aqroot8/aqroot/Assets/first-design-concept.png

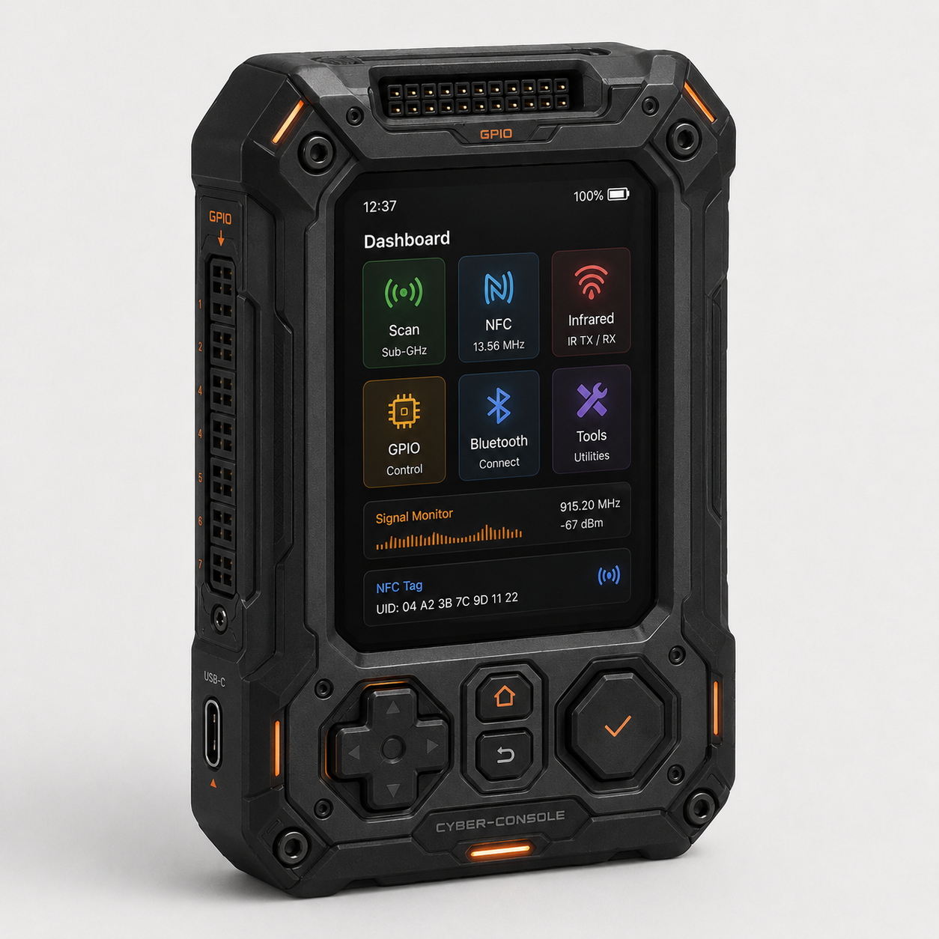
Assets/first-design-concept.png
