aqroot8/aqroot/docs/full-beta-v2/README.md

# AQROOT Full Beta v2 Engineering Record

**Purpose:** this directory is the authoritative engineering record for AQROOT
Full Beta v2. It exists so that the reasoning behind the design — not only its
output files — is preserved in the repository, in Git history, and on GitHub.

Everything here is text. Nothing here is a design file. Nothing here is
generated by a tool. If a fact matters and is not recorded in this directory or
in the KiCad sources, it is not part of the engineering record.

---

## What each baseline is

| baseline | location | role |
|---|---|---|
| **Beta-DM** | `hardware/beta-dm/` | The **validated implementation / manufacturing baseline.** Design-side complete, DRC 0 errors, fabrication package generated. Full Beta v2 inherits its implementation knowledge, its resolved MPNs and its proven blocks. |
| **Frozen Full Beta** | `hardware/beta/`, tag `beta-full-reference-v1` | The **feature / reference architecture baseline.** It records what the full feature set looks like. It is **not** fabrication-ready and was never fully validated (281 unconnected items and 58 ERC violations at freeze). |
| **Full Beta v2** | not yet created | The **active feature-complete showcase design.** Derived from Beta-DM, reintroducing the missing Full-Beta features in a controlled, gated way. |

### Preservation rules

- `hardware/beta-dm/` **must remain preserved** unless a CTO gate explicitly
  authorizes a change to it. It is the fallback that lets the programme
  fabricate something real if Full Beta v2 stalls.
- `hardware/beta/` and the tag `beta-full-reference-v1` are **historical
  references** and are read-only. Every Full Beta v2 commit must be able to
  prove `git diff beta-full-reference-v1 -- hardware/beta/` is empty.
- Design files may only be changed **after the relevant CTO gate authorizes
  them.** The gate list lives in [PROGRESS.md](PROGRESS.md).

---

## How to read this record

- **`transcripts/` is append-only.** A transcript is a historical record of what
  was asked and what was answered at a point in time. Transcripts are never
  edited, corrected or deleted. A transcript can become *outdated*; it can never
  become *wrong*, because it is a record of what was said, not of what is true
  now.
- **`CTO_DECISIONS.md` is the current source of truth.** When an older
  transcript or audit conflicts with a later CTO ruling, **the CTO decision
  wins.** Do not re-derive current direction by reading old transcripts.
- **`audits/` are dated snapshots.** An audit is true as of its stated
  repository HEAD. It is superseded by later audits, never rewritten.
- **`CHANGELOG.md` records what changed and why**, in chronological order.
- **`PROGRESS.md` records where we are** — gate status, percentages, blockers.

Order of precedence when two documents disagree:

```
CTO_DECISIONS.md  >  latest audit  >  ARCHITECTURE.md  >  older audits  >  transcripts
```

---

## Index

| document | what it holds |
|---|---|
| [CTO_DECISIONS.md](CTO_DECISIONS.md) | Living source of truth. Locked decisions and pending decisions. |
| [PROGRESS.md](PROGRESS.md) | Living status dashboard: gates, percentages, blockers. |
| [CHANGELOG.md](CHANGELOG.md) | Chronological engineering changes and why they happened. |
| [architecture/ARCHITECTURE.md](architecture/ARCHITECTURE.md) | High-level architecture snapshot and known architecture defects. |
| [architecture/POWER_FAULT_STATE_TABLE.md](architecture/POWER_FAULT_STATE_TABLE.md) | **Mandatory before schematic work.** Thirteen fault cases across USB, battery, power-switch and accessory states. |
| [mechanical/MECHANICAL_INTERFACE_SPEC.md](mechanical/MECHANICAL_INTERFACE_SPEC.md) | **Authoritative pre-CAD dimension source.** Cavity, PCB envelope, battery, NFC zone, acoustics, IR/antenna, mounting. |
| [pcb/FBV2_P1_FLOORPLAN.md](pcb/FBV2_P1_FLOORPLAN.md) | **FBV2-P1 floorplan.** Datum, outline, board-side convention, placement by face, and the measured gate metrics. **FBV2-P1 = PASS.** |
| [pcb/FBV2_P1_KEEPOUTS.md](pcb/FBV2_P1_KEEPOUTS.md) | All 13 mechanical regions and 4 copper rule areas, with layers and enforced height limits. **Re-based to the 72 mm outline at FBV2-EXP-002.** |
| [pcb/FBV2_P1_COORDINATES.csv](pcb/FBV2_P1_COORDINATES.csv) | Every reference: side, X, Y, rotation, footprint, value, sheet, courtyard box. |
| [pcb/FBV2_P2_ROUTING_PLAN.md](pcb/FBV2_P2_ROUTING_PLAN.md) | **NORMATIVE for FBV2-P2.** Layer usage, ground strategy, per-class routing rules, converter/USB/NFC/bus/escape plans, via and thermal policy, routing order, first-route checklist. |
| [pcb/FBV2_P2_NETCLASS_LEDGER.csv](pcb/FBV2_P2_NETCLASS_LEDGER.csv) | 19 routing classes: nets, design current, IPC-2221B minimum, target/min width, clearance, layers, via policy, return-path requirement, priority and basis. |
| [pcb/FBV2_P2_POWER_ROUTING.md](pcb/FBV2_P2_POWER_ROUTING.md) | **FBV2-P2 power routing.** The In1 GND plane, the placement corrections the routing exposed, the B-34 recomputation, and an honest account of why the first routing attempt was reverted. |
| [audits/2026-08-24-p2-battery-protection-routing.md](audits/2026-08-24-p2-battery-protection-routing.md) | **FBV2-P2-002A.** The obstacle-aware routing method, the D-245 width ruling, the routing journal, and the three named router defects that remain. |
| [architecture/EXPANSION_ECOSYSTEM_PROPOSAL.md](architecture/EXPANSION_ECOSYSTEM_PROPOSAL.md) | **PROPOSAL, PENDING CTO / OWNER RULING.** Standard 2.54 mm 1 x 24 side header + Qwiic/STEMMA QT: connector MPNs, 24-pin ordering, mating safety, power-control verification, and the two owner rulings it depends on. |
| [mechanical/P1_FLOORPLAN_INPUTS.md](mechanical/P1_FLOORPLAN_INPUTS.md) | **FBV2-P1 handoff.** 120 current physical constraints only, each marked LOCKED / TARGET / CAD-TO-VERIFY, plus the six items that need a CTO ruling before floorplanning. No coordinates. |
| [audits/](audits/) | Dated engineering audits, each pinned to a repository HEAD. |
| [reviews/](reviews/) | Independent second opinions. **Advisory — not automatically authoritative.** |
| [transcripts/](transcripts/) | Append-only verbatim CTO prompts and Claude Code responses. |

### Current contents

| file | date |
|---|---|
| [audits/2026-08-22-pre-design-engineering-audit.md](audits/2026-08-22-pre-design-engineering-audit.md) | 2026-08-22 |
| [audits/2026-08-22-architecture-verification.md](audits/2026-08-22-architecture-verification.md) | 2026-08-22 |
| [audits/2026-08-22-architecture-reconciliation.md](audits/2026-08-22-architecture-reconciliation.md) | 2026-08-22 |
| [audits/2026-08-22-battery-protection-closeout.md](audits/2026-08-22-battery-protection-closeout.md) | 2026-08-22 |
| [audits/2026-08-22-dead-cell-and-single-fault-closeout.md](audits/2026-08-22-dead-cell-and-single-fault-closeout.md) | 2026-08-22 |
| [audits/2026-08-22-mechanical-interface-freeze.md](audits/2026-08-22-mechanical-interface-freeze.md) | 2026-08-22 |
| [audits/2026-08-22-display-interface-closeout.md](audits/2026-08-22-display-interface-closeout.md) | 2026-08-22 |
| [audits/2026-08-23-display-procurement-lock.md](audits/2026-08-23-display-procurement-lock.md) | 2026-08-23 |
| [audits/2026-08-23-community-expansion-closeout.md](audits/2026-08-23-community-expansion-closeout.md) | 2026-08-23 |
| [audits/2026-08-23-community-connector-correction.md](audits/2026-08-23-community-connector-correction.md) | 2026-08-23 |
| **[mechanical/MECHANICAL_INTERFACE_SPEC.md](mechanical/MECHANICAL_INTERFACE_SPEC.md)** | 2026-08-23 (FBV2-MECH-002) |
| **[mechanical/P1_FLOORPLAN_INPUTS.md](mechanical/P1_FLOORPLAN_INPUTS.md)** | 2026-08-23 (FBV2-MECH-002) |
| [architecture/POWER_FAULT_STATE_TABLE.md](architecture/POWER_FAULT_STATE_TABLE.md) | 2026-08-22 |
| [reviews/2026-08-22-independent-cto-power-nfc-review.md](reviews/2026-08-22-independent-cto-power-nfc-review.md) | 2026-08-22 |
| [transcripts/2026-08-22-session-01.md](transcripts/2026-08-22-session-01.md) | 2026-08-22 |

### Standing policy

**[FIRST FIVE FULL BETA PCBAs — NO-RESPIN RECOVERY POLICY](CTO_DECISIONS.md)**
(D-049) applies to every design decision until explicitly revoked. Read it before
proposing any architecture choice.

---

## Conventions

- **Dates are absolute.** Never "last week", never "recently".
- **Every claim is sourced.** Measured from the board, quoted from a document,
  or explicitly marked as requiring verification. "Measured" and "assumed" are
  never blurred.
- **Task IDs** use the form `FBV2-<AREA>-<NNN>` (for example `FBV2-DOC-001`).
- **Gate IDs** use the form `FBV2-<PHASE><N>` (for example `FBV2-A2`).
- A verbatim record that cannot be recovered is marked
  `> [VERBATIM SOURCE UNAVAILABLE — DO NOT RECONSTRUCT FROM MEMORY]`
  and is never reconstructed from memory.
