aqroot8/aqroot/hardware/demo/kicad/aqroot-demo/README.md

# AQROOT Full Beta v2 KiCad Project

This directory contains the KiCad 10 project for the **AQROOT Full Beta v2** main board.
It was forked from `hardware/beta-dm/` at FBV2-S1 and is the active design. Beta-DM
remains the preserved fallback and manufacturing baseline (D-005) and is **read-only**.

> **Provenance is measured, not asserted.** `checks/fork_equivalence.py` re-derives which
> forked files are still bit-identical to Beta-DM, which are identical after normalising the
> embedded project name, and which FBV2-S1 deliberately changed. The pinned result is
> `reports/FBV2-S1-fork-equivalence.md`.

## Current design state (2026-08-23, after FBV2-S1-007)

* Digital pin architecture: LOCKED to Beta Pin Map v0.2.4
* Schematic capture: **`01_POWER_TREE`, `02_MCU_CORE`, `03_SPI_A_DISPLAY_SD`,
  `04_SPI_B_RADIOS_NFC`, `05_I2C_DEVICES`, `06_AUDIO` and `07_IR` carry the Full Beta v2
  architecture. Sheets 08-09 are inherited from Beta-DM, unmodified, and still carry the
  Beta-DM architecture**
* ERC: **RUN.** **2 errors and 43 warnings, 45 messages total**
  (`reports/FBV2-S1-007-erc.rpt`) against a Beta-DM baseline of 5 errors / 53 warnings.
  **Zero introduced by any migration task.** The remaining warnings are mostly root-sheet
  `isolated_pin_label` entries on cross-sheet signals whose far end is an unmigrated sheet.
  This is not "ERC clean" — see FBV2-S2.
  **Read the counts with the right flags:** every figure in this programme is
  `kicad-cli sch erc --severity-error --severity-warning`, matching the reports' own
  *"Report includes: Errors, Warnings"* header. Adding `--severity-all` also counts
  **Exclusions** and reports **104** on the same unmodified design. **The "66 warnings" and
  "ERC 68" figures quoted here and in FBV2-S1-004 / 004B / 004C were transcription errors,
  corrected in FBV2-S1-005; the stored reports say 46 messages / 2 errors / 44 warnings.
  The reported deltas were always right**
* PCB placement and routing: **NOT STARTED. DO NOT START.** `aqroot-Beta-v2.kicad_pcb` is
  still a bit-identical copy of the Beta-DM board and does not match this schematic
* Schematic freeze: BLOCKED pending the remaining sheet migrations, ERC closeout, the
  footprint audit, RF review, DFM review, and unresolved part selections

> **This document is a Beta-DM-era file that FBV2-S1 has corrected only where it made a
> false statement about Full Beta v2.** Sections below that describe Beta-DM blocks and are
> still accurate have been left alone. Where a section is superseded it says so in place.

### Status vocabulary — read this before quoting any status in this file

| Term | Meaning |
|---|---|
| **SPECIFIED** | The design is written out in Markdown (this README / the Decisions Log). **Nothing has been drawn.** |
| **CAPTURED** | The block actually exists in the `.kicad_sch` file: real symbols, real wires, real nets. |

**These two are never interchangeable.** A block can be fully SPECIFIED — every part, value,
net name and layout note settled — and still be a completely empty sheet in KiCad. Do not
report a SPECIFIED block as captured, drawn, complete, or done.

### Capture status by sheet (2026-08-23, measured from the `.kicad_sch` files)

| Sheet | Status | Notes |
|---|---|---|
| `01_POWER_TREE` | **CAPTURED — FBV2-S1 POWER-TREE IMPLEMENTATION** | 136 parts, all with footprints. Reverse protection (P2) + LTC4368-1, autonomous dead-cell recovery, ACC_3V3 / ACC_5V accessory power, NFC 3V3-FIT / 5V-DNP select, VBUS_PRESENT and fault telemetry, 19 test points. `R95` = 560 R and the OV divider = 3.65 M / 442 k (4.63 V) per D-104 / D-105 |
| `02_MCU_CORE` | **CAPTURED — FBV2-S1 MCU-CORE MIGRATION** | 14 parts. `GPIO38 = NATIVE_A`, `GPIO47 = NATIVE_B`, `GPIO46 = DISP_BL_CTL` with a 10 k strap pull-down + 0 R isolation link + strap pad, `GPIO43` withdrawn from the community port (UART0 TXD + `TP35`), `GPIO3` strap pull-down (**B-09 closed**), `GPIO45` pull-down placed **DNP**. See [`GPIO_LEDGER.md`](../../../../docs/full-beta-v2/architecture/GPIO_LEDGER.md) |
| `03_SPI_A_DISPLAY_SD` | **CAPTURED — FBV2-S1 DISPLAY / TOUCH / microSD MIGRATION** | 21 parts. New `ER-TFT035IPS-6_50P` symbol with the vendor pin table verbatim — **the inherited 2.8-inch table had the backlight anode/cathode reversed and SCL / D-CX swapped**. `LED_A1..A4` collapse to one `LED_A`; backlight `R69` **1.87 R**, `R70`-`R73` **4 x 33 R** (109 mA typ, 117.6 mA worst case vs a 120 mA panel max); `TOUCH_INT_N` added (panel pin 46); `R112` 0 R **DNP** isolates the display SDO from the shared SPI-A, with `TP36`; `SD_CARD_DETECT_TBD` becomes **`SD_CARD_DETECT_N`** with `R113` 100 k. `J1` stays on the **FH69-dedicated** land pattern (**B-47**) |
| `04_SPI_B_RADIOS_NFC` | **CAPTURED — FBV2-S1 RADIOS / NFC MIGRATION** | 40 parts, A2 sheet. RF architecture locked: 433 MHz internal Taoglas `FXP450.07.0100C` on the `U7` IPEX, 915 MHz external to a top-panel SMA bulkhead, **no board RF trace in either band**; both module stamp-hole pins explicit NC. NFC: **`VDD`/`VDD_TX` moved to `NFC_SUPPLY` (B-41 closed)**, `Y1` 27.12 MHz crystal, full differential matching + RX divider with every value `TUNE`, `TP37`/`TP38` on the antenna terminals, `AAT`/`CSI`/`CSO`/`EXT_LM`/`MCU_CLK` explicit NC. `SX1262_DIO1` published for sheet `08`. **Zero `*_TBD` nets remain.** NFC IC and antenna **LOCKED**: `ST25R3916-AQET` non-B; Taoglas **`FXC.46.52.0075X.B.dg`** (reverse ferrite, adhesive to the inner rear shell) off-board on `J7` JST `BM02B-ACHSS-GAN-ETF` — replaceable without soldering. **First-build matching set calculated** (FBV2-S1-004C): target ≈ 36 Ω differential, `Q` ≈ 25, EMC cut-off 20.1 MHz, RFI divider fixed from 4.4 V pk-pk to 1.03 V pk-pk. Every value is a CALCULATED FIRST-BUILD VALUE, not a final tuned value |
| `05_I2C_DEVICES` | **CAPTURED — FBV2-S1 I²C / IMU MIGRATION** | 11 parts. `U4` BMI270 re-derived line by line against `BST-BMI270-DS000-08` Rev 1.6 — **every inherited strap proved correct** (D-136). Address strap made reworkable: **`R118` 0 Ω FIT to GND = 0x68, `R119` 0 Ω DNP to `+3V3` = 0x69, fit one only** (D-140). Internal I²C pull-ups `R19`/`R20` **4.7 kΩ → 2.2 kΩ** — 4.7 kΩ gave `t_r` 338 ns against the 300 ns fast-mode limit at the measured ≈ 85 pF (D-139). `INT1` stays on native GPIO3 with a **proven** boot-safe window and a mandatory push-pull / active-high firmware contract (D-137); `INT2` stays DNC (D-138). IMU permanently powered, no load switch (D-141). **B-44 CLOSED**; land pattern verified against §8.3 (D-143). Address map: `docs/full-beta-v2/architecture/I2C_ADDRESS_REGISTRY.md` |
| `06_AUDIO` | **CAPTURED — FBV2-S1 AUDIO MIGRATION** | A3 sheet. **`U5` and `J6` arrived DNP — the speaker output path had never been built — and are now FITTED** (D-144). **`MK1` = PUI `DMM-4026-B-I2S-R`, replacing the obsolete ICS-43434: SEVEN pads, not six, so a new symbol and footprint were built from the manufacturer drawing** (D-145); `CONFIG`→GND mandatory; **no 1.8 V rail needed**; **`R120` 100 kΩ on `I2S_MIC_DIN` is a data-sheet requirement**. **Bus rate is set by the microphone: 48 kHz × 64 = 3.072 MHz, decimate to 16 kHz in firmware** — 16 kHz on the wire is out of spec (D-146). `U5` = **`MAX98357AETE+T`**, `GAIN_SLOT` → VDD = **6 dB** because 12 dB clipped the top 6.8 dB of digital range against the 3.3 V rail (D-147). `LS1` = **PUI `AS02008MR-LW152-R`**, Ø20 × 3 mm, 8 Ω, 500–4000 Hz, AWG #32 leads crimping straight into `J6` (D-148). EMI recovery `R121`/`R122` 0 Ω FITTED + `C81`/`C82` 1 nF DNP (D-150). `LS1` remains the one part with no footprint, by design (off-board speaker) |
| `07_IR` | **CAPTURED — FBV2-S1 INFRARED MIGRATION** | A3 sheet. **Eight parts arrived DNP — the whole subsystem — and are now FITTED** (D-153), the fourth consecutive sheet with a load-bearing inherited DNP. `D1` = **Vishay `TSAL6100`** (940 nm, `Ie` 170 mW/sr, ±10°); **TSAL6200 is a proven drop-in fallback — identical package, `VF` and `IFM`, so `R24` is unchanged** (D-154). **Peak 150 mA = 75 % of the `IFM` 200 mA REPETITIVE rating**; `IFSM` 1.5 A is a single-pulse ≤ 5 µs surge and is not a carrier rating; 300 mA rejected as out of spec (D-155). **Supply `+3V3`, not `SYS`** — 118–170 mA regulated against 64–166 mA on `SYS` (D-156). `R24` 18 Ω → **12 Ω** plus `R123` DNP parallel trim, **never below 10 Ω** (D-157). `C12` 4.7 µF → **22 µF 1210** — 4.7 µF gave 218 mV of carrier ripple (D-158). **`Q1` AO3400A pinout CONFIRMED 1 = G / 2 = S / 3 = D; the "needs the official AOS land pattern" blocker is CLOSED because AOS publishes none** (D-159). `U6` = **`TSOP38438`**, a pure MPN change, and the inherited `R21`/`C11` filter is **quantified at 41 dB at 38 kHz — ~90× margin against the Fig. 7 knee, and it is what makes sharing `+3V3` safe** (D-160). `TP39`/`TP40` added. **O-5 open: Vishay marks AGC4 "No" for Sony code** — receive-only, and the `TSOP38238` symbol is retained so reverting is a `lib_id` change | TSOP38238 RX + TSAL6200 low-side NMOS TX |
| `08_BUTTONS_EXPANDERS` | **CAPTURED — INHERITED, BETA-DM ARCHITECTURE** | U60/U61 TCA9535PWR, 7 buttons, safe-state pulls |
| `09_COMMUNITY_HEADER` | **CAPTURED — INHERITED, BETA-DM ARCHITECTURE** | the 20-pin Beta-DM port. **Superseded by the 2x12 Samtec `BCS-112-S-D-HE` port (D-093); not yet migrated** |

**CAPTURED here means the symbols, wires and nets exist in the file.** It does not mean the
sheet carries the Full Beta v2 architecture. Only `01_POWER_TREE`, `02_MCU_CORE`,
`03_SPI_A_DISPLAY_SD` and `04_SPI_B_RADIOS_NFC` do.

Board-level status:

| Item | Status |
|---|---|
| PCB (`aqroot-Beta-v2.kicad_pcb`) | **INHERITED, BIT-IDENTICAL TO BETA-DM** — it is the Beta-DM board and **does not match this schematic**. No v2 placement or routing has been performed |
| ERC | **RUN 2026-08-23** — `reports/FBV2-S1-005-erc.rpt`, **2 errors / 43 warnings (45 messages)**; **zero introduced** by any migration task, and FBV2-S1-004 removed two inherited errors. Counts are `--severity-error --severity-warning`; `--severity-all` also counts Exclusions and reports 104 |
| Footprints assigned | **300 of 301 components** (`LS1`, the off-board speaker, is the exception). Assigned is not verified — the per-footprint pad-overlap audit against vendor drawings is **FBV2-S2** and has not run |

> The old claim that this project was an empty PCB with seven footprints and a never-run ERC
> described the Beta project at 2026-07-31. It is retained nowhere: it was false for Beta-DM
> from the moment that board was routed, and it is false for Full Beta v2.

## Locked GPIO expanders (v0.2.4, 2026-07-27)

Both I2C GPIO expanders are Texas Instruments TCA9535PWR, replacing the MCP23017.

* U60 = TCA9535PWR, I2C 0x20 (internal: buttons + control), straps A2=GND A1=GND A0=GND
* U61 = TCA9535PWR, I2C 0x21 (community header), straps A2=GND A1=GND A0=+3V3
* Package = PW, TSSOP-24, 0.65 mm pitch
* Symbol = `Interface_Expansion:TCA9535PWR`
* Footprint = `Package_SO:TSSOP-24_4.4x7.8mm_P0.65mm` (NOT yet audited — see rules)
* One open-drain active-low `/INT` per device, both wired-OR onto `WAKE_INT_N` -> ESP32 GPIO21

TCA9535PWR is datasheet-trusted and receives its first hardware validation on Beta. The Alpha
bench test that passed was an MCP23017, a different part.

## Explicit unresolved parts

* ~~External community-header I2C isolator or bus switch — **UNSELECTED.**~~ **LOCKED
  2026-08-07: TI `TCA9517ADGKR`, DGK / VSSOP-8** (U16). PCA9515A is not selected.
* ~~ACC_PWR_EN accessory load switch — **UNSELECTED.**~~ **LOCKED 2026-08-07: TI
  `TPS22918DBVR`, DBV / SOT-23-6** (U15).
* **Battery reverse-polarity protection — topology PARKED, see below**

> Both former candidates are now firm part locks. Their **footprints remain UNVERIFIED** —
> locking the part is a separate gate from comparing KiCad copper against the manufacturer
> land pattern. See *Nontrivial footprint verification policy* in [[05 - Design Decisions Log]].

## 01_POWER_TREE — CAPTURED (FBV2-S1, 2026-08-23)

**Sheet status: CAPTURED AND ERC-CHECKED. NOT FABRICATION READY.** The section that used to
stand here said the sheet was "SPECIFIED, NOT DRAWN" and that its `.kicad_sch` was an empty
stub. That was true on 2026-07-31 and is false now.

What exists in the file:

* USB-C 5 V sink / USB 2.0 front end, BQ25185 charger and power path, TPS63020 main `+3V3`
  buck-boost, TPS61023 NFC 5 V PA boost, MAX17048 fuel gauge, physical TPS63020 EN hard-off
* **Battery reverse protection, P2** — `J4` -> `F1` 5 A -> `BAT_RAW` -> `Q2` (stage 1) ->
  `BAT_MID` -> `Q3` (stage 2) -> `BAT_SENSE` -> `R75` 15 mR -> `BAT_PROTECTED_P` -> `U11` BAT,
  controlled by `U18` LTC4368-1. `RETRY` grounded (latch-off); `UV` unused, 510 k to VIN per
  the datasheet; `OV` divider `R77`/`R78`
* **Autonomous dead-cell recovery** — `U19` TLV7032, ratiometric polarity bridge, handoff
  comparator, `Q6`/`Q7`/`Q8` series 3-input AND, `Q9` FAULT inverter, `Q5` recovery P-FET,
  `R95` limit, `D12` unidirectional. USB-powered and firmware-independent
* **Accessory power** — `+3V3` -> `U20` TPS22950C -> `ACC_3V3_SW`; `BQ25185_SYS` -> `U21`
  TPS61023 -> `U22` TPS22950C -> `ACC_5V_SW`; both `FLT` pins wire-ORed to `ACC_POWER_FAULT_N`
* **NFC no-respin source select** — `R106` 0R **FIT** from `+3V3`, `R107` 0R **DNP** from the
  boost, mutually exclusive by fit state
* **Telemetry** — `VBUS_PRESENT` divided to 2.97 V at VBUS 5.0 V, `LTC4368_FAULT_N`,
  `ACC_POWER_FAULT_N`, `BQ25185_STAT1/2`

What is **not** true of it:

* it is **not fabrication ready**;
* **no footprint on this sheet has been verified** against a vendor drawing (FBV2-S2);
* **no PCB placement or routing has been performed**, and the inherited `.kicad_pcb` does not
  contain any of this;
* several component values are marked *value-to-verify* in the FBV2-S1 audit;
* `NFC_SUPPLY` has **no consumer yet** — `U9` VDD/VDD_TX are still on `NFC_5V_PA_PENDING` on
  sheet `04`, which FBV2-S1-001 was not authorised to modify.

### Reverse-polarity placeholder — RETIRED

**Superseded.** This section required the battery-input protection block to remain a labelled
placeholder that must never be instantiated. **FBV2-S1 instantiated it**, under D-050 / D-052 /
D-064 / D-068, after the topology was locked by FBV2-PWR-001 and FBV2-PWR-002.

`BAT_CONNECTOR_P` and `BAT_PROTECTED_P` **remain distinct nets** — that part of the old rule
still holds, and is now enforced by real components between them rather than by a text box.

The parallel link across the FETs remains **forbidden**. The in-series removable link in
`BAT_PROTECTED_P` remains permitted.

## TPS61023 NFC 5V PA boost — BETA LOCKED, CAPTURE APPROVED (2026-07-31)

| | |
|---|---|
| Part | **TI TPS61023DRLR**, adjustable synchronous boost |
| Package | **DRL, 6-pin SOT563 / SOT-5X3, 1.2 × 1.6 mm** — **do NOT substitute a generic SOT-23 footprint** |
| Symbol / footprint | **Not selected** — verify exact symbol pinout, exact TI DRL footprint, pin-1 orientation, exposed-pad status, manufacturer land pattern |
| In / Out | `BQ25185_SYS` → `NFC_5V_PA_PENDING` |
| Enable | `NFC_5V_EN` from TCA9535 **U60 P02** (100k safe-state pull-down already in the architecture) |
| Load | **ST25R3916 `VDD_PA` ONLY** |

> **FB divider values are PENDING-FROM-DATASHEET.** Inspect the current TPS61023 datasheet and
> EVM schematic and record the exact FB resistor values, inductor and capacitor recommendations
> at capture time. **Do not invent values from memory** — that is why no numbers appear here.

| Ref | Value |
|---|---|
| `U?` | TPS61023DRLR |
| `L_NFC_BOOST` | ~1 µH, **shielded**, low DCR, current rating from the TI design calculation; MPN may stay provisional |
| `C_NFC_BOOST_IN` | input ceramic — value/voltage/dielectric **from TI** |
| `C_NFC_BOOST_OUT` | output ceramic, **or the exact TI-recommended count** |
| `R_NFC_FB_TOP` / `R_NFC_FB_BOT` | FB divider for ~5.0 V — **exact values from the TI 5V reference/EVM** |
| `TP_NFC_5V_EN`, `TP_NFC_5V_PA` | test points |

**Do not connect** ST25R3916 `VDD_IO` (stays on `+3V3`), general 5V accessories, USB VBUS, or any
unrelated load.

```
NFC 5V PA RAIL ONLY
ST25R3916 VDD_IO REMAINS +3V3
NOT A GENERAL-PURPOSE 5V RAIL
```

```
DEFAULT OFF
ENABLE ONLY DURING NFC FIELD OPERATION
```

```
PLACE INDUCTOR, INPUT CAPACITOR AND OUTPUT CAPACITOR
TIGHT TO TPS61023

MINIMIZE SW NODE COPPER AREA

KEEP FB TRACE AWAY FROM SW AND INDUCTOR

PROVIDE SHORT DIRECT GROUND RETURNS
```

**ERC:** VIN is `BQ25185_SYS`; output is only `NFC_5V_PA_PENDING`; `VDD_IO` remains `+3V3`; EN is
`NFC_5V_EN`; the safe-state pull-down exists and no conflicting pull-up was added; FB is not
floating; no support capacitor or inductor omitted; symbol and DRL footprint pin numbering match.

## MAX17048 fuel gauge — BETA LOCKED, CAPTURE APPROVED (2026-07-31)

| | |
|---|---|
| Part | **ADI MAX17048G+T10** — prefer the **G** package over the **X** WLP for Beta assembly/inspection |
| Package | 8-pin 2 × 2 mm TDFN / LFCSP-style |
| Symbol / footprint | **Not selected** — verify official pinout and package drawing, assign the **exact manufacturer land pattern**, include the **exposed pad** if required |
| I²C address | **0x36**, no address configuration |
| Sense resistor | none required |

| Ref | Net |
|---|---|
| `VDD` | **`BAT_PROTECTED_P`** |
| `CELL` | **`BAT_PROTECTED_P`** or the exact recommended system-side sense node |
| `SDA` / `SCL` | `I2C_SDA_INT` / `I2C_SCL_INT` — **no second pull-up pair**, the bus already has the locked 4.7k |
| `ALRT_N` | **test point, otherwise unused**; no-connect marker if the datasheet allows. **Do not connect to `WAKE_INT_N`.** No new GPIO. |
| `C_FG_VDD` | **value from the current datasheet** — X7R, appropriate rating |
| `TP_FG_CELL` | test point |

```
MAX17048 MUST REMAIN BEHIND FINAL REVERSE-POLARITY PROTECTION
DO NOT CONNECT TO RAW BATTERY CONNECTOR POSITIVE
```

```
MAX17048 I2C ADDRESS 0x36
NO ADDRESS CONFIGURATION
```

```
MAX17048 — NEVER BENCH VALIDATED ON AQROOT

BETA BRING-UP REQUIRED:
- I2C detection at 0x36
- cell-voltage accuracy
- SOC plausibility
- charge/discharge response
- hibernate entry/exit
- battery insertion/removal
- charger-connected behavior
- hard-off behavior
- no I2C backpower
- firmware temperature compensation
- low-battery threshold validation
```

> **Do not check the "only one capacitor" assumption off** until the official typical application
> is reviewed for CELL filtering, VDD bypass, alert-network components and exposed-pad grounding.
> **Power-domain item:** the gauge stays battery-powered while `+3V3` is off, but the I²C
> pull-ups are on `+3V3`. Verify from the datasheet that SDA/SCL cannot back-power the disabled
> rail. No level shifting unless primary documentation requires it.

## Physical hard-off switch → TPS63020 EN (2026-07-31)

```
VINA -> [SPST maintained slide switch] -> EN
                                          |
                                   R_EN_PULLDOWN = 100k
                                          |
                                         GND
```

Closed → EN high → TPS63020 on → `+3V3` active. Open → 100k pulls EN low → TPS63020 off →
`+3V3` inactive. **No switch position, including mid-travel, can short VINA to GND** — which is
why SPST-plus-pull-down was chosen over the SPDT common/VINA/GND arrangement.

**Do not connect the switch to** ESP32 GPIO, TCA9535 GPIO, a firmware latch, battery ground, or
the raw battery current path.

**Switch part:** MPN provisional until mechanical review, **but the footprint must correspond to
a real candidate**. SPST preferred; **maintained** positions; low-profile side/top actuator;
through-hole mounting tabs preferred for strength; side-wall accessible; clear OFF/ON. **Do not
assign a tiny signal-switch footprint without checking** actuator travel, body dimensions,
mounting tabs, PCB edge setback, enclosure cutout and hand-solder access.

```
SWITCH POSITION / ACTUATOR / ENCLOSURE CUTOUT
REQUIRE FIELD SLATE MECHANICAL REVIEW BEFORE ROUTING
```

```
PHYSICAL MAIN-RAIL HARD OFF

SWITCH OFF:
TPS63020 DISABLED
+3V3 SYSTEM RAIL OFF

UPSTREAM BATTERY CIRCUITS REMAIN POWERED:
BQ25185
MAX17048
REVERSE-PROTECTION CONTROLLER CANDIDATE

TOTAL BATTERY STANDBY IS NOT ZERO
```

**Never claim** complete battery isolation, shipping mode, zero battery current or zero standby
draw. Soft push-button power UX / load-switch / latch / shipping-mode architecture is a
**post-Kickstarter option, not part of Beta**.

## USB-C 5V sink + USB 2.0 front end — BETA LOCKED, CAPTURE APPROVED (2026-07-30)

**Cleared to be drawn in `01_POWER_TREE` now.** Beta-locked, **not production-hardened** —
subject to professional power/DFM/EMI review before fabrication.

**Role: USB Type-C SINK / UFP. 5V only. USB 2.0 full-speed. NO PD, NO source role, NO DRP, NO
VCONN, NO alternate modes.**

### Connector

| | |
|---|---|
| Family | **GCT USB4105**, 16-contact USB 2.0 Type-C, top-mount horizontal, SMD contacts, TH shell stakes |
| Candidate MPN | **GCT USB4105-GF-A-120** — *verify drawing, shell-stake length vs PCB thickness, symbol pin numbering, and that the footprint matches the drawing before locking* |
| Footprint | `Connector_USB:USB_C_Receptacle_GCT_USB4105-xx-A_16P_TopMnt_Horizontal` |
| Symbol | 16-pin USB 2.0 Type-C receptacle — **verify pin numbering; do not use a 24-pin SuperSpeed symbol** |

Pin mapping: VBUS = **A4, B9, A9, B4** · GND = **A1, A12, B1, B12** · D+ = **A6, B6** ·
D− = **A7, B7** · CC1 = **A5** · CC2 = **B5** · SBU1 = **A8 (NC)** · SBU2 = **B8 (NC)** ·
shield tabs → `USB_SHIELD`.

> **A 16-contact receptacle has no SuperSpeed TX/RX contacts — do not invent them.** Join all
> duplicate VBUS, GND, D+ and D− contacts. Mark **only** SBU1/SBU2 no-connect.

### Components and reference designators

| Ref | Value | Notes |
|---|---|---|
| `J?` | GCT USB4105-GF-A-120 | suffix pending |
| `R_CC1_RD` | **5.1k, 1%** | CC1 → GND |
| `R_CC2_RD` | **5.1k, 1%** | CC2 → GND — **independent; never shared, never combined, never firmware-connected** |
| `U?` | **USBLC6-2SC6** (SOT-23-6) | verify pinout against the **ST datasheet** |
| `R_USB_VBUS_LINK` | 0R | optional bring-up current-measurement / isolation link |
| `C_USB_VBUS` | **4.7 µF**, 10 V min, X7R | **deliberately 4.7 µF, not 10 µF** — keeps hot-plug inrush conservative. MPN deferred to pre-fab BOM validation |
| `R_USB_DN_SER` | **22R** | D− series, **at the MCU end** |
| `R_USB_DP_SER` | **22R** | D+ series, **at the MCU end** — equal value + matching footprint; 33R is an option after SI review, **never mixed across the pair** |
| `C_USB_DN_EMC` | 100 pF **DNP** | MCU-side node → GND |
| `C_USB_DP_EMC` | 100 pF **DNP** | MCU-side node → GND |
| `R_USB_SHIELD_LINK` | **0R, populated** | `USB_SHIELD` → GND (Beta default) |
| `R_USB_SHIELD_BLEED` | 1M, **DNP** | alternative — **do not populate both without review** |

Optional DNP shield→GND capacitor footprint **only if board space permits**; no mandatory value.

### Nets

`USB_VBUS_RAW` · `USB_VBUS_CHG` · `USB_D_N_CONN` · `USB_D_P_CONN` · `USB_D_N_MCU` ·
`USB_D_P_MCU` · `USB_SHIELD` · `GND`

```
VBUS pins -> USB_VBUS_RAW -> [R_USB_VBUS_LINK 0R] -> USB_VBUS_CHG -> BQ25185 VIN
                  |
                  +-- C_USB_VBUS 4.7uF
                  +-- USBLC6 VBUS pin  (BRANCH — clamp reference, NOT series)

D- (A7,B7) -> USB_D_N_CONN -> USBLC6 ch -> R_USB_DN_SER 22R -> USB_D_N_MCU -> GPIO19
D+ (A6,B6) -> USB_D_P_CONN -> USBLC6 ch -> R_USB_DP_SER 22R -> USB_D_P_MCU -> GPIO20
```

**GPIO19 = D−, GPIO20 = D+. Do not cross.** `C_USB_VBUS` does **not** replace the bq25185's own
VIN decoupling, which is captured with the charger's support network.

### Sheet notes to place

```
TWO INDEPENDENT 5.1k Rd RESISTORS REQUIRED
USB-C SINK / UFP, 5V ONLY
NO PD NEGOTIATION
```

```
STATIC Rd ESTABLISHES THE SINK ROLE
NO CC CURRENT-ADVERTISEMENT DETECTION IS IMPLEMENTED
BQ25185 INPUT-CURRENT POLICY MUST NOT ASSUME 1.5A/3A
FROM AN UNKNOWN SOURCE
```

```
USBLC6 VBUS PIN IS A CLAMP REFERENCE
NOT A SERIES POWER PATH
```

```
ESD CURRENT PATH TO GND MUST BE SHORT AND DIRECT
PLACE ESD BEFORE LONG DATA TRACES
MINIMIZE STUB BETWEEN CONNECTOR AND ESD ARRAY
```

```
DNP FOR BETA
POPULATE ONLY AFTER SIGNAL-INTEGRITY / EMI REVIEW
```

```
SHIELD-GROUND STRATEGY PROVISIONAL FOR EMI/ESD REVIEW
DEFAULT BETA LINK: 0R
DO NOT LEAVE SHIELD FLOATING WITHOUT REVIEW
```

Prominent, beside the block:

```
USB-C 5V SINK / USB 2.0 DEVICE

CC1: 5.1k TO GND
CC2: 5.1k TO GND
SEPARATE Rd RESISTORS — DO NOT COMBINE

NO PD / NO VCONN / NO SOURCE ROLE
SBU1/SBU2 NC

USBLC6-2SC6:
DATA + VBUS ESD CLAMP
VBUS PIN NOT IN SERIES

D+/D-:
22R SERIES AT MCU
100pF DNP EMC FOOTPRINTS

GENERIC USB CURRENT LIMIT MUST REMAIN CONSERVATIVE
WITHOUT CC CURRENT-ADVERTISEMENT DETECTION
```

### Layout notes

**D+/D−:** 90 Ω differential pair (tolerance per stack-up); equal length; continuous GND
reference; minimise vias; no stubs; avoid switch nodes, inductors, antennas, crystal traces;
preserve pair spacing; paired ground-return vias on any unavoidable layer change.
**Placement order:** connector → USBLC6-2SC6 → controlled differential routing → series
resistors near ESP32-S3 → ESP32-S3 USB pins.
**VBUS:** width suited to expected input current; bulk cap and ESD clamp close; keep away from
D+/D− where practical.

### ERC checks

**Do not globally weaken ERC.** CC1 and CC2 each have their own 5.1k and are not shorted; D+/D−
not swapped (**GPIO20 = D+, GPIO19 = D−**); USBLC6 VBUS not treated as series power; SBU1/SBU2
have no-connect markers; all VBUS contacts joined; all GND contacts joined; shield not used as
signal GND through an unintended duplicate path; no nonexistent SuperSpeed pins; no PD
controller; **no GPIO allocated for CC logic**.

## TPS63020 3.3V block — ARCHITECTURE LOCKED, CAPTURE APPROVED (2026-07-30)

**This block is cleared to be drawn in `01_POWER_TREE` now.** Capacitor exact MPNs are a
**BOM-release gate, not a schematic-capture gate** — draw the block, mark the open items on the
sheet, and do not stall capture on per-capacitor DC-bias research.

Block title to place on the sheet:

```
TPS63020 3.3V BUCK-BOOST
ARCHITECTURE LOCKED
CAPACITOR MPNs PENDING PRE-FAB BOM VALIDATION
```

### Rails

| | Net |
|---|---|
| In | **`BQ25185_SYS`** |
| Out | **`+3V3`** |
| Ground | Per the TI datasheet's own PGND/AGND treatment. **Do not invent split-ground nets** unless the datasheet explicitly requires them. |

The block connects to `BQ25185_SYS`, **not** to the raw battery connector.

### Components and reference designators

| Ref | Value | Locked? | Notes |
|---|---|---|---|
| `U?` | **TPS63020DSJR** | ✅ | DSJ package. **Verify the official TI pinout before wiring** — do not trust a third-party symbol unchecked. |
| `L1` | **XFL4020-152MEC** 1.5 µH | ✅ | Coilcraft, LCSC **C3033018**. Use the manufacturer-recommended footprint, or one matching the **official Coilcraft land pattern**. |
| `R_FB_TOP` | 1M, 1% | ✅ | VOUT → FB |
| `R_FB_BOTTOM` | 180k, 1% | ✅ | FB → GND. **No Cff, no third resistor.** |
| `R_PG_PULLUP` | 1M | ✅ | +3V3 → PG (open-drain) |
| `SW?` | SPST maintained slide switch | ✅ | **Physical hard-off**: VINA → switch → EN |
| `R_EN_PULLDOWN` | 100k | ✅ | EN → GND, defines the OFF state |
| `R_EN_BYPASS` | 0R **DNP** | ✅ | VINA → EN, **bench bypass only** — supersedes the withdrawn `R_EN_LINK` |
| `R_PS_DEFAULT` | 0R | ✅ | PS/SYNC → GND |
| `C_VINA` | 100nF X7R | ✅ | VINA→GND, close to VINA. **Do not exceed 220nF without review.** |
| `CIN1`, `CIN2` | 10 µF each | value ✅ / **MPN ❌** | 10 V min, X7R, **1206 preferred**. Close to VIN/PGND. |
| `COUT1`–`COUT4` | 22 µF each | value ✅ / **MPN provisional** | 10 V, X7R, **1206**. Tight around VOUT/PGND. |

Test points: **PG**, **EN**. Plus a **DNP landing** on EN for the future external hard-off
controller, and a test point / solder-jumper / DNP option on PS/SYNC for forced-PWM.

### Locked defaults — and why no GPIO is consumed

```
PHYSICAL MAIN-RAIL HARD OFF
MCU CANNOT RESTORE ITS OWN DISABLED 3V3 RAIL
```

* **EN must not float.** Driven by the **physical SPST maintained hard-off switch**
  (VINA → switch → EN) with **`R_EN_PULLDOWN` 100k** to GND holding the OFF state.
  **Never connect EN to the ESP32, the TCA9535, or any firmware-controlled signal.**
* **The permanent `R_EN_LINK` 0R is WITHDRAWN** (superseded 2026-07-31). It survives only as
  **`R_EN_BYPASS` 0R, DNP**. A populated permanent link in parallel with a switch that pulls EN
  low would defeat OFF and short VINA to GND.

```
DO NOT POPULATE R_EN_BYPASS WHEN HARD-OFF SWITCH IS FITTED
UNLESS INTENTIONAL ALWAYS-ON BENCH CONFIGURATION IS REQUIRED
```
* **PS/SYNC must not float.** Tied to GND through `R_PS_DEFAULT` 0R → **power-save default**.
  Forced-PWM is a bring-up/EMI option only. **Never allow the GND link and a VINA link to be
  populated simultaneously without an explicit assembly warning** — that shorts VINA to GND.
* **PG is diagnostic only.** `PG DIAGNOSTIC ONLY / NO GPIO ALLOCATED`. No MCU, no expander.

### Sheet notes to place

Beside L1:

```
LOCKED MPN: XFL4020-152MEC
XGL4020-152 MAY BE REVIEWED AS AN APPROVED ALTERNATE
DO NOT SILENTLY SUBSTITUTE
```

Beside the FB divider (keep the FB node compact and visually clear of switching nodes):

```
KEEP FB TRACE SHORT
ROUTE AWAY FROM L1, L1/L2 SWITCH NODES AND HIGH-DI/DT LOOPS
SENSE VOUT AFTER OUTPUT CAPACITORS
```

Prominent, beside the block:

```
CAPACITOR MPNs NOT BOM-LOCKED
VERIFY DC-BIAS EFFECTIVE CIN/COUT BEFORE FAB

CIN:
2 x 10uF, 10V+, X7R
TOTAL EFFECTIVE >=10uF AT 4.5V

COUT:
4 x 22uF, 10V, X7R, 1206
TOTAL EFFECTIVE >=40uF AT 3.3V

DO NOT USE OBSOLETE GRM21BR71A106KE51L
```

### ERC handling

**Do not globally reduce ERC severity.** For findings from the incomplete reverse-polarity block
or the hard-off DNP landing: classify explicitly, and use a **narrowly scoped** no-connect,
no-ERC marker or documented waiver **only where justified**. Never suppress unrelated errors.

Check on this block: EN not floating; PS/SYNC not floating; PG pull-up present; FB connected
only to the intended divider; no obsolete capacitor MPN present; no GPIO consumed; `+3V3`
power-flag strategy consistent with existing project conventions.

## Reverse-polarity protection — SUPERSEDED, NO LONGER PARKED (2026-08-23)

**This section is superseded.** It parked the battery-input protection block and forbade
instantiating a controller, MOSFETs, sense resistor, UV/OV divider, gate clamp or timer
components. That park was lifted by the FBV2-A1 gate:

* **FBV2-PWR-001** (2026-08-22) characterised the dead-cell lockout and the single-fault cases.
* **FBV2-PWR-002** (2026-08-22) closed **P-11, P-12, B-20, B-21, B-23** and passed **FBV2-A1**.
  Pass path locked to **P2** — four FETs in **two packages**; fuse **REQUIRED**; clamp demoted
  to secondary; PTC **REJECTED**.
* **FBV2-S1-001** (2026-08-23) captured it. See *01_POWER_TREE — CAPTURED* above.

Two rules from the old text **survive unchanged** and are still binding:

* **High-side only.** Battery negative stays tied directly to system GND. The keyed connector
  is an *additional mechanical layer only*, never the primary electrical defence.
* **Rejected as final solutions:** single PMOS alone; naive passive back-to-back; any passive
  gate network that can leave a FET partially-on under charger drive; low-side protection;
  keyed connector as primary defence; ordinary load switches that block charging; cell
  over/under-voltage protectors that do not address physical reverse insertion.

> **The pre-fabrication power/DFM review gate is NOT lifted.** Capturing the topology is not
> the same as clearing it for fabrication. The LTspice charge-path case, ADI vendor/FAE
> confirmation and the professional power/DFM review are still required before any fabrication
> release, and the footprint audit (FBV2-S2) is still required before any routing.

Full record: [[05 - Design Decisions Log]] and `docs/full-beta-v2/`.

## Rules

* **Beta-DM rule, now scoped:** "Do not generate or modify KiCad schematic or PCB files
  automatically. KiCad files will be created manually in KiCad 10.0.3."
  **FBV2-S1-001 captured `01_POWER_TREE` as a scripted migration**, not by hand in the GUI,
  and every subsequent edit was verified with `kicad-cli` ERC and a netlist export. The rule
  is recorded here unaltered and **awaits CTO ratification or reinstatement** — it is not
  treated as repealed by having been overtaken.
* Do not assign unverified footprints. The U60/U61 TSSOP-24 footprint above is assigned but NOT
  yet verified against the TI datasheet drawing — audit it before freeze.
* Do not begin PCB routing until the full schematic passes review and ERC, **and until the
  power/DFM pre-fab review has locked the reverse-polarity topology** (see above).
* Preserve the authoritative GPIO assignments from Beta Pin Map v0.2.4.
* Do not reintroduce MCP23017 nomenclature (GPAn/GPBn, INTA/INTB, IODIR, GPPU, GPINTEN, INTF,
  INTCAP, IOCON, DEFVAL, INTCON). The TCA9535 register set is 0x00-0x07 only.
