aqroot8/aqroot/01 - Hardware Core.md

---
tags: [hardware, core-components]
---

# Hardware Core (always built in, no separate purchase)

| Subsystem | Part | Sourcing (final PCB) | Prototype sourcing | Notes |
|---|---|---|---|---|
| Compute | ESP32-S3-WROOM-1 (N16R8) | Bare module on custom PCB | DevKitC-1 devkit | 16MB flash, 8MB PSRAM, native USB flash/debug |
| Display | 2.8" IPS LCD, ILI9341 + FT6236 capacitive touch @ 0x38 | Panel module, standard 4-wire SPI | Same — Alpha-validated part | 240x320. AMOLED (RM69090) is a Kickstarter STRETCH GOAL board revision, not the baseline. **PHYSICAL INTERFACE CAPTURED 2026-08-06:** J1 = **Hirose FH69-50S-0.5SH** 50-pin 0.5mm FPC connector (footprint VERIFIED_VENDOR_EXACT; the obsolete FCI 62684 was dropped). Panel runs **SPI mode II with readback, IM3:IM0 = 1110**. Backlight = **TI TPS61169DCKR** driver, 4 LED strings with 39R ballasts and a 2.55R RSET. See [[05 - Design Decisions Log]] |
| NFC/RFID | **ST25R3916-AQET** (package LOCKED 2026-08-07) | Bare IC + ST reference-derived tuned PCB loop and reference matching network — **discrete, NOT a plug-on module** | X-NUCLEO-NFC06A1 eval board | SPI interface (not I2C). Alpha-validated (IC-ID 0x2A). Needs 3V3 + a switched 5V PA rail for full RF TX. **FOOTPRINT BUILT AND INTEGRATED 2026-08-07** (`AQROOT_Beta:ST25R3916_AQET`, UFQFPN32, ST land pattern 0.30x0.75 lands / 5.30 span / 3.45x3.45 exposed pad), with the **10 ST-specified decoupling capacitors C45-C54**. Supplies: `VDD_IO` on `+3V3`; `VDD` and `VDD_TX` on `NFC_5V_PA_PENDING`; `I2C_EN` grounded to select SPI; normal internal-regulator mode, no bypass. **RF/matching/antenna remain DO NOT ROUTE** — see [[05 - Design Decisions Log]] |
| Radio — sub-GHz | CC1101 — **LOCKED as the Ebyte E07-400M10S certified module (U7), 433 MHz** | Certified module on shared SPI Bus B — **not a bare IC** | Blue 433M V2.0 CC1101 board | DUAL-RADIO: ships alongside the SX1262, not instead of it. OOK/ASK/FSK capture + replay. **PHYSICALLY CAPTURED 2026-08-07** — footprint built and integrated on sheet 04. Antenna on the module IPEX port; **pin 21 ANT and all RF remain DO NOT ROUTE** |
| Radio — LoRa + sub-GHz | SX1262 — **LOCKED as the Ebyte E22-900M22S certified module (U8), 915 MHz** | Certified module — PERMANENT, not bare IC | Waveshare Core1262 | Bare IC skipped even for final design: multi-band RF matching is high-risk, and certified modules carry FCC/CE pre-certification needed if this ever reaches other people's hands. **PHYSICALLY CAPTURED 2026-08-07.** RF-switch control: **`DIO2` drives `TXEN` locally inside the module; `RXEN` is host-driven from U61 P16 (`SX1262_RXEN`, 100k pull-down) — the reclaimed XGPIO14.** RF remains DO NOT ROUTE |
| IR | IR LED + phototransistor receiver | Discrete parts | Same | Universal remote TX/RX. TX = GPIO16 via a low-side MOSFET driver (NOT GPIO43 — that pin carries the ROM boot log and would fire the LED every reset). RX = GPIO44 |
| Sensors | 6-axis IMU — BMI270 | Bare IC | SparkFun BMI270 Qwiic breakout | I2C 0x68, Alpha-validated (accel/gyro functional). Accel + gyro only — no magnetometer, since nothing in the feature set uses compass heading and it adds calibration complexity for no gain |
| Audio | ICS-43434 I2S MEMS mic + MAX98357A I2S Class-D amp + 4/8ohm speaker | — | Breakouts | Digital I2S chosen over analog for simpler ESP32-S3 interfacing. ICS-43434 chosen over INMP441 (discontinued). Bench validation pending |
| Wireless | Wi-Fi + Bluetooth | Native to ESP32-S3 | Native | No extra chip needed |
| Power | LiPo 2000mAh | — | — | ~12-15hr active; **standby ~2wk is ESTIMATED and pending Beta measurement — do not publish** (see [[13 - Power Budget and Battery Runtime v0.1]]). 2500-3000mAh open if enclosure volume allows |
| 3.3V rail | TI TPS63020 (adjustable buck-boost, P/N **TPS63020DSJR**, DSJ package) | — | Breakout module | Separate part — the bq25185 SYS output is NOT a clean 3.3V rail. 2A capacity, ~2x headroom. **ARCHITECTURE LOCKED; schematic capture APPROVED (2026-07-30).** In: `BQ25185_SYS`. Out: `+3V3`. L1 = **Coilcraft XFL4020-152MEC** 1.5µH (LCSC C3033018) — locked. FB divider `R_FB_TOP` 1M / `R_FB_BOTTOM` 180k, 1%, no Cff. EN driven by a **physical SPST maintained hard-off switch** (VINA→switch→EN) with `R_EN_PULLDOWN` 100k to GND; the old permanent `R_EN_LINK` 0R is **withdrawn**, surviving only as `R_EN_BYPASS` 0R **DNP** (**never firmware-driven**); PS/SYNC to GND via `R_PS_DEFAULT` 0R (power-save default); PG open-drain via `R_PG_PULLUP` 1M, **diagnostic only, no GPIO**. `C_VINA` 100nF. CIN 2×10µF, COUT 4×22µF 1206. **Capacitor exact MPNs DEFERRED to the pre-fab BOM-validation pass** — obsolete GRM21BR71A106KE51L must not be used. **Footprint built 2026-08-07** (`AQROOT_Beta:TI_TPS63020_DSJ`). See [[05 - Design Decisions Log]] |
| Charge mgmt | **BQ25185DLHR** (linear charger + power-path) — **DLH / WSON-10, 2.2 x 2.0 mm, 0.4 mm pitch, exposed thermal pad**; footprint `Package_DFN_QFN:Texas_DLH0010A_WSON-10-1EP_2.2x2mm_P0.4mm_EP0.9x1.5mm` (2026-08-07) | — | bq25185 breakout | Device stays usable while charging. REVERSE-POLARITY PROTECTION REQUIRED at the battery input — **topology PARKED, not locked**; see the row below. Start Beta at ~500mA charge current pending enclosure thermal testing |
| Reverse-polarity protection | **PARKED — leading candidate, NOT locked** | — | — | **High-side only**; battery negative stays tied directly to system GND (locked). Keyed connector is an *additional mechanical layer only*, never the primary electrical defence. Leading candidate: **ADI LTC4368-1** (active back-to-back N-FET controller, ~2.5–60 V, ~80 µA Iq, ±50 mV sense, MSOP / 3×3 DFN) driving **back-to-back N-channel MOSFETs**, **AO3400A-class** (AOS AO3400A, LCSC C20917, SOT-23, 30 V, ~48 mΩ @ Vgs 2.5 V, Vgs max ±12 V), two in series. Active gate turn-off is what avoids the AN-171 partially-on equilibrium. **AO3401A (LCSC C15127) stays valid as a building block** if a PMOS variant is chosen — but a *single PMOS alone* is rejected. Exact MOSFET, sense resistor, UV/OV divider, timer/inrush parts, gate clamp and package **not selected**. Final lock belongs to the **professional power/DFM pre-fab review** (LTspice charge-path case + ADI FAE confirmation). **No routing or fab release until that gate closes.** See [[05 - Design Decisions Log]] |
| Fuel gauge | **MAX17048G+T10** (Analog Devices / Maxim) | **8-pin TDFN-EP**, package code **T822+3**, outline **21-0168**, recommended land pattern **90-0065**; 2 mm x 2 mm, 0.5 mm pitch, exposed pad | — | Battery percentage for UI. **Footprint NOT yet assigned** — no stock KiCad footprint has been verified against land pattern 90-0065; see [[05 - Design Decisions Log]] *MAX17048 footprint NOT locked* |
| USB-C | **GCT USB4105** family, 16-contact USB 2.0 Type-C receptacle (candidate **USB4105-GF-A-120**) | — | USB-C breakout | Power + native USB flashing/serial. **BETA ARCHITECTURE LOCKED (2026-07-30)** — **sink/UFP, 5V only, USB 2.0 full-speed. NO PD, no source/DRP role, no VCONN, no alt modes.** Two **independent 5.1k 1% Rd** resistors (`R_CC1_RD`, `R_CC2_RD`) — never combined. ESD: **ST USBLC6-2SC6** (SOT-23-6); its **VBUS pin is a clamp reference, NOT a series power path**. Data: GPIO19 = D−, GPIO20 = D+ (reserved in the pin map), **22R series at the MCU** (`R_USB_DN_SER`/`R_USB_DP_SER`), **100pF EMC footprints DNP**. VBUS: `USB_VBUS_RAW` → optional 0R link → `USB_VBUS_CHG` → BQ25185 VIN, with `C_USB_VBUS` 4.7µF. Shield on its own `USB_SHIELD` net, 0R link by default. **No CC current-advertisement detection — generic-port input current must stay conservative.** Exact suffix pending PCB-thickness/shell-stake check. **Beta-locked, not production-hardened** — pending power/DFM/EMI review. See [[05 - Design Decisions Log]] |
| Buttons | 1x hardware boot/recovery button + 1x physical power switch | — | — | Touchscreen-only input needs a hardware fallback for bricked firmware |
| Status | RGB LED | — | — | At-a-glance state without waking the screen |
| Storage | microSD slot — **Molex 5025700893** (J2), push-push, 1.10 mm pitch, shielded, with mechanical card detect | Normal-mount SMT | — | Kept in core — cheap, small, genuinely useful for capture/log storage. **PHYSICALLY CAPTURED 2026-08-08**, footprint VERIFIED_VENDOR_DRAWING_WITH_EXACT_PART_CAD_CORROBORATION (14 lands, 1.1 pitch, 7.7 contact span, 14.3 shell outer). 1-bit SPI mode: DAT1/DAT2 unused, `CD/DAT3` = `SD_CS_N`. **The mechanical detect switch is captured on a named `SD_CARD_DETECT_TBD` net but NOT routed — no GPIO allocated** |
| GPIO expander | **TI TCA9535PWR x2** — U60 @ 0x20 (internal), U61 @ 0x21 (community header) | Bare IC, PW / TSSOP-24 / 0.65mm pitch | *(no bench part — see note)* | 16 genuinely bidirectional I/O each, as Port 0 (P00-P07) + Port 1 (P10-P17). One open-drain active-low `/INT` per device, both wired-OR onto `WAKE_INT_N` -> GPIO21. **No internal pull-ups — every pull is external and mandatory.** KiCad `Interface_Expansion:TCA9535PWR` + `Package_SO:TSSOP-24_4.4x7.8mm_P0.65mm` (footprint audit still pending). **DATASHEET-TRUSTED, NOT BENCH-VALIDATED — first hardware validation happens on Beta** (the Alpha bench test was an MCP23017, a different part). See [[11 - Beta Pin Map v0.2]] §7 |
| Expansion | Hybrid GPIO header | **14 user XGPIO (XGPIO0-13)** *(v0.2.5 — was 15; XGPIO14 reclaimed as `SX1262_RXEN`, its header pin retained as `RESERVED_NC`)* + native fast pin (GPIO43, net `FAST_IO / U0TXD / ROOTPROBE_CS`) + I2C + IRQ + switched accessory power, 3.3V logic only | — | Off **U61** (TCA9535PWR @ 0x21). **All 14 XGPIO are genuinely bidirectional** — this requirement is what forced the move off the MCP23017. **Two** expander pins are now internal: U61 P16 = `SX1262_RXEN` and U61 P17 = `ACC_PWR_EN`. U60 @ 0x20 carries buttons + control. External I2C must be isolated (series R, ESD, bus switch); header IRQ and GPIO43 need series R + ESD + gating. Label expander pins as LOW-SPEED. See [[11 - Beta Pin Map v0.2]] §7-§8c. No 5V passthrough |
| Controls | **7-button cluster** — D-pad up/down/left/right, A (=select/confirm), B (=back), Home | On **U60 P10-P16** (`BTN_UP_N`, `BTN_DOWN_N`, `BTN_LEFT_N`, `BTN_RIGHT_N`, `BTN_A_N`, `BTN_B_N`, `BTN_HOME_N`) | — | No separate D-pad centre (A is select) and no separate Back (B is back). Wake via U60 `/INT` -> `WAKE_INT_N` -> GPIO21 (RTC-capable; a polled expander cannot wake the ESP32). External 10k pull-up on every button is mandatory. U60 P17 carries the RootProbe IRQ — **U60 has zero free capacity** |
| Expansion | RootProbe connector | Footprint reserved | — | High-speed coprocessor accessory interface, Phase 2. Distinct from the slow GPIO header above — see [[14 - RootProbe Interface v0.1]]. Host IRQ = `ROOTPROBE_IRQ_READY_N` on **U60 P17** (expander, not native — a "data ready" notification, not a sampling signal); **must be level-held until acknowledged, not pulsed.** SPI CS = GPIO43, **multiplexed with the header FAST_IO pin — mutually exclusive, never both attached at once** |

> [!note] Radio coexistence
> Both radios and Wi-Fi/BT share the device: firmware enforces that only ONE radio
> TRANSMITS at a time (multiple may receive simultaneously). CC1101 and SX1262 share
> SPI Bus B with CS discipline — validated on Alpha hardware, see
> [[09 - Alpha Pin Bus Map]] and [[Alpha-Tests/HARDWARE-NOTES]].

## Antenna placement
Per [[12 - RF and Antenna Plan v0.1]] and the [[15 - Enclosure Field Slate v3]] zoning:
- Wi-Fi/BLE 2.4GHz: ESP32-S3 module onboard PCB antenna, upper-RIGHT crown (keep-out only)
- LoRa 915MHz: internal FPC antenna, upper-LEFT sidewall / crown edge
- Sub-GHz 433MHz: electrically-shortened antenna in the RF crown (top-LEFT, max volume);
  optional screw-on external whip via U.FL/SMA, stowed in the side holder
- NFC (ST25R3916): internal flat coil, read window on the BACK face of the device — no
  metal behind the loop
