aqroot8/aqroot/hardware/beta-dm/BETA-DM-LEAN-CORE-LEDGER.md

# AQROOT Beta DM — LEAN-CORE unconnected ledger

Rebuilt line by line from the **current real board** after the `U15` / `U16`
population change, from the KiCad DRC report rather than carried forward.
Supersedes [BETA-DM-UNROUTED-LEDGER.md](BETA-DM-UNROUTED-LEDGER.md).

Board state: head `27bf8f9` + the `U15`/`U16` DNP change.
**DRC: 0 errors, 240 warnings, 216 unconnected, schematic parity 0.**

Marking a part DNP does **not** change the ratsnest — KiCad keeps DNP pads in
connectivity — so the total is unchanged at 216. What changed is the
classification of 7 lines that now have a DNP pad at one end.

> **LANDED.** `XGPIO5` and `XGPIO6` are on the board. The equation below is
> the pre-landing state; the post-landing ledger is §Landed at the foot of this
> file.
>
> **UPDATED by the final GPIO implementation ruling.** `BQ25185_STAT1` /
> `STAT2` and now `XGPIO4` / `XGPIO7` are **LEAN-DM INTENTIONAL NO ROUTE** and
> move from C to D. Re-measured on the real board:

```
unconnected(measured)  ==  A + B + C + D
        216            ==  62 + 130 + 2 + 22
```

C is now **2**: `XGPIO5` and `XGPIO6` — the final Lean-DM GPIO set. Nothing
else fitted remains must-work outside D. The earlier equations
(`C6 + D18`, then `C4 + D20`) are superseded; only classifications moved and
**no copper changed** to reach any of them.

| bucket | lines | what it is |
|---|---:|---|
| A — DNP-function / component deferral | **62** | a pad at either end belongs to a DNP part, or the whole net belongs to a block that is DNP as a whole |
| B — GND, pours pending | **130** | one net; the plane and stitching programme |
| C — **Lean MUST-WORK non-GND** | **2** | the Lean demo fails without these |
| D — Lean-DM fitted, intentionally unrouted | **22** | both ends fitted, deliberately unrouted; every one has a restoration entry |

**C = 2, re-derived, not assumed.** It matches the ruling's projection exactly.

---

## C — Lean MUST-WORK non-GND: 2 lines

| net | endpoints |
|---|---|
| `/XGPIO5` | `U3.9` ↔ `R56.1` |
| `/XGPIO6` | `U3.10` ↔ `R57.2` |

Nothing else fitted remains open outside D. `FAST_IO_GPIO43_HDR`,
`WAKE_ATTN_N_HDR` and `+3V3` at `J5.1` are already routed and carry no
must-work line; their only open lines go to the DNP `D6`/`D7` ESD arrays and
are bucket A.

## D — Lean-DM fitted, intentionally unrouted: 22 lines

| group | lines | net(s) |
|---|---:|---|
| **deferred XGPIO from the final ruling** | **2** | `XGPIO4` (`U3.8`↔`R55.1`), `XGPIO7` (`U3.11`↔`R58.2`) — the Demo Model needs two GPIO, not four |
| **BQ25185 status test points** | **2** | `BQ25185_STAT1` (`TP6.1`↔`U11.9`), `BQ25185_STAT2` (`TP7.1`↔`U11.3`) — open-drain diagnostic outputs, not charger control, not safety, not MCU inputs, not boot/USB/UI. The charger operates without these traces |
| ten deferred XGPIO | 10 | `XGPIO0`, `1`, `2`, `3`, `8`, `9`, `10`, `11`, `12`, `13` (`U3` ↔ series resistor) |
| deferred header link | 1 | `XGPIO13_HDR` |
| external-I2C header links | 2 | `I2C_SCL_EXT_HDR`, `I2C_SDA_EXT_HDR` — fitted `R47`/`R48` to fitted J5-side track |
| accessory rail, fitted-to-fitted part | 2 | `ACC_3V3_SW`: track ↔ `C38.1`, and `R46.2` ↔ track |
| MCU test points | 2 | `TEST_GPIO45`, `TEST_GPIO46` |
| SW9 diagnostic branch | 1 | `Net-(SW9-A)` → `TP13.1` |
| **total D** | **22** | |

## A — 62 lines, composition

| owner | lines |
|---|---:|
| `U5` speaker amplifier | 6 |
| `U9` NFC front end | 5 |
| deferred blocks with no DNP pad at either end (NFC 5 V rail, IR, speaker) | 4 |
| `D5` | 4 |
| `D4` | 3 |
| **`U15`** | **3** |
| **`U16`** | **3** |
| `D7` | 2 |
| remaining `D2`, `D3`, `D6`, `U6`, `U13`, `R49`, `R50`, `R68`, NFC and IR parts | 32 |

### What moved into A this pass — 7 lines

`Net-(U16-SCLB)` (`U16.7`) · `Net-(U16-SDAB)` (`U16.6`) · `ACC_PWR_EN` ×3
(`U16.5`, `U15.3`) · `ACC_3V3_SW` `R46.2`↔`U15.6` (`U15.6`) ·
`Net-(U15-QOD)` `R46.1`↔`U15.5` (`U15.5`).

A went 55 → 62 with the `U15`/`U16` DNP. D went 15 → 18 there (gained the two
ext-I2C header links and the two fitted-to-fitted `ACC_3V3_SW` lines, lost
`Net-(U15-QOD)` to A), then **18 → 20** when the closeout ruling deferred
`BQ25185_STAT1` and `BQ25185_STAT2`. C went 16 → 6 → 4 → **2**.
`62 + 130 + 2 + 22 = 216`.

**No line was reclassified to manufacture the C2 count, and no copper was
touched to reach it.** C2 is what remains once the ruling's scope is applied to
the measured board: the two lines listed above are exactly the ones the Lean
demo cannot work without.

---

## Projected effect of landing the Lean GPIO routing

| change | effect |
|---|---|
| selected XGPIO close | −1 per pin |
| `WAKE_ATTN_N_HDR` re-lands | 0 |
| **Lean-deferred copper spent and NOT re-landed** | **+1 per net left short** — a deliberate, documented cost, see [BETA-DM-LEAN-GPIO-CLOSEOUT.md](BETA-DM-LEAN-GPIO-CLOSEOUT.md) |

The board total will therefore **rise**, not fall, when the GPIO routing lands:
bucket D grows by every deferred header route whose copper is spent. That is
intended — §8 of the closeout ruling forbids wasting routing capacity to
re-land a function the Demo Model has explicitly deferred. Every spent net gets
a Full-Beta restoration entry.

Those are targets, not measurements. **Nothing has landed.**

## Audit rule

At any Beta-DM audit the measured unconnected count must equal A + B + C + D.
If a line appears that is in none of the four buckets, it is a defect and must
be explained before the board moves forward.

---

## LANDED — post-landing ledger, measured on the real board

Board after the `XGPIO5` / `XGPIO6` landing, DRC re-run, zones refilled:

```
unconnected(measured)  ==  A + B + C + D
        215            ==  63 + 130 + 0 + 22
```

**C = 0. The Lean-DM must-work non-GND residual is closed.**

Every line of the 216 → 215 change is accounted for:

| net | delta | why |
|---|---:|---|
| `/XGPIO5` | **−1** | closed — one island, 25.775 mm |
| `/XGPIO6` | **−1** | closed — one island, 113.115 mm |
| `I2C_SCL_EXT_HDR` | **+1** | its local run was spent for the GPIO corridor |
| **total** | **−1** | 216 → **215** |

`I2C_SCL_EXT_HDR` went from 2 open lines to 3, and the split is worth recording
because it moves a line between buckets:

| before | after |
|---|---|
| track ↔ `D2.1` *(A — DNP pad)* | `J5.16` ↔ `D2.1` *(A — DNP pad)* |
| `R47.2` ↔ track *(D — both fitted)* | `J5.16` ↔ `R47.2` *(D — both fitted)* |
| | `R47.2` ↔ `R50.1` *(A — `R50` is DNP)* |

So **A gains 1** (62 → 63) and **D is unchanged at 22**. Nothing is
unexplained.

---

## Post-GND-closeout ledger

```
137 = A63 + B1(15) + B2(37) + C0 + D22
```

The GND closeout landed 134 segments and 55 vias, removed and changed nothing,
and took the board from **215 → 137** unconnected items. The whole change is in
bucket B: GND **130 → 52**.

Bucket B is now split, because "GND" was hiding two very different obligations:

| bucket | meaning | count |
|---|---|---:|
| **B1** | GND on a **fitted** part not yet on the main GND island — **owes copper** | **15** |
| **B2** | GND whose only ungrounded endpoint is a **DNP** part — owes nothing | **37** |

A, C and D are unchanged: **A63**, **C0**, **D22**.

The 15 remaining B1 lines are the fine-pitch pockets around `U2`, `U3`, `U4`
and `J3` plus the passives sitting in them. They are pour-resolvable, not
via-resolvable, and are itemised with per-pad measurements in
[`BETA-DM-GND-CLOSEOUT.md`](BETA-DM-GND-CLOSEOUT.md) §5.
