aqroot8/aqroot/docs/full-beta-v2/audits/2026-08-28-p2-003e-d277-u19-escape-order.md

# FBV2-P2-003E — D-277: the U19.3 N_POL NO_LEGAL_ESCAPE is a ROUTE-ORDER contention (cause B), not pad/board geometry; a cardinality-0 planar tie-break in the driver fixes it and the proven 003C bridge is held fixed

**Date:** 2026-08-28 · **Task:** FBV2-P2-003E · **Starting HEAD:** `f3ba82a`
**Verdict:** **REPAIRED — measured route-order fix, no placement/topology/safety
change.** D-276 named `N_POL U19.3→(node) NO_LEGAL_ESCAPE at ≥ 0.150 mm`
(blockers board_edge ×23, U19.4 ×16, U19.2 ×12, U19.6 ×8) as the full-driver
Phase-A blocker. 003E measured the cause with cheap analytic + isolated
real-router probes and found it is **cause (B): route-order / already-laid
copper**, not (A) intrinsic pad-escape geometry and not (C) placement. The
minimum repair is a **cardinality-0 ordering change** — a measured planar
tie-break inside the pin-field scheduler (`order_tight`) — that costs **no
placement move, no net/topology change, no footprint/polarity/safety change,
and no copper primitive**. The proven 003C `BAT_PROTECTED_P` vacate + F.Cu
4-via bridge is **held fixed and unmodified**; `bridge_probe_003c` stays PASS.
The authoritative PCB is left **untouched — six copper layers, 0 signal tracks,
0 signal vias**.

---

## 1. The three candidate causes, discriminated by measurement

D-276 named three candidate causes to distinguish. 003E measured each.

### (A) intrinsic pad / footprint / board-edge escape geometry — **REFUTED**

U19 is an SOT-23-8 at the far west board edge (west row x = 1.558, east row
x = 3.833; board west edge x = 0.000, EDGE_CLR = 0.5 mm). U19.3 (N_POL) is the
**middle west-row pin** at (1.558, 27.930), a 1.325 × 0.500 mm pad flanked by
U19.2 (REF_POL, north, y = 28.580) and U19.4 (GND, south, y = 27.280) at
0.65 mm pitch, walled to the west by the board edge and to the east by the
opposite pin row (U19.6 N_BATDIV at (3.833, 27.930)).

Measured on the **authoritative board** (0 signal tracks; U19 is **not** moved
by the c3 placement — c3_00 moves only R75/U18/R79), `qb.escape(U19.3, 'B',
w, w, …)` returns a **legal ≥ 0.150 mm escape** (also at 0.200 and 0.250 mm),
launching **east** into the inter-row gap. Its sibling U19.2 also escapes.
Both are **single-lane** (freedom 1, east only); the two end pins U19.1/U19.4
have 4 ways, the east-row middles 2. So the pad **can** leave its own copper —
intrinsic geometry is not the blocker.

### (B) route-order / already-laid copper — **CONFIRMED (the cause)**

The blocker histogram named **only** board_edge and U19's own pins — never a
foreign net's track — which already points away from far-away laid copper.
U19 (y ≈ 28) is geographically isolated from the western-BPP-trunk congestion
(y 60–93) of D-270…D-275, so the contention is **local to U19's pin field**.

Isolated on the empty authoritative board, routing the two contending
connections in the two possible orders is decisive:

| order | first connection | then sibling freedom | second connection |
|---|---|---|---|
| **driver (U19.2 first)** | REF_POL TP24.1→U19.2 **ok** (8.610 mm) | U19.3 → **0 ways** | N_POL TP23.1→U19.3 **NO_LEGAL_ESCAPE** |
| **swapped (U19.3 first)** | N_POL TP23.1→U19.3 **ok** (6.118 mm) | U19.2 → **1 way** | REF_POL TP24.1→U19.2 **ok** (13.372 mm) |

The driver-order row **reproduces D-276 byte-exact** — the same fail string and
the same blocker signature (`board_edge ×21, U19.4 ×17, U19.2 ×13, …`). The
swapped row **routes both**. So the escape is denied purely by the order, and
the order is **asymmetric**: U19.2 first kills U19.3, but U19.3 first does not
kill U19.2.

**Why asymmetric (the geometry).** U19.2 sits **north** of U19.3, but its target
TP24.1 (6.0, 22.5) is **south**; so U19.2's route escapes east into the inter-row
gap and then crosses **south through the gap**, over U19.3's only (east) lane,
sealing it. U19.3's target TP23.1 (6.0, 25.25) does **not** lie across U19.2, so
U19.3-first takes its lane and U19.2 detours around the laid copper. This is a
textbook planar-fanout ordering: among boxed pins all exiting the same way, the
one whose route crosses a sibling must go **last**.

### (C) minimum placement ECO — **NOT REQUIRED**

Because (B) is fixable by order alone (both route in the swapped order), no
placement displacement/orientation search was needed or run. Cause (C) is left
un-exercised, as the required investigation order specifies (C only if A and B
are exhausted).

## 2. The fix — a measured planar tie-break, cardinality-0

The scheduler `order_tight` already routes the tightest pin first, re-measured
before every fine-pitch pin (PR-19/23/30/32/38). U19.2 and U19.3 **tie on every
existing key**: slack +0.14 mm, ways-out 1, width — so the order fell through to
the queue's arbitrary MST order, which put U19.2 first (the backwards choice).

The repair adds **one final tie-break** on live geometry: among rows tied on
`(slack, ways-out)` with **ways-out ≤ 1** (the boxed-single-lane class), the pin
whose **pad→target span contains a tied sibling's pad** must cross that sibling,
so it is ordered **last**. Concretely, `crossings[i]` counts tied siblings whose
pad falls inside row *i*'s pad→target bounding span, and the sort key becomes
`(slack, ways-out, width, crossings)`. For U19: U19.2's span contains U19.3
(crossing 1), U19.3's span does not contain U19.2 (crossing 0) → **U19.3 routes
first**, and both escape.

**Scope / blast radius.** The term is **0 for every pin with a second way out**
(guarded by `fr_a ≤ 1`) and is the **last** sort key, so it only settles an
**exact** `(slack, ways-out, width)` tie that today resolves arbitrarily — it can
never reorder across tightness classes. The only two `tight` groups are `U18`
(pinned to a fixed schedule via `AQROOT_U18_ORDER`, so `order_tight` never
processes it) and `U19` (this block). The west-margin prefix routes identically
(verified: the pre-U19 log is unchanged). No copper is laid by the tie-break —
it is a pure read-only geometry measurement, consistent with the rest of
`order_tight`.

## 3. Validation

- **Analytic + isolated real-router probes** (`u19_escape_probe_003e.py`):
  intrinsic escape legal (A refuted); U19.2-first seals U19.3 and U19.3-first
  does not (B, both directions); the geometric crossing prediction agrees with a
  lay-and-count lookahead; the driver source carries the scoped tie-break.
  **PASS.**
- **Full driver Phase-A run** (LOCAL empty, c3_00, no ECO — the base
  `phaseA_003d.json` configuration, with the fix; `phaseA_003e_fix.json`,
  2306.8 s / ~38 min): the pin-field slack line now reads
  `U19.3 +0.14/1way  U19.2 +0.14/1way  …` (**reordered** — U19.3 ahead of U19.2,
  the exact tie-break the probe predicts), and both boxed pins route:
  `SIG N_POL TP23.1→U19.3 6.118 mm` **ok** and `SIG REF_POL TP24.1→U19.2
  13.372 mm` **ok**. The D-276 terminal blocker (`N_POL U19.3 NO_LEGAL_ESCAPE`)
  is **cleared** and Phase A **advances past it** to a new, deeper blocker
  (§4). Aggregate is a wash by design — the fix relocates the binding blocker,
  it does not by itself close Phase A: connections **68**, skipped-already-
  connected **90**, ratsnest **711** (delta **−70** vs the 781 scratch baseline;
  003D-base was 710/−71). Authoritative DRC histogram is **identical to
  baseline** — `{hole_clearance 5, lib_footprint_issues 199,
  solder_mask_bridge 1, unconnected_items 499}` — and `bridge_eco` is `null`
  (no ECO applied, base config), confirming the scratch route left **no**
  authoritative copper and **no** new DRC.

## 4. The next blocker (defined for immediate CTO continuation)

With U19.3 cleared, the full-run terminal blocker moves **one net deeper and to
the opposite pin row**:

> `PHASE A: FAIL — VREC_VCC U19.8→(node) (SIG) : NO_LEGAL_ESCAPE : U19.8: NO
> LEGAL ESCAPE at ≥ 0.150 mm; blocked by track (×33), U19.7 (×13), board_edge
> (×5), U19.5 (×5)`

Co-terminal with it, `VBRIDGE_TOP R85.1→(node)` is also `NO_LEGAL_ESCAPE`
(`track ×48, R85.2 ×8, R86.1 ×7, …` / `NO_NODE` on the empty-copper attempts).
Both sit at `−0.15/0way` and persist unchanged across all three routing passes
(pass 1 → pass 3), so they are the stable binding constraint, not a transient.

**This is a different class of blocker from D-276, and the discrimination
matters for the next move.** D-276/U19.3 was dominated by `board_edge` + U19's
**own** pins (a cardinality-0 *ordering* defect, fixed here). U19.8 (VREC_VCC)
is the **east-row** corner pin and its histogram is dominated by **foreign laid
`track` (×33)** — real accumulated copper, not sibling order. So the west-row
planar tie-break does **not** apply, and a route-order swap is unlikely to be
sufficient: this is a genuine congestion wall in the U19 east-row / R85 region.
The next task (FBV2-P2-003F) should measure U19.8 the same way 003E measured
U19.3 — first discriminate (A) intrinsic east-row escape geometry vs (B)
foreign-track contention vs (C) placement — before proposing any repair, and
must not assume another cardinality-0 fix exists.

## 5. Suites, state, cleanliness

All run at `f3ba82a` + this change; every suite green:

| suite | result | pins |
|---|---|---|
| `u19_escape_probe_003e.py` | **PASS** | A refuted (intrinsic escape legal), B both directions (U19.2-first seals U19.3, U19.3-first does not; both route swapped), C planar prediction + lay-and-count lookahead agree, D driver carries the scoped tie-break |
| `router_regression.py` | **PASS** (all checks) | land-pattern floors unchanged, G7 split/undo, G8 PR-39 connectivity truth, G9 width-ladder, G10 concurrency-safe DRC transient, G11 bounded-probe budget |
| `bridge_probe_003c.py` | **PASS** | D-275 vacate + F.Cu 4-via bridge held fixed: bit-8 closes, U18 8/8, no new DRC, no connectivity regression |
| `bridge_probe_003d.py` | **PASS** | D-276 driver-integrated ECO wiring + the two committed `phaseA_003d_eco{C,D}.json` FAILs (still pin `N_POL U19.3`, un-regressed) + 2-pass determinism |

**Scratch restored.** `phaseA_journal.json` (a per-run scratch the driver
overwrites via `json.dump(..., 'phaseA_journal.json')`, last committed in 002W
and untouched by every milestone since) was reset to `HEAD` after the run —
not committed. The committed 003E artifacts are the driver change, the probe,
the result `phaseA_003e_fix.json`, and this audit.

**No authoritative PCB promotion.** The full run applies no ECO, lays no
authoritative copper, and the promotion gates are not asserted (Phase A did not
pass). `/home/aqroot8/.aqroot-progress.env` is unchanged; CTO reviews JLCPCB
readiness only after accepting this pushed milestone.

**Nothing moved and nothing relaxed:** D9, U18, R75, R76…R83, Q3, the shunt, the
FETs, TP17 and C58 all frozen; `c3_00` NOT promoted; D-249, D-264, D-266, D-267,
D-269, D-270, D-271, D-272, D-273, D-274, **D-275** all untouched; the proven
003C vacate + F.Cu 4-via bridge held fixed (`bridge_probe_003c` PASS);
outer-1-oz / high-current policy unchanged; no safety weakening; no
topology/net/footprint/polarity change; no authoritative promotion. Authoritative
PCB UNCHANGED — six copper layers, 0 signal tracks, 0 signal vias.
