aqroot8/aqroot/docs/full-beta-v2/assembly/OFF_BOARD_BOM.md

# AQROOT Full Beta v2 — off-board BOM, first five units

**Status: NORMATIVE.** Created 2026-08-23 at FBV2-S2-001. These are the items the **PCB** BOM will
not capture reliably, because they are not placed on the board. Authority:
[`../CTO_DECISIONS.md`](../CTO_DECISIONS.md).

**Quantities are per unit; order five plus spares.**

---

## 1. Display and touch

| item | MPN | qty | notes |
|---|---|---|---|
| **3.5″ IPS TFT + capacitive touch module** | **EastRising `ER-TFT035IPS-6`** with **`ER-TPC035-6`** touch | 1 | 320 × 480, ILI9488 COG, assembled outline **56.54 × 84.96 × 3.95 ± 0.25 mm**, one **50-pin 0.50 mm bottom-contact FPC, 0.30 ± 0.03 mm thick, 25.5 ± 0.15 mm wide**, carrying display **and** touch (touch on pins 44–47) |

> **THE PURCHASE ORDER MUST EXPLICITLY REQUEST THE `FT6236` TOUCH CONTROLLER.** EastRising offers
> the module with an alternative touch controller option; the AQROOT I²C address map, the
> `TOUCH_INT_N`/`TOUCH_RST_N` wiring and the reserved address **0x38** all assume FT6236.
> **A different controller changes the address and is a silent bring-up failure.**

---

## 2. Battery

| item | spec | qty | notes |
|---|---|---|---|
| Li-ion pouch cell with JST-PH-2 lead | **60 × 75 × 8.0 mm, ≈ 2500–3000 mAh**, 1S | 1 | Envelope frozen by **D-071**; **SKU chosen at procurement (M-04)**. Must mate `J4` `B2B-PH-K-S`. **Protection-circuit-module cells are acceptable and preferred**; the board's own reverse-polarity path does not replace a cell PCM |

---

## 3. RF — 433 MHz

| item | MPN | qty | evidence |
|---|---|---|---|
| **433 MHz internal flex antenna** | **Taoglas `FXP450.07.0100C`** | 1 | Taoglas **SPE-23-8-180-A**. **410–470 MHz** (the `E07-400M10S` covers 410–450), **I-PEX MHF1 (U.FL)** connector, **100 mm** cable, 3M adhesive. Stocked DigiKey **21704215**, Arrow, TTI |

**Module interface:** the `E07-400M10S` ships with **both an IPEX connector and stamp holes**
(manufacturer product description) — **no variant selection is required**, the IPEX socket is
present on the standard part number. Mates MHF1/U.FL directly.

---

## 4. RF — 915 MHz

> **Read the gain number carefully.** Taoglas markets the `TI.92.2113` as "2 dBi". The data sheet
> table says **peak gain 1.21 dBi straight and 2.14 dBi bent**, and **average gain is negative in
> both orientations** (−0.97 dB straight, −1.35 dB bent). The headline figure is the *bent-peak*.
> Budget the link with the average, not the peak.
>
> **Mating chain, end to end:** `E22-900M22S` IPEX/MHF1 socket → Amphenol AMC right-angle plug
> (documented by Amphenol as *compatible with Hirose U.FL and IPEX MHF1*) → RG-178 150 mm →
> **SMA female** bulkhead jack through the panel → **SMA male** hinged connector on the
> `TI.92.2113`. **Every interface is female-to-male in the right direction.**
>
> **Power margin:** the module transmits **+22 dBm (0.16 W)** into an antenna rated **1 W** —
> better than 6× headroom.

| item | MPN | qty | evidence |
|---|---|---|---|
| **U.FL/MHF-I → SMA female bulkhead pigtail** | **RF Solutions `CBA-UFLSMA20IP`** *(supersedes Amphenol RF `095-902-568-100`, D-223)* | 1 | **Verified live 2026-08-24 under D-096.** DigiKey 14566928: **Part Status ACTIVE**, **296 in stock**, $11.58 @1 / $7.11 @vol; **200.00 mm**; **RG-178**; **50 Ω**; connector A **U.FL (UMCC) plug, RIGHT ANGLE, free hanging**; connector B **SMA jack, panel mount, bulkhead, front-side nut**. CPC/Farnell RF00982: **IP67**, 7 in stock, £6.29 @1, *“90° U.FL Plug to SMA Bulkhead Jack”*. Manufacturer drawing **`CBA-UFLSMAF20IP-1`**, rev 1 12/11/2015 revised 03/12/2015, notes: *1 UFL Right Angle · 2 Waterproof SMA Female Bulkhead Straight · 3 Heatshrink · 4 RG178 Coax cable* — **the drawing is marked NOT TO SCALE and dimensions nothing**, so the bulkhead envelope is taken from the Taoglas **SPE-24-8-198-C** drawing of the same SMA(F)BKST interface: **8.00 mm hex across flats = Ø9.238 across corners**, hex body 3.40 ± 0.2 mm, thread **1/4-36 UNS-2A × 11.40 ± 0.2 mm**, **star lock washer Ø10.2 REF**, nut HEX 8 × 1.80 ± 0.3 mm. **MECHANICAL: the FBV2-P1-002 floorplan measures a 138.48 mm routed run from `U8` to the top-panel SMA at doc (5.000, 148.000); 138.48 + 15 mm service loop = 153.48 of 200 mm, so SPARE = 46.52 mm.** **MATING: COMPATIBLE** — `E22-900M22S` carries an I-PEX MHF1 (IPEX-1) socket and Hirose U.FL / MHF1 are the same intermateable 2.0 × 2.0 mm interface; the cable end is a U.FL **plug**, the correct gender. **PROCUREMENT: this also removes a schedule risk — the superseded Amphenol part was ACTIVE but 0 in stock on a 12-week factory lead.** |
| *Fallback only — NOT ordered* | *Taoglas `CAB.01034`* | *0* | *Verified live 2026-08-24 under D-096 against the Taoglas Cable Assembly Catalog **SPE-24-8-198-C**: Hirose **U.FL** to **SMA(F) bulkhead straight**, **1.32 mm micro-coax**, **250 mm**, normal polarity, 50 Ω. **Held in reserve only**: the ruling selects the 250 mm assembly only if the measured route exceeds 180 mm, and it measures 138.48 mm. Its drawing is the dimensional source for the SMA(F)BKST envelope above.* |
| **915 MHz external antenna, SMA male** | **Taoglas `TI.92.2113`** | 1 | **LOCKED by CTO ruling, O-8 CLOSED 2026-08-23 (D-198).** Verified against Taoglas data sheet **SPE-19-8-076/A**: **ISM 915, 902–928 MHz**; **terminal-mount DIPOLE**; **hinged SMA(M)** connector as standard, so it mounts straight or right-angled; **198 ±3.3 mm × Ø13 mm**; TPEE body, **22.5 g**; 50 Ω, linear, omnidirectional; **max input power 1 W**; −40 to +85 °C. Efficiency **80.01 % straight / 73.20 % bent**. The reason it was chosen is in the data sheet in Taoglas' own words: it *"performs very well in free space, making it an ideal solution in areas where there may be no ground plane"* — AQROOT is a handheld that cannot provide the 30 × 30 cm ground plane a common monopole whip prefers |

**This is ONE assembly: the pigtail and the panel bulkhead are the same orderable part, so no
separate bulkhead MPN is needed.** Loss at 915 MHz is ≈ **0.4 dB** (RG-178 ≈ 1.2–1.5 dB/m ×
0.20 m plus two interfaces) against a +22 dBm module — negligible.

**Enclosure hardware:** the SMA bulkhead ships with its own nut and washer. The panel needs a
**Ø6.5 mm** clearance hole on the **top edge, left half — now at doc X 5.000 (D-222)**. **Two spacing rules apply and BOTH are
current** — see mechanical spec **§8.1** (authority traced at FBV2-MECH-002): **≥ 15 mm
CENTRE-TO-CENTRE** from the bulkhead hole to either IR window, **and ≥ 8 mm EDGE-TO-EDGE between the
SMA body and either IR aperture** (B-52, still **OPEN** — spacing recorded, **no CAD**). **B-52's floorplan half is now CLOSED (D-230): the body OD is Ø9.238 across the hex corners with a Ø10.2 lock-washer planar envelope, and the board achieves 47.250 mm centre-to-centre and 38.381 mm body-to-aperture against IR TX. Only an enclosure-CAD residual remains — the IP67 face O-ring seat diameter and the exact front protrusion, which RF Solutions does not dimension; the floorplan carries 1.6 mm of diametral headroom, which bounds it.** The right-angle AMC plug is the correct choice for a module lying flat — it keeps the
vertical stack low.

**Module interface:** the `E22-900M22S` likewise ships with **IPEX and stamp holes**.

---

## 5. NFC

| item | MPN | qty | evidence |
|---|---|---|---|
| **13.56 MHz NFC flex antenna** | **Taoglas `FXC.46.52.0075X.B.dg`** | 1 | Taoglas **SPE-24-8-104-B**: Ø46 mm, **reverse ferrite layer**, 75 mm twisted-pair 28 AWG with **ACH(F)** connector, peel-and-stick 3M adhesive. **The B variant is LOCKED (D-131)** — adhesive / flex / ferrite, for bonding to the **inside of the shell and reading outward**. **The A variant would put the ferrite between the coil and the tag and must never be ordered** |

Mates `J7` **`BM02B-ACHSS-GAN-ETF`** on the board.

---

## 6. Audio

| item | MPN | qty | notes |
|---|---|---|---|
| **Speaker** | **PUI Audio `AS02008MR-LW152-R`** | 1 | Ø20 × 3 mm, 8 Ω, 0.5 W rated / 0.8 W max, **500–4000 Hz voice band**, **152 mm AWG#32 leads** |
| Speaker mating housing | **JST `PHR-2`** | 1 | Mates `J6` |
| Speaker crimp contacts | **JST `SPH-002T-P0.5S`** | 2 | **D-148: the speaker crimps straight in, so it is replaceable without soldering** |

---

## 7. Battery harness

| item | MPN | qty | notes |
|---|---|---|---|
| Battery mating housing | **JST `PHR-2`** | 1 | Only if the cell is supplied without a lead |
| Battery crimp contacts | **JST `SPH-002T-P0.5S`** | 2 | As above |

---

## 8. Bring-up and validation aids — not shipped with the product

| item | qty | why |
|---|---|---|
| USB-C cable, USB 2.0 data-capable | 1 | The **only** service interface: console, ROM download **and** JTAG over the native USB Serial/JTAG. **A charge-only cable will look like a dead board** |
| ~~Accessory reference mating header — Samtec `TSW-112-07-L-D` (2 × 12)~~ **SUPERSEDED by D-237.** **Accessory reference mating header — ANY ORDINARY 1 × 24, 2.54 mm MALE HEADER with a 0.635 mm (.025 in) SQUARE POST**, e.g. Samtec `TSW-124-07-x-S`, or 24 positions of ordinary breakaway strip | 1–2 | **The point of D-237 is that this is no longer a special part.** The socket's insertion depth is 3.68–6.35 mm, so any standard post in that range mates. **Ordinary male-to-female Dupont jumpers mate individual contacts directly and need no header at all** |
| **Qwiic / STEMMA QT cable, 100 mm, 4-conductor JST-SH 1.0 mm** | 2 | **NEW at D-238.** Any SparkFun Qwiic or Adafruit STEMMA QT cable mates `J8`; the two ecosystems are interchangeable here. Needed to exercise the I²C port at first article |
| microSD card | 1 | Card-detect and SPI-A validation |
| NFC test tag (ISO 14443A) | 1 | NFC bring-up |

---

## 9. Open off-board items

| # | item |
|---|---|
| ~~**O-8**~~ | **CLOSED 2026-08-23 (FBV2-S2-002).** Taoglas **`TI.92.2113`** locked by CTO ruling and verified live against the manufacturer data sheet. **No hardware or schematic change was required** — the panel connector is SMA **female** on the Amphenol pigtail and the antenna is SMA **male**, so the interface was already correct |
| **M-04** | Battery SKU — envelope frozen, SKU at procurement |
| — | Enclosure-side hardware beyond the SMA nut is **mechanical CAD scope**, deliberately not listed here |
