aqroot8/aqroot/hardware/demo/manufacturing/evidence/d718-sys-pour-spine-lanes.txt

L4.1-U21.3|68.915,85.075 68.915,85.675 68.915,86.275 68.915,86.875 69.015,87.450 69.315,87.750 69.615,88.050 69.915,88.350 70.215,88.650
U21.3-C28.1|70.125,88.750 69.525,88.750 68.925,88.775 68.625,89.075 68.325,89.375 68.025,89.675 67.725,89.975 67.425,90.275 67.125,90.575 66.625,90.700 66.025,90.700 65.600,90.950 65.300,91.250 65.000,91.550 64.850,92.050 64.725,92.650 64.650,93.250 64.975,93.650 65.475,93.850 66.075,93.850 66.675,93.850 67.275,93.850 67.725,93.625 67.975,93.375
C28.1-U12.1|67.950,93.245 67.350,93.245 66.750,93.245 66.275,93.395 65.975,93.695 65.475,93.845 64.900,93.970 64.600,94.270 64.300,94.570 64.000,94.870 63.700,95.170 63.400,95.470 63.150,95.820 63.125,96.420 63.125,97.020 63.125,97.620 63.350,98.070 63.650,98.370 63.950,98.670 64.250,98.970 64.550,99.270 64.800,99.645 65.050,99.895
