aqroot8/aqroot/docs/full-beta-v2/CHANGELOG.md

## 2026-09-18 - AQROOT Demo: D-742 .. D-745 — the owner decision spent, an inverted charger decode corrected, a charger that could not complete a charge fixed, and the first absolute power / feature gates built

`authority 23ee647e -> c7f5c618`. The owner approved leaving `/BQ25185_STAT2`'s `U11.3` unconnected and **D-742** spent it, publishing `unapproved_open_edges: 0` beside an unchanged `retained_open_edges: 1` with the declaration re-proved against the board every run. Reading the datasheet to spend it found the board's **charger status decode was INVERTED on `STAT1`** — `STAT1` LOW is a FAULT, not "charging" — corrected in both schematic sheets and four documents. **D-743** then found the real defect: SLUSF65B rev B halved `tMAXCHG` to 360 min, so `R37`'s 1 kΩ / 300 mA could deliver only 1800 mAh against a 2500–3000 mAh cell and the board **could not complete a charge**; `R37` → 390 Ω (769 mA) and `R36` → 13 kΩ (ILIM1100, `VBATREG` unchanged at 4.2 V) fix it with 21–34 % timer margin, and `audit_rail_ampacity.py` — the first ABSOLUTE power audit this board has had — measured the charger-input path at 250.8 mm / 440 mΩ, proved no shorter or wider path exists on any layer, and recorded the one named ampacity exception with a length budget and five controls. **D-744** found `min_connection` at 0.000 mm, so KiCad's `connection_width` test had never run either; probed, classified (74 of 81 pairs are benign acute throats) and proved **no net depends on a sub-0.15 mm contact** — plus zero orphan pour islands, NFC decoupling measured, and `M-09` closed as bounded. **D-745** built the sixteenth contract, the only one that knows what the product is: 37 Demo-scope features, 59 references and 103 nets asserted absolutely, with five controls. Real KiCad DRC unchanged in every class, 16/16 contracts PASS, `FAB1..FAB11` PASS. Full evidence: `CTO_DECISIONS.md` D-742 … D-745.

## 2026-08-31 - FBV2-P2-032: D-330 — remaining button-family framework bounded; F.Cu and split-inner hop variants refuted (no copper change)

Fast screens on clean D-329 state show D-328's endpoint hop is geometry-specific: `BTN_DOWN_N` and `BTN_A_N` have no F.Cu join corridor, while split In2/In3 joins fail the locked 0.60/0.30 via-site requirement at `R5.2` and `U2.17` respectively. No full gate was spent on dead candidates and authoritative D-328 copper remains byte-identical. D-325 duplicate-pad handling remains the generic accepted button framework; the three boxed west endpoints now defer to the generic boxed-endpoint framework. Next: bounded In2/In3 long-haul framework. Full evidence: [`audits/2026-08-31-p2-032-d330-button-family-framework-fast-screen.md`](audits/2026-08-31-p2-032-d330-button-family-framework-fast-screen.md).

## 2026-08-31 - FBV2-P2-031: D-329 — routing-wall registry + framework-first/batch-promotion transition (no copper change)

The owner-approved routing acceleration is now implemented at a clean process boundary. A machine-readable `routing_walls.json` captures nine accepted evidence-backed walls and prevents blind replay unless an explicit replacement framework is selected. `incremental_router.py` consults it; regression G40 proves deterministic registry integrity, blocks ordinary `BTN_DOWN_N`, and permits the accepted explicit `BTN_RIGHT_N` hop-anchor plan. `router_regression.py` G1–G40 ALL PASS. The authoritative D-328 PCB is byte-identical (`27db293c…`, 837 tracks / 73 vias / ratsnest 656 / journal 125); the full D-286 promotion gate and every electrical/manufacturing invariant remain unchanged. Next: finish the remaining button family as a coherent batch, then build the bounded In2/In3 long-haul framework. Full evidence: [`audits/2026-08-31-p2-031-d329-routing-wall-registry-framework-first-transition.md`](audits/2026-08-31-p2-031-d329-routing-wall-registry-framework-first-transition.md).

## 2026-08-31 - FBV2-P2-028: D-326 — `BTN_UP_N` promoted (twentieth rest-of-board increment; second SWx user button, cleaner than BTN_B_N, zero router-logic change)

**THE TWENTIETH INCREMENT, SECOND `SWx` BUTTON.** The navigation D-pad **UP** button `BTN_UP_N` routed on the SAME accepted D-325 duplicate-ref MST framework — ZERO router-logic change (a `GROUPS` registry entry + comment only) — and PASSED the real full-board gate. CLEANER than `BTN_B_N`: **one** through via, not two. Board `35d32343…` (800/70/662/119) → `adbea36b…` (821/71/659/122).

- **Note — mandate sha.** The FBV2-P2-028 mandate quoted the pre-work authoritative sha as `35d32343af5146b973f5231e76d252e90ddf796d274e63200da5ea41e5767ea7`; the live board file, `live_fingerprint.py`, the D-325 commit and CURRENT_STATE all agree the true D-325 sha is `35d32343af5146b952e5390898764fd326742dc88b5e146cf0c5f292dc14a220` (the two share only the 16-char abbreviation prefix `35d32343af5146b9`). The live board hashed byte-for-byte to the repo's own single-source-of-truth value, so work proceeded on that verified basis — the mandate tail was a transcription artifact, not a board discrepancy.
- **Candidate screen (read-only).** Every remaining `SWx` nav button shares `BTN_B_N`'s topology (switch SW2–SW6 is the same 4-pin `PTS645` tact switch with two pad-"1" lands 7.96 mm apart, a B.Cu pull-up R4–R8, a B.Cu PCAL expander GPIO U2.13–U2.17). Two independent read-only screens on the live D-325 board (`w/screen_020.py` bbox congestion + a faithful `physical_net_pads`/`mst_edges` route-plan vet) measured all five; `BTN_UP_N` is decisively cleanest — cross-haul **12.33 mm** / congestion **201** (vs `BTN_A` 42.35/429, `BTN_DOWN` 44.00/352, `BTN_LEFT` 50.15/568, `BTN_RIGHT` 56.89/508) — because SW2 sits in the SAME open south button field where `BTN_B_N` (SW7) already passed. Every nav button is a 1-via increment (the two F.Cu switch lands join by a same-layer F.Cu land-run — the D-325 lever edge — so only the haul to the R/U2 cluster needs a via). `Net-(SW9-A)` (5-pad power net touching U12.12 converter, the SPDT slide-switch output) and `BOOT_N` (characterized sensitive ESP32 boot strap) correctly EXCLUDED.
- **The increment.** `BTN_UP_N` = {`SW2.1` (two F.Cu lands at `(60.220,96.750)`/`(68.180,96.750)`), `R4.2` pull-up (B.Cu), `U2.13` expander GPIO (B.Cu)}. MST = `SW2.1a↔SW2.1b` (7.96 mm SAME-LAYER F.Cu land-run, NO via) + `R4.2↔U2.13` (SAME-LAYER B.Cu run, NO via) + `U2.13↔SW2.1` (ONE 0.60/0.30 Default THROUGH via at `(61.100,95.400)` in the OPEN south field, In1/In4 re-poured once). 21 tracks (6 F.Cu + 15 B.Cu), 1 through via. ZERO router-logic change (only `GROUPS['BTN_UP_N']` + comment).
- **Gate (real full-board, all 10 checks PASS).** No Phase-A copper deleted/altered; every new item in-scope (22 items); only In1/In4 planes re-poured; **all four physical pads in one copper cluster (`open_edges 3→0`, both `SW2.1` lands driven)**; all Phase-A pairs still connected; **ratsnest 662→659 (−3, the true KiCad count)**; no new/worse DRC class (`clearance` stays 0); `unconnected_items` 499→499. Promote: `35d32343…`→`adbea36b…`, journal 119→122. Realized copper 6.370 mm from `BAT_PROTECTED_P` → zero D-269; the via ≥ 4.804 mm from every barrel.
- **Tests / integrity (deterministic, twice).** `router_regression.py` ALL PASS **G1–G38**: new **G38** pins the increment (4 pads incl. both `SW2.1` lands joined to the R4.2 hub + U2.13, 21 trk/1 via legal = 6 F.Cu + 15 B.Cu, via ≥ 0.80 mm from barrels min 4.804 mm, ADD-ONLY); **G37 retained** (the D-325 framework lever); **G1–G37 unchanged**. `incremental_probe_006..025` + `phaseB_bringup_probe_005` (821/71/122; 28 routed rest nets, 136 unrouted) ALL PASS; new `incremental_probe_025.py` proves BOTH `SW2.1` lands copper-joined to the `R4.2` hub. `live_fingerprint.py` bumped once (D-326); `phaseB_bringup_probe_005.py` roster extended by `BTN_UP_N`; `incremental_baseline_006.json` left stale-by-design. Independent kicad-cli DRC identical to D-325. D-269/D-264/DRU A/B (committed D-325 vs promoted D-326): `d269` flips PASS↔FAIL(2) on both, `d264` 2-failed on both (B no worse than A), `dru` FAIL(2) IDENTICAL — the documented western battery/power-tree synthetic-probe flake, NONE involving `BTN_UP_N`; no regression.
- **Opportunity & simplification.** No repetitive-maintenance consolidation was due (one fingerprint bump, one probe, one G-contract, one roster line — all expected). The `SWx` family stays the largest unlocked block: four nav buttons remain (`BTN_A/DOWN/LEFT/RIGHT_N`), each a 1-via increment but with 42–57 mm cross-hauls carrying the corridor-wall risk — judge case-by-case (the "one bounded alternative if the first fails geometrically" discipline).
- **Governance.** No BOM/footprint/value/polarity/mechanical/firmware/UX change; DEVICE_SPEC unchanged. **Open owner decisions: NONE** (autonomy continues). Rollback: `git revert` this commit restores the committed D-325 board (`35d32343…`, 800/70/662/119). All locked invariants preserved (D-249/D-257/D-269/D-275/D-288/D-290, In1/In4 GND roles, In2/In3 capacity, RF/USB/mechanical reservations, D-304..D-325); frozen `beta-full-reference-v1` untouched; journal authoritative (122). **NEXT FBV2-P2-029:** route the next `SWx` nav button (fresh screen + vet first, the west hauls need the wall-risk check) or the next genuinely-clean functional open-region net under the D-286 gate + adding `incremental_probe_026`+`G39` on promote; retain G37/G38. 136/164 rest nets unrouted. PCB routing ~19 %, overall ~76 %, readiness ~78 % (JLCPCB file unchanged). Full analysis: [`audits/2026-08-31-p2-028-d326-twentieth-rest-of-board-incremental-increment-btn-up-n-promoted.md`](audits/2026-08-31-p2-028-d326-twentieth-rest-of-board-incremental-increment-btn-up-n-promoted.md).

## 2026-08-31 - FBV2-P2-027: D-325 — DUPLICATE-REF MST framework fix + `BTN_B_N` promoted (nineteenth rest-of-board increment; the SWx user-button family unlocked)

**THE FIRST FRAMEWORK-DEPENDENT INCREMENT.** A bounded, generic, deterministic fix (in `incremental_router.py` ONLY — `qrouter.py` untouched, so every G-contract that routes through `QBoard` stays byte-identical) lets the MST and the gate treat a footprint's two same-numbered physical lands as distinct nodes. With it, `BTN_B_N` (navigation/boot button, the first net of the `SWx` user-button family) routed, PASSED the real full-board gate, and was PROMOTED. Board `a7bf8bdc…` (781/68/665/116) → `35d32343…` (800/70/662/119).

- **Root cause (precise).** `SW7` (Button_Switch_SMD:`SW_SPST_PTS645Sx43SMTR92`) is a 4-pin tact switch whose two mechanically-linked terminals BOTH carry pad NUMBER "1" on `BTN_B_N` at `(49.520,96.750)` and `(57.480,96.750)`, 7.96 mm apart. `qrouter.QBoard._scan` keys `self.pads[(net,"REF.NUM")]`, so the second `SW7.1` overwrote the first and one land was invisible to the MST → D-323 gate FAIL (`open_edges 2→1`). A MATCHING collapse lived in `cmd_gate.net_open_edges()`, which ref-deduped the two lands in its cluster count and under-counted the owed ratsnest edges (2 where KiCad owes 3 for 4 lands).
- **The fix (bounded, generic, deterministic; `qrouter.py` untouched).** (1) `physical_net_pads()` sources MST nodes by stable PHYSICAL identity `(ref,x,y)`, recovering any land the `(net,tag)`-keyed `qb.pads` dropped (rebuilt field-for-field like `_scan` via `_rr_pad_dict`); ordinary unique-pad nets return the exact `net_pads()` dict OBJECTS → byte-identical routing; `cmd_route` sorts by `(ref,x,y)` (ties never fire for unique nets). (2) `cmd_gate.net_open_edges()` rewritten as a physical-pad union-find (nodes `(ref,x,y)`, copper adjacency from `GetConnectedItems`) → counts copper clusters over PHYSICAL lands, matching KiCad's own ratsnest. Weakens no rule, netclass, clearance, via geometry, placement, footprint, or topology; adds nodes only for a genuinely duplicated pad number.
- **The increment.** `BTN_B_N` = {`SW7.1` (two F.Cu lands), `R9.2` pull-up (B.Cu), `U2.18` expander (B.Cu)}. MST hubs on `R9.2` → BOTH `SW7.1` lands (two 0.60/0.30 Default THROUGH vias at `(48.300,96.750)` and `(56.300,95.600)` in the OPEN south button field, In1/In4 re-poured once) + one SAME-LAYER B.Cu run `R9.2→U2.18`. 19 tracks (3 F.Cu + 16 B.Cu), 2 through vias.
- **Gate (real full-board, all 10 checks PASS).** No Phase-A copper deleted/altered; every new item in-scope; only In1/In4 planes re-poured; **all four physical pads in one copper cluster (`open_edges 3→0`, both `SW7.1` lands driven)**; all Phase-A pairs still connected; **ratsnest 665→662 (−3, the true KiCad count)**; no new/worse DRC class (`clearance` stays 0); `unconnected_items` 499→499. Promote: `a7bf8bdc…`→`35d32343…`, journal 116→119. Realized copper 10.68 mm from `BAT_PROTECTED_P` → zero D-269; both vias ≥ 2.915 mm from every barrel.
- **Tests / integrity (deterministic, twice).** `router_regression.py` ALL PASS **G1–G37**: new **G36** pins the increment (4 pads incl. both `SW7.1` lands connected, 19 trk/2 via legal, vias ≥ 0.80 mm from barrels, ADD-ONLY); new **G37** pins the framework lever (duplicate pad number → distinct nodes; MST spans all 4 lands; ordinary unique-pad net byte-identical SAME objects; deterministic); **G1–G35 unchanged**. `incremental_probe_006..024` + `phaseB_bringup_probe_005` (800/70/119; 27 routed rest nets, 137 unrouted) ALL PASS; new `incremental_probe_024.py` proves BOTH `SW7.1` lands copper-joined to the `R9.2` hub. `live_fingerprint.py` bumped once (D-325); `incremental_baseline_006.json` left stale-by-design. Independent kicad-cli DRC identical to D-323. D-269/D-264/DRU A/B (committed D-323 vs promoted D-325): `d269` FAIL(2) + `dru` FAIL(2) identical on both, `d264` up-to-2-failed (B no worse than A) — the documented western battery/power-tree synthetic-probe flake (BAT_RAW TAP, Q3.6→R75.1 In2), NONE involving `BTN_B_N`; no regression.
- **Opportunity & simplification.** The duplicate-ref lever is shared by router (`physical_net_pads`) and gate (`net_open_edges`), so the whole `SWx` user-button family (`BTN_A/UP/DOWN/LEFT/RIGHT_N` + `Net-(SW9-A)`, ~6 remaining genuine nets) is now routable by the proven mechanics — the largest coherent remaining functional block is unlocked.
- **Governance.** No BOM/footprint/value/polarity/mechanical/firmware/UX change; DEVICE_SPEC unchanged. **Open owner decisions: NONE** (autonomy continues). Rollback: `git revert` this commit. All locked invariants preserved (D-249/D-257/D-269/D-275/D-288/D-290, In1/In4 GND roles, In2/In3 capacity, RF/USB/mechanical reservations, D-304..D-324); frozen `beta-full-reference-v1` untouched; journal authoritative (119). **NEXT FBV2-P2-028:** route the next `SWx` button net (fresh screen + vet first) or the next genuinely-clean functional open-region net under the D-286 gate + adding `incremental_probe_025`+`G38` on promote. 137/164 rest nets unrouted. PCB routing ~19 %, overall ~76 %, readiness ~78 % (JLCPCB file unchanged). Full analysis: [`audits/2026-08-31-p2-027-d325-duplicate-ref-mst-framework-btn-b-n-promoted.md`](audits/2026-08-31-p2-027-d325-duplicate-ref-mst-framework-btn-b-n-promoted.md).

## 2026-08-31 - FBV2-P2-026: D-324 — CHARACTERIZATION, no copper change (three pad-escape walls, no promote)

**NO COPPER CHANGE — the board is byte-identical to committed D-323** (`sha256 a7bf8bdc…`, 781 tracks / 68 vias / 6 layers / 41 zones / ratsnest 665 / journal 116). Three genuinely-functional open-region candidates from three different subsystems were vetted and scratch-routed and ALL hit characterized pad-escape walls at 0.200 mm; nothing was promotable via the proven mechanics without a deferred framework change (kept deferred by this mandate). ZERO router-logic change (three additive `GROUPS` characterization entries + comments only).

- **Screen + vet (READ-ONLY, live D-323 board).** `w/screen_020.py`: 138 unrouted rest nets, 38 ALLOW / 100 EXCL. The 38 ALLOW resolve to ~6 already-characterized walls + ~7 `SWx` duplicate-ref buttons (deferred) + converter/USB-C role-traps + the `BQ25185_STAT` power-tree pair + three huge hauls (`IR_RX_GPIO44` 132 mm, `DISP_SDO` 60 mm, `IR_GATE` 110 mm) + only THREE genuinely-clean functional candidates. `w/vet_021.py` measured the three.
- **Three characterized pad-escape walls (all scratch-routed, none promoted).** (1) `BMI270_INT1_RAW` (BMI270 IMU INT1 sensor-side leg `U4.4` B → series `R18.1` F, R18-isolated from the D-318 MCU-side strap; would COMPLETE the IMU interrupt path like D-308 completed D-304) → FAIL `NO_FAR_RUN` at 0.200 mm (R18.1 boxed in the dense MCU-south pocket; the `MCU_EN_RC` class). (2) `ACC_POWER_FAULT_N` (ACC 3V3 power-fault status `U20.6`+`U22.6`/`R103.2`/`TP27`+`TP33` → `U3.18`, all B.Cu) → FAIL `NO_LEGAL_ESCAPE` on `U20.6` (boxed by own-part pads U20.5/U20.1/U20.4; 3 of 5 edges route but the net can't complete; the `ISET`/`XGPIO2` boxed-pin class). (3) `DISP_BL_CTL` (backlight-driver control leg `R109.2` F → `U17.4` TPS61169 CTRL logic input B, R109-isolated from BL_SW/LED path) → FAIL `NO_FAR_RUN` at 0.200 mm (R109.2 in the same U1.16/backlight cluster that walled `DISP_BL_CTL_STRAP` at D-323). None has a bounded fix; all three `GROUPS` entries carry their OUTCOME annotation.
- **Board untouched.** `sha256 a7bf8bdc…` re-verified before/after (route writes only gitignored scratch `checks/w/INC_*`); `incremental_baseline_006.json` reverted stale-by-design.
- **Tests / integrity (board unchanged → all still PASS).** `router_regression.py` ALL PASS (G1–G35) deterministic twice (the three additive `GROUPS` entries are inert, like existing `BOOT_N`/`DISP_DC`/`MCU_EN_RC` records); `incremental_probe_006..023` + `phaseB_bringup_probe_005` (781/68/116; 26 routed rest nets, 138 unrouted) PASS; NO `live_fingerprint.py` bump (no copper); NO new probe / G-contract (no new copper to pin — the D-315 precedent); independent kicad-cli DRC identical (`solder_mask_bridge:1 + hole_clearance:5 + lib_footprint_issues:199 + unconnected_items:499`; 0 `clearance`); D-269/D-264/DRU trivially unchanged (byte-identical board → no regression possible; recorded run in the documented intrinsic-flake envelope `d269` FAIL(2) / `d264` 2-failed / `dru` FAIL(2)).
- **Opportunity & simplification.** Structural finding: after eighteen promoted increments the readily-clean open-region functional seam reachable by the proven mechanics is essentially mined out — the 138 remaining rest nets are dominated by role-excluded traps (~100), characterized walls, the `SWx` duplicate-ref button family, the saturated west-XGPIO F.Cu corridor, J1 display-FPC hauls, and boxed MCU/IC-pin pockets. Highest-value NEXT move: explicitly SELECT one deferred bounded framework task — the **duplicate-ref MST** (unlocks the ~7-net `SWx` user-input button family; `BTN_B_N` already routed ALL OK at D-323, failed only on the collapse) is recommended, or the In2/In3 inner-layer west-XGPIO traverse. No repetitive-maintenance consolidation due this round.
- **Governance.** No BOM/footprint/value/polarity/mechanical/firmware/UX change; DEVICE_SPEC unchanged. **Open owner decisions: NONE** (the framework-task selection is a P2-027 recommendation, not a blocking decision — autonomy continues). Rollback: not applicable (no copper change). All locked invariants preserved (D-249/D-257/D-269/D-275/D-288/D-290, In1/In4 GND roles, In2/In3 capacity, RF/USB/mechanical reservations, D-304..D-323); frozen `beta-full-reference-v1` untouched; journal authoritative (116). **NEXT FBV2-P2-027:** EITHER select+land one bounded framework task (duplicate-ref MST recommended) routing its first newly-unlocked net under the D-286 gate + adding `incremental_probe_024.py`+`G36` on promote, OR route a genuinely-clean functional net if a fresh screen surfaces one. 138/164 rest nets unrouted. PCB routing ~18 %, overall ~76 %, readiness ~78 % (JLCPCB file unchanged). Full analysis: [`audits/2026-08-31-p2-026-d324-characterization-three-pad-escape-walls-no-promote.md`](audits/2026-08-31-p2-026-d324-characterization-three-pad-escape-walls-no-promote.md).

## 2026-08-31 - FBV2-P2-025: D-323 — EIGHTEENTH rest-of-board incremental increment routed and PROMOTED: the accelerometer/add-on presence-detect `ACC_DETECT_N` (3-pad cross-layer, ONE 0.60/0.30 through via + ONE same-layer B.Cu run), a clean increment in an OPEN region 3.88 mm-realized clear of `BAT_PROTECTED_P`; promoted after the cleaner-class `DISP_BL_CTL_STRAP` hit a characterized local wall and `BTN_B_N` failed the gate on the duplicate-ref tact-switch connectivity limit; a governed CTO ACCEPT + PROMOTE (no Phase-A / prior-increment casualty, no new DRC, autonomy CONTINUES, no owner decision), ZERO router-logic change

**THE EIGHTEENTH REST-OF-BOARD INCREMENT IS ON THE AUTHORITATIVE BOARD.** D-322 promoted the reserved/spare community expander GPIO in an open region and mandated the next clean increment in an OPEN region, decided on measured merit (a meaningful coherent functional net preferred over an easy spare when equally clean; do not force a pair across a characterized wall; never route a converter-switching or USB-C connector net merely because the automatic screen says ALLOW). A fresh read-only screen (`w/screen_020.py`) + focused geometry vet (`w/vet_021.py`, live D-322 board) measured the genuinely-clean functional shortlist (netclass, MST edges, straight-path nearest-copper, `BAT_PROTECTED_P`/D-269 proximity). **Two cleaner-class candidates were tested FIRST and set aside:** `DISP_BL_CTL_STRAP` (the display backlight-control strap `U1.16` MCU GPIO / `TP2.1` test point / `R108.1` + `R109.1` series, R109 bridging to the SEPARATE downstream net `DISP_BL_CTL → U17.4` backlight driver — NOT in this increment; 4-pad, all F.Cu, no via, cong 185, 37.854 mm clear of BPP) hit a **characterized LOCAL WALL** — all three MST edges (incl. the SHORT `TP2.1↔U1.16` 5.44 mm and `TP2.1↔R109.1` 10.30 mm, not just the `U1.16↔R108.1` 24.77 mm haul) return `NO_PATH` at 0.200 mm (none even at the 0.05/0.025 mm fine grid) — the dense MCU/backlight pad pocket boxes every terminal (real 0.022 mm proximity to accepted D-318 `BMI270_INT1_STRAP` copper, 0.111 mm to `SD_CARD_DETECT_N`, 0.349 mm to `USB_D_ESD_P`), the `MCU_EN_RC` lesson repeated (`GROUPS['DISP_BL_CTL_STRAP']` annotated, do NOT naively retry at 0.200 mm); `BTN_B_N` (navigation/boot button `SW7.1` F.Cu → `R9.2` pull-up B.Cu → `U2.18` expander B.Cu, one 0.60/0.30 through via in the OPEN south button field, cong 141, 11.025 mm clear of BPP) **routed ALL OK but FAILED the real full-board gate on CONNECTIVITY** — the root cause (verified from the footprint) is that `SW7` is a 4-pin tactile switch whose TWO mechanically-linked terminals BOTH carry pad number "1" on `BTN_B_N` at (49.520, 96.750) and (57.480, 96.750) 7.96 mm apart, and the framework's per-ref MST (`pads_by_ref`) keys nodes by ref.padnum, so the two `SW7.1` pads collapse to a SINGLE node → the second terminal is never driven → one permanent open ratsnest edge (net open_edges 2→1 not 2→0) → gate FAIL; this is a connectivity gap of the WHOLE duplicate-ref button family (every `SWx` tact switch), NOT a copper casualty — the scratch route was discarded, the authoritative board never touched (`GROUPS['BTN_B_N']` annotated, do NOT naively retry any `SWx` net until a duplicate-ref MST lands). The selected candidate, **`ACC_DETECT_N`** (the accelerometer/add-on presence-detect: detect divider/pull `R64.1` F.Cu SMD north → series `R129.2` B.Cu SMD → PCAL9535A expander GPIO `U3.17` B.Cu SMD, a genuine functional low-current low-speed CMOS peripheral detect input — NOT the community-header bank, NOT a converter/rail), is a 3-pad net across TWO faces whose MST is ONE cross-layer edge `R64.1↔R129.2` (a single 0.60/0.30 Default THROUGH via) + ONE same-layer B.Cu edge `R129.2↔U3.17`, in an OPEN region **3.8831 mm-realized clear of `BAT_PROTECTED_P`** (>> the D-269 0.300 mm floor → zero D-269 involvement). Starting HEAD `36ffb2d` (D-322; pushed; `origin/master` identical).

- **Screen + vet (READ-ONLY, live D-322 board).** `w/vet_021.py` (re-verified): `ACC_DETECT_N` edges `R64.1↔R129.2` 19.64 mm CROSS + `R129.2↔U3.17` 19.31 mm same-B; congestion 103 (lowest of the genuinely-clean functional shortlist); straight-MST min to `BAT_PROTECTED_P` = 2.750 mm (>> D-269 0.300 floor). vet nearest-other-copper 0.228 mm (`NFC_5V_EN`) / 0.007 mm (`V3V3_FB`) = GUIDANCE ONLY. Default netclass (0.200 mm width/clearance).
- **`DISP_BL_CTL_STRAP` characterized local wall.** All three MST edges NO_PATH at 0.200 mm (fine grid too), including the short 5.44 mm and 10.30 mm edges — the boxed MCU/backlight pad pocket (cong 185), not an open MCU-pad escape like `SD_CS_N`/`UART0`. Characterized, annotated, not retried at 0.200 mm.
- **`BTN_B_N` duplicate-ref gate failure.** Routed clean on scratch but the per-ref MST collapses `SW7`'s two pad-"1" terminals (7.96 mm apart) to one node → one permanent open edge → gate FAIL (net open_edges 2→1). A connectivity gap of the whole `SWx` duplicate-ref button family, not a copper casualty; authoritative board NEVER touched; a "duplicate-ref MST" deferred framework task.
- **Route + gate (real full-board, D-286).** `route ACC_DETECT_N` ALL OK: `R129.2→U3.17` 35.311 mm B.Cu + `R129.2→R64.1` 20.861 mm (B+F via); 22 segments (3 F.Cu + 19 B.Cu, all 0.200 mm) + 1 via at (57.900, 38.800) in the OPEN north (34.157 mm from every existing barrel); routed copper clears `BAT_PROTECTED_P` by **3.8831 mm** → zero D-269. `gate ACC_DETECT_N` PASS every check: 0 Phase-A copper deleted/altered; 22 new tracks + 1 via all target-net; **only In1/In4 GND planes re-poured** (via anti-pad), other 39 zones identical; all three pads copper-connected, open_edges 2→0; 0 prior Phase-A/increment pairs regressed; ratsnest 667→665 (−2 exact); no new/worse DRC; unconnected 499→499. `promote` re-ran gate PASS, AUTH sha undrifted, merged 2 REST_INC edges (scratch board sha == AUTH sha, zero drift).
- **Promoted board.** `sha256 a861e30e…` → **`a7bf8bdc11f1bc39303c6f6b6c801e3a4a575add64596cc4be20745c57f9f626`**; tracks 759→**781** (+22: 3 F.Cu + 19 B.Cu, 0.200 mm); vias 67→**68** (+1 through via — the first new via since D-316); 6 layers / 41 zones; ratsnest 667→**665** (−2); journal 114→**116** (+2 REST_INC: `R129.2↔U3.17` B.Cu 35.311 mm, `R129.2↔R64.1` B+F via 20.861 mm). Real KiCad DRC identical (`solder_mask_bridge:1 + hole_clearance:5 + lib_footprint_issues:199 + unconnected_items:499`; 0 `clearance`).
- **Tests / integrity.** New **G35** (`ACC_DETECT_N` all 3 pads connected; copper legal 22 trk 0.200 = 3 F.Cu + 19 B.Cu + exactly 1 0.60/0.30 through via; via ≥ 0.80 mm from every barrel, measured 34.157 mm; ADD-ONLY — every prior increment + Phase-A 432/54 preserved); G18–G34 auto-generalise → `router_regression.py` ALL PASS G1–G35, deterministic twice (555 lines / 143 PASS each run, identical G-verdicts). New `incremental_probe_023.py` PASS; `_006..022` + `phaseB_bringup_probe_005` (781/68/116; 26 routed rest nets, 138 unrouted) PASS; `live_fingerprint.py` bumped once; `incremental_baseline_006.json` left stale-by-design (verified unmodified — the gate computes its baseline live). Independent kicad-cli DRC A/B IDENTICAL on committed D-322 and promoted D-323 (both same 6 violations, 499 unconnected). D-269/D-264/DRU board-swap A/B (committed D-322 vs promoted D-323), 4 runs each: `dru` FAIL(2)×4 on BOTH — IDENTICAL, deterministic; `d269` promoted PASS,FAIL(2),FAIL(2),FAIL(2) vs committed FAIL(2)×4 — flips, count always 2; `d264` promoted 2,1,2,3 vs committed 2,1,2,1 — both flip in the 1–3 range = documented intrinsic non-determinism (synthetic Phase-A DRU probes), pre-existing flakes not regressions (new copper is ~2.75–3.88 mm-from-BPP peripheral copper near R64/R129/U3.17, away from the BAT-divider/sense corridors the probes examine); live AUTH sha re-verified `a7bf8bdc…` after the swap.
- **Probe via-total generalization (the ONLY code beyond the GROUPS entry + comments).** D-323 lays the FIRST new via since D-316, so the board via total moved 67→68. The no-via probes `incremental_probe_018..022` pinned the board via total to a hard-coded **67** at their "no-via class" check; this was generalized to `len(via) == EXPECT_VIAS` (the `live_fingerprint` single source of truth), KEEPING each probe's per-net `len(i_via) == 0` contract intact (semantically sound + regression-safe: each net's no-via property is still asserted, only the redundant board-total literal now tracks the SoT, exactly as tracks/ratsnest/journal already do — all 8 prior via-probes `008..017` already pin the total via `EXPECT_VIAS`). `incremental_probe_023.py`'s second via check (which had hard-coded 68) was ALSO aligned to the same `EXPECT_VIAS` convention, keeping its per-net `i_via == 1` contract, so probe_023 survives the next via increment like every prior via-probe (re-verified PASS). ZERO contract weakened.
- **Opportunity & simplification.** New characterized walls: `DISP_BL_CTL_STRAP` boxed MCU/backlight pocket (all 3 edges NO_PATH at 0.200); the WHOLE duplicate-ref button family (`SWx`) blocked by the `pads_by_ref` MST collapse → a "duplicate-ref MST" deferred framework task (alongside the In2/In3 inner-layer west-XGPIO haul). `MCU_EN_RC`, the J1 display-connector haul (`DISP_CS_N`/`DISP_DC`), `BOOT_N`, `U11_PROG`/`PWR_SENSE` all remain characterized. 138/164 rest nets unrouted (26 routed) — continue one clean net/group at a time. No BOM/footprint/value/polarity/mechanical/firmware/UX change; DEVICE_SPEC unchanged.
- **Open owner decisions: NONE.** Rollback: pre-promotion `sha256 a861e30e…` (committed D-322, HEAD `36ffb2d`). PCB routing ~18 %, overall ~76 %, readiness ~78 % (authoritative; JLCPCB file unchanged). **NEXT FBV2-P2-026:** route the next clean rest-of-board increment (single net or small coherent local group in an open region — a fresh `w/screen_020.py` + `w/vet_021.py` pick) at its netclass Default under the D-286 gate; add `incremental_probe_024.py`+`G36` and bump `live_fingerprint.py` once; continue avoiding the west XGPIO corridor, `U11_PROG`/`PWR_SENSE`, RF/NFC/USB/crystals/switching/class-D/rails/community-header mass, the auto-ALLOW converter/USB-C connector traps and every characterized wall (`MCU_EN_RC`, the J1 display-connector haul `DISP_CS_N`/`DISP_DC`, `BOOT_N`, the `DISP_BL_CTL_STRAP` boxed pocket, `U11_PROG`/`PWR_SENSE`); do NOT retry the `SWx` duplicate-ref button family until a duplicate-ref MST lands; hold the inner-layer west-XGPIO haul + the duplicate-ref button MST as deferred framework tasks; 138/164 rest nets unrouted. Full analysis: [`audits/2026-08-31-p2-025-d323-eighteenth-rest-of-board-incremental-increment-acc-detect-n-promoted.md`](audits/2026-08-31-p2-025-d323-eighteenth-rest-of-board-incremental-increment-acc-detect-n-promoted.md).

## 2026-08-31 - FBV2-P2-024: D-322 — SEVENTEENTH rest-of-board incremental increment routed and PROMOTED: the reserved/spare community expander GPIO `RESERVED_SPARE` (3-pad, SAME-LAYER B.Cu MST, NO via), a clean increment in an OPEN region 15.5 mm clear of `BAT_PROTECTED_P`; the held clean alternate, promoted after the meaningful display-control candidates `DISP_CS_N`/`DISP_DC` hit a characterized J1 display-FPC-connector wall and `BOOT_N` routed only via poor 2.5× detours; a governed CTO ACCEPT + PROMOTE (no Phase-A / prior-increment casualty, no new DRC, autonomy CONTINUES, no owner decision), ZERO router-logic change

**THE SEVENTEENTH REST-OF-BOARD INCREMENT IS ON THE AUTHORITATIVE BOARD.** D-321 promoted the microSD SPI chip-select in an open region and mandated the next clean increment in an OPEN region, deeply vetting `RESERVED_SPARE`, `BOOT_N`, `DISP_DC` plus 1–2 other genuinely-functional candidates — preferring meaningful function over a spare when equally clean, treating `BOOT_N` sensitivity carefully, and never routing a converter-switching or USB-C connector net merely because the automatic screen says ALLOW. A fresh read-only screen (`w/screen_020.py`) measured all 140 unrouted rest nets (40 ALLOW / 100 EXCL); the auto-classifier trap was re-confirmed and its converter-switching/IR-emitter/USB-C auto-ALLOW nets rejected on measured role. A focused geometry vet (`w/vet_021.py`) measured the mandate's shortlist + two other functional candidates: `RESERVED_SPARE` (cong 84, B.Cu, 15.5 mm clear of BPP), `DISP_CS_N` (cong 184), `DISP_DC` (cong 203), `BOOT_N` (cong 231), `DISP_BL_CTL_STRAP` (cong 185). **The meaningful display-control candidates were tested FIRST (prefer function over a spare):** `DISP_CS_N` (the display SPI chip-select `U1.18`/`R26.2`/`J1.38`, the direct analog of D-321's `SD_CS_N`) routes its short MCU-side edge clean off the series resistor `R26.2` but its long `J1.38↔R26.2` haul to the tight display connector returns `NO_PATH` at 0.200 mm (even the 0.05/0.025 mm fine grid); `DISP_DC` (`U1.22 → J1.37`, adjacent FPC pin) ALSO returns `NO_PATH` — **characterizing the J1 display-FPC-connector interior haul as a shared local wall** (`GROUPS['DISP_CS_N']`/`['DISP_DC']` annotated, do NOT naively retry). `BOOT_N` (the meaningful non-J1 alternative, the ESP32 boot-mode strap `SW1.1`/`R2.2`/`U1.27`) routed ALL OK but only via poor 2.5× detours (~110 mm of meandering copper for a boot-critical strap) — not equally clean, set aside (sensitivity treated carefully). The held clean alternate **`RESERVED_SPARE`** (`R130.2` + `TP41.1` + `U23.7` PCAL expander, all B.Cu → two SAME-LAYER B.Cu runs with NO via, the cleanest incremental class, in an OPEN region **15.5 mm clear of `BAT_PROTECTED_P`**) was routed, gated PASS, and promoted. Starting HEAD `e3e2a8d` (D-321; pushed; `origin/master` identical).

- **Screen + vet (READ-ONLY, live D-321 board).** `w/screen_020.py`: 140 unrouted rest nets, 40 ALLOW / 100 EXCL. `w/vet_021.py` measured the functional shortlist; `RESERVED_SPARE` = 3-pad Default B.Cu, MST 3.54 + 9.80 mm same-layer, 15.503 mm clear of `BAT_PROTECTED_P` (zero D-269).
- **J1 display-connector wall (`DISP_CS_N`/`DISP_DC`).** Scratch routes: `DISP_CS_N` short edge `R26.2↔U1.18` OK (2.9 mm) but long `J1.38↔R26.2` NO_PATH at 0.200 mm (fine grid); `DISP_DC` single `J1.37↔U1.22` NO_PATH at 0.200 mm. A genuine local congestion wall at the tight J1 display FPC connector; characterized, annotated, not retried at 0.200 mm.
- **`BOOT_N` set aside.** Scratch route ALL OK but `R2.2↔U1.27` 62.9 mm (vs 25.4 straight, 2.48×) + `U1.27↔SW1.1` 47.2 mm (vs 22.4, 2.11×) = ~110 mm of copper for a boot-critical strap — not equally clean, sensitivity treated carefully.
- **Route + gate (real full-board, D-286).** `route RESERVED_SPARE` ALL OK: `R130.2→U23.7` 4.434 mm + `U23.7→TP41.1` 10.939 mm, 10 B.Cu segments, 0 via. `gate RESERVED_SPARE` PASS every check: 0 Phase-A altered; 10 new items all target-net; **0 zones fill-changed** (no via → no In1/In4 re-pour); all three pads copper-connected, open_edges 2→0; 0 prior pairs regressed; ratsnest 669→667 (−2 exact); no new/worse DRC; unconnected 499→499. `promote` re-ran gate PASS, AUTH sha undrifted, merged 2 REST_INC edges.
- **Promoted board.** `sha256 68d44b54…` → **`a861e30e5760515288ef9a3fc0c21ea6d3e9c31409f9181dd66d56ed0628efd1`**; tracks 749→**759** (+10 B.Cu 0.200 mm); vias **67** (unchanged — no via); 6 layers / 41 zones; ratsnest 669→**667** (−2); journal 112→**114** (+2 REST_INC). Real KiCad DRC identical (`solder_mask_bridge:1 + hole_clearance:5 + lib_footprint_issues:199 + unconnected_items:499`; 0 `clearance`).
- **Tests / integrity.** New **G34** (all three pads connected, 10 trk 0.200 B.Cu 0 vias, ADD-ONLY); G18–G33 auto-generalise → `router_regression.py` ALL PASS G1–G34, deterministic twice; new `incremental_probe_022.py` PASS; `_006..021` + `phaseB_bringup_probe_005` (759/67/114; 25 routed rest nets, 139 unrouted) PASS; `live_fingerprint.py` bumped once; `incremental_baseline_006.json` left stale-by-design (reverted); independent kicad-cli DRC matches (`clearance` 0, 0 schematic-parity); D-269/D-264/DRU board-swap A/B (committed D-321 vs promoted D-322) — `d269` FAIL(2)=FAIL(2) and `dru` FAIL(2)=FAIL(2) IDENTICAL, `d264` differed single-run (3 vs 2) but four-run repeats proved intrinsic (flips 1,2,2,2 on committed D-321 and 2,1,1,3 on promoted D-322, both byte-identical) = documented intrinsic non-determinism, all pre-existing flakes not regressions (new copper is B.Cu near U23/R130/TP41, ~15 mm from the BAT tree the probes test).
- **Governance.** No BOM/footprint/value/polarity/mechanical/firmware/UX change; DEVICE_SPEC unchanged. Open owner decisions: NONE. Rollback: pre-promotion `sha256 68d44b54…` (committed D-321, HEAD `e3e2a8d`). PCB routing ~18 %, overall ~76 %, readiness ~78 % (authoritative; JLCPCB file unchanged). **NEXT FBV2-P2-025:** the next clean rest-of-board increment (a fresh screen pick) under the D-286 gate; add `incremental_probe_023.py`+`G35`; keep avoiding the west XGPIO corridor, `U11_PROG`/`PWR_SENSE`, RF/NFC/USB/crystals/switching/class-D/rails/community-header mass, the auto-ALLOW converter/USB-C traps, the `MCU_EN_RC` wall and the J1 display-connector-haul wall; 139/164 rest nets unrouted.

## 2026-08-31 - FBV2-P2-023: D-321 — SIXTEENTH rest-of-board incremental increment routed and PROMOTED: the microSD SPI chip-select `SD_CS_N` (3-pad, SAME-LAYER F.Cu MST, NO via), a clean increment in an OPEN region 50.1 mm clear of `BAT_PROTECTED_P`; the mandate's headline candidate `Net-(U1-EN)` hit a characterized local wall and was set aside; a governed CTO ACCEPT + PROMOTE (no Phase-A / prior-increment casualty, no new DRC, autonomy CONTINUES, no owner decision), ZERO router-logic change

**THE SIXTEENTH REST-OF-BOARD INCREMENT IS ON THE AUTHORITATIVE BOARD.** D-320 promoted the IR transmit carrier control leg in an open region and mandated the next clean increment in an OPEN region, decided on measured merit (a meaningful coherent functional net preferred over an easy spare when equally clean; treat MCU EN/BOOT sensitivity carefully; do not accidentally route a converter-switching or USB-C connector net merely because the automatic screen says ALLOW), deeply vetting `Net-(U1-EN)`, `RESERVED_SPARE`, `BOOT_N` plus 1–2 other functional candidates. A read-only screen (`w/screen_020.py`) measured all 141 unrouted rest nets (41 ALLOW / 100 EXCL); the auto-classifier trap was re-confirmed and its converter-switching (`Net-(L1-Pad1/2)`, `Net-(U13-SW/FB)`, `Net-(U12-*)`, `BL_SW`), IR-emitter power (`IR_LED_A/K`) and USB-C connector (`Net-(J3-CC1/CC2/SHIELD)`) auto-ALLOW nets were rejected on measured role. A focused geometry vet (`w/vet_021.py`) measured the genuinely-clean functional shortlist: `Net-(U1-EN)` (cong 66), `RESERVED_SPARE` (cong 84), `SD_CS_N` (cong 102), `BOOT_N`/`DISP_DC` (cong 203). **The mandate's headline candidate `Net-(U1-EN)`** (the ESP32 EN power-on-reset RC: `U1.3` EN + `R1.1` pull-up + `C1.2` filter cap) was scratch-tested FIRST and hit a **characterized LOCAL WALL** — its natural MST short edge `C1.2↔U1.3` (7.81 mm) returns `NO_PATH` at 0.200 mm (none even at the 0.05/0.025 mm fine grid) in the dense U1-EN pad pocket, and the other edge only routes with a 58.46 mm detour (2.6× straight) — a poor path for a reset line also carrying a 0.335 mm `USB_D_MCU_N` proximity flag; treating the EN sensitivity carefully, EN was NOT promoted (`GROUPS['MCU_EN_RC']` annotated **do NOT naively retry**). The held functional alternate and selected candidate, **`SD_CS_N`** (`U1.25` MCU + `R25.2` + `J2.2` microSD socket, the microSD SPI chip-select), is a genuine functional **point-to-point control** (NOT a shared MOSI/MISO/CLK bus line — the chip-select travels with its own synchronous SPI-A bus, benign coupling) whose 3-pad MST is two **SAME-LAYER F.Cu runs with NO via** — the cleanest incremental class — in an OPEN region **50.1 mm clear of `BAT_PROTECTED_P`** (zero D-269 involvement), chosen over `RESERVED_SPARE` (a spare of lower merit, routed clean on scratch and HELD). Starting HEAD `bb7fed4` (D-320; pushed; `origin/master` identical).

- **Screen + vet (READ-ONLY, live D-320 board).** `w/screen_020.py`: 141 unrouted rest nets, 41 ALLOW / 100 EXCL (EXCL: 31 RF/NFC/radio, 16 switching/rail/class-D, 15 west/east XGPIO, 13 shared data/I2C bus, 8 USB, 4 RF SPI, 4 community-header, 3 crystal/clock, 2 `PWR_SENSE`, 2 `U11_PROG`, 2 bulk rail). `w/vet_021.py` measured the functional shortlist; `SD_CS_N` = 3-pad Default, MST 14.99 + 31.98 mm same-layer, 50.076 mm clear of `BAT_PROTECTED_P`.
- **MCU_EN_RC wall (`Net-(U1-EN)`).** Scratch route: `C1.2↔U1.3` NO_PATH (0.05/0.025 mm fine grid); `U1.3↔R1.1` OK but 58.457 mm (2.6×). A genuine local congestion wall around the EN pin; not worth a bounded framework change for a sensitive reset line with a USB-proximity flag. Characterized, held, not retried.
- **Route + gate (real full-board, D-286).** `route SD_CS_N` ALL OK: `J2.2→U1.25` 48.420 mm + `U1.25→R25.2` 21.081 mm, 20 F.Cu segments, 0 via. `gate SD_CS_N` PASS every check: 0 Phase-A altered; 20 new items all target-net; **0 zones fill-changed** (no via → no In1/In4 re-pour); all three pads copper-connected, open_edges 2→0; 0 prior pairs regressed; ratsnest 671→669 (−2 exact); no new/worse DRC; unconnected 499→499. `promote` re-ran gate PASS, AUTH sha undrifted, merged 2 REST_INC edges.
- **Promoted board.** `sha256 4e706490…` → **`68d44b54df91d607f689215c0da5db249b13fcd1ac189b9ab78ceb6366d25e46`**; tracks 729→**749** (+20 F.Cu 0.200 mm); vias **67** (unchanged — no via); 6 layers / 41 zones; ratsnest 671→**669** (−2); journal 110→**112** (+2 REST_INC). Real KiCad DRC identical (`solder_mask_bridge:1 + hole_clearance:5 + lib_footprint_issues:199 + unconnected_items:499`; 0 `clearance`).
- **Tests / integrity.** New **G33** (all three pads connected, 20 trk 0.200 F.Cu 0 vias, ADD-ONLY); G18–G32 auto-generalise → `router_regression.py` ALL PASS (G1–G33), deterministic twice. New `incremental_probe_021.py` PASS; `_006..020` + `phaseB_bringup_probe_005` (749/67/112; 24 routed rest nets, 140 unrouted) PASS. `live_fingerprint.py` bumped once to D-321; `incremental_baseline_006.json` left stale-by-design (reverted). Independent kicad-cli DRC (`--format json --severity-error --schematic-parity`) = `{solder_mask_bridge:1, hole_clearance:5}`, 499 unconnected, 0 schematic-parity, 0 `clearance`. D-269/D-264/DRU board-swap A/B (committed D-320 vs promoted D-321): `dru` FAIL(2)=FAIL(2) IDENTICAL; `d269` (FAIL,PASS,FAIL,PASS) and `d264` (2,2,3,2) flip on the byte-identical D-320 board = documented intrinsic non-determinism, all pre-existing flakes not regressions (new copper is F.Cu near U1.25/J2.2/R25.2, ~50 mm from the BAT tree the probes test); live AUTH sha re-verified `68d44b54…` after the swap.
- **Opportunity & simplification.** Many of the 140 remaining rest nets are same-layer no-via control nets in open regions — continue one clean net/group at a time. Held clean alternates for FBV2-P2-024: `RESERVED_SPARE` (routed clean on scratch), `BOOT_N`, `DISP_DC`, or a fresh screen pick. `MCU_EN_RC` (`Net-(U1-EN)`) is a characterized wall — do NOT naively retry. The In2/In3 inner-layer west-XGPIO haul remains the deferred framework task. No BOM/footprint/value/polarity/mechanical/firmware/UX change; DEVICE_SPEC unchanged.
- **Open owner decisions: NONE.** Rollback: pre-promotion `sha256 4e706490389655cb8b68f8c15249a813072f36a9ea9e6ffaeb1fdd2194c0bf34` (committed D-320, HEAD `bb7fed4`). Full analysis: [`audits/2026-08-31-p2-023-d321-sixteenth-rest-of-board-incremental-increment-sd-cs-n-promoted.md`](audits/2026-08-31-p2-023-d321-sixteenth-rest-of-board-incremental-increment-sd-cs-n-promoted.md).

---

## 2026-08-31 - FBV2-P2-022: D-320 — FIFTEENTH rest-of-board incremental increment routed and PROMOTED: the IR transmit carrier CONTROL leg `IR_TX_GPIO16` (2-pad, SAME-LAYER F.Cu MST, NO via), a clean increment in an OPEN region 35.2 mm clear of `BAT_PROTECTED_P`; a governed CTO ACCEPT + PROMOTE (no Phase-A / prior-increment casualty, no new DRC, autonomy CONTINUES, no owner decision), ZERO router-logic change

**THE FIFTEENTH REST-OF-BOARD INCREMENT IS ON THE AUTHORITATIVE BOARD.** D-319 promoted the debug-console UART transmit line in an open region and mandated the next clean increment in an OPEN region, decided on measured merit (best coherent low-risk increment, not merely the shortest or the easiest spare; do not accidentally route a converter-switching or connector net merely because the automatic screen says ALLOW), with `IR_TX_GPIO16` to be treated as the low-current MCU control/carrier GPIO only — distinct from the excluded `IR_LED_A/K` emitter-power / switch path — and its topology/isolation verified before selection. A read-only screen (`w/screen_020.py`) measured all 142 unrouted rest nets (42 ALLOW / 100 EXCL); the auto-classifier trap was re-confirmed and its converter-switching (`Net-(L1-Pad1/2)`, `Net-(U13-SW/FB)`, `Net-(U12-*)`, `BL_SW`) and USB-C connector (`Net-(J3-CC1/CC2/SHIELD)`) auto-ALLOW nets were rejected on measured role. A focused geometry vet (`w/vet_021.py`) measured the genuinely-clean functional shortlist and **confirmed the isolation**: the net `/IR_TX_GPIO16` = {`U1.9`, `R22.1`}; the far side `R22.2` belongs to the SEPARATE net `IR_GATE` ({`Q1.1`, `R22.2`, `R23.1`} = the Q1 gate/switch node) and the emitter-power path is `IR_LED_A`/`IR_LED_K` — both EXCLUDED and NOT part of this increment; series resistor R22 isolates the MCU control leg from the switching output. The selected candidate, **`IR_TX_GPIO16`** (`U1.9` ESP32 GPIO16 → `R22.1` series-drive resistor, the IR transmit carrier control leg), is a dedicated 2-pad point-to-point net whose single MST edge is a **SAME-LAYER F.Cu run with NO via** — the cleanest incremental class — in an OPEN region **35.2 mm clear of `BAT_PROTECTED_P`** (zero D-269 involvement). Starting HEAD `8d27e3a` (D-319; pushed; `origin/master` identical).

- **Evidence-first selection.** `w/vet_021.py` measured, per candidate, pad layers/positions, netclass, MST edges (length + same/cross layer), straight-path nearest-other copper, and straight-MST distance to `BAT_PROTECTED_P`. `IR_TX_GPIO16` (cong 38, no via, 35.2 mm from BPP, genuine functional MCU control role) was chosen over `Net-(U1-EN)` (cong 59, 2 edges incl. a 22 mm haul 0.335 mm from the USB_D_MCU_N diff pair, EN a more sensitive reset line) and `RESERVED_SPARE` (a mere spare of lower merit — not chosen when a meaningful control net is equally clean). The excluded IR switch/emitter nets `IR_GATE`/`IR_LED_A`/`IR_LED_K` were confirmed distinct and set aside.
- **Route→gate→promote (real full-board, D-286).** New single-net `GROUPS['IR_TX_GPIO16']` (`layer='F'`, Default 0.200 mm, no via); `incremental_router.py`/`qrouter.py` logic UNCHANGED. `route` ALL OK (single F.Cu run R22.1↔U1.9, a legal same-layer detour to 23.153 mm / 13 seg around the GND pinch on the straight 8.35 mm path, 0 via). `gate` PASS every check (0 Phase-A altered, 13 new items all target-net, 0 zones fill-changed — no via, net open_edges 1→0, 0 prior pairs regressed, ratsnest 672→671 −1, no new/worse DRC, unconnected 499→499). `promote` re-ran gate PASS, AUTH sha undrifted, merged 1 REST_INC edge.
- **Promoted:** `sha256 57dcc8af…` → **`4e706490389655cb8b68f8c15249a813072f36a9ea9e6ffaeb1fdd2194c0bf34`**; tracks 716→**729** (+13 F.Cu 0.200 mm); vias **67** (unchanged — no via); 6 layers / 41 zones; ratsnest 672→**671** (−1); journal 109→**110** (+1 REST_INC). Real KiCad DRC identical (`solder_mask_bridge:1 + hole_clearance:5 + lib_footprint_issues:199 + unconnected_items:499`; 0 `clearance`).
- **Tests:** new **G32** (both pads connected; 13 trk 0.200 mm all F.Cu, 0 vias; ADD-ONLY); G18–G31 auto-generalise → `router_regression.py` ALL PASS (G1–G32), deterministic twice; new `incremental_probe_020.py` PASS; `_006..019` + `phaseB_bringup_probe_005` (729/67/110; 23 routed rest nets, 141 unrouted) PASS; `live_fingerprint.py` bumped once (D-320); `incremental_baseline_006.json` left stale-by-design (reverted); independent kicad-cli DRC matches (`clearance` 0); D-269/D-264/DRU board-swap A/B (committed D-319 vs promoted D-320) — `d269` FAIL(2)=FAIL(2) and `dru` FAIL(2)=FAIL(2) IDENTICAL, `d264` flips on both byte-identical boards (D-320 1,2,2,1; D-319 2,1,2,2) = documented intrinsic non-determinism, all pre-existing flakes not regressions.
- **Opportunity & Simplification:** many of the 141 remaining rest nets are same-layer no-via control nets in open regions away from the west corridor + BAT tree — continue one clean net/group at a time; `w/screen_020.py` + `w/vet_021.py` remain the reusable evidence-first pair; In2/In3 inner-layer west-XGPIO haul stays the deferred framework task. No BOM/footprint/value/polarity/mechanical/firmware/UX change; DEVICE_SPEC unchanged.
- **NEXT FBV2-P2-023:** route the next clean rest-of-board increment (single net or small coherent local group in an open region — `Net-(U1-EN)`/`RESERVED_SPARE`/`BOOT_N` or a fresh screen pick) at its netclass Default under the D-286 gate, add `incremental_probe_021.py`+`G33` on promote; continue avoiding the west XGPIO corridor, `U11_PROG`/`PWR_SENSE`, RF/NFC/USB/crystals/switching/class-D/rails/community-header mass and the auto-ALLOW converter-switching/USB-C connector traps; hold the inner-layer west-XGPIO haul as the deferred framework task. **Open owner decisions: NONE;** `JLCPCB_READINESS` unchanged (~77 %). Rollback: pre-promotion `sha256 57dcc8af…` (committed D-319, HEAD `8d27e3a`). Full analysis: [`audits/2026-08-31-p2-022-d320-fifteenth-rest-of-board-incremental-increment-ir-tx-gpio16-promoted.md`](audits/2026-08-31-p2-022-d320-fifteenth-rest-of-board-incremental-increment-ir-tx-gpio16-promoted.md).

## 2026-08-31 - FBV2-P2-021: D-319 — FOURTEENTH rest-of-board incremental increment routed and PROMOTED: the debug-console UART transmit line `UART0_TXD_DBG` (2-pad, SAME-LAYER F.Cu MST, NO via), a clean increment in an OPEN region 31.3 mm clear of `BAT_PROTECTED_P`; a governed CTO ACCEPT + PROMOTE (no Phase-A / prior-increment casualty, no new DRC, autonomy CONTINUES, no owner decision), ZERO router-logic change

**THE FOURTEENTH REST-OF-BOARD INCREMENT IS ON THE AUTHORITATIVE BOARD.** D-318 promoted the first clean increment outside the west-XGPIO corridor and mandated the next clean increment in an OPEN region, decided on measured merit (best coherent low-risk increment, not merely the shortest; do not force a pair across a characterized power-tree wall; do not accidentally route a converter-switching or connector net merely because the automatic screen says ALLOW). A read-only screen (`w/screen_020.py`) measured all 143 unrouted rest nets (43 ALLOW / 100 EXCL); the auto-classifier trap was re-confirmed and its converter-switching (`Net-(L1-Pad1/2)`, `Net-(U13-SW/FB)`, `Net-(U12-*)`, `BL_SW`, the 16-pad power net `BQ25185_SYS`) and USB-C connector (`Net-(J3-CC1/CC2/SHIELD)`) auto-ALLOW nets were rejected on measured role. A focused geometry vet (`w/vet_021.py`) measured the genuinely-clean functional shortlist. The selected candidate, **`UART0_TXD_DBG`** (U1.37 ESP32 MCU → TP35.1 test point, the debug-console UART0 transmit output), is a dedicated 2-pad point-to-point net whose single MST edge is a **SAME-LAYER F.Cu run with NO via** — the cleanest incremental class — in an OPEN region **31.3 mm clear of `BAT_PROTECTED_P`** (zero D-269 involvement). Starting HEAD `c7313cc` (D-318; pushed; `origin/master` identical).

- **Evidence-first selection + pair rejection.** `w/vet_021.py` measured, per candidate, pad layers/positions, netclass, MST edges (length + same/cross layer), straight-path nearest-other copper, and straight-MST distance to `BAT_PROTECTED_P`. `UART0_TXD_DBG` (cong 9, no via, 31.3 mm from BPP) beat `IR_TX_GPIO16` (cong 38), `Net-(U1-EN)` (cong 56), `RESERVED_SPARE` (cong 84). The vetted `BQ25185_STAT1/STAT2` charger-status pair was measured **NOT low-risk** (STAT2 straight-MST 0.024 mm from `BAT_PROTECTED_P`, both 4-pad hauls thread the U11/BQ25185 power-tree wall) → rejected under "do not force a pair across a characterized power-tree wall"; `IR_LED_A`/`IR_LED_K` set aside as the IR-emitter power/Q1 switch node.
- **Route→gate→promote (real full-board, D-286).** New single-net `GROUPS['UART0_TXD_DBG']` (`layer='F'`, Default 0.200 mm, no via); `incremental_router.py`/`qrouter.py` logic UNCHANGED. `route` ALL OK (single F.Cu run TP35.1↔U1.37 31.755 mm; 7 seg, 0 via). `gate` PASS every check (0 Phase-A altered, 7 new items all target-net, 0 zones fill-changed — no via, net open_edges 1→0, 0 prior pairs regressed, ratsnest 673→672 −1, no new/worse DRC, unconnected 499→499). `promote` re-ran gate PASS, AUTH sha undrifted, merged 1 REST_INC edge.
- **Promoted:** `sha256 78bf82da…` → **`57dcc8affb6c0f85f747fba025463b9cf0897c6712709692151020f56fdb8adf`**; tracks 709→**716** (+7 F.Cu 0.200 mm); vias **67** (unchanged — no via); 6 layers / 41 zones; ratsnest 673→**672** (−1); journal 108→**109** (+1 REST_INC). Real KiCad DRC identical (`solder_mask_bridge:1 + hole_clearance:5 + lib_footprint_issues:199 + unconnected_items:499`; 0 `clearance`).
- **Tests:** new **G31** (both pads connected; 7 trk 0.200 mm all F.Cu, 0 vias; ADD-ONLY); G18–G30 auto-generalise → `router_regression.py` ALL PASS (G1–G31), deterministic twice; new `incremental_probe_019.py` PASS; `_006..018` + `phaseB_bringup_probe_005` (716/67/109; 22 routed rest nets, 142 unrouted) PASS; `live_fingerprint.py` bumped once (D-319); `incremental_baseline_006.json` left stale-by-design (reverted); independent kicad-cli DRC matches (`clearance` 0); D-269/D-264/DRU board-swap A/B (committed D-318 vs promoted D-319) — `d269` FAIL(2)=FAIL(2) and `dru` FAIL(2)=FAIL(2) IDENTICAL, `d264` flips 1↔2 on the byte-identical D-319 board (1,2,2,1) = documented intrinsic non-determinism, all pre-existing flakes not regressions.
- **Opportunity & Simplification:** many of the 142 remaining rest nets are same-layer no-via control nets in open regions away from the west corridor + BAT tree — continue one clean net/group at a time; `w/vet_021.py` is now a reusable read-only geometry vet complementing `w/screen_020.py`; In2/In3 inner-layer west-XGPIO haul stays the deferred framework task. No BOM/footprint/value/polarity/mechanical/firmware/UX change; DEVICE_SPEC unchanged.
- **NEXT FBV2-P2-022:** route the next clean rest-of-board increment (single net or small coherent local group in an open region — `IR_TX_GPIO16`/`Net-(U1-EN)`/`RESERVED_SPARE` or a fresh screen pick) at its netclass Default under the D-286 gate, add `incremental_probe_020.py`+`G32` on promote; continue avoiding the west XGPIO corridor, `U11_PROG`/`PWR_SENSE`, RF/NFC/USB/crystals/switching/class-D/rails/community-header mass and the auto-ALLOW converter-switching/USB-C connector traps; hold the inner-layer west-XGPIO haul as the deferred framework task. **Open owner decisions: NONE;** `JLCPCB_READINESS` unchanged (~77 %). Rollback: pre-promotion `sha256 78bf82da…` (committed D-318, HEAD `c7313cc`). Full analysis: [`audits/2026-08-31-p2-021-d319-fourteenth-rest-of-board-incremental-increment-uart0-txd-dbg-promoted.md`](audits/2026-08-31-p2-021-d319-fourteenth-rest-of-board-incremental-increment-uart0-txd-dbg-promoted.md).

## 2026-08-31 - FBV2-P2-020: D-318 — THIRTEENTH rest-of-board incremental increment routed and PROMOTED: the IMU/I2C-local interrupt strap `BMI270_INT1_STRAP` (4-pad, ALL F.Cu same-layer MST, NO via), the first clean increment OUTSIDE the saturated west-XGPIO F.Cu corridor (the D-317 mandate); a governed CTO ACCEPT + PROMOTE (no Phase-A / prior-increment casualty, no new DRC, autonomy CONTINUES, no owner decision), ZERO router-logic change

**THE THIRTEENTH REST-OF-BOARD INCREMENT IS ON THE AUTHORITATIVE BOARD — the first OUTSIDE the west XGPIO corridor.** D-317 characterised `XGPIO2` as a corridor-capacity wall and mandated the next clean increment in an OPEN region. The stale `CURRENT_STATE.md` §5 (which still said FBV2-P2-018) was repaired to the D-317 truth (FBV2-P2-020); a read-only screen (`w/screen_020.py`) then measured all 144 unrouted rest nets (44 ALLOW / 100 EXCL). The selected candidate, **`BMI270_INT1_STRAP`** (R18.2/R110.1/TP3.1 → U1.15 GPIO, the BMI270 IMU INT1 interrupt MCU-side leg — the mandate's welcomed IMU/I2C-local category), is a 4-pad multi-terminal net whose MST is **three SAME-LAYER F.Cu runs with NO via** — the cleanest incremental class. Starting HEAD `cacb68d` (D-317; pushed; `origin/master` identical).

- **Evidence-first selection.** `w/screen_020.py` ranked all 144 unrouted rest nets (pad layers/span/MST/via-need/congestion/netclass + category screen); rejected the mandate-forbidden classes (west/east XGPIO corridor, RF/NFC/radio incl. `04_SPI_B`, USB, shared bus data/clocks, switching/boost/class-D, community-header mass, `U11_PROG`, `PWR_SENSE`, rails). Cleanest ALLOW no-via singletons vetted on merit (several auto-ALLOW nets are actually converter-switching / USB-C connector nets — rejected on inspection). Alternates held: `UART0_TXD_DBG`, `RESERVED_SPARE`, `BQ25185_STAT1/2`. No bundling for throughput.
- **Route→gate→promote (real full-board, D-286).** New single-net `GROUPS['IMU_INT1_STRAP']` (`layer='F'`, Default 0.200 mm, no via); `incremental_router.py`/`qrouter.py` logic UNCHANGED. `route` ALL OK (R110.1↔R18.2 2.829 mm, R18.2↔U1.15 4.646 mm, R110.1↔TP3.1 11.682 mm; 18 F.Cu seg, 0 via). `gate` PASS every check (0 Phase-A altered, 18 new items all target-net, 0 zones fill-changed — no via, net open_edges 3→0, 0 prior pairs regressed, ratsnest 676→673 −3, no new/worse DRC, unconnected 499→499). `promote` re-ran gate PASS, AUTH sha undrifted, merged 3 REST_INC edges.
- **Promoted:** `sha256 d730c74d…` → **`78bf82da537a22697a860c23822599246e0534a8c4c311e12bc3d5b857a28816`**; tracks 691→**709** (+18 F.Cu 0.200 mm); vias **67** (unchanged — no via); 6 layers / 41 zones; ratsnest 676→**673** (−3); journal 105→**108** (+3 REST_INC). Real KiCad DRC identical (`solder_mask_bridge:1 + hole_clearance:5 + lib_footprint_issues:199 + unconnected_items:499`; 0 `clearance`).
- **Tests:** new **G30** (all four pads connected; 18 trk 0.200 mm all F.Cu, 0 vias; ADD-ONLY); G18–G29 auto-generalise → `router_regression.py` ALL PASS (G1–G30), deterministic twice; new `incremental_probe_018.py` PASS; `_006..017` + `phaseB_bringup_probe_005` (709/67/108; 21 routed rest nets, 143 unrouted) PASS; `live_fingerprint.py` bumped once (D-318); independent kicad-cli DRC matches (`clearance` 0, 0 schematic-parity); D-269/D-264/DRU board-swap A/B (committed D-316 vs promoted D-318) verdicts IDENTICAL (pre-existing synthetic/intrinsic flakes, not regressions).
- **Opportunity & Simplification:** many of the 143 remaining rest nets are same-layer no-via control nets in open regions away from the west corridor + BAT tree — continue one clean net/group at a time; In2/In3 inner-layer west-XGPIO haul stays the deferred framework task. No BOM/footprint/value/polarity/mechanical/firmware/UX change; DEVICE_SPEC unchanged.
- **NEXT FBV2-P2-021:** route the next clean rest-of-board increment (single net or small coherent local group in an open region) at its netclass Default under the D-286 gate, add `incremental_probe_019.py`+`G31` on promote; continue avoiding the west XGPIO corridor, `U11_PROG`/`PWR_SENSE`, RF/NFC/USB/crystals/switching/class-D/rails/community-header mass; hold the inner-layer west-XGPIO haul as the deferred framework task. **Open owner decisions: NONE;** `JLCPCB_READINESS` unchanged (~77 %). Rollback: pre-promotion `sha256 d730c74d…` (committed D-316, HEAD `cacb68d`). Full analysis: [`audits/2026-08-31-p2-020-d318-thirteenth-rest-of-board-incremental-increment-imu-int1-strap-promoted.md`](audits/2026-08-31-p2-020-d318-thirteenth-rest-of-board-incremental-increment-imu-int1-strap-promoted.md).

## 2026-08-31 - FBV2-P2-019: D-317 — the SINGLE west XGPIO net `XGPIO2` is now a MEASURED CORRIDOR-CAPACITY WALL on the live D-316 board — NOT PROMOTED; a governed CTO characterization with ZERO authoritative copper change (board byte-identical to committed D-316), autonomy CONTINUES, no owner decision

**NO COPPER CHANGE — CLEAN CHARACTERIZATION BOUNDARY.** D-316 promoted the single west XGPIO net `XGPIO3` (R54.1 F.Cu → U3.7 B.Cu) and named `XGPIO2` (R53.1 F.Cu → U3.6 B.Cu) as the next candidate, with the explicit caution that its pre-D-316 0.6859 mm BPP margin must not be assumed to survive the added XGPIO3 copper/via. Screened faithfully on the live D-316 board → **`XGPIO2` alone at 0.200 mm does not route (NO_FAR_RUN).** The authoritative PCB is untouched (`sha256 d730c74d186ebcc7d2f0aa513776778ce1cb9c9659029a2fffd5e2261e3ac97d`, 691 trk / 67 via / ratsnest 676 / journal 105). Starting HEAD `6410e1f` (D-316; pushed; `origin/master` identical).

- **`XGPIO2` alone @ 0.200 mm Default → FAIL NO_FAR_RUN** (`w/screen_019.py`, one managed foreground process, 67 existing barrels injected incl. the D-316 XGPIO3 via): escape from U3.6 succeeds but the long ~116 mm F.Cu haul from R53.1 has **no legal 0.200 mm corridor**. The **one authorized bounded alternative** — the existing D-310 `via_offset` transition relocation (2.5 mm, **zero new router logic**), `w/screen_019_offset.py` — **also FAILs NO_FAR_RUN**, proving the wall is the **haul corridor**, not the via site.
- **This is the D-315 corridor-capacity wall realized.** D-315 proved the D-313/D-314-congested west F.Cu corridor admits ONE 116 mm haul, not two parallel ones; D-316 spent that one slot on the `XGPIO3` haul (now REAL laid copper); `XGPIO2` (R53, U3.6) is the blocked second parallel haul. On the D-314 board (before XGPIO3) `XGPIO2` alone routed at (55.300, 78.150) — but that site is now 0.450 mm centre-to-centre from the D-316 `XGPIO3` barrel (55.300, 77.700), a hole-hole 0.150 mm < 0.25 collision — so **the 0.6859 mm margin did not survive**, exactly as the task required verifying.
- **Integrity (board pristine):** `sha256 d730c74d…` before/after both screens (no `route`/`gate`/`promote` on the authoritative project; only gitignored `w/{SGL019_2, SGL019O_2}` scratch; no orphan; git tree clean). `router_regression.py` **ALL PASS G1–G29 twice (deterministic)**; `incremental_probe_006..017` + `phaseB_bringup_probe_005` (691/67/105; 20 routed rest nets, 144 unrouted) all PASS; `live_fingerprint.py` SoT still at D-316. Independent `kicad-cli` DRC `{solder_mask_bridge:1, hole_clearance:5, lib_footprint_issues:199, unconnected_items:499}` (`clearance` 0) — matches the D-316 gate. D-269/D-264/DRU board-swap trivially byte-identical (current board IS committed D-316 → no regression possible; `d269` FAIL(2)/`d264` 2-failed/`dru` FAIL(2) are the known synthetic/intrinsic flakes characterized at D-316).
- **No rule/logic change; no owner decision.** Full analysis: [`audits/2026-08-31-p2-019-d317-xgpio2-single-west-corridor-capacity-wall-post-d316-characterized-no-promote.md`](audits/2026-08-31-p2-019-d317-xgpio2-single-west-corridor-capacity-wall-post-d316-characterized-no-promote.md).
- **Opportunity & Simplification:** the west F.Cu corridor is now **saturated for single hauls** — the remaining west members `XGPIO2/4/5/6/7` all contend for the one spent corridor as *second* hauls (do NOT keep retrying them). The In2/In3 inner **signal** layers remain fully available; an **inner-layer west-XGPIO haul** is the now concretely-justified deferred **framework** task. Near-term: route the next clean increment in an **open region** (144/164 rest nets unrouted, many outside the west band).
- **NEXT FBV2-P2-020:** route the next clean rest-of-board increment **outside** the saturated west XGPIO F.Cu corridor (single net or small coherent group) at its netclass Default under the D-286 gate, add `incremental_probe_018.py`+`G30` on promote; do NOT retry single west XGPIO F.Cu hauls, the XGPIO2+XGPIO3 PAIR, or `U11_PROG`/`PWR_SENSE`; hold the inner-layer west-XGPIO haul as the deferred framework task. **Open owner decisions: NONE;** `JLCPCB_READINESS` unchanged (~77 %). Rollback: none needed (no authoritative change; HEAD advances by documentation only).

## 2026-08-31 - FBV2-P2-018: D-316 — Twelfth rest-of-board incremental increment routed and PROMOTED (a SINGLE west XGPIO net `XGPIO3` at the 0.200 mm Default clearance) — the D-315 positive lead realised: one west haul keeps the D-269 0.300 mm floor to BAT_PROTECTED_P by geometry; a governed CTO ACCEPT + PROMOTE (no Phase-A / prior-increment casualty, no new DRC, autonomy CONTINUES, no owner decision), ZERO router-logic change

**THE TWELFTH REST-OF-BOARD INCREMENT IS ON THE AUTHORITATIVE BOARD.** A SINGLE west community-header GPIO net, `XGPIO3` (R54.1 F.Cu → U3.7 B.Cu), is routed at the **0.200 mm Default clearance** (NOT the 0.300 mm blanket the D-313/D-314 XGPIO pilot PAIRS used) and promoted — the fifth XGPIO0..9 bank member. D-315 characterised the `XGPIO2`+`XGPIO3` adjacent PAIR as a corridor-capacity wall (both orders NO_FAR_RUN — the corridor admits ONE 116 mm haul, not two) and produced the positive lead this increment realises. Starting HEAD `9f108bb` (D-315; pushed; `origin/master` identical).

- **0.200 mm is the correct floor, not rule weakening.** D-269's 0.300 mm governs clearance to `BAT_PROTECTED_P`; a single west haul clears BPP by ≥0.47 mm, so D-269 is satisfied **by geometry** (measured haul→BPP **0.4739 mm ≥ 0.300**). The real full-board **D-269-aware KiCad DRC** (D-286 gate) is the arbiter and reports no new/worse class. Contrast the D-313 EAST pilot whose 0.200 mm haul pinched BPP and genuinely needed the 0.300 mm floor — the blanket was over-conservative for west members, exactly as the D-315 Opportunity Scan flagged.
- **WIP recovery (gitignored scratch only, ZERO routing-logic change).** The preserved `w/screen_018.py` re-screen had stalled before persisting evidence because it did `from xgpio23_pair200_017 import haul_bpp_min, BPP`, and `w/xgpio23_pair200_017.py` runs its full XGPIO2+XGPIO3 **PAIR** routing driver **at module level** — the import re-routed the entire D-315-characterised wall every load (a cross-module recurrence of the D-314 module-level-driver bug). Fix = drop the import, inline the self-contained `haul_bpp_min`+`BPP`, restrict the screen to the single preferred `/XGPIO3`. One managed foreground process then completed and persisted the evidence.
- **Live re-screen (`w/screen_018.py`, one foreground process):** `/XGPIO3` @ 0.200 mm OK — via (55.300,77.700), exv copper 0.7038 mm (≥0.200), exv hole 1.0038 mm (≥0.25 D-257), **haul→BPP 0.4739 mm (≥0.300 D-269)**, 0.200 mm tracks + 0.60/0.30 through via legal, 118.261 mm haul. Reproduces the D-315 record exactly; authoritative sha unchanged during the screen.
- **Route→gate→promote (real full-board):** `route XGPIO3` ALL OK (cross-layer F/B via@(55.300,77.700), refilled exactly In1/In4 for the 1 anti-pad); `gate` PASS every check (23 new in-scope items, XGPIO3 open_edges 1→0, ratsnest 677→676 −1, no new DRC, only In1/In4 re-poured, 0 regressed); `promote` re-ran gate PASS, AUTH sha undrifted, merged 1 REST_INC.
- **Promoted:** `sha256 95bc07be…` → **`d730c74d186ebcc7d2f0aa513776778ce1cb9c9659029a2fffd5e2261e3ac97d`**; tracks 669→**691** (+22); vias 66→**67** (+1); 6 layers / 41 zones; ratsnest 677→**676** (−1); journal 104→**105** (+1 REST_INC). Real KiCad DRC identical (`solder_mask_bridge:1 + hole_clearance:5 + lib_footprint_issues:199 + unconnected_items:499`; 0 `clearance`).
- **Tests:** new **G29**; G18–G28 auto-generalise → `router_regression.py` ALL PASS (G1–G29), deterministic (run twice, identical: via centre 1.304 mm, BPP 0.4739 mm); new `incremental_probe_017.py` PASS; `_006..016` + `phaseB_bringup_probe_005` (691/67/105; **20 routed rest nets, 144 unrouted**) PASS; `live_fingerprint.py` bumped once. **Independent kicad-cli DRC** matches the gate (`clearance` 0). **D-269/D-264/DRU board-swap A/B** (committed D-314 vs promoted D-316): `dru` FAIL(2) and `d264` FAIL B/C identical on both; `d269` flipped PASS/FAIL — but it flips FAIL/FAIL/PASS/FAIL across repeated runs on the **byte-identical D-314 parent** too, so the flip is the probe's synthetic-injection + full-zone re-pour flake, not a regression (XGPIO3 is ~45 mm from the BAT-divider TAPs it examines).
- **Opportunity & Simplification:** route the remaining west XGPIO members **one net at a time** at the 0.200 mm Default (the D-315 wall was the two-parallel-haul contention — do NOT force adjacent PAIRS for the congested northern west pins); the 0.300 mm blanket is reserved for paths that approach BPP; the stall was a *cross-module* recurrence of the module-level-driver hazard (guard heavy drivers behind `__main__` or inline small helpers); In2/In3 remain fully available. **Open owner decisions: NONE;** `JLCPCB_READINESS` unchanged (~77 %). Rollback: pre-promotion `sha256 95bc07be…` (committed D-314, parent `9f108bb`). Next: **FBV2-P2-019 — the next single west XGPIO member, or the next clean local group.** Full analysis: [`audits/2026-08-31-p2-018-d316-twelfth-rest-of-board-incremental-increment-single-west-xgpio3-promoted.md`](audits/2026-08-31-p2-018-d316-twelfth-rest-of-board-incremental-increment-single-west-xgpio3-promoted.md).

## 2026-08-31 - FBV2-P2-017: D-315 — XGPIO2+XGPIO3 south-west adjacent pair is a MEASURED CORRIDOR-CAPACITY WALL at the D-269 clearance — NOT PROMOTED; a governed CTO characterization with ZERO authoritative copper change (board byte-identical to committed D-314), autonomy CONTINUES, no owner decision

**NO COPPER CHANGE — CLEAN CHARACTERIZATION BOUNDARY.** D-314 predicted the "XGPIO-lower-first self-separates" recipe would carry the next south-west pair `XGPIO2`+`XGPIO3` (U3.6/U3.7); the task correctly required revalidating that hypothesis on the live D-314 board. Revalidated → **disproved for this pair.** The authoritative PCB is untouched (`sha256 95bc07be30598df44e5096fd3c51729aa61cdbefd9c9855297e3737ea0b3a605`, 669 trk / 66 via / ratsnest 677 / journal 104). Starting HEAD `8de847b` (D-314; pushed; `origin/master` identical).

- **Both route orders FAIL at the D-269 0.300 mm floor** (`w/screen_016_one.py`, one managed foreground process each, persisted): XGPIO2 U3.6 **NO LEGAL ESCAPE** (flanked middle pin boxed by U3.7/U3.4 + 8 via obstacles incl. the accepted XGPIO0/XGPIO1 barrels); XGPIO3 far-run R54.1→via blocked. Order-independent (`qb.escape` tries all 8 directions).
- **Per-clearance isolation** (`w/xgpio23_clr_017.py`, each net alone): at **0.200 mm** each routes (XGPIO2 via (55.300,78.150); XGPIO3 via (55.300,77.700)); at **0.300 mm** XGPIO2 fails escape (pad-limited), XGPIO3 fails NO_FAR_RUN (track-limited). The 0.300 mm blanket over-constrains the whole 116 mm haul to clear 0.300 mm from ALL copper.
- **The single bounded evidence-backed alternative — per-region clr split** (`clr_pad=0.200`/`clr_trk=0.300`, correct-per-region since every BAT_PROTECTED_P pad is B.Cu ≥9 mm away and the only BPP copper near the F.Cu haul is its F.Cu trunk; NOT rule weakening) fixes the escape but both nets still **FAIL NO_FAR_RUN** — the D-313+D-314-congested corridor admits ONE 0.300 mm-clearance haul, not two. Alternative spent.
- **Pair vs single:** PAIR @ 0.200 mm also fails (2nd net NO_FAR_RUN — two parallel hauls contend for one corridor). But a **SINGLE** west XGPIO net at 0.200 mm routes CLEAN and keeps D-269 with margin: **XGPIO2 haul→BPP 0.6859 mm, XGPIO3 0.4739 mm (both ≥0.300)** — the clean next path.
- **Integrity (board pristine):** `sha256 95bc07be…` before/after (no `route`/`gate`/`promote` on the authoritative project; only gitignored `w/…` scratch; no orphan). `router_regression.py` ALL PASS G1–G28 twice (deterministic); `incremental_probe_006..016` + `phaseB_bringup_probe_005` all PASS; real DRC unchanged (`clearance` 0). D-269/D-264/DRU board-swap trivially byte-identical (current board IS committed D-314 → no regression possible).
- **No rule/logic change; no owner decision.** Full analysis: [`audits/2026-08-31-p2-017-d315-xgpio2-3-southwest-pair-corridor-capacity-wall-characterized-no-promote.md`](audits/2026-08-31-p2-017-d315-xgpio2-3-southwest-pair-corridor-capacity-wall-characterized-no-promote.md).
- **NEXT FBV2-P2-018 (sharply defined):** route a SINGLE west XGPIO net (recommended `XGPIO3`, or `XGPIO2`) at `clr_pad=clr_trk=0.200` (NOT the 0.300 mm blanket), `route`→`gate`→`promote` under the D-286 real full-board gate (D-269-aware DRC arbitrates BPP), add `incremental_probe_017.py`+`G29`; do NOT re-attempt the XGPIO2+XGPIO3 PAIR or `U11_PROG`/`PWR_SENSE`; 145/164 rest nets unrouted.

## 2026-08-30 - FBV2-P2-016: D-314 — Eleventh rest-of-board incremental increment routed and PROMOTED (XGPIO west-edge SOUTH pilot `XGPIO1`+`XGPIO0`) — the FIRST west XGPIO bank members, promoted after a governed recovery of the west-pair corridor screen, at the D-269 0.300 mm corridor clearance: a governed CTO ACCEPT + PROMOTE (no Phase-A / prior-increment casualty, no new DRC, autonomy CONTINUES, no owner decision)

**THE ELEVENTH REST-OF-BOARD INCREMENT IS ON THE AUTHORITATIVE BOARD.** The XGPIO west-edge SOUTH pilot `XGPIO1` (R52.1 F.Cu → U3.5 B.Cu) + `XGPIO0` (R51.1 F.Cu → U3.4 B.Cu) — the two SOUTHERNMOST west community-header GPIO nets on consecutive PCAL9535A U3 pins, the FIRST members of the eight-net **west** XGPIO group the D-313 study had deferred as an ordering-sensitive hazard — are routed and promoted. Starting HEAD `0faf85b` (D-313; pushed; `origin/master` identical).

- **Recovery of the west-pair screen (gitignored scratch only, ZERO routing-logic change).** The one-order runner `w/screen_016_one.py` imported `w/screen_016.py`, whose full 14-pair driver ran **at module level** — every import re-ran the whole screen and died before the single pair's ledger write (empty ledger, byte-identical SCR16_* dirs, no durable evidence). Fix = guard the ranker's driver behind `if __name__ == '__main__':` so importing it only exposes the routing functions; the runner then re-measures exactly one `(a,b,order)` and persists it.
- **Measured evidence (live D-313 board, D-269 0.300 mm, no via_offset; only missing/high-value southern orders re-run, one foreground process at a time).** Both priority pairs are **conclusive** — each has exactly ONE clean order = **XGPIO1-first**: XGPIO0/1 `1_0_0` CLEAN (via-via **2.129 mm**, BPP 2.038, exv 3.607); XGPIO1/2 `1_2_1` CLEAN (via-via 2.044, BPP 2.006); the reverse orders B-FAIL (the southern net routed first boxes XGPIO1 out). XGPIO1 routes first (via lands in the pocket at (55.40,79.00)); the southern net sees that laid via as an obstacle and escapes WEST off it. XGPIO2/3 fallback not needed.
- **Selection: `XGPIO0`+`XGPIO1`, XGPIO1-first** — the minimum coherent clean west pair (best margins; southernmost/most-independent, furthest from the crowded northern pocket the D-313 study flagged for XGPIO6/7).
- **Route→gate→promote (real full-board):** `route XGPIO_PILOT_W` ALL OK (XGPIO1 via@(55.400,79.000), XGPIO0 via@(52.750,78.350) — XGPIO0 self-separated west); `gate` PASS every check (ratsnest 679→677 −2, no new DRC, only In1/In4 re-poured, 0 prior pairs regressed); `promote` re-ran gate PASS, merged 2 REST_INC.
- **Promoted:** `sha256 a0d6fead…` → **`95bc07be30598df44e5096fd3c51729aa61cdbefd9c9855297e3737ea0b3a605`**; tracks 631→**669** (+38); vias 64→**66** (+2); 6 layers / 41 zones; ratsnest 679→**677** (−2); journal 102→**104**; PCB diff 404 ins / 36 del (40 seg/via added, 0 seg/via/fp del; all xy dels In1/In4 re-pour). Real KiCad DRC identical (`solder_mask_bridge:1 + hole_clearance:5 + lib_footprint_issues:199 + unconnected_items:499`; 0 `clearance`).
- **Tests:** new **G28**; G18–G27 auto-generalise → `router_regression.py` ALL PASS (G1–G28), deterministic (run twice); new `incremental_probe_016.py` PASS; `_006..015` + `phaseB_bringup_probe_005` (669/66/104; 19 routed rest nets, 145 unrouted) PASS; `live_fingerprint.py` bumped once. `d269`/`dru` board-swap A/B BYTE-IDENTICAL on committed D-313 vs promoted D-314; `d264` differed on a borderline U18 item far from the XGPIO copper — **proven intrinsic non-determinism** (re-run on the *identical* D-314 board flipped 2→1→3 fails), not a regression; the authoritative kicad-cli DRC is byte-stable and clean.
- **Opportunity & Simplification:** the SOUTH of the west group is open with the same zero-mechanism recipe (route at the D-269 floor, XGPIO-lower-first so the southern neighbour self-separates west); the characterised crowding is specifically the NORTHERN pins. In2/In3 remain fully available. Recovery-runner hardening (`__main__` guard + durable ledger) is a reusable lever. Non-blocking notice. **Open owner decisions: NONE;** `JLCPCB_READINESS` unchanged (~77 %). Rollback: pre-promotion `sha256 a0d6fead…` (D-313; parent `0faf85b`). Next: **FBV2-P2-017 — the next XGPIO south-west pilot (XGPIO2/3), or the next clean local group.** Full analysis: [`audits/2026-08-30-p2-016-d314-eleventh-rest-of-board-incremental-increment-xgpio-west-south-pilot-promoted.md`](audits/2026-08-30-p2-016-d314-eleventh-rest-of-board-incremental-increment-xgpio-west-south-pilot-promoted.md).

## 2026-08-30 - FBV2-P2-015: D-313 — Tenth rest-of-board incremental increment routed and PROMOTED (XGPIO east-edge pilot `XGPIO8`+`XGPIO9`) — the FIRST XGPIO0..9 bank members, promoted after a full evidence-first READ-ONLY corridor study, at the D-269 0.300 mm corridor clearance: a governed CTO ACCEPT + PROMOTE (no Phase-A / prior-increment casualty, no new DRC, autonomy CONTINUES, no owner decision)

**THE TENTH REST-OF-BOARD INCREMENT IS ON THE AUTHORITATIVE BOARD.** The XGPIO east-edge pilot `XGPIO8` (R59.1 F.Cu → U3.13 B.Cu) + `XGPIO9` (R60.1 F.Cu → U3.14 B.Cu) — two adjacent community-header GPIO nets on consecutive PCAL9535A U3 pins, the FIRST members of the ten-net XGPIO0..9 bank — are routed and promoted after an evidence-first read-only corridor study. Starting HEAD `1eb80a9` (D-312; pushed; `origin/master` identical).

- **Evidence-first study (`w/xgpio_study_015.py`, READ-ONLY).** Each `/XGPIOx` is a 2-pad cross-layer net: 100 R series R5x.1 (F.Cu top pack) → U3 pin (B.Cu mid-board), one MST edge + one F↔B via. Study of all ten: **all escape U3 cleanly** (escape goes NORTH into open board, away from the completed U2 via cluster; every default via site ≥3.1 mm clear, zero existing vias in any XGPIO bbox → **no via_offset needed**); **shared-corridor/ordering risk is real** — the 8 west nets crowd one via pocket north of U3 (XGPIO6/7 pick the identical site) while the **east pair separates cleanly (2.7 mm)**; corridor crosses no mechanical/RF/USB reservation.
- **The real wall + correct fix.** At the default 0.200 mm, candidates routed geometrically but FAILED the real gate with new `clearance` — all against `BAT_PROTECTED_P` under the **D-269 BAT_MAIN 0.300 mm** rule: the 52.4 mm protected-battery F.Cu trunk sweeps across the y≈73–82 XGPIO via band. Fix = route at the **0.300 mm D-269 floor** (the correct clearance, NOT a new mechanism; only the group `clr` parameter — no router-logic change). All six screened candidates (4–9) then pass individually.
- **Route→gate→promote (member-by-member then combined):** each member gated PASS individually; `route XGPIO_PILOT` ALL OK (XGPIO8 via@(58.60,72.95), XGPIO9 via@(58.45,75.65) — XGPIO9 re-routed around XGPIO8's laid via); `gate` PASS every check (ratsnest 681→679 −2, no new DRC, only In1/In4 re-poured, 0 prior pairs regressed); `promote` re-ran gate PASS, merged 2 REST_INC.
- **Promoted:** `sha256 d6e0148a…` → **`a0d6fead125295441dda0f0008c1261f5c1cec39edb2b8c7bd925b214e7207eb`**; tracks 608→**631** (+23); vias 62→**64** (+2); 6 layers / 41 zones; ratsnest 681→**679** (−2); journal 100→**102**; PCB diff 316 ins / 66 del (23 seg + 2 via added, 0 seg/via/fp del; all xy dels In1/In4 re-pour). Real KiCad DRC identical (`solder_mask_bridge:1 + hole_clearance:5 + lib_footprint_issues:199 + unconnected_items:499`; 0 `clearance`).
- **Tests:** new **G27**; G18–G26 auto-generalise → `router_regression.py` ALL PASS (G1–G27), deterministic; new `w/xgpio_study_015.py` + `incremental_probe_015.py` PASS; `_006..014` + `phaseB_bringup_probe_005` (631/64/102; 17 routed rest nets, 147 unrouted) PASS; `live_fingerprint.py` bumped once; `d269`/`d264`/`dru` board-swap A/B BYTE-IDENTICAL on committed D-312 vs promoted D-313 (not regressed).
- **Opportunity & Simplification:** staged small-adjacent-pilot routing is safer than a blind ten-via bank (the members are coupled — west nets contend for one via pocket, the whole bank shares the D-269 corridor); the east pair is the naturally-independent island. **In2/In3 remain fully available** (routed on F/B outer layers only — inner-signal capacity deliberately preserved for the denser west members). Non-blocking notice. **Open owner decisions: NONE;** `JLCPCB_READINESS` unchanged (~77 %). Rollback: pre-promotion `sha256 d6e0148a…` (D-312; parent `1eb80a9`). Next: **FBV2-P2-016 — the next XGPIO adjacent pilot (west-edge members, staggering the north-of-U3 via pocket), or the next clean local group.** Full analysis: [`audits/2026-08-30-p2-015-d313-tenth-rest-of-board-incremental-increment-xgpio-east-pilot-promoted.md`](audits/2026-08-30-p2-015-d313-tenth-rest-of-board-incremental-increment-xgpio-east-pilot-promoted.md).

## 2026-08-30 - FBV2-P2-014: D-312 — Ninth rest-of-board incremental increment routed and PROMOTED (microSD card-detect `SD_CARD_DETECT_N`) — the LAST D-309 U2 escape sibling, separately governed, completing the U2 escape family with zero per-net tuning: a governed CTO ACCEPT + PROMOTE (no Phase-A / FRONT_RGB / ACC / DISP / IMU / FRONT_RGB_LED / IR_RX_VS / TOUCH / AMP casualty, no new DRC, autonomy CONTINUES, no owner decision)

**THE NINTH REST-OF-BOARD INCREMENT IS ON THE AUTHORITATIVE BOARD.** `SD_CARD_DETECT_N` (the microSD socket J2 card-detect switch line — J2.10/R113.2 on F.Cu → U2.11 on B.Cu; noncritical low-speed detect) is routed and promoted as its own increment. It is the SECOND and LAST of the two remaining U2 west-edge escape siblings the D-310 via-offset unlocked, completing the D-309-characterised U2 escape family (DISP_RST_N D-306, TOUCH_RST_N+TOUCH_INT_N D-310, AMP_SD_MODE D-311, SD_CARD_DETECT_N D-312). D-311 promoted the sibling `AMP_SD_MODE` alone and deliberately held `SD_CARD_DETECT_N` (functionally distinct — audio strap vs microSD detect; no throughput-bundling). Starting HEAD `288d7ad` (D-311; pushed; `origin/master` identical).

- **Mechanism reused byte-for-byte (D-310), zero per-net tuning.** No `incremental_router.py` or `qrouter.py` change this increment: the `SD_DETECT` GROUPS entry already carried `via_offset=2500000`. The always-on existing-via injection makes escape/via_site/connect_role respect accepted barrels; the opt-in bounded offset walks the F↔B transition ~2.5 mm off the nearest congesting via.
- **Re-screen on the LIVE D-311 board was essential** (`w/screen_014.py`): D-311 added an AMP via at ~(51.55,90.20), changing the obstacle field. Result: `SD_CARD_DETECT_N` escapes U2.11 **SOUTH** (esc@(52.95,85.10), via y≈82.55), AWAY from the northern via cluster (DISP/TOUCH/AMP at y≈87–92) — **the new AMP via does not touch it**. The 2.5 mm site @(53.00,82.55) is **3.850 mm** clear (nearest DISP_RST_N), identical to the D-310-board measurement; even the via-blind DEFAULT is 1.301 mm clear. The 2.5 mm offset stays comfortably clear → **no site adjustment needed**.
- **Route→gate→promote (real full-board):** `route SD_DETECT` ALL OK (J2.10↔R113.2 14.145 mm F.Cu + R113.2↔U2.11 80.337 mm cross-via@(53.00,82.55); 28 seg + 1 via); `gate` PASS every check (ratsnest 683→681 −2, no new DRC, only In1/In4 re-poured, 0 prior pairs regressed); `promote` re-ran gate PASS, merged 2 REST_INC.
- **Promoted:** `sha256 9bf429ce…` → **`d6e0148a43a42895236b934cb6f7084036e50535a399f42fe09b300aabc5f1b8`**; tracks 580→**608** (+28); vias 61→**62** (+1); 6 layers / 41 zones; ratsnest 683→**681** (−2); journal 98→**100**; PCB diff 308 ins / 52 del (28 seg + 1 via added, 0 seg/via/fp del; all xy dels In1/In4 re-pour). Real KiCad DRC identical (`solder_mask_bridge:1 + hole_clearance:5`; 0 `clearance`).
- **Tests:** new **G26**; G18–G25 auto-generalise → `router_regression.py` ALL PASS (G1–G26), deterministic; new `incremental_probe_014.py` PASS; `_006..013` + `phaseB_bringup_probe_005` (608/62/100; 15 routed rest nets, 149 unrouted) PASS; `live_fingerprint.py` bumped once; `d269`/`d264`/`dru` board-swap A/B BYTE-IDENTICAL on committed D-311 vs promoted D-312 (not regressed).
- **Opportunity & Simplification:** U2 escape family COMPLETE. Graduating to the XGPIO0..9 corridor study is NOT justified blindly (10 separate ~55 mm hauls through un-characterised congestion ≠ the U2 single-landing wall) — the right next step is a READ-ONLY XGPIO corridor STUDY before routing, or a clean local group first. Non-blocking notice. **Open owner decisions: NONE;** `JLCPCB_READINESS` unchanged (~77 %). Rollback: pre-promotion `sha256 9bf429ce…` (D-311; parent `288d7ad`). Next: **FBV2-P2-015 — the XGPIO0..9 bank corridor STUDY (READ-ONLY characterisation), or the next clean local group.** Full analysis: [`audits/2026-08-30-p2-014-d312-ninth-rest-of-board-incremental-increment-sd-card-detect-u2-escape-via-offset-promoted.md`](audits/2026-08-30-p2-014-d312-ninth-rest-of-board-incremental-increment-sd-card-detect-u2-escape-via-offset-promoted.md).

## 2026-08-30 - FBV2-P2-013: D-311 — Eighth rest-of-board incremental increment routed and PROMOTED (audio-amp SD/mode-select strap `AMP_SD_MODE`) — the hardest D-309 U2 escape sibling completed with the D-310 bounded via-site offset, zero per-net tuning: a governed CTO ACCEPT + PROMOTE (no Phase-A / FRONT_RGB / ACC / DISP / IMU / FRONT_RGB_LED / IR_RX_VS / TOUCH casualty, no new DRC, autonomy CONTINUES, no owner decision)

**THE EIGHTH REST-OF-BOARD INCREMENT IS ON THE AUTHORITATIVE BOARD.** `AMP_SD_MODE` (the MAX98357 class-D amplifier's static SD/mode-select logic strap — R15.1/U5.4 on F.Cu → U2.7 on B.Cu; **not** the class-D output) is routed and promoted. It is one of the two remaining U2 west-edge escape siblings the D-310 via-offset unlocked, and it was the **hardest D-309 wall** (the via-blind default via landed 0.100 mm from the accepted D-306 `DISP_RST_N` barrel; D-309 +7 `clearance`). Starting HEAD `67d3ff6` (D-310; pushed; `origin/master` identical).

- **Mechanism reused byte-for-byte (D-310), zero per-net tuning.** No new routing mechanics: the only `incremental_router.py` change is adding `via_offset=2500000` to the pre-existing `AMP_SD_MODE`/`SD_DETECT` GROUPS entries (+ refreshed annotations). The always-on existing-via injection (mirrors `QBoard.via()`; `qrouter.py` untouched) makes escape/via_site/connect_role respect accepted barrels; the opt-in bounded offset walks the F↔B transition ~2.5 mm off the nearest congesting via via the general "away from the nearest existing via" rule.
- **Re-screen on the LIVE D-310 board was essential** (`w/screen_013.py`): the two new D-310 TOUCH vias shifted the geometry. `AMP_SD_MODE` DEFAULT via 0.100 mm from `DISP_RST_N` (CLASH, confirms D-309 +7); **2.5 mm offset → (51.55,90.20), 1.760 mm** clear of the nearest via (now `TOUCH_RST_N`); 3.5 mm collapses onto the fresh TOUCH via (0.206 mm) — **2.5 mm is correct, not more**.
- **Each sibling tested separately on scratch first.** `route AMP_SD_MODE` ALL OK (R15.1↔U5.4 4.188 mm F.Cu + U5.4↔U2.7 58.487 mm cross-via; 19 seg + 1 via) → `gate` PASS every check (ratsnest 685→683 −2, no new DRC); `route SD_DETECT` ALL OK (80.293 mm cross-via; 27 seg + 1 via) → `gate` PASS every check. Both pass independently with the identical unchanged mechanism; being functionally distinct they were NOT bundled. **`AMP_SD_MODE` promoted as the single D-311 increment**; `SD_CARD_DETECT_N` held for FBV2-P2-014.
- **Promoted.** `sha256 856f7a8a…` → **`9bf429cec07654d4522121d2fb595204d06f5173ae629f2292c4d0cb9f68b314`**; tracks 561→**580** (+19); vias 60→**61** (+1); 6 layers / 41 zones; ratsnest 685→**683** (−2); journal 96→**98** (+2 REST_INC); PCB diff **236 ins / 48 del** (19 `(segment)` + 1 `(via)` added, 0 seg/via/fp del; all 48 dels In1/In4 `(xy …)` anti-pad lines). Real KiCad DRC identical (`solder_mask_bridge:1, hole_clearance:5, lib_footprint_issues:199, unconnected_items:499`; 0 `clearance`).
- **Tests.** New **G25**; G18–G24 auto-generalise → `router_regression.py` **ALL PASS (G1–G25)**. New `incremental_probe_013.py` PASS; `_006..012` + `phaseB_bringup_probe_005` (580/61/98; 14 routed, 150 unrouted) PASS; `live_fingerprint.py` bumped once. `d269`/`d264`/`dru` board-swap A/B **BYTE-IDENTICAL** on committed D-310 vs promoted D-311 (not regressed).
- **Opportunity & Simplification Scan.** Reusable mechanism, individually gated: both siblings closed with zero per-net tuning (the offset is a genuine reusable primitive), but the long hauls (58/80 mm) touch different regions and the via geometry is sensitive to earlier increments' copper (the 3.5 mm AMP site collapsed onto the fresh D-310 TOUCH via) — each U2-family net must still be screened live + gated on the full board; do NOT auto-bundle. In2/In3 spare. **Open owner decisions: NONE.**
- **Rollback** = pre-promotion `sha256 856f7a8a…` (D-310; parent `67d3ff6`). All locks preserved; frozen `beta-full-reference-v1` untouched; DEVICE_SPEC unchanged; journal authoritative (98); no orphan process.
- **Next FBV2-P2-014:** 150/164 rest nets unrouted; the immediate target is the second U2 sibling `SD_CARD_DETECT_N` (proven clean on scratch), or another clean local group. Full analysis: [`audits/2026-08-30-p2-013-d311-eighth-rest-of-board-incremental-increment-amp-sd-mode-u2-escape-via-offset-promoted.md`](audits/2026-08-30-p2-013-d311-eighth-rest-of-board-incremental-increment-amp-sd-mode-u2-escape-via-offset-promoted.md).

## 2026-08-30 - FBV2-P2-012: D-310 — Seventh rest-of-board incremental increment routed and PROMOTED (display/touch control pair `TOUCH_RST_N` + `TOUCH_INT_N`) — the D-309 U2 B.Cu ESCAPE WALL BROKEN by a bounded via-site offset + existing-via awareness: a governed CTO ACCEPT + PROMOTE (no Phase-A / FRONT_RGB / ACC / DISP / IMU / FRONT_RGB_LED / IR_RX_VS casualty, no new DRC, autonomy CONTINUES, no owner decision)

**THE SEVENTH REST-OF-BOARD INCREMENT IS ON THE AUTHORITATIVE BOARD — and it is the group D-309 characterised as a WALL.** The coherent display/touch control pair (capacitive-touch reset + interrupt, display FPC J1 → touch-controller U2) is routed and promoted, breaking the U2 B.Cu escape wall with two generic, bounded, `qrouter.py`-UNTOUCHED mechanisms. Starting HEAD `f2bcac1` (D-309; pushed; `origin/master` identical).

- **Root cause of the D-309 wall — the router was BLIND to existing vias.** `qrouter.QBoard._scan` builds obstacles from footprint pads + `PCB_TRACK` but iterates `GetTracks()` and `continue`s on `PCB_VIA` — every accepted through-via is invisible to escape/via_site/connect_role. U2.4/.7/.8/.11 stack on U2's WEST edge (x=54.14); the accepted D-306 `DISP_RST_N` via sits at (52.95,87.0), 1.19 mm west of that column, so a westward cross-layer escape lands the new via (and threads its F.Cu run) right past the barrel; only real DRC caught it (D-309 +3; measured this cycle `AMP_SD_MODE` default via 0.100 mm copper to `DISP_RST_N`).
- **The fix — two generic, bounded mechanisms in `connect_cross` (qrouter untouched).** (1) **Existing-via awareness:** every accepted `PCB_VIA` barrel/hole is injected as an obstacle onto the per-route `QBoard` instance (mirroring `QBoard.via()` item-for-item), so escape/via_site/**connect_role's track search** all respect accepted vias; add-only, per-route, generic, and it touches only the transient route QBoard so every G-contract fixture (which re-routes through `qrouter`) is unaffected. (2) **Bounded via-site offset:** a group opts in with `via_offset` and the F↔B transition is deliberately walked ~2.5 mm off the nearest congesting barrel via `_offset_via_site` (a short host-face B.Cu fan-out) — the first increment that PLANS a via site rather than accepting the router's first via-blind legal one; groups without `via_offset` are byte-identical to D-306/D-308.
- **Screen (real-geometry clearance, before any gate).** READ-ONLY `w/geom_012.py` + `w/screen_012.py` reproduced `cmd_route`'s cross-layer edge and measured DEFAULT vs bounded offset sites against REAL existing-via copper+hole (qrouter-blind): `AMP_SD_MODE` default via 0.70 mm from DISP = **0.100 mm CLASH** (confirms D-309 +7); `TOUCH_RST_N`/`SD_DETECT` default vias clear the barrel but their tracks thread the west column (D-309 +3/+2); at 2.5 mm offset all four clear comfortably (via↔via 2.6–7.8 mm). `TOUCH_INT_N` is on U2's EAST edge, already 5.9 mm clear. Per the task preference the coherent display/touch PAIR was taken (both pass); unrelated nets NOT bundled.
- **Route → gate → promote.** `route TOUCH_CTL` ALL OK (injected 58 existing-via obstacles): J1.47↔R12.1 22.217 mm F.Cu + R12.1↔U2.4 28.553 mm cross-via@(52.95,92.10); J1.46↔U2.19 54.708 mm cross-via@(61.15,88.85); 26 seg 0.200 mm + 2 through vias 0.60/0.30; In1/In4 [39,40] re-poured. *(First attempt with via-offset ALONE still failed +3 — the via-blind track router threaded the F.Cu run 0.05 mm from the DISP barrel; the existing-via injection made connect_role via-aware and the re-route was clean — the offset fixes the via, the injection fixes the tracks.)* `gate` PASS every check (D-309 535 trk+58 via SUBSET; 28 new items all target-net; only zones 39/40 re-poured, all other 39 byte-identical; both nets connected open-edges 2→0 and 1→0; 0 prior pairs regressed; ratsnest 688→685 EXACTLY −3; **no new/worse DRC class, `clearance` 0→0**; unc 499→499); `promote` re-ran gate PASS, re-verified AUTH sha undrifted, merged 3 REST_INC.
- **Promoted.** Authoritative `sha256 5c5cae79…a339f63` → **`856f7a8adf0db9b114b9f09d7469308f921bc897aaf2ddce7f1c15c40a197114`**; tracks **535→561** (+26: 21 F.Cu + 5 B.Cu fan-out); vias **58→60** (+2 offset through vias); 6 layers / 41 zones; ratsnest **688→685** (−3); journal **93→96** (+3 `REST_INC`); PCB file diff **310 ins / 40 del** — additions 26 `(segment)` + 2 `(via)` (0 seg/via/fp del, grep-confirmed); all 40 dels are In1/In4 `filled_polygon` xy (2 via anti-pads), nothing else. Real KiCad DRC error-severity identical (`solder_mask_bridge:1 + hole_clearance:5`; 0 `clearance`).
- **Tests.** New contract **G24** (both nets connected across the U2 F/B hop; copper legal 26 trk 0.200 mm F.Cu+B.Cu + 2×0.60/0.30 through vias; **the offset cleared both vias of every existing via — min TOUCH-via↔other-via 4.998 mm ≥0.80 mm**; ADD-ONLY IR_RX_VS 8 + RGB_LED 25 + IMU 8 + DISP 11 + ACC 31 + RGB 20 + Phase-A 432/54). G18–G23 auto-generalise. `router_regression.py` = **ALL CHECKS PASS (G1–G24), 102 PASS lines**, deterministic. New probe `incremental_probe_012.py` PASS; `_006..011` PASS unchanged (pre-X checks auto-generalise); `phaseB_bringup_probe_005` updated (561/60/96; 13 routed rest nets, 151 unrouted) PASS; real-board `kicad-cli` DRC + pcbnew ratsnest 685 re-run independently — no new `clearance`. `d269`/`d264`/`dru` probes NOT regressed — a board-swap A/B test proves BYTE-IDENTICAL verdicts (`diff` empty) on the committed D-309 and promoted D-310 boards (pre-existing BAT_*/LTC power-tree reds far from the mid-board TOUCH copper).
- **Opportunity & Simplification Scan.** The via-site metadata is deliberately REUSABLE without hiding corridor coupling: the existing-via injection is unconditional (fixes a latent gap for EVERY future cross-layer increment) and re-proven by the defensive `_clears_existing_vias` guard for all groups; `via_offset` is an opt-in bounded scalar biasing "away from the nearest existing via" (a general rule, not a hand-tuned U2 vector), now available to the rest of the U2 family and any future control clearing a congesting barrel. Sibling U2 groups `AMP_SD_MODE`/`SD_DETECT` were NOT bundled (task preference; annotated with clean measured 2.5 mm sites for a future increment). No BOM/recoverability/testability/firmware/UX/mechanical change forced; In2/In3 spare. **Open owner decisions: NONE.**
- **Rollback** = pre-promotion `sha256 5c5cae79…a339f63` (D-309; parent `f2bcac1`). All locked invariants preserved (the 2 vias are D-257-legal 0.60/0.30 ≥0.50 min_via, ≥0.25 hole-hole; In1/In4 GND roles — only those two planes re-poured); frozen `beta-full-reference-v1` untouched; DEVICE_SPEC unchanged; journal authoritative (96); no orphan process.
- **Next: FBV2-P2-013** — the U2 escape family is UNLOCKED: complete it (`AMP_SD_MODE` U2.7, `SD_CARD_DETECT_N` U2.11 both measured clean at 2.5 mm offset — add `via_offset` and route/gate), or another clean local group (`RESERVED_SPARE`, short single-via controls); 151 of 164 rest nets unrouted. Full analysis: [`audits/2026-08-30-p2-012-d310-seventh-rest-of-board-incremental-increment-touch-ctl-u2-escape-via-offset-promoted.md`](audits/2026-08-30-p2-012-d310-seventh-rest-of-board-incremental-increment-touch-ctl-u2-escape-via-offset-promoted.md).

---

## 2026-08-30 - FBV2-P2-011: D-309 — Sixth rest-of-board incremental increment routed and PROMOTED (IR receiver local filtered supply `IR_RX_VS_LOCAL`) — CLEANEST CLASS (NO via); display/touch U2-escape wall characterised; shared live-fingerprint helper landed: a governed CTO ACCEPT + PROMOTE (no Phase-A / FRONT_RGB / ACC / DISP / IMU / FRONT_RGB_LED casualty, no new DRC, autonomy CONTINUES, no owner decision)

**A SIXTH REST-OF-BOARD INCREMENT IS ON THE AUTHORITATIVE BOARD — the IR receiver (U6) local filtered supply, the cleanest increment class (same-layer F.Cu, NO via), chosen on gate evidence over the task-preferred display/touch group.** Starting HEAD `49528f2` (D-308; pushed; `origin/master` identical).

- **Same framework, ZERO new routing mechanics.** `incremental_router.py` (baseline/route/gate/promote) took the sixth increment through only a new `GROUPS` entry — the proven same-layer no-via class (like D-307 IMU_ADDR, but on F.Cu); `connect_cross`/`refill_planes`/`qrouter.py` untouched.
- **Candidate selection — EARNED on the real gate, not defaulted.** Four groups were routed on scratch and put through the REAL full-board gate (authoritative untouched). The task-preferred coherent **display/touch group** `TOUCH_CTL` (`TOUCH_RST_N` + `TOUCH_INT_N`) and the alternatives `AMP_SD_MODE`, `SD_DETECT` (`SD_CARD_DETECT_N`) each routed ALL OK on the scratch router but **FAILED the real gate with NEW `clearance` violations (+3 / +7 / +2)** — they are long cross-board hauls (33–68 mm) whose cross-layer via lands in the **congested U2 B.Cu escape region beside the accepted D-306 `DISP_RST_N` through-via** (U2.4/.7/.11/.19 all sit beside U2.8). This is a **characterised wall** (like `U11_PROG`/`PWR_SENSE`), deferred to FBV2-P2-012 with a deliberate U2-escape corridor plan; the failing `GROUPS` entries are annotated. The "favor display/touch IF clean" preference was honored — tried first, empirically shown NOT clean. CHOSEN: **`IR_RX_VS`** (`IR_RX_VS_LOCAL`, R21.2 series + C11.1 decoupling → U6.3 THT supply) — pristine (0 accepted copper within bbox+2 mm), local NE-corner cluster, all F.Cu, no via.
- **The gate (real full-board, D-286) = PASS every check.** `route IR_RX_VS` → ALL OK (C11.1↔R21.2 3.113 mm + R21.2↔U6.3 9.291 mm; 8 F.Cu segments 0.200 mm, no via); D-308 527 trk + 58 via multiset a SUBSET (0 casualty); 8 new items all target-net; **all 41 zones byte-identical** (no via ⇒ no plane re-pour); `IR_RX_VS_LOCAL` fully connected (open-edges 2→0); 0 prior pairs regressed; pcbnew ratsnest 690→688 EXACTLY −2; real kicad-cli DRC no new/worse class.
- **Promoted.** Authoritative `sha256 f4e95dec…8559e7ee` → **`5c5cae79465416c81f9d7b8dba5b2e3a3325bd9a0680b65103badf0e1a339f63`**; tracks **527→535** (+8); vias **58** (no via); 6 layers / 41 zones; ratsnest **690→688** (−2); journal **91→93** (+2 `REST_INC`); PCB file diff **64 ins / 0 del** (all 8 additions `(segment)` F.Cu, 0 seg/via/fp del, 0 zone change — cleanest class, tied D-307); real KiCad DRC identical (`{solder_mask_bridge:1, hole_clearance:5, lib_footprint_issues:199, unconnected_items:499}`).
- **Tests.** New contract **G23** (C11.1-R21.2-U6.3 one island; 8 trk F.Cu 0.200 mm no via; ADD-ONLY RGB_LED 25 + IMU 8 + DISP 11 + ACC 31 + RGB 20 + Phase-A 432/54); G18–G22 stay green unchanged; `router_regression.py` = **ALL CHECKS PASS (G1–G23), 98 PASS lines**, deterministic. New probe `incremental_probe_011.py` PASS; `_006/_007/_008/_009/_010` + `phaseB_bringup_probe_005` refreshed (535/58/93) PASS; real-board `kicad-cli` DRC + pcbnew ratsnest 688 re-run independently — no new `clearance`. `d269`/`d264`/`dru` probes NOT regressed — a board-swap A/B test proves byte-identical verdicts on the committed D-308 and promoted D-309 boards (pre-existing BAT_*/LTC power-tree reds ~60 mm from my copper; the flaky d269 full-zone-re-pour proxy NOT mistaken for authoritative DRC).
- **Opportunity & Simplification Scan (ACTED-ON — the exact one D-308 §E pre-flagged).** Introduced **`checks/live_fingerprint.py`**, a single source-of-truth `EXPECTED` dict bumped once per promotion; all six probes refactored to import it, replacing the ~25 identical per-increment `EXPECT_*` hand-edits. A pure DRY consolidation weakening no historical contract (each probe still asserts live-board == EXPECTED and keeps its own structural checks); bounded, reversible; all six PASS. Failing candidate `GROUPS` entries kept + annotated (self-documenting negative evidence). In2/In3 remain spare. **Open owner decisions: NONE.**
- **Rollback** = pre-promotion `sha256 f4e95dec…8559e7ee` (D-308; parent `49528f2`). All locked invariants preserved; frozen `beta-full-reference-v1` untouched; DEVICE_SPEC unchanged; journal authoritative (93); no orphan process.
- **Next: FBV2-P2-012** — the U2 B.Cu escape corridor (plan a via SITE off U2's edge to clear the `DISP_RST_N` barrel, unlocking the display/touch/SD/audio-strap family), or another clean local no-via/single-via group (153 of 164 rest nets unrouted). Full analysis: [`audits/2026-08-30-p2-011-d309-sixth-rest-of-board-incremental-increment-ir-rx-vs-promoted.md`](audits/2026-08-30-p2-011-d309-sixth-rest-of-board-incremental-increment-ir-rx-vs-promoted.md).

---

## 2026-08-30 - FBV2-P2-010: D-308 — Fifth rest-of-board incremental increment routed and PROMOTED (front-panel RGB status-indicator completion `Net-(D13-RK/GK/BK)`) — THE FIRST MULTI-VIA INCREMENT: a governed CTO ACCEPT + PROMOTE (no Phase-A / FRONT_RGB / ACC / DISP / IMU casualty, no new DRC, autonomy CONTINUES, no owner decision)

**A FIFTH REST-OF-BOARD INCREMENT IS ON THE AUTHORITATIVE BOARD — the coherent completion of the D-304 front-panel RGB indicator, and the first increment to lay MULTIPLE vias.** Starting HEAD `c939f35` (D-307; pushed; `origin/master` identical).

- **Same framework, ZERO new mechanics.** `incremental_router.py` (baseline/route/gate/promote) took the fifth increment through only a new `GROUPS` entry. The FIRST multi-via increment required NO change to `connect_cross`/`refill_planes`/`qrouter.py`: the existing per-edge loop calls `connect_cross` once per cross-layer edge (three times) and `refill_planes` re-pours In1/In4 once for all vias — a multi-net group of independent single-via nets is already within the D-306-proven mechanic.
- **Group selection (measured; coherent + local + clean).** Baseline `a309f8ce…` (502/55/6, ratsnest 693, journal 88) + a new READ-ONLY screen `w/screen_010.py` ranking ALL 156 remaining unrouted multi-pad nets by pad layers (same vs cross), THT, MST edges/length, bbox span and accepted-copper congestion within bbox+2 mm. CHOSEN: **FRONT_RGB_LED** (`Net-(D13-RK)`+`Net-(D13-GK)`+`Net-(D13-BK)`) — the coherent completion of the D-304 front-panel RGB indicator on the LED-cathode side (R124.2/R125.2/R126.2 B.Cu → D13 MHPA3528 cathodes F.Cu), local (span ≤26 mm), clean (cu 6–11), low-current (R-limited 2–6 mA, non-switching); three independent single-via cross-layer nets. EXCLUDED with evidence: XGPIO0…9 bank (10 nets but ~55 mm cross-board cross-layer hauls — not local), NFC front-end (RF/matching/antenna/crystal), USB, ACC_5V boost cluster (U21 TPS61023 switching, `ACC_5V_LX` inductor node), IR emitter `IR_LED_A/K` (Q1-switched TSAL6100 drive current — switching/high-current), SPK_P/N + connectors (MAX98357A class-D outputs), XGPIO*_HDR/EXT_*/NATIVE_*_HDR (community J5/J8 header mass), BTN_A/B/UP/DOWN/LEFT/RIGHT_N (scattered SW2–SW7, MIX, span 40–66 mm), U11_PROG + PWR_SENSE (D-307 hard walls). A coherent 3-net group is preferred to a safe singleton to demonstrate throughput beyond singletons/2-net clusters WITHOUT bundling unrelated nets.
- **Route → gate → promote (one foreground run; authoritative untouched).** `route FRONT_RGB_LED` → ALL OK (3/3): D13.4↔R124.2 22.532 mm via@(51.250,96.800), D13.3↔R125.2 26.124 mm via@(50.800,98.250), D13.2↔R126.2 29.999 mm via@(56.400,103.250); 25 segments F.Cu+B.Cu 0.200 mm + 3 through vias 0.60/0.30; REFILLED In1/In4 GND zones [39,40] once for the 3 anti-pads; scratch 527/58, AUTH sha UNCHANGED. `gate FRONT_RGB_LED` = **PASS, every check** (D-307 502 trk + 55 via multiset a SUBSET — 0 missing; 28 new items all target-net; ONLY zones 39/40 fill-changed, all other 39 zones byte-identical; all three D13 nets fully connected open-edges 1→0 each; 0 prior requested pairs regressed; ratsnest 693→690 EXACTLY −3; no new/worse DRC class; unc 499→499).
- **Result — GATE PASS, COPPER PROMOTED.** Authoritative `sha256 a309f8ce…31279a50` → **`f4e95dec…8559e7ee`**; tracks **502→527** (+25 D13-cathode); vias **55→58** (+3 through vias); 6 layers / 41 zones unchanged; ratsnest **693→690** (−3); journal **88→91** (+3 `REST_INC`); PCB file diff = **352 insertions / 59 deletions** — additions are 25 `segment` + 3 `via` lines (ZERO `segment`/`via`/`footprint` deletions, grep-confirmed); all 59 deletions are `(xy…)` points inside the In1/In4 GND `filled_polygon` re-pour (the 3 via anti-pads), nothing else; real KiCad DRC **identical** (`{solder_mask_bridge:1, hole_clearance:5, lib_footprint_issues:199, unconnected_items:499}` — 0 clearance, hole_clearance unchanged at 5, 0 violations touch the D13 copper).
- **Tests.** New contract **G22** pins the increment (all three D13 nets connected across their F/B hop; copper legal = 25 trk F.Cu+B.Cu 0.200 mm + three 0.60/0.30 through vias one per net; ADD-ONLY = IMU 8 + DISP 11 + ACC 31 + RGB 20 + Phase-A 432/54). G18–G21 stay green unchanged — their ADD-ONLY invariants exclude ALL `REST_INC` nets and pin `phaseA_via`==54, so they auto-generalise as total vias grow 55→58. `router_regression.py` = **ALL CHECKS PASS (G1–G22), 94 PASS lines**, run twice, deterministic. New probe `incremental_probe_010.py` ALL PASS; `incremental_probe_006/007/008/009.py` refreshed to the D-308 board (`_009` pre-IMU-copper check generalised) ALL PASS; `phaseB_bringup_probe_005.py` updated (527/58/91; accepted set + the three D13 cathode nets; 164 rest nets, **10 routed, 154 unrouted**) ALL PASS. The Phase-A DRU-synthesis probes `d269_probe`/`d264_probe`/`dru_probe` are NOT part of the maintained increment regression and NOT regressed by D-308: `dru_probe`(2)/`d264`(1) carry the SAME pre-existing reds on the pristine HEAD board; `d269_probe` C/D is a FLAKY borderline (0.275 mm) between two REMOTE Phase-A items (`LTC_GATE` via vs a `BAT_RAW` In2.Cu zone track) under KiCad's non-byte-reproducible full-zone `ZONE_FILLER` re-pour — it flips on HEAD as well as D-308 (my copper is 45 mm away); the real byte-stable authoritative board is DRC-clean.
- **Opportunity & Simplification Scan.** The first multi-via increment forced no mechanic extension (the 'extend only if genuinely forced' bar was not crossed). Observed (not acted on, to avoid weakening historical contracts): the four prior probes share an identical fingerprint-constant refresh + 'pre-X copper' generalised-preservation idiom that could fold into one shared `incremental_fingerprints.py` on the sixth increment. Larger coherent batches ARE justified going forward, but batch size stays evidence-limited (remaining clean local multi-net clusters are mostly in excluded categories). No BOM/recoverability/testability/firmware/UX/mechanical change forced; In2/In3 remain spare. **Open owner decisions: NONE.**
- **Integrity & rollback.** Rollback = pre-promotion `sha256 a309f8ce…31279a50` (D-307; parent `c939f35`). All floors ENFORCED (D-249/D-269/D-257 via ladder — the three 0.60/0.30 vias ARE Default netclass ≥ 0.50 mm min_via / 0.60 BAT_MAIN / 0.200-0.150 signal / 0.25 hole-hole / D-275-D-288 bridge / **In1-In4 GND** — only these two planes re-poured for the anti-pads, every other zone byte-identical); no DRU/rule/placement/topology/net/footprint/value/polarity/outline/stackup change; no D-290 reauth; D-297/D-299/D-301/D-302 levers + G14–G21 preserved; DEVICE_SPEC unchanged; `beta-full-reference-v1` untouched; shared journal authoritative (91); no orphan process.
- **Next FBV2-P2-011:** continue rest-of-board routing via the same framework (**154 of 164 rest nets unrouted**); same-layer, single-via and now multi-via cross-layer groups all proven. Candidates (screen with `w/screen_010.py`): `RESERVED_SPARE` (U23 B.Cu 3-pad spare), short IR-receiver/audio non-switching straps (`IR_RX_VS_LOCAL`, `AMP_SD_MODE`), other short single-via mixed-layer controls (`TOUCH_RST_N`, `TOUCH_INT_N`, `SD_CARD_DETECT_N`). Still avoid U11_PROG/PWR_SENSE (hard walls); RF/NFC/USB/crystals/community-header/rails/switching/class-D deferred; the XGPIO0…9 bank needs a long cross-board haul accepted first. The first increment needing MULTIPLE series vias on ONE net / a via array / an In2/In3 inner-signal traverse must extend `connect_cross`/`refill_planes` deliberately. Full analysis: [`audits/2026-08-30-p2-010-d308-fifth-rest-of-board-incremental-increment-front-rgb-led-promoted.md`](audits/2026-08-30-p2-010-d308-fifth-rest-of-board-incremental-increment-front-rgb-led-promoted.md).

**PROGRESS EARNED (fifth rest-of-board increment promoted; first multi-via): PCB routing ~18 %→~18 %, overall ~76 %, readiness ~77 % (JLCPCB file unchanged — a small noncritical increment, not fab-readiness).**

---

## 2026-08-30 - FBV2-P2-009: D-307 — Fourth rest-of-board incremental increment routed and PROMOTED (the BMI270 IMU I2C address-select strap `BMI270_SDO_ADDR`): a governed CTO ACCEPT + PROMOTE (no Phase-A / FRONT_RGB / ACC / DISP casualty, no new DRC, autonomy CONTINUES, no owner decision)

**A FOURTH REST-OF-BOARD NET IS ON THE AUTHORITATIVE BOARD — and the fallback was EARNED, not defaulted to.** Starting HEAD `73ea58e` (D-306; pushed; `origin/master` identical).

- **Same framework, ZERO new mechanics.** `incremental_router.py` (baseline/route/gate/promote) took the fourth increment through only new `GROUPS` entries; a same-layer B.Cu multi-terminal net routed through the existing Prim-MST + `connect_role` path, and the D-306 via/`connect_cross`/`refill_planes` machinery was reused byte-for-byte and correctly did NOT engage (no via ⇒ no plane re-pour ⇒ all 41 zones byte-identical).
- **Group selection (measured; highest-value low-risk, not merely the shortest net).** Baseline `9c0586d8…` (494/55/6, ratsnest 695, journal 86) + a refined READ-ONLY screen (`w/screen_009.py`: per-net MST/layer/THT, group bbox, accepted-copper congestion within bbox+1/+2 mm, and a footprint-local coherence dump). All candidate nets confirmed **Default netclass** directly from the board. Five candidates recorded. CHOSEN PRIMARY: **U11_PROG** (`ILIM_VSET`+`ISET`, the coherent same-chip BQ25185 charger current-program straps U11.7/.8) — the most coherent multi-net group; a clean singleton is NOT bundled with unrelated nets to hit a count, and the favored IMU/I2C family has no clean local *pair* (the only other U4 net, `BMI270_INT1_RAW`, is a ~46 mm haul to the MCU). Fallbacks: **PWR_SENSE** (`VBUS_PRESENT`+`MAX17048_ALRT_N`, west power-status), then the pristine **IMU_ADDR** (`BMI270_SDO_ADDR`). REJECTED outright: IMU_INT1 (17 mm MCU-adjacent single strap), IMU_COMBO (52 mm half-board span, needs a via). EXCLUDED per mandate: community-header/RF/NFC/USB/crystals/switching (ACC_5V boost)/GND/+3V3 rails/class-D SPK.
- **Two congested primaries EMPIRICALLY DISPROVEN (one foreground run at a time, authoritative untouched).** `route U11_PROG` → INCOMPLETE: `ILIM_VSET` clean (4.857 mm) but `ISET` R37.1→**U11.8 has NO LEGAL ESCAPE** — boxed by BQ25185 pins U11.6/U11.9 + board edge (pad-local wall, order-independent). `route PWR_SENSE` → INCOMPLETE: 2/4 edges (R104.2→TP31.1, TP11.1→U14.5) have **no legal corridor even at the 0.025 mm fine grid** — the west `BAT_PROTECTED_P` trunk. Both confirm the congestion screen; AUTH sha verified UNCHANGED after each; no rule weakened, no brute force.
- **The pristine fallback, EARNED.** `route IMU_ADDR` → ALL OK (R118.1↔R119.2 2.709 mm, R119.2↔U4.1 3.454 mm; 8 segments; 0.200 mm B.Cu, 0 via; 3-pad/2-edge MST). `gate IMU_ADDR` = **PASS, every check** (D-306 494 trk + 55 via multiset a SUBSET; 8 new items all target-net; ZERO zones fill-changed — no via; `BMI270_SDO_ADDR` open edges 2→0; 0 prior pairs regressed; ratsnest 695→693 EXACTLY −2; DRC identical).
- **Result — GATE PASS, COPPER PROMOTED.** Authoritative `sha256 9c0586d8…3f62259` → **`a309f8ce…31279a50`**; tracks **494→502** (+8); vias **55** (unchanged — no via); 6 layers / 41 zones unchanged; ratsnest **695→693** (−2); journal **86→88** (+2 `REST_INC`); PCB file diff = **64 insertions / 0 deletions** — pure ADD-ONLY (8 B.Cu `segment` lines; zero `segment`/`via`/`footprint`/`filled_polygon` deletions, grep-confirmed — the cleanest increment yet); real KiCad DRC **identical** (`{solder_mask_bridge:1, hole_clearance:5, lib_footprint_issues:199, unconnected_items:499}`).
- **Tests.** New contract **G21** pins the increment (`BMI270_SDO_ADDR` connected R118.1-R119.2-U4.1 one island; copper legal = 8 trk B.Cu 0.200 mm, no via; ADD-ONLY = DISP 11 + ACC 31 + RGB 20 + Phase-A 432/54). G18–G20 stay green unchanged (their ADD-ONLY invariants already exclude all `REST_INC` nets generically). `router_regression.py` = **ALL 92 CHECKS PASS (G1–G21)**, run twice, deterministic. New probe `incremental_probe_009.py` ALL PASS; `incremental_probe_006/007/008.py` refreshed to the D-307 board (`_008`'s pre-DISP-copper check generalised) ALL PASS; `phaseB_bringup_probe_005.py` updated (502/55/88; accepted set FRONT_RGB + ACC_3V3_CTL + DISP_RST_N + BMI270_SDO_ADDR; 164 rest nets, **7 routed, 157 unrouted**) ALL PASS.
- **Opportunity & Simplification Scan.** Zero new mechanics needed; the one-edge/one-via plane plan was NOT evolved to multi-via/inner-signal metadata because no promoted group forced it. No BOM/recoverability/testability/firmware/UX/mechanical change forced; In2/In3 remain spare. **Open owner decisions: NONE.**
- **Integrity & rollback.** Rollback = pre-promotion `sha256 9c0586d8…3f62259` (D-306; parent `73ea58e`). All floors ENFORCED (D-249/D-269/D-257 via ladder — no via laid / 0.60 BAT_MAIN / 0.200-0.150 signal / 0.25 hole-hole / D-275-D-288 bridge / **In1-In4 GND** — both planes byte-identical); no DRU/rule/placement/topology/net/footprint/value/polarity/outline/stackup change; no D-290 reauth; D-297/D-299/D-301/D-302 levers + G14–G20 preserved; DEVICE_SPEC unchanged; `beta-full-reference-v1` untouched; shared journal authoritative (88); no orphan process.
- **Next FBV2-P2-010:** continue rest-of-board routing via the same framework (**157 of 164 rest nets unrouted**). The two congested regions are now characterised hard walls (BQ25185/BPP trunk — U11.8 boxed; west `BAT_PROTECTED_P` trunk — TP31/U14.5 no corridor): do NOT re-attempt naively. Candidates: short 08_BUTTONS controls (`RESERVED_SPARE`, `BTN_B_N`), other short single-via mixed-layer controls, or 07_IR/06_AUDIO non-switching straps (screen THT/analog first). The first multi-via / via-array / In2/In3 inner-signal increment should extend `connect_cross`/`refill_planes` deliberately. Full analysis: [`audits/2026-08-30-p2-009-d307-fourth-rest-of-board-incremental-increment-imu-addr-promoted.md`](audits/2026-08-30-p2-009-d307-fourth-rest-of-board-incremental-increment-imu-addr-promoted.md).

**PROGRESS EARNED (fourth rest-of-board increment promoted): PCB routing ~18 %→~18 %, overall ~76 %, readiness ~77 % (JLCPCB file unchanged — a small noncritical increment, not fab-readiness).**

---

## 2026-08-30 - FBV2-P2-008: D-306 — Third rest-of-board incremental increment routed and PROMOTED (the DISP_RST_N display-reset control net) — AND THE FIRST TO EXERCISE A VIA / MIXED-LAYER PRIMITIVE: a governed CTO ACCEPT + PROMOTE (no Phase-A / FRONT_RGB / ACC casualty, no new DRC, autonomy CONTINUES, no owner decision)

**A THIRD REST-OF-BOARD NET IS ON THE AUTHORITATIVE BOARD — the first with a via.** Starting HEAD `c22b9fd` (D-305; pushed; `origin/master` identical).

- **Same framework, minimally extended for the first via.** `incremental_router.py` gained exactly three generic mechanics, each forced by a concrete need: a **per-edge layer decision** (`edge_plan` — same-layer B.Cu groups stay byte-identical), a **`connect_cross`** helper composing only proven `qrouter` primitives (`escape` → `via_site` → `via` → two anchored `connect_role` runs — **`qrouter.py` untouched**, so the battery driver is unaffected), and a **`refill_planes`** step. No via-ladder abstraction, no blind/buried/microvia path, no multi-via arrays — those await the increment that forces them.
- **Group selection (measured, prefer a new safe primitive).** Baseline `f0046eb7…` (483/54/6, ratsnest 697, journal 84) + `w/screen_007.py` (READ-ONLY). CHOSEN: **DISP_RST (`/DISP_RST_N`)** — one 3-pad net with pads NOT all on one layer (R16.1/J1.10 F.Cu SMD, U2.8 B.Cu SMD): MST = one SAME-LAYER edge (R16.1↔J1.10, the **first incremental F.Cu run**) + one CROSS-LAYER edge (J1.10↔U2.8, the **first incremental via / mixed-layer route**, ONE 0.60/0.30 Default through via ≥ the 0.50 mm `min_via_diameter`). Low congestion (2 Phase-A items in bbox+2 mm), NONCRITICAL low-speed reset line. REJECTED: AUDIO_SPK (isolated F.Cu+THT but SPK_P/N are class-D SWITCHING outputs the mandate excludes), U11_PROG (16 items, coupled to the safety-critical BPP path), PWR_SENSE (12 items, west fuel-gauge congestion). FALLBACK held (not needed): IMU_STRAP `BMI270_SDO_ADDR` B.Cu singleton — DISP_RST was not disproven. EXCLUDED per mandate: community-header/RF/NFC/USB/crystals/GND/+3V3 rails.
- **The first-via blocker, characterised (not brute-forced).** The through via pierces the In1/In4 GND reference planes; the stale plane fill (poured before the via existed) had no anti-pad, so the first gate saw `clearance` ×2 + `hole_clearance` ×2 at (52.95,87.0) vs the In1/In4 GND zones. Focused evidence bounded the fix: a plain refill drifts ONLY zones 39/40 (In1/In4 GND, +35 poly-pts each — a stored-vs-current `ZONE_FILLER` discrepancy independent of the via) and NO other zone. So `route` re-pours EXACTLY In1/In4 when (and only when) a via was laid; DRC returns to baseline IDENTICALLY. Plane byte-equality is NOT claimed — the promotable standard is DRC-neutral + "only In1/In4 changed", proven.
- **The gate (real full-board, D-286).** (1) NO prior copper deleted/altered (D-305 483 trk + 54 via multiset is a SUBSET); (2) every new item a target-group net; (3) **only In1/In4 GND planes re-poured, all other 39 zones identical**; (4) DISP_RST_N fully connected across the hop (open edges 2→0); (5) 0 prior requested pairs regressed; (6) ratsnest dropped by EXACTLY the requested count (697→695); (7) real kicad-cli DRC — no new/worse class, `unconnected_items` not increased.
- **Result — GATE PASS, COPPER PROMOTED.** Authoritative `sha256 f0046eb7…04c7cd41` → **`9c0586d8…e3f62259`**; tracks **483→494** (+11 DISP_RST_N); vias **54→55** (+1 F↔B through via); 6 layers / 41 zones unchanged; ratsnest **697→695** (−2); journal **84→86** (+2 `REST_INC`); board diff **470 insertions / 336 deletions** — ALL 336 deletions are In1/In4 `filled_polygon` xy (the plane re-pour); ZERO deleted `segment`/`via`/`footprint` lines (grep-confirmed); real KiCad DRC **identical** (`{solder_mask_bridge:1, hole_clearance:5, lib_footprint_issues:199, unconnected_items:499}`).
- **Tests.** New contract **G20** pins the increment (DISP_RST_N connected across the F/B hop; copper legal = 11 trk spanning F.Cu+B.Cu at 0.200 mm + exactly one 0.60/0.30 through via; ADD-ONLY = RGB 20 + ACC 31 + Phase-A 432/54). **G18/G19 generalised** — their ADD-ONLY via count now pins `phaseA_via`==54 (vias NOT owned by any `REST_INC` net) instead of `all_via`==54, so the pin survives increments that add vias (no change to their RGB/ACC claims). `router_regression.py` = **ALL 89 CHECKS PASS (G1–G20)**, run twice, deterministic. New probe `incremental_probe_008.py` ALL PASS; `incremental_probe_006/007.py` refreshed to the D-306 board (`_007` generalised) ALL PASS; `phaseB_bringup_probe_005.py` updated (494/55/86; accepted set FRONT_RGB + ACC_3V3_CTL + DISP_RST_N; 164 rest nets, 6 routed, 158 unrouted) ALL PASS.
- **Opportunity & Simplification Scan.** The first via increment needed exactly the three mechanics above and nothing more; the gate already fingerprinted vias generically, so only a zone-preservation proof was added. No BOM/recoverability/testability/firmware/UX/mechanical opportunity forces a change; In2/In3 remain spare capacity. **Open owner decisions: NONE.**
- **Integrity & rollback.** Rollback = pre-promotion `sha256 f0046eb7…04c7cd41` (D-305; parent `c22b9fd`). All floors ENFORCED (D-249/D-269/D-257 via ladder — the 0.60/0.30 via IS the Default netclass geometry ≥ 0.50 mm min_via / 0.60 BAT_MAIN / 0.200-0.150 signal / 0.25 hole-hole / D-275-D-288 bridge / **In1-In4 GND** — planes stay GND, only fill re-poured); no DRU/rule/placement/topology/net/footprint/value/polarity/outline/stackup change; no D-290 reauth; D-297/D-299/D-301/D-302 levers + G14–G19 preserved; DEVICE_SPEC unchanged; `beta-full-reference-v1` untouched; shared journal authoritative (86); no orphan process.
- **Next FBV2-P2-009:** continue rest-of-board routing via the same framework (158 of 164 rest nets unrouted); both same-layer and single-via cross-layer groups now proven. Candidates: IMU_STRAP `BMI270_SDO_ADDR` (held B.Cu fallback), short 08_BUTTONS controls, or another short mixed-layer control; the first increment needing MULTIPLE vias / a via array / an In2/In3 inner-signal traverse should extend `connect_cross`/`refill_planes` deliberately. Full analysis: [`audits/2026-08-30-p2-008-d306-third-rest-of-board-incremental-increment-disp-rst-via-promoted.md`](audits/2026-08-30-p2-008-d306-third-rest-of-board-incremental-increment-disp-rst-via-promoted.md).

## 2026-08-30 - FBV2-P2-007: D-305 — Second rest-of-board incremental increment routed and PROMOTED (the ACC_3V3_CTL accelerometer-3V3 load-switch control group): a governed CTO ACCEPT + PROMOTE (no Phase-A / FRONT_RGB casualty, no new DRC, autonomy CONTINUES, no owner decision)

**A SECOND REST-OF-BOARD NET-GROUP IS ON THE AUTHORITATIVE BOARD.** Starting HEAD `6353bd7` (D-304; pushed; `origin/master` identical).

- **Same reusable lever, ZERO new mechanics.** `incremental_router.py` (commands `baseline`/`route`/`gate`/`promote`) took the second increment through only a new `GROUPS` registry entry — no change to the router, gate or promoter. The framework is now proven for multi-terminal (multi-segment MST) nets, not just 2-pad pairs.
- **Group selection (measured, not convenient).** `incremental_router.py baseline` (452/54/6, ratsnest 701, journal 80) + `w/screen_007.py` (READ-ONLY) screened candidates by MST edges / layer-THT / Phase-A congestion within each net's bounding box. CHOSEN: **ACC_3V3_CTL** — the accelerometer 3V3 load-switch (U20) local control group: `ACC_3V3_EN` (enable U3.15 → R98/U20.1/TP26, a **4-pad multi-terminal net / 3-edge MST**) + `ACC_3V3_ILIM` (current-limit set R97 → U20.4). Both Default netclass (0.200 mm width / 0.200 mm clearance, **NO via**), all B.Cu SMD, **low-congestion** (only 4 Phase-A B.Cu strands within bbox + 2 mm), NONCRITICAL low-current control — satisfies "prefer 2–6 nets" AND adds the multi-segment MST primitive FRONT_RGB never exercised (all single-edge 2-pad). REJECTED: IMU_STRAP `BMI270_SDO_ADDR` (0 nearby copper but a singleton — kept as the bounded fallback); PWR_SENSE `VBUS_PRESENT`+`MAX17048_ALRT_N` (12 nearby copper, congested west battery-mgmt); U11_PROG `ILIM_VSET`+`ISET` (16 nearby, the D-302 U11.2 wall region); AUDIO_SPK (F.Cu/THT/analog near mic keepout); DISP_RST `DISP_RST_N` (MIX-layer, needs a via). EXCLUDED per mandate: community-header mass, RF/NFC, USB, crystals, GND/+3V3 rails.
- **The gate (real full-board, D-286).** (1) NO prior copper deleted/altered — the D-304 copper-item multiset (452 trk + 54 via) is a SUBSET of the routed items; (2) every new item is a target-group net; (3) both nets fully copper-connected (`GetConnectedItems`: ACC_3V3_ILIM 1→0, ACC_3V3_EN 3→0); (4) no prior requested pair regressed; (5) pcbnew ratsnest dropped by EXACTLY the requested count (701→697); (6) real kicad-cli DRC — no new class, none increased, `unconnected_items` not increased.
- **Result — GATE PASS, COPPER PROMOTED.** Authoritative `sha256 00c93bdb…dfb72aad` → **`f0046eb7…04c7cd41`**; tracks **452→483** (+31 ACC_3V3_CTL); vias **54** (no new via); 6 layers / 41 zones unchanged; ratsnest **701→697** (−4); journal **80→84** (+4 `REST_INC`); board diff **248 insertions / 0 deletions** (ADD-ONLY at the file level); real KiCad DRC **identical** (`{solder_mask_bridge:1, hole_clearance:5, lib_footprint_issues:199, unconnected_items:499}`).
- **Tests.** New contract **G19** pins the increment (2 nets connected; 0.200 mm B.Cu, no via; ADD-ONLY = FRONT_RGB 20 + Phase-A 432 + 54 via + ACC 31). **G18 generalised** — its ADD-ONLY Phase-A count now excludes ALL journal `role=REST_INC` nets (not just FRONT_RGB), so the "Phase-A == 432 trk / 54 via" pin stays true as later increments are promoted (no change to its FRONT_RGB claims). `router_regression.py` = **ALL 86 CHECKS PASS (G1–G19)**, deterministic. New focused probe `incremental_probe_007.py` ALL PASS; `incremental_probe_006.py` refreshed to the D-305 board ALL PASS; `phaseB_bringup_probe_005.py` updated (483/84; accepted-increment set FRONT_RGB + ACC_3V3_CTL; 164 rest nets, 5 routed, 159 unrouted) ALL PASS.
- **Opportunity & Simplification Scan.** The framework held with zero new mechanics; the multi-terminal net routed/gated through the existing Prim-MST path. No generic need for multilayer/via/bus/group-transaction semantics yet — deliberately NOT generalised prematurely (MIX-layer/via and F.Cu/THT left for the increment that forces them, so the via/D-257 discipline is introduced against a concrete need). No BOM/recoverability/testability/firmware/UX/mechanical opportunity forces a change; In2/In3 remain spare capacity. **Open owner decisions: NONE.**
- **Integrity & rollback.** Rollback = pre-promotion `sha256 00c93bdb…dfb72aad` (D-304; parent `6353bd7`). All floors ENFORCED (D-249/D-269/D-257/0.60 BAT_MAIN/0.200-0.150 signal/0.25 hole-hole/D-275-D-288 bridge/In1-In4 GND); no DRU/rule/placement/topology/net/footprint/value/polarity/outline/stackup change; no D-290 reauth; D-297/D-299/D-301/D-302 levers + G14–G18 preserved; DEVICE_SPEC unchanged; `beta-full-reference-v1` untouched; shared journal authoritative (84); no orphan process.
- **Next FBV2-P2-008:** continue rest-of-board routing with the next sharply-bounded group via the same framework (good low-risk B.Cu candidates: IMU_STRAP `BMI270_SDO_ADDR`, short 08_BUTTONS controls, PWR_SENSE once characterised; introduce the via/D-257 discipline deliberately at the first MIX-layer group). Full analysis: [`audits/2026-08-30-p2-007-d305-second-rest-of-board-incremental-increment-acc-3v3-ctl-promoted.md`](audits/2026-08-30-p2-007-d305-second-rest-of-board-incremental-increment-acc-3v3-ctl-promoted.md).

**PROGRESS EARNED (second rest-of-board increment promoted): PCB routing ~16 %→~17 %, overall ~76 %, readiness ~77 % (JLCPCB file unchanged — a small noncritical increment, not fab-readiness).**

---

## 2026-08-30 - FBV2-P2-006: D-304 — First rest-of-board incremental increment routed and PROMOTED (the FRONT_RGB indicator group): a governed CTO ACCEPT + PROMOTE (no Phase-A casualty, no new DRC, autonomy CONTINUES, no owner decision)

**FIRST REST-OF-BOARD COPPER IS ON THE AUTHORITATIVE BOARD.** Starting HEAD `50149f4` (D-303; pushed; `origin/master` identical).

- **The lever — a reusable, scoped INCREMENTAL router/promoter (`incremental_router.py`).** Loads the D-302 promoted board via `qrouter.QBoard` (all existing copper is an OBSTACLE; new copper is ADDED, never `Remove()`d), routes a bounded named net-GROUP into a scratch copy `checks/w/INC_<GROUP>/` (the authoritative project is never touched during the experiment — sha256 verified unchanged after `route`), and PROMOTES only on a real full-board gate PASS. Commands: `baseline` / `route` / `gate` / `promote`.
- **Group selection (measured, not convenient).** Rest-of-board geometry measured for every non-rail/non-scope multi-pad net (`w/measure_rest_006.py`, READ-ONLY). CHOSEN: **FRONT_RGB** (`/08_BUTTONS_EXPANDERS/FRONT_RGB_R_N|G_N|B_N`) — front-panel RGB status-LED control (U23 expander → R124/125/126), 6 pads, all B.Cu SMD, Default netclass (0.200 mm width / 0.200 mm clearance, NO via), spans 4.77/3.85/5.09 mm, tightly localised, **region carries ZERO Phase-A copper**, electrically NONCRITICAL, no rail/RF/USB/high-current/clock/crystal/switching constraint — high information at minimum risk. REJECTED: 07_IR (F.Cu/THT near edge, moderate-current emitter); 01_POWER_TREE short pairs (power-adjacent, not a coherent subsystem); 05_I2C `BMI270_SDO_ADDR` (IMU-adjacent single net). EXCLUDED per mandate: community-header mass, RF/NFC, USB, crystals, GND/+3V3 rails.
- **The gate (real full-board, D-286).** (1) NO Phase-A copper deleted/altered — the D-302 copper-item multiset (432 trk + 54 via geometry signatures) is a SUBSET of the routed items; (2) every new item is a target-group net; (3) each target net fully copper-connected (`GetConnectedItems`, 1→0 open edges); (4) no prior Phase-A requested pair regressed (71 pairs); (5) pcbnew ratsnest dropped by EXACTLY the requested count (704→701); (6) real kicad-cli DRC — no new class, none increased, `unconnected_items` not increased.
- **Result — GATE PASS, COPPER PROMOTED.** Authoritative `sha256 63a9bc54…f87d6ba9` → **`00c93bdb…dfb72aad`**; tracks **432→452** (+20 FRONT_RGB); vias **54** (no new via); 6 layers / 41 zones unchanged; ratsnest **704→701** (−3); journal **77→80** (+3 `REST_INC`); real KiCad DRC **identical** (`{solder_mask_bridge:1, hole_clearance:5, lib_footprint_issues:199, unconnected_items:499}`).
- **Tests.** New contract **G18** pins the increment (3 nets connected; 0.200 mm B.Cu, no via; ADD-ONLY = 432 other trk / 54 via / 20 rgb trk); `router_regression.py` = **ALL 82 CHECKS PASS (G1–G18)**, deterministic. New focused probe `incremental_probe_006.py` ALL PASS; `phaseB_bringup_probe_005.py` updated to the promoted state (452/80, 3 routed rest nets, 161 unrouted) ALL PASS.
- **Opportunity & Simplification Scan.** The incremental framework generalises to every future subsystem and cannot hide a cross-group casualty; it supersedes the stale one-shot `replay_battery_block.py`. No BOM/recoverability/testability/firmware/UX/mechanical opportunity forces a change. **Open owner decisions: NONE.**
- **Integrity & rollback.** Rollback = pre-promotion `sha256 63a9bc54…f87d6ba9` (D-302; parent `50149f4`). All floors ENFORCED (D-249/D-269/D-257/0.60 BAT_MAIN/0.200-0.150 signal/0.25 hole-hole/D-275-D-288 bridge/In1-In4 GND); no DRU/rule/placement/topology/footprint/outline/stackup change; no D-290 reauth; D-297/D-299/D-301/D-302 levers + G14–G17 preserved; DEVICE_SPEC unchanged; `beta-full-reference-v1` untouched; shared journal authoritative (80); no orphan process.
- **Next FBV2-P2-007:** continue rest-of-board routing with the next sharply-bounded group via the same framework. Full analysis: [`audits/2026-08-30-p2-006-d304-first-rest-of-board-incremental-increment-front-rgb-promoted.md`](audits/2026-08-30-p2-006-d304-first-rest-of-board-incremental-increment-front-rgb-promoted.md).

**PROGRESS EARNED (first rest-of-board copper promoted): PCB routing ~15 %→~16 %, overall ~76 %, readiness ~77 % (JLCPCB file unchanged — a small noncritical increment, not fab-readiness).**

---

## 2026-08-30 - FBV2-P2-005: D-303 — Phase-B bring-up on the promoted board: a governed CTO CHARACTERIZATION + INTEGRITY + SCOPING milestone (no copper change, board byte-identical, autonomy CONTINUES, no owner decision)

**PHASE-B DEFINED, INTEGRITY RE-VERIFIED, STALE REPLAY MACHINERY CHARACTERIZED, REAL REMAINING PHASE-B SCOPED.** Starting HEAD `01a38a5` (D-302; pushed; `origin/master` identical).

- **Exact Phase-B definition (from the code).** "Phase B" in this repo is the battery-block REPLAY / IDEMPOTENCE verification of the D-271 discipline, NOT rest-of-board routing: `replay_battery_block.py` (verbatim scratch→authoritative promotion), `route_battery_block.py` SECTION 17 `AQROOT_REPLAY` (independent journal reproduction, frozen order / pinned widths / `passes=2`, on a clean scratch), `phaseB_compare.py` (the A-vs-B gate). The driver is scoped to the power tree ONLY.
- **Integrity baseline re-verified.** `HEAD == origin/master == 01a38a5`, clean; authoritative PCB `sha256 63a9bc54…f87d6ba9` / size 1475931; **432 tracks / 54 vias / 6 layers / 41 zones / 324 footprints**; journal **77 entries**; **all 432 routed tracks are in-scope power-tree nets (0 out-of-scope) → Phase-A battery-block copper ONLY**; `router_regression.py` = ALL 79 CHECKS PASS (G1–G17); shared journal not mutated.
- **The existing Phase-B drivers assume a copper-EMPTY base (proven, faithful evidence).** (i) `replay_battery_block.py:40-42` refuses a non-empty authoritative board (`raise SystemExit`) → post-promotion (432 tracks) it can never run again; its promotion role is already fulfilled byte-identically by D-302. (ii) SECTION-17 replay (`:2297`) SKIPS every `role=='TRUNK+ESCAPE'` entry — exactly the ONE entry that defines the promotion (`BAT_PROTECTED_P U11.2→C36.1, w=1.5, reinforcement=True`); a replay carries 76/77 items, dropping the wall closure, and would NOT reproduce the board. (iii) `phaseB_compare.py` needs a `phaseB.json` that was never produced. The replay machinery predates the D-297/D-299/D-301/D-302 levers and is stale.
- **The promotion is sound regardless.** The board is byte-identical to a scratch from a GENUINE full-authority Phase-A gate (`run_003t_full.sh 004b2`, `DRIVER_EXIT=0`, PHASE A COMPLETE) — real driver, real order, not a proxy (D-286) — DRC zero new copper classes, regression ALL PASS. So the D-271 reproduction proof is a modest-value nicety with stale machinery; re-running it as-is is not justified.
- **Real remaining Phase-B, scoped (next bounded lever).** Rest-of-board = **164 multi-pad nets, 0 routed**, across 9 subsystem sheets + rails (GND 259 pads, +3V3 86 pads; 09_COMMUNITY_HEADER 20 nets, 04_SPI_B_RADIOS_NFC 20, 01_POWER_TREE-beyond-block 18, top 17, 08_BUTTONS_EXPANDERS 10, …). ~85 % of remaining routing, NO driver (route_battery_block is power-tree only). Next lever: a new scoped INCREMENTAL driver that loads the promoted board, PRESERVES the Phase-A copper (never erase/reroute), routes a bounded isolated net-group first, gated by real full-board DRC (D-286), promoted only on a genuine no-casualty / no-new-DRC increment; generalize/retire the one-shot `replay_battery_block.py`.
- **Opportunity & Simplification Scan (mandated):** rest-of-board routing is core CTO-authority engineering, not an owner decision; decompose by sheet/net-group for small independently-promotable increments; retire the stale one-shot replay path. **Open owner decisions: NONE.**
- **Integrity.** No copper/placement/rule/floor/DRU/topology/footprint/outline change; authoritative PCB byte-identical; journal at HEAD; all floors + D-249/D-257/D-269/D-275/D-288/D-290 and the accepted D-297/D-299/D-301/D-302 levers (G14–G17) preserved; frozen `beta-full-reference-v1` untouched. Added: `checks/phaseB_bringup_probe_005.py` (READ-ONLY, reproducible; ALL PASS) → `checks/phaseB_bringup_005.json`. DEVICE_SPEC unchanged.
- **Next: FBV2-P2-006** — begin rest-of-board routing (build the incremental driver, route the first isolated net-group, real full-board DRC gate, no Phase-A casualty). Audit: [`audits/2026-08-30-p2-005-d303-phaseB-bringup-characterization-integrity-scope.md`](audits/2026-08-30-p2-005-d303-phaseB-bringup-characterization-integrity-scope.md).
- **NO PROGRESS EARNED (no copper routed): PCB routing ~15 %, overall ~76 %, readiness ~77 %.**

---

## 2026-08-30 - FBV2-P2-004B2: D-302 — the FIRST AUTHORITATIVE PHASE-A COPPER PROMOTION (verified `U11_RETARGET`→`C36.1` full-run board becomes the authoritative PCB: 432 tracks / 54 vias / 6 layers / direction-2 placement / ratsnest 704 / 77-entry journal / regenerated D-249…D-269 DRU) + the router-regression fixture-compatibility fix (primitives → copper-clean scratch fixture, new G17) so G1–G17 all PASS on the routed board; PHASE A COPPER ONLY — NOT ALL ROUTING COMPLETE; D-275 and D-277..D-301 preserved

**A COMMITTED PROMOTION + ROUTINE HARNESS FIX — AUTONOMY CONTINUES (no owner decision raised).** Starting HEAD `56d0ebe` (D-301; pushed) with the verified promotion staged in the working tree: the authoritative PCB byte-identical to the `checks/w/FULL003T_004b2_u11retarget` scratch, the regenerated DRU it requires, the 77-entry `phaseA_journal.json`, plus the already-committed `AQROOT_U11_RETARGET` lever / **G16** / `u11_retarget_probe_004b.py`.

**WHAT IS PROMOTED.** With `AQROOT_U18BPP_JOIN=I3 AQROOT_U19CAP=1 AQROOT_LTCGATE_KO=1 AQROOT_U11_RETARGET=1` the full run (`run_004b2_full.log`, `DRIVER_EXIT=0`, **PHASE A COMPLETE**) closes the D-301 terminal wall: `u11_escape()` retargets the `BAT_PROTECTED_P` trunk far endpoint from the impossible ~55 mm cross-board `D9.1` run to a SHORT wide tap into the nearest already-on-net ≥1.20 mm BPP node copper `C36.1` (63.750,74.325) — B.Cu **7.905 mm** at 1.50 mm min trunk width, journal-tagged `[current-path reinforcement]` (the 004B2 no-casualty refinement keeps the U11.2 0.20 mm SENSE tie, so the tap is judged by `reserve_gate(allow_dangle=False)` with the ratsnest EXACTLY unchanged, not a new `gate()` connection). Routed **74** / skipped-already-connected **101** / **ratsnest 704 (−77)**.

**THE PROMOTED ARTIFACT (integrity).** Authoritative PCB `sha256 63a9bc54…f87d6ba9` is **byte-identical** to the verified scratch; **432 tracks, 54 vias, 6 copper layers, direction-2 placement** (placement fingerprint `397dffe1f77e4d10` == artifact), 41 zones, 77-entry journal (incl. the `U11.2→C36.1` `reinforcement:True` entry). Real KiCad DRC on the authoritative board = **`{hole_clearance:5, lib_footprint_issues:199, solder_mask_bridge:1, unconnected_items:499}`** — **ZERO new copper DRC classes**, and the D-301 scratch's `track_width:1` is GONE (the regenerated D-249 trunk-width rule + real routed geometry resolve it). `u11_retarget_probe_004b.py` and the exact judge PASS on the real board.

**THE DRU IS THE ACCEPTED RULE SET, NOT A RELAXATION.** The regenerated DRU (67→119 rules, byte-identical to the scratch) ADDS the per-net escape/tap/stub/trunk/clearance rules the routed copper needs — D-249 (11 refs), D-257 (39: fine-pitch escape via/hole/annular), D-258/D-263/D-266 (escape/reservation vias), D-264 (BAT_MAIN outer-layer In2/In3 split), D-269 (current-path routed clearance) — and renames three generic rules to their specific accepted forms. **The old HEAD DRU is STALE and cannot accompany the routed board**: without these per-net rules the accepted routed escapes/taps/vias/stubs would be measured against the generic netclass rules and DRC would spuriously flag legal copper. NO floor is relaxed (D-249 ≥1.20 mm, D-269 0.300 mm, D-257 via ladder, 0.60 mm BAT_MAIN intact).

**THE HARNESS FIX (routine engineering, NOT an owner decision).** `router_regression.py` G3/G4/G6/G8/G9 (11 checks) failed only because `fresh()` copies the now-routed authoritative board into PRIMITIVE unit vehicles that lay a few tracks from scratch and assert exact ratsnest-fall / DRC-delta / widest-escape / requested-pad connectivity — they assume a copper-EMPTY base (temporarily restoring HEAD's 0-track board made all 11 pass with the same lever code, proving fixture coupling). Fix: a new **`scratch_clean(work,name)`** derives a fixture from the authoritative board's SAME placement / footprints / GND zones / rule areas / DRU+pro context and removes ONLY routed copper (board-level `PCB_TRACK`/`PCB_ARC`/`PCB_VIA`, stripped as balanced S-expressions on the file text so pcbnew is never mutated and the authoritative file is never touched). Every `fresh()` caller audited & classified — **CLEAN primitive fixture:** CASES G2–G6, CONFLICTS bisection, G7, G8, G9, G11, G12; **AUTHORITATIVE routed state (unchanged):** G1 (faithful copy whose DRC must EQUAL the authoritative DRC), G10 (concurrency baseline == authoritative DRC), and the real-DRC/probe/judge harnesses. Copper is hidden from NO check meant to validate the promoted board.

**CONFLICTS RE-PIN (placement, not relaxation).** The promoted direction-2 placement moves U18 (HEAD (3.0,72.4) rot 90°→authoritative (8.0,66.5) rot 180°), so `U18.8`/`U18.9` widest-legal-escape re-measures at U18's authoritative pose as **0.245 mm** (was 0.250 mm) — STILL far below their 1.20 / 0.60 mm floors, so both remain NO-LEGAL-ESCAPE (conflict PRESERVED). `U14.2/U14.3/U11.2` did not move (0.240/0.200 mm unchanged).

**NEW CONTRACT G17** — a standing guard that the fix is a fixture change, not a test weakening: the authoritative board MAY carry promoted copper (432/54); the clean fixture has ZERO tracks/arcs/vias; the authoritative file is byte-for-byte unchanged (sha256+size+mtime) after fixture building; placement/layers(6)/footprints(324)/zones(41)/DRU preserved in the fixture; and the authoritative DRC/connectivity is measured on the ROUTED board (auth ratsnest 704 < clean-fixture ratsnest 781). **`router_regression.py` = ALL 79 CHECKS PASS (G1–G17), run twice, deterministic.**

**INTEGRITY & ROLLBACK.** Pre-promotion authoritative PCB `sha256 2235e273…d642d7e` (HEAD `56d0ebe`, 0 tracks) remains the parent of this commit and is tagged for rollback (`beta-v2-p2-battery-pre-authoritative`, `beta-v2-p2-pre-sixlayer-authoritative`); D-290 untouched; the accepted `AQROOT_U18BPP_JOIN` (D-297), `AQROOT_U19CAP` (D-299/G14), `AQROOT_LTCGATE_KO` (D-301/G15), `AQROOT_U11_RETARGET` (D-302/G16), `place_003l` (D-285), the D-275/D-288 bridge, D-275 and D-277..D-301 preserved; frozen `beta-full-reference-v1` untouched; `JLCPCB_READINESS` NOT edited.

**NOT ALL ROUTING COMPLETE / NEXT.** This promotes **Phase-A battery-block copper ONLY** — ratsnest 704 / unconnected_items 499 remain (Phase B and the rest of the board unrouted). Next: **FBV2-P2-005 — Phase B bring-up on the promoted board**, screened full DRC (D-286), promote only on a genuine gate PASS. Full analysis: [`audits/2026-08-30-p2-004b2-d302-first-authoritative-phasea-copper-promotion-regression-fixture-fix.md`](audits/2026-08-30-p2-004b2-d302-first-authoritative-phasea-copper-promotion-regression-fixture-fix.md). **PROGRESS EARNED (first copper promoted): PCB routing 0 %→~15 % (Phase-A battery block), overall 74 %→~76 %, readiness ~77 % (JLCPCB file unchanged).**

---

## 2026-08-30 - FBV2-P2-004A: D-301 — the `AQROOT_LTCGATE_KO` path-shaping lever's full-authority gate CONFIRMED a GENUINE +1 (closes `LTC_GATE U18.10→Q3.4`, LOST 0, no new DRC) — so the minimum OFF-by-default lever + G15 are ACCEPTED and COMMITTED (byte-identical when unset); copper is NOT promoted because full Phase-A still FAILs at the newly-exposed `U11.2` BPP trunk wall, readiness/progress unchanged, autonomy CONTINUES, D-275 and D-277..D-300 preserved; DEVICE_SPEC.md created

**A GOVERNED CTO ACCEPT + COMMIT + OVERALL-RUN FAIL — AUTONOMY CONTINUES (a new terminal wall is not a stop reason; no owner decision is raised).** Starting HEAD `060a313` (D-300; pushed; `phaseA_journal.json` restored byte-identical at HEAD) carrying two uncommitted WIP files: the OFF-by-default `AQROOT_LTCGATE_KO` path-shaping lever in `checks/route_battery_block.py` (a `LTCGATE_KO` env-parse block + a scoped install/lift hook + a bulky ~118-line in-run probe `_ltcgate_probe`/`AQROOT_LTCGATE_PROBE`) and its **G15** contract in `checks/router_regression.py`. No router process live.

**THE LEVER (a path-shaping keep-out, NOT a re-order — D-300 refuted ordering).** `AQROOT_LTCGATE_KO` parses one or more net-foreign `QR.SEG(...,'KO')` capsules `(layer,(x0,y0,x1,y1,hw))` (`=1`/`AUTO`/`DEFAULT` → validated default; explicit `LAYER:x0,y0,x1,y1,hw;…` string in mm overrides). Guarded on the exact triple `(LTC_GATE,U18.10,Q3.4)` AND `LTCGATE_KO` non-empty, the capsules are installed immediately before the join and **lifted immediately after** (proven `AQROOT_U19CAP` mechanism — nothing else on the board sees them). Unset → `LTCGATE_KO==[]`, no keep-out installed, **byte-identical to every prior run**. The validated default seals the squeeze-gap just north of the `BAT_SENSE` 1.0 mm current-path track `(2.8,62.05)-(5.4,62.05)` on **each far run layer F/I2/I3** at `(2.6,62.5)-(5.5,62.5)`, half-width 0.4 mm, forcing the `connect_hop` far run WEST of x=2.8 so the join routes F.Cu `(5.15,64.75)→(4.0,64.75)→(1.9,62.65)→(1.9,60.7)`, **8.556 mm**, `gate()` PASS. The real cause of the wall is **D-269 alone** (clearance 0.2803 vs 0.300 mm, ~19.7 µm short; FINE_ESC legalises the D-257 via, so there is NO D-249 track_width violation in the real path — the earlier "0.20 mm D-249" was a raw-`connect_hop` probe artifact that bypassed FINE_ESC). Pinned OFF/ON + scoped by **G15**.

**THE FULL-AUTHORITY GATE RAN AND COMPLETED.** `AQROOT_U18BPP_JOIN=I3 AQROOT_U19CAP=1 AQROOT_LTCGATE_KO=1 bash w/run_003t_full.sh 004a_ltcgate1 w/cand_003t/t_a_r77e15n10_r79e15n10.json` (direction-2 placement, both prior accepted levers ON) → `checks/w/phaseA_003t_full_004a_ltcgate1.json` (secs **1500.2**, driver exited clean); the shared `phaseA_journal.json` was restored byte-identical to HEAD afterward and no process remains. A genuine full-authority artifact (not a proxy — D-286), judged by `python3 w/judge_004a.py`.

**VERDICT: a GENUINE +1, nothing lost.** vs the 003Y2 baseline (D-299): connections **72→73**, skipped-already-connected **101=101**, ratsnest **705/−76 → 704/−77**, journal **75→76**; the connected-set diff **GAINED 1 / LOST 0** = exactly `LTC_GATE Q3.4↔U18.10` (role SIG, layer F, 2 vias, `via_dia 0.35`, 8.556 mm) — **not a swap**. vs the 003W baseline (D-297): GAINED 3 (`LTC_GATE` + the two D-299 U19 pins `N_BATDIV R89.2↔U19.6` and `REC_BAT_LOW (node)↔U19.7`), LOST 0 — the accepted U18.8 / U19CAP gains are preserved and the LTC_GATE close is purely additive. `LTC_GATE U18.10↔Q3.4` in the connected set = True and no longer the terminal fail; final DRC histogram **identical** to 003Y2 (`{hole_clearance:5, lib_footprint_issues:199, solder_mask_bridge:1, track_width:1, unconnected_items:499}`), no new class/increase; no sub-0.50 non-fine via (run via diameters 0.35/0.60/0.65/0.80).

**RULING: ACCEPT + COMMIT.** The full gate (not a proxy) confirms a real, board-legal net gain, so `AQROOT_LTCGATE_KO` is **ACCEPTED and COMMITTED** — banked env-gated / OFF-by-default, byte-identical when unset, pinned by G15. Production WIP is **pruned to the narrow accepted lever**: the bulky in-run probe `_ltcgate_probe` (~118 lines) and its `AQROOT_LTCGATE_PROBE` hook are REMOVED (that engineering evidence lives in the audit/artifacts, not the router); net WIP reduced from +242 to +124 lines across the two tracked files.

**COPPER IS NOT PROMOTED — full Phase-A still FAILs at a NEW terminal wall.** 004A is the FIRST run in the whole arc to close every upstream wall (west/BAT_RAW, U18.8 In3-join D-297, the saturated U19 dead-cell field D-299, and now `LTC_GATE` D-301) and therefore the FIRST to reach the final `u11_escape()` step, which now FAILs: `PHASE A: FAIL -- U11.2 escape: none exists`. So readiness/progress are UNCHANGED and the authoritative board stays six layers / 0 tracks / 0 vias.

**THE NEW TERMINAL WALL, characterized sharply (no new long route).** `u11_escape()` (`route_battery_block.py:2149`) lays the **U11.2 end of the `BAT_PROTECTED_P` high-current trunk**, LAST after all 73 queue connections: escape `D9.1` at `W_TRUNK_BPP=1.50 mm`, flare `U11.2` (1.50→0.20 mm SENSE neck), `connect_role(launch→D9.1)` at 1.50/1.20 mm, `gate()`. Geometry (authoritative board): `U11.2`=(66.400,78.200) inside the EAST `BAT_PROTECTED_P` node cluster; `D9.1`=(11.350,72.500) in the WEST control-copper mass — a **~55 mm cross-board ≥1.20 mm B.Cu trunk**. The rest of the BPP backbone is already connected on the 004A board (`R75.2→(stage)` TRUNK 14.458 mm F.Cu; EARLY SOUTH BRIDGE land `C36.1` 70.925 mm; `C58.1→D9.1` TAP 5.092 mm; C36/C25/C58/D9.1 "already joined via R75.2"); `U11.2` already has its thin 0.20 mm SENSE tie (5.525 mm, a Kelvin/sense tie, not a current path). The single ≤~1.30 mm central west↔east channel is already occupied by the south bridge (ywest 82.40) and the R75.2 trunk, so a SECOND parallel cross-board 1.50 mm trunk has NO legal path — a structural **≥1.20 mm-trunk NO_LEGAL_PATH** (the D-273/274/281/282/283 class), NOT a ~20 µm DRC pinch like LTC_GATE.

**OPPORTUNITY & SIMPLIFICATION SCAN (mandated).** Path-shaping is essentially free / reversible / BOM-neutral: the accepted lever banks a proven +1 OFF-by-default with zero BOM/placement/rule impact, and pruning the probe removes complexity. The U11.2 wall is reducible: U11.2 is IN the east node (already on-net with D9.1 via the bridge/R75.2 backbone), so a SHORT wide tap into the nearest on-net ≥1.20 mm node copper is a better implementation than a cross-board trunk (the 004B lever). It is a high-current safety-relevant net, so 004B must preserve the ≥1.20 mm current path (no width waiver). The six-layer stack's bare In2/In3 remain spare capacity (the D-297 lesson). No BOM / recoverability (D-049) / testability / manufacturing / firmware / UX opportunity forces a change; no irreversible cost, no strategic fork, no opportunity loss. **Open owner decisions: NONE.**

**DEVICE_SPEC.** At this safe committed boundary the authoritative current-product spec/index **`docs/full-beta-v2/DEVICE_SPEC.md`** was created (mandatory before renders / website / Kickstarter / enclosure briefs / external-mechanical / product-description claims), grounded in the accepted schematic (9 functional sheets) / BOM / population matrix / accepted audits, with LOCKED/FITTED/DNP/TUNE/CAD-TO-VERIFY/UNRESOLVED and INTERNAL/EXTERNAL/MARKETING-SAFE labels and evidence pointers. CURRENT_STATE.md now references it.

**INTEGRITY.** Authoritative PCB byte-identical to HEAD (`sha256 2235e2736838…d642d7e`; six layers, 0 tracks, 0 vias, placement at home); no DRC absorbed (the U11.2 open is surfaced FAIL evidence on gitignored scratch, never in the authoritative board); `phaseA_journal.json` at HEAD; no via below the D-257 ladder; D-269 (0.300 mm), ≥1.20 mm BPP (D-249), 0.60 mm BAT_MAIN ENFORCED; D-290 untouched; the accepted `AQROOT_U18BPP_JOIN` (D-297), `AQROOT_U19CAP` (D-299, G14), `place_003l` (D-285), the D-275/D-288 bridge, D-275 and D-277..D-300 preserved; frozen `beta-full-reference-v1` untouched; `router_regression.py` ALL CHECKS PASS (G9–G15); gitignored 004A evidence preserved (`checks/w/phaseA_003t_full_004a_ltcgate1.json`, `w/judge_004a.py`, `w/FULL003T_004a_ltcgate1/`, `w/TEST004A_*/`, `w/run_004a_*.log`); `JLCPCB_READINESS` unchanged.

**NEXT — FBV2-P2-004B:** build ONE bounded env-gated (OFF-by-default) **U11.2 BPP trunk-endpoint retarget** lever — close the U11.2 trunk end as a SHORT ≥1.20 mm tap into the nearest already-connected BPP node copper (e.g. `C36.1` (63.75,73.75)) instead of the cross-board `u11_escape()` run to `D9.1`; keep `AQROOT_U18BPP_JOIN=I3`+`AQROOT_U19CAP=1`+`AQROOT_LTCGATE_KO=1` ON; full-authority-gate judged (connected-set diff vs `w/phaseA_003t_full_004a_ltcgate1.json`), verifying the retarget PRESERVES a valid high-current path (no width waiver, no functional regression). Fallback: a bounded immediate-neighbour placement ECO to open a ≥1.20 mm U11.2 corridor, re-screened with real full-placement DRC (D-286). Full analysis: [`audits/2026-08-30-p2-004a-d301-ltcgate-ko-path-shaping-lever-full-gate-plus1-accepted-committed-u11-trunk-wall.md`](audits/2026-08-30-p2-004a-d301-ltcgate-ko-path-shaping-lever-full-gate-plus1-accepted-committed-u11-trunk-wall.md).

---

## 2026-08-30 - FBV2-P2-003Z: D-300 — the `AQROOT_LTCGATE` defer-to-congestion lever's full-authority gate COMPLETED and it is BEHAVIOURALLY IDENTICAL to D-299 (gained 0 / lost 0, same `LTC_GATE U18.10→Q3.4` terminal wall, same D-249 track_width / D-269 clearance rejections, identical final DRC) — so a pure re-order is a NULL OPERATION on this wall: the lever and its G15 WIP are REJECTED/RETIRED and the false-positive probe is RETIRED; copper is NOT promoted, readiness/progress unchanged, autonomy CONTINUES, D-275 and D-277..D-299 preserved

**A GOVERNED CTO FAIL / LEVER REFUTATION + WIP RETIREMENT — AUTONOMY CONTINUES (a refuted bounded lever is not a stop reason; no owner decision is raised).** Starting HEAD `3ce5244` (D-299; pushed; `phaseA_journal.json` restored at HEAD) carrying three uncommitted WIP files: the OFF-by-default `AQROOT_LTCGATE` defer-to-congestion lever in `checks/route_battery_block.py` (+34/−1), its **G15** contract in `checks/router_regression.py` (+30), and the measured-record probe `checks/ltcgate_join_probe_003z.py` (untracked). No router process live.

**THE LEVER (a pure re-order).** `route_battery_block.py` removed the `LTC_GATE U18.10→Q3.4` branch from section `8b. LTC_GATE` (guarded on the flag AND the exact triple `(LTC_GATE, U18.10, Q3.4)`) and re-queued it as the LAST functional item — a new `13z` stage after the closure stage and test points — at the ordinary SIG ladder. OFF → the branch stays in 8b, byte-identical to every prior run; pinned OFF/ON + scoped by a G15 regression contract. **The theory (from the probe):** section 8b routes the join before the western margin is fully occupied, so `connect_role` takes a short central path that narrows to 0.20 mm inside the BPP 1.20 mm-trunk keep-region (D-249) and grazes a `BAT_MAIN` path at 0.2803 mm (~20 µm short of D-269); deferring the join to full congestion was supposed to force the router onto a clean west detour.

**THE GATE RAN AND COMPLETED.** `AQROOT_U18BPP_JOIN=I3 AQROOT_U19CAP=1 AQROOT_LTCGATE=1 bash w/run_003t_full.sh 003z3_ltcgate w/cand_003t/t_a_r77e15n10_r79e15n10.json` → `checks/w/phaseA_003t_full_003z3_ltcgate.json` (secs **1497.0**, driver exited clean); the shared `phaseA_journal.json` was restored **byte-identical to HEAD** afterward and no process remains; judged by `python3 w/judge_003z.py w/phaseA_003t_full_003z3_ltcgate.json`. A genuine full-authority artifact (not a proxy — D-286).

**VERDICT: IDENTICAL TO D-299 — THE LEVER DOES NOTHING.** vs the 003Y2 baseline (D-299): connections **72=72**, skipped **101=101**, ratsnest **705/−76 = 705/−76**, journal **75=75**; the connected-set diff **GAINED 0 / LOST 0**. The failing rung is byte-for-byte the same two frozen owner rules — `track_width` (rule 'BAT_PROTECTED_P high-current trunk width - D-249' min 1.2000 mm; actual 0.2000 mm) and `clearance` (rule 'BAT_MAIN routed clearance - current path role - D-269' 0.3000 mm; actual 0.2803 mm); `LTC_GATE U18.10↔Q3.4` NOT in the connected set, still the terminal fail; final DRC histogram identical (`{hole_clearance:5, lib_footprint_issues:199, solder_mask_bridge:1, track_width:1, unconnected_items:499}`); no sub-0.50 non-fine via (run via diameters 0.35/0.60/0.65/0.80). **Deferring the join to route last changed nothing** — the driver's `connect_role` greedily re-takes the identical rule-violating central path even when the branch is queued as the very last functional item. A re-order is a null operation on this wall.

**THE PROBE WAS A FALSE POSITIVE (D-286 reaffirmed).** `ltcgate_join_probe_003z.py` measured a legal **10.475 mm west detour** (B.Cu, w=0.20, 0 new DRC, ratsnest 705→704) via a post-hoc `QR.connect_role(U18.10, Q3.4)` on the **saved** D-299 full-run board — but that does NOT reproduce the driver's real in-run state (the reserved-lane keep-outs already lifted before the closure stage; a board that is not the post-hoc snapshot; the greedy path-cost model still offers and takes the shorter central rung because a re-order never physically blocks it). A post-hoc measurement on the final saved board is a **proxy the full gate overrides** — only a genuine full-authority Phase-A PASS promotes copper (D-286), and here it FAILs identically.

**RULING (D-300).** REJECT/RETIRE the `AQROOT_LTCGATE` lever and its G15 WIP via an **exact reverse patch** scoped to the two tracked files (`git diff -- route_battery_block.py router_regression.py | git apply -R`, NOT a broad destructive reset); RETIRE the false-positive probe (untracked, never committed) so **no artifact in the tree claims the lever works** — the negative finding is recorded in the audit and CTO_DECISIONS instead. Copper NOT promoted; the authoritative board stays six layers / 0 tracks / 0 vias; readiness/progress UNCHANGED (D-286). NOT an owner decision (no floor relaxed, no frozen part moved, no DRU change, no D-249/D-269 relaxation); `/home/aqroot8/.aqroot-autopilot-stop` ABSENT, autonomy CONTINUES. **Retirement proof:** post-revert `git hash-object` = `HEAD:` blob for each file (`route_battery_block.py` `ebcafae…`, `router_regression.py` `38eb3a8…`); `git grep LTCGATE|AQROOT_LTCGATE|13z|ltcgate_join_probe` over tracked Python source (excluding gitignored `checks/w/`) NO match; probe removed; `router_regression.py` ALL CHECKS PASS (G12/G13/G14 intact; G15 correctly gone).

**OPPORTUNITY & SIMPLIFICATION SCAN (mandated at this LTC_GATE / power-protection milestone).** No product-capability / BOM / recoverability (D-049) / testability / manufacturing / firmware / UX / future-option opportunity justifies changing architecture — the wall is a single internal LTC4368 gate-drive control-net join (all other `LTC_GATE` segments connected: `U18.10→R76.1` F.Cu FINE_ESC; `Q3.2→Q3.4`/`Q2.2→Q2.4`/`Q3.2→Q2.2` B.Cu), not a capability or BOM gap; no component change closes a 20 µm routing pinch; TP17 already covers testability; the six-layer stack's bare In2/In3 remain spare future capacity (the D-297 lesson). No irreversible cost / strategic fork. **Open owner decisions: NONE.** **Next best technical lever (grounded):** the probe proved a legal ~10.5 mm west detour exists; the driver just won't take it while the shorter central lane is offered — so the next lever is **path-shaping, not ordering**: an explicit local waypoint / central-lane keep-out (on the proven `AQROOT_U19CAP` KO mechanism, lifted after the join) that BLOCKS the rule-violating central lane and forces `connect_role` onto the west detour clear of the BPP trunk (D-249) and the `BAT_MAIN` path (D-269, miss ~19.7 µm). Fallback: a bounded immediate-neighbor placement ECO (~20 µm nudge) re-screened with full-placement DRC (D-286). Both preserve every floor; neither is an owner decision.

**INTEGRITY.** Authoritative PCB byte-identical to HEAD (`sha256 2235e2736838…d642d7e`; six layers, 0 tracks, 0 vias, placement at home); no DRC absorbed; `phaseA_journal.json` at HEAD; no via below the D-257 ladder; D-269 (0.300 mm), ≥1.20 mm BPP (D-249), 0.60 mm BAT_MAIN ENFORCED; D-290 untouched; the accepted `AQROOT_U18BPP_JOIN` (D-297) and `AQROOT_U19CAP` (D-299, G14), `place_003l` (D-285), the D-275/D-288 bridge, D-275 and D-277..D-299 preserved; frozen `beta-full-reference-v1` untouched; gitignored 003Z evidence preserved (`checks/w/phaseA_003t_full_003z3_ltcgate.json`, `w/judge_003z.py`, `w/FULL003T_003z*_ltcgate/`, `w/TEST003Z_*/`, `w/run_003z_ltcgate.log`); `JLCPCB_READINESS` unchanged.

**NEXT — FBV2-P2-004A:** build ONE bounded, env-gated (OFF-by-default) **path-shaping** lever for `LTC_GATE U18.10→Q3.4` (a central-lane keep-out forcing the west detour — NOT a re-order, refuted here), keep `AQROOT_U18BPP_JOIN=I3`+`AQROOT_U19CAP=1` ON, validate vs `router_regression.py` (authoritative byte-identical), full-authority-gate judged (connected-set diff vs `w/phaseA_003t_full_003y2_u19cap.json` and `w/phaseA_003t_full_003w_u18bpp_i3.json`); the placement ECO is the fallback. Full analysis: [`audits/2026-08-30-p2-003z-d300-ltcgate-defer-to-congestion-lever-refuted-false-positive-probe-retired.md`](audits/2026-08-30-p2-003z-d300-ltcgate-defer-to-congestion-lever-refuted-false-positive-probe-retired.md). **NO PROGRESS EARNED (no copper promoted): PCB routing 0 %, overall 74 %, readiness ~77 %.**

---

## 2026-08-30 - FBV2-P2-003Y: D-299 — the D-298 U19 CAPACITY lever's full-authority gate COMPLETED and it is a GENUINE +2 connected-set gain (NOT the D-296 swap) — so `AQROOT_U19CAP` is ACCEPTED and COMMITTED (banked env-gated / OFF-by-default, pinned by G14); but copper is NOT promoted because full Phase-A still FAILs, the terminal wall newly ADVANCING past the whole U19 field to `LTC_GATE U18.10→Q3.4` (candidate paths DRC-gate-rejected by the frozen D-249 BPP-trunk-width and D-269 BAT_MAIN-clearance rules), readiness/progress unchanged, autonomy CONTINUES, D-275 and D-277..D-298 preserved

**A GOVERNED CTO ACCEPT + COMMIT (the U19CAP source lands) + A GOVERNED FAIL OF THE OVERALL PHASE-A RUN + HANDOFF — AUTONOMY CONTINUES (a newly-exposed bounded wall is not a stop reason; no owner decision is raised).** Starting HEAD `7a39430` (D-298; `phaseA_journal.json` at HEAD) carrying the uncommitted OFF-by-default `AQROOT_U19CAP` U19 east-lane reservation + U19.7-first lever in `checks/route_battery_block.py` and its G14 contract in `checks/router_regression.py`. The CTO ran the FULL authority gate (the only judge that promotes copper — D-286).

**THE GATE RAN AND COMPLETED.** The governing foreground run `AQROOT_U18BPP_JOIN=I3 AQROOT_U19CAP=1 bash w/run_003t_full.sh 003y2_u19cap w/cand_003t/t_a_r77e15n10_r79e15n10.json` → `checks/w/phaseA_003t_full_003y2_u19cap.json` (secs **1463.2**, driver exited clean); the SHARED `phaseA_journal.json` was restored **byte-identical to HEAD** afterward and **no process remains**. A genuine full-authority artifact (not a proxy/focused vehicle — D-286), judged by `checks/w/judge_003y2.py`.

**THE VERDICT — A GENUINE +2, NOT A SWAP.** vs the D-297 003W baseline `w/phaseA_003t_full_003w_u18bpp_i3.json` (conn 70): connections **70→72**, skipped **99→101**, ratsnest **707/−74 → 705/−76**, journal **73→75**; the connected-set diff **GAINED exactly 2 — `N_BATDIV R89.2→U19.6` and `REC_BAT_LOW (node)→U19.7` (both SIG, F.Cu, 2 vias, board-legal 0.60/0.30) — and LOST 0.** Both boxed U19 pins close SIMULTANEOUSLY for a strict +2 with nothing lost — the categorical opposite of D-296's 1-for-1 swap; the U19 field is genuinely ENLARGED (`U19.7` 15.621 mm, `U19.6` 9.52 mm, both F.Cu 0.60/0.30 — the full router's board-legal choice, slightly different from the probe's In3/In2 route but the same +2). `LTC4368_FAULT_N` DETOURS CLEANLY (the D-298 §5 risk resolved): all three branches connected on B.Cu (`U18.7→R81.2` 8.478, `R81.2→R82.1` 2.719, `R82.1→Q9.1` **77.567** — the 64 mm run detoured ~13 mm longer and still cleared the per-connection `gate()`), FAULT_N not the terminal wall. Final DRC histogram **identical** to 003W `{hole_clearance:5, lib_footprint_issues:199, solder_mask_bridge:1, track_width:1, unconnected_items:499}` — no new class, no increase; no sub-0.50 non-fine via (run via diameters 0.35/0.60/0.65/0.80, all on/above the D-257 ladder).

**THE NEW TERMINAL WALL — `LTC_GATE U18.10→Q3.4`, characterized without a new route.** The +2 U19 closure moved the wall two connections forward, past the whole U19 field, to the LTC4368 gate-drive net. It is **NOT** `NO_PATH`/`NO_LEGAL_ESCAPE` — candidate join paths ARE found but the per-connection `gate()` REJECTS every one for TWO FROZEN OWNER RULES: (1) **D-249** `BAT_PROTECTED_P` high-current trunk (min 1.20 mm) — the candidate narrows to 0.20 mm where the BPP trunk-area rule applies (it enters the western-margin BPP trunk keep-region); (2) **D-269** `BAT_MAIN` routed clearance (0.300 mm) — the candidate comes within **0.2803 mm**, only ~19.7 µm short. `LTC_GATE`'s other segments are all connected (`U18.10→R76.1` F.Cu FINE_ESC_3 2× 0.35/0.20 vias; `Q3.2→Q3.4`/`Q2.2→Q2.4`/`Q3.2→Q2.2` B.Cu); the failing connection is the JOIN bridging the `U18.10` F.Cu escape cluster to the `Q3.4` B.Cu gate cluster. This is the SAME family as the U18.8/U19 walls — a full-run-emergent congestion/corridor pinch on a flexible low-current control net squeezed between the BPP trunk (D-249) and a BAT_MAIN path (D-269) — **bounded and reducible in principle** (the join has slack; the D-269 miss is ~20 µm), a routing/ordering lever within CTO scope, NOT an owner decision and NOT a rule relaxation.

**RULING (D-299).** The U19 CAPACITY lever is a genuine +2 → **ACCEPTED and COMMITTED**: the two source files (`checks/route_battery_block.py` `AQROOT_U19CAP` lever, `checks/router_regression.py` G14) are retained and committed, banked env-gated / **OFF by default** (byte-identical when unset; D-298 deliberately deferred this commit to the gate). Copper is **NOT promoted** — full Phase-A still FAILs at the new LTC_GATE wall, so the authoritative board stays six layers / 0 tracks / 0 vias and readiness/progress DO NOT move (D-286: only a full PASS promotes). A governed CTO ACCEPT + COMMIT + overall-run FAIL, NOT an owner decision (no floor relaxed, no frozen part moved, no DRU change); `/home/aqroot8/.aqroot-autopilot-stop` ABSENT, autonomy CONTINUES.

**TESTS.** `python3 checks/router_regression.py` → **ALL CHECKS PASS**, incl. **G14** (lever OFF by default → byte-identical; `AQROOT_U19CAP` activates; reserved-lane geometry spans U19.7/U19.6; hooks scoped to the U19 east lane + REC_BAT_LOW-before-N_BATDIV).

**INTEGRITY.** Authoritative PCB byte-identical to HEAD (`sha256 2235e2736838…d642d7e`; six layers, 0 tracks, 0 vias, placement at home); no DRC absorbed; `phaseA_journal.json` at HEAD; no via below the D-257 ladder; D-269 (0.300 mm), ≥1.20 mm BPP (D-249), 0.60 mm BAT_MAIN ENFORCED; D-290 untouched; the accepted `AQROOT_U18BPP_JOIN` (D-297), `place_003l` (D-285), the D-275/D-288 bridge, D-275 and D-277..D-298 preserved; frozen `beta-full-reference-v1` untouched; `JLCPCB_READINESS` unchanged. **NEXT — FBV2-P2-003Z:** one narrowly-scoped env-gated (OFF-by-default) bounded lever that re-sites/re-orders/detours the `LTC_GATE U18.10→Q3.4` join corridor so its path stays clear of the `BAT_PROTECTED_P` 1.20 mm trunk region (preserving D-249) and opens the 0.300 mm `BAT_MAIN` clearance (preserving D-269), within D-257/D-266 mechanics, keeping `AQROOT_U18BPP_JOIN=I3`+`AQROOT_U19CAP=1` ON, full-authority-gate judged (connected-set diff vs `w/phaseA_003t_full_003y2_u19cap.json` and `w/phaseA_003t_full_003w_u18bpp_i3.json`), **without** any D-290 reauth, DRU/rule change, via below the D-257 ladder, D-249/D-269 relaxation, or topology/footprint/outline change. Full analysis: [`audits/2026-08-30-p2-003y-d299-u19cap-full-gate-plus2-accepted-committed-ltc-gate-wall.md`](audits/2026-08-30-p2-003y-d299-u19cap-full-gate-plus2-accepted-committed-ltc-gate-wall.md). **NO PROGRESS EARNED (no copper promoted): PCB routing 0 %, overall 74 %, readiness ~77 %.**

## 2026-08-30 - FBV2-P2-003W: D-297 — the SECONDARY U18.8 I2-join lever (the D-295/D-296 handoff) completes `BAT_PROTECTED_P U18.8→R75.2` on In3 for a GENUINE +1 connected-set gain — a PURE JOIN with NO casualty, NO new via, NO new DRC class, and the lone `via_dangling` cleared — so it is ACCEPTED and retained env-gated / OFF-by-default in tracked source; but copper is NOT promoted (the full run still FAILs on the saturated U19 field), readiness/progress unchanged, autonomy CONTINUES, D-275 and D-277..D-296 preserved

**A GOVERNED ACCEPT OF A SECONDARY LEVER + A GOVERNED FAIL OF THE OVERALL PHASE-A RUN — AUTONOMY CONTINUES (a normal Phase-A FAIL is not a stop reason; no owner decision is raised).** Starting HEAD `27f9790` (pushed; `phaseA_journal.json` at HEAD) carrying the uncommitted lever WIP `checks/route_battery_block.py` (+25/−1 lines: the env-gated, OFF-by-default `AQROOT_U18BPP_JOIN` lever the D-295/D-296 handoff designed), a G13 regression contract in `checks/router_regression.py`, and the measured-record probe `checks/u18_i3_join_probe_003w.py`. The CTO ran the FULL authority gate (the only judge that promotes copper — D-286).

**THE WALL (D-294/295).** At the D-293 direction-2 placement `t_a_r77e15n10_r79e15n10` the `BAT_PROTECTED_P` reserve pair places two ordinary 0.35/0.20 **THROUGH** vias at `R75.2` (2.800,66.800) and `U18.8` (7.200,66.500) on **In2**; their In2 JOIN is `NO_PATH` because a `BAT_RAW` 0.600 mm current-path wall runs vertically on In2 at x≈6.4→6.65 (y 50.45→70.40), severing the west→east lane between them. U18.8 stays open (non-fatal).

**THE LEVER (D-297).** The reserve vias are THROUGH vias (copper on every layer), so the join is electrically identical on In2 or In3. **In3.Cu is a routable six-layer signal layer** (`qrouter.ROUTABLE[6]=('F','B','I2','I3')`) that is **EMPTY across the whole corridor** on the real full-run board (2 In3 tracks board-wide, none here; no In3 pour — only the In1/In4 GND planes). `AQROOT_U18BPP_JOIN` (`'I2'`/`'I3'`, `.upper()`-normalised) names the join layer for **exactly one branch** — guarded on the env flag AND `net==BAT_PROTECTED_P and a=='U18.8' and b_=='R75.2'`, nothing wider; unset → the join stays on `va[2]` (In2), byte-identical to every prior run.

**PROBE (`u18_i3_join_probe_003w.py`, on the actual full-run routed board `w/FULL003T_e15n10cto/…kicad_pcb`, throwaway copy so the evidence board is never mutated):** In2 join `NO_PATH` (the D-294 wall reproduces); In3 join **ok 4.410 mm**; real KiCad DRC adds **ZERO new classes**; the lone `via_dangling` **1→0** (the join absorbs the previously-dangling reserve via). ALL CHECKS PASS.

**FULL AUTHORITY GATE (`checks/w/phaseA_003t_full_003w_u18bpp_i3.json`, secs 1272.5), vs the D-294 baseline `w/phaseA_003t_full_e15n10cto.json`:** connections **69→70** (+1), skipped-already-connected **98→99** (+1 — one downstream `BAT_PROTECTED_P` pad is now found already-joined on the closed net; a positive sign, not a loss), ratsnest **708/−73 → 707/−74** (one more edge cleared), journal **72→73** (+1: `JOIN U18.8→R75.2` layer **I3**, 4.410 mm, **0 vias**), DRC `via_dangling` **1→0** with **no new class** (`{hole_clearance:5, lib_footprint_issues:199, solder_mask_bridge:1, track_width:1, unconnected_items:499}`), terminal fatal wall **UNCHANGED** (`REC_BAT_LOW U19.7→(node) NO_LEGAL_ESCAPE`, `N_BATDIV U19.6` next-in-line).

**THE DECISIVE DIFF IS A STRICT PURE GAIN.** The entire journal delta is **exactly one added JOIN entry with NOTHING lost** — the categorical opposite of D-296's 1-for-1 swap. The In3 join takes routing capacity from **no other net** (In3 is unused in the corridor), so no casualty is possible and none occurs.

**RULING.** The SECONDARY lever is a genuine, board-legal, verified net gain — **ACCEPTED** and retained env-gated/OFF-by-default in tracked source (byte-identical when unset), pinned by the G13 contract + the probe. **But copper is NOT promoted:** Phase-A copper promotes only on a full-authority PASS (D-286), and the run still FAILs on the unchanged saturated U19 field — so the authoritative board stays six layers / 0 tracks / 0 vias and readiness/progress DO NOT move. D-297 **banks** the U18.8 closure in source: once the U19 field is separately enlarged, this lever (ON) yields the U18.8 join for free (no new via, no new DRC). A governed CTO ACCEPT + overall-run FAIL, NOT an owner decision (no floor relaxed, no frozen part moved, direction-2 not exhausted); `/home/aqroot8/.aqroot-autopilot-stop` ABSENT, autonomy CONTINUES.

**TESTS.** `router_regression.py` ALL CHECKS PASS incl. new **G13** (In3 routable; lever OFF by default → byte-identical; `AQROOT_U18BPP_JOIN=I3` activates the In3 join; a non-I2/I3 value never activates; override scoped to exactly `BAT_PROTECTED_P U18.8→R75.2`); `u18_i3_join_probe_003w.py` ALL CHECKS PASS.

**INTEGRITY.** Authoritative PCB byte-identical to HEAD (`sha256 2235e2736838…d642d7e`; six layers, 0 tracks, 0 vias, placement at home); no DRC absorbed (the +1 connection / `via_dangling` clear live only on gitignored full-run scratch); `phaseA_journal.json` at HEAD (backed up/restored around the run); no via below the D-257 ladder; D-269 (0.300 mm), ≥1.20 mm BPP, 0.60 mm BAT_MAIN ENFORCED; D-290 untouched; `place_003l` (D-285) and the D-275/D-288 bridge preserved; D-275 and D-277..D-296 preserved; frozen `beta-full-reference-v1` untouched; `JLCPCB_READINESS` unchanged; gitignored evidence preserved (`checks/w/phaseA_003t_full_003w_u18bpp_i3.json`, `w/FULL003T_e15n10cto/`, `w/TEST003W_PROBE/`).

**NEXT — FBV2-P2-003X:** the last Phase-A blocker is the **simultaneous `REC_BAT_LOW U19.7` + `N_BATDIV U19.6` closure** in the F.Cu/B.Cu-saturated U19 dead-cell field; per D-296 a single-pin reservation only swaps, so implement ONE bounded, env-gated (OFF-by-default) **U19 capacity** lever that offloads a saturating escape (the direction-2-induced `VREC_VCC U19.8` F.Cu pad-escape and/or a boxed U19 escape) onto a bare inner layer (In2/In3, proven free by D-297) within D-257/D-266 mechanics — no via below the D-257 ladder, no D-290 reauth, no DRU/rule/topology/footprint/outline change — judged by the full-authority connected-set diff (must close U19.7 AND U19.6 for a real gain; a 1-for-1 swap is NOT a gain), promoting copper only on a genuine full Phase-A PASS (keep the direction-2 placement and the accepted D-297 U18.8 lever ON).

**Evidence of record:** audit [`audits/2026-08-30-p2-003w-d297-secondary-u18bpp-i3-join-lever-net-gain-accepted.md`](audits/2026-08-30-p2-003w-d297-secondary-u18bpp-i3-join-lever-net-gain-accepted.md); committed source (`checks/route_battery_block.py`, `checks/router_regression.py` G13, `checks/u18_i3_join_probe_003w.py`); gitignored scratch (`checks/w/phaseA_003t_full_003w_u18bpp_i3.json`, `w/FULL003T_e15n10cto/`, `w/TEST003W_PROBE/`, `w/run_003t_full.sh`, `w/cand_003t/t_a_r77e15n10_r79e15n10.json`). **A GENUINE NET GAIN BANKED IN SOURCE, BUT NO COPPER PROMOTED: PCB routing 0 %, overall 74 %, readiness ~77 %.**

---

## 2026-08-30 - FBV2-P2-003V: D-296 — the PRIMARY U19.7 escape-reservation lever (the D-295 handoff) FIRES and CLOSES U19.7 with a board-legal 0.60/0.30 via, but it is a bounded ORDERING TRADE with NO connected-set progress — it merely chooses which pin of the saturated U19 field is the casualty (gains `REC_BAT_LOW U19.7`, loses `REF_POL U19.2`; conn 69/skip 98/ratsnest 708/−73 all unchanged; DRC identical; terminal wall moves U19.7→U19.6) — so it is REJECTED for production and the uncommitted `AQROOT_U19_RESV` source WIP is RETIRED; no source/copper/placement/rule change survives, no DRC absorbed, no promotion, autonomy CONTINUES, D-275 and D-277..D-295 preserved

**A GOVERNED FAIL / PRIMARY-FAMILY REFUTATION — AUTONOMY CONTINUES (a normal Phase-A FAIL is not a stop reason; no owner decision is raised).** Starting HEAD `a2e27fc` (pushed; `phaseA_journal.json` at HEAD) carrying one uncommitted WIP file `checks/route_battery_block.py` (+65 lines: the env-gated, OFF-by-default `AQROOT_U19_RESV` lever the D-295 handoff designed — reserve `REC_BAT_LOW U19.7`'s B.Cu escape + one through via, scored toward Q7.1, BEFORE the `tight='U19'` pin field runs). Two full authority runs were completed under CTO authority and are analysed here; **no new long run was performed in this closeout** (both artifacts already existed).

**RESV (0.35/0.20 rung) — BEHAVIOURALLY IDENTICAL TO D-294.** The corridor-less reservation has no FINE_ESC override, so the sub-minimum D-257 0.35/0.20 via is rejected on `via_diameter` (board minimum 0.50 mm) and `annular_width` (0.075 < 0.125 mm floor); the reservation (non-fatal) is dropped and the run falls through the ordinary path unchanged. `checks/w/phaseA_003t_full_003v_u19resv.json`: conn **69**, skip **98**, ratsnest **708/−73**, journal **72** (NO `RESERVE` step laid), DRC `{hole_clearance:5, lib_footprint_issues:199, solder_mask_bridge:1, track_width:1, unconnected_items:499, via_dangling:1}`, terminal fail still `REC_BAT_LOW U19.7→(node) NO_LEGAL_ESCAPE`. **Connected-set diff vs the D-294 governing baseline `w/phaseA_003t_full_e15n10cto.json` is EMPTY both ways** — exactly the promised "unset reproduces the run byte-for-byte" property.

**RESV2 (0.60/0.30 board-legal rung) — FIRES, CLOSES U19.7, BUT ONLY SWAPS THE CASUALTY.** The corridor-less rung self-corrects to the smallest via legal under GLOBAL rules with no corridor: the ordinary Default-class GENERAL_SIGNAL 0.60/0.30 (diameter 0.60 ≥ 0.50, annular 0.150 ≥ 0.125) — precisely the via `REC_BAT_LOW`'s own SIG route already lands. The reservation is laid (journal **73**: +1 `RESERVE` step `REC_BAT_LOW U19.7→Q7.1`, 1 via) and U19.7's SIG edge completes: **U19.7 ROUTES.** But the saturated U19 dead-cell pin field is not enlarged, only re-ordered — `checks/w/phaseA_003t_full_003v_u19resv2.json`: conn **69** (unchanged), skip **98** (unchanged), ratsnest **708/−73** (unchanged), **identical DRC histogram**, and the terminal wall MOVES to `N_BATDIV U19.6→(node) NO_LEGAL_ESCAPE` (blocked by U19.7 ×22, U19.5 ×20, track ×6, C60.2 ×5).

**THE DECISIVE CONNECTED-SET DIFF (D-294 → RESV2) IS A STRICT 1-FOR-1 SWAP.** GAINED `REC_BAT_LOW U19.7→Q7.1 (SIG)`; LOST `REF_POL TP24.1→U19.2 (SIG)`. Requested-connected count 68→68. Reserving U19.7's B.Cu lane simply takes it from an equally-saturated neighbour, so the greedy-tightest-first race walls on a different U19 pin — U19.2 open, wall at U19.6. **No connection is genuinely gained or lost; the field is capacity-saturated on F.Cu/B.Cu, not priority-limited for one pin.**

**POSITIVE FINDING (recorded, not promoted).** The reservation MECHANISM is REAL and the D-295 diagnosis is CONFIRMED: with a board-legal via the lever fires exactly as predicted, U19.7 is closable in principle, and the run stays fully board-legal (DRC histogram unchanged, no rule relaxed, no via below the D-257 ladder — the corridor-less rung self-corrects). But closing one pin at the cost of another in a saturated field is NOT a net gain, and per D-286 nothing — not even a genuine full-authority run — promotes copper without real connected-set progress.

**RULING (D-296) & RETIREMENT.** REJECTED for production; the `AQROOT_U19_RESV` source WIP is RETIRED via an **exact reverse patch** (`git diff -- checks/route_battery_block.py > /tmp/003v_u19resv_wip.patch; git apply -R` — scoped to the WIP hunks, NOT a destructive broad reset). Proof: `git diff --stat checks/route_battery_block.py` empty; worktree blob `bba62d35efd5de9451dbd12ec85cee89e608e912` = `HEAD:checks/route_battery_block.py` blob (byte-identical); `git grep U19_RESV` over tracked source (excluding gitignored `checks/w/`) returns NO match — no `AQROOT_U19_RESV` code remains in tracked source; working tree clean apart from these docs. Gitignored evidence preserved: `checks/w/phaseA_003t_full_003v_u19resv.json`, `…_u19resv2.json`, `w/FULL003T_003v_u19resv*/`, `w/TEST003V_U19RESV/`. This refutes the PRIMARY reservation family from the D-295 handoff — a governed FAIL, not an owner decision (the SECONDARY U18.8/U18.9 I2 reserve-via lever remains open); `/home/aqroot8/.aqroot-autopilot-stop` ABSENT, autonomy CONTINUES.

**INTEGRITY.** Authoritative PCB byte-identical to HEAD (`sha256 2235e2736838…d642d7e`; six layers, 0 tracks, 0 vias, placement at home); no DRC absorbed (the U18.8 open, the U19.6/U19.7/U19.2 no-escape and the lone scratch `via_dangling:1` are surfaced FAIL evidence on gitignored scratch, never in the authoritative board); no promotion; `place_003l` (D-285) and the D-275/D-288 bridge preserved; D-275 and D-277..D-295 preserved; frozen `beta-full-reference-v1` untouched; `phaseA_journal.json` at HEAD; `JLCPCB_READINESS` unchanged; 0.200 mm / 0.25 mm / **0.300 mm D-269** / ≥1.20 mm BPP / 0.60 mm BAT_MAIN floors ENFORCED, D-290 closed. **NEXT — FBV2-P2-003W:** execute the SECONDARY D-295 lever — a bounded U18.8/U18.9 I2 reserve-via siting/ordering study for a ≥0.200 mm `U18.8→R75.2` join lane within existing D-257/D-266 corridor mechanics, full-authority-gate judged (connected-set diff vs `phaseA_003o_b1_r75rot_cto.json` and `w/phaseA_003t_full_e15n10cto.json`), **without** any D-290 reauth, DRU/rule change, via below the D-257 ladder, or topology/footprint/outline change. Full analysis: [`audits/2026-08-30-p2-003v-d296-primary-reservation-lever-ordering-trade-no-progress-retired.md`](audits/2026-08-30-p2-003v-d296-primary-reservation-lever-ordering-trade-no-progress-retired.md). **NO PROGRESS EARNED: PCB routing 0 %, overall 74 %, readiness ~77 %.**

---

## 2026-08-30 - FBV2-P2-003U: D-295 — the two D-294 walls are FULL-RUN-EMERGENT ordering/congestion casualties (no cheap vehicle judges either at the direction-2 placement); the PRIMARY (REC_BAT_LOW U19.7) is diagnosed exactly and shown REDUCIBLE-in-principle (it escaped cleanly in 003O; direction-2's +2-connection congestion swapped VREC_VCC U19.8's pad-escape onto the F lane U19.7 needed); the governing ~22-min full gate cannot run foreground under the ACP 10-min cap, so 003U delivers a precise CTO handoff (exact lever design + ready-to-run full-authority command); no source/copper/placement/rule change, no DRC absorbed, no promotion, autonomy CONTINUES, D-275 and D-277..D-294 preserved

**A GOVERNED CHARACTERIZATION / NO-PROGRESS + HANDOFF MILESTONE — AUTONOMY CONTINUES (a normal Phase-A FAIL is not a stop reason; no owner decision is raised).** Starting HEAD `36662db` (clean; `phaseA_journal.json` at HEAD). D-294 defined FBV2-P2-003U as a bounded full-context reservation/ordering corridor study of the two 003T walls at the D-293 direction-2 placement (`t_a_r77e15n10_r79e15n10`): PRIMARY reserve `REC_BAT_LOW U19.7`'s escape before its neighbors / re-route the six blocking tracks; SECONDARY study the U18.8/U18.9 I2 reserve-via siting/ordering — no DRU change, no D-290 reauth, no via below the D-257 ladder, no D-269/topology change — judged only by the full authority gate.

**THE BINDING CONSTRAINT.** Full Phase-A runs take ~1300–1780 s (003T = 1313.8 s); the ACP exec wrapper caps a single call at 10 min and 003U bars `&`/`nohup`/detached/tracked jobs / `Monitor` / scheduled wakeups (foreground-only). The governing gate cannot run inside this task, so — exactly as the 003U discipline anticipates — the cheap bounded characterization is done and a precise ready-to-run handoff is delivered instead of an orphaned long run.

**DECISIVE CHEAP EVIDENCE (connected-set diff 003O→003T, no new long run).** Diffing the committed `checks/phaseA_003o_b1_r75rot_cto.json` (conn 67) against gitignored scratch `checks/w/phaseA_003t_full_e15n10cto.json` (conn 69) at U19: in **003O all seven U19 pins escaped**, including `REC_BAT_LOW U19.7→Q7.1` (F.Cu 14.907 mm). Direction-2 moves nothing near U19 (U19 @ 2.695,28.255,0°; Q7/R93 unmoved), so the escape GEOMETRY is identical — the wall is not geometric. The +2-connection congestion **swapped `VREC_VCC`'s two segments' layers**: `U19.8→C60.1` went **B.Cu(0 via) → F.Cu(2 via)** and `C60.1→R84.2` went F → B, so U19.8's pad-escape now occupies the F lane immediately south of U19.7 that carried U19.7→Q7.1 in 003O (`U19.8` ×26 is duly the dominant blocker, with U19.6 ×13, U19.5 ×7, track ×6). U19.7 is then a **greedy-tightest-first casualty**: the driver already re-measures `order_tight` before every fine-pitch pin (`route_battery_block.py:2169-2181`, PR-32), so this is NOT a stale-slack-table bug — U19.7 is loose early (neighbors unrouted) so it sorts LATE, its neighbors consume its lane, and it is re-measured with no legal escape when its turn comes; `REC_BAT_LOW` then routes `Q7.1→R93.1` first and U19.7 falls to the closure stage as `U19.7→(node)`, which the D-278 inner hop cannot rescue because that hook is guarded `and not node` (`:1039`). **A reducible, ordering-class wall — NOT a D-289/290/292-class placement mutual-exclusion.**

**VACUITY PROVEN, not assumed.** `AQROOT_LOCAL=DEADCELL` (~2 min) omits the west prefix / BAT_RAW divider field whose +2-connection congestion IS the cause and is placement-independent (same result at home/003O/003T), so it structurally cannot reproduce the direction-2 box; `LOCAL=U19` reproduces the emergent dead-cell blockers but lays the whole prefix (~15–20 min, over the 10-min cap); `R80`/`D256` never route U19. So no sub-10-min vehicle faithfully judges the U19.7 lever. For the SECONDARY, the 003T `R80` focused screen reported the exact failing candidate as conn 20 `fail=None` **U18.8 JOIN ok** — vacuous.

**SECONDARY (U18.8 I2 join corridor).** At U18 north +1.25 both inner reserve vias place on I2 (003T journal steps 5/6 `RESERVE_PAIR` ok) and **U18.9 JOINs** (step 26), but `U18.8→R75.2` JOIN FAILs `NO_PATH` ("no I2 corridor at 0.200 mm between the two reserved vias") → fallback `NO_VIA_SITE`. Measured reserve vias on the routed board: `BAT_PROTECTED_P` 0.35/0.20 at (2.8,66.8)&(7.2,66.5), `BAT_SENSE` 0.35/0.20 at (4.25,63.5)&(4.6,66.0); nearest reserve-via pair ≈1.97 mm apart, so the failure is a full-congestion I2 corridor pinch (the join track cannot thread a ≥0.200 mm lane), not touching vias. Bounded lever: reserve-via siting/ordering on I2 within D-257/D-266 mechanics — full-gate-only to judge.

**VERDICT / HANDOFF.** Both walls are BOUNDED full-context routing/ordering casualties (no floor relaxed, no frozen part moved, D-290 untouched, D-269 enforced at 0.300 mm); the PRIMARY is reducible-in-principle with an exact mechanism and a bounded escape-reservation lever, the SECONDARY is a reserve-via-siting question — but neither is judgeable by any cheap vehicle at the direction-2 placement and the governing ~22-min gate cannot run foreground here. Per D-286 no proxy promotes copper → **no promotion**; a governed CTO characterization / NO-PROGRESS + HANDOFF, NOT an owner decision (direction-2 remains authorized and is not exhausted); stop file ABSENT, autonomy CONTINUES. **FBV2-P2-003V** implements ONE narrowly-scoped, env-gated (OFF by default) bounded lever (PRIMARY: reserve U19.7's escape before its neighbors in the reserve_escape family, and/or relax the D-278 `and not node` guard for the U19 group, and/or hold `VREC_VCC U19.8` on B.Cu; SECONDARY: re-site/re-order the U18.8/U18.9 I2 reserve vias), validates it against `router_regression.py` (authoritative byte-identical), then runs the FULL authority gate `bash w/run_003t_full.sh 003v_u19resv w/cand_003t/t_a_r77e15n10_r79e15n10.json` (lever env set; back up/restore the shared `phaseA_journal.json` around it), judged by the full-run connected-set diff vs `phaseA_003o_b1_r75rot_cto.json` and `w/phaseA_003t_full_e15n10cto.json`; promote copper only on a genuine full-authority PASS.

**INTEGRITY.** No source/copper/placement/rule change survives (`git diff --stat HEAD` empty for all driver source); authoritative PCB byte-identical to HEAD (`sha256 2235e273…d642d7e`; six layers, 0 tracks, 0 vias, placement at home); no DRC absorbed (the U18.8 open, U19.7 no-escape and lone scratch `via_dangling:1` are surfaced FAIL evidence on gitignored scratch, never in the authoritative board); no promotion; `place_003l` (D-285) and the D-275/D-288 bridge preserved; D-275 and D-277..D-294 preserved; frozen `beta-full-reference-v1` untouched; `phaseA_journal.json` at HEAD; `JLCPCB_READINESS` unchanged; 0.200 mm / 0.25 mm / 0.300 mm D-269 / ≥1.20 mm BPP / 0.60 mm BAT_MAIN floors ENFORCED, D-290 closed. Full analysis: [`audits/2026-08-30-p2-003u-d295-two-walls-full-run-emergent-ordering-cheap-vacuous-handoff.md`](audits/2026-08-30-p2-003u-d295-two-walls-full-run-emergent-ordering-cheap-vacuous-handoff.md). **NO PROGRESS EARNED: PCB routing 0 %, overall 74 %, readiness ~77 %.**

---

## 2026-08-30 - FBV2-P2-003T: D-294 direction 2 (D-293) executed — a focused minimum candidate genuinely exists, but the governing full authority gate FAILs, so no candidate is promotable; direction-2 is productive (+2 connections vs 003O, the old REF_POL R87.2 wall is now past) but incomplete (U18.8 still open on the full-context I2 join corridor; a NEW governing wall surfaces at REC_BAT_LOW U19.7 NO_LEGAL_ESCAPE); no source/copper/placement/rule change, no DRC absorbed, no promotion, autonomy CONTINUES, D-275 and D-277..D-293 preserved

**A GOVERNED EVIDENCE / NO-PROGRESS MILESTONE — AUTONOMY CONTINUES (a normal Phase-A FAIL is not a stop reason; no owner decision is raised).** Starting HEAD `9c708f3` (clean; `phaseA_journal.json` at HEAD). D-293 (Alpha, 2026-08-29 22:34 UTC) authorized **direction 2**: relocate the minimum necessary escape targets so `BAT_RAW` (U18.1 east) and `BAT_PROTECTED_P` (U18.8 west) — the two opposite-edge current-path nets D-292 identified — leave U18 through independent corridors, with every floor preserved and D-290 closed. 003T executed exactly that: a cheap focused screen, then a **full CTO-authority** run (the CTO completed the decisive run directly after ACP-wrapper failures).

- **The focused minimum exists.** A bounded candidate grid was screened on a cheap focused vehicle. East-only moves leave the east `LTC_OV U18.3→R77.2` current pin gate-rejected (`e10`/`e20` → clearance 6; the window is narrow — too small keeps the corridor tight, too large re-breaches), north-only (`n125`) breaches `LTC_UV U18.2→R79.2` (clearance 1), and R80/R81-north (`t_b`) leaves `LTC_UV` NO_LEGAL_ESCAPE. **Exactly one** combined move — `t_a_r77e15n10_r79e15n10` (R77/R79 **+1.5 mm east +1.0 mm north**, U18 north **+1.25 mm**) — clears every east **and** west U18 pin with **zero added DRC**: focused **conn 20, `fail=None`, U18.8 JOIN ok and U18.9 JOIN ok** (`checks/w/phaseA_003t_t_a_r77e15n10_r79e15n10.json`). This is the focused minimum direction-2 candidate, and the one the CTO advanced to the full gate.

- **The governing full gate FAILs** (`checks/w/phaseA_003t_full_e15n10cto.json`, secs 1313.8): PHASE A **FAIL** at **`REC_BAT_LOW U19.7→(node) NO_LEGAL_ESCAPE`** (blocked by U19.8 ×26, U19.6 ×13, U19.5 ×7, track ×6); **conn 69, skipped 98, ratsnest 781→708 (−73)**. U18.9 JOINED (In2 Kelvin) but **U18.8 stayed OPEN** — `R75.2` join `NO_PATH` (no I2 corridor at 0.200 mm **between the two reserved vias**: the U18.9-Kelvin and U18.8-`BAT_PROTECTED_P` reserve vias pinch the join corridor under full congestion), then fallback `NO_VIA_SITE` (no 0.65 mm B via site). Final DRC `{hole_clearance:5, lib_footprint_issues:199, solder_mask_bridge:1, track_width:1, unconnected_items:499, via_dangling:1}` — the residual scratch dangling is SURFACED, not absorbed.

- **Direction-2 is productive but incomplete.** vs the committed 003O baseline (`checks/phaseA_003o_b1_r75rot_cto.json`: conn 67, skip 99, rats 708/−73, FAIL `REF_POL R87.2→(node) NO_PATH`), direction-2 routed the independent `BAT_RAW` east corridor (U18.1/U18.2/U18.3 all connect), gained **+2 connections (67→69)** and moved the terminal wall **past `REF_POL R87.2`** to a new `U19.7` escape wall — but U18.8 is still one trunk pad short.

- **D-293 verdict.** The focused closure is **vacuous vs the congested full run** (the governing gate) — the full context adds the I2 reserve-via pinch and the new U19.7 wall the cheap vehicle cannot see; a candidate that closes only in the focused vehicle is NOT promotable (D-286: no proxy promotes copper). **No 003T candidate passes the full authority gate → no promotion.** A governed CTO **FAIL**, NOT an owner decision (direction-2 was authorized, remains valid, and is not exhausted; the two walls are bounded full-context routing/ordering walls with no floor relaxed and no frozen part moved); `/home/aqroot8/.aqroot-autopilot-stop` stays **ABSENT** and autonomy CONTINUES.

- **Integrity.** No source, copper, placement or rule change; authoritative PCB **byte-identical to HEAD** (`sha256 2235e273…d642d7e`; six layers, 0 signal tracks, 0 signal vias, 0 arcs, placement at home); **no DRC absorbed** (the U18.8 open, the U19.7 no-escape, and the lone scratch `via_dangling` are the surfaced FAIL evidence, never in the authoritative board); `place_003l` (D-285) and the D-275/D-288 bridge preserved; D-275 and D-277..D-293 preserved; 0.200 mm clearance + 0.25 mm hole-to-hole + 0.300 mm D-269 current-path + ≥1.20 mm BPP trunk + 0.60 mm BAT_MAIN floors ENFORCED; frozen `beta-full-reference-v1` untouched; `phaseA_journal.json` at HEAD; `JLCPCB_READINESS` unchanged. Scratch evidence gitignored under `checks/w/` (`phaseA_003t_full_e15n10cto.json`, `FULL003T_e15n10cto/`, `phaseA_003t_t_*.json`, `log_003t_*.txt`, `Q003T_*/`, `cand_003t/`, `mkcands_003t.py`, `batch_003t.sh`). **NO PROGRESS EARNED: PCB routing 0 %, overall 74 %, readiness ~77 %.** **NEXT: FBV2-P2-003U** — a bounded full-context reservation-and-ordering corridor study of the two named walls at the D-293 placement: (1, PRIMARY) reserve `REC_BAT_LOW U19.7`'s escape before its neighbor pins U19.8/U19.5 and/or re-route the six blocking tracks (escape-ordering, no DRU change); (2, SECONDARY) study the U18.8/U18.9 I2 reserve-via siting/ordering to open a ≥0.200 mm join corridor within D-257/D-266 mechanics — without re-authorizing D-290, dropping any via below the D-257 ladder, weakening D-269, or changing topology/footprint/outline. Full analysis: [`audits/2026-08-30-p2-003t-d294-direction2-full-gate-fail-u18-corridor-u19-escape.md`](audits/2026-08-30-p2-003t-d294-direction2-full-gate-fail-u18-corridor-u19-escape.md).

## 2026-08-29 - FBV2-P2-003S: D-292 the owner-approved bounded LTC4368/R75 placement micro-ECO (D-291) is screened to EXHAUSTION — no bounded U18/R75 placement LEGALLY co-closes the U18 escape field; the wall is sharper than D-290 (U18 carries a current-path net on BOTH edges — BAT_PROTECTED_P/U18.8 west and BAT_RAW/U18.1 east — at a rigid 0.5 mm pitch, so a rigid move only trades which edge breaches the 0.300 mm D-269 floor); closing BAT_PROTECTED_P re-escalates to a genuine OWNER decision; no source/copper/placement/rule change, no DRC absorbed, no promotion, D-275 and D-277..D-291 preserved

**A GOVERNED EVIDENCE / NO-PROGRESS MILESTONE THAT RE-RAISES ONE OWNER DECISION.** Starting HEAD `951d7bf`. D-291 (Alpha) approved a bounded D-284/285-class LTC4368/R75 placement micro-ECO to open a *second, independent* U18.8 escape and co-close U18.7/U18.8/U18.9, with engineering proof a separate CTO gate. 003S is that gate: a cheap, in-scope placement screen with the explicit charter to **stop at exact-evidence exhaustion rather than broaden scope**.

- **The vehicle.** Candidates were built and bare-screened at the D-286 pre-copper boundary (`w/screen_003s.py`: real `kicad-cli` DRC + real `qb.escape` vs the `place_003l` clean reference), then co-closure-tested on **`AQROOT_LOCAL=R80`** — the narrower west-margin prefix (U18 8-pin field + D-266 Kelvin reservations + trunk + BAT_MAIN + BAT_RAW bridges; skips the east taps/gauge), validated **byte-identical to `D256` on the U18.7/8/9 verdict** and ~2.7× faster (≈350 s vs ≈915 s here). Baseline `b1_r75rot` = **conn 19, DRC clean, U18.8 the sole open pad** (the D-290 clash reproduced faithfully).

- **R75 is boxed on all four sides** (measured, `w/region_003s.py`): frozen **Q3** (BAT_SENSE current path) north edge y=59.575 leaves R75 ≈0.55 mm of southern travel before the 0.200 mm floor; board edge west (pad at x=2.188); U18 courtyard east (an R75 east move bare-overlaps/shorts — `s_r75e`/`s_r75e_n075` REJECT); R80/R81 north. U18 has ≈2.7 mm north headroom (to R80) and ≈1 mm south (to R77); west/south translations bare-overlap R75/R77 courtyards (`s_w05`/`s_s05` REJECT).

- **The screen (every candidate ≤ conn 19; baseline U18.8-open is the max LEGAL state).** EAST translation (`s_e05/e10/e15`) = conn 19, U18.8 stays open (never nears the fixed R75.2 — invariant); R75-south-alone (`s_r75smax`) = conn 19, U18.8 open (neutral); NORTH raises U18.8 toward R75.2 and **does open a legal inner-I2 via for U18.8** (the sought "second escape" genuinely exists) but the same move breaks the OTHER edge — `s_n05/n075` conn 18 (**U18.7** GATE_REJECTED 0.25<0.30, the exact D-290 arithmetic relocated), `s_n10` conn 17, `s_n125` conn 17 (**all 5 west close** but **east U18.1/U18.2/U18.3** GATE_REJECTED 0.275/0.284/0.296 < 0.300); the R75-south+U18-north align (`s_align/alignB/alignC`) conn 17-18 (breaks the **U18.9 Kelvin** or U18.1/U18.7). **The one candidate to reach PHASE A COMPLETE (`s_ne0707`, U18 NE +0.75/+0.75) does so ONLY by absorbing a genuine 0.1248 mm `BAT_RAW`↔`BAT_PROTECTED_P` D-269 breach (41 % of the 0.300 mm floor)** — DISQUALIFIED per the 003S reject criteria (sub-floor clearance) and D-286 no-absorption; no full Phase-A run is warranted (the congested full run is *less* forgiving than the cheap vehicle).

- **Root cause, sharper than D-290.** D-290 proved the west three-into-one-corner at fixed placement; 003S proves the owner-approved placement lever cannot resolve it because **U18 (LTC4368, MSOP-10) carries a current-path net on BOTH edges** — `BAT_PROTECTED_P` (U18.8, west) and `BAT_RAW` (U18.1, east) — and its 0.5 mm pitch is rigid on each, so a rigid translation only re-selects which edge's 0.300 mm D-269 clearance breaks; R75 (boxed) cannot help without breaking the Kelvin.

- **Why it re-raises an OWNER decision.** The remaining levers all fall OUTSIDE the D-291 envelope: U18 rotation (relocates the trunk pad off the west edge = a western-block refloorplan/direction-2, risks the frozen D-275/D-288 bridge); moving the escape targets R77/R79/R80/R81 (outside U18/R75 scope); or re-authorizing the D-290-refuted+retired off-layer vacate routing lever (a driver change re-opening a closed CTO decision). The charter instructed stopping at exhaustion, so this is a governed CTO **FAIL** that re-raises the OWNER decision; `/home/aqroot8/.aqroot-autopilot-stop` is re-created (OWNER_DECISION) and autonomy is HALTED.

- **Integrity.** No source, copper, placement or rule change survives; authoritative PCB byte-identical (six layers, 0 tracks, 0 vias); **no DRC absorbed into the authoritative board** (the lone `s_ne0707` absorption is the disqualifier on throwaway scratch, explicitly rejected). `place_003l` (D-285) preserved; D-275 and D-277..D-291 preserved; 0.200 mm clearance + 0.25 mm hole-to-hole + 0.300 mm D-269 current-path + ≥1.20 mm BPP trunk + 0.60 mm BAT_MAIN floors ENFORCED; frozen `beta-full-reference-v1` untouched; `phaseA_journal.json` restored to HEAD; `JLCPCB_READINESS` unchanged. Scratch evidence gitignored under `checks/w/` (`cand_003s/`, `screen_003s_results.json`, `phaseA_003s_*.json`, `log_003s_*.txt`, `drc_ne0707_check.json`). **NO PROGRESS EARNED: PCB routing 0 %, overall 74 %, readiness ~77 %.** **NEXT: OWNER DECISION** — (C) direction-2 spread/relocate-target; (D) re-authorize a routing lever (re-litigating D-290); or (B) accept U18.8 open (not fabricable). Full analysis: [`audits/2026-08-29-p2-003s-d292-u18-r75-placement-microeco-exhausted.md`](audits/2026-08-29-p2-003s-d292-u18-r75-placement-microeco-exhausted.md).

## 2026-08-29 - OWNER DECISION D-291: bounded LTC4368/R75 placement micro-ECO approved

Alpha ratified the CTO-recommended option A at 19:27 UTC: authorize the bounded D-284/285-class LTC4368/R75 placement micro-ECO required by FBV2-P2-003R / D-290 to open a second independent U18.8 escape. Approval is deliberately narrow: all safety/routing/clearance floors, topology, six-layer stack, frozen reference, and D-275/D-277..D-290 remain locked; no direction-2 widening, broad refloorplan, DRU relaxation, or open-U18.8 acceptance is authorized. No engineering result or progress/readiness increase is claimed by this decision record. **NEXT: FBV2-P2-003S** from clean `a6da795`: bounded placement screen, then full Phase-A integration of the first valid candidate.

## 2026-08-29 - FBV2-P2-003R: D-290 the LAST bounded routing-only U18 co-closure lever (off-layer vacate of U18.7) is REFUTED on cheap non-vacuous evidence (−1 regression, conn 34 vs baseline 35), the refutation is geometric and exact (the U18.7/U18.8/U18.9 3-into-one-corner contention is an irreducible placement-geometry mutual-exclusion at the 0.5 mm pad pitch vs the 0.300 mm current-path clearance floor — the vacate moves U18.7's escape transition from a 0.15 mm B.Cu neck 0.250 mm from U18.8's reserve via to a 0.35 mm through via 0.150 mm from it, CLOSER not farther, so In2 and In3 both revert; U18.9 is an independent casualty), so a bounded LTC4368/R75 placement micro-ECO is now a genuine OWNER DECISION; the D-290 WIP is retired, no source/copper/placement/rule change, D-275 and D-277..D-289 preserved

**A GOVERNED EVIDENCE / NO-PROGRESS MILESTONE THAT RAISES ONE OWNER DECISION.** Starting HEAD `9bd7aac`. D-289 named exactly one bounded routing-only lever left to co-close U18.7/U18.8/U18.9: vacate the contended pin (U18.7 → R81.2) off the single shared B lane onto an inner layer so U18.8 can reserve the corner alone. 003R implemented it (the D-290 WIP: `AQROOT_VACATE=U18_7` forcing U18.7 onto In2/In3 via a 0.35/0.20 through via FIRST, coupled with `AQROOT_U18_FIRST=1` reserving U18.8 alone) and screened it on the cheap non-vacuous `AQROOT_LOCAL=D256` west-prefix vehicle. **Metrics (verified from the committed JSONs):** baseline `phaseA_003r_baseline.json` conn **35** (U18.7 CLOSED B.Cu 9.728 mm / U18.9 CLOSED In2 north hop / U18.8 OPEN `NO_VIA_SITE`); lever `phaseA_003r_lever.json` (both `AQROOT_VACATE`/`AQROOT_U18_FIRST` in the log env) conn **34** — U18.8 closes but **U18.7 GATE_REJECTED** 0.250<0.300 (D-269) and **U18.9 NO_LEGAL_ESCAPE** (blocked by U18.10 ×25 / U18.7 ×17 / track ×15); identical final DRC (`{hole_clearance:5, lib_footprint_issues:199, solder_mask_bridge:1, track_width:1, unconnected_items:499}`), violation surfaced-and-reverted. **The vacate genuinely fired** (`VACATE_SETS['U18_7']` key matches `battery_route_plan.py:95`, `node=False`; `connect_hop(far='I2')` then `far='I3')` both reverted) **and is geometrically refuted, not "one implementation failed":** on the positive baseline board In1/In4 are the plane layers and In2/In3 are free signal layers (In3 empty in the corridor) and control nets were never barred from the inner layers — so no plane and no rule bars the hop; the blocker is the **pad-exit zone** at the fixed 0.5 mm pad pitch, where U18.8 sits BETWEEN U18.7's south escape and U18.9's north escape and every escape must exit within 0.5 mm of the adjacent pin's committed copper. Arithmetic: U18.7 neck(0.15)↔U18.8 reserve-via(0.35)=**0.250 mm** (== the measured DRC, FAIL vs the 0.300 mm floor); U18.7 vacate-via(0.35)↔U18.8 reserve-via(0.35)=**0.150 mm** (WORSE — why In2/In3 revert). A via ≤0.25 mm reaches 0.300 (== floor, zero margin) and two adjacent vias need sub-0.20 mm (below the D-257 ladder = a DRU change, BARRED; and the reserve via "answers a via-geometry question only … never [dropped] to buy a corridor a legal width could not have"), and none reopens U18.9 (dominant blocker U18.10, untouched). Ordering (D-289), off-layer vacate (D-290) and via-size are all refuted or barred — **no concrete legal routing-only site exists.** **This fires the standing policy trigger** (CURRENT_STATE §5/§8, D-289): a genuine OWNER DECISION — a bounded LTC4368/R75 placement micro-ECO (D-284/285 class) to open a *second* U18.8 escape, or direction-2 corridor widening — arises only if 003R also fails to co-close the three pins without relaxing a floor/rule or moving a frozen part. 003R failed exactly that way, so `/home/aqroot8/.aqroot-autopilot-stop` is now **PRESENT (OWNER_DECISION)** and autonomy is HALTED. The D-290 WIP is retired (reverted `battery_route_plan.py`, `route_battery_block.py`, `phaseA_journal.json`); committed evidence of record `checks/phaseA_003r_baseline.json` + `checks/phaseA_003r_lever.json`; scratch gitignored. No copper/placement/rule change; no DRC absorbed; `c3_00` not promoted; `place_003l` (D-285) preserved; D-275 and D-277..D-289 preserved; frozen `beta-full-reference-v1` untouched; `.aqroot-progress.env` NOT edited; readiness ~77 %, routing 0 %, overall 74 % unchanged. **NEXT: OWNER DECISION** — authorize (A, CTO-recommended) a bounded LTC4368/R75 placement micro-ECO to open a second independent U18.8 escape; or (B) accept U18.8 open (not fabricable); or (C) direction-2 widening / broader refloorplan. Full analysis: [`audits/2026-08-29-p2-003r-d290-off-layer-vacate-refuted-owner-decision.md`](audits/2026-08-29-p2-003r-d290-off-layer-vacate-refuted-owner-decision.md).

## 2026-08-29 - FBV2-P2-003Q: D-289 the rejected 003P WIP is retired with NO PROGRESS (independently verified byte-aggregate-equivalent to 003O, a lateral U18.7↔U18.8 swap), and the bounded U18.7/U18.8 co-closure lever (reservation ordering) is REFUTED on cheap non-vacuous evidence — reserving U18.8 first trades 1 casualty for 2 (U18.8 closes but U18.7 and U18.9 both open, −1 connection), because U18.8→R75.2 must escape NORTH into U18.7's single B lane with no alternative B via-site (a 3-into-one-corner placement-geometry mutual-exclusion, not an ordering defect); the terminal REF_POL R87.2 wall is characterized on the actual congested board as F.Cu routing capacity (N_POL 6.36 mm F.Cu saturates the R87.2→node corridor) with a named narrowest lawful lever (D-279-class N_POL F.Cu inner offload, not a DRU exception, no closure claimed); no source/copper/placement/rule change, D-275 and D-277..D-288 preserved

**A GOVERNED EVIDENCE / NO-PROGRESS MILESTONE.** The persistent CTO rejected the uncommitted 003P patch set (informal labels D-289/D-290/D-291 — never committed, now VOID). 003Q independently verified that rejection (003P's natural full run is byte-aggregate-equivalent to committed 003O: conn 67, skipped 99, ratsnest 708/−73, identical final DRC, identical terminal `REF_POL R87.2→(node) NO_PATH @ 0.150 mm`; the sense-pair-clearance change is a lateral U18.7↔U18.8 swap; the divider-tap-width change fires on other-branch copper / a true NO_PATH; the test-via change cured only a focused-vehicle artifact), cleanly retired it (5 tracked reverts + 6 untracked removals; tree clean at `bc1088d`), then continued with the next bounded CTO task. Task 2 (reserve U18.8 before U18.9, no clearance/geometry relaxation) is REFUTED on a cheap non-vacuous `AQROOT_LOCAL=D256` west-prefix screen: baseline (U18.9-first) conn 35 with U18.7✓/U18.9✓/U18.8-open; reorder (U18.8-first) conn 34 with U18.8✓ but U18.7 gate-rejected (0.25 mm < 0.30 mm D-269 clearance vs U18.8's north reservation) and U18.9 no-legal-escape — root cause is placement geometry (U18.8→R75.2 escapes NORTH into U18.7's only lane; no alternative B via-site), so ordering only selects the casualty. Task 3 characterized the terminal REF_POL R87.2→node wall on the actual congested 003O board (`w/refpol_wall_003q.py`): the node `{TP24.1,U19.2,R88.1}` is closed, R87.2 is isolated, and its F.Cu corridor is saturated by N_POL 6.36 mm + VREF_TOP 1.45 mm — an F.Cu routing-capacity wall, not a DRU rule; narrowest lawful lever is a D-279-class inner offload of the N_POL F.Cu run (D-279 today reverts only B.Cu detours), validated only on a full run. Committed D-289 supersedes the VOID informal 003P labels. NO source, copper, placement, or rule change; `.aqroot-progress.env` not edited; readiness ~77 %, routing 0 %, overall 74 % — all unchanged. Next: FBV2-P2-003R (off-layer vacate of U18.7 + reserve U18.8 first to co-close U18.7/U18.8/U18.9; extend the D-279 offload to the N_POL F.Cu run to open the REF_POL R87.2 corridor). Full analysis: [`audits/2026-08-29-p2-003q-d289-003p-rejection-and-u18-co-closure-refuted.md`](audits/2026-08-29-p2-003q-d289-003p-rejection-and-u18-co-closure-refuted.md).

## 2026-08-29 - FBV2-P2-003O: D-288 the D-275 south-bridge ENTRY-array two-layer tie is FIXED (rotation-aware in-pad POFV scan + a symmetric B.Cu tie-stub make the entry vias `via_dangling`-clean), proven by a non-vacuous regression (legacy off-pad array +4 dangling / fixed 0 dangling / no absorption) AND a natural-completion CTO full run (DRIVER_EXIT=0, no dangling cascade) - but the overall Phase-A run still FAILs on genuinely NEW downstream blockers (U18.8 BAT_PROTECTED_P escape NO_VIA_SITE + a terminal REF_POL/R87 F-corridor NO_PATH + BAT_RAW divider width vs BAT_MAIN); the bridge-code fix + regression are ACCEPTED/COMMITTED, no routing/overall progress, no readiness change, no promotion, D-275 and D-277..D-287 preserved

**A SUCCESSFUL BRIDGE-IMPLEMENTATION FIX IS DISTINCT FROM AN OVERALL PHASE-A PASS.** 003O closed the exact D-287 lever - the entry array that dangled on one layer - and the natural CTO full run proves it end-to-end (the D-287 `via_dangling` cascade is GONE, the south bridge now passes BOTH geometrically AND electrically, and the `BAT_PROTECTED_P` island closes R75.2 through seven pads). But the full run still FAILs, now on new, downstream, genuinely-different blockers the entry dangling had shadowed. No copper and no placement are promoted.

- **The fix (minimal, two parts, both in the bridge code).** (1) Root cause in `bridge_route_003c.scan_entry_sites`: it windowed on R75.2's UNROTATED `hx/hy` and sorted "south-first", so for the -90 deg-rotated R75 pad it scanned a tall-narrow box and actually picked the NORTHERNMOST sites - ~0.5-1.15 mm NORTH of the real B.Cu pad copper, over bare substrate (the D-287 dangle). New `_in_pad()` transforms each candidate into the pad's OWN rotated frame and requires the centre inside the pad rectangle inset by `IN_PAD_MARGIN=0.20 mm`; the scan walks the rotation-aware AABB and sorts CENTRE-OUT, so every entry via barrel genuinely overlaps R75.2's B.Cu pad (`point_free`/`hole_clear` unchanged). (2) `stage_bridge`/`bridge_early_003i.apply_early` now lay an explicit B.Cu tie-stub from each entry via to R75.2's pad centre (`qb.track(NET,'B',...,W_LAND)`) - the exact mirror of the exit array's `_lay_landing` stub - so each entry via is tied on TWO layers.

- **The D-288 regression is NON-VACUOUS (`screen_003n.py --bridge --validate`, exit 0).** NEGATIVE control reproduces the D-287 asymmetric array (4 vias at the MEASURED off-pad `LEGACY_ENTRY_SITES` + F.Cu bus, no B.Cu stub) and MUST dangle - measured **`via_dangling +4`** (KiCad's connectivity test genuinely catches the defect, so the fix cannot pass vacuously). POSITIVE control (the real fixed bridge) is CONNECTED, **`via_dangling == 0`, entry 4, exit 4, ywest 82.4, traverse 1.30 mm**. NO-ABSORPTION: the fixed bridge adds ZERO new hard-class DRC vs the identical no-bridge placed board. This replaces the D-287 dangling-control `--validate`.

- **The natural-completion CTO full run (`b1_r75rot`, `place_003l` + `AQROOT_BRIDGE_EARLY/SOUTH`, `DRIVER_EXIT=0`, secs 1776.5).** Evidence of record (pinned, committed): `checks/phaseA_003o_b1_r75rot_cto.json`; scratch log `w/log_003o_b1_r75rot_cto.txt` (gitignored). PHASE A **FAIL**; connections **67**, skipped-already-connected **99**, ratsnest **781 -> 708 (-73)**. The early south bridge now passes BOTH geometrically AND electrically - `land C36.1`, traverse **70.925 mm @ 1.30 mm**, **entry 4 @ y=67.95 GENUINELY INSIDE the rotated R75.2 pad** (bbox y in [67.35,68.58]), exit 4, disjoint `ywest 82.40`, `bridge_eco null` - and there is **NO `via_dangling` cascade** anywhere (the D-287 20-gate poisoning is gone; the fix holds at full-run scale). The `BAT_PROTECTED_P` island CLOSES **R75.2 through C36/C25/C58/D9/U11/U14/TP15**.

- **The NEW blockers (attributed, NOT absorbed).** (1) **`U18.8` remains OPEN** - its reservation was `GATE_REJECTED` on `clearance +1` (`rule 'BAT_MAIN routed clearance'`), then the main pass reports **`NO_VIA_SITE`** ("no via site of 0.65 mm reachable on B"; pass-2 "no 0.35 mm via site reachable on B") - so `BAT_PROTECTED_P` is NOT fully closed across all required pads (U18.8 is the one open trunk pad). (2) Terminal fail = **`REF_POL R87.2->(node)` NO_PATH - no F corridor at 0.150 mm** (also `R88.1->R87.2` NO_PATH). (3) **`BAT_RAW R89.1->(node)` NO_PATH at 0.600 mm** and **`R86.2`** walks the ladder 1.00->0.20 mm then `GATE_REJECTED` on **`track_width +4`** because four 0.20 mm BAT_RAW divider taps breach the `BAT_MAIN minimum width` 0.60 mm rule (a rule-conformance reject; the final board carries no such delta).

- **Final DRC (re-verified with `kicad-cli pcb drc --severity-all` on the final scratch board).** `{hole_clearance:5, lib_footprint_issues:199, solder_mask_bridge:1, track_width:1, unconnected_items:499}` - reproduces the JSON exactly. **The single `track_width` item, truthfully:** a `BAT_PROTECTED_P` track on B.Cu, length **2.4749 mm @ (65.5, 76.05), actual 0.2000 mm**, violating rule **`BAT_PROTECTED_P high-current trunk width - D-249` (min 1.2000 mm)** - one thin 0.20 mm SENSE/Kelvin sub-branch of the high-current trunk net (a bounded sense tap), a genuine-but-benign copper item SURFACED not absorbed (same class as the lone `track_width +1` D-286 surfaced), NOT a fabrication blocker. Bounded stub exceptions present (`BAT_RAW_DIVIDER_TAP_1/2/3` 0.2 mm D-269, `BAT_STUB_3` BAT_PROTECTED_P 1.0 mm, `BAT_STUB_4` BAT_SENSE 0.2 mm).

- **Why NOT an owner decision.** The new blockers are BOUNDED technical work, not a placement wall and not un-fixable without relaxing a floor or moving a frozen part; direction-2 (broad LTC4368 refloorplan / corridor widening, OWNER/mechanical) is NOT the sole remaining option; `/home/aqroot8/.aqroot-autopilot-stop` stays ABSENT; open owner decisions remain NONE.

- **Cleanliness.** Source changes only in the bridge code / regression: `bridge_route_003c.py` (rotation-aware in-pad `scan_entry_sites` + entry B.Cu tie-stub), `bridge_early_003i.py` (entry B.Cu tie-stub in `apply_early`), `screen_003n.py` (D-288 `entry_tie_regression`). No driver/router/DRU/footprint/netclass/rule mutated; no rule/floor relaxed (0.200 mm clearance + 0.25 mm hole-to-hole + >=1.20 mm BPP trunk + 0.60 mm BAT_MAIN ENFORCED); no DRC absorbed (U18.8 `NO_VIA_SITE`, the REF_POL NO_PATH, and the BAT_RAW `track_width +4` are the FAIL/reject reasons). `c3_00` not promoted; `place_003l` (D-285) preserved and clean; optional `BAT_SENSE TP20.1` separate; frozen `beta-full-reference-v1` untouched; `JLCPCB_READINESS` unchanged. Authoritative PCB UNCHANGED (six layers, 0 tracks, 0 vias, placement at home); `phaseA_journal.json` restored to HEAD. Regressions GREEN: `screen_003n.py --bridge --validate` (negative +4 / positive 0 / no-absorption); the focused D-288 regression and router regression G1-G12 passed in the prior work. **NO PROGRESS EARNED: PCB routing stays 0 %, overall stays 74 %, readiness ~77 %.** Full analysis: [`audits/2026-08-29-p2-003o-d288-entry-tie-fix-and-full-run.md`](audits/2026-08-29-p2-003o-d288-entry-tie-fix-and-full-run.md). **Next: FBV2-P2-003P - (1) close U18.8's BAT_PROTECTED_P escape (a legal B-layer via site + reservation past the BAT_MAIN routed-clearance reject) to fully close the trunk; (2) investigate/close the terminal REF_POL R87.2 / R88.1->R87.2 F-corridor NO_PATH at 0.150 mm; (3) attribute the BAT_RAW R89.1/R86.2 divider-tap width vs the BAT_MAIN 0.60 mm rule - all with NO floor/rule relaxation and NO frozen-part move.**

## 2026-08-29 - FBV2-P2-003N: D-287 the full bounded direction-1 placement screen is EXHAUSTED (27/27) - only three candidates pass the D-286 zero-copper hard gates, and a cheap CTO-authorized bridge-connectivity probe REFUTES all three at the SAME genuine electrical fault: the D-275 south-bridge ENTRY array (R75.2 POFV) is bussed on F.Cu with NO symmetric B.Cu tie-stub, so its vias dangle on one layer regardless of placement - a BRIDGE-IMPLEMENTATION defect independent of placement (a narrower CTO lever), NOT a placement wall; direction-2 is NOT yet the sole option, so this is a CTO ENGINEERING FAIL, not an OWNER decision; no promotion, D-275 and D-277..D-286 preserved

**THE PLACEMENT SEARCH IS EXHAUSTED, BUT THE WALL IS IN THE BRIDGE CODE, NOT THE PLACEMENT.** 003N screened the complete bounded direction-1 LTC-block placement space on real full-placement D-286 DRC + the real router escape solver, then used a cheap CTO-authorized bridge-connectivity probe to refute the three survivors WITHOUT spending an expensive full run on each - decisively, at one reproducible electrical fault.

- **The 27-candidate screen (`checks/screen_003n.py`, the deliverable).** For every candidate the screen builds a REAL scratch board at the exact D-286 pre-copper boundary (002F ECO + `place_003l` + candidate -> connectivity -> zone fill -> save) and runs the real `kicad-cli pcb drc --severity-all` + the real `qb.escape` solver, rejecting any candidate that vs the `place_003l`-only CLEAN reference adds a different-net pad short / sub-0.200 mm clearance / hole breach / courtyard overlap, or leaves a required U18 pin un-escapable. The complete space is 27 - `b1`(6), `c3`(4), `cand_00..11`(12), `c2`(5). **24 REJECT at bare placement; only `b1_r75rot`, `b1_r75rotN`, `b1_q3rot` pass every hard gate + all U18 escapes.** `screen_003n.py --validate` (screen regression) PASS: `c3_00` REJECT `shorting_items +3`, `place_003l` reference clean.

- **All three survivors FAIL bridge integration at the same fault.** `b1_r75rot` was taken into a parent-supervised full run: the early south bridge reported a GEOMETRIC success (`land=C36.1 traverse=72.786 mm w=1.40 entry=4 exit=4 ywest=82.40`, disjoint) but every subsequent gate then rejected on brand-new `via_dangling +4` ("connected on only one layer") across 20 unrelated post-bridge gates until the persistent CTO stopped the poisoned cascade (`DRIVER_EXIT=143`). A cheap **bridge-connectivity probe** (added to `screen_003n.py --bridge`) reproduces the exact early bridge in ISOLATION on each survivor's placed board, fills, saves and gates KiCad `via_dangling` as the authoritative >=2-layer test; validated against the b1_r75rot control (reproduces +4). Result - `b1_r75rot` dangling **4**; `b1_r75rotN` dangling **4**; `b1_q3rot` dangling **2** AND not-disjoint (`ywest 61.04 < 75`). **0/3 truly connected.** The cheap probe evaluated both remaining survivors decisively; no expensive full run was warranted (each reproduces the identical dangling cascade).

- **Root cause - an asymmetric, placement-independent bridge defect.** Every dangling via is the ENTRY array on R75.2. Direct geometry (probe scratch board): R75.2's B.Cu pad spans y in [67.35, 68.58], but the entry vias land at y~66.19-66.81 - ~0.5-1.15 mm NORTH of the pad, over bare substrate - so on F.Cu they are tied by the `apply_early` bus while on B.Cu they touch nothing -> one-layer -> `via_dangling`. The EXIT array does NOT dangle because `bridge_early_003i._lay_landing` lays an explicit B.Cu tie-stub from each exit via to its landing pad; the ENTRY array has NO such symmetric B.Cu tie-stub (it relies on POFV vias overlapping R75.2's pad, which does not hold). The defect is structural to `bridge_early_003i.apply_early` / `bridge_route_003c.scan_entry_sites`, present in every placement (4 vs 2 dangling only reflects how many entry sites clip the pad). This re-qualifies the earlier "the D-275 bridge PASSED" claims (003K/L/M) as GEOMETRIC passes never electrically gated (masked by the c3_00 placement short); 003N is the first electrical gate of the bridge end-to-end, and it fails - consistent with the D-286 binding constraint to surface, never absorb.

- **Why NOT an owner decision.** The direction-1 candidate space is EXHAUSTED, but the three survivors fail on a bridge-connectivity IMPLEMENTATION defect independent of placement - the 003N charter's named "narrower CTO technical lever" - not on a placement wall. Fixing it moves no LTC-block footprint. So direction-2 (broad LTC4368 refloorplan / corridor widening, OWNER/mechanical) is NOT yet the sole remaining option; `/home/aqroot8/.aqroot-autopilot-stop` stays ABSENT; open owner decisions remain NONE.

- **Cleanliness.** Only new file `checks/screen_003n.py` (the D-286 screen + bridge-connectivity probe/regression); no driver/router/DRU/footprint/netclass/rule source mutated; no DRC absorbed (a `via_dangling` item IS the FAIL reason); no netclass/width/topology/net/footprint/value/polarity/six-layer/GND/safety change; `c3_00` not promoted; `place_003l` (D-285) preserved and clean; optional `BAT_SENSE TP20.1` separate; frozen `beta-full-reference-v1` untouched; `JLCPCB_READINESS` unchanged. Authoritative PCB UNCHANGED (six layers, 0 tracks, 0 vias, placement at home); `phaseA_journal.json` restored to HEAD (driver never authoritatively invoked). Regressions GREEN: `screen_003n.py --validate` and `screen_003n.py --bridge --validate`. **NO PROGRESS EARNED: PCB routing stays 0 %, overall stays 74 %.** Full analysis: [`audits/2026-08-29-p2-003n-d287-bridge-entry-array-dangling.md`](audits/2026-08-29-p2-003n-d287-bridge-entry-array-dangling.md). **Next: FBV2-P2-003O - fix the D-275 south-bridge ENTRY-array two-layer tie (add an explicit B.Cu tie-stub from each entry via to R75.2's pad centre and/or constrain `scan_entry_sites` to in-pad sites) so the entry vias are `via_dangling`-clean, symmetric to the proven exit array, with no rule/floor/topology/footprint change and no absorption; verify with `screen_003n.py --bridge` on `b1_r75rot` (via_dangling 0, entry >=3, exit >=3, disjoint ywest > 75, >=1.20 mm) then take it to a parent-supervised full Phase-A run and close BAT_PROTECTED_P.**

## 2026-08-29 - FBV2-P2-003M: D-286 the gate DRC/ratsnest baseline was measured BEFORE the candidate placement (latent since 002L), so c3_00's own placement DRC poisoned every gate; the harness now measures the baseline on the ACTUAL complete pre-copper placement, and with that correction the definitive full run SURFACES that candidate c3_00 is electrically invalid - U18 (LTC4368) collides with R83/R80 (three genuine different-net pad shorts + two sub-0.200 mm clearances, ZERO copper) and the LTC sense pins are un-escapable; harness fix + G12 regression COMMITTED, c3_00 recipe MEASURED FAIL, no authoritative promotion, D-275 and D-277..D-285 preserved

**A HARNESS-CORRECTNESS FIX THAT STOPS FALSE GATE POISONING AND, IN DOING SO, REVEALS A REAL PLACEMENT SHORT THE OLD ORDERING WAS HIDING.** The first parent-supervised 003M attempt was invalidated by a `GATE_REJECTED` cascade (`DRIVER_EXIT=143`, CTO-stopped) carrying a FIXED placement DRC delta across unrelated nets. Root-caused to a baseline measured one step too early; corrected; re-run to a defensible verdict.

- **The defect (D-286).** `route_battery_block.py` computed the gate baseline `base = RU.drc(pcb)` / `base_rn = RU.ratsnest(pcb)` right after the 002F ECO (+`AQROOT_ECO_EXTRA`) but BEFORE `AQROOT_PLACE_JSON` moved the candidate footprints a few lines below. So a candidate placement's OWN placement-derived DRC (`courtyards_overlap`/`solder_mask_bridge`/`shorting_items`/`clearance`) was never in the comparison baseline, and every per-connection gate `after − base` read those placement items as brand-new copper violations, rejecting unrelated nets (Q2_CS/Q3_CS/BAT_SENSE/LTC_SHDN/BAT_PROTECTED_P) both before and after the bridge. Latent since 002L; the dense c3_00 placement made it decisive. The bridge itself PASSED in that attempt (`land C36.1 traverse 72.786 mm w=1.40 entry 4 exit 4`), confirming the fault was in the gate baseline, not the bridge.

- **The fix (minimal, default-preserving).** The baseline is relocated to AFTER full candidate placement application + connectivity rebuild + zone fill + board save + `DRU.write` + fingerprint assertion, BEFORE any QBoard copper - so a gate delta is measured strictly against the real routed starting geometry. When no `AQROOT_PLACE_JSON` is supplied the on-disk board at the new point is byte-identical to the old point (placement block skipped, fingerprint block read-only), so default behaviour is unchanged. `DRU.write` writes a separate `.kicad_dru` sidecar, so the placement `Save` never clobbers the rules.

- **Do NOT blindly absorb - attribute.** Each corrected-baseline item was measured on independent zero-copper boards (`w/baseline_003m_audit.py`, `w/attrib_003m.py`): AUTHORITATIVE home `{hole_clearance:5, lib_footprint_issues:199, solder_mask_bridge:1}`; **002F-ECO-only = identical (clean)**; **`place_003l` alone = identical (CLEAN - D-285 vindicated, introduces nothing)**; **`c3_00` alone = +clearance:2, +courtyards_overlap:3, +shorting_items:3, +silk_over_copper:6, solder_mask_bridge 1→4 (the SOLE cause).** c3_00 (`002Z-c3_e10n_r79`, prefilter rank 1) moves U18→(4.0,72.9,90°) onto R83/R80 (unmoved), producing THREE genuine different-net pad shorts - `R83.1[BAT_PROT_SHDN_CTL]` on `U18.3[LTC_OV]` and `U18.2[LTC_UV]`, `R80.1[BAT_RAW]` on `U18.10[LTC_GATE]` - plus GND 0.100 mm and Default **0.0088 mm** sub-floor gaps, all with ZERO routed copper. No route can remove a pad-on-pad short. The router's own escape solver names the identical culprits (`U18.10 blocked by R80.1 ×71`, `U18.3 blocked by R83.1 ×68`, `U18.2 blocked by R83.1 ×71`).

- **The definitive full run (corrected harness, exact D-285 recipe, `DRIVER_EXIT=0` natural completion, scratch `FIX003M`).** PHASE A **FAIL** - `BAT_PROT_SHDN_CTL R83.1→(node) NO_NODE`; connections **64**, skipped-already-connected 89, ratsnest **713 (−68)**. The early south bridge PASSED at full width - `land C36.1`, traverse **72.994 mm @ w=1.50 mm**, entry 4 / exit 4, disjoint (`ywest 82.4`), `bridge_eco null` - the run does NOT fail on the bridge; it fails on the c3_00-collided LTC4368 control cluster (`LTC_GATE`/`LTC_OV`/`LTC_UV`/`BAT_PROT_SHDN_CTL`/`FAULT_N`/`BAT_SENSE`). Gate discipline held: the ONLY class increased vs the corrected baseline is `track_width +1` (one 0.2 mm `BAT_PROTECTED_P` bounded-stub, genuine copper, SURFACED not absorbed); `shorting_items:3` and `clearance:2` sit identically in baseline AND final. Two independent gates - the router's connectivity result and the placement DRC audit - agree c3_00 is invalid.

- **Regression G12 (router_regression, G1-G11 unchanged and still PASS).** On a real scratch board it induces a placement DRC delta, proves the OLD pre-placement order FALSELY flags it, the NEW post-placement order yields ZERO spurious delta, a post-baseline copper violation is STILL surfaced, and the driver source order is asserted so the old ordering fails the test if it returns. Preflight all PASS: `router_regression` G1-G12; `bridge_probe_003c/003d/003i/003j/003k/003l`; `u19_escape_probe_003e/003f/003g/003h`.

- **Cleanliness.** Only source changes: the baseline relocation in `route_battery_block.py` and additive G12 in `router_regression.py`. No netclass/width/topology/net/footprint/value/polarity/six-layer/GND/safety change; no DRC absorbed (a genuine placement short IS the FAIL reason); `c3_00` NOT promoted; `place_003l` (D-285) preserved and clean; optional `BAT_SENSE TP20.1` separate; frozen `beta-full-reference-v1` untouched; `JLCPCB_READINESS` unchanged. Authoritative PCB UNCHANGED (six layers, 0 tracks, 0 vias, C36/U18 at home poses); `phaseA_journal.json` restored to HEAD after the FAIL run. **This is an ORDINARY ENGINEERING FAIL (CTO scope), NOT an OWNER decision** - other LTC-block placement candidates (`c3_01/02/03`, `cand_00..11`, the c2 family) exist and are unscreened; direction-2 (broad LTC4368 refloorplan) is NOT yet the sole option. **NO PROGRESS EARNED: PCB routing stays 0 %, overall stays 74 %.** Full analysis: [`audits/2026-08-29-p2-003m-d286-baseline-order-and-c3_00-placement-shorts.md`](audits/2026-08-29-p2-003m-d286-baseline-order-and-c3_00-placement-shorts.md). **Next: FBV2-P2-003N - re-screen the LTC-block placement candidates with the corrected D-286 post-placement baseline DRC (reject any bare-placement short or un-escapable LTC sense pin), then integrate the first genuinely short-free, routable candidate with place_003l + the proven south bridge on a parent-supervised full run.**

## 2026-08-28 - FBV2-P2-003L: D-284 (OWNER) + D-285 the minimal landing-opening PLACEMENT ECO OPENS a legal southern BAT_PROTECTED_P landing - C36 rotated to vertical (270) + shifted south and the +3V3 decoupler C5 relocated west; the proven D-275 south bridge now lays entry 4 / 1.40 mm F.Cu / exit 4 with ZERO east-landing DRC and nothing new added; governing landing clearance 0.2941 mm (47% over the 0.200 mm floor); PASS CANDIDATE for supervised Phase-A integration; no authoritative promotion; D-275 and D-277..D-283 preserved

**THE FIRST POSITIVE RESULT IN THE BAT_PROTECTED_P ARC: the landing OPENS, measured and reproducible.** D-284 is the OWNER decision (Alpha, ratifying the CTO call): open a legal southern landing by a **bounded placement spread of the C36/C25/U11/BQ25185_SYS neighbourhood** (landing-opening direction 1), not corridor widening, not a broad refloorplan. D-285 (FBV2-P2-003L) is the engineering result that delivers and proves it.

- **The two blockers 003K measured, and why the fix is forced.** The forced-south bridge lands on C36.1 and hit TWO independent violations: (1) GND 0.0726 mm to C36's OWN GND pad (1.55 mm east, same footprint) - INVARIANT under any C36 translation, so fixable ONLY by a C36 ROTATION; (2) BAT_MAIN 0.0864 mm to R68's fixed F.Cu BQ25185_SYS pad (R68 is 0R DNP but KiCad-connected: 16-pad net). A vertical C36 is 3.05 mm tall, so it cannot sit south enough to clear R68 without colliding C5's courtyard.

- **The minimal ECO (`place_003l`, two footprints, nothing else).** `C36` -> (63.75, 75.10, 270 deg): the rotation moves C36's GND pad 1.55 mm SOUTH of the north-poking exit array (blocker 1: 0.0726 -> 0.4750 mm); the ~1.35 mm south shift clears R68 by distance (blocker 2: 0.0864 -> 0.2941 mm). `C5` (100 nF +3V3/GND decoupler, the SOLE courtyard obstruction to the vertical C36) -> (61.95, 75.15, 90 deg). R68 is deliberately NOT moved (real 16-pad net, no nearby legal home); C5 was chosen for its plane-net routing latitude. Both moves are STRICTLY NECESSARY and inside the approved neighbourhood (C5 is 1.9 mm from C36), recorded not taken silently.

- **The measurement (`bridge_probe_003l`, PASS).** On the reconstructed sparse 002F board + the D-275 south bridge: LANE lays (land C36.1, traverse 1.40 mm F.Cu, entry 4, exit 4); DISJOINT (ywest 82.40 mm > 74.7); the LANDING OPENS - ZERO east-landing clearance violations, and the two named blockers now clear (C36.2 GND 0.4750, R68.1 BAT_MAIN 0.2941 mm); the DRC delta vs the 003K board is EXACTLY the two landing clearances removed - clearance 4 -> 2, the two survivors are the pre-existing WESTERN LTC-block issues (R83/U18 GND 0.100, R80/U18 LTC_GATE 0.0088), courtyards_overlap stays 3, every other class identical. NO new genuine DRC class or item, and NONE absorbed. Governing achieved landing clearance 0.2941 mm, 47% over the 0.200 mm floor; the bridge holds 1.40 mm (>= the 1.20 mm floor).

- **Why a CANDIDATE, not a promotion.** The proof is a REAL board + REAL kicad-cli DRC (not an analytical proxy) but proves the LANDING, not full-board connectivity - that needs the parent-supervised full Phase-A run, which task discipline forbids starting unsupervised. So the ECO is integrated DEFAULT-INERT via the existing 002J `AQROOT_ECO_EXTRA` override (`place_003l.json`) - no driver edit - and the authoritative PCB is left untouched (0 tracks / 0 vias, C36 at home pose).

- **The supervised follow-on (defined, NOT started) - FBV2-P2-003M.** The pinned D-271 recipe + `AQROOT_BRIDGE_EARLY=1 AQROOT_BRIDGE_SOUTH=1` + `AQROOT_ECO_EXTRA=hardware/beta-v2/checks/place_003l.json`, parent-supervised, to route all nets around the reserved bridge without reintroducing the 003I corridor failures and close BAT_PROTECTED_P with no new DRC. Only then does authoritative promotion and a routing-% award apply.

- **Cleanliness.** Three NEW additive files (`place_003l.py`, `place_003l.json`, `bridge_probe_003l.py`); no existing code modified, so every default path is byte-identical. `bridge_probe_003l` PASS; `bridge_probe_003c/003d/003i/003j/003k`, `router_regression` G1-G11, `u19_escape_probe_003e/003f/003g/003h` all PASS. Only C36/C5 moved (no frozen part - D9/U18/R75-R83/Q3/FETs/C58/U19/D10/R68/U11 held); no topology/net/footprint/polarity/value/layer-stack/GND/netclass/width/clearance/hole-floor change; no safety weakening; c3_00 not promoted; optional BAT_SENSE TP20.1 kept separate; JLCPCB_READINESS not touched. D-275 and D-277..D-283 preserved. **NO PROGRESS EARNED: PCB routing stays 0 %, overall stays 74 %** - the blocker is resolved at candidate level, awaiting the supervised gate. Full analysis: [`audits/2026-08-28-p2-003l-d285-landing-opening-placement.md`](audits/2026-08-28-p2-003l-d285-landing-opening-placement.md).

## 2026-08-28 - FBV2-P2-003K: D-283 the DISJOINT-SUB-BOX southern BAT_PROTECTED_P bridge (candidate c) LAYS its lane but has NO LEGAL LANDING - the only forced-south target-island pad (the far-east node cap C36.1) is boxed by GND and BAT_MAIN, so the exit array lands 0.0726 mm from GND and 0.0864 mm from BAT_MAIN; the ungated early bridge then poisons every subsequent gate and the full run cascades (140 rejections across 26 nets); candidate (c) is EXHAUSTED and the remaining lever is the OWNER/mechanical placement-spread fallback; no authoritative promotion; D-275 and D-277..D-282 preserved

**A MEASURED FAIL that exhausts the last route-scope candidate for closing BAT_PROTECTED_P, and localises the block to the LANDING (not the lane).** 003J (D-282) localised the one spare >=1.20 mm F.Cu lane to a SOUTHERN band DISJOINT from the tap cluster (taps y<74.7, lane y>75) and deferred the disjoint-sub-box candidate (c) to a supervised full run. 003K implements the minimal env-gated candidate and measures it.

- **The implementation (minimal, default-inert).** `AQROOT_BRIDGE_SOUTH` (`route_battery_block.py`, implies the `AQROOT_BRIDGE_EARLY` 003I stage so the bridge is laid exactly once, at the stage-8 boundary; no effect unless set). `bridge_early_003i.apply_early(..., south=True)` lays the SAME proven D-275 mechanism (cardinality-1 `BAT_PROT_SHDN_CTL` vacate, 4x R75.2 entry array, >=1.20 mm F.Cu traverse rule, 4x exit array, >=3 floor, single-sourced VERBATIM from `bridge_route_003c`) with two south-only additions: a TEMPORARY net-foreign obstacle wall over the corridor-north box (x 4.6-30, y 55-74.7) that forces the western leg BELOW the tap band - removed with the injected via phantoms, so it shapes ONLY the bridge's own search and never obstructs a real net - and `LAND_REFS_SOUTH = [C36.1, U11.2, C25.1]`, the far-east node caps (the forced-south leg cannot return to the corridor pads). `south=False` reproduces the 003I corridor stage byte-for-byte.

- **The DISJOINT LANE is viable (necessary precondition holds).** On the reconstructed sparse placed board the south bridge LAYS: entry 4, >=1.20 mm F.Cu traverse, exit 3, land `C36.1`, and the western leg dips to `ywest = 81.85 mm` - well south of the taps at y<74.7. This is the half 003J could not prove on the already-dense board (there the lane capped at <=1.30 mm); the sparse-window reservation does open it.

- **The LANDING is NOT viable (decisive FAIL).** `C36.1` is the ONLY target-island BPP pad the forced-south leg can reach - no target-island pad exists between `D9.1` (x=11) and `C25/C36` (x=62), and the OPEN node COPPER D-275 landed on at (40.67,70.71) does not exist at the early reservation point. Its neighbourhood cannot clear a >=0.200 mm exit array: DRC on the laid board shows the exit copper at 0.0726 mm from `C36`'s own GND pad (64.525,73.750) and 0.0864 mm from `R6`/`R68`'s BAT_MAIN (`BQ25185_SYS`) pad (63.459,71.606) - both < the 0.200 mm floor, the exact 003I clearance class (identical GND 0.0726 mm). The offending neighbours are FIXED pads, so the FAIL reproduces on the sparse board without the full run.

- **The full run (parent-supervised, measured).** Recipe c3_00 + SIXLAYER + D277..D280 + `AQROOT_BRIDGE_EARLY=1` + `AQROOT_BRIDGE_SOUTH=1`, scratch `FIX003K`, placement fingerprint identical to the 003H reference. The early stage laid the bridge - `EARLY BRIDGE SOUTH OK land=C36.1 traverse=70.377mm w=1.20 entry=4 exit=3 ywest=81.85` - then, because the early stage lays the bridge UNGATED, the fixed landing violation (GND 0.0726 / BAT_MAIN 0.0864) was read as `new DRC {clearance:2}` by EVERY subsequent per-connection gate and rejected it: **140 gate rejections across 26 distinct nets** (`BAT_RAW`, `LTC_GATE`, `LTC_GATE_RC`, `REF_POL`, `N_BATDIV`, `REC_*`, ...). The parent STOPPED the run once the cascade was decisive (as the 003I parent did); NO `phaseA_003k_fix.json` was written - no partial board masquerades as a result. The two clearance violations are GENUINE and are NOT absorbed into any baseline.

- **Conclusion.** Candidate (c) is EXHAUSTED at the LANDING, not the lane. With (b) refuted (D-282), (d) the 003I FAIL (D-281) and (a) an envelope change (OWNER), the only remaining lever is the FALLBACK - a placement spread of the LTC4368 block (OWNER/mechanical), either to OPEN the landing (spread `C36/C25/U11` / the `BQ25185_SYS` neighbourhood) or to WIDEN the corridor - NOT attempted here.

- **Suites (all PASS):** `bridge_probe_003k` (NEW, clauses A/B/C/D/E), `bridge_probe_003i` (D-281), `bridge_probe_003j` (D-282), `bridge_probe_003c`/`bridge_probe_003d` (D-275/D-276 held fixed), `router_regression` G1-G11 (D-280 off), `u19_escape_probe_003e/003f/003g/003h` (D-277..D-280). Authoritative PCB UNCHANGED (0 tracks / 0 vias); `phaseA_journal.json` restored to HEAD; scratch `FIX003K` gitignored. Nothing moved, nothing relaxed; D-275/D-277..D-282 held byte-fixed; the optional `BAT_SENSE TP20.1` (TEST) point treated separately; no authoritative promotion. **NO PROGRESS EARNED: PCB routing stays 0 %, overall stays 74 %.** Full analysis: `audits/2026-08-28-p2-003k-d283-south-disjoint-bridge.md`. **Next: FBV2-P2-003L (OWNER/mechanical) - a placement spread of the LTC4368 block.**

## 2026-08-28 - FBV2-P2-003J: D-282 the shared western-corridor BAT_PROTECTED_P bridge is a TOPOLOGY/CAPACITY wall, and 003J LOCALISES it - the 003I-proposed route-only fix (relocate the LTC_GATE/BAT_RAW corridor TAP via drops out of the box, candidate b) is MEASURED INSUFFICIENT, because the wall is the WHOLE western through-via + control-copper field, not the taps; the only >=1.20 mm F.Cu path that exists is a ~48 mm SOUTHERN cross-board detour capped at <=1.30 mm, not the D-275 >=1.50 mm corridor bridge; no authoritative promotion; D-275 and D-277..D-280 preserved; the disjoint-sub-box / co-scheduled candidate needs a parent-supervised full run

**A BOUNDED CAPACITY MEASUREMENT that refutes the leading fix and re-localises the root cause. 003I named four candidate directions for the shared corridor; 003J measures the cheapest (relocate the corridor tap via drops) and finds it INSUFFICIENT - the wall is the whole ~50-via western through-via + control-copper field, not the LTC_GATE/BAT_RAW taps. No route-only via relocation yields a viable >=1.20 mm F.Cu western-corridor bridge; the one spare lane is a long southern cross-board detour, not the bridge. No full run was launched; the decisive disjoint-sub-box candidate is handed to the CTO for a supervised run.** All work is in-memory on a scratch COPY of the committed dense 003H board (`w/FIX003H3`, bridge OFF, the clean 71-connection routed end-state); nothing on disk is mutated, the driver is never invoked, `phaseA_journal.json` is untouched.

- **The method (`bridge_probe_003j`, NEW, cheap, read-only):** copy the dense board, reconstruct the exact D-275 mechanism on it - `BR.vacate` (cardinality-1 `BAT_PROT_SHDN_CTL` -> In3, 9 F.Cu tracks moved) + `BR.scan_entry_sites` (4x 0.80/0.40 POFV entry array on R75.2) - build ONE QBoard, then run the bridge's own high-current traverse rule (>=W F.Cu, D-269 0.30 mm trunk-to-via clearance) via-AWARE against candidate landings with an arbitrary SUBSET of the board's 56 through-vias modelled as obstacles. All primitives/constants single-sourced VERBATIM from `bridge_route_003c`. Landings: the near west-cluster pad `D9.1` (11.35,72.5) and the far `NODE_AIM` (42.4,76.4) -> the node's 1.00 mm B.Cu trunk at (40.67,70.71).
- **(A) BASELINE (confirms D-281):** via-AWARE, all 56 vias, D9.1 near landing, 1.20 mm -> **NO_PATH**. The bridge does not fit end-of-run.
- **(B) CANDIDATE (b) REFUTED - the decisive new result:** removing the 9 corridor `LTC_GATE`/`BAT_RAW` TAP vias `(5.75,70.05) (5.85,71.65) (7.05,66.0) (7.20,71.90) (7.25,74.45) (7.40,67.80) (7.75,72.45) (8.00,74.70) (8.05,67.80)` from the obstacle model (simulating a route-target/staging relocation OUT of the box) does NOT reopen the via-AWARE >=1.20 mm traverse - **NO_PATH** to the near D9.1 landing AND to the far node. The remaining ~47 control-field through-vias (`LTC_SHDN`/`LTC_OV`/`LTC_UV`/`N_POL`/`REF_POL`/`FAULT_N`/`BAT_SENSE`, each a THROUGH-via barrel across all layers at the D-269 0.30 mm clearance) still wall the F.Cu traverse. **The taps are not the lever; the whole western through-via field is.**
- **(C) REGION SATURATION + the only path is a DETOUR:** even COPPER-ONLY (no via clearance at all), there is **NO_PATH at 1.50 mm** (the D-275 target) to any landing and **NO_PATH at 1.20 mm to the near D9.1 landing**; the single copper-only >=1.20 mm path runs to the far node and is a **47.5 mm SOUTHERN cross-board detour, path max-y 78.8 mm** (>> the corridor y<75), capping at <=1.30 mm (NO_PATH at 1.40/1.50 mm; also NO_PATH with the 9 taps ALSO removed). This is the same 48.9 mm/1.30 mm path `bridge_probe_003i` clause B reached, now characterised precisely: NOT the D-275 >=1.50 mm western-corridor bridge but a long, low-margin cross-board lane that would multiply the trunk resistance (B-34).
- **The conclusion (engineering, CTO scope, NOT an OWNER decision):** the corridor cannot host both a viable bridge and the western routing by any END-OF-RUN or via-RELOCATION means. Candidate (b) is refuted; candidate (d) [early/reserved bridge] is the 003I FAIL; candidate (a) [widen] needs board space / an envelope change (OWNER). The one remaining ROUTE-scope direction is **candidate (c)** - a DISJOINT bridge sub-box reserved in the sparse window with the whole western block forced into the complement - which changes CAPACITY (a co-scheduled joint reservation), cannot be proven by a bounded probe, and needs a parent-supervised full run. **No OWNER decision is forced yet.**

**No false promotion.** 003J ran no full route and promoted nothing; no `phaseA_003j_fix.json` claims a clean/absorbed end-state; the authoritative PCB is 0 tracks / 0 vias. **No driver change was committed** - candidate (b) is refuted (not implemented) and the candidate (c) reservation machinery is the next task (committing a large inert unproven reservation now would add risk with no measured backing). **SUITES ALL PASS:** `bridge_probe_003j` (NEW, the standing measured-capacity record, clauses A/B/C/D/E), `bridge_probe_003i` (D-281 record intact), `router_regression` G1-G11 (D-280 off), `bridge_probe_003c`/`bridge_probe_003d` (003C/D-275 held FIXED), `u19_escape_probe_003e/003f/003g/003h`. Committed artifacts: `bridge_probe_003j.py`, this audit, the D-282 CTO row, this CHANGELOG entry, the PROGRESS entry. **Nothing moved and nothing relaxed:** D9, U18, R75-R83, Q3, shunt, FETs, C58, U19, D10 and the whole R84-R96/Q5-Q9 field frozen; `c3_00` NOT promoted; D-249..D-281 (incl. **D-275/D-277/D-278/D-279/D-280/D-281**) untouched; the proven 003C bridge geometry held fixed; the 0.200 mm clearance and 0.25 mm hole-to-hole floors ENFORCED not relaxed; no safety weakening; no topology/net/footprint/polarity change; no six-layer/GND change; no authoritative promotion. Authoritative PCB UNCHANGED (six layers, **0 tracks, 0 vias**). Phase A NOT completed (the D-275 BPP bridge is still not integrated). **`/home/aqroot8/.aqroot-progress.env` untouched - a measured FAIL earns no readiness. Next: FBV2-P2-003K - implement the minimal env-gated co-scheduled DISJOINT-SUB-BOX bridge reservation (reserve a >=1.50 mm F.Cu bridge lane in the southern band disjoint from the tap cluster, force the western LTC block into the complement) and MEASURE on a PARENT-SUPERVISED full run (~35-40 min) whether BPP closes without reintroducing the 003I GND/BAT_MAIN/BAT_RAW failures; if the southern reservation cannot hold >=1.20 mm or the western block cannot fit the complement, candidate (c) is exhausted and the fallback is a placement spread of the LTC4368 block (OWNER/mechanical).** Full analysis: [`audits/2026-08-28-p2-003j-d282-corridor-capacity.md`](audits/2026-08-28-p2-003j-d282-corridor-capacity.md).

## 2026-08-28 - FBV2-P2-003I: D-281 the route-order EARLY landing of the proven D-275 bridge is a MEASURED, REPRODUCIBLE FAIL - the bridge and the current-carrying corridor users (LTC_GATE/BAT_RAW tap, the GND pour and BAT_MAIN) CONTEND for one ~9 mm western corridor, so re-timing only changes WHICH high-current user fails, not WHETHER one fails; no authoritative promotion; D-275 and D-277..D-280 preserved; the topology/capacity fix is deferred to 003J

**A MEASURED FAIL, honestly closed. The obvious re-timing of the proven D-275 bridge - lay it EARLY, while the western corridor is still sparse, and let later routing route around it - was measured on a full supervised run and DOES NOT WORK, for a structural reason: the corridor lacks the CAPACITY for both the bridge and the taps, and a re-ordering cannot create room the geometry does not have.** 003D (D-276) integrated the exact D-275 mechanism as an END-OF-RUN stage and measured it to ABORT; 003I's preflight isolated the cause to western via-density (15 corridor vias vs 11 on the proven-sparse c3 board). 003I then measured the re-timing fix.

- **The mechanism (env-gated `AQROOT_BRIDGE_EARLY`, off by default):** the driver lays the EXACT D-275 bridge - the cardinality-1 `BAT_PROT_SHDN_CTL` vacate, the 4x 0.80/0.40 entry array on `R75.2` (POFV), the >=1.20 mm F.Cu traverse, the 4x exit array, all single-sourced VERBATIM from `bridge_route_003c` - at the first stage-8 queue item, in the proven-sparse window (after the D-266 Kelvin reservation + U18 field claim their sites, before the `LTC_GATE` / `BAT_RAW` taps inject the corridor-choking vias), then restores the driver's via-blind obstacle model so later nets route around the real bridge copper.
- **It LAYS (necessary):** the parent-supervised full run (recipe `c3_00` + SIXLAYER + D277..D280 + `AQROOT_BRIDGE_EARLY=1`) laid it - `EARLY BRIDGE OK land=C58.1 traverse=8.920mm w=1.50 entry=4 exit=4`. `bridge_probe_003i` clause E independently lays it on a reconstructed sparse placed board (entry 4, traverse 1.50 mm, exit 4, no new DRC on the sparse board).
- **But it is NOT sufficient - the MEASURED downstream FAIL:** the current-carrying corridor users that route AFTER the bridge failed their normal gates with two new clearance VIOLATIONS and a lost via site: `GND` clearance actual **0.0726 mm** vs 0.200 mm; `BAT_MAIN` actual **0.125 mm** vs 0.200 mm; `BAT_RAW` **NO_VIA_SITE**. Per CTO ruling these are GENUINE safety-clearance violations and MUST NOT be absorbed/refreshed into the baseline (that would waive real violations). The run is INVALID as a Phase-A candidate, not proof of success. The parent stopped it once the conflict became decisive.
- **The root cause is a SYMMETRY (cheap, reproduced by `bridge_probe_003i` clause B on the committed dense board FIX003H3):** the tight western corridor `R75.2 -> D9.1` carries 15 through-vias; the >=1.20 mm via-AWARE traverse NO_PATHs while the copper-only traverse PATHs. End-of-run the bridge cannot fit around the taps (why 003D aborted); early, the 1.50 mm bridge traverse gets in first and the SAME `LTC_GATE` / `BAT_RAW`-tap vias then have no legal site / lose clearance around it. **One corridor, two mutually-exclusive high-current users; route ORDER decides WHICH one fails, not WHETHER one fails. Timing is not the lever.**

**No false promotion.** The misleading incomplete interrupted-run board (scratch `FIX003I`) and its clobbered per-run `phaseA_journal.json` were removed / restored so no incomplete result masquerades as evidence; no `phaseA_003i_fix.json` claims a clean/absorbed end-state; the authoritative PCB is 0 tracks / 0 vias. **SUITES ALL PASS:** `bridge_probe_003i` (rewritten as the standing measured-FAIL record, clauses A/B/C/E/F), `router_regression` G1-G11 (D-280 off), `bridge_probe_003c` / `bridge_probe_003d` (003C/D-275 held FIXED), `u19_escape_probe_003e/003f/003g/003h`. Committed artifacts: the env-gated `AQROOT_BRIDGE_EARLY` driver stage in `route_battery_block.py`, `bridge_early_003i.py`, `bridge_probe_003i.py`. **Nothing moved and nothing relaxed:** D9, U18, R75-R83, Q3, shunt, FETs, C58, U19, D10 frozen; `c3_00` NOT promoted; D-249..D-280 (incl. **D-275/D-277/D-278/D-279/D-280**) untouched; the proven 003C bridge geometry held fixed; the 0.200 mm clearance floor ENFORCED not relaxed; no safety weakening; no topology/net/footprint/polarity change; no authoritative promotion. Authoritative PCB UNCHANGED (six layers, **0 tracks, 0 vias**). Phase A NOT completed (the D-275 BPP bridge is still not integrated into the production run). **`/home/aqroot8/.aqroot-progress.env` untouched - a failed candidate earns no readiness. Next: FBV2-P2-003J - a TOPOLOGY/CAPACITY solution (widen or add a western corridor, relocate the LTC_GATE/BAT_RAW taps, or re-plan so bridge and taps do not share the box) without weakening clearance.** Full analysis: [`audits/2026-08-28-p2-003i-d281-early-bridge-fail.md`](audits/2026-08-28-p2-003i-d281-early-bridge-fail.md).

## 2026-08-28 - FBV2-P2-003H: D-280 the 003G functional casualty N_BATDIV C61.1->U19.6 is a CO-LOCATED THROUGH-VIA LANDING (not pad geometry, not a corridor) - the fast direct-escape via placement in connect_hop checked only COPPER clearance (waived for the via's own net) and NOT the net-agnostic hole-to-hole floor, so a hop escaping straight onto its co-terminal same-net barrel dropped a second drill on the first; an env-gated hole-to-hole guard rejects the co-locating site and falls the placement through to via_site's legal 0.45 mm barrel, closing C61.1 on a full production run - net-positive, DRC-identical - with D-277/D-278/D-279 and the proven 003C bridge held FIXED; the terminal item is now the OPTIONAL BAT_SENSE TP20.1 TEST point (not a functional regression)

**A MEASURED ROUTING REPAIR that closes the 003G functional casualty on the full production run - net-positive on connectivity, identical DRC, ratsnest one better, every regression gate green - and honestly discloses the one optional test point left terminal.** 003G (D-279) closed both named dead-cell escape blockers and ROTATED one functional casualty onto `N_BATDIV C61.1->U19.6 NO ROUTE` (a bypass cap on the divider-sense node, NOT a test point). 003H measured its cause A->B->C and repaired it.

- **(A) intrinsic geometry REFUTED.** `U19.6` (SOT-23-8 hard against the west edge, ONE useful east escape lane) still escapes freely on the empty authoritative board (>=2 ways at 0.15 mm) - the pad is not the blocker.
- **(B) route-order CONFIRMED - a CO-LOCATION, not a corridor.** Two `N_BATDIV` connections are co-terminal at U19.6's single east escape (`U19.6->R89.2` and the 46 mm cross-board `C61.1->U19.6` hop), so both want a THROUGH-via barrel there. On the committed 003G BASE board they land 0.450 mm centre-to-centre - two 0.20 mm drills at EXACTLY the 0.25 mm `min_hole_to_hole` floor, ZERO margin. The 003G field re-pack tipped C61.1's landing off that zero-margin fit onto the co-located point (0.035 mm from the neighbour, hole edge -0.165 mm) and DRC answered `holes_co_located` / `hole_to_hole` every pass.
- **The defect (measured):** `connect_hop`'s fast `free_everywhere` via placement tested only COPPER clearance - which `point_free` WAIVES for the via's own net - and NOT hole-to-hole. `via_site` (the fallback) DOES enforce hole-to-hole but is only consulted when `free_everywhere` fails, so a hop escaping straight onto a co-terminal SAME-NET barrel dropped a second drill on the first.
- **(C) placement NOT required.**

**The fix (D-280, env-gated `AQROOT_D280`):** `free_everywhere` now also enforces the net-agnostic `min_hole_to_hole` floor for the barrel it is about to drill (`max(hole radius) + via_drill/2 + 250000` against every hole, own net included); a co-locating site is REJECTED and the placement falls through to `via_site`, which lands the base's own legal 0.45 mm barrel. The guard ONLY adds a rejection - it relaxes nothing, moves no part, invents no via; unset (`h2h=0`) it reproduces pre-003H byte-for-byte. The `250000` (0.25 mm) IS the governing DRU `min_hole_to_hole` and is byte-identical in structure to the existing `via_site(hole_clr=250000)` and POFV `max(h.hx,h.hy)+via_drill/2.0+250000` - safely aligned, not a new/looser value.

**Full production run (`phaseA_003h_fix.json`, scratch FIX003H3, recipe + `AQROOT_D279=1` + `AQROOT_D280=1`, c3_00 asserted, SIXLAYER, rc0; parent-supervised in session 62295, NOT re-run):** connections 69->**71**, skipped 96, ratsnest 709/-72 -> **708/-73** (one better), DRC histogram identical to baseline, `bridge_eco null`. Independent scan of all 52 through-via barrels: ZERO hole-to-hole edges below 0.25 mm; the two co-terminal N_BATDIV barrels at U19.6 land 0.450 mm centre / **0.2500 mm hole-edge, at the floor** (D-280 off: 0.035 mm / -0.165 mm).

**Casualty ledger vs 003G (exact, connections 69->71 = +2):** + `N_BATDIV C61.1->U19.6` (the D-280 target, RESTORED), + `BAT_RAW R77.1->R79.1`, + `LTC4368_FAULT_N R82.1->Q9.1` with - `LTC4368_FAULT_N Q9.1->(node)` (the SAME net - Q9.1 re-landed on its real pad, not a lost functional net). Functional C61.1 restored; D-277 (`N_POL U19.3`), D-278 (`VREC_VCC U19.8`), D-279 (`VBRIDGE_TOP R85.1->D10.1`, `REF_HO R92.1<->R93.2`) gains RETAINED. **Terminal OPTIONAL TEST-point disclosure (NOT a functional regression):** the terminal fail is `BAT_SENSE TP20.1->(node)`, role (TEST) - a test point unrouted since 003F and terminal in 003G too; 003H does not newly break it, only its fail reason shifted (003G a D-269 clearance violation 0.30 vs 0.25; 003H NO_PATH at 0.200 mm). With C61.1 closed, ALL FOUR named functional dead-cell blockers (D-277/D-278/D-279/D-280) are now closed on the full production run.

**SUITES ALL PASS AND UNREGRESSED:** new `u19_escape_probe_003h` (A/B/C/D/E), `u19_escape_probe_003g` (D-279 intact), `u19_escape_probe_003f` (D-278 intact), `u19_escape_probe_003e` (D-277 intact), `router_regression` ALL CHECKS incl. G1-G11 (D-280 off), **`bridge_probe_003c` PASS (003C/D-275 held FIXED)**, `bridge_probe_003d` PASS. `phaseA_journal.json` scratch restored to HEAD; the incomplete `log_FIX003H2.txt` scratch trashed. Committed artifacts: the driver change (env-gated D-280 guard in `qrouter.connect_hop`), `u19_escape_probe_003h.py`, `phaseA_003h_fix.json`. **Nothing moved and nothing relaxed:** D9, U18, R75-R83, Q3, shunt, FETs, TP17, C58, U19, D10 and the whole R84-R96/Q5-Q9 field frozen; `c3_00` NOT promoted; D-249..D-279 (incl. **D-275/D-277/D-278/D-279**) untouched; the proven 003C bridge held fixed; the `min_hole_to_hole = 0.25 mm` DRU ENFORCED not relaxed; outer-1-oz/high-current policy unchanged; no safety weakening; no topology/net/footprint/polarity change; no authoritative promotion. Authoritative PCB UNCHANGED (six layers, **0 tracks, 0 vias**). Phase A NOT completed (the held-fixed 003C BPP bridge is proven only in isolation, not yet integrated into the production run); Phase B NOT run. **THE 003G FUNCTIONAL CASUALTY IS CLOSED; all four named dead-cell blockers are closed; the Phase-A promotion blocker is the held-fixed 003C bridge integration. Next: FBV2-P2-003I.** Full analysis: [`audits/2026-08-28-p2-003h-d280-c61-landing-guard.md`](audits/2026-08-28-p2-003h-d280-c61-landing-guard.md).

## 2026-08-28 - FBV2-P2-003G: D-279 the dead-cell resistor-field congestion (VBRIDGE_TOP R85.1->D10.1, REF_HO R92.1<->R93.2) is an ANTISOCIAL B.Cu DETOUR in the packed 0402 field - not intrinsic geometry and not the D-278 crossing pin - and a measured route-time ANTISOCIAL-DETOUR LAYER HOP closes BOTH named blockers on a full production run (net-positive, DRC-identical), rotating one functional casualty (N_BATDIV C61.1) deferred to 003H; D-277/D-278 and the proven 003C bridge held fixed

**A MEASURED ROUTING REPAIR that closes BOTH named dead-cell escape blockers on a full production run - net-positive on connectivity, identical DRC, every regression gate green - and honestly TRACKS the one functional casualty it rotates.** D-278 (003F) cleared U19.8 and named these two blockers, both `NO_LEGAL_ESCAPE >=0.150 mm` in the packed 0402 dead-cell field (R84-R96/Q5-Q9, 0.65 mm pitch). 003G discriminated A->B->C.

- **(A) intrinsic geometry REFUTED:** empty-board escapes R85.1=8, D10.1=7, R92.1=8, R93.2=8.
- **(B) route-order CONFIRMED - an ANTISOCIAL DETOUR, not the D-278 crossing pin.** Reproduction note: unlike U19.8, the committed `AQROOT_LOCAL=DEADCELL` bounded prefix ROUTES both victims (it omits the west `BAT_RAW` divider, so the dead-cell `BAT_RAW` field taps that box R85.1 never lay) - the blockers are FULL-RUN emergent, so attribution was done on the real routed baseline board (a full run, D-279 off, reproducing `phaseA_003f_fix.json`: 68 conn, 710/−71, identical DRC). R85.1 is sealed to 0 by `N_POL R85.2->R86.1`, which routes 6.23 mm for a 2.48 mm span (2.5x) as a B.Cu HORSESHOE boxing R85.1 (removing it: 0->7 ways); R93.2 by REC_GATE_N copper wrapping it + the antisocial `REC_BAT_LOW Q7.1->R93.1` (23.1 mm/3.1x) (removing both: 0->8). Routed DIRECT on the empty board those same connections are harmless (N_POL R85.2->R86.1 = 2.52 mm, R85.1 stays 7) - the aggressor is the DETOUR, the general case of D-278's single crossing pin.
- **(C) placement NOT required.**

**The fix (D-279, env-gated `AQROOT_D279`):** in `run_once`, a dead-cell-class SIG B.Cu route whose copper came back > `D279_K`x its straight-line pad span AND > `D279_MIN_MM` (2.0 / 5.0 mm) is reverted and re-routed as an ordinary 0.35/0.20 through-via hop (D-257 preferred, no rule relaxed), inner signal layer (In2/In3) FIRST so the local field detour leaves outer F.Cu clear, kept ONLY if the hop is legal and strictly shorter. Adds an option, removes none; inert for every wide/high-current net, TRUNK/TAP, node target, or route within 2x of its span; unset reproduces pre-003G byte-for-byte.

**Full production run (`phaseA_003g_fix.json`, recipe + `AQROOT_D279=1`):** two connections hop onto In2.Cu (`N_POL R85.2->R86.1` 6.2->4.5 mm, `REC_BAT_LOW Q7.1->R93.1` 23.1->9.4 mm) and BOTH victims route (`VBRIDGE_TOP R85.1->D10.1` F.Cu+2 via; `REF_HO R92.1->R93.2` 3.8 mm). Aggregate: connections 68->**69**, ratsnest 710/−71 -> **709/−72** (one better), in-scope nets connected 23->**24** of 29, DRC histogram identical to baseline, `bridge_eco null`. Exactly three nets changed: VBRIDGE_TOP + REF_HO gained, N_BATDIV lost.

**Casualty ledger (tracked, not hidden):** the coupled field rotates ONE casualty onto `N_BATDIV C61.1->U19.6` - a FUNCTIONAL bypass cap (NOT a test point), a pre-existing hyper-marginal 46 mm cross-board hop whose landing via co-locates with `U19.6->R89.2`'s via and survives baseline only by ~25 um; robust across F.Cu-first and inner-first hop variants (identical aggregate). Net +2 named functional closures −1 functional casualty = +1; deferred to 003H, NOT claimed closed - the same rotation pattern by which 003F closed U19.8.

**SUITES ALL PASS AND UNREGRESSED:** new `u19_escape_probe_003g` (A/B/C/D/E), `u19_escape_probe_003f` (D-278 intact), `u19_escape_probe_003e` (D-277 intact), `router_regression` ALL CHECKS incl. G1-G11 (D-279 off), **`bridge_probe_003c` PASS (003C/D-275 held fixed)**, `bridge_probe_003d` PASS. `phaseA_journal.json` scratch restored to HEAD. Committed artifacts: the driver change (env-gated D-279 block + config), `u19_escape_probe_003g.py`, `phaseA_003g_base.json`, `phaseA_003g_fix.json`. **Nothing moved and nothing relaxed:** D9, U18, R75-R83, Q3, shunt, FETs, TP17, C58, U19, D10 and the whole R84-R96/Q5-Q9 field frozen; `c3_00` NOT promoted; D-249..D-278 (incl. **D-275/D-277/D-278**) untouched; the proven 003C bridge held fixed; outer-1-oz/high-current policy unchanged; no safety weakening; no topology/net/footprint/polarity change; no authoritative promotion. Authoritative PCB UNCHANGED (six layers, **0 tracks, 0 vias**). **BOTH NAMED BLOCKERS CLOSED; the rotated casualty `N_BATDIV C61.1` is the new named blocker. Next: FBV2-P2-003H.** Full analysis: [`audits/2026-08-28-p2-003g-d279-deadcell-field-hop.md`](audits/2026-08-28-p2-003g-d279-deadcell-field-hop.md).

## 2026-08-28 - FBV2-P2-003F: D-278 the VREC_VCC U19.8 NO_LEGAL_ESCAPE is a ROUTE-ORDER CROSSING DETOUR (the D-277 crossing pin REF_POL U19.2's antisocial B.Cu horseshoe); sending that crossing pin off the outer layer with a LAYER HOP clears U19.8 on a full production run; the co-terminal VBRIDGE_TOP R85.1 is a DISTINCT blocker deferred to 003G; the proven 003C bridge is held fixed

**A MEASURED, PROVEN ROUTE-ORDER/LAYER FIX for U19.8 - not a placement/topology/safety change; R85.1 is a SEPARATE blocker, measured and deferred, NOT over-claimed.** D-277 (003E) cleared N_POL U19.3 and Phase A advanced to `VREC_VCC U19.8->(node) NO_LEGAL_ESCAPE at >=0.150 mm` (blockers track x33, U19.7 x13, board_edge x5, U19.5 x5), co-terminal `VBRIDGE_TOP R85.1`. 003F discriminated the cause A->B->C with cheap analytic + isolated real-router probes and the full production driver.

- **(A) intrinsic east-row geometry REFUTED:** on the empty authoritative board U19.8 has 5 legal >=0.150 mm escapes, R85.1 has 8, D10.1 has 7.
- **(B) route-order CONFIRMED, and LOCAL to the dead-cell block:** a new bounded `AQROOT_LOCAL=DEADCELL` prefix (class of R80/D256/U19; skips the whole west-margin prefix, which cannot reach U19's y~=29 corridor) reproduces the blocker byte-similar (`track x34, U19.7 x14` vs the full run's `x33/x13`) - so the ~33 blocking `track` hits are all dead-cell copper. Obstacle attribution on the real routed board: the aggressor is the D-277 crossing pin `REF_POL U19.2` ITSELF - routed last (D-277 correctly routes U19.3 first), its direct southern lane filled by U19.3's copper, it takes a **13.372 mm NORTHERN HORSESHOE** over U19 and walls U19.8 with a segment `(4.65,29.85)->(3.05,29.85)` at d=0.495 mm and a diagonal at d=0.901 mm (U19.8 -> 0 B.Cu escape, so it cannot even start the F.Cu-hop fallback). The D-277 planar span tie-break cannot catch this: U19.2's straight-line span does not contain U19.8, and U19.8 is a MULTI-LANE victim, not the tied single-lane class.
- **(C) placement NOT required.**

**The fix (cardinality-0 placement):** reuse the exact D-277 `crossings>0 / fr<=1` predicate to mark the crossing pin in `hop_first_keys`; `run_once` then routes it with an ORDINARY 0.35/0.20 through-via F.Cu hop FIRST (D-257 preferred, no rule relaxed) instead of the antisocial B.Cu detour, falling through to the B.Cu ladder untouched on failure. Fires only in the D-277 class (today only `REF_POL U19.2`), inert for any pin with a second way out; changes only which LAYER the already-identified crossing pin runs on; lays no authoritative copper.

**Full production run (`phaseA_003f_fix.json`, base `phaseA_003d` config, no ECO, 2330 s):** `REF_POL TP24.1->U19.2` 8.610 mm F.Cu+2 vias (direct, no horseshoe) and `VREC_VCC U19.8->R84.2` 22.408 mm OK - the D-277 blocker is CLEARED and Phase A advances. Aggregate a WASH BY DESIGN (relocates the binding blocker): connections 68, skipped 94, ratsnest 710 delta -71 (003E was 68/90/711/-70, ONE net better); DRC identical to baseline (`hole_clearance 5 / lib_footprint_issues 199 / solder_mask_bridge 1 / unconnected_items 499`); `bridge_eco null`. Journal diff vs 003E: +U19.8, +`REF_HO R91.2->R92.1`, +`REC_GATE_N TP21.1->R94.2`; -`BAT_SENSE TP20.1` (a test point), -`REC_GATE_N R94.2->(node)`, -`REF_HO R92.1->R93.2`.

**The co-terminal `VBRIDGE_TOP R85.1` is a DISTINCT blocker -> 003G.** R85.1 was never routed in 003E either; on the real routed board it is boxed by **N_POL** (x10 within 2.0 mm) not the REF_POL crossing, and neither it nor its aggressor is single-lane, so the D-278 predicate correctly does not mark it. Same pattern: `REF_HO R92.1<->R93.2` boxed by REC_GATE_N x8. These are the DEAD-CELL RESISTOR-FIELD CONGESTION class (packed 0402 cluster R84-R96 / Q5-Q9, casualties rotate). The BPP closure (`D9.1/C25/C36/C58 at >=1.20 mm`) is the KNOWN held-fixed 003C bridge case, not new.

**SUITES ALL PASS AND UNREGRESSED:** new `u19_escape_probe_003f` (A/B/C/D/E, incl. E pinning that the committed full run routes U19.8 and does NOT route R85.1 - deferred, not over-claimed), `u19_escape_probe_003e` (D-277 intact), `router_regression` ALL CHECKS incl. G1-G11, **`bridge_probe_003c` PASS (003C/D-275 held fixed)**, `bridge_probe_003d` PASS (committed 003D FAIL artifacts still pin `N_POL U19.3`, un-regressed). `phaseA_journal.json` scratch restored to HEAD. Committed artifacts: the driver change, `u19_escape_probe_003f.py`, `phaseA_003f_fix.json`, `phaseA_003f_deadcell_base.json`, `phaseA_003f_deadcell_fix.json`. **Nothing moved and nothing relaxed:** D9, U18, R75, R76..R83, Q3, the shunt, the FETs, TP17 and C58 all frozen; `c3_00` NOT promoted; D-249..D-277 (incl. **D-275**) untouched; outer-1-oz / high-current policy unchanged; no safety weakening; no topology/net/footprint/polarity change; no authoritative promotion. Authoritative PCB UNCHANGED (six layers, **0 tracks, 0 vias**, no source mutated). **U19.8 CLEARED; the dead-cell resistor-field congestion (`VBRIDGE_TOP R85.1`, `REF_HO R92/R93`) is the new named blocker. Next: FBV2-P2-003G.** Full analysis: [`audits/2026-08-28-p2-003f-d278-u19-8-crossing-hop.md`](audits/2026-08-28-p2-003f-d278-u19-8-crossing-hop.md).

## 2026-08-28 - FBV2-P2-003E: D-277 the U19.3 N_POL NO_LEGAL_ESCAPE is a ROUTE-ORDER contention (cause B), not pad/board geometry; a cardinality-0 planar tie-break in the driver CLEARS it on a full production run and Phase A advances to a new deeper blocker VREC_VCC U19.8; the proven 003C bridge is held fixed

**A MEASURED, PROVEN ROUTE-ORDER FIX - not a placement/topology/safety change.** D-276 named
`N_POL U19.3->(node) NO_LEGAL_ESCAPE at >=0.150 mm` (blockers board_edge x23, U19.4 x16, U19.2 x12,
U19.6 x8) as the full-driver Phase-A blocker and named the next task: a bounded investigation of it
distinguishing (A) pad-escape geometry, (B) route-order/copper obstruction, (C) minimum placement ECO,
holding the proven 003C vacate + F.Cu 4-via bridge FIXED. 003E measured each cause and repaired the one
that is real.

- **(A) intrinsic pad/footprint/board-edge geometry - REFUTED.** On the empty authoritative board (0
  signal tracks; U19 is NOT moved by c3, which moves only R75/U18/R79) `qb.escape(U19.3, 'B', 0.150…)`
  returns a legal >=0.150 mm escape east into the inter-row gap; its sibling U19.2 also escapes; both
  middle west-row pins are SINGLE-LANE (freedom 1). The pad can leave its own copper.
- **(B) route-order / already-laid copper - CONFIRMED (the cause), and directional.** Isolated on the
  empty board, routing `REF_POL TP24.1->U19.2` FIRST drops U19.3 freedom to 0 and reproduces the D-276
  fail string byte-for-byte; routing `N_POL TP23.1->U19.3` FIRST leaves U19.2 escapable and BOTH route.
  U19.2 sits NORTH of U19.3 but its target TP24.1 is SOUTH, so its route crosses south through the gap
  over U19.3's only (east) lane and seals it; U19.3's target TP23.1 does not cross U19.2. Textbook
  planar-fanout ordering: among boxed pins exiting the same way, the one whose route crosses a sibling
  goes LAST.
- **(C) minimum placement ECO - NOT REQUIRED** (B is fixable by order alone), left un-exercised per the
  A->B->C investigation order.

**The fix - a measured planar tie-break, cardinality-0.** `order_tight` already routes the tightest pin
first, but U19.2/U19.3 tie on EVERY existing key (slack +0.14 mm, ways-out 1, width), so the order fell
through to the arbitrary MST order that put U19.2 first. The repair adds ONE final tie-break on live
geometry: among rows tied on `(slack, ways-out)` with ways-out <=1 (the boxed single-lane class),
`crossings[i]` counts tied siblings whose pad falls inside row i's pad->target bounding span, and the
sort key becomes `(slack, ways-out, width, crossings)`. U19.2's span contains U19.3 (crossing 1);
U19.3's does not contain U19.2 (crossing 0) -> U19.3 routes first, and both escape. The term is 0 for
every pin with a second way out (guarded by `fr_a <= 1`) and is the LAST sort key, so it only settles an
EXACT `(slack, ways-out, width)` tie that today resolves arbitrarily - it can never reorder across
tightness classes, and it lays no copper (read-only geometry).

**The full production Phase-A run** (`phaseA_003e_fix.json`, base `phaseA_003d` config, no ECO,
2306.8 s): the pin-field slack line now reads `U19.3 +0.14/1way  U19.2 +0.14/1way …` (reordered exactly
as the probe predicts) and both boxed pins route (`N_POL TP23.1->U19.3` 6.118 mm OK, `REF_POL
TP24.1->U19.2` 13.372 mm OK). The D-276 terminal blocker is CLEARED and Phase A ADVANCES to a NEW,
deeper terminal blocker `PHASE A: FAIL - VREC_VCC U19.8->(node) NO_LEGAL_ESCAPE at >=0.150 mm; blocked
by track (x33), U19.7 (x13), board_edge (x5), U19.5 (x5)` (co-terminal `VBRIDGE_TOP R85.1` also
NO_LEGAL_ESCAPE; both at -0.15/0way, stable across all 3 passes). Aggregate is a WASH BY DESIGN - the
fix relocates the binding blocker, it does not close Phase A: connections 68, skipped 90, ratsnest 711
delta -70 (003D-base 68/91/710/-71); DRC identical to the authoritative baseline (`hole_clearance 5 /
lib_footprint_issues 199 / solder_mask_bridge 1 / unconnected_items 499`); `bridge_eco null`. The U19.8
blocker is a DIFFERENT CLASS from D-276 - dominated by FOREIGN laid `track` (x33) on the EAST row, not
board_edge + own pins - so the west-row planar tie-break does not apply and a route-order swap is
unlikely to be sufficient; 003F must discriminate it afresh.

**Delivered + regression.** `route_battery_block.py` gains the scoped D-277 planar tie-break inside
`order_tight`; new probe **`u19_escape_probe_003e.py`** (A refuted, B both directions, C planar
prediction + lay-and-count lookahead agree, D driver carries the scoped tie-break) - **PASS**; result
artifact `phaseA_003e_fix.json`. **SUITES ALL PASS AND UNREGRESSED:** `u19_escape_probe_003e`,
`router_regression` ALL CHECKS incl. G1-G11, **`bridge_probe_003c` PASS (003C/D-275 held fixed)**,
`bridge_probe_003d` PASS (the committed 003D FAIL artifacts still pin `N_POL U19.3`, un-regressed).
`phaseA_journal.json` scratch restored to HEAD. **Nothing moved and nothing relaxed:** D9, U18, R75,
R76..R83, Q3, the shunt, the FETs, TP17 and C58 all frozen; `c3_00` NOT promoted; D-249..D-276 (incl.
**D-275**) untouched; outer-1-oz / high-current policy unchanged; no safety weakening; no
topology/net/footprint/polarity change; no authoritative promotion (Phase A did not pass). Authoritative
PCB UNCHANGED - six copper layers, 0 signal tracks, 0 signal vias. **U19.3 CLEARED; `VREC_VCC U19.8` is
the new named blocker. Next: FBV2-P2-003F.** Full analysis:
[`audits/2026-08-28-p2-003e-d277-u19-escape-order.md`](audits/2026-08-28-p2-003e-d277-u19-escape-order.md).
**NO PROGRESS EARNED: PCB routing stays 0 %, overall stays 74 %.**

## 2026-08-28 - FBV2-P2-003D: D-276 the driver-integrated vacate + F.Cu bridge is a MEASURED REPRODUCIBLE FAIL; the full production driver fails upstream at U19.3 N_POL NO_LEGAL_ESCAPE; 003C/D-275 stands as the fixed proven solution

**A MEASURED REPRODUCIBLE FAIL of production / full-driver promotion - NOT a disproof of 003C.** D-275
proved the western-corridor vacate + F.Cu via-array bridge as a POST-PROCESS of a hand-staged
reproduced c3 board and named the next task: integrate that mechanism into the production Phase-A
driver and drive it through a full 2-pass route (the D-271 discipline). 003D performs that integration
- `route_battery_block.py` gains ONE `AQROOT_BRIDGE_ECO`-guarded call to `bridge_eco_003d.apply_eco`
(single-sourcing the D-275 copper primitives verbatim from `bridge_route_003c`) - and the full driver
route **reproducibly fails on two independent passes**:

- **Phase A fails earlier, at the U19 recovery-comparator block:** `N_POL U19.3->(node) (SIG) :
  NO_LEGAL_ESCAPE : U19.3: NO LEGAL ESCAPE at >= 0.150 mm; blocked by board_edge (x23), U19.4 (x16),
  U19.2 (x12), U19.6 (x8)`.
- **The integrated 003C-style vacate-then-bridge ECO aborts:** `ECO ABORT: no >= 1.20 mm F.Cu traverse
  corridor` - the vacate runs (6 F.Cu tracks moved, 48 existing vias seen) but the production board
  offers no >= 1.20 mm F.Cu lane to bridge, unlike the hand-staged 003C board.

**Reproduced (2-pass D-271 discipline).** `phaseA_003d_ecoC.json` and `phaseA_003d_ecoD.json` are NOT
byte-identical (they differ only in per-net wall-clock `secs` jitter) but every DECISIVE field is
identical: the Phase-A `fail` string above; `connections 68`; `skipped 91`; `ratsnest 710`, delta
`-71`; DRC `hole_clearance 5 / lib_footprint_issues 199 / solder_mask_bridge 1 / unconnected_items
499` (identical to the authoritative baseline); `bridge_eco.ok false`, `fail "no >= 1.20 mm F.Cu
traverse corridor"`, `vacated 6`, `existing_vias 48`. The base `phaseA_003d.json` (no ECO) shows the
SAME U19.3 fail - the failure is upstream of and independent of the bridge ECO.

**003C / D-275 is NOT invalidated.** Its post-processed, reproducible `BAT_PROTECTED_P` closure remains
proven evidence and is the **fixed solution to preserve into 003E** (`bridge_probe_003c` re-run: PASS).
003D fails production / full-driver promotion; it does NOT disprove D-275. The gating problem is now a
new, distinct blocker: **U19.3 pad escape**, not the D-270..D-274 western-BPP-trunk arc.

**Orchestration failure (accurately diagnosed - continuation loss, not engineering, not OWNER).** The
CTO launched the ecoC/ecoD passes with `nohup setsid ... &` from a ONE-SHOT turn, then ended with a
normal text response and NO `sessions_yield`, NO persistent waiter, NO completion callback tied to PIDs
274901 / 274902. The detached children survived and finished at 04:31 UTC (correct result JSONs), but a
process exit cannot itself re-awaken an already-ended turn, and the finalize ACP session had ended at
the wait boundary. **Repair discipline recorded:** the ACP/finalize task OWNS foreground work and
returns a completion event; the CTO uses `sessions_yield` and RESUMES from that event; NO unregistered
detached child batches.

**Delivered + regression.** Kept: the env-guarded driver hook (inert with `AQROOT_BRIDGE_ECO` unset -
the default), `bridge_eco_003d.py`, `bridge_gates_003d.py`, and the three result JSONs + ecoC/ecoD/
c3repro logs as evidence. **`bridge_probe_003d.py` was CONVERTED to pin the measured reproducible
FAIL** - as first authored it presumed a PASSING driver gate (`bridge_gates_003d_*.json` with
`pr40_eco 111111111`) that never existed because the ECO aborts; it now pins A the wired/ordered hook,
B single-sourced D-275 primitives, C cardinality-1 control-role vacate, D each `phaseA_003d_eco*.json`
records the FAIL (ECO abort AND N_POL U19.3 NO_LEGAL_ESCAPE) with NO false promotion, E 2-pass
determinism of the FAIL. **D-276 DRIVER BRIDGE PROBE: PASS.** The incomplete `ecoA`/`ecoB` scratch
logs (422 lines, no verdict, no result JSON) removed. `phaseA_journal.json` scratch churn restored to
HEAD.

**Suites ALL PASS and unregressed:** `router_regression` G1-G11, `bridge_probe_003d` (rewritten),
`bridge_probe_003c`, `via_array_probe`, `d264/d266/d267/d269/d270_probe`, `dru_probe`, `netclass_probe`.
**Nothing moved and nothing relaxed:** D9, U18, R75, R76..R83, Q3, the shunt, the FETs, TP17 and C58 all
frozen; `c3_00` NOT promoted; D-249..D-275 untouched; outer-1-oz / high-current policy unchanged; no
safety weakening; no topology/net change; no authoritative promotion. Authoritative PCB UNCHANGED - six
copper layers, **0 signal tracks, 0 signal vias**, no KiCad source mutated. **U19.3 is now the named
blocker;** Phase A NOT passed; Phase B NOT run. B-34 unchanged. **Next - FBV2-P2-003E:** a bounded
investigation of the U19.3 `N_POL` NO_LEGAL_ESCAPE holding the proven 003C vacate + F.Cu 4-via bridge
FIXED - distinguishing pad-escape geometry vs route-order/copper obstruction vs minimum placement ECO;
inspecting U19.3 / U19.2 / U19.4 / U19.6 and the board edge; analytic pad-escape + smallest real-router
probes; no broad placement search, no topology/net change, no safety weakening, no authoritative
promotion unless a later full gate passes. Full analysis:
[`audits/2026-08-28-p2-003d-d276-driver-bridge-fail.md`](audits/2026-08-28-p2-003d-d276-driver-bridge-fail.md).
**NO PROGRESS EARNED: PCB routing stays 0 %, overall stays 74 %.**

## 2026-08-28 - FBV2-P2-003C: D-275 the western-corridor vacate ECO + F.Cu via-array bridge is PROVEN; the BAT_PROTECTED_P trunk closes on real, reproducible copper

**PROVEN - a real-copper PASS, the first BPP trunk closure in the D-270..D-274 arc.** D-274 named
the next step: a bounded control-net vacate ECO to open a >=1.20 mm F.Cu lane, then route the bridge.
003C runs it on the reproduced c3 board and it **succeeds**: the minimum vacate is CARDINALITY 1 - one
low-current control branch, `BAT_PROT_SHDN_CTL`, moved off F.Cu to In3 - which opens a >=1.20 mm
(1.40 mm achieved) F.Cu corridor from `R75.2` to the eastern BPP NODE, and a real 4-via / 1.40 mm
F.Cu / 4-via bridge closes bit 8 `BAT_PROTECTED_P R75.2->U11.2`. The authoritative PCB is UNCHANGED -
six copper layers, **zero signal tracks, zero signal vias**; no KiCad source mutated. Starting HEAD
`1fa37e1`.

- **The board under test, reproduced.** `run_prefix_002z.py c3_00.json c3repro003c` yields
  `applied+asserted true`, `mismatch false`, `targets=111111101`, `u18=8`, `ledger 7/29`,
  `sense 13.811 mm`, `rc 0` - byte-consistent with D-274.
- **The F.Cu vacate cut-set study (`fcu_cutset_003c.py`).** Models the vacate of an INDIVIDUAL routed
  F.Cu BRANCH (connected component of one candidate net's F.Cu copper), never a whole net, never
  current-carrying/destination copper. Baseline re-measures D-274 exactly (flood dies at x=4.80 @1.20
  / 4.65 @1.50, reaches island: no). **GREEDY MINIMAL = cardinality 1: `BAT_PROT_SHDN_CTL`** - that
  ONE branch turns the R75.2->node A* from NO_PATH to PATH at both 1.50 and 1.20; cardinality-0 does
  not open, so 1 is the PROVEN minimum (reproduced on c3repro003b and 003c). D-274 named three
  crossings for the full-width straight corridor; only one branch discriminates because
  `BAT_PROT_SHDN_CTL`'s F.Cu is a 46 mm WALL (y 59.75..93.47), and removing it lets R75.2 detour to
  the OPEN node at x=38.5 (avoiding the D9 single-via link).
- **The real vacate + bridge (`bridge_route_003c.py`).** VACATE: the 6 F.Cu tracks of
  `BAT_PROT_SHDN_CTL` move to In3.Cu (its end transitions are already THROUGH vias, so continuity
  holds; In3 clear; In1/In4 are the GND planes, kept intact; a control net was never barred inner, so
  NO netclass rule). ENTRY: 4x 0.80/0.40 through vias on R75.2's own B.Cu pad (POFV, D-258), scanned
  clear + hole-legal against the existing U18.8 sense via, united by a 1.50 mm F.Cu bus, no B.Cu ties.
  TRAVERSE: 50.99 mm of 1.40 mm F.Cu, routed VIA-AWARE (`inject_vias` adds every board via as an
  all-layer obstacle at the 0.30 mm D-269 clearance QBoard otherwise skips; 1.50 mm is NO_PATH with
  strict via clearance, so the ladder takes 1.40 mm, above the 1.20 mm floor - the 1.50 mm target is
  honestly not reached). EXIT: 4x 0.80/0.40 through vias landing on the node's 1.20 mm B.Cu copper at
  (42.40,76.40), each tied by a >=1.20 mm stub - an ARRAY landing, no single via carries pack current.
- **The gates (save/reload KiCad, `bridge_gates_003c.py`).** PR-40 `111111101` -> `111111111`; bit 8
  CLOSED; U18 8/8; the vacated `BAT_PROT_SHDN_CTL Q4.1->R83.1` stays connected; BAT_SENSE/LTC_* no
  regression; DRC identical to baseline (0 new of any class); ratsnest 741->740 (-1). **VERDICT PASS**
  on every clause. Electricals: R_bridge ~18.9 mOhm (17.9 traverse + 0.44 two arrays); 42.5 mW / 28 mV
  at 1.5 A, 57.8 mW / 33 mV at 1.75 A - the B-34 cost, updated on promotion.
- **New regression `bridge_probe_003c.py`** (real copper + DRC): the vacated control net on In3
  ALLOWED; the trunk on In2/In3 REJECTED (D-264); a current-carrying role is never a vacate candidate,
  a control role is; the bridge board closes bit 8 with no new DRC / no regression. **PASS.**
- **NOT an owner decision.** Promotion to the authoritative product board requires driver integration
  of the vacate+bridge mechanism + promotion of the c3 placement through a full 2-pass Phase-A route
  (the D-271 reproducibility discipline); that is the next task, CTO/engineering scope. The
  authoritative product board is kept unrouted (routing is a driver output) and is left untouched.
- **Suites ALL PASS and unregressed:** `router_regression` G1-G11, `bridge_probe_003c`,
  `via_array_probe`, `d264/d266/d267/d269/d270_probe`, `dru_probe`, `netclass_probe`;
  `phaseA_journal.json` scratch churn restored. D9, U18, R75, R76..R83, Q3, the shunt, the FETs, TP17
  and C58 all frozen; `c3_00` NOT promoted; D-249..D-274 untouched. U19 NOT searched; Phase A NOT
  completed; Phase B NOT run. Full analysis:
  [`audits/2026-08-28-p2-003c-d275-vacate-bridge-proven.md`](audits/2026-08-28-p2-003c-d275-vacate-bridge-proven.md).
  **The western trunk blocker that stalled D-270..D-274 is BROKEN; no authoritative progress earned
  yet: PCB routing stays 0 %, overall stays 74 %.**

## 2026-08-28 - FBV2-P2-003B: D-274 the bounded F.Cu high-current via bridge is disproved; the western margin is saturated on F.Cu exactly as on B.Cu

**BRIDGE-PROOF CLOSEOUT - a measured FAIL.** D-273 named the next step: a bounded named-path F.Cu
high-current via bridge for `BAT_PROTECTED_P`. 003B investigates it on the reproduced c3 board (U18 8/8,
trunk open) with evidence-based via-array sizing and real obstacle-aware searches, and it **fails**: the
two via-array transitions are individually feasible, but the F.Cu traversing segment between them does
not exist at the mandatory >=1.20 mm floor. The authoritative PCB is UNCHANGED - six copper layers,
**zero signal tracks, zero signal vias**; no KiCad source mutated. Starting HEAD `624f085`.

- **The board under test, reproduced.** `run_prefix_002z.py c3_00.json c3repro003b` yields `applied+asserted
  true`, `mismatch false`, `targets=111111101`, `u18=8`, `ledger 7/29`, `sense 13.811 mm`, `returncode 0`
  - byte-consistent with D-273. Measured islands (KiCad `GetConnectedItems`): TARGET `{D9.1,C25.1,C36.1,U11.2}`
  (D9.1 already tied to U11.2 via the C25/C36 F.Cu cap copper through two SINGLE 0.80/0.40 vias); SOURCE
  `{R75.2,U18.8}` - a 1.14 mm B.Cu stub at x=2.80. Bit 8 is open only because these two islands are ~8 mm apart.
- **Via-array sizing (board's own IPC-2221B, calibrated).** `via_array_003b.py`: reproduces the DRU's
  BAT_MAIN outer 0.525 mm exactly; a 0.40/25um through-via barrel as an INTERNAL FR4 conductor carries
  **1.055 A at 10 K** (conservative). For 1.75 A validation: ideal 2, **fault-tolerant floor 3** (3.17 A;
  lose one open via -> 2.11 A > 1.75 A), **design 4** (hottest via +6.5 K under 2:1 imbalance). Array R:
  N3 0.293, N4 0.220 mOhm.
- **The measurement.** `bridge_feasibility_003b.py`: **ENTRY feasible** - a 4-via array fits on R75.2's
  1.225x3.35 mm pad at 0.9 mm pitch, all copper layers clear, F.Cu empty within 3.5 mm (via-in-pad ->
  plated-over-filled, D-258 POFV precedent); **EXIT feasible** - 4-via arrays land on the node (527/855
  free sites) and a 3-via on the D9 stub; **TRAVERSE IMPOSSIBLE at >=1.20 mm** - an F.Cu full-width flood
  from R75.2 dies at **x=4.80 mm** (@1.50 4.65, @1.00 4.95, @0.80 11.6; island west edge x=10.05), and
  full-budget A* R75.2->node returns **NO_PATH at 1.20 AND 1.50 mm by region exhaustion (0.5-0.6 s)**.
  Blocker: the LTC_GATE x=5.75 vertical, the BAT_PROT_SHDN_CTL diagonal, and the BAT_RAW y=72.45 run in
  the x 4.8..11 / y 66..73 window. The 0.80 mm escape is recorded, not used - below the mandatory 1.20 mm
  trunk floor, which this task may not waive.
- **This tightens D-273:** the western margin cannot host a >=1.20 mm high-current trunk on EITHER outer
  layer - the saturation is in the plane, on both faces. The pre-existing D9->node single-via link is
  flagged as a latent bottleneck for any future stub-landing bridge.
- **Regression added.** `via_array_probe.py` pins the via-array sizing contract and REJECTS undersized
  (single-/two-via) transitions - the electrical half of the bridge guard; the overbroad/bounding-box/
  foreign-net geometric half is already carried by `dru_probe` corridor_checks. **PASS.**
- **CTO recommendation:** a bounded western-corridor control-net vacate ECO - re-route the three named F.Cu
  control crossings off the x 4.8..11 / y 66..73 window to open a >=1.20 mm F.Cu bridge lane, then route
  the bridge measured here. CTO/engineering scope (the D-270 class), NOT an owner call.
- **Suites ALL PASS and unregressed:** `router_regression` (G1-G11), `via_array_probe` (new),
  `d264/d266/d267/d269/d270_probe`, `dru_probe`, `netclass_probe`. `phaseA_journal.json` scratch churn
  restored. D-249, D-264, D-266, D-267, D-269, D-270, D-271, D-272, D-273 untouched; outer-1-oz / zero-via
  high-current policy unchanged; BAT_MAIN clearance not weakened; `c3_00` NOT promoted. **U19 NOT SEARCHED;
  Phase A NOT passed; Phase B NOT run; converter routing NOT started. B-34 REMAINS OPEN. NO PROGRESS
  EARNED: PCB routing stays 0 %, overall stays 74 %.** Full analysis:
  [`audits/2026-08-28-p2-003b-d274-fcu-bridge-disproved.md`](audits/2026-08-28-p2-003b-d274-fcu-bridge-disproved.md).

## 2026-08-28 - FBV2-P2-003A: D-273 the long outer-B.Cu zero-via route is disproved; next is a bounded F.Cu high-current via bridge

**ROUTING-PROOF CLOSEOUT - a measured FAIL.** D-272 sent the trunk question into a bounded routing proof:
test the reservation-dependent LONG outer-B.Cu route for `BAT_PROTECTED_P` BEFORE any F.Cu via bridge,
because it keeps the trunk on outer 1 oz with zero current-carrying vias. 003A runs it on the proven c3
board (U18 8/8, trunk open) and it **fails**: no long outer-B.Cu **zero-via** corridor carries
`BAT_PROTECTED_P` from `R75.2` to the eastern node copper at the **1.50 mm target or the 1.20 mm floor**.
The authoritative PCB is UNCHANGED - six copper layers, **zero signal tracks, zero signal vias**; no
KiCad source mutated. Starting HEAD `1a82652`.

- **The board under test, reproduced.** `w/c3repro003a_parent` = AUTHORITATIVE placement + pinned
  `c3_00.json` recipe via `run_prefix_002z.py`; the committed reproduction triple confirms U18 8/8,
  `targets=111111101`, `sense 13.811 mm`, `applied+asserted true`, `mismatch false`, `returncode 0`,
  and `BAT_PROTECTED_P R75.2->U11.2 = false` (the one open connection). Not a new placement.
- **The measurement (bounded families).** `long_corridor_003a_bounded.py` -> `long_corridor_003a_bounded.json`,
  re-run and reproduced byte-identically. `occ_003a.py` shows exactly ONE connected central free channel
  (x~13..38 mm) between the western margin and the node west edge, so the channel is not the
  discriminator - the ESCAPE LATITUDE is; three thinnest latitudes (north/mid/south) = F1/F2/F3, plus F4
  the D9-reservation exit; east is the node, west is the board edge, no fourth family. **Control
  `R75.2->D9.1`: @1.50 NO_LEGAL_ESCAPE, @1.20 NO_PATH. F1/F2/F3/F4 ALL FAIL both widths** - @1.50 `R75.2`
  cannot leave its pad at 1.5 mm; @1.20 it escapes ~2.7 mm to (5.5,67.95) then the first traversal out of
  the western mass is COARSE_BLOCKED; F4 COARSE_BLOCKED both. `legal B.Cu long corridor: NONE`.
- **The corroboration (full budgets, no coarse prefilter).** A 0.25 mm coarse grid can OVER-block, so
  COARSE_BLOCKED alone is not proof. `long_corridor_003a_corrob.py` runs the SAME `QR.connect_role` the
  router uses for the trunk, `R75.2` -> four node-copper points, at DEFAULT FULL budgets (ASTAR=500000,
  WAVE=3000), no prefilter, 120 s/trial cap. **All 8 trials FAIL:** @1.50 NO_LEGAL_ESCAPE (target-
  independent), @1.20 NO_PATH after a **48-62 s reachable-region exhaustion** (not a timeout). The long
  route is disproved by the router's own search, not just a coarse gate.
- **`c3_00` remains EVIDENCE ONLY, NOT promoted** to placement or authoritative copper; its bit 8
  `BAT_PROTECTED_P R75.2->U11.2` stays open. This is a measured FAIL, not analytic; no result is presented
  as a routed PASS.
- **This is NOT an OWNER decision.** The long-route proof was the gate D-272 set, and it has now run. The
  **next technical task is a bounded named-path F.Cu high-current via-bridge investigation** - evidence-
  based via-array sizing (inner layers are 0.5 oz, ~2.73 mm for 1.5 A at 10 K by the board's own
  `.kicad_dru`, so an array not one via) + full safety / DRC / connectivity gates. **NOT implemented or
  tested in 003A.**
- **Delivered.** the bounded probe + the full-budget corroboration + three read-only geometry helpers
  (`inspect_003a.py`, `occ_003a.py`, `joins_003a.py`); the naive un-bounded first draft
  `long_corridor_003a.py` is RETAINED as the documented rejected approach (its first east trial burned
  >18 min, rc130 - what motivated the bounded redesign); and **new regression G11** pinning the bounded-
  search contract on the AUTHORITATIVE board (a tiny budget must BOUND the search - prompt NO_PATH, no
  copper, no raise; the probe budget ASTAR=60000/WAVE=1200 must NOT fabricate a FAIL - still routes a
  routable short trunk; budgets saved/restored, no rule changed) - **4/4 PASS**.
- **Suites all PASS and unregressed:** `router_regression` ALL CHECKS incl. G1-G9 + G10 + G11,
  `d264/d266/d267/d269/d270_probe`, `dru_probe`, `netclass_probe`. `phaseA_journal.json` scratch churn
  restored.
- Full analysis: [`audits/2026-08-28-p2-003a-d273-long-route-disproved.md`](audits/2026-08-28-p2-003a-d273-long-route-disproved.md).
- **No progress earned:** PCB routing stays 0 %, overall stays 74 %. B-34 open. Nothing moved, nothing
  relaxed; D-249/D-264/D-266/D-267/D-269/D-270/D-271/D-272 untouched; high-current outer-1-oz / zero-via
  policy unchanged. U19 NOT searched; Phase A/B NOT run.

## 2026-08-27 - FBV2-P2-002Z: D-272 western-margin placement scope is exhausted; the first reproducible U18 8/8 does not close the BPP trunk

**PLACEMENT-SCOPE CLOSEOUT.** Bounded battery-block placement was **CTO authority (D-249...D-271) and
is now EXHAUSTED**. Across a full cardinality ladder no legal fan-8 placement makes the analytic
western `BAT_PROTECTED_P` trunk reach even **0.80 mm** on B.Cu, and none closes target bit 8
(`BAT_PROTECTED_P R75.2->U11.2`) in a supervised run. The authoritative PCB is UNCHANGED - six copper
layers, **zero signal tracks, zero signal vias** (verified: `pcbnew` load 6 layers / 0 tracks / 0 vias;
`kicad/` tree byte-for-byte HEAD). Starting HEAD `016aeee`.

- **The cardinality ladder, exhaustive.** baseline (U18 authoritative pose alone) **6/8** (`U18.7`+
  `U18.8` open); **c1** (one component) **ceiling 7/8** - no single move lands all of {7,8,2}; **c2**
  (R75+U18, 5 supervised) **ceiling 7/8 AND target bit 8 FALSE in all five** - the trunk routes freely
  at 1.50 mm (13.12 mm) with NO fanout but is dead at every width down to 0.40 mm once the 8-pin fanout
  is laid, so the binder is the whole fanout band saturating the board-edge-bounded west margin, not
  one obstacle; **c3** (R75+U18+one divider, 4 supervised) delivers the **first reproducible U18 8/8**
  (`c3_e10n_r79`/`c3_00`: R75 `[2.8,65,270]`, U18 `[4.0,72.9,90]`, R79 east `[9.825,67.825,0]`, targets
  `111111101`, ledger 7/29, sense 13.811 mm, returncode 0, applied+asserted true) - the unique lever of
  243 candidates, widening the analytic trunk 0.40->0.80 mm - **but target bit 8 is FALSE in all four**
  and the 8/8 is knife-edge (a 0.5 mm U18 x-shift re-opens `U18.7`); **c4** the last placement family,
  a bounded-exhaustive **705-pose U18-pose vacate sweep**, returns **NEGATIVE** (102 fan-8 mech-clean
  poses, `trunk_best_w` only ever 0.40 mm or dead, **zero reach 0.60 mm let alone the 1.20 mm floor**).
- **`c3_00` is accepted as EVIDENCE ONLY** - the first reproducible U18 8/8 - and is **NOT promoted** to
  the authoritative placement or to authoritative copper; its bit 8 `BAT_PROTECTED_P R75.2->U11.2`
  remains open.
- **Conclusion.** The west margin cannot host U18 8/8 AND the current-carrying `BAT_SENSE` path AND a
  >=1.20 mm B.Cu trunk at once - it is saturated **in the plane, not along a length**. Closing bit 8
  requires leaving the margin, a routing/topology move, not a placement ECO.
- **This is NOT an OWNER decision, and it SUPERSEDES D-271's owner-escalation framing.** The
  placement-change half D-271 offered was CTO authority all along and is now spent to exhaustion. The
  **next technical task tests the reservation-dependent LONG outer B.Cu route FIRST** (preserves outer
  1 oz and the high-current zero-via policy; ~2.29x trunk resistance / ~18.9 mW extra at 1.5 A is an
  engineering tradeoff to **verify**, not escalate). The **F.Cu high-current via bridge remains a
  DEFERRED FALLBACK, not authorized** - the via-policy question reaches the owner only if the long-route
  proof fails.
- **Delivered.** three analytic prefilters (`place_search_002z.py`, `place_search_c3_002z.py`,
  `place_search_c4_002z.py`) + the pinned arbiter `run_prefix_002z.py`; a **generalized process-unique
  DRC transient fix** in `path_role_util.py` (`RU.drc` wrote a FIXED-name transient that concurrent
  same-phase search prefixes on a shared WORK clobbered - now `drc_%s_%d.json % (tag, os.getpid())`,
  reclaimed after the read, **no routing result and no single-run output change**); and **new regression
  G10** whose guard IS the collision (two processes, shared WORK, same fixed tag; both must return the
  authoritative baseline histogram and neither may raise) - **4/4 PASS**.
- **Suites all PASS and unregressed:** `router_regression` ALL CHECKS incl. G1-G9 + G10,
  `d264/d266/d267/d269/d270_probe`, `dru_probe`, `netclass_probe`. `phaseA_journal.json` scratch churn
  restored.
- **No long B.Cu route and no F.Cu via bridge attempted** - both are next-task routing work.
- Full analysis: [`audits/2026-08-27-p2-002z-d272-placement-exhausted.md`](audits/2026-08-27-p2-002z-d272-placement-exhausted.md).
- **No progress earned:** PCB routing stays 0 %, overall stays 74 %. B-34 open. Nothing moved, nothing
  relaxed; D-249/D-264/D-266/D-267/D-269/D-270 untouched; high-current outer-1-oz / zero-via policy
  unchanged.

## 2026-08-27 - FBV2-P2-002Y: D-271 the 002W prefix is pinned and deterministic; the "proven 8/8" board is not reconstructible from committed code

**DECISION STOP.** The reproduction gap FBV2-P2-002X flagged is resolved as a **reproducibility
defect, not a router defect**. The 002W qualification prefix is now **pinned and self-describing**
(`prefix_002w.py` + `prefix_002w_manifest.json`), and the "proven 8/8" board is shown, with
evidence, to be **not reconstructible from the committed code**. The authoritative PCB is UNCHANGED -
six copper layers, zero signal tracks, zero signal vias; 002Y changes no routing code and no rule.
Starting HEAD `8725eea`.

- **The site drift is recipe non-pinning, not a clearance interaction.** On the AUTHORITATIVE
  placement the pinned recipe reserves `U18.8` at **(3.000, 71.600)** on both the scored and the
  nearest-exit attempt, and does so IDENTICALLY at commit `798d0ae` (002T), `6ebb009` (002U) and
  `8725eea` (HEAD). D-269's clearance rewrite (`6edc34a`) is therefore **not** the cause - the
  pre-D-269 code selects the same site. `reserve_escape`, the reservation plan and its order are
  byte-identical across 002T→HEAD; there is no tie-break instability and no state leakage
  (`RU.fresh` rebuilds from the authoritative source every run). **This supersedes 002X's
  "D-269-clearance / reservation-scoring interaction" attribution.**
- **The placement trap.** `RU.fresh` copies the AUTHORITATIVE board; `AQROOT_ECO_002F=1` silently
  swaps a placement differing in nine parts (`U18@3.000,72.400` vs `U18@8.000,65.250`, `R76..R83`).
  The guard is the driver's own `AQROOT_EXPECT_PLACEMENT=AUTHORITATIVE`, now pinned into the recipe -
  it refuses to route on the wrong board.
- **The site is the sole candidate and not the blocker.** Instrumented, `U18.8` has exactly one via
  candidate - (3.000, 71.600) - and laying it seals no sibling at reservation time; `U18.7` is sealed
  later, cumulatively. Forcing (3.750, 71.600) is DRC-illegal here (`solder_mask_bridge`,
  `shorting_items`, `clearance`) and `U18.7` stays blocked anyway.
- **The "3.750 / 8-of-8" board is not reconstructible.** The 002T audit records `BAT_SENSE
  Q3.6→R75.1` 13.532 mm, `R75.2` via (1.200, 65.700), U18 8/8; the committed code produces 18.200 mm,
  (2.800, 63.200), U18 6/8 - and reproduces those even at the 002T commit. The audited board's recipe
  is lost. Checked against git history and stored JSON with bounded scratch runs at three commits -
  not handwaved.
- **The true blocker, on a reproducible board.** The 18.200 mm sense path is the current-carrying
  diagonal wall (6.75,62.45)→(2.80,66.40) 002X named; here it is `U18.7`'s casualty, one pad west of
  the trunk's. No legal reservation site and no low-current offload set opens 8/8. This **confirms and
  tightens** 002X's `BAT_SENSE`-blocker conclusion on a deterministic board, and bounds it: the trunk
  question is not even reachable at 8/8.
- **Delivered.** `prefix_002w.py` - a one-command pinned regression with two gates: DETERMINISM
  (PASS; the board reproduces `prefix_002w_manifest.json`, so a future task cannot unknowingly study a
  different board) and GOVERNED GOAL (FAIL by design - U18 6/8 with `U18.8` at the blocking site;
  "must fail when U18.8 lands at the blocking site or U18 drops below 8/8").
- **No real B.Cu trunk attempted** - the prefix it must sit on is not 8/8, and a trunk on a 6/8 board
  would be a manufactured pass.
- **Suites all PASS and unregressed:** `d264/d266/d267/d269/d270_probe`, `dru_probe`,
  `netclass_probe`, `router_regression`.
- **Decision required (OWNER):** accept the western margin is oversubscribed at current-carrying
  roles and take the protection-architecture route (F.Cu via-array bridge, or the 2.29× long B.Cu
  route), or authorise a placement change to widen it. Neither taken.
- Full analysis: [`audits/2026-08-27-p2-002y-reproduction.md`](audits/2026-08-27-p2-002y-reproduction.md).
- **No progress earned:** PCB routing stays 0 %, overall stays 74 %. B-34 open. Nothing moved,
  nothing relaxed; D-249/D-264/D-266/D-267/D-269/D-270 untouched; high-current policy unchanged.

## 2026-08-27 - FBV2-P2-002X: D-270 path-role offload delivered and proven; the western-margin trunk blocker is current-carrying, not low-current

**DECISION STOP.** The D-270 offload mechanism is delivered and regression-proven, but the
offload does not open the trunk: measured by individual path role, the binding blocker of
`R75.2 -> D9.1` is the **`BAT_SENSE` 1.00 mm shunt current path**, which D-270 correctly
refuses to move. The authoritative PCB is UNCHANGED - six copper layers, zero signal tracks,
zero signal vias. Starting HEAD `6edc34a`.

- **D-270(a):** *"Western-margin offload candidate selection shall be by individual CURRENT
  PATH ROLE / ROUTED BRANCH, not whole net or net class. A bounded LOW-CURRENT / TAP branch on
  `BAT_RAW` or `BAT_MAIN` may be offered In2/In3 offload despite its power net name."* Offload
  is the fifth property to follow path role, after D-249 width, D-264 layer, D-267 via geometry
  and D-269 clearance - and it closes the candidate-list gap D-269's own audit named.
- **Mechanism.** `path_role_dru.INNER_OFFLOAD_AREAS` adds the authorised bounded corridors to
  the exact D-264 In2/In3 exclusion the two Kelvin sense corridors already carry; the router
  (`battery_route_plan.D270_SETS` + the offload block in `route_battery_block.run_once`) hops
  the named branch `B -> In2/In3 -> B` on the smallest via its netclass admits - the D-267
  0.65/0.40 POWER via, never the trunk's 0.80/0.40. Every current-carrying role is untouched.
- **New standing regression `d270_probe.py`** - real copper on the six-layer board, eleven
  clauses, **PASS**: a `BAT_RAW` bridge on In2 and In3 inside its corridor is ALLOWED; the same
  copper with no corridor is REJECTED; the trunk and the `BAT_SENSE` current path on In2 are
  REJECTED; **the bridge in its corridor but WITHOUT the D-270 authorisation is REJECTED**; the
  D-264 sense corridors are unregressed; **no width, clearance, via, hole or GND rule changes.**
- **The offload study is by individual branch, never whole-net.** `offload_probe_002x.py`
  records the B.Cu each `(net, a, b)` connection lays (router `AQROOT_BRANCH_TRK`) and cuts one
  routed branch at a time. **17 low-current branches sit in the trunk corridor; NO offload set
  of any cardinality opens `R75.2 -> D9.1` at >=1.20 mm.** The one cut that opens it removes
  **`BAT_SENSE`** - the 1.00 mm shunt CURRENT path `Q3.6 -> R75.1`, running between `R75.2` and
  `D9.1`. It is current-carrying; D-270 forbids offloading it (0.5 oz needs 2.73 mm for 1.5 A).
- **The real harness confirms it.** `AQROOT_D270=BRIDGES`: the bridges leave B.Cu, but the
  trunk is still GATE_REJECTED on the D-269 clearance - `0.3000 mm required; actual 0.2500 mm`
  - against `BAT_SENSE`. This is the D-263 tension localised by path role: the two roles that
  collide in the margin, the trunk and `BAT_SENSE`, are BOTH current-carrying.
- **Bounded by a reproduction gap, stated plainly.** The 002W 8/8 prefix (`probe_002w_W3.json`,
  `111111111`) does not reproduce at HEAD - every recipe lands at U18 6/8 or 7/8, `U18.7` the
  invariant casualty, because the D-266 `U18.8` reservation via lands at (3.000, 71.600) not
  the 002T-proven (3.750, 71.600). D-269 §6's `control+BAT_RAW -> 1.50 mm` was measured on that
  8/8 board; on every prefix reproducible at HEAD it takes `BAT_SENSE` too.
- **Decision required:** (a) reproduce the 8/8 prefix by resolving the `U18.8` reservation-site
  interaction, then re-measure - in scope for a follow-up; **or (b) accept that the margin
  cannot host both the `BAT_SENSE` current path and a >=1.20 mm trunk on B.Cu**, and take the
  F.Cu via-array bridge or the long B.Cu route (2.29x resistance) - an OWNER call, as 002W and
  D-268 framed.
- **Suites all PASS and unregressed:** `d270_probe` 11/11, `d264_probe`, `d269_probe`,
  `dru_probe`, `netclass_probe`, `router_regression` G1-G9. Authoritative DRC unchanged;
  scratch pass-1 screen is baseline + one dangling via (a screen, not a passed Phase A).
- **Nothing moved and nothing else relaxed.** TP17 and C58 frozen; D-249/D-264/D-266/D-267/
  D-269 untouched. **U19 NOT SEARCHED; Phase A NOT passed; Phase B NOT run; converters NOT
  started.** B-34 remains open. Full analysis:
  [`audits/2026-08-27-p2-002x-d270-offload.md`](audits/2026-08-27-p2-002x-d270-offload.md).

## 2026-08-27 - FBV2-P2-002W: D-269 path-role clearance closes BAT_RAW; no control-offload cut set exists

**DECISION STOP** (section 25). **`BAT_RAW` is one functional island for the first time.**
The authoritative PCB is UNCHANGED - six copper layers, zero signal tracks, zero signal vias.

- **D-269(a):** *"BAT_MAIN 0.300 mm routed clearance is a CURRENT-PATH-ROLE requirement, not
  an entire-net-name requirement."* Clearance is the fourth and last property to get what
  D-249 gave width, D-264 gave layer and D-267 gave via geometry.
- **0.300 mm is untouched on every current-carrying role.** The exclusion reaches four bounded
  corridors grown from the divider chain's own copper; inside them the **existing** rules
  govern - the board default **0.200 mm**. No new clearance number was invented.
- **One corridor per branch, not one per chain** - `enclosedByArea` honours only the first
  outline of a multi-outline rule area. **And a bounded TAP corridor must carry its width
  allowance too**: naming it for the clearance exclusion took away the anonymous `BAT_STUB`
  that had been carrying the width, and the copper came back as `track_width (rule 'BAT_MAIN
  minimum width')`.
- **New standing regression `d269_probe.py`** - real copper on two different BAT_MAIN-class
  nets, six clauses, **PASS**. (The first version used two same-net tracks and saw nothing:
  clearance is a between-nets rule.)
- **`BAT_RAW` CLOSES.** `R77.1 -> R79.1` routes **12.454 mm at 0.20 mm on F.Cu with 2 vias at
  the legal 0.65/0.40**; all eleven functional pads in one island, only `TP16` outstanding.
  No inner-layer exception, no clearance or hole relaxation. The proven prefix reproduces
  alongside: **U18 8/8, Kelvin A 7.644 / B 9.927 / mismatch 2.283 mm on In2.**
- **And no control-offload cut set exists.** Every subset of the seven control nets carrying
  B.Cu copper was tested by virtual removal at 1.20 and 1.50 mm - 7 singles, 21 pairs, 35
  triples, 35 four-sets, 21 five-sets, 7 six-sets, and the full seven - **not one opens a
  1.20 mm corridor.**
- **The reason is this task's own doing, and it is said plainly:** `R80.1 -> Q2.7`
  (0.50 mm x 29.022 mm) and `D12.1 -> R77.1` (0.60 mm x 14.637 mm) are now in the margin.
  **All seven control nets AND `BAT_RAW` removed = 1.50 mm at 19.9 mm**; anything less is
  0.60 mm at best. Those two runs are microamp TAP copper on a power-named net - section 9
  excluded power nets **by net class**, but **by path role** they are exactly what section 13
  would have moved.
- **Decision required:** extend the offload candidate set from net class to path role (needs
  an explicit ruling - section 6 forbids a `BAT_RAW` inner exception), or accept that the
  western margin cannot host both the control field and a >=1.20 mm trunk. **`BAT_RAW`'s
  closure should not be given back.**
- Zero new DRC classes, zero track_dangling, zero via_dangling. All eight suites PASS. No
  placement ECO, no signal copper, TP17 and C58 untouched. D-264/D-266/D-267 untouched.
- **No progress earned: PCB routing stays 0 %, overall stays 74 %.**
  See [`CTO_DECISIONS.md`](CTO_DECISIONS.md) D-269 and
  [`audits/2026-08-27-p2-002w-d269-clearance.md`](audits/2026-08-27-p2-002w-d269-clearance.md).

## 2026-08-27 - FBV2-P2-002V: D-268 - the western partition is routed control copper, not placement

**DECISION STOP** (sections 19 and 24). The authoritative PCB is UNCHANGED - six copper
layers, zero signal tracks, zero signal vias.

- **D-268:** *"The high-current BPP trunk remains on outer 1 oz copper with zero vias. The
  first placement lever for the severed western B.Cu plane is TP17, a non-functional test
  point routed last. C58 may move only if TP17-alone is measured insufficient.
  Inner-layer/high-current-via bypass is not authorized."*
- **The lever was aimed at the wrong thing, and one cheap measurement proved it.** Removing
  TP17, C58, TP15 - entirely, not relocating them - from the finished 002U board changes
  `R75.2 -> D9.1` at **no width from 1.50 down to 0.20 mm**. Neither is on the cut.
- **The cut is routed control copper.** By net: `LTC_OV` (27 B.Cu shapes) removed restores
  0.60 mm; **all LTC control (77 shapes) removed restores 1.50 mm at 30.561 mm**; all routed
  B.Cu removed gives back the 19.878 mm clean-board route. No single control net opens it to
  trunk width.
- **TP17 was searched and replayed anyway.** 20 legal poses outside the current corridor;
  selected **(17.000, 79.000), 5.408 mm**, same layer/net/footprint/region. The full prefix
  reproduces - **U18 8/8, all nine targets, Kelvin A 7.644 / B 9.927 / mismatch 2.283 mm on
  In2** - and the trunk is still `NO LEGAL ESCAPE at >= 1.200 mm`. **The blocker list went
  from `track (x37), R77.2 (x8), TP17.1 (x5)` to `track (x42), R77.2 (x8), R78...`: TP17 left
  the list and the trunk did not move.** It did open a 0.60 mm / 53.916 mm path - below the
  floor, so not a trunk.
- **C58 characterized and NOT moved:** 1 uF 25 V X7R 0603, `C58.1` on `BAT_PROTECTED_P`
  **4.009 mm from `D9.1`** with the bulk caps 50 mm away - local HF decoupling for the
  protected node. Section 9's search was not spent, on measured grounds.
- **BAT_RAW half closed:** `R79.1 -> R80.1` routes (4.532 mm, F.Cu, 2 vias at the legal
  0.65/0.40); **`R77.1 -> R79.1` still fails on `BAT_MAIN routed clearance`**. Microamp taps
  are held to the high-current clearance because they share a net name - D-249 fixed width,
  D-264 layer, D-267 via geometry; **clearance is the fourth and last property still scoped by
  net name.** Raised, not taken.
- **The long outer trunk is not available either:** `D9.1 -> R75.2` is `NO_LEGAL_ESCAPE` at
  1.50 and 1.20 mm - that exit exists only with the D-267 reservation. Comparison recorded:
  short 19.878 mm @1.50 = **6.53 mOhm / 9.79 mV / 14.7 mW** at 1.5 A; long 45.467 mm @1.50 =
  **14.93 mOhm / 22.40 mV / 33.6 mW** - **2.29x the resistance**.
- Zero new DRC classes, **zero track_dangling, zero via_dangling**. All seven suites PASS.
  No placement ECO, no signal copper written; no rule relaxed anywhere. D-264/D-266/D-267
  untouched. U19 NOT searched; Phase A and Phase B NOT run.
- **No progress earned: PCB routing stays 0 %, overall stays 74 %.**
  See [`CTO_DECISIONS.md`](CTO_DECISIONS.md) D-268 and
  [`audits/2026-08-27-p2-002v-d268-tp17.md`](audits/2026-08-27-p2-002v-d268-tp17.md).

## 2026-08-27 - FBV2-P2-002U: D-267 D9 exit reservation and TAP path role; Kelvin B fixed; trunk stops on a severed plane

**Section 25 DECISION STOP.** Two of 002T's three failures close. The authoritative PCB is
UNCHANGED - six copper layers, zero signal tracks, zero signal vias.

- **D-267:** *"An early high-current escape reservation is permitted only for D9.1, at the
  existing BPP trunk target/floor, outer-layer-only and zero-via. It preserves the pad exit
  without completing the current path early."*
- **The reservation works on its own terms.** `D9.1` escapes at 1.50 mm in SIX directions on a
  clean board. Staging families are prefixes of the measured clean-board trunk (19.878 mm at
  1.50 mm). **F1 reserved 2.701 mm and F2 5.149 mm, both at the 1.50 mm target, B.Cu, zero
  vias, and neither cost a control pin - U18 stayed 8/8 on both.**
- **`track_dangling` joins `via_dangling`** as a class absorbed only while a reservation is
  outstanding; the final board must carry neither.
- **KELVIN B IS FIXED by section 11 alone.** `join_reserved` tries the 25 um lattice first and
  keeps the shorter run. **A 7.989 -> 7.644 mm, B 10.456 -> 9.927 mm (inside the cap),
  mismatch 2.467 -> 2.283 mm.** Same via sites, same corridor - measured more carefully, not
  relaxed.
- **TAP path-role via correction delivered, and the board narrowed it.** Via geometry now
  follows the PATH ROLE. A TAP on a POWER net cannot have a small via: 0.35/0.20 fails
  `via_diameter`, 0.50/0.25 fails `drill_out_of_range`, 0.50/0.40 fails `annular_width` - all
  three rejections correct. **0.65/0.40 is the floor**, outer layers only. With it
  **`R79.1 -> R80.1` routes (4.532 mm)** and `D12.1 -> R77.1` improves from 28.058 mm at
  0.60 mm to **13.682 mm at 0.30 mm on B.Cu with zero vias**. Forbidding the hop outright was
  tried first and measured WORSE than 002T.
- **THE TRUNK STOPS ON A SEVERED PLANE.** `R75.2` escapes at 1.50 mm, the staging point
  escapes at 1.50 mm, and **there is no B.Cu corridor between them at 1.50 / 1.20 / 1.00 /
  0.80 / 0.60 / 0.40 / 0.30 / 0.20 mm.** After the control field the control copper partitions
  B.Cu in the western margin. Nothing that reserves a pad can repair that.
- **And the obvious next hypothesis is measured false:** trunk EARLY, with the D-266
  reservations in place, routes 19.219 mm at 1.20 mm and takes **U18 to 5/8** (`U18.3`,
  `U18.7`, `U18.9` open). Reserving the sense exits does not make an early trunk affordable.
- **Decision required, three options, none this task's to take:** a bounded layer exception
  for the trunk where it crosses the pin field; move `TP17`/`C58` out of the western margin;
  or accept a ~2.3x longer trunk that leaves the margin entirely.
- New standing regression `d267_probe.py` (19 checks). All suites PASS. No placement ECO, no
  signal copper written, no netclass / clearance / annular / hole rule relaxed anywhere.
  D-264 and D-266 untouched. U19 NOT searched; Phase A and Phase B NOT run.
- **No progress earned: PCB routing stays 0 %, overall stays 74 %.**
  See [`CTO_DECISIONS.md`](CTO_DECISIONS.md) D-267 and
  [`audits/2026-08-27-p2-002u-d267-d9-reservation.md`](audits/2026-08-27-p2-002u-d267-d9-reservation.md).

## 2026-08-27 - FBV2-P2-002T: D-266 SCARCE-PAD RESERVATION; U18 8/8 INCLUDING BOTH KELVIN PINS; gate fails on the trunk alone

**A - D-266 delivered and proven. B - decisive local gate: FAIL, on the trunk.**
The authoritative PCB is UNCHANGED - six copper layers, zero signal tracks, zero signal vias.

- **The premise is measured.** On a clean board at the frozen placement NOT ONE of the four
  scarce sites is scarce: `Q3.6` escapes at 1.50 mm / 3 dir, `R75.1` 1.50 / 5, `R75.2`
  1.50 / 3, `U18.9` / `U18.8` / `U18.2` 0.25 / 2 each, every one with a 0.35/0.20 through-via
  site reachable within 0.890-1.375 mm. Every scarcity 002M-002S reported was made by copper
  laid earlier.
- **`Q3.5 -> Q3.6` 3.770 mm and `Q3.6 -> R75.1` 13.532 mm**, both at the 1.00 mm target on
  B.Cu with **zero vias**, when routed first.
- **Kelvin exits reserved, both ends of a branch as one gated item** - a 0.20 mm neck plus one
  ordinary 0.35/0.20 through via, no microvia / blind / buried / POFV. A reservation is judged
  by an **inverted gate**: DRC gains no class and the ratsnest must NOT move. It is never
  counted as a route.
- **U18 8 of 8, `U18.8` and `U18.9` CONNECTED, all nine PR-40 targets true - a first.**
  `LTC_GATE` 6/6, `LTC_SHDN`, `LTC4368_FAULT_N` 4/4, `LTC_OV` (B.Cu, zero vias), `LTC_UV`,
  `Q3_CS`, `Q2_CS`, `BAT_MID` all one component. **One control schedule was needed, not six.**
- **Paired inner Kelvin built on In2, both branches, no F.Cu fallback:** A 7.989 mm / 2 vias,
  B 10.456 mm / 2 vias, **mismatch 2.467 mm (inside the 5.000 mm limit)** - and **branch B is
  0.456 mm over the 10.000 mm cap**, reported as a failure.
- **`holes_co_located` is gone.** `BAT_PROT_SHDN_CTL Q4.1 -> R83.1` closed at 41.814 mm,
  0.15 mm, F.Cu + 2 ordinary vias, no new clearance exception. `BAT_RAW R79.1` is split because
  a ruled microamp tap is asked for a wide-net 0.80 mm via - raised, not fixed.
- **The trunk is the whole remaining failure:** `R75.2 -> D9.1` = `NO LEGAL ESCAPE at
  >= 1.200 mm; blocked by track (x37), R77.2 (x8), TP17.1 (x5)`. Zero corridor families were
  generated because the failure is at `D9.1`'s escape, before a corridor question exists.
- **Section 23 not triggered; Q3 does not move.** `BAT_SENSE` carries `Q3.5`, `Q3.6`, `R75.1`
  and `U18.9` in one functional island with the full control field and both Kelvin branches on
  the board.
- New standing regression `d266_probe.py` (13 checks) and `scarce_char_002t.py`. All standing
  suites PASS. No placement ECO, no Q3 POFV, no signal copper written. U19 NOT searched;
  Phase A and Phase B NOT run; converter routing NOT started. B-34 remains open.
- **No progress earned: PCB routing stays 0 %, overall stays 74 %.**
  See [`CTO_DECISIONS.md`](CTO_DECISIONS.md) D-266 and
  [`audits/2026-08-27-p2-002t-d266-reservation.md`](audits/2026-08-27-p2-002t-d266-reservation.md).

## 2026-08-27 - FBV2-P2-002S: D-264 DELIVERED AND PINNED; `LTC_SHDN` CLOSES; gate fails at section 21

**A - D-264 path-role layer policy: DELIVERED.** **B - decisive local gate: FAIL.**
The authoritative PCB is UNCHANGED - six copper layers, zero signal tracks, zero signal vias.

- **Outer-layer-only is now a CURRENT PATH ROLE restriction, not an entire-net-name
  restriction.** `path_role_dru.outer_only_rules()` scopes `BAT_MAIN is outer-layer only`
  on In2/In3 with `!A.enclosedByArea('BAT_SENSE_KELVIN') && !A.enclosedByArea('BAT_PROT_TAP_U18')`.
  The only inner exceptions presently authorized are the two bounded R75-to-U18
  Kelvin/sense branches. Current-carrying `BAT_MAIN` copper stays barred from In2/In3.
- **KiCad `disallow` fires on EVERY matching rule, not last-match-wins.** Appending the
  scoped rule left the unscoped one live; the generated board now excises the static block.
  The authoritative `.kicad_dru` keeps it so `dru_probe` still reads the shipped intent.
- **New standing regression `d264_probe.py`** - six clauses A-F, all PASS.
- **`LTC_SHDN` was never a trapped pad.** Alone: 5 escape directions at 0.25 mm B.Cu, via
  sites at 0.60/0.50/0.35/0.25, `U18.6 -> R80.2` 10.269 mm. 002R's `NO_LEGAL_ESCAPE` was
  neighbour copper - so the U18 pin-field SCHEDULE is the variable.
- **Schedule hypothesis measured TRUE:** 10 of 12 schedules give U18 6/6 with all seven
  functional control nets whole. On `6,10,7,1,3,2`: all nine PR-40 targets true,
  **`LTC_SHDN` one component**, `LTC_OV` one component B.Cu zero vias, `LTC_GATE` six of
  six, `FAULT_N` four of four, `Q3_CS` one component through the POFV.
- **And it fails: U18 6 of 8**, open on `U18.2` (`NO_PATH`) and `U18.9` (`NO_LEGAL_ESCAPE`).
  `R75.1` unreachable takes `BAT_SENSE` to five islands and the trunk `R75.2 -> D9.1` with
  it, so sections 16-19 were never reached and no trunk corridor family was generated.
- **Section 14's paired inner Kelvin was NOT achieved and is not reported as one:**
  `U18.8 -> R75.2` routed 9.930 mm but on **F.Cu + 2 vias**, the fallback; `U18.9 -> R75.1`
  never routed. One branch, wrong layer, unpaired.
- **Three of the four failing pads are NOT sealed.** On the finished board `U18.9` escapes
  at 0.20 mm, `U18.2` at 0.20 mm, `R75.1` at 0.25 mm - they failed at the width and layer
  demanded at the time, not because copper walls them in. **`Q3.6` is the exception**: no
  legal escape at >= 0.150 mm, blocked by track (x28), `Q3.7`, `Q2.3` and the board edge.
- All five suites PASS. No placement ECO, no Q3 POFV, no signal copper written. U19 NOT
  searched; Phase A and Phase B NOT run; converter routing NOT started. B-34 remains open.
- **No progress earned: PCB routing stays 0 %, overall stays 74 %.**
  See [`CTO_DECISIONS.md`](CTO_DECISIONS.md) D-265 and
  [`audits/2026-08-27-p2-002s-d264-pathrole.md`](audits/2026-08-27-p2-002s-d264-pathrole.md).

## 2026-08-27 - FBV2-P2-002R: SIX-LAYER ARCHITECTURE LOCKED; D-263 routing stops on a standing rule

**A - authoritative six-layer lock: PASS** (`f8c931b`). **B - D-263 routing: DECISION STOP.**
The two results are independent by section 2's ruling, and the second does not undo the first.

- **THE AUTHORITATIVE PCB IS NOW SIX LAYERS.** JLCPCB **JLC06161H-7628**, nominal 1.6 mm, 1 oz outer
  / 0.5 oz inner, **In1 and In4 solid GND**, In2/In3 internal signal, no blind/buried/laser vias.
  Rollback point **`beta-v2-p2-pre-sixlayer-authoritative`** created at `5f10073`, pushed and
  verified on the remote BEFORE any modification.
- **Validated after save / reload / refill:** 6 copper layers in order, published dielectrics
  0.2104 / 0.4 / 0.2028 / 0.4 / 0.2104, **In1 one island and In4 one island**, no pour on In2/In3,
  **zero signal tracks and zero signal vias**, outline datum 72.000 x 148.000 mm, **324 of 324
  footprint positions IDENTICAL** to the pre-lock board, **DRC byte-for-byte the four-layer
  baseline** with no new violation class, ERC unchanged, and all five suites PASS. Committed and
  pushed **before** any routing, per section 8, so it survives Part B. `p1_regression` now guards
  **both** reference planes and asserts the copper layer count - the In1 check was EXTENDED, never
  weakened.
- **SECTION 10'S REORDERING WAS IMPLEMENTED AND IT MOVES THE CASUALTY RATHER THAN REMOVING IT.**
  Trunk-first (002Q) cost `U18.2`/`U18.3`/`U18.7`; Kelvin-first cost four control pins;
  **controls-first costs `U18.6` AND the sense pads** - `R75.1`, `R75.2`, `Q3.5` and `Q3.6` all
  `NO_LEGAL_ESCAPE`. **Three orders, three different casualties, one cause: there is not enough
  B.Cu around U18 and R75 for the pin field, the sense pair and the high-current chain to coexist**,
  and reordering only chooses who goes without.
- With controls first, `LTC_OV` closes as **ONE COMPONENT on B.Cu with ZERO vias**
  (`R77.2 -> R78.1` at 2.457 mm - the first time that has held in this order), `LTC_GATE` closes all
  six functional pads, `FAULT_N` all four, `LTC_UV` at 9.889 mm and VIN at 4.910 mm - **but
  `LTC_SHDN U18.6 -> R80.2` is `NO_LEGAL_ESCAPE`**, so section 11's control-lane reservation never
  reaches 8/8.
- **SECTION 14'S PAIRED-INTERNAL KELVIN IS BARRED BY A STANDING RULE, NOT BY GEOMETRY:**
  `BAT_PROTECTED_P U18.8 -> R75.2` is rejected with **"Items not allowed (rule 'BAT_MAIN is
  outer-layer only')"**. The rule covers the WHOLE net and the Kelvin tap is part of it; it was
  written for the 1.5 A path - 0.5 oz inner copper needs 2.73 mm for 1.5 A at a 10 K rise, the
  board's own arithmetic - and makes **no exception for a nanoamp sense branch that merely shares
  the net name**. Section 17 forbids falling back to 002Q's asymmetric F.Cu route, and a pair with
  one branch internal and one outer is not a matched pair either. **No trunk corridor family was
  generated** - section 20 is downstream of a control reservation that does not exist.
- **A via-override defect was found and fixed:** the FINE_ESC corridor carrying the D-257
  via-geometry override was allocated only for rows with NO area of their own, and the Kelvin rows
  carry `BAT_SENSE_KELVIN` and `BAT_PROT_TAP_U18` - so their 0.35/0.20 vias had no permitting rule
  and DRC answered `via_diameter ... min 0.5000; actual 0.3500`. The override now attaches to the
  corridor the row already has.
- **DECISIONS REQUIRED: (a) SCOPE `BAT_MAIN is outer-layer only` TO CURRENT-CARRYING COPPER** - for
  instance by excluding copper inside the already-bounded, already-named D-249 sense corridors; it
  is a protection-architecture rule and not this task's to change. **(b) Then re-run sections
  11-22** - with the sense pair off B.Cu the control reservation has a real chance at 8/8, and only
  then does the trunk corridor search mean anything. **(c) `LTC_SHDN U18.6 -> R80.2` needs its own
  look** - `NO_LEGAL_ESCAPE` with controls routed first and nothing else on the board.

**No authoritative signal copper or placement ECO was written; the authoritative PCB is six layers
with 0 tracks and 0 vias.** U19 NOT searched. Phase A/B NOT run. B-34 REMAINS OPEN. Converter
routing NOT STARTED. PCB routing 0 %, overall 74 % - **no progress earned by an architecture lock**.

## 2026-08-27 - FBV2-P2-002Q: PR-49 delivered and proven; closing the trunk costs three control pins

**FAIL at section 14.** **The authoritative stackup was NOT changed** - section 18 gates it on
section 14. PCB byte-identical to `adabe98` (md5 `a908cedfa9f9410aab327d8bd55b9f45`): **4 copper
layers, zero signal tracks, zero signal vias**. All five suites PASS.

- **PR-49 IS DELIVERED, REGRESSION-PROVEN AND DEMONSTRATED TWICE ON REAL COPPER.**
  `BAT_PROTECTED_P R75.2 -> D9.1`: **1.50 mm routed then rejected on `copper_edge_clearance`,
  `LADDER_RETRY` falls to 1.20 mm, and it routes 19.219 mm on B.Cu with zero vias** - exactly
  section 6's expected evidence. A second instance appeared unprompted: `LTC_GATE U18.10 -> Q3.4`,
  0.20 mm rejected, falling to 0.15 mm. **`BAT_PROTECTED_P` now carries `D9.1` in its functional
  island**, closing the split 002P reported.
- **THE RULE IS GENERAL, NOT A BOARD-SPECIFIC HACK.** It lives in one place,
  `route_battery_block.ladder_retry`, so it is regression-tested directly rather than by reading,
  and **G9 in `router_regression.py`** pins all five properties: falls to the next authorised rung;
  **never invents a rung below the ladder**; fails cleanly when every rung is rejected; **does NOT
  walk the ladder on a non-gate failure**; and leaves **no copper behind** (0 -> 5 -> 0 tracks).
  `router_regression`: **ALL CHECKS PASS**, G1-G9. The safety boundary is structural - the retry
  only ever walks the ladder the path role already had, so `PLAN_1_BPP_TRUNK` remains exactly
  **1.50 mm target / 1.20 mm floor**.
- **AND CLOSING THE TRUNK COSTS THREE U18 CONTROL PINS.** On the identical frozen 002P placement,
  002P reported **U18 8/8 with the trunk ABSENT**; with PR-49 laying 19.219 mm of 1.20 mm trunk,
  **U18 falls to 5/8** (`U18.2`, `U18.3`, `U18.7` open). The two results do not conflict - they are
  the same board with one more connection on it. **002P's 8/8 was in part an artefact of a
  connection that never got laid.**
- **THE SECTION 9 KELVIN-ORDERING HYPOTHESIS IS MEASURED FALSE.** Routing the Kelvin taps before
  the trunk gives **U18 4/8**; plan order gives 5/8. The same-net argument is correct and beside the
  point: the taps do not obstruct the TRUNK, they take the pin-field lanes `LTC_UV`, `LTC_OV`,
  `LTC_SHDN` and `FAULT_N` need. **The flag stays in the harness, off, so a rejected hypothesis
  stays reproducible instead of becoming folklore.**
- **Routed Kelvin, best case: 8.667 / 11.130 mm, mismatch 2.463 mm.** The mismatch is comfortably
  inside 5.000 - **but `R75.2 -> U18.8` exceeds the 10.000 mm cap by 1.130 mm**, and
  `R75.1 -> U18.9` takes an F.Cu excursion where section 8 prefers local B.Cu. Section 11's corridor
  topologies were never reached, because ordering - the cheaper instrument section 9 asks for first
  - made things worse. **Analytic Kelvin (7.378 / 7.267, mismatch 0.111) is NOT reported as a pass
  while the routed result fails.**
- **Section 14 PASSES on:** the published stack with In1/In4 one GND island each, D9 legal at
  (13.600, 72.500) rot 0, `R75.2 -> D9.1` at 1.20 mm with zero vias and edge clearance met,
  `BAT_PROTECTED_P` one functional island, the `U11.2` flare, `BAT_SENSE` one island (1.00 mm B.Cu,
  zero vias), `Q3_CS`, `Q3_GATE`, Q3.3 POFV, `LTC_SHDN`, `BAT_RAW` with `U18.1`/`R80.1`/`D12`,
  `BAT_MID` and `Q2_CS`. **It FAILS on:** Kelvin `R75.2 -> U18.8` 11.130 mm, U18 5/8, `LTC_GATE`
  split, `LTC_OV` three islands and `FAULT_N` `[Q9.1, R81.2, R82.1]` vs `[U18.7]`. **Section 15's
  sole-blocker clause does not apply** - FAULT_N is one of four and the cause is shared.
- **Where each width is used:** 1.50 mm is the target and is attempted first everywhere the plan
  asks for it; **1.20 mm is used on `R75.2 -> D9.1` alone**, because that pose puts R75.2's centre
  1.187 mm from the board edge and a 1.50 mm track centred there needs 1.250 mm. The 1.20 mm rung
  is D-249's standing floor, not a new concession.

**U19 NOT searched** (section 20). Phase A NOT run. No battery signal copper. B-34 REMAINS OPEN.
Converter routing NOT STARTED. PCB routing 0 %, overall 74 % - unchanged.

## 2026-08-27 - FBV2-P2-002P: the D9 lever works, BAT_SENSE closes, and the gate fails elsewhere

**DECISION STOP** (section 17). **The authoritative stackup was NOT changed** - section 19 gates it
on section 16. PCB byte-identical to `b803f93` (md5 `a908cedfa9f9410aab327d8bd55b9f45`): **4 copper
layers, zero signal tracks, zero signal vias**. All five suites PASS.

- **D-261'S D9 LEVER WORKS, AND BETTER THAN THE RULING ASSUMED.** A **0.600 mm** eastward
  relocation of D9 - **placement only**: same part, footprint, orientation, net, polarity and
  topology - frees a **+1.00 mm** rigid-cluster shift, which opens an R75 rot-180 window of
  **x 4.225 .. 4.400** where the **Kelvin mismatch reaches 0.000 mm** with both branches at
  **7.321 mm**. That is the first time since 002I the Kelvin specification has been analytically
  satisfiable at all. Measured: D9 +0.20 and +0.40 free only cluster +0.75; **+0.60 is the minimum**
  that frees +1.00. **`D9.1 -> U11.2` SHORTENS**, 55.344 -> 54.748 mm.
- **`BAT_SENSE Q3.6 -> R75.1` - THE BLOCKER STANDING SINCE 002M - IS CLOSED**: 1.00 mm on B.Cu,
  **zero vias**, one functional island. On the best candidate (D9 +0.600, cluster +0.75, R75
  (4.150, 63.500) rot 180) the probe returns **all nine targets true and U18 8/8**, with **`LTC_OV`
  one component** and `LTC_GATE` one component - **the first board on which all of those hold at
  once** - and **`LTC_OV` closed without moving R77 or R78 at all**, so section 13's refinement
  budget was never spent.
- **A CONSTRAINT THE EARLIER ARITHMETIC MISSED: THE CORRIDOR HAS TO FIT THE TRUNK, NOT JUST THE
  PAD.** The first chain found R75 legal at x=4.125 with D9 moved only 0.200 mm, and the screen
  rejected `BAT_PROTECTED_P R75.2 -> D9.1` with `copper_edge_clearance 0.5000 mm; actual 0.4125 mm`.
  The pad cleared the edge; the **1.50 mm trunk leaving that pad** did not - it needs R75.2's CENTRE
  at least 1.250 mm from the edge, **0.063 mm more than the +0.75 window gives**. Cluster +1.00
  opens it, and that is what the extra 0.400 mm of D9 displacement buys.
- **SECTION 17'S EXACT NEW FIRST BLOCKER: `BAT_PROTECTED_P R75.2 -> D9.1` is rejected at 1.50 mm on
  edge clearance and IS NEVER RETRIED AT D-249'S OWN 1.20 mm FLOOR.** `run()` stops the width ladder
  the moment `connect_role` returns ok and the DRC gate runs afterwards, so a width that routes
  GEOMETRICALLY but fails the GATE is abandoned rather than falling to the next rung.
  `PLAN_1_BPP_TRUNK` carries `[1.50, 1.20]` precisely for this, and the 1.20 rung needs
  R75.x >= 4.063 - which the +0.75 window satisfies. **The rung that would close the trunk is legal
  and simply never tried.** Recorded as **PR-49**, not fixed mid-stop because it changes router
  behaviour board-wide.
- **SECOND BLOCKER: the ROUTED Kelvin detour.** Analytic **7.378 / 7.267**; routed **18.764 /
  7.886**. A routing outcome, not a placement one - the placement is inside spec by a wide margin -
  and the same class 002L recorded at 4.948 mm, now much larger.
- **THE TRADE, PLAINLY:** cluster **+1.00** gives the 0.000 mm Kelvin window and **costs three
  control pins** (`FAULT_N`, `LTC_SHDN`, `LTC_GATE` all rejected on `BAT_MAIN routed clearance` at
  0.2750 / 0.2500 / 0.2778, U18 5/8); cluster **+0.75** keeps **U18 8/8 and all nine targets** and
  puts R75 in the window that cannot host a 1.50 mm trunk.
- **SECTION 18 SHUNT RESERVE NOT TRIGGERED.** It is conditioned on R75 still not fitting after the
  minimum legal D9 move; **it fits**, the window was measured twice, and the analytic mismatch
  inside it reaches 0.000 mm. **No replacement-shunt requirement is produced, and 002O's suggestion
  that a shorter shunt might be needed is WITHDRAWN** - the D9 lever removed that need.
- **Section 15 scan:** D9 could not move less (+0.20/+0.40 free only +0.75); **no test point move
  reduces the displacement** - TP17 and C58 obstruct only from +1.25 mm and none was moved; R75 rot
  180 is both the simpler orientation and the better one (rot 0 gives a 17.4 mm BAT_SENSE run
  against 10.0 mm).

**U19 NOT searched** (section 21). Phase A NOT run. No battery signal copper. B-34 REMAINS OPEN.
Converter routing NOT STARTED. PCB routing 0 %, overall 74 % - unchanged.

## 2026-08-26 - FBV2-P2-002O: the rigid-cluster hypothesis is confirmed and misses by 0.132 mm

**DECISION STOP.** **The authoritative stackup was NOT changed** - section 17 gates it on section 14.
PCB byte-identical to `fcacf0e` (md5 `a908cedfa9f9410aab327d8bd55b9f45`): **4 copper layers, zero
signal tracks, zero signal vias**. All five suites PASS.

- **D-260'S RIGID-CLUSTER HYPOTHESIS IS CORRECT ABOUT THE CAUSE.** Moving U18 together with
  R76..R83 as one rigid body **eliminates 002N's three control-lane clearance failures** - they do
  not recur. The hypothesis is confirmed; it simply cannot move far enough.
- **THE KELVIN BLOCKER IS NOW CLOSED ARITHMETIC, NOT A SEARCH RESULT.** R75 at rot 0/180 needs a
  **7.75 mm** corridor; the space between the board-edge clearance and the divider column is
  **6.80 mm**. West limit `R75.x >= 4.075` (pad edge at 0.500 mm); east limit at cluster +0.50 is
  `R75.x < 3.925` - **an empty window**. It first opens at **cluster +0.75 mm** (0.100 mm wide) -
  **and +0.75 mm is exactly where D9 overlaps R77 by 0.170 mm.**
- **ONLY CLUSTER +0.50 mm IS LEGAL.** Beyond it **D9** blocks R77 at +0.75 and +1.00; TP17 and C58
  only appear at +1.25. **Section 13's test-point scan therefore has a clear answer: the obstruction
  is D9, a functional diode in the protected high-current path, NOT a test point.** D9 would need to
  move **0.170 mm** east.
- **THE OTHER ORIENTATION, RE-MEASURED WITH THE CLUSTER MOVED: rot 90/270 bottoms out at 5.132 mm
  mismatch against a 5.000 mm limit** (002N measured 5.177 unmoved; the shift bought 0.045 mm).
  Routed anyway, that pose gives **U18 4 of 8** - moving R75 east far enough to improve the mismatch
  puts the shunt under U18's escape corridor. **Both routes miss by less than two tenths of a
  millimetre.**
- **WHAT DID CLOSE: `LTC_OV R77.2 -> R78.1` routed 2.901 mm on B.Cu with ZERO vias** - the section
  11 requirement, met, without moving R77 at all. And **section 11's fallback lock is now enforced**:
  `AQROOT_LTCOV_BCU` denies LTC_OV and LTC_UV the generic layer fallback during qualification, so
  002N's "connected, but 13.087 mm across F.Cu with two vias" **cannot be reported as a pass again**.
- **TWO TOOLING DEFECTS FOUND.** (1) The first pose filter checked courtyards against the outline
  and nothing else, and proposed R75 with its west pad **0.325 mm** from the edge against a 0.500 mm
  clearance - every connection was rejected from the first one and nothing routed; the edge rule now
  applies to the **pads**. (2) The placement guard refused a candidate because the file said `270.0`
  and KiCad reports `-90.0` - **the same pose**; angles are now compared modulo 360, because a guard
  that fires on a difference that is not a difference trains people to ignore it, and this guard
  exists precisely because 002K ran nine screens on the wrong placement.
- **DECISIONS REQUIRED:** (a) **authorise a 0.170 mm eastward move of D9**, which admits the
  +0.75 mm cluster shift and a Kelvin mismatch of ~0.10 mm - a protection-architecture call since D9
  is in the high-current path; (b) **or relax the mismatch from 5.000 to 5.132 mm**, noting the pose
  that achieves it also costs four U18 control pins so this alone does not close the gate; (c) **or
  change the shunt** - R75's 5.925 mm pad pitch is what pins the rot 90/270 mismatch AND what makes
  the rot 0/180 corridor 7.75 mm wide, so a physically shorter 15 mOhm part relieves both at once.
  Raised, not taken.

**U19 NOT searched** (section 20). Phase A NOT run. No battery signal copper. B-34 REMAINS OPEN.
Converter routing NOT STARTED. PCB routing 0 %, overall 74 % - unchanged.

## 2026-08-26 - FBV2-P2-002N: D-259(c) closed, R75 Kelvin solved analytically, gate still FAILS

**FAIL at section 11.** **The authoritative stackup was NOT changed** - section 16 gates the lock on
section 11. PCB byte-identical to `7ff0337` (md5 `a908cedfa9f9410aab327d8bd55b9f45`): **4 copper
layers, zero signal tracks, zero signal vias**. All five suites PASS.

- **D-259(c) CLOSED.** The derived inner split of 002M is gone; `sixlayer.py` now authors the
  **published JLC06161H-7628** table and the regression asserts those dielectrics - 0.2104 outer,
  0.4000 cores, **0.2028 central prepreg**. Listed materials total **1.5544 mm** (1.5744 with both
  masks). **That is not a discrepancy**: the board is a **NOMINAL 1.6 mm construction**, the vendor
  lists nominal laminate and copper, and the finished board also carries plating, resin flow and
  press tolerance. The regression now RECORDS the total and ASSERTS the published values - it no
  longer tests the sum against 1.6 mm, because that was never the right test.
- **SECTION 18 CLOSED: the datum is 72.000 x 148.000 mm.** `GetBoardEdgesBoundingBox()` reads
  72.100 x 148.100 because it measures to the OUTSIDE of the 0.100 mm Edge.Cuts stroke; 002M quoted
  that artefact as though it were the requirement. Both figures are now reported and the stroke
  subtracted. **Edge.Cuts untouched, no new board-size requirement created.**
- **THE R75 MEASUREMENT THAT MATTERS: translating R75 was never going to fix the Kelvin mismatch.**
  `U18.8` and `U18.9` sit at the **same y**, and R75 is a **5.925 mm** shunt whose pads lie along y,
  so any north/south move changes both Kelvin lengths equally and the mismatch stays at very nearly
  the shunt's own length. Over a +/-8 mm box at 0.5 mm in four rotations, **28 poses reached the
  Kelvin test, ALL rot 90/270, best mismatch 5.177 mm against a 5.000 mm limit.** Turning the shunt
  so its pads lie along x drops the mismatch below 1 mm - and **every rot 0/180 pose is blocked by
  the R80/R81/R82 courtyards at x 7.30. The part costing the Kelvin spec is the divider column, not
  R75.**
- **With the column shifted 1.0 mm east - the measured minimum - R75 gets 8 poses**, best
  **(4.300, 63.500) rot 180, Kelvin 7.772 / 7.000, mismatch 0.771 mm** against a 5.000 limit.
  **But the combination does not hold:** moving the column east puts BAT_MAIN copper into the
  LTC4368 control lanes and three connections are rejected by `BAT_MAIN routed clearance 0.3000` at
  actuals of 0.2750, 0.2778 and 0.2371 mm, taking **U18 to 6 of 8**. The Kelvin fix is real; the
  price is paid one region over.
- **LTC_OV: ONE COMPONENT with a 0.354 mm R78 move** - `(8.825, 69.675) rot 0 -> (8.575, 69.925)
  rot 180`, `R77.2 -> R78.1` 2.26 -> **1.577 mm**, span **8.577 mm**, U18 stays **8/8** and every
  other section 11 item holds. **But `U18.3 -> R77.2` routed 13.087 mm on F.Cu with 2 vias** -
  exactly the long generic layer fallback section 13 forbids, on a high-impedance comparator input.
  **Section 9's secondary lever, a bounded R77 adjustment, is the next instrument and was not
  spent.**
- **A SEARCH DEFECT WORTH RECORDING:** the first R78 run returned `R77.2 -> R78.1 = 0.000 mm` and
  called it the best candidate. That is not a zero-length link - it is R78's pad sitting exactly on
  top of R77's, because R77 was in the movable set and therefore absent from the obstacle list.
  **A search allowed to overlap the part it is connecting to will always report a perfect score.**
- **A HARNESS CHANGE MADE, MEASURED AND DELIBERATELY REVERTED.** `BAT_MAIN routed clearance` fires
  on either side of the pair, so a control track passing a BAT_MAIN PAD looks like it owes 0.300 mm,
  and `margin()` returned 0.200 mm for every pad regardless of net. Raising wide-net pads to
  0.300 mm looked like the fix - **and immediately sealed `U18.8` and `U18.9`**, the two D-249-ruled
  Kelvin taps, both `NO_LEGAL_ESCAPE`. They route legally today at **0.150 mm** under the
  pad-escape necking block, a later and more specific rule, so DRC does not in fact demand 0.300 mm
  there. **Over-applying a clearance is how a legal escape becomes NO_LEGAL_ESCAPE.** Reverted, with
  the reasoning left in the code so it is not re-attempted.
- **Section 11 gate:** PASS on Q3 POFV, Q3_CS, LTC_GATE, Q3_GATE, U18 VIN, SHDN, FAULT_N, R80.1,
  D12, BAT_PROTECTED_P, U11.2 flare and LTC_OV-one-component. **FAIL on `BAT_SENSE Q3.6 -> R75.1`
  (0.2400 vs 0.3000), high-current clearance, Kelvin as routed, LTC_OV local B.Cu, and new DRC
  classes.** **Section 13's U18 reserve was NOT opened** - it is conditioned on both individual
  searches succeeding, and LTC_OV succeeds only in a form section 8 does not accept.
- Impedance register updated to the published inputs; every controlled net marked **PENDING**
  recalculation, with the **NFC transmit arms** still flagged as the real electrical change.

**U19 NOT searched** (section 20). Phase A NOT run. B-34 REMAINS OPEN. Converter routing NOT
STARTED. PCB routing 0 %, overall 74 % - unchanged.

## 2026-08-26 - FBV2-P2-002M: six layers proven on scratch, PR-47 closed, gate FAILS on LTC_OV and BAT_SENSE

**FAIL at section 14.** **The authoritative stackup was NOT changed** - section 16 gates the lock on
section 14. PCB byte-identical to `bc1d436` (md5 `a908cedfa9f9410aab327d8bd55b9f45`): **4 copper
layers, zero signal tracks, zero signal vias**, In1.Cu one filled island. All five suites PASS.

- **SIX-LAYER MIGRATION PROVEN ON SCRATCH.** 6 copper layers in order
  (F.Cu / In1.Cu / In2.Cu / In3.Cu / In4.Cu / B.Cu), explicit **JLC06161H-7628** stackup,
  **1.6028 mm**, **In1.Cu AND In4.Cu each one GND island** built from the same outline, no outer or
  inner-signal pours, outline 72.100 x 148.100 mm - and a **DRC histogram IDENTICAL to the
  four-layer baseline**. The In1 guard was EXTENDED, not weakened: In4 gets the identical GND-only
  rule and `SWITCH_NODE never on In2` is repeated for In3.
- **PR-47 CLOSED ON SCRATCH.** `Q3_CS Q3.3 -> Q3.1` routes **4.626 mm at 0.25 mm on In2.Cu** through
  a filled/capped **0.35/0.20 ordinary THROUGH via-in-pad** at `Q3.3`, with **0.125 mm of pad copper
  remaining each side**; the far end keeps an ordinary via. `Q3_CS` **one component**, `LTC_GATE`
  **one component across all six functional pads**, **U18 8/8** - and the gate drive goes from
  002L's only option, a 15.991 mm F.Cu excursion, to **5.500 mm on B.Cu with ZERO vias**. The
  premium process is spent on **one pad**; no footprint or toe was modified.
- **BUT SECTION 14 FAILS ON TWO NETS, AND IT IS THE SAME TRADE ONE REGION OVER.**
  **`BAT_SENSE Q3.6 -> R75.1`**: `BAT_MAIN routed clearance 0.3000 mm; actual 0.2400 mm` - the
  1.00 mm trunk and the POFV copper want the same corridor, and a wide net cannot be sent inward
  because section 2 keeps high-current copper on outer 1 oz. **`LTC_OV R77.2 -> R78.1`**:
  `NO_VIA_SITE` - **this is section 13's stop condition in substance**, since section 13 forbids
  adopting the long generic F.Cu fallback as the final design. **Six layers removed the Q3 conflict,
  which is what they were bought for**; what remains is a clearance contest over a few square
  millimetres, which is a placement question.
- **U18 six-layer re-screen and the R75 lever were NOT run** - re-screening against a prefix that
  cannot close `BAT_SENSE` or `LTC_OV` would measure the wrong board, and 002K is the standing
  lesson on that.
- **THREE HARNESS DEFECTS, ALL ONE FAMILY - adding layers to a router that had only ever seen two.**
  (1) the obstacle model saw two layers; the copper and routable sets are now DERIVED FROM THE BOARD
  and a through via registers copper on all of them. (2) `connect_hop` sited its via checking only
  `near` and `far` - harmless while those WERE the stack; on six layers it put a via onto another
  net's inner copper and DRC said `shorting_items`. (3) `connect_hop` could only reach F.Cu, so the
  new capacity was unreachable; `far` now defaults to every routable layer except `near` - **and
  never an inner layer for a wide net**, which `BAT_MAIN is outer-layer only` proved three times in
  one connection.
- **THE RULE CORRECTION, A SECOND TIME:** the D-257 escape corridors were emitting a 0.20 mm
  clearance floor alongside their via-geometry override; the corridor is grown from the track with a
  0.3 mm tolerance, so it swallowed neighbours and the floor fired on pairs it never meant to govern
  - `LTC_OV` was rejected by a rule named after `LTC_GATE`'s escape. **A relaxation applied where
  nothing needed relaxing is a restriction.** Escape corridors now carry **via geometry only**.
- **PR-48 RE-VERIFIED on six layers:** `U18.1` VIN in the BAT_RAW main island; `U14.2`, `U14.3` and
  `TP15.1` all in the `BAT_PROTECTED_P` trunk island.
- **POFV FABRICATION NOTE and IMPEDANCE IMPACT REGISTER** written to
  `architecture/FBV2_SIXLAYER_STACKUP.md`. The via is **PLATED OVER FILLED VIA** - not tented, not
  mask-plugged, not open, not blind, not a microvia - recorded as a process order because Gerbers
  alone do not force it. **No impedance width is claimed unchanged**; every controlled net is
  scheduled for recalculation, and the **NFC transmit arms** are flagged as the real electrical
  change (reference moves from across a 1.065 mm core to In4 at 0.2104 mm).
- **HONEST LIMIT ON THE STACKUP NUMBERS:** the outer 0.2104 mm 7628 prepreg is carried from
  JLC04161H-7628; the **inner distribution is DERIVED** to total 1.6 mm and **must be confirmed
  against JLCPCB's published table before Gerbers are ordered**.
- Mechanically inert and re-measured as such: outline 72.100 x 148.100, 1.6 mm nominal, footprints
  unchanged, `p1_regression` PASS on every boss, keepout, envelope and connector check.

**U19 NOT searched** (section 20). Phase A NOT run. B-34 REMAINS OPEN. Converter routing NOT
STARTED. PCB routing 0 %, overall 74 % - unchanged.

## 2026-08-26 - FBV2-P2-002L: PR-48 and D-257 proven, PR-47 is a via-in-pad decision

**DECISION STOP** (section 17: *"If Q3 requires via-in-pad: 002L = DECISION STOP, not PASS"*).
**No authoritative copper**; PCB byte-identical to `cb17269` (md5 `a908cedfa9f9410aab327d8bd55b9f45`),
**zero signal tracks, zero signal vias**, In1.Cu one filled island. All five suites PASS.

- **PR-48 PROVEN.** A local `clearance (min 0.20mm)` conditioned on net AND bounded corridor
  resolves all three measured cases: **`U18.1` VIN 10.107 mm at 0.20 mm** (was
  `clearance 0.3000; actual 0.2500`), **`U14.2` 7.401 mm at 0.15 mm** (was 0.2347), **`U14.3`
  joined** (was 0.2350). `BAT_PROTECTED_P` becomes ONE island including `U11.2`, `U14.2`,
  `U14.3`, `TP15.1`, `U18.8`. Minimum measured clearance 0.200 mm, no new DRC class.
  **AND A CORRECTION:** the first cut also covered `BAT_PROT_TAP_U18` and `BAT_SENSE_KELVIN`,
  which were already running legally at **0.150 mm** - so the "relaxation" RAISED the floor on
  compliant copper and rejected every connection after it. **A relaxation applied where nothing
  needed relaxing is a restriction.**
- **D-257 PROVEN ON THE PREFERRED GEOMETRY.** Every D-256 escape is carried by the **0.35/0.20
  ordinary through via** - LTC_GATE x4, LTC_SHDN x2 - and **the 0.25/0.15 reserve was never
  needed**. No microvia, no blind or buried via. Verified before adoption: a 0.35/0.20 via inside
  a named corridor reports `via_diameter` + `annular_width` without the rules and nothing with
  them; no other class moves.
- **U18 SEARCH: FIVE POSES SCREENED, NONE CLOSES.** The **authoritative** pose routes **8 of 8**
  and misses Kelvin (straight-line 2.440/8.265, **mismatch 5.825** against a 5.000 limit); the
  **002F ECO** pose has Kelvin 4.464/4.464/0.000 and routes **6 of 8**; C01/C02 **5 of 8**; C03
  **7 of 8**. **Most of the authoritative pose's Kelvin failure is ROUTING, not placement** - it
  misses by **0.825 mm straight-line** and carries a further **4.948 mm of detour** on
  `R75.2 -> U18.8`. **The lever section 6 held back is R75**, fixed "initially" and sitting in the
  1.5 A path, so it is surfaced rather than taken.
- **PR-47: ORDINARY VIAS ARE MEASURED IMPOSSIBLE.** Q3 is `SOIC-8_3.9x4.9mm_P1.27mm` - 1.270 mm
  pitch, 1.950 x 0.600 mm pads, **0.670 mm copper gap** - with `Q3_CS` on pins 1/3 and `LTC_GATE`
  on 2/4 sharing one B.Cu slot. **`Q3.3` has NO LEGAL ESCAPE at 0.25, 0.20 OR 0.15 mm**, blocked
  by `Q3.2` (x27) and `Q3.4` (x20); both D-257 geometries and all three widths return
  `NO_LEGAL_ESCAPE`. **A via needs a landing site and a landing site has to be REACHED from the
  pad** - the via's size is irrelevant. **Section 13 geometry check: a filled/capped through
  via-in-pad at 0.35/0.20 FITS, with 0.125 mm of pad copper each side**, the 0.670 mm pad gap
  unchanged and adjacent drills 2.540 mm apart. Feasible and premium - hence the stop.
  **Section 14 alternative, recorded not taken:** a Q3 toe extension of **>= 0.40 mm**.
- **SIX-LAYER ASSESSMENT TRIGGERED (non-destructive, nothing applied).** 1.6 mm retainable, **P1
  mechanical evidence stays valid**, two extra signal layers plus a second GND reference relieve
  U18 directly - **but it does NOT solve PR-47**, because `Q3.3` still has no B.Cu escape.
- **PROCESS FIX (section 2):** `checks/placement_fingerprint.py` prints the pose of U18, R75,
  R76-R83, Q2, Q3, U14, U19 at the head of every screen and `AQROOT_EXPECT_PLACEMENT` makes it an
  assertion that **fails before routing**; the candidate loader reads the SAME file the assertion
  checks. All eleven screens ran under it, and it caught its first defect immediately - a
  candidate with three courtyard overlaps that the geometric filter had cleared against a board
  the screen would never see.
- Standing **section 11 flag**: `LTC_OV` reached F.Cu through the ordinary fallback (2 vias at
  0.60/0.30) and split `R78.1`. High-impedance comparator input; not the only blocker; not moved
  silently.

**U19 NOT searched** (section 16). Phase A NOT run. B-34 REMAINS OPEN. Converter routing NOT
STARTED. PCB routing 0 %, overall 74 % - unchanged.

## 2026-08-26 - FBV2-P2-002K: D-256 is right, and its instrument does not fit U18

**FAIL** at section 9. **No authoritative copper**; PCB byte-identical to `a5771a7`
(md5 `a908cedfa9f9410aab327d8bd55b9f45`), **zero signal tracks, zero signal vias**, In1.Cu one
filled island, placement ECO still not applied. Preflight all PASS.

- **THE ANSWER: the west margin IS short of layer capacity exactly as D-256 ruled - and at the
  FBV2-P2-002F placement the two pins that need the extra layer CANNOT REACH A VIA.**
  `U18.10`: escape 0.20 mm, one direction, and **no reachable through-via site at 0.60, 0.55,
  0.50, 0.45, 0.40, 0.35, 0.30 or 0.25 mm** - the smallest that fits is **0.20 mm**, which is
  `min_microvia_diameter`, not a through via. `U18.7`: **NO legal escape at 0.25, 0.20 OR
  0.15 mm**, blocked by `U18.8` and `U18.6`, its own adjacent pads. A layer change needs a via;
  a via needs somewhere to land; **U18 is an MSOP-10 on 0.50 mm pitch and the board's floor is
  `min_via_diameter` 0.50 mm.**
- **ON THE AUTHORITATIVE PLACEMENT THE SAME STRATEGY WORKS**, and that contrast is the finding:
  `LTC_GATE U18.10 -> R76.1` **8.794 mm F.Cu / 2 vias / 2 s** (was NO_PATH at 26 s),
  `U18.10 -> Q3.4` 15.552 mm, `LTC_SHDN U18.6 -> Q4.3` **24.525 mm at 0.25 mm** (was rejected),
  FAULT_N all four functional pads one island **on B.Cu unaided**, **LTC_GATE ONE ISLAND across
  all six functional pads - the first time with PR-43 in force** - and **U18 6/8 -> 7/8**.
  `BAT_PROTECTED_P` 167.401 mm with **zero vias**.
- **PLACEMENT ERROR, CAUGHT AND CORRECTED IN-TASK:** the first nine screens ran without
  `AQROOT_ECO_002F`. Section 14 caught it - Kelvin came out **3.179 / 13.152 mm, 9.973 mm
  mismatch** against 002I's 4.464 / 4.464 / 0.000. Repeated on the ECO placement; both sets are
  reported and labelled.
- **THREE HARNESS DEFECTS FIXED.** **PR-45**: `connect_hop` chose its via site by "closest point
  a via fits" instead of "closest point a via fits THAT THIS PAD CAN REACH" - for `U18.10` it
  returned a site 2.30 mm away on the far side of the copper the pin was escaping past; it now
  floods the near layer from the escape point, and rejects sites that break `min_hole_to_hole`.
  **PR-46**: two silences - every hop failure was reported as `NO_PATH: no F corridor` even when
  the far layer was never attempted, **and a connection rejected by the DRC gate was reverted and
  requeued with NO LOG LINE AT ALL**. Both now report. **D-249 corridor rule areas now span both
  outer layers** - they existed on B.Cu only, so an F.Cu escape by a ruled tap fell outside its
  own corridor and was judged against the 0.60 mm class floor.
- All five suites re-run after the harness changes: **PASS**.
- **U19 search NOT PERFORMED** - section 11 gates it on the section 9 screen. **Phase A, Phase B,
  manifest and authoritative write NOT PERFORMED.**
- **NEW CTO ISSUES.** **D-257**: D-256's instrument does not fit U18's pin field - microvia /
  via-in-pad (a reachable **0.20 mm** site exists 1.20 mm out from `U18.10`), a land-pattern
  change, moving U18 (forbidden by section 7), or accepting `U18.7`/`U18.10` unrouted.
  **PR-47**: the Q3 south row is a **proved land-pattern conflict** - `Q3_CS` (pins 1, 3) and
  `LTC_GATE` (pins 2, 4) interleave with one B.Cu slot and in all three orderings measured the
  loser's middle pad has no escape at any width on either layer. **PR-48**: D-249 relaxes WIDTH,
  not CLEARANCE - `U18.1` and the U14.2/U14.3 branches are all blocked by
  `BAT_MAIN routed clearance` (0.300 mm required, 0.250 / 0.2347 / 0.2350 mm actual).
  **Section 6 flag**: `LTC_OV` reached F.Cu through the generic fallback (13.604 mm, 4 vias) and
  it is a high-impedance comparator input.
- 11 screens, one at a time, 501-890 s each, ~1.8 h. **No cloud-vs-PC speedup claimed** - the
  committed PC figures are for unlike workloads.

B-34 REMAINS OPEN. Converter routing NOT STARTED.
PCB routing 0 %, overall 74 % - unchanged.

## 2026-08-26 - FBV2-CLOUD-001: the harness becomes reproducible on a second machine

**PASS. INFRASTRUCTURE / TOOLING ONLY - NO PCB PROGRESS EARNED.** No schematic, no copper, no
placement, no architecture. Authoritative PCB byte-identical to `a1cc687`; **0 signal tracks,
0 signal vias.** All five suites PASS on Ubuntu 24.04 / KiCad 10.0.5.

- **The problem:** every FBV2-P2 verdict, 002A through 002J, was measured on ONE Windows
  workstation. Four active scripts had that machine's disk baked in as literals
  (`P:/New folder (2)/bin/kicad-cli.exe`, `P:/Vaults/ClaudeVault/AQROOT/...`,
  `"<KICAD>/bin/python.exe"`). **13 active portability defects** found and tabulated.
- **The dangerous one:** `router_regression.py` had a `KICAD_CLI` override, but its DEFAULT was
  the Windows path. Unset on Linux it yielded a nonexistent tool, and both DRC call sites use
  `subprocess.run(capture_output=True)` with no returncode check - so "the DRC tool is absent"
  looked like an I/O error, **inside the script that gates authoritative copper.** That is the
  G1 class from 002A, one layer down.
- **New `checks/harness_paths.py`** - one policy each. **kicad-cli:** `KICAD_CLI` ->
  `shutil.which` -> documented Windows fallbacks (`os.name=='nt'` only) -> **loud `SystemExit`,
  never a silent default.** **project dir:** `AQROOT_BETA_V2_PROJECT`, else derived from
  `__file__` (`checks/ -> beta-v2/ -> hardware/ -> repo root`) - no username, mount point, home
  directory or vault path. **interpreter:** `sys.executable`, always.
- **Windows is a strict superset**, verified statically: the old machine still resolves at the
  fallback with zero configuration; `C:\...\kicad-cli.exe` passes verbatim into `subprocess.run`;
  no Linux-only literal is mandatory anywhere.
- **`.kicad_prl` REMOVED from fork equivalence.** It is per-user KiCad editor state, gitignored
  since before the fork, and `beta-dm` has none at all - the probe was asserting a property of
  one person's KiCad session. **No fake `.prl` generated, none committed, `.gitignore` unweakened.**
- **`checks/requirements.txt`**: `numpy>=1.24` and nothing else. `pcbnew` deliberately excluded -
  it comes from KiCad, not pip, and the file says so.
- **KiCad 10's Ubuntu `PROPERTY_ENUM` assertion noise is NOT suppressed** - hiding it would hide
  the next real error. Judged on exit status and results.
- `p1_regression` PASS, `router_regression` **ALL CHECKS PASS** (G1-G7 + G8-A..F; also PASS with
  `KICAD_CLI` unset), `dru_probe` PASS, `netclass_probe` PASS, `fork_equivalence` PASS.

B-34 REMAINS OPEN; D-256 still awaits the CTO. FBV2-P2-002K NOT STARTED.
PCB routing 0 %, overall 74 % - unchanged.

## 2026-08-26 - FBV2-P2-002J: the R80/R81 lever fails, and PR-44 unblocks Phase A

**FAIL.** No authoritative copper; board byte-identical to `984423c`. Preflight all PASS.

- **Section 5 local screen built and VALIDATED** (`AQROOT_LOCAL=R80`): 19 named connections,
  reproduces D-255 exactly (U18 6/8, open `U18.7`/`U18.10`) in **471 s vs ~2 h** - 15x cheaper.
  Sound because the copper boxing `U18.7` is the `LTC_SHDN` `U18.6 -> R80.2` run, inside the U18 field.
- **Six R80 poses screened.** `R80.1` and `D12.1` connected in every one. **None reached 8/8.**
  K6 (R80 8.000,68.000 r180 / R81 5.500,70.500 r90) is the only one closing BOTH D-255 pins.
- **Two full Phase A runs, both worse than doing nothing**: K6 **20/29** (`Q3_CS` splits -
  section 12 protects it), K1 **22/29** (`LTC_GATE` fragments into five islands).
- **The 002I baseline of 24/29 stands.** Across 002I+002J, one reordering and seven
  placements have all landed at or below it.
- **Section 10 via reserve NOT triggered** - `U18.7` is the easy pin. **The section 10 stop
  condition IS met**: `LTC_GATE` degrades under every R80/R81 move. Stopped for CTO review.
- **U19 search NOT performed** - section 9 needs an R80/R81 winner first.
- **PR-44 CLOSED**: `apply_areas` called `GetClass()` on PCB_TRACK objects freed by a revert -
  a deterministic SIGSEGV at connection 28 that killed two full Phase A runs. Store UUIDs and
  resolve against the board. `router_regression` ALL CHECKS PASS.

CTO decision required (D-256): the margin is short of layers, not lanes. B-34 OPEN.
PCB routing 0 %, overall 74 % - unchanged.

## 2026-08-26 - FBV2-P2-002I: PR-43 answered - BAT_RAW closes, U18 loses two pins, the margin is full

**FAIL on section 5 Case D.** No authoritative copper; board byte-identical to `984423c`.
Preflight all PASS (p1_regression, router_regression 34 incl. G8-A..F, dru_probe,
netclass_probe, fork_equivalence; DRC 1 baseline violation; ERC 0).

- **PR-43 WORKS.** `BAT_RAW` goes to 11-of-12 pads in one island - `R80.1` and `D12.1` both
  CONNECTED - with **no placement change**. `LTC_SHDN`, previously NO_PATH, closes too.
- **And it costs U18 8/8 -> 6/8**: `U18.7` NO_LEGAL_ESCAPE, `U18.10` NO_PATH. Section 9
  protects both, so this is a Case D stop.
- **The blocking copper is not `BAT_RAW`.** Beside `U18.7` sit `LTC_SHDN` and
  `BAT_PROTECTED_P` at 0.500 mm; beside `U18.10`, `BAT_SENSE` at 0.500 mm. PR-43 unblocked
  `LTC_SHDN`, whose new route took `U18.7`'s lane. **Capacity, not ordering** - both
  orderings score 24 of 29, and reordering moves the casualty rather than removing it.
- **PR-43 flagged, not adopted** (`AQROOT_PR43=1`). The default keeps U18 at 8/8.
- Improved and worth keeping: **Kelvin 4.464/4.464 mm, mismatch 0.000 mm** (was 2.454);
  `U18.1` VIN 1.752 mm. Held: `BAT_PROTECTED_P` one island / 0 vias / 1.50 mm, `Q3_CS` and
  `Q2_CS` 0 vias, `U11.2` neck 0.20 mm no via, `U14`+`TP15` connected, 0 out-of-scope copper.
- **U19 search NOT performed** - section 6 requires Case C.

CTO decision required (see D-255). B-34 OPEN. PCB routing 0 %, overall 74 % - unchanged.

## 2026-08-25 - FBV2-P2-002G / 002H: routing truth (PR-39), full-prefix qualification (PR-40), and the BAT_RAW contention

**FAIL. No authoritative copper written; the placement ECO is still not applied.** The
authoritative PCB is byte-identical to `984423c` (md5 `a908cedfa9f9410aab327d8bd55b9f45`).
Rollback tag `beta-v2-p2-battery-pre-authoritative` created at `984423c` and pushed.

- **PR-39 CLOSED** - router success now means the *requested* pads are one connected
  component. A retarget that leaves the named pad isolated is reverted and does not count.
  Six regression cases G8-A..G8-F, all passing. `checks/net_ledger.py` makes connectivity
  the primary truth; the routed count is secondary.
- **PR-40 IMPLEMENTED** - qualification is the full prefix (`AQROOT_PROBE_PASS1`), not
  bare-board escape, simultaneous stubs, or a reduced prefix. Cost ~40 min/candidate.
- **PR-41 CLOSED AND VALIDATED** - the closure stage gave every `BAT_RAW` pad the trunk
  ladder because `BAT_RAW` is a WIDE net; the 0.20 mm divider chain was asked for 0.60 mm.
  Zero `NO_LEGAL_ESCAPE` board-wide afterwards. Not sufficient on its own.
- **PR-42 CLOSED** - a stray `break` made the 'joint' U19+R80/R81 search share one R80/R81
  pose across all eight candidates. Fixed: six distinct R80 poses; the two independent axes
  are swept separately. `AQROOT_SEARCH_ONLY` regenerates candidates without probing.
- **MEASURED** - a bare-board flood (negative test only) shows both `BAT_RAW` bridges reach
  the battery node at 0.20 mm. The corridor exists; the failure is contention, not geometry.
  This reverses the part of PR-34 that assumed R80 needed a placement search.
- **PR-43 APPLIED, UNPROVEN** - schedule by corridor scarcity, not net role: the 21.5 mm and
  45.5 mm divider-chain bridges now route with the chain instead of after U18's pin field.

Phase A not passed, Phase B not run, no manifest. B-34 remains OPEN. PCB routing 0 %,
overall Full Beta v2 74 % - unchanged.

## 2026-08-25 - resumed FBV2-P2-002F: three harness defects, 24 of 29 nets (FBV2-P2-002F cont.)

**Still FAIL, and the authoritative PCB is still byte-identical to `24f6611`.** Phase A run 8:
**71 connections, ratsnest 781 -> 708 (-73), DRC identical to the baseline, zero out-of-scope
copper, 24 of 29 in-scope nets single connected components** (was 23).

### Two fixes held

**PR-37.** The closure stage handed every `BAT_PROTECTED_P` pad the TRUNK ladder `[1.50, 1.20]`,
ignoring D-249's per-pad rulings, and so asked a 0.70 x 0.30 mm MAX17048 pad for 1.20 mm. The pads
escape fine at 0.15 mm - measured - and the island sat **10.862 mm** from `C58.1`. It was never a
corridor problem. `BAT_PROTECTED_P` is now ONE component, and the same fix closes PR-35.

**PR-38.** `order_tight` measured only the FIRST-NAMED pad of a connection. U18's pin field is
written pin-first so that worked; the dead-cell block is a minimum spanning tree, so
`TP24.1 -> U19.2` measured a 1.0 mm test pad with three ways out and never looked at the SOT-23-8
pin with one. A connection is as tight as its tighter end. `REF_POL` closed.

### PR-39 - the defect that matters most

`TAP BAT_RAW R79.1 -> R80.1 5.276 mm` is **not what was built.** Those pads are **12.030 mm**
apart, and the number of `BAT_RAW` track endpoints inside `R80.1`'s pad is **zero**. `run()`'s node
fallback silently retargets to the nearest point on the net's own copper while the log line and the
journal keep the original pad name - so a "successful" connection laid a redundant loop and left
the pad alone.

**Section 14 must be judged on connectivity, never on the routed count**, and a section 17 replay
would faithfully reproduce a connection that does not exist.

### And a correction

This document briefly recorded that U19 does not need to move, on the grounds that all seven of its
signal pins escape on the bare board and survive the section 3C simultaneity test. **Run 8
disproves it** - the casualty simply moved from `U19.2`/`U19.3` to `U19.3`/`U19.8`. That is
precisely the signature PR-25 named, and bare-board escapes are exactly the inference this task has
shown to be unsound. **PR-34 stands as originally written: U19 needs the measured placement
treatment PR-25 gave U18, and so do R80/R81.**

What is left is three pads - `R80.1`, `U19.3`, `U19.8` - all west-margin placement, plus two test
points (`TP18.1`, `TP19.1`) that escape with 8 and 5 directions and were simply never reached.

## 2026-08-25 - the placement question is answered, the block still does not close (FBV2-P2-002F)

**FBV2-P2-002F = FAIL.** Phase A did not complete, so Phase B never ran and
`aqroot-Beta-v2.kicad_pcb` is byte-identical to `24f6611`: zero tracks, zero signal vias. **The
placement ECO is NOT applied to the authoritative board** - section 23 forbids committing an
unproven placement, and a placement that does not pass section 13 is not proven. PCB routing stays
0 %, overall stays 74 %. Full analysis:
[`audits/2026-08-25-p2-battery-placement-eco.md`](audits/2026-08-25-p2-battery-placement-eco.md).

### PR-25 is closed, and closed by measurement

U18 rotates **90 -> 180** and moves **(3.000, 72.400) -> (8.000, 65.250)**. At 002E's pose it sat at
x 1.205..4.795 with R75 immediately south and the R76..R83 divider wall at x 7.300..10.350: every
north-row pin escaped through the same **2.505 mm** corridor, and R75's own 3.35 mm pads stood
between `U18.8` and its Kelvin target. **6 of 8 pins escaped, 7 at best.**

At rot 180 the pin rows face east and west and U18 straddles R75's midline, so `U18.8` and `U18.9`
look straight at `R75.2` and `R75.1`. **8 of 8 escape and 8 of 8 route.** The divider *wall* is
gone - every part is now placed by the U18 pin it serves.

The pose came from 13 284 candidates: 2 490 cleared collision and the section 4 Kelvin envelope,
1 331 kept both Kelvin branches under 10 mm with a legal 1.50 mm trunk, 20 were fully scored, and
the winner was re-confirmed by **routing all eight pins with the real router** against the real
trunk, chain and flare.

### `Q3_CS` closes with zero vias, and the authorised via was declined

Section 5 authorised one `Q3_CS` layer drop. It was measured across four variants of the same
prefix and **not taken**: CS-before-gate closes all twelve connections at Q3 on B.Cu with no vias;
moving Q3 1 mm loses **both** CS nets; and the authorised drop **cannot even start**, because
`Q3.3` has no B.Cu escape left once the gate has routed. The whole price is **2.188 mm** on one
gate link. `LTC_GATE`, which 002E left in two pieces, is now **one connected component**.

### The numbers

| target | 002E | 002F |
|---|---|---|
| U18 signal-pad escapes | 6 of 8 | **8 of 8, all routed** |
| R75 Kelvin mismatch | 20.620 mm | **2.454 mm** |
| `U18.1` VIN tap | 32.204 mm | **1.850 mm** |
| `U14.2` branch | 31.228 mm | **6.387 mm**, U14 did not move |
| worst megohm dead-cell node | 64.01 mm | **18.43 mm** |
| `Q3_CS` | `NO_LEGAL_ESCAPE` | **5.500 mm, zero vias** |
| connections on one scratch board | 60 | **70** |
| ratsnest | 781 -> 718 (-63) | **781 -> 709 (-72)** |
| in-scope nets fully connected | - | **23 of 29** |

DRC was identical to the baseline after every single connection, and there is zero out-of-scope
copper.

### Why it still fails

Section 14 allows no partial pass. Six nets sit in two islands and **four of them are one stranded
pad** - `R80.1`, `U19.2`, `U19.3` - plus the `{TP15, U14.2, U14.3}` MAX17048 island. `U19.2` and
`U19.3` are a U19 placement question of exactly the kind PR-25 answered for U18 (**PR-34, open**).

### Four harness rulings, and one lesson

**PR-30** fine-pitch slack ties break on how many ways out a pad still has. **PR-31** a partner must
sit on the side its pin faces, or the route wraps the package - `U18.10` cost 18.4 mm and took
`U18.2`'s only lane with it. **PR-32** re-measure before every fine-pitch pin. **PR-33** U19 is an
SOT-23-8 on 0.65 mm pitch and had no measured ordering at all; giving it one recovered three pins.

The lesson underneath all four: **an escape proof measures a 0.5 mm stub and a connection is a
route.** Four placements passed the section 12 gate - including its section 3C simultaneity test,
49 escapes laid at once with none lost - and then failed Phase A. The fix was not a better proxy
but a worse-scaling one: route the pin field with the real router, against the copper the plan lays
first.

**B-34 stays open.** Scratch pack-current copper is approximately 64.9 mOhm, essentially unchanged
from 002E, so the ECO cost the load path nothing. Physical validation remains mandatory.

## 2026-08-25 - the block routes, the pin field does not (FBV2-P2-002E)

**FBV2-P2-002E = FAIL.** Phase A did not complete, so Phase B never ran and
`aqroot-Beta-v2.kicad_pcb` is byte-identical to `e09eb35`: zero tracks, zero signal vias. PCB
routing stays 0 %, overall stays 74 %. Full analysis:
[`audits/2026-08-25-p2-battery-authoritative-route.md`](audits/2026-08-25-p2-battery-authoritative-route.md).

**First unresolved FUNCTIONAL connection: `BAT_RAW` `R80.1 -> Q2.7`. Most consequential:
`LTC_GATE` `U18.10 -> Q3.4`.**

### 60 connections, ratsnest -63, and a DRC that never moved

The previous best was 27 connections and -32. This run closed the whole high-current path end to
end - `J4 -> F1 -> Q2 -> Q3 -> R75 -> D9 -> U11.2` - with the `BAT_PROTECTED_P` trunk at its
**1.50 mm target on B.Cu carrying zero vias**, both R75 Kelvin branches, the U11.2 flare, the
MAX17048 taps, and **the dead-cell / recovery network for the first time**. DRC after every single
connection was identical to the baseline: no new violation of any class, ever.

### A segmentation fault, and four more harness defects

`split_at()` replaces one track in `qb.laid` with two, and the mark taken before it is an index
into that same list. Nothing shifted the mark, so `revert()` removed a track belonging to the
**trunk** and left one of the branch's own behind - and a second revert on the same trunk called
`BOARD::Remove` on an item no longer in the list, which segfaults rather than raising. Exit 139 at
`TP34.1`, 55 connections in, with no Python traceback because only the watchdog was armed.

Fixed, made undoable, `faulthandler.enable()` turned on, and pinned by a new **`router_regression`
G7** that checks the arithmetic rather than waiting for a crash. Also fixed: an item budget that
starved the F.Cu fallback and made the router look nondeterministic (**PR-20**); trunks silently
dropping width to buy a layer hop (**PR-21**); and an already-connected check that read a FILE
still holding reverted copper, so connections that had never been routed were counted as done
(**PR-22**).

### Ordering is section 8's, and inside the pin field it is measured

Putting U18's pin field before the trunk let a 0.20 mm sense tap take the 1.20 mm trunk's only
escape from `R75.2` - and copper on this board only accumulates, so no later pass can give it back.
Section 8's order (trunk first) is what buys the 1.50 mm trunk. Inside the pin field there is no
right fixed order at all: three hand-picked ones each moved the casualty. It is now measured by
binary search once per pass, tightest pin first. And section 9's gate-before-CS is proved on Q3,
where the CS route threads both 0.67 mm gaps and leaves `Q3.2` with no escape on any layer.

### What is left is placement, not routing

Nine of the fifteen open connections failed `NO_LEGAL_ESCAPE` at 0 s - the pad cannot emit a legal
track at any width on any layer before pathfinding is even attempted. **U18 escapes 6 of its 8
signal pins here, 7 at best**, because its whole north row shares one ~2.2 mm corridor between the
package and the R76/R77/R78/R79 divider wall. That is **PR-25**, and it needs a placement ruling
rather than another routing attempt. Section 11 forbids weakening the architecture to finish, so
nothing was dropped, re-aimed or re-valued.

**B-34 is not recalculated authoritatively and stays OPEN.** **PM-2 does not close.**

## 2026-08-24 - width becomes a path role, and the board still says no (FBV2-P2-002C)

**FBV2-P2-002C = FAIL.** Phase A did not complete, so Phase B never ran and
`aqroot-Beta-v2.kicad_pcb` is byte-identical to `a52977e`: zero tracks, zero signal vias. PCB
routing stays 0 %, overall stays 74 %. Full analysis:
[`audits/2026-08-24-p2-battery-authoritative-route.md`](audits/2026-08-24-p2-battery-authoritative-route.md).

**First unresolved connection: `LTC_GATE` `Q2.2 -> TP17.1`.**

### D-249: width is a path role

D-245 said `BAT_PROTECTED_P` should be 1.50 mm because it is the one long high-current run. That is
still right. What was wrong is that the rule said it about the NET NAME, and the same net also feeds
the MAX17048 fuel-gauge sense input, the LTC4368 VOUT sense input and a test point - none of which
carries load current, and none of whose land patterns can accept 1.20 mm. **As written, D-245 made
the net unroutable.**

The replacement keeps the trunk floor on the whole net and relaxes it ONLY inside a named rule area
that bounds one approved branch, through `enclosedByArea()`, which requires the WHOLE track to be
inside. A branch that wanders out of its area is measured against the trunk floor and fails.

**Where those rules live turned out to matter as much as what they say.** Section 9 of `.kicad_dru`
already records that KiCad applies the LAST matching rule and that the necking and land-pattern
blocks must sit at the end. Put the path-role rules in section 5b and they are silently overridden
by *"Pad-escape necking - width, fine-pitch power packages"* - which is exactly the trap section 9
was written to warn about. They now live in a new **section 10b at the very end**, widest first and
narrowest last so that overlapping areas resolve to the lower floor instead of a false violation.

### U11.2 did not need the 0.19 mm exception

Section 6 authorised dropping to 0.19 mm if 0.20 mm proved impossible. It is not impossible.
**TI's own DLH0010A land pattern is 0.2 mm pads on 0.4 mm pitch**, so 0.20 mm is the widest copper
that can ever leave that pad - the package is the bottleneck, not the rule - and JLCPCB's live
capability page gives 0.09 / 0.09 mm on 1 oz multilayer, so nothing here is fab-limited. The earlier
"0.195 mm" was an artefact of the router subtracting half a sampling step; with exact
segment-to-shape geometry the answer is **exactly 0.200 mm**.

The measured escape: **0.20 mm for 0.575 mm**, then 0.30, 0.40, 0.60, 0.80, 1.00 and 1.20 mm,
reaching the 1.50 mm trunk 5.079 mm from the pad. No via, no thermal relief, about 4.3 mOhm.

**One part of section 6 is NOT met and is flagged rather than smoothed over.** The neck complies at
0.575 mm against the 1.00 mm cap, but the copper BELOW the 1.20 mm trunk floor runs 4.738 mm. It
cannot be shorter: the nearest point to U11.2 that admits 1.20 mm *and is reachable from the rest of
the net* is 2.511 mm away.

### U14 misses 0.20 mm by five microns

`U14` sits 1.245 mm from the west board edge with its pin row facing that edge. Copper must be
>= 0.500 mm from the edge and >= 0.200 mm from pads whose west edge is at x = 0.895, so a track of
width w needs its centre at x >= 0.500 + w/2 AND x <= 0.695 - w/2 - solvable only for
**w <= 0.195 mm**. Section 5 locked 0.20 mm. It routes at **0.15 mm**, the board's own minimum and
1.7x JLCPCB's, carrying a nanoamp sense input. Flagged for ratification.

A related fix caught a violation on the way: the router now insets the board outline by half the
Edge.Cuts stroke, because copper-to-edge clearance is measured to the LINE, not to the outside of
the stroke. That 25 um is what turned a 0.475 mm edge clearance into a caught error rather than a
committed one.

### What routed

Twenty-seven connections coexisting on one scratch board, each gated on project-context DRC with the
In1 plane refilled every time: the `BAT_PROTECTED_P` trunk `R75 -> D9 -> U11.2` at **94.5 mm,
1.50 mm, B.Cu, ZERO vias**; `BAT_CONNECTOR_P`, `BAT_RAW` and `BAT_MID` at 0.80-1.00 mm; both R75
Kelvin branches at 0.20 mm with zero vias, **7.327 mm on the U18.9 side against 14.588 mm on the
U18.8 side, mismatch 7.261 mm**, both taken directly off the correct R75 pad; the fuel-gauge and
test taps; and three of the six LTC gate connections. Ratsnest 781 -> 749. **Zero new DRC violations
of any class, at every step.**

The only vias in the whole attempt are **four**: the `BAT_SENSE` `Q3 -> R75` trunk and the TP20 stub
hop to F.Cu, because the west margin cannot carry both that trunk and the 1.50 mm
`BAT_PROTECTED_P` past R75 on B.Cu alone.

### B-34 from real copper, and it is worse

Routed copper is **~75.0 mOhm**, not the ~50.6 mOhm the estimate assumed. With F1 at ~25 mOhm,
Q2+Q3 at ~46 mOhm and the BQ25185 BATFET at 115 mOhm the path is **~392 mV / 588 mW at 1.5 A** and
**~457 mV / 800 mW at 1.75 A**. The trunk is at its ruled 1.50 mm; the excess sits in `BAT_MID` and
`BAT_SENSE`, which the corridors forced to 0.80 mm instead of the 1.00 mm class target.
**B-34 stays OPEN - physical validation required.**

### And one weakness worth naming

Section 7 asked that the construction make it IMPOSSIBLE for a long high-current run to masquerade
as a branch. It does not fully manage that yet. The bounded areas are generated from each routed
branch's own bounding box, and three of them are tight - but the C58 decoupling tap's box is
**67 x 23 mm at a 0.80 mm floor**, which is a real hole in the trunk rule. The fix is to build the
area from the route's centre-line rather than its bounding box. That is a router change, not a rule
change, and it is carried as PR-11.

---

## 2026-08-24 - the router on trial, and a rule that cannot be routed (FBV2-P2-002B)

**ROUTER HARNESS QUALIFICATION = PASS.** No copper was committed; the authoritative PCB is
byte-identical to `8b9efba`, zero tracks, zero signal vias. PCB routing stays 0 %, overall stays
74 %. Full evidence:
[`audits/2026-08-24-routing-harness-qualification.md`](audits/2026-08-24-routing-harness-qualification.md).

### The scratch environment, first, because that was the last task's real bug

FBV2-P2-002A spent an entire routing attempt reading a phantom `clearance: 73,
lib_footprint_issues: 17` offset on every net. The cause: a `.kicad_pcb` copied on its own loses
`.kicad_dru`, the `.kicad_pro` netclasses and `fp-lib-table`, and DRC then silently measures against
KiCad **defaults**. Every board in this task is a **complete copy of the whole project directory**,
and the harness refuses to run DRC unless all five of those are present beside it. Required proof
holds exactly: authoritative and scratch baselines are both
`{solder_mask_bridge: 1, unconnected_items: 499}`. **Phantom DRC offset: none.**

### All three defects fixed, and a fourth found

**`track_dangling`** had two causes, and the coordinate one was the smaller. The emitter is now
**integer nanometres end to end**, so a neck's end and a trunk's start are the *same integer* rather
than two floats that agree to a rounding step. But the bigger cause was that **the old router never
checked which layer a pad was on** - it would start a `B.Cu` track at the centre of an `F.Cu`-only
pad, which is a dangling end by construction. That is not hypothetical: **`TP34.1` is an `F.Cu`-only
pad on the otherwise-`B.Cu` net `BAT_CONNECTOR_P`.**

**`track_width`** is now governed by one rule: **the routing rule minimum wins.** The escape width
ladder starts at the trunk width and stops at the applicable floor. It never derives a width from a
pad's short dimension. If nothing at or above the floor can leave the pad, the pad is classified
**NO LEGAL ESCAPE** and **nothing is emitted**.

**`shorting_items`** is fixed by giving the neck the *same* obstacle set as the trunk - foreign pads
as true rotated rounded rectangles rather than bounding boxes, tracks as capsules, every drilled
hole on every layer, rule areas, the board edge - and checking it **analytically**, so a short neck
gets a stricter test than the trunk rather than a weaker one.

**And a fourth defect that was not on the list.** A* proves that *grid cells* are clear; the emitted
track is a *continuous segment* between them and can pass three-quarters of a cell closer to an
obstacle than either endpoint. It duly produced `actual 0.1718 mm` against a 0.2000 mm rule. Every
obstacle now carries a **0.75 x grid guard band**. The price is honest: `R86.2 -> R89.1` no longer
fits at 0.05 mm and needs the local 0.025 mm grid.

### Six of eight cases route clean

`Q2_CS` 5.500 mm, `Q3_CS` 5.500 mm, `BAT_MID` 24.860 mm, `LTC_GATE` 66.982 mm, `LTC_OV` 15.179 mm,
`R86.2 -> R89.1` 45.274 mm. Each on its own fresh project-faithful copy, each with **zero** new DRC
violations of any class, **one** connected copper component after a real save and reload, **no**
foreign pad in the cluster, and the ratsnest falling by **exactly one edge per connection**.

### The two that did not are a rule conflict, and it is the finding of the task

Five pads cannot legally accept the width their rules demand. Bisected to 5 um against the
project's own clearances, and the closed-form arithmetic matches to the bisection step:

| pad | package | floor | widest legal escape |
|---|---|---|---|
| `U18.9` | MSOP-10, 0.50 mm pitch | 0.600 mm | **0.245 mm** |
| `U18.8` | MSOP-10, 0.50 mm pitch | 1.200 mm | **0.245 mm** |
| `U14.2` / `U14.3` | T822, 0.50 mm pitch | 1.200 mm | **0.295 mm** |
| `U11.2` | WSON-10, 0.40 mm pitch | 1.200 mm | **0.195 mm** |

**The problem is rule scope.** `BAT_MAIN`'s 0.60 mm floor and D-245's 1.20 mm floor are written as
**whole-net** constraints, but `BAT_SENSE` is a Kelvin sense line carrying microamps, and
`BAT_PROTECTED_P` carries the pack current *and* feeds the MAX17048's fuel-gauge sense input and a
test point, neither of which carries any current at all. D-245's comment already anticipates a neck
exception; **the rule body does not contain one**, so **as written D-245 makes `BAT_PROTECTED_P`
unroutable.** Section 6 said not to invent an exception and section 17 said not to hide it by
weakening rules. **Nothing in `.kicad_dru` was touched.** It is PR-7, and it needs a ruling.

### What the 1.50 mm trunk actually costs

`R75.2 -> U18.8 -> D9.1 -> C25.1` routes at **1.50 mm in 85.274 mm, 22 segments, B.Cu, ZERO vias**,
every segment at full width except the two mandatory 0.245 mm `U18.8` escapes. Past `C25.1` the
charger cluster caps the trunk at 0.60 mm and `U11.2`'s own land pattern caps it at 0.195 mm.

**And D-245's arithmetic needs correcting.** It used the **71 mm placement span**; the measured
route is **85.3 mm**, because copper goes around things. With the unavoidable `U18.8` neck at
7.8 mOhm in 3.9 mm of copper, `BAT_PROTECTED_P` as actually routable is **~35.7 mOhm**, so the net
gains **~6 mOhm rather than the predicted ~11.7 mOhm**. That does not argue against D-245 - it
argues that the neck exception, when ruled, should carry a bounded length and a stated resistance
budget.

### No placement was moved, and none needed to be

`R86.2 -> R89.1` routes legally at 1.00 mm (45.274 mm) and at 0.60 mm (16.848 mm). `TP15.1 ->
U14.2` routes legally at 0.20 mm (8.82 mm) - it was never a geometry problem, so **moving `TP15`
would not have helped and `U14` was never a candidate.** The <= 2.0 mm allowance was not spent.

### Also landed

**`hardware/beta-v2/checks/router_regression.py`** - 22 assertions across six guards, building and
removing its own throwaway project-faithful workspace, and **pinning the five proved land-pattern
conflicts by their exact widths** so that relaxing a rule or moving a part fails the test instead of
passing silently. **ALL CHECKS PASS.** The router is committed beside it as `qrouter.py` so the two
cannot drift apart.

**Opportunity scan (section 19): no native installed routing mechanism exists.** `kicad-cli pcb` has
no routing subcommand, `pcbnew` exposes no scriptable PNS, `kipy` is not installed, and Freerouting
is not installed - and would be the wrong tool anyway, since Specctra DSN carries netclass width and
clearance but **not** custom `.kicad_dru` rules, so D-245 and the rule areas would be invisible to
it. **Keep the qualified harness.**

---

## 2026-08-24 - a router that refuses to keep bad copper (FBV2-P2-002A)

**FBV2-P2-002A = FAIL. The battery / protection block is NOT routed.** No progress; PCB routing
stays 0 %, overall stays 74 %. Full analysis:
[`audits/2026-08-24-p2-battery-protection-routing.md`](audits/2026-08-24-p2-battery-protection-routing.md).

**The board still carries zero tracks and zero signal vias.** Two of twenty-nine nets came out
DRC-clean; the other twenty-seven were reverted automatically, and the two clean ones went with
them rather than be committed as an unrepresentative fragment.

### The deliverable is the method, and that was the point

FBV2-P2-001 failed because a minimum-spanning-tree router drew straight lines through other pads
and produced 505 violations. Section 4 of this task forbade that class of approach outright. What
replaced it:

**Obstacle-aware A\* on a 0.10 mm grid**, rebuilt per connection from the real board - every
foreign pad, every track already laid, every track-forbidding rule area including the one embedded
inside `U1`'s own footprint, and the board edge, each inflated by (clearance + width/2) so that a
legal path on the grid is a legal track on the board.

**Pad-escape necking**, because a 1.00 mm `BAT_MAIN` trunk physically cannot land on `U18` - an
MSOP-10 on 0.50 mm pitch whose pad-to-pad gap is **0.20 mm**. That is also why the first run
reported "NO PATH" on a 2.44 mm hop: the destination was genuinely unreachable at trunk width,
which is a property of the land pattern rather than a bug.

**Per-net DRC gating.** After every net the board is saved to its own path - so DRC sees the
project's own `.kicad_dru` and netclasses, which a scratch-file approach did not - and any new
violation of any class reverts that net before the next one starts. Violations never accumulate.

That last property is the one that matters: **the router refused to keep anything unclean, and the
result is a board with no copper on it rather than a board with hidden shorts.**

### Three defects remain, and all three are named

**`track_dangling` on seventeen nets** - the escape neck and the trunk do not register as joined at
the launch point. A geometry bug in the emitter, not an electrical problem, but a dangling end is
exactly what must never be committed. **`track_width` on `BAT_MID` and `BAT_SENSE`** - the neck
width is taken from the pad's short dimension and on an SO-8 that falls below the `BAT_MAIN`
0.60 mm floor; **the rule is right and the router is wrong.** **`shorting_items` on six nets** - the
neck is laid without consulting the obstacle grid, so it can cross a neighbour even where the trunk
cannot.

None of them is a reason to change placement, widths or topology.

Two connections have no path at trunk width at all - `R86.2` to `R89.1` and `TP15.1` to `U14.2`,
both in the dense left-margin resistor column. They need either a finer routing grid there or a
2 mm placement nudge, and per section 9 that is **surfaced rather than taken**.

### D-245: one net gets a wider trunk, and only one

`BAT_PROTECTED_P` now has a **scoped per-net override - 1.50 mm target, 1.20 mm floor** - added to
`.kicad_dru` and as row A2 of the ledger. **The `BAT_MAIN` class is untouched**: the other four
battery nets keep 1.00 mm / 0.60 mm, because none of them carries the pack current over anything
like the same distance.

The arithmetic is the whole justification. At about 71 mm this net is **about 69 % of the entire
protection path's copper resistance on its own** - 34.9 mOhm at 1.00 mm against 23.3 mOhm at
1.50 mm - taking path copper from about 50.6 to about 38.9 mOhm and the 1.5 A copper loss from 114
to 88 mW.

The neckdown allowance that comes with it is written as a policy, not a loophole: shortest length
that clears the package, never a traverse, length and width documented per pad, no thermal-relief
or single-via bottleneck. **The 1.20 mm figure is the trunk floor, not a licence for a narrow run.**

### B-34, with the unit confusion corrected

The FBV2-P2-001 write-up's copper figure is **about 50.6 mOhm**, not 525 mOhm. With `F1` about
25 mOhm, the two FETs about 46 mOhm and the BQ25185 BATFET's **115 mOhm**, the path is **about
355 mV / 532 mW at 1.5 A** and **about 414 mV / 724 mW at 1.75 A**. Nothing is clearly unsafe.
**B-34 stays open - physical validation required**, and D-245 takes the copper term to about
38.9 mOhm once the net is actually routed.

**PM-2 does not close.** Its placement correction is approved and retained; closure still waits on
DRC-clean routing, which is what it always said it would.

---

## 2026-08-24 — the ground plane, and a routing attempt that was reverted (FBV2-P2-001)

**FBV2-P2-001 = FAIL. The power tree is NOT routed.** No progress; PCB routing stays 0 %, overall
stays 74 %. Full analysis:
[`audits/2026-08-24-p2-power-routing.md`](audits/2026-08-24-p2-power-routing.md).
New working document: [`pcb/FBV2_P2_POWER_ROUTING.md`](pcb/FBV2_P2_POWER_ROUTING.md).
Pre-routing checkpoint tag **`beta-v2-p2-entry-pass` → `faa0c91`**, annotated and pushed.

**The board still carries zero tracks and zero signal vias.** What it gained is the In1.Cu ground
plane and two corrective placement passes that the routing exposed as prerequisites.

### The ground plane exists, and the regression now knows what it is

In1.Cu is one zone, **one island**, net GND, **9938.9 mm² of a 10656 mm² board — 93.3 %**, with a
solid pad connection and no thermal relief. No split, no analog island, and its single authorised
void — the ESP32 antenna keep-out — is cut by the four-layer rule area that already existed rather
than by a polygon carved by hand. F.Cu and B.Cu pours were deliberately **not** created: they are
the last step of FBV2-P2, and making them now would hide return paths rather than prove them.

`p1_regression.py` had a blanket *"0 fills"* expectation, which was right when nothing was allowed
to exist and wrong the moment a reference plane did. It now checks **0 tracks / 0 vias / 0 outer
pours**, and separately that **In1 is exactly one GND zone of exactly one island** — so a split
reference is a gate failure instead of an invisible mistake.
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
