aqroot8/aqroot/hardware/demo/fab/aqroot-Demo-assembly-bottom.pdf

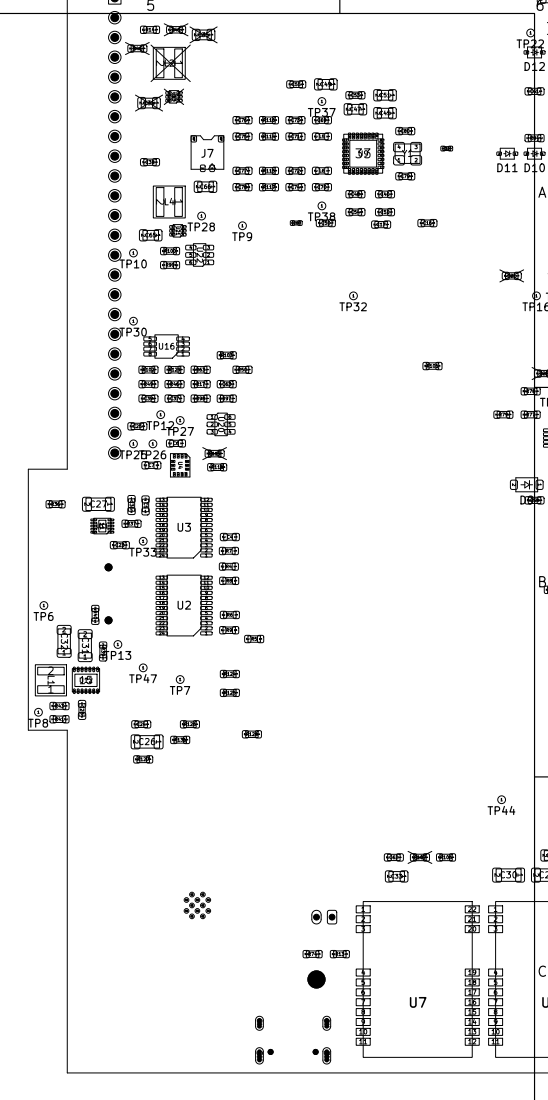
[picture p2: page 1]

Size: A4 | Rev:
KiCad E.D.A. 10.0.5 | Id: 1/1
