aqroot8/aqroot/hardware/demo/fab/aqroot-Demo-assembly-top.pdf

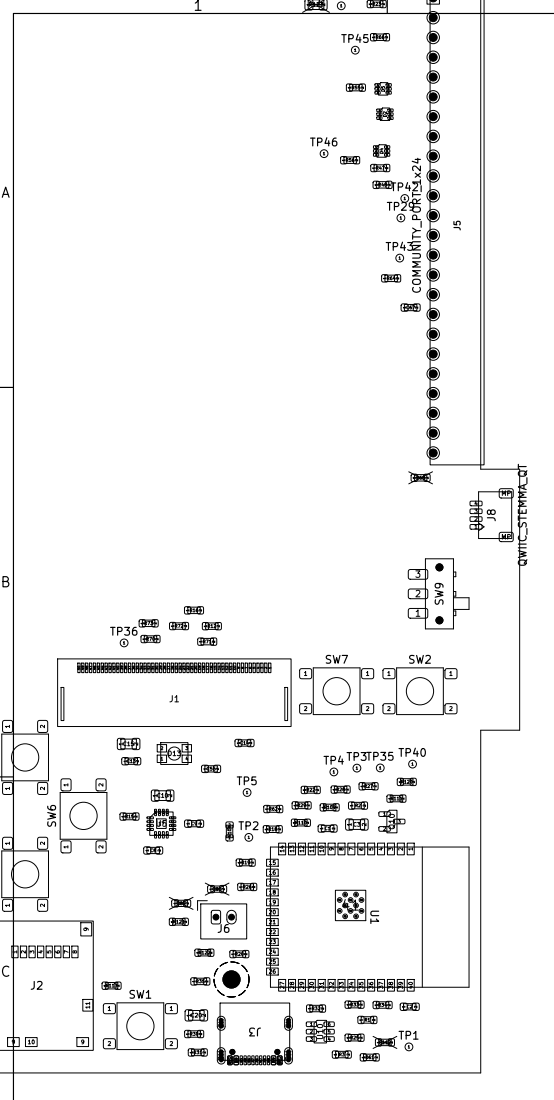
[picture p3: page 1]

Size: A4 | Rev:
KiCad E.D.A. 10.0.5 | Id: 1/1
