aqroot8/aqroot/hardware/beta-dm/fab/aqroot-Beta-DM-assembly-bottom.pdf

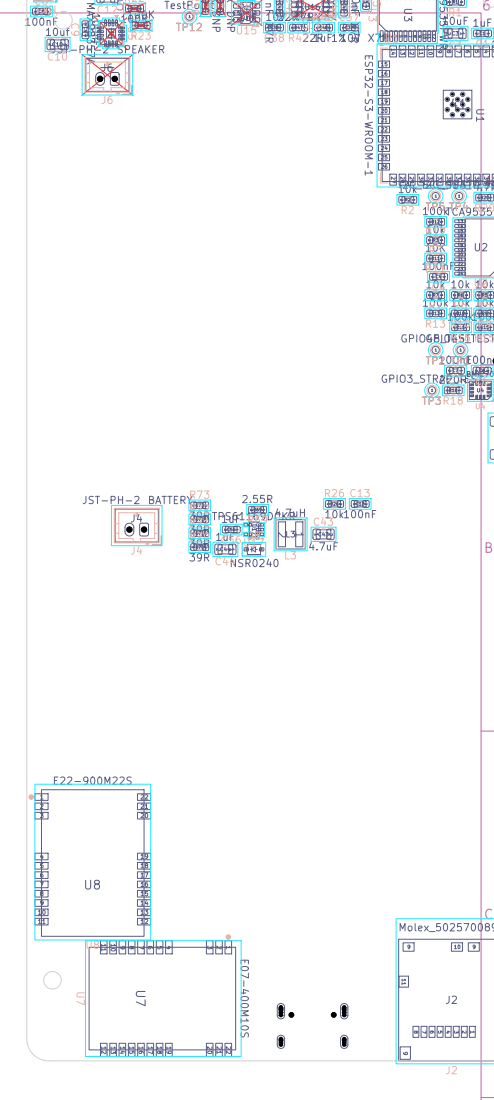
[picture p4: page 1]

Sheet:
File: aqroot-Beta-DM.kicad_pcb
Title:

Size: A4 | Rev:
KiCad E.D.A. 10.0.3 | Id: 1/1
