aqroot8/aqroot/hardware/beta-dm/fab/aqroot-Beta-DM-assembly-top.pdf

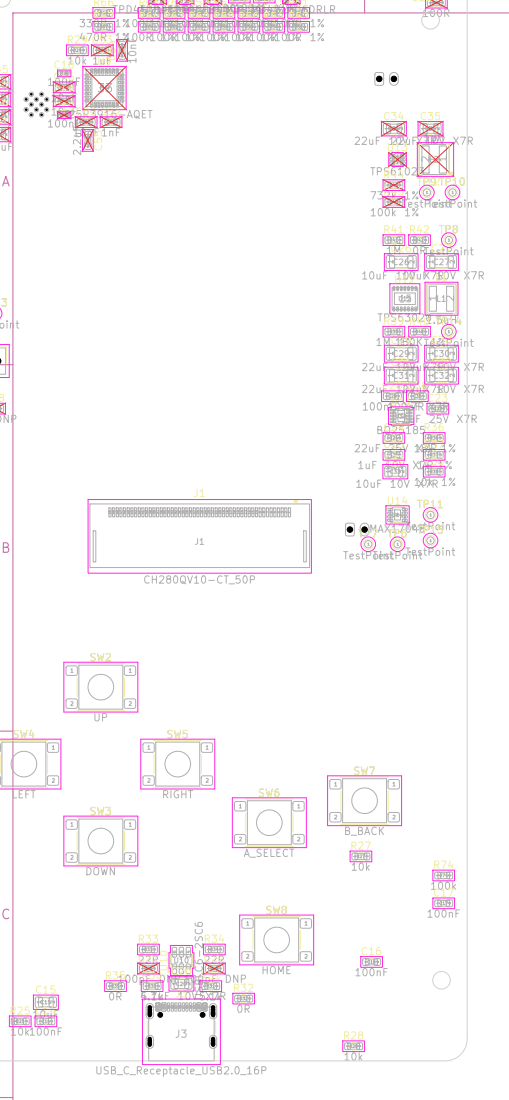
[picture p5: page 1]

R59 | | R46 TPD4E1B06DRLR D3 100R 1% R55 | C39 100R 1% | R52 R51 | R21 470R 1%

Sheet:
File: aqroot-Beta-DM.kicad_pcb
Title:

Size: A4 | Rev:
KiCad E.D.A. 10.0.3 | Id: 1/1
