aqroot8/aqroot/hardware/demo/kicad/aqroot-demo/aqroot-Beta-v2.kicad_pcb

## KiCad design hardware/demo/kicad/aqroot-demo/aqroot-Beta-v2.kicad_pcb (2026-09-18)

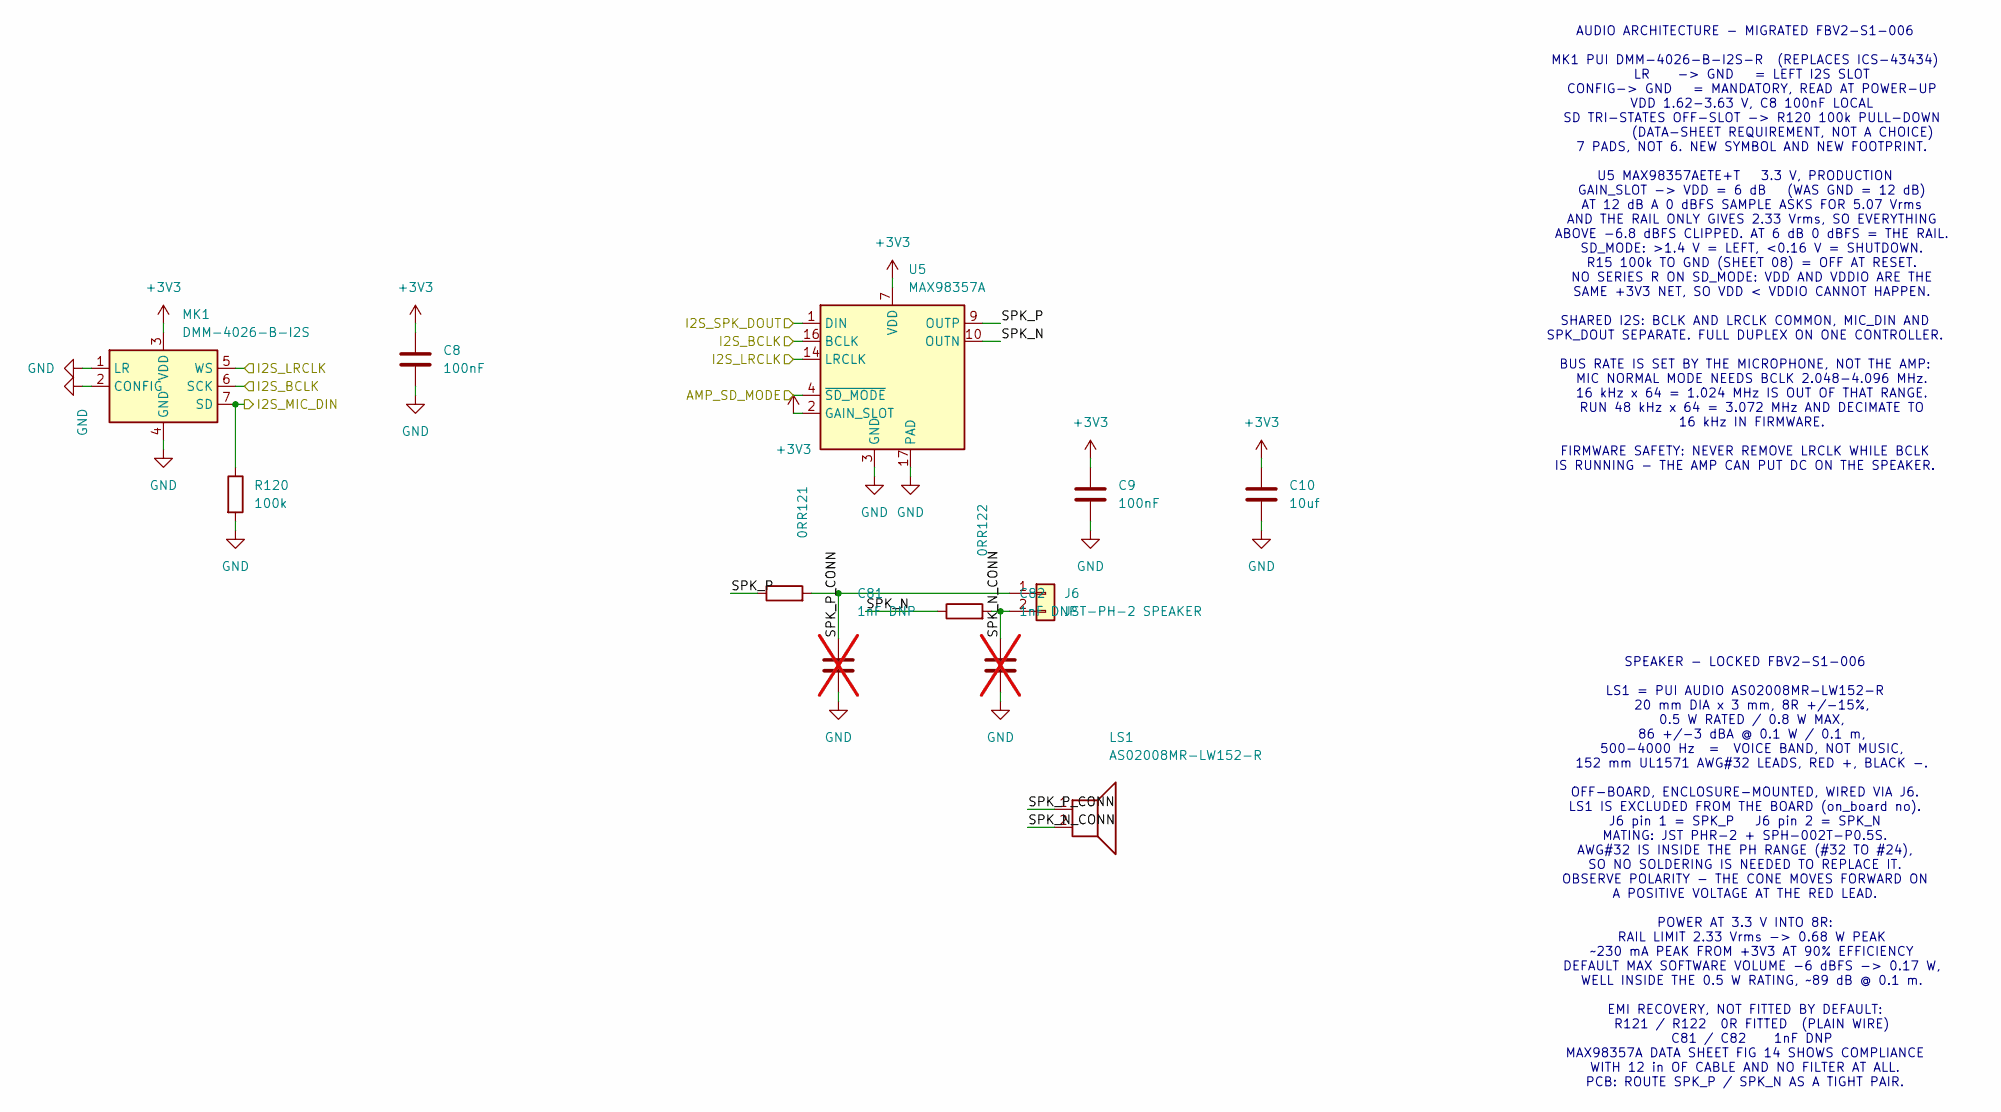
[picture p6: schematic 06_audio.kicad_sch]

Parts:
C8, C9: 100nF; C_0603_1608Metric; MPN CC0603KRX7R9BB104; LCSC C14663
C10: 10uf; C_0805_2012Metric; MPN GRM21BR61H106KE43L; LCSC C440198
C81, C82: 1nF DNP; C_0603_1608Metric; not fitted
J6: JST-PH-2 SPEAKER; JST_PH_B2B-PH-K_1x02_P2.00mm_Vertical; MPN B2B-PH-K-S(LF)(SN); LCSC C131337
LS1: AS02008MR-LW152-R; MPN AS02008MR-LW152-R; LCSC C3311653
MK1: DMM-4026-B-I2S; PUI_DMM-4026-B-I2S_4.0x3.0mm; MPN DMM-4026-B-I2S-R; LCSC C3171792
R120: 100k; R_0603_1608Metric; MPN 0603WAF1003T5E; LCSC C25803
R121, R122: 0R; R_0603_1608Metric; MPN 0603WAF0000T5E; LCSC C21189
U5: MAX98357A; TQFN-16-1EP_3x3mm_P0.5mm_EP1.23x1.23mm; MPN MAX98357AETE+T; LCSC C910544

Connections:
+3V3: C8.1, C9.1, C10.1, MK1.3 (VDD), U5.2 (GAIN_SLOT), U5.7 (VDD), U5.8 (VDD); also elsewhere on the board
/06_AUDIO/SPK_N: R122.1, U5.10 (OUTN)
/06_AUDIO/SPK_N_CONN: C82.1, J6.2, LS1.2, R122.2
/06_AUDIO/SPK_P: R121.1, U5.9 (OUTP)
/06_AUDIO/SPK_P_CONN: C81.1, J6.1, LS1.1, R121.2
/AMP_SD_MODE: U5.4 (~SD_MODE); also elsewhere on the board
/I2S_BCLK: MK1.6 (SCK), U5.16 (BCLK); also elsewhere on the board
/I2S_LRCLK: MK1.5 (WS), U5.14 (LRCLK); also elsewhere on the board
/I2S_MIC_DIN: MK1.7 (SD), R120.1; also elsewhere on the board
/I2S_SPK_DOUT: U5.1 (DIN); also elsewhere on the board
GND: C8.2, C9.2, C10.2, C81.2, C82.2, MK1.1 (LR), MK1.2 (CONFIG), MK1.4 (GND), R120.2, U5.3 (GND), U5.11 (GND), U5.15 (GND), U5.17 (PAD); also elsewhere on the board

Notes on the sheet:
AUDIO ARCHITECTURE - MIGRATED FBV2-S1-006 MK1 PUI DMM-4026-B-I2S-R (REPLACES ICS-43434) LR -> GND = LEFT I2S SLOT CONFIG-> GND = MANDATORY, READ AT POWER-UP VDD 1.62-3.63 V, C8 100nF LOCAL SD TRI-STATES OFF-SLOT -> R120 100k PULL-DOWN (DATA-SHEET REQUIREMENT, NOT A CHOICE) 7 PADS, NOT 6. NEW SYMBOL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
SPEAKER - LOCKED FBV2-S1-006 LS1 = PUI AUDIO AS02008MR-LW152-R 20 mm DIA x 3 mm, 8R +/-15%, 0.5 W RATED / 0.8 W MAX, 86 +/-3 dBA @ 0.1 W / 0.1 m, 500-4000 Hz = VOICE BAND, NOT MUSIC, 152 mm UL1571 AWG#32 LEADS, RED +, BLACK -. OFF-BOARD, ENCLOSURE-MOUNTED, WIRED VIA J6. LS1 IS EXCLUDED FROM THE BOA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

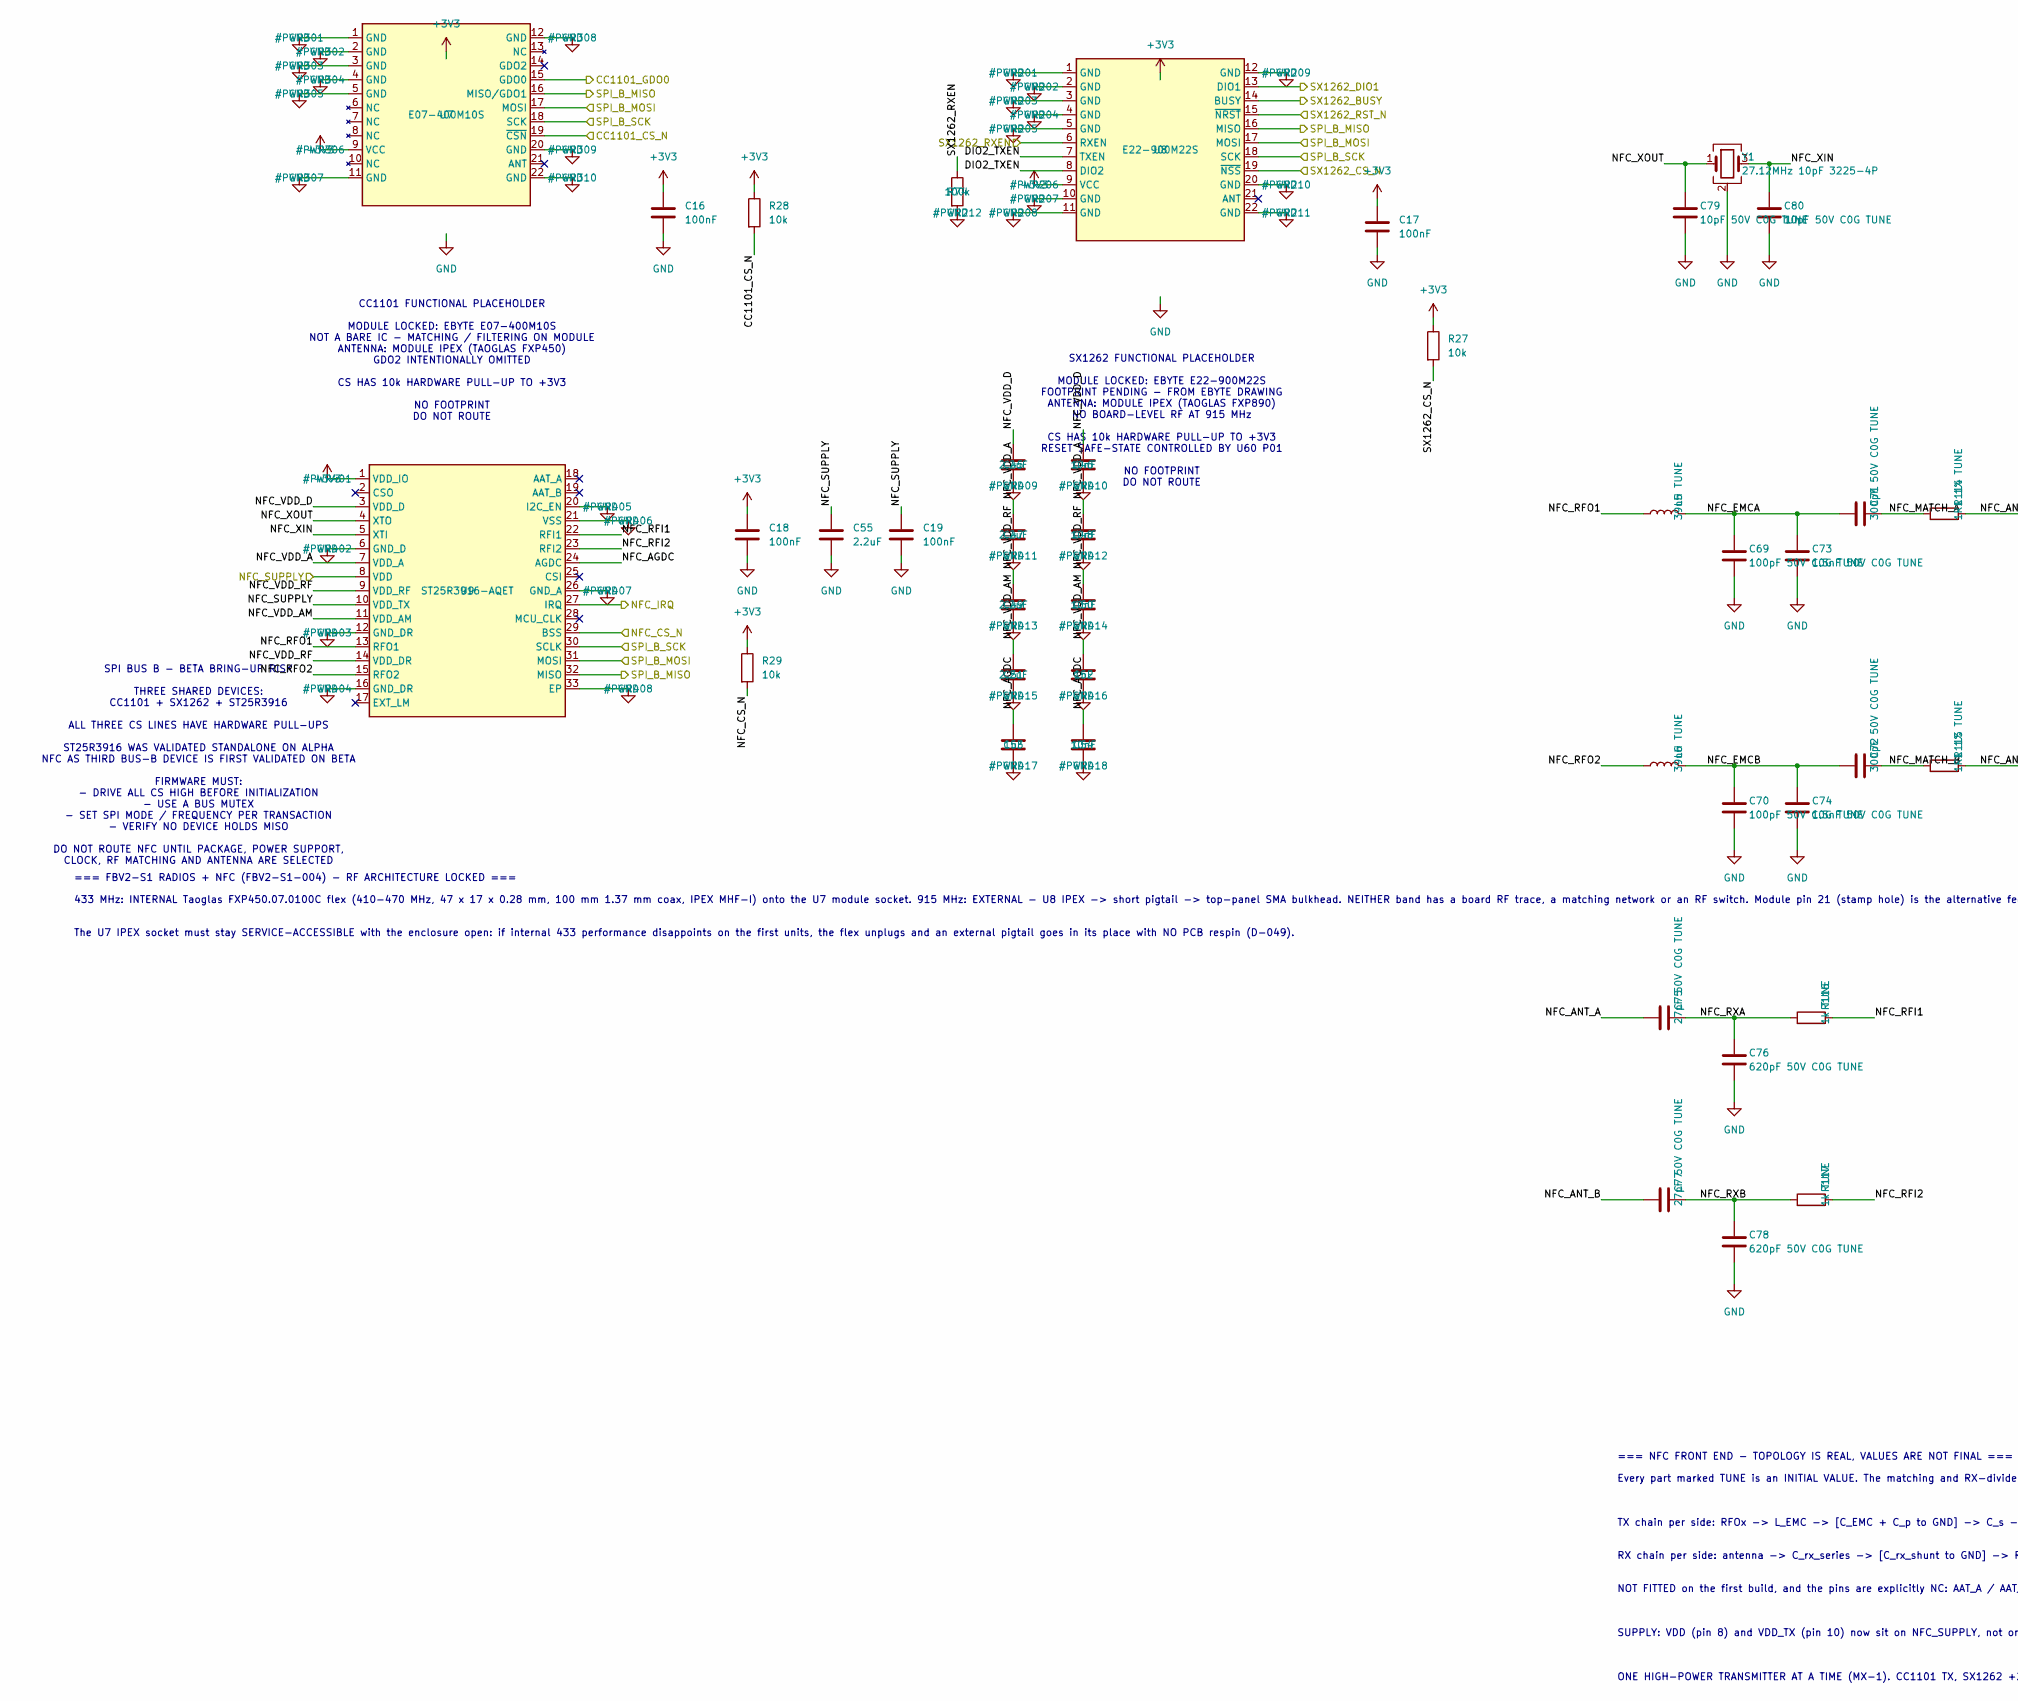
[picture p7: schematic 04_spi_b_radios_nfc.kicad_sch, part in row 1, column 1]

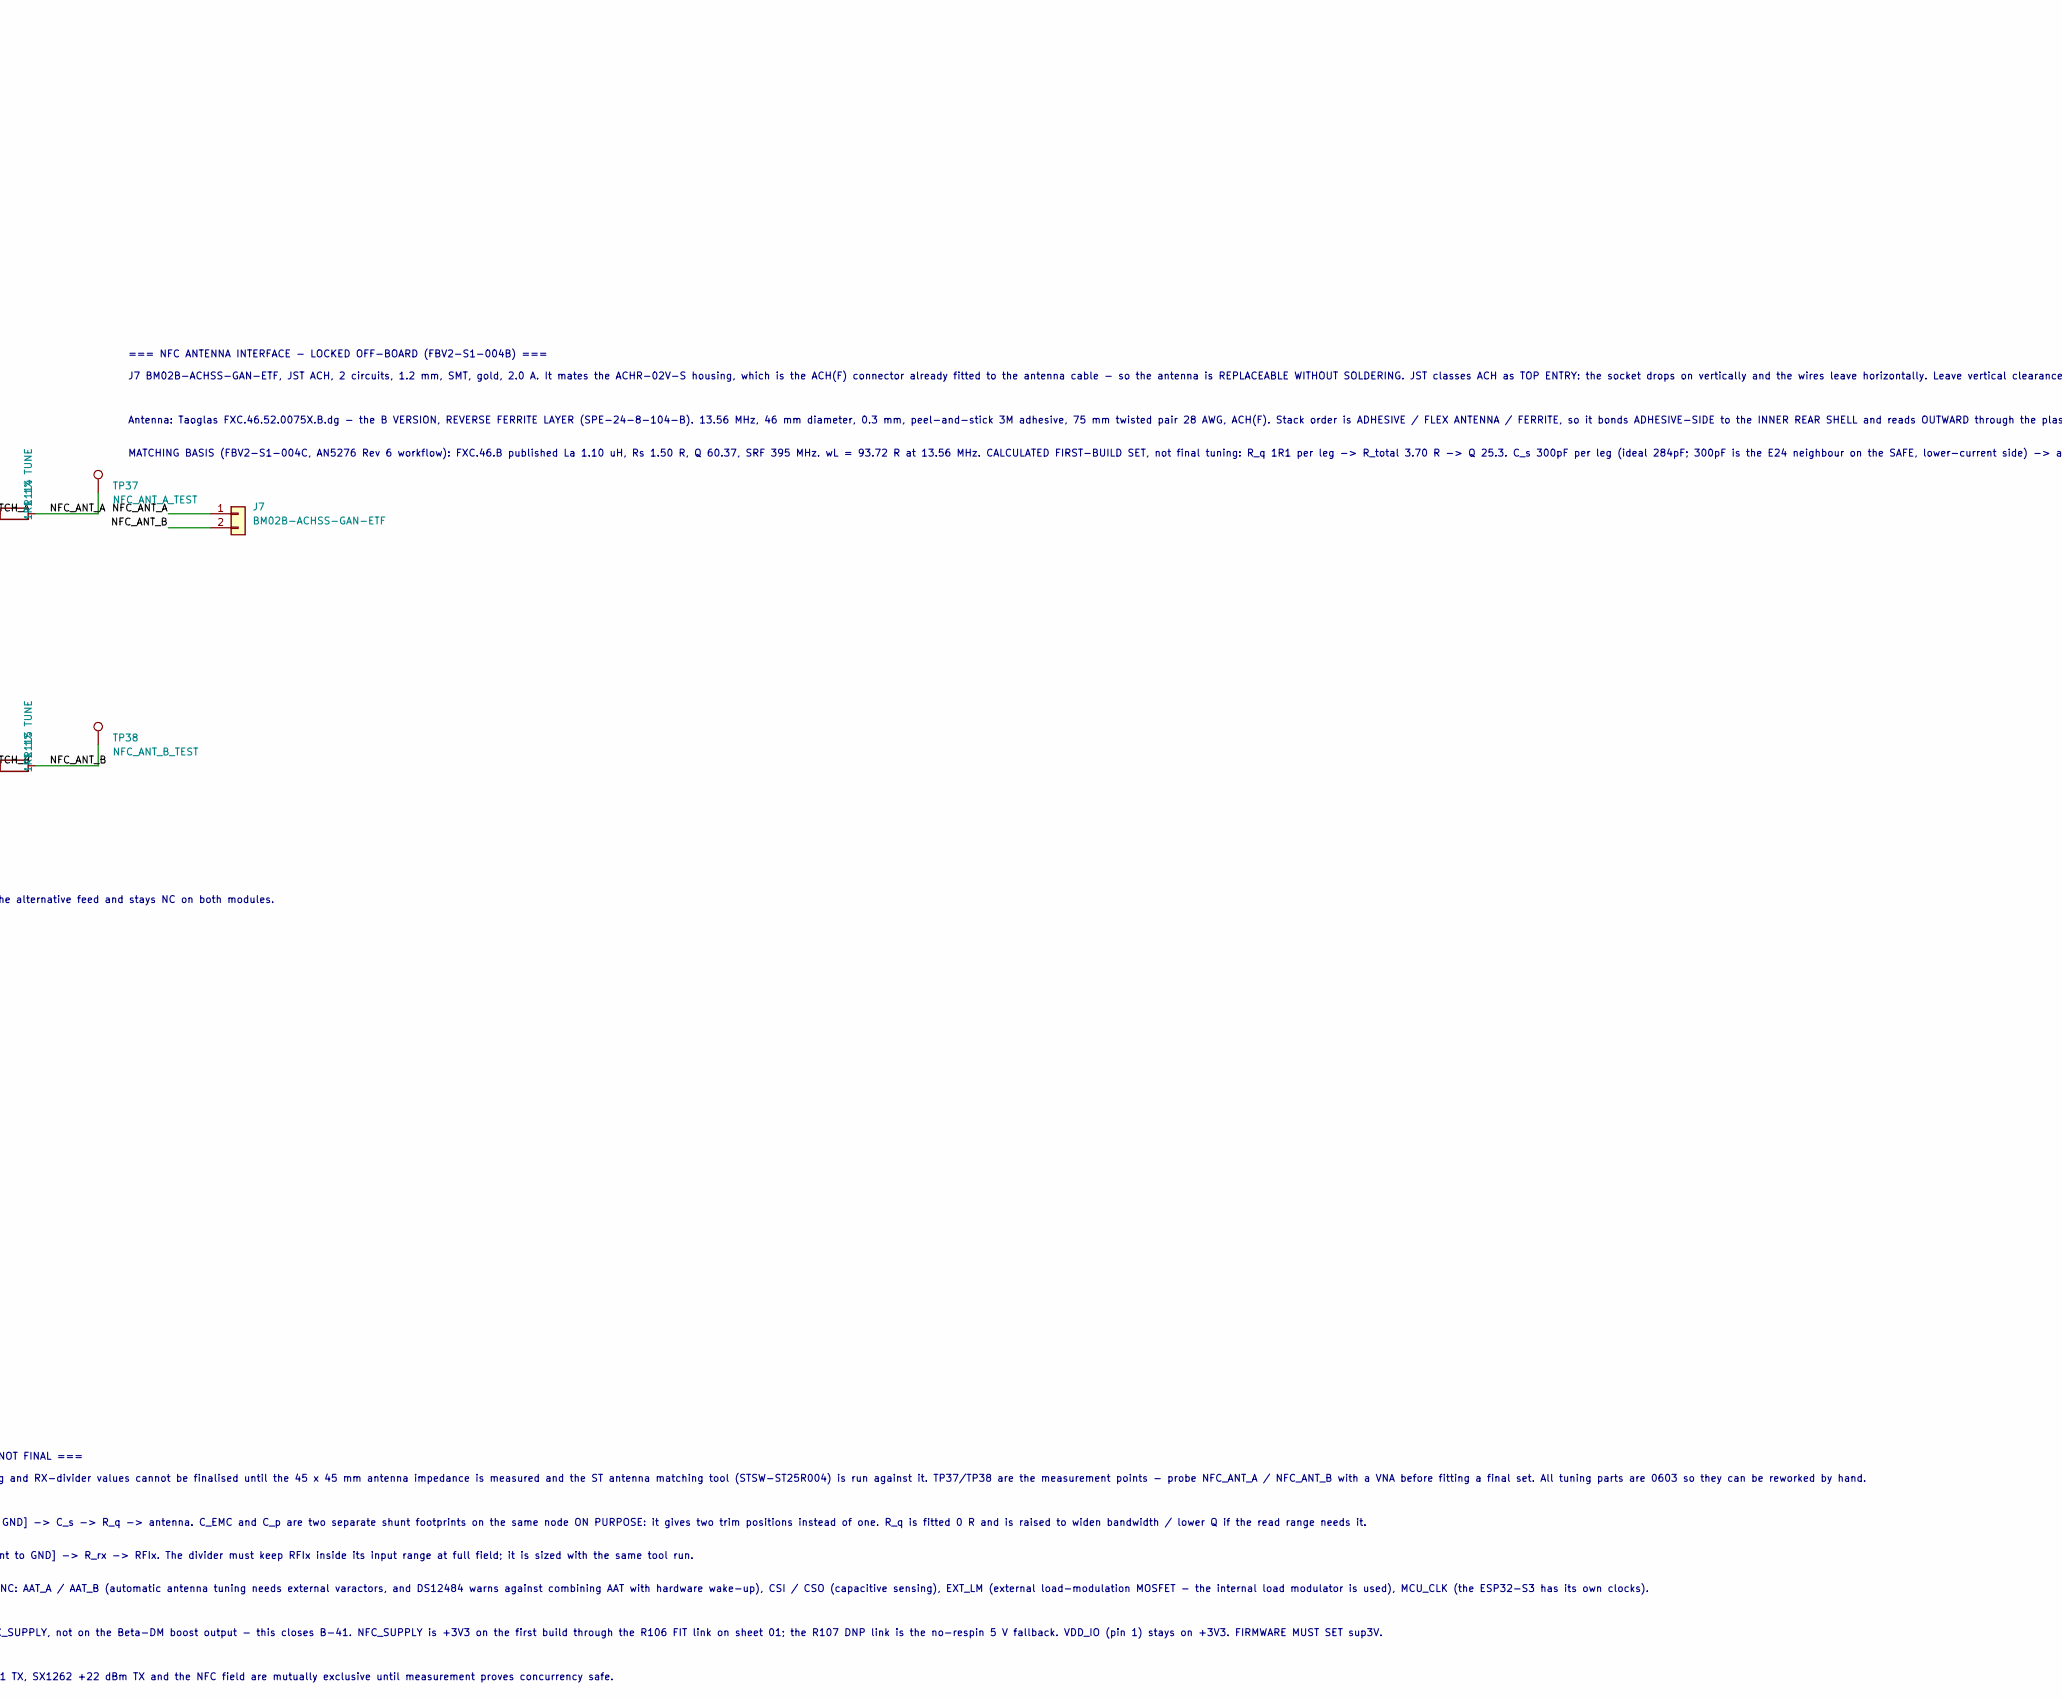
[picture p8: schematic 04_spi_b_radios_nfc.kicad_sch, part in row 1, column 2]

Parts:
C16, C17: 100nF; C_0603_1608Metric; MPN CC0603KRX7R9BB104; LCSC C14663
C18, C19: 100nF; C_0402_1005Metric; Voltage 16V; MPN CC0402KRX7R8BB104; LCSC C105883
C45, C47, C49, C51: 2.2uF; C_0805_2012Metric; Voltage 16V; MPN CC0805KKX7R9BB225; LCSC C125847
C46, C48, C50, C54: 10nF; C_0603_1608Metric; Voltage 50V; MPN 0603B103K500NT; LCSC C57112
C52: 1nF; C_0603_1608Metric; Voltage 50V; MPN CL10B102KB8NNNC; LCSC C1588
C53: 1uF; C_0603_1608Metric; Voltage 16V; MPN CL10A105KB8NNNC; LCSC C15849
C55: 2.2uF; C_0603_1608Metric; Voltage 16V; MPN CL10A225KO8NNNC; LCSC C23630
C69, C70: 100pF 50V C0G TUNE; C_0603_1608Metric; MPN CL10C101JB8NNNC; LCSC C14858
C71, C72: 300pF 50V C0G TUNE; C_0603_1608Metric; MPN GCM1885C2A301FA16J; LCSC C3837533
C73, C74: 1.5nF 50V C0G TUNE; C_0603_1608Metric; MPN GCM1885C2A152JA16D; LCSC C388906
C75, C77: 27pF 50V C0G TUNE; C_0603_1608Metric; MPN GQM1875C2E270FB12D; LCSC C2360423
C76, C78: 620pF 50V C0G TUNE; C_0603_1608Metric; MPN CC0603JRNPO9BN621; LCSC C325470
C79, C80: 10pF 50V C0G TUNE; C_0603_1608Metric; MPN CL10C100JB8NNNC; LCSC C1634
J7: BM02B-ACHSS-GAN-ETF; JST_ACH_BM02B-ACHSS-GAN-ETF_1x02-1MP_P1.20mm_Vertical; MPN BM02B-ACHSS-GAN-ETF(LF)(SN); LCSC C5118738
L5, L6: 39nH TUNE; L_0603_1608Metric; MPN LQW18AN39NG80D; LCSC C2042966
R27, R28, R29: 10k; R_0603_1608Metric; MPN 0603WAF1002T5E; LCSC C25804
R74: 100k; R_0603_1608Metric; Tolerance 1%; MPN 0603WAF1003T5E; LCSC C25803
R114, R115: 1R1 1% TUNE; R_0603_1608Metric; MPN RC0603FR-071R1L; LCSC C309559
R116, R117: 1k TUNE; R_0603_1608Metric; MPN 0603WAF1001T5E; LCSC C21190
TP37: NFC_ANT_A_TEST; TestPoint_Pad_D1.0mm
TP38: NFC_ANT_B_TEST; TestPoint_Pad_D1.0mm
U7: E07-400M10S; Ebyte_E07-400M10S; MPN E07-400M10S; LCSC C2965513
U8: E22-900M22S; Ebyte_E22-900M22S; MPN E22-900M22S; LCSC C411293
U9: ST25R3916-AQET; ST25R3916_AQET; MPN ST25R3916-AQET; LCSC C5267441
Y1: 27.12MHz 10pF 3225-4P; Crystal_SMD_3225-4Pin_3.2x2.5mm; MPN TXM27.12M0004322DBBDO00T; LCSC C362365

Connections:
+3V3: C16.1, C17.1, C18.1, R27.1, R28.1, R29.1, U7.9 (VCC), U8.9 (VCC), U9.1 (VDD_IO); also elsewhere on the board
/04_SPI_B_RADIOS_NFC/DIO2_TXEN: U8.7 (TXEN), U8.8 (DIO2)
/04_SPI_B_RADIOS_NFC/NFC_AGDC: C53.1, C54.1, U9.24 (AGDC)
/04_SPI_B_RADIOS_NFC/NFC_ANT_A: C75.1, J7.1, R114.2, TP37.1
/04_SPI_B_RADIOS_NFC/NFC_ANT_B: C77.1, J7.2, R115.2, TP38.1
/04_SPI_B_RADIOS_NFC/NFC_EMCA: C69.1, C71.1, C73.1, L5.2
/04_SPI_B_RADIOS_NFC/NFC_EMCB: C70.1, C72.1, C74.1, L6.2
/04_SPI_B_RADIOS_NFC/NFC_MATCH_A: C71.2, R114.1
/04_SPI_B_RADIOS_NFC/NFC_MATCH_B: C72.2, R115.1
/04_SPI_B_RADIOS_NFC/NFC_RFI1: R116.2, U9.22 (RFI1)
/04_SPI_B_RADIOS_NFC/NFC_RFI2: R117.2, U9.23 (RFI2)
/04_SPI_B_RADIOS_NFC/NFC_RFO1: L5.1, U9.13 (RFO1)
/04_SPI_B_RADIOS_NFC/NFC_RFO2: L6.1, U9.15 (RFO2)
/04_SPI_B_RADIOS_NFC/NFC_RXA: C75.2, C76.1, R116.1
/04_SPI_B_RADIOS_NFC/NFC_RXB: C77.2, C78.1, R117.1
/04_SPI_B_RADIOS_NFC/NFC_VDD_A: C47.1, C48.1, U9.7 (VDD_A)
/04_SPI_B_RADIOS_NFC/NFC_VDD_AM: C51.1, C52.1, U9.11 (VDD_AM)
/04_SPI_B_RADIOS_NFC/NFC_VDD_D: C45.1, C46.1, U9.3 (VDD_D)
/04_SPI_B_RADIOS_NFC/NFC_VDD_RF: C49.1, C50.1, U9.9 (VDD_RF), U9.14 (VDD_DR)
/04_SPI_B_RADIOS_NFC/NFC_XIN: C80.1, U9.5 (XTI), Y1.3
/04_SPI_B_RADIOS_NFC/NFC_XOUT: C79.1, U9.4 (XTO), Y1.1
/CC1101_CS_N: R28.2, U7.19 (~CSN); also elsewhere on the board
/CC1101_GDO0: U7.15 (GDO0); also elsewhere on the board
/NFC_CS_N: R29.2, U9.29 (BSS); also elsewhere on the board
/NFC_IRQ: U9.27 (IRQ); also elsewhere on the board
/NFC_SUPPLY: C19.1, C55.1, U9.8 (VDD), U9.10 (VDD_TX); also elsewhere on the board
/SPI_B_MISO: U7.16 (MISO/GDO1), U8.16 (MISO), U9.32 (MISO); also elsewhere on the board
/SPI_B_MOSI: U7.17 (MOSI), U8.17 (MOSI), U9.31 (MOSI); also elsewhere on the board
/SPI_B_SCK: U7.18 (SCK), U8.18 (SCK), U9.30 (SCLK); also elsewhere on the board
/SX1262_BUSY: U8.14 (BUSY); also elsewhere on the board
/SX1262_CS_N: R27.2, U8.19 (~NSS); also elsewhere on the board
/SX1262_DIO1: U8.13 (DIO1); also elsewhere on the board
/SX1262_RST_N: U8.15 (~NRST); also elsewhere on the board
/SX1262_RXEN: R74.1, U8.6 (RXEN); also elsewhere on the board
GND: C16.2, C17.2, C18.2, C19.2, C45.2, C46.2, C47.2, C48.2, C49.2, C50.2, C51.2, C52.2, C53.2, C54.2, C55.2, C69.2, C70.2, C73.2, C74.2, C76.2, C78.2, C79.2, C80.2, R74.2, U7.1 (GND), U7.2 (GND), U7.3 (GND), U7.4 (GND), U7.5 (GND), U7.11 (GND), U7.12 (GND), U7.20 (GND), U7.22 (GND), U8.1 (GND), U8.2 (GND), U8.3 (GND), U8.4 (GND), U8.5 (GND), U8.10 (GND), U8.11 (GND), U8.12 (GND), U8.20 (GND), U8.22 (GND), U9.6 (GND_D), U9.12 (GND_DR), U9.16 (GND_DR), U9.20 (I2C_EN), U9.21 (VSS), U9.26 (GND_A), U9.33 (EP), Y1.2 (G), Y1.4 (G); also elsewhere on the board

Notes on the sheet:
CC1101 FUNCTIONAL PLACEHOLDER MODULE LOCKED: EBYTE E07-400M10S NOT A BARE IC - MATCHING / FILTERING ON MODULE ANTENNA: MODULE IPEX (TAOGLAS FXP450) GDO2 INTENTIONALLY OMITTED CS HAS 10k HARDWARE PULL-UP TO +3V3 NO FOOTPRINT DO NOT ROUTE
SPI BUS B - BETA BRING-UP RISK THREE SHARED DEVICES: CC1101 + SX1262 + ST25R3916 ALL THREE CS LINES HAVE HARDWARE PULL-UPS ST25R3916 WAS VALIDATED STANDALONE ON ALPHA NFC AS THIRD BUS-B DEVICE IS FIRST VALIDATED ON BETA FIRMWARE MUST: - DRIVE ALL CS HIGH BEFORE INITIALIZATION - USE A BUS MUTEX - SE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
SX1262 FUNCTIONAL PLACEHOLDER MODULE LOCKED: EBYTE E22-900M22S FOOTPRINT PENDING - FROM EBYTE DRAWING ANTENNA: MODULE IPEX (TAOGLAS FXP890) NO BOARD-LEVEL RF AT 915 MHz CS HAS 10k HARDWARE PULL-UP TO +3V3 RESET SAFE-STATE CONTROLLED BY U60 P01 NO FOOTPRINT DO NOT ROUTE
=== FBV2-S1 RADIOS + NFC (FBV2-S1-004) - RF ARCHITECTURE LOCKED ===
433 MHz: INTERNAL Taoglas FXP450.07.0100C flex (410-470 MHz, 47 x 17 x 0.28 mm, 100 mm 1.37 mm coax, IPEX MHF-I) onto the U7 module socket. 915 MHz: EXTERNAL - U8 IPEX -> short pigtail -> top-panel SMA bulkhead. NEITHER band has a board RF trace, a matching network or an RF switch. Module pin 21 (s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
The U7 IPEX socket must stay SERVICE-ACCESSIBLE with the enclosure open: if internal 433 performance disappoints on the first units, the flex unplugs and an external pigtail goes in its place with NO PCB respin (D-049).
=== NFC FRONT END - TOPOLOGY IS REAL, VALUES ARE NOT FINAL ===
Every part marked TUNE is an INITIAL VALUE. The matching and RX-divider values cannot be finalised until the 45 x 45 mm antenna impedance is measured and the ST antenna matching tool (STSW-ST25R004) is run against it. TP37/TP38 are the measurement points - probe NFC_ANT_A / NFC_ANT_B with a VNA bef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
TX chain per side: RFOx -> L_EMC -> [C_EMC + C_p to GND] -> C_s -> R_q -> antenna. C_EMC and C_p are two separate shunt footprints on the same node ON PURPOSE: it gives two trim positions instead of one. R_q is fitted 0 R and is raised to widen bandwidth / lower Q if the read range needs it.
RX chain per side: antenna -> C_rx_series -> [C_rx_shunt to GND] -> R_rx -> RFIx. The divider must keep RFIx inside its input range at full field; it is sized with the same tool run.
NOT FITTED on the first build, and the pins are explicitly NC: AAT_A / AAT_B (automatic antenna tuning needs external varactors, and DS12484 warns against combining AAT with hardware wake-up), CSI / CSO (capacitive sensing), EXT_LM (external load-modulation MOSFET - the internal load modulator is u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
SUPPLY: VDD (pin 8) and VDD_TX (pin 10) now sit on NFC_SUPPLY, not on the Beta-DM boost output - this closes B-41. NFC_SUPPLY is +3V3 on the first build through the R106 FIT link on sheet 01; the R107 DNP link is the no-respin 5 V fallback. VDD_IO (pin 1) stays on +3V3. FIRMWARE MUST SET sup3V.
ONE HIGH-POWER TRANSMITTER AT A TIME (MX-1). CC1101 TX, SX1262 +22 dBm TX and the NFC field are mutually exclusive until measurement proves concurrency safe.
=== NFC ANTENNA INTERFACE - LOCKED OFF-BOARD (FBV2-S1-004B) ===
J7 BM02B-ACHSS-GAN-ETF, JST ACH, 2 circuits, 1.2 mm, SMT, gold, 2.0 A. It mates the ACHR-02V-S housing, which is the ACH(F) connector already fitted to the antenna cable - so the antenna is REPLACEABLE WITHOUT SOLDERING. JST classes ACH as TOP ENTRY: the socket drops on vertically and the wires lea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
Antenna: Taoglas FXC.46.52.0075X.B.dg - the B VERSION, REVERSE FERRITE LAYER (SPE-24-8-104-B). 13.56 MHz, 46 mm diameter, 0.3 mm, peel-and-stick 3M adhesive, 75 mm twisted pair 28 AWG, ACH(F). Stack order is ADHESIVE / FLEX ANTENNA / FERRITE, so it bonds ADHESIVE-SIDE to the INNER REAR SHELL and re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
MATCHING BASIS (FBV2-S1-004C, AN5276 Rev 6 workflow): FXC.46.B published La 1.10 uH, Rs 1.50 R, Q 60.37, SRF 395 MHz. wL = 93.72 R at 13.56 MHz. CALCULATED FIRST-BUILD SET, not final tuning: R_q 1R1 per leg -> R_total 3.70 R -> Q 25.3. C_s 300pF per leg (ideal 284pF; 300pF is the E24 neighbour on t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
