aqroot8/aqroot/hardware/demo/kicad/aqroot-demo/aqroot-Beta-v2.kicad_pcb

## KiCad design hardware/demo/kicad/aqroot-demo/aqroot-Beta-v2.kicad_pcb (continued)

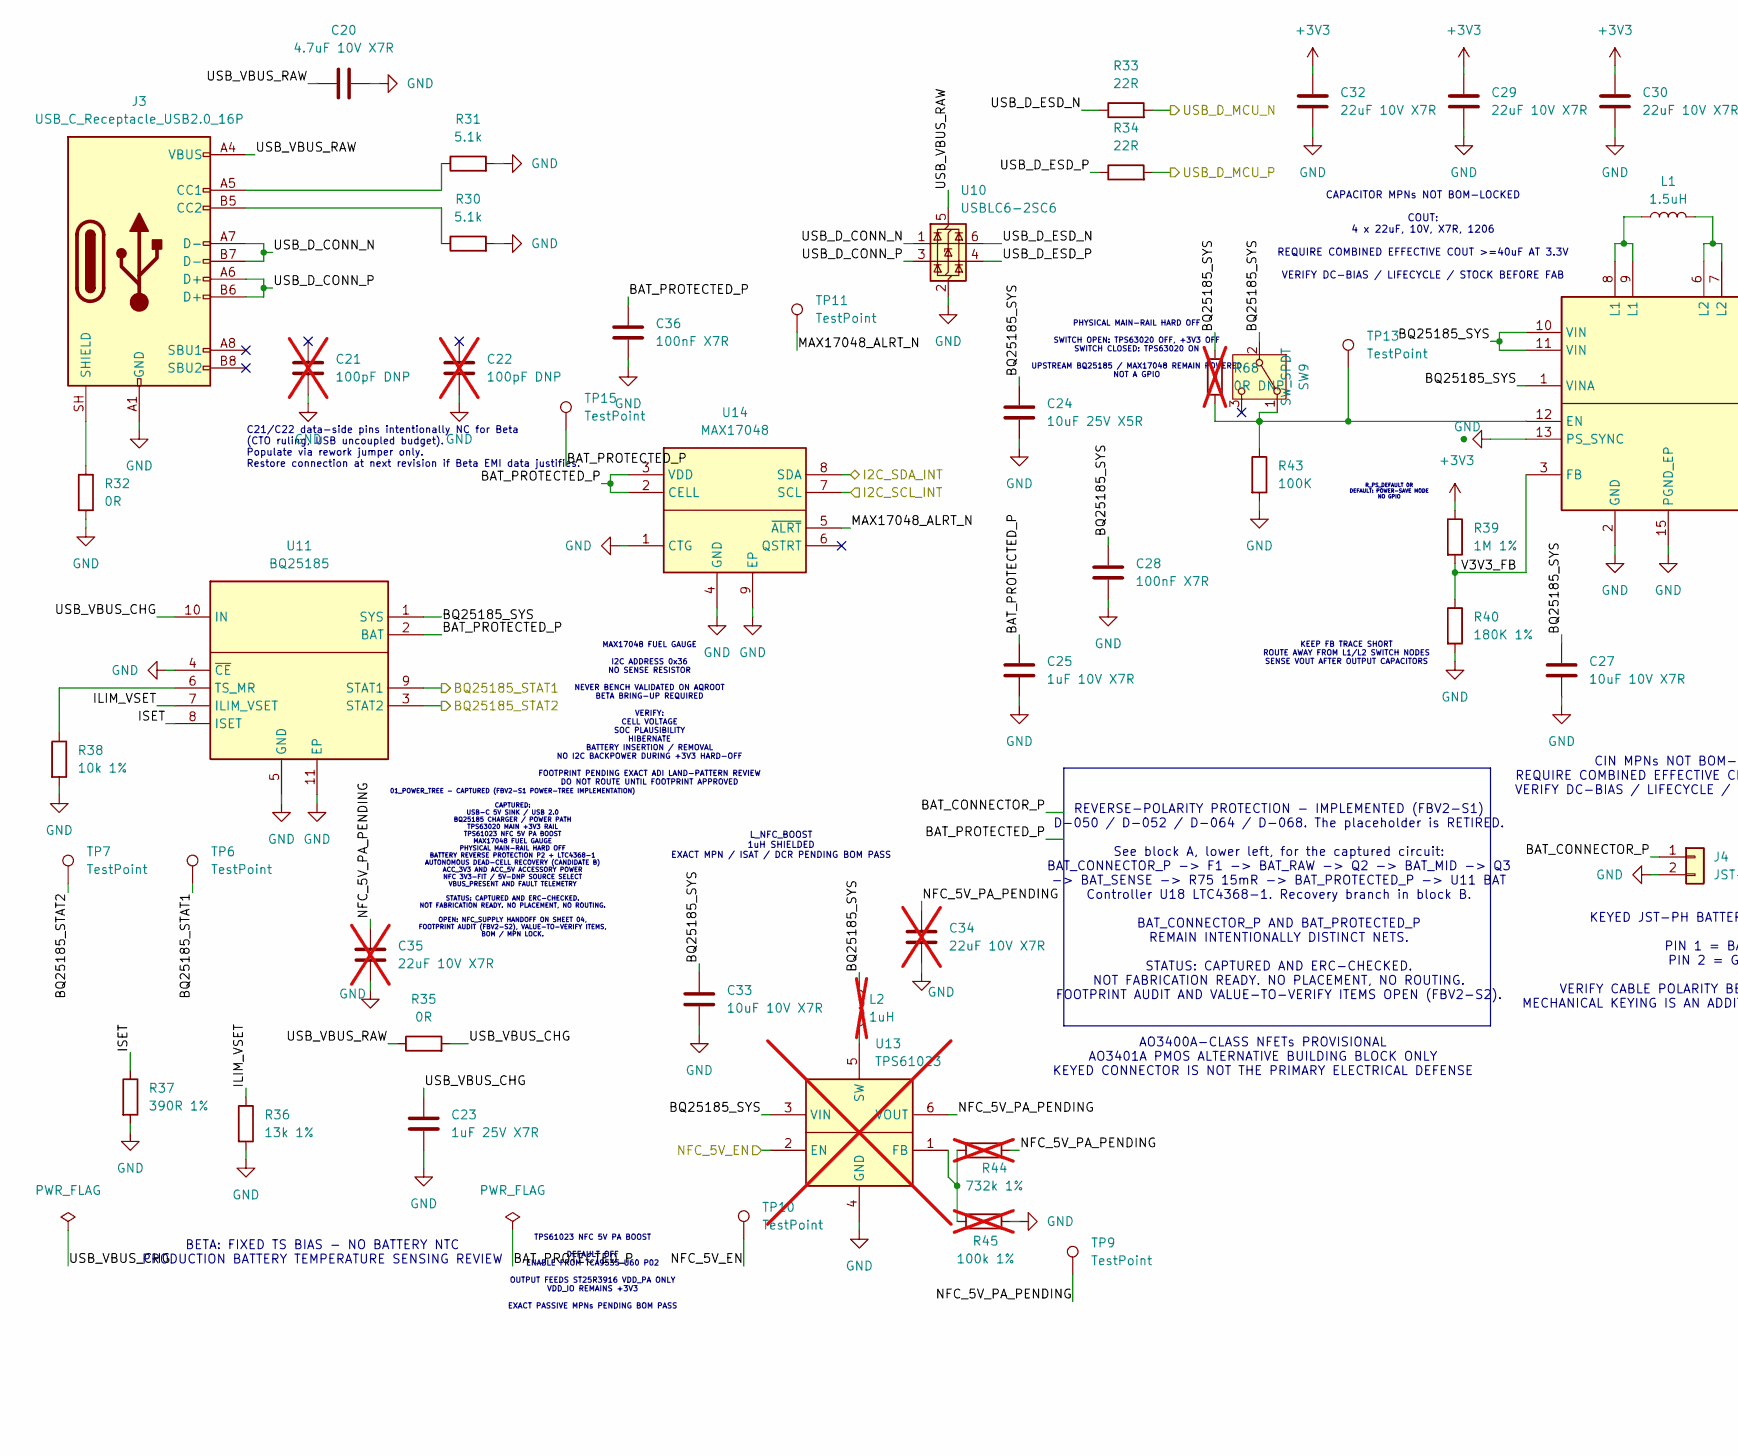
[picture p9: schematic 01_power_tree.kicad_sch, part in row 1, column 1]

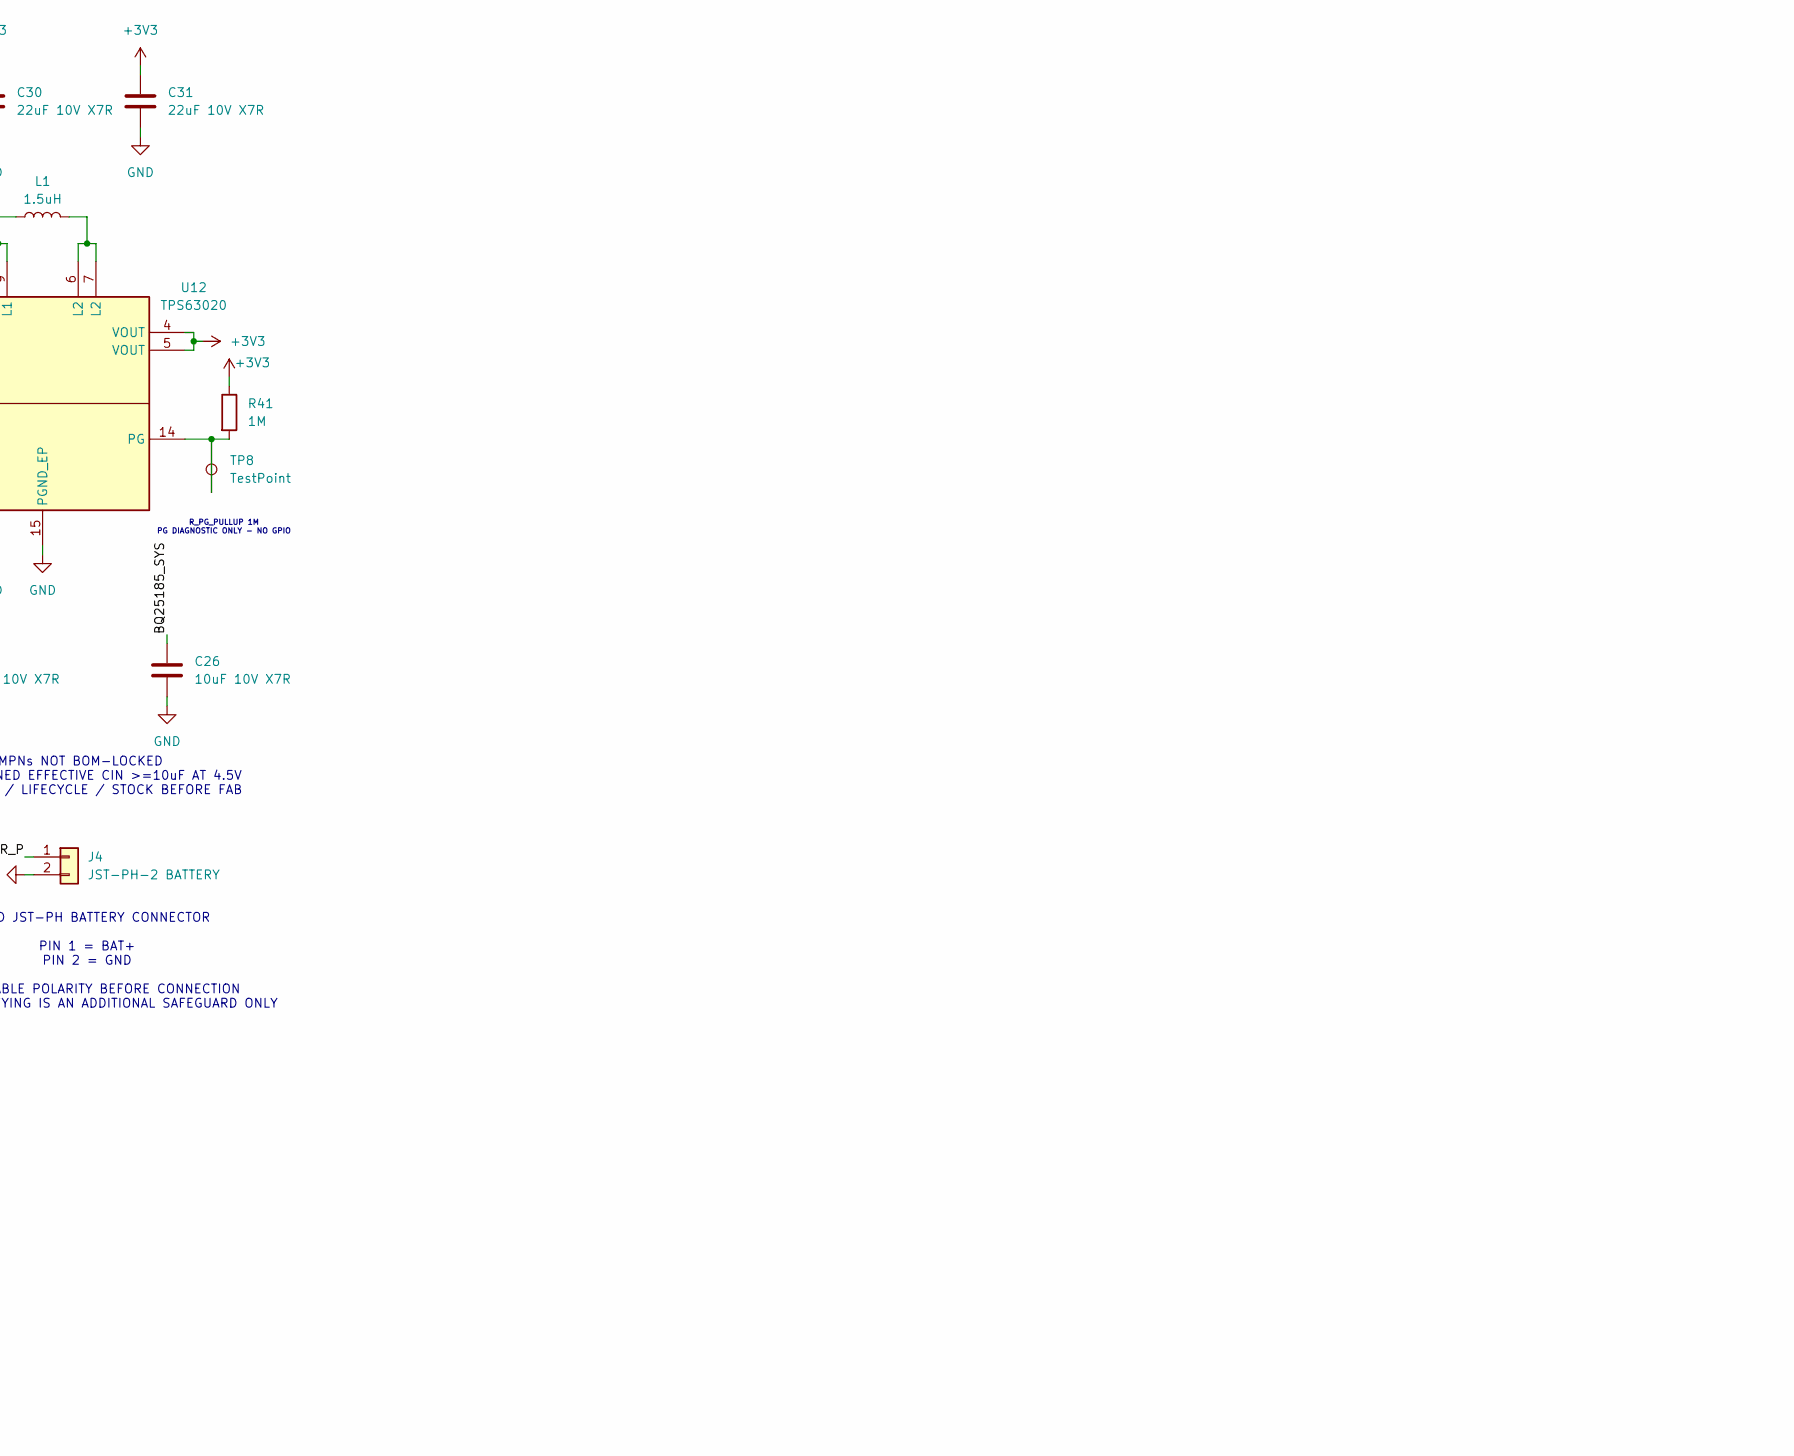
[picture p10: schematic 01_power_tree.kicad_sch, part in row 1, column 2]

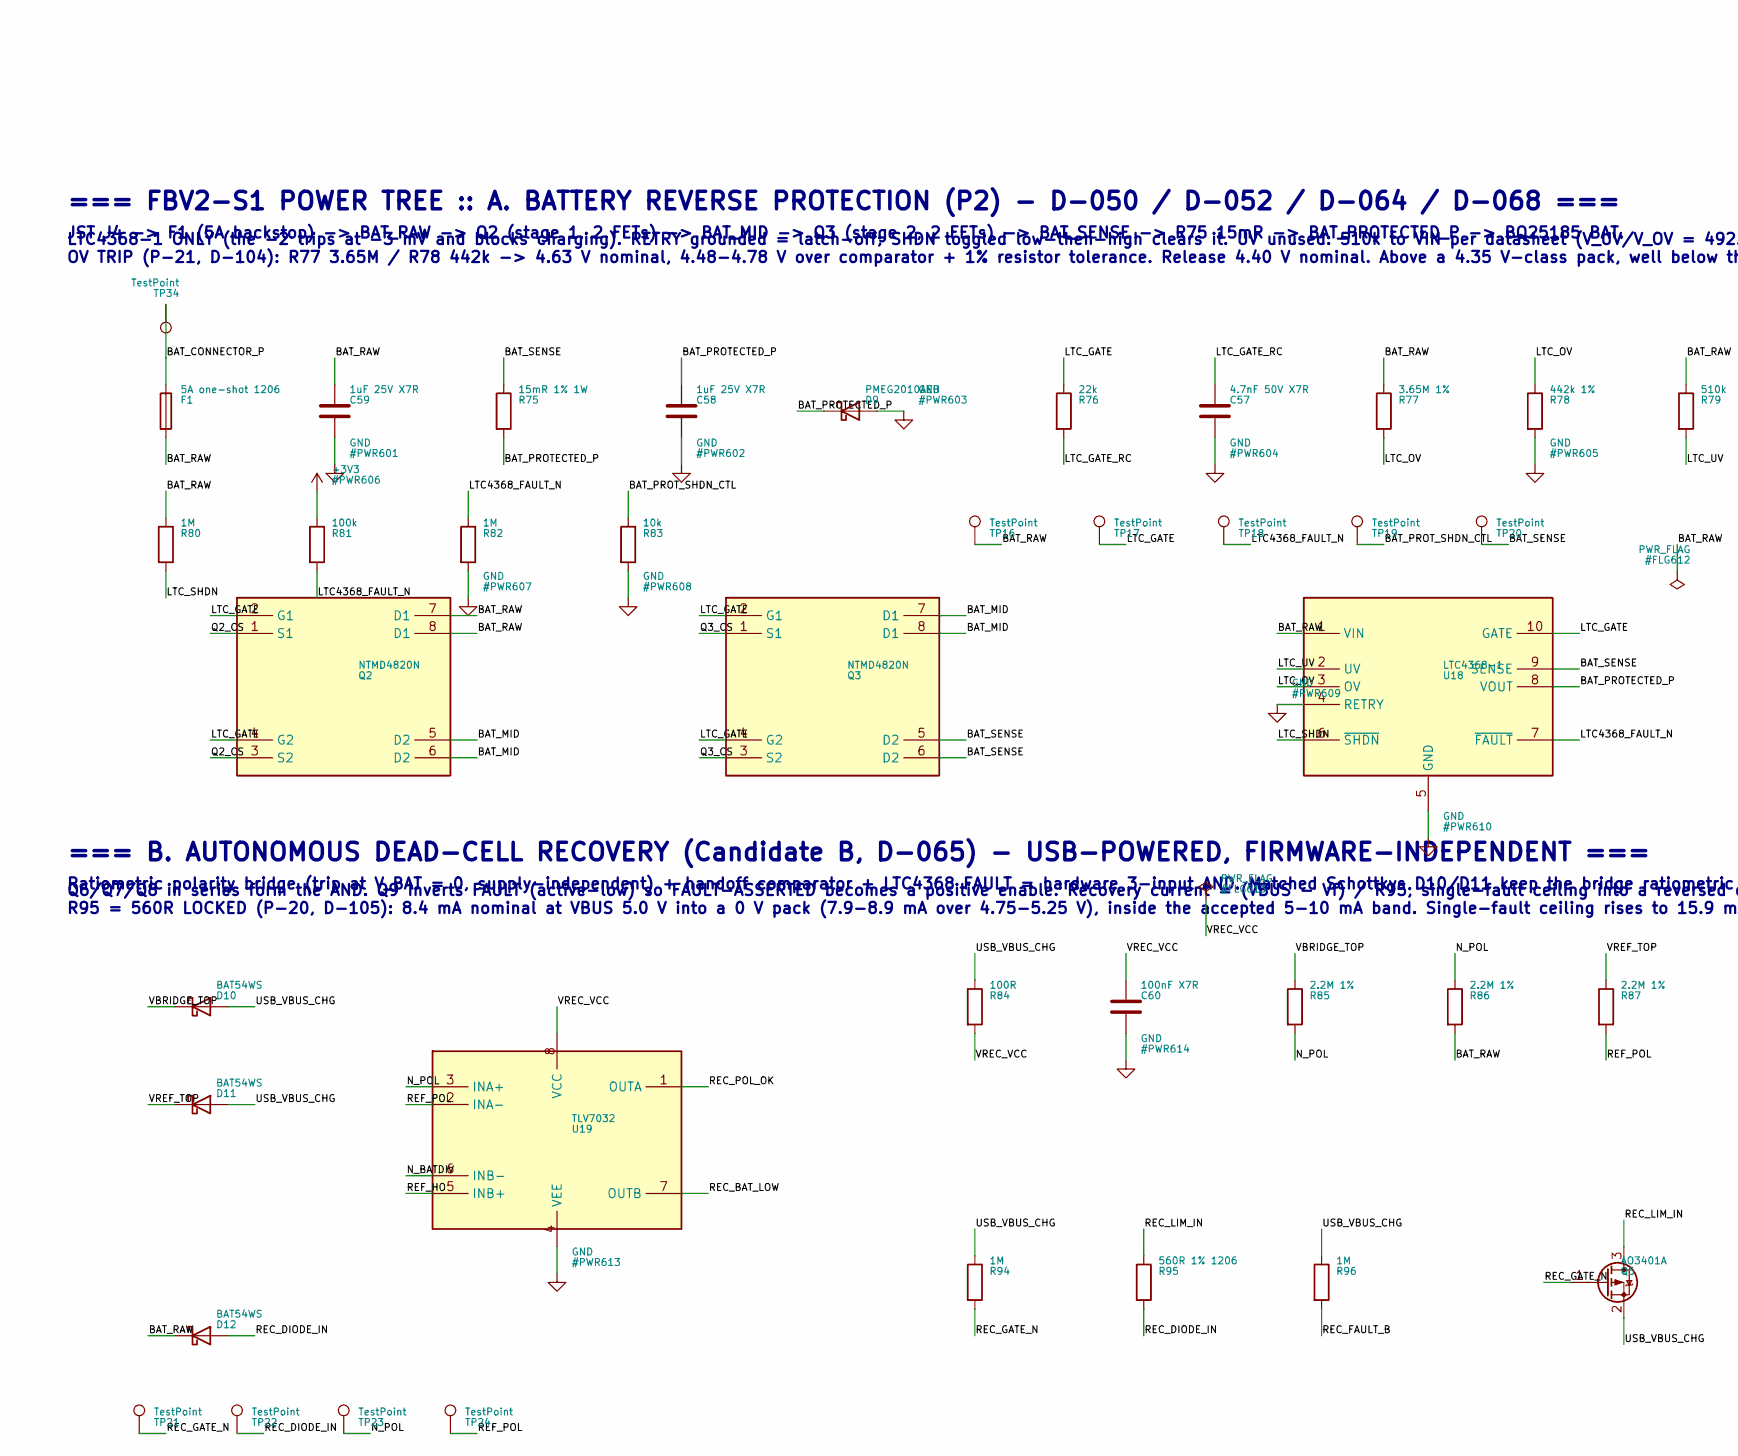
[picture p11: schematic 01_power_tree.kicad_sch, part in row 2, column 1]

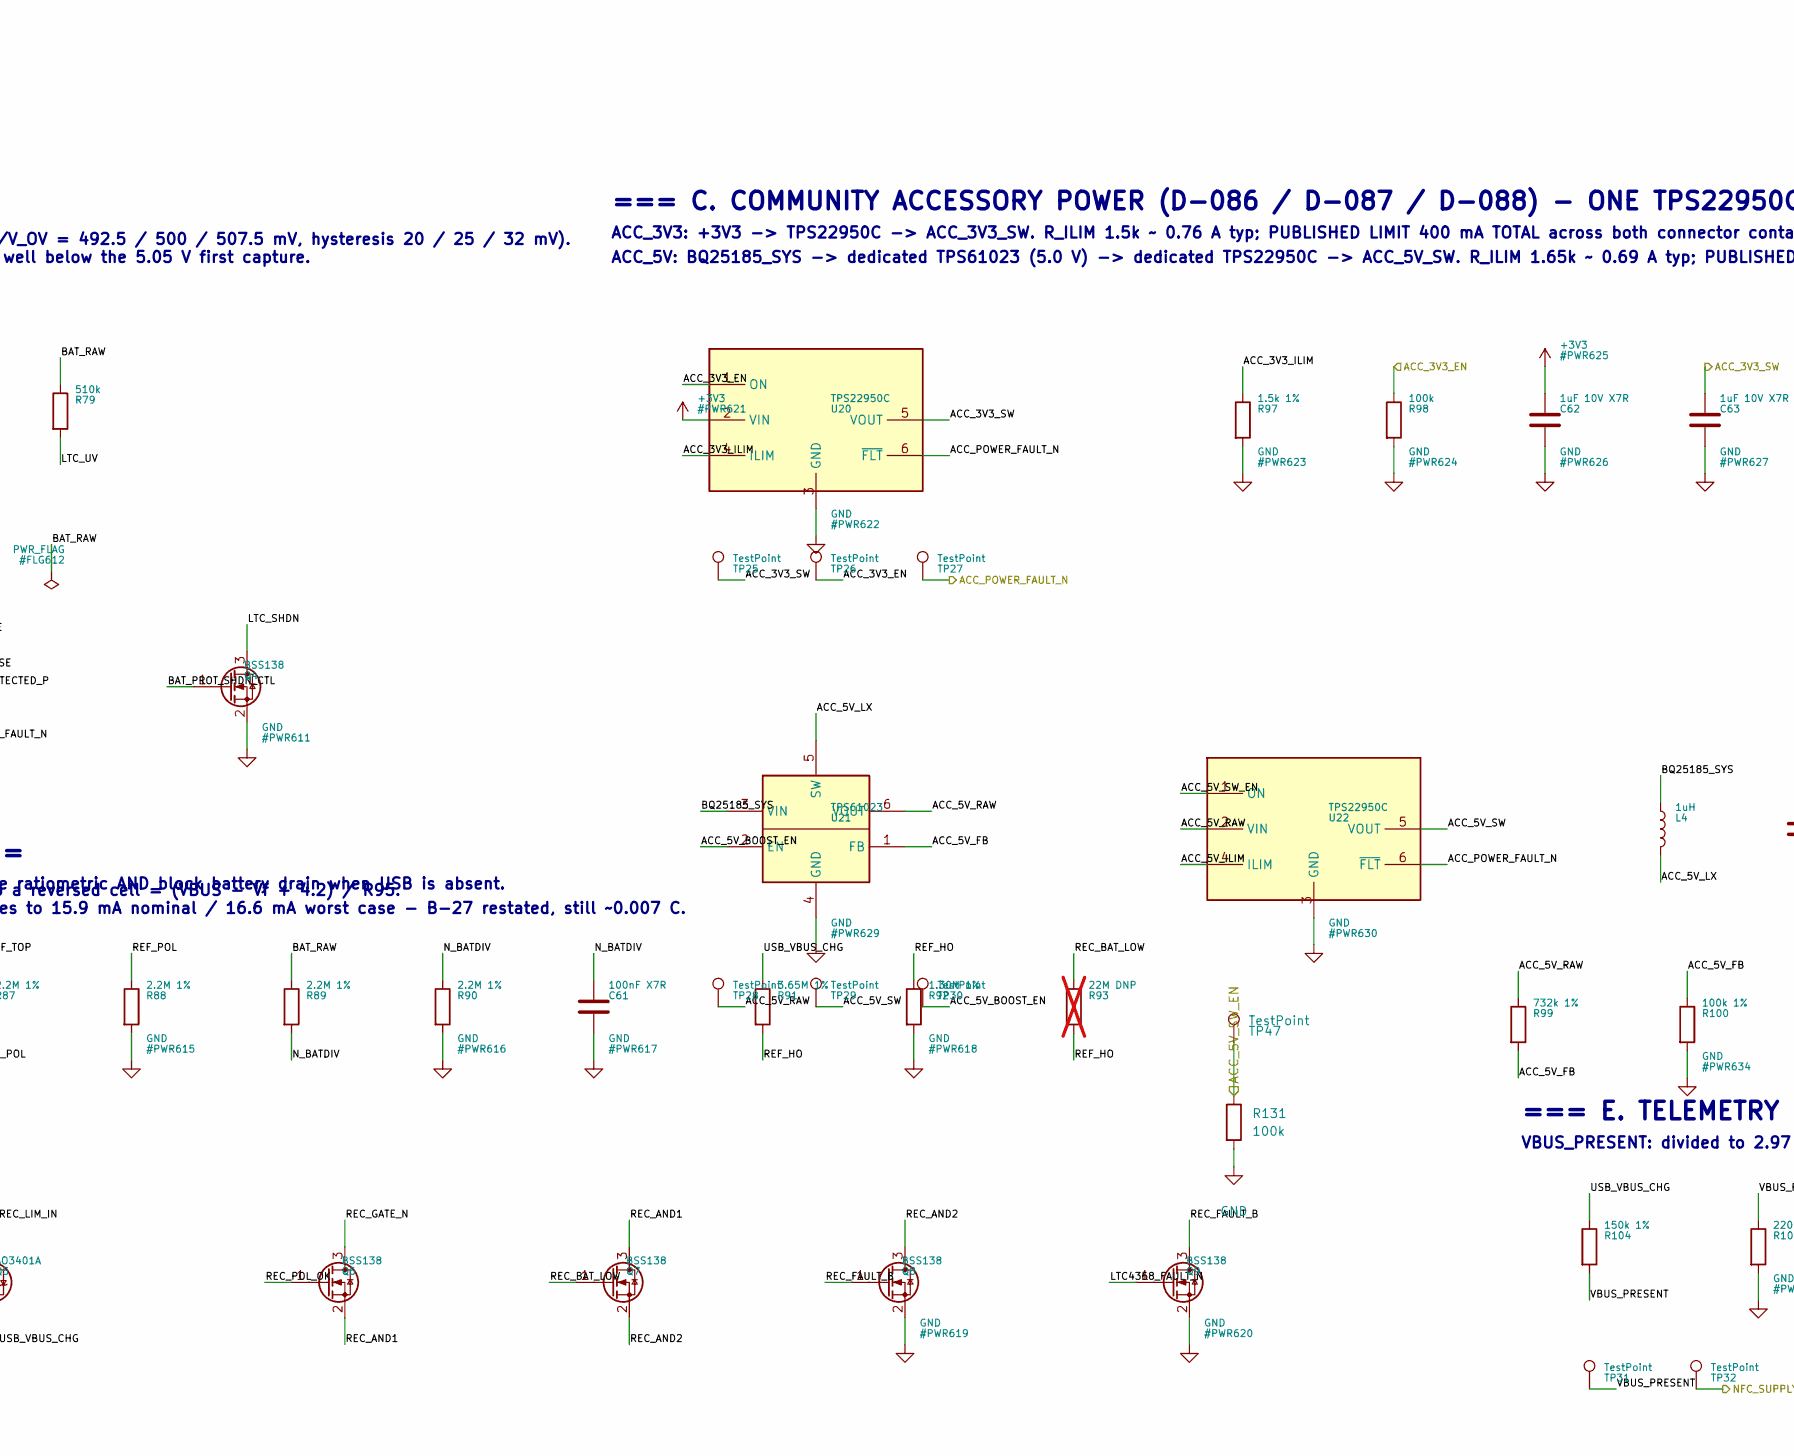
[picture p12: schematic 01_power_tree.kicad_sch, part in row 2, column 2]

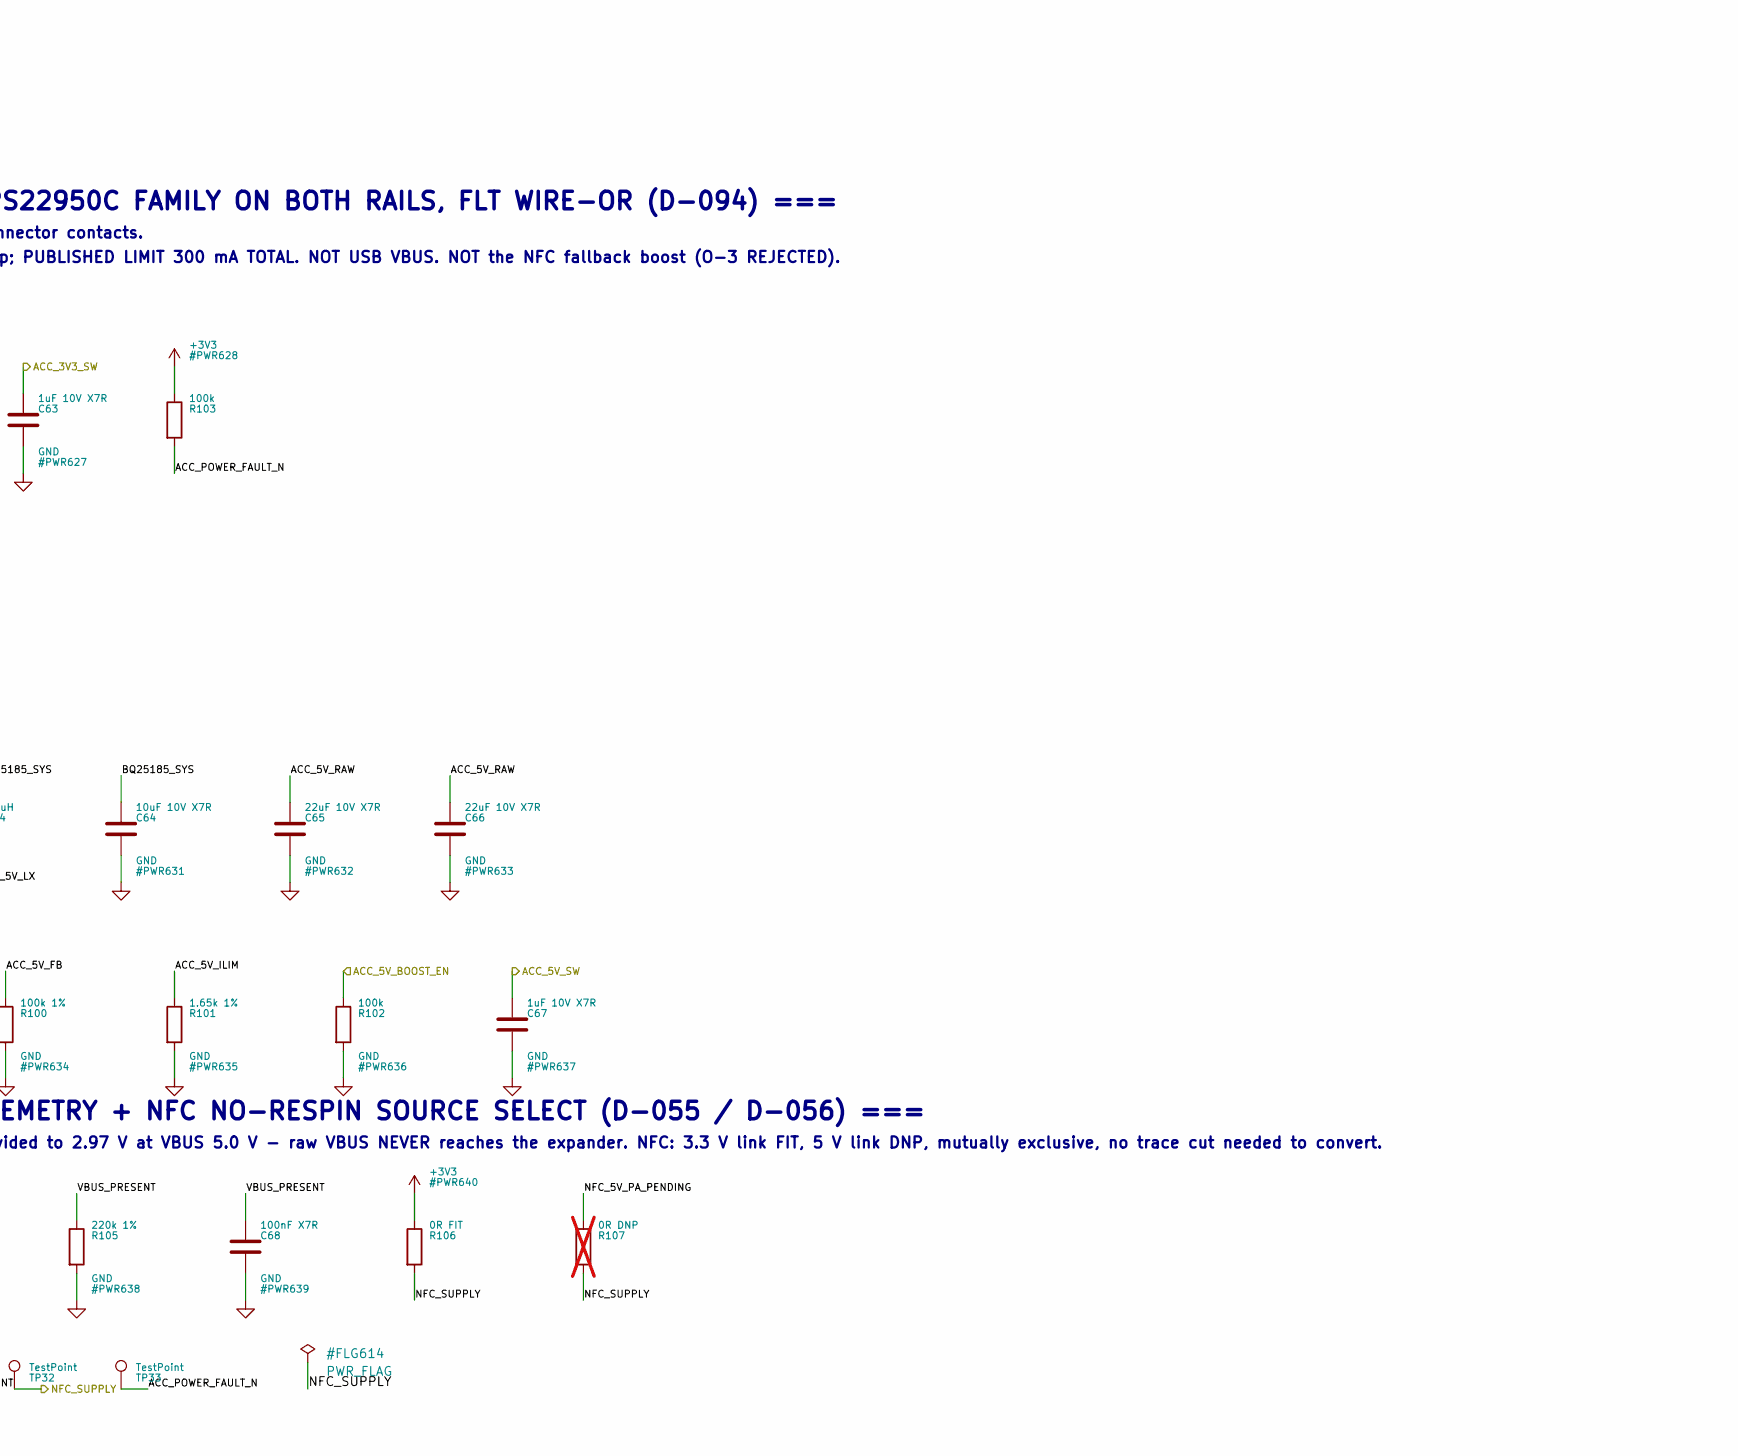
[picture p13: schematic 01_power_tree.kicad_sch, part in row 2, column 3]

Parts:
C20: 4.7uF 10V X7R; C_0805_2012Metric; MPN CC0805KKX7R8BB475; LCSC C354262
C21, C22: 100pF DNP; C_0603_1608Metric; not fitted
C23, C58, C59: 1uF 25V X7R; C_0603_1608Metric; MPN CC0603KRX7R8BB105; LCSC C106858
C24: 10uF 25V X5R; C_0603_1608Metric; MPN GRM188R61E106KA73D; LCSC C344022
C25, C62, C63, C67: 1uF 10V X7R; C_0603_1608Metric; MPN CC0603KRX7R8BB105; LCSC C106858
C26, C27: 10uF 10V X7R; C_1206_3216Metric; MPN GRM31CR71E106KA12L; LCSC C77093
C28, C36, C60, C61, C68: 100nF X7R; C_0603_1608Metric; MPN CC0603KRX7R9BB104; LCSC C14663
C29, C30, C31, C32: 22uF 10V X7R; C_1206_3216Metric; MPN TCC1206X7R226K160HT; LCSC C22392398
C33, C64: 10uF 10V X7R; C_0805_2012Metric; MPN CC0805KKX7R7BB106; LCSC C326595
C34, C35: 22uF 10V X7R; C_0805_2012Metric; not fitted
C57: 4.7nF 50V X7R; C_0603_1608Metric; MPN 0603B472K500NT; LCSC C53987
C65, C66: 22uF 10V X7R; C_0805_2012Metric; MPN GRM21BZ71A226ME15L; LCSC C907991
D9: PMEG2010AEH; D_SOD-123; MPN PMEG2010AEH,115; LCSC C110921
D10, D11, D12: BAT54WS; D_SOD-323; MPN BAT54WS-7-F; LCSC C124205
F1: 5A one-shot 1206; Fuse_1206_3216Metric; MPN 0466005.NRHF; LCSC C57525
J3: USB_C_Receptacle_USB2.0_16P; USB_C_Receptacle_GCT_USB4105-xx-A_16P_TopMnt_Horizontal; MPN USB4105-GF-A-120; LCSC C5184243
J4: JST-PH-2 BATTERY; JST_PH_B2B-PH-K_1x02_P2.00mm_Vertical; MPN B2B-PH-K-S(LF)(SN); LCSC C131337
L1: 1.5uH; Coilcraft_XFL4020; MPN XFL4020-152MEC; LCSC C3033018
L2: 1uH; Wurth_WE-MAPI_4030_74438357010; MPN 74438357010; LCSC C5542269; not fitted
L4: 1uH; Wurth_WE-MAPI_4030_74438357010; MPN 74438357010; LCSC C5542269
Q2, Q3: NTMD4820N; SOIC-8_3.9x4.9mm_P1.27mm; MPN NTMD4820NR2G; LCSC C905372
Q4, Q6, Q7, Q8, Q9: BSS138; SOT-23; MPN BSS138LT1G; LCSC C82045
Q5: AO3401A; SOT-23; MPN AO3401A; LCSC C15127
R30, R31: 5.1k; R_0603_1608Metric; MPN 0603WAF5101T5E; LCSC C23186
R32, R35: 0R; R_0603_1608Metric; MPN 0603WAF0000T5E; LCSC C21189
R33, R34: 22R; R_0603_1608Metric; MPN 0603WAF220JT5E; LCSC C23345
R36: 13k 1%; R_0603_1608Metric; MPN 0603WAF1302T5E; LCSC C22797
R37: 390R 1%; R_0603_1608Metric; MPN 0603WAF3900T5E; LCSC C23151
R38: 10k 1%; R_0603_1608Metric; MPN 0603WAF1002T5E; LCSC C25804
R39: 1M 1%; R_0603_1608Metric; MPN 0603WAF1004T5E; LCSC C22935
R40: 180K 1%; R_0603_1608Metric; MPN 0603WAF1803T5E; LCSC C22827
R41, R80, R82, R94, R96: 1M; R_0603_1608Metric; MPN 0603WAF1004T5E; LCSC C22935
R43: 100K; R_0603_1608Metric; MPN 0603WAF1003T5E; LCSC C25803
R44: 732k 1%; R_0603_1608Metric; not fitted
R45: 100k 1%; R_0603_1608Metric; not fitted
R68, R107: 0R DNP; R_0603_1608Metric; not fitted
R75: 15mR 1% 1W; R_2512_6332Metric; MPN CRA2512-FZ-R015ELF; LCSC C2073490
R76: 22k; R_0603_1608Metric; MPN 0603WAF2202T5E; LCSC C31850
R77, R91: 3.65M 1%; R_0603_1608Metric; MPN RC0603FR-073M65L; LCSC C482835
R78: 442k 1%; R_0603_1608Metric; MPN RC0603FR-07442KL; LCSC C185327
R79: 510k; R_0603_1608Metric; MPN 0603WAF5103T5E; LCSC C23192
R81, R98, R102, R103: 100k; R_0603_1608Metric; MPN 0603WAF1003T5E; LCSC C25803
R83: 10k; R_0603_1608Metric; MPN 0603WAF1002T5E; LCSC C25804
R84: 100R; R_0603_1608Metric; MPN 0603WAF1000T5E; LCSC C22775
R85, R86, R87, R88, R89, R90: 2.2M 1%; R_0603_1608Metric; MPN RC0603FR-072M2L; LCSC C137747
R92: 1.30M 1%; R_0603_1608Metric; MPN MCT06030C1304FP500; LCSC C2115863
R93: 22M DNP; R_0603_1608Metric; not fitted
R95: 560R 1% 1206; R_1206_3216Metric; MPN ERJ-P08F5600V; LCSC C4220370
R97: 1.5k 1%; R_0603_1608Metric; MPN 0603WAF1501T5E; LCSC C22843
R99: 732k 1%; R_0603_1608Metric; MPN CRCW0603732KFKEA; LCSC C2079739
R100: 100k 1%; R_0603_1608Metric; MPN 0603WAF1003T5E; LCSC C25803
R101: 1.65k 1%; R_0603_1608Metric; MPN ERJ-PA3F1651V; LCSC C4088673
R104: 150k 1%; R_0603_1608Metric; MPN 0603WAF1503T5E; LCSC C22807
R105: 220k 1%; R_0603_1608Metric; MPN 0603WAF2203T5E; LCSC C22961
R106: 0R FIT; R_0603_1608Metric; MPN 0603WAF0000T5E; LCSC C21189
R131: 100k; R_0603_1608Metric; Tolerance 1%; MPN 0603WAF1003T5E; LCSC C25803
SW9: SW_SPDT; SW_SPDT_CK_JS102011SAQN; MPN JS102011SAQN; LCSC C221660
TP6, TP7, TP8, TP9, TP10, TP11, TP13, TP15, TP16, TP17, TP18, TP19, TP20, TP21, TP22, TP23, TP24, TP25, TP26, TP27, TP28, TP29, TP30, TP31, TP32, TP33, TP34, TP47: TestPoint; TestPoint_Pad_D1.0mm
U10: USBLC6-2SC6; SOT-23-6; MPN USBLC6-2SC6; LCSC C7519
U11: BQ25185; Texas_DLH0010A_WSON-10-1EP_2.2x2mm_P0.4mm_EP0.9x1.5mm; MPN BQ25185DLHR; LCSC C19725033
U12: TPS63020; TI_TPS63020_DSJ; MPN TPS63020DSJR; LCSC C15483
U13: TPS61023; SOT-563; MPN TPS61023DRLR; LCSC C919459; not fitted
U14: MAX17048; MAX17048_T822; MPN MAX17048G+T10; LCSC C2682616
U18: LTC4368-1; MSOP-10_3x3mm_P0.5mm; MPN LTC4368IMS-1#TRPBF; LCSC C688401
U19: TLV7032; SOT-23-8; MPN TLV7032DDFR; LCSC C2871498
U20, U22: TPS22950C; SOT-23-6; MPN TPS22950CDDCR; LCSC C7587833
U21: TPS61023; SOT-563; MPN TPS61023DRLR; LCSC C919459

Connections:
+3V3: C29.1, C30.1, C31.1, C32.1, C62.1, R39.1, R41.1, R81.1, R103.1, R106.1, U12.4 (VOUT), U12.5 (VOUT), U20.2 (VIN); also elsewhere on the board
/01_POWER_TREE/ACC_3V3_ILIM: R97.1, U20.4 (ILIM)
/01_POWER_TREE/ACC_5V_FB: R99.2, R100.1, U21.1 (FB)
/01_POWER_TREE/ACC_5V_ILIM: R101.1, U22.4 (ILIM)
/01_POWER_TREE/ACC_5V_LX: L4.2, U21.5 (SW)
/01_POWER_TREE/ACC_5V_RAW: C65.1, C66.1, R99.1, TP28.1, U21.6 (VOUT), U22.2 (VIN)
/01_POWER_TREE/BAT_CONNECTOR_P: F1.1, J4.1, TP34.1
/01_POWER_TREE/BAT_MID: Q2.5 (D2), Q2.6 (D2), Q3.7 (D1), Q3.8 (D1)
/01_POWER_TREE/BAT_PROTECTED_P: C25.1, C36.1, C58.1, D9.1 (K), R75.2, TP15.1, U11.2 (BAT), U14.2 (CELL), U14.3 (VDD), U18.8 (VOUT)
/01_POWER_TREE/BAT_PROT_SHDN_CTL: Q4.1 (G), R83.1, TP19.1
/01_POWER_TREE/BAT_RAW: C59.1, D12.1 (K), F1.2, Q2.7 (D1), Q2.8 (D1), R77.1, R79.1, R80.1, R86.2, R89.1, TP16.1, U18.1 (VIN)
/01_POWER_TREE/BAT_SENSE: Q3.5 (D2), Q3.6 (D2), R75.1, TP20.1, U18.9 (SENSE)
/01_POWER_TREE/BQ25185_SYS: C24.1, C26.2, C27.1, C28.1, C33.1, C64.1, L2.1, L4.1, R68.1, SW9.2 (B), U11.1 (SYS), U12.1 (VINA), U12.10 (VIN), U12.11 (VIN), U13.3 (VIN), U21.3 (VIN)
/01_POWER_TREE/ILIM_VSET: R36.1, U11.7 (ILIM_VSET)
/01_POWER_TREE/ISET: R37.1, U11.8 (ISET)
/01_POWER_TREE/LTC4368_FAULT_N: Q9.1 (G), R81.2, R82.1, TP18.1, U18.7 (~FAULT)
/01_POWER_TREE/LTC_GATE: Q2.2 (G1), Q2.4 (G2), Q3.2 (G1), Q3.4 (G2), R76.1, TP17.1, U18.10 (GATE)
/01_POWER_TREE/LTC_GATE_RC: C57.1, R76.2
/01_POWER_TREE/LTC_OV: R77.2, R78.1, U18.3 (OV)
/01_POWER_TREE/LTC_SHDN: Q4.3 (D), R80.2, U18.6 (~SHDN)
/01_POWER_TREE/LTC_UV: R79.2, U18.2 (UV)
/01_POWER_TREE/MAX17048_ALRT_N: TP11.1, U14.5 (~ALRT)
/01_POWER_TREE/NFC_5V_PA_PENDING: C34.2, C35.1, R44.2, R107.1, TP9.1, U13.6 (VOUT)
/01_POWER_TREE/N_BATDIV: C61.1, R89.2, R90.1, U19.6 (INB-)
/01_POWER_TREE/N_POL: R85.2, R86.1, TP23.1, U19.3 (INA+)
/01_POWER_TREE/Q2_CS: Q2.1 (S1), Q2.3 (S2)
/01_POWER_TREE/Q3_CS: Q3.1 (S1), Q3.3 (S2)
/01_POWER_TREE/REC_AND1: Q6.2 (S), Q7.3 (D)
/01_POWER_TREE/REC_AND2: Q7.2 (S), Q8.3 (D)
/01_POWER_TREE/REC_BAT_LOW: Q7.1 (G), R93.1, U19.7 (OUTB)
/01_POWER_TREE/REC_DIODE_IN: D12.2 (A), R95.2, TP22.1
/01_POWER_TREE/REC_FAULT_B: Q8.1 (G), Q9.3 (D), R96.2
/01_POWER_TREE/REC_GATE_N: Q5.1 (G), Q6.3 (D), R94.2, TP21.1
/01_POWER_TREE/REC_LIM_IN: Q5.3 (D), R95.1
/01_POWER_TREE/REC_POL_OK: Q6.1 (G), U19.1 (OUTA)
/01_POWER_TREE/REF_HO: R91.2, R92.1, R93.2, U19.5 (INB+)
/01_POWER_TREE/REF_POL: R87.2, R88.1, TP24.1, U19.2 (INA-)
/01_POWER_TREE/USB_D_CONN_N: J3.A7 (D-), J3.B7 (D-), U10.1 (I/O1)
/01_POWER_TREE/USB_D_CONN_P: J3.A6 (D+), J3.B6 (D+), U10.3 (I/O2)
/01_POWER_TREE/USB_D_ESD_N: R33.1, U10.6 (I/O1)
/01_POWER_TREE/USB_D_ESD_P: R34.1, U10.4 (I/O2)
/01_POWER_TREE/USB_VBUS_CHG: C23.2, D10.2 (A), D11.2 (A), Q5.2 (S), R35.2, R84.1, R91.1, R94.1, R96.1, R104.1, U11.10 (IN)
/01_POWER_TREE/USB_VBUS_RAW: C20.1, J3.A4 (VBUS), J3.A9 (VBUS), J3.B4 (VBUS), J3.B9 (VBUS), R35.1, U10.5 (VBUS)
/01_POWER_TREE/V3V3_FB: R39.2, R40.1, U12.3 (FB)
/01_POWER_TREE/VBRIDGE_TOP: D10.1 (K), R85.1
/01_POWER_TREE/VBUS_PRESENT: C68.1, R104.2, R105.1, TP31.1
/01_POWER_TREE/VREC_VCC: C60.1, R84.2, U19.8 (VCC)
/01_POWER_TREE/VREF_TOP: D11.1 (K), R87.1
/ACC_3V3_EN: R98.1, TP26.1, U20.1 (ON); also elsewhere on the board
/ACC_3V3_SW: C63.1, TP25.1, U20.5 (VOUT); also elsewhere on the board
/ACC_5V_BOOST_EN: R102.1, TP30.1, U21.2 (EN); also elsewhere on the board
/ACC_5V_SW: C67.1, TP29.1, U22.5 (VOUT); also elsewhere on the board
/ACC_5V_SW_EN: R131.1, TP47.1, U22.1 (ON); also elsewhere on the board
/ACC_POWER_FAULT_N: R103.2, TP27.1, TP33.1, U20.6 (~FLT), U22.6 (~FLT); also elsewhere on the board
/BQ25185_STAT1: TP6.1, U11.9 (STAT1); also elsewhere on the board
/BQ25185_STAT2: TP7.1, U11.3 (STAT2); also elsewhere on the board
/I2C_SCL_INT: U14.7 (SCL); also elsewhere on the board
/I2C_SDA_INT: U14.8 (SDA); also elsewhere on the board
/NFC_5V_EN: TP10.1, U13.2 (EN); also elsewhere on the board
/NFC_SUPPLY: R106.2, R107.2, TP32.1; also elsewhere on the board
/USB_D_MCU_N: R33.2; also elsewhere on the board
/USB_D_MCU_P: R34.2; also elsewhere on the board
GND: C20.2, C21.2, C22.2, C23.1, C24.2, C25.2, C26.1, C27.2, C28.2, C29.2, C30.2, C31.2, C32.2, C33.2, C34.1, C35.2, C36.2, C57.2, C58.2, C59.2, C60.2, C61.2, C62.2, C63.2, C64.2, C65.2, C66.2, C67.2, C68.2, D9.2 (A), J3.A1 (GND), J3.A12 (GND), J3.B1 (GND), J3.B12 (GND), J4.2, Q4.2 (S), Q8.2 (S), Q9.2 (S), R30.2, R31.2, R32.2, R36.2, R37.2, R38.2, R40.2, R43.2, R45.2, R78.2, R82.2, R83.2, R88.2, R90.2, R92.2, R97.2, R98.2, R100.2, R101.2, R102.2, R105.2, R131.2, U10.2 (GND), U11.4 (~CE), U11.5 (GND), U11.11 (EP), U12.2 (GND), U12.13 (PS_SYNC), U12.15 (PGND_EP), U13.4 (GND), U14.1 (CTG), U14.4 (GND), U14.9 (EP), U18.4 (RETRY), U18.5 (GND), U19.4 (VEE), U20.3 (GND), U21.4 (GND), U22.3 (GND); also elsewhere on the board
unnamed: J3.A5 (CC1), R31.1
unnamed: J3.B5 (CC2), R30.1
unnamed: J3.SH (SHIELD), R32.1
unnamed: L1.1, U12.8 (L1), U12.9 (L1)
unnamed: L1.2, U12.6 (L2), U12.7 (L2)
unnamed: R43.1, R68.2, SW9.1 (A), TP13.1, U12.12 (EN)
unnamed: R38.1, U11.6 (TS_MR)
unnamed: R41.2, TP8.1, U12.14 (PG)
unnamed: R44.1, R45.1, U13.1 (FB)
unnamed: L2.2, U13.5 (SW)

Notes on the sheet:
MAX17048 FUEL GAUGE I2C ADDRESS 0x36 NO SENSE RESISTOR NEVER BENCH VALIDATED ON AQROOT BETA BRING-UP REQUIRED VERIFY: CELL VOLTAGE SOC PLAUSIBILITY HIBERNATE BATTERY INSERTION / REMOVAL NO I2C BACKPOWER DURING +3V3 HARD-OFF FOOTPRINT PENDING EXACT ADI LAND-PATTERN REVIEW DO NOT ROUTE UNTIL FOOTPRIN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
REVERSE-POLARITY PROTECTION - IMPLEMENTED (FBV2-S1) D-050 / D-052 / D-064 / D-068. The placeholder is RETIRED. See block A, lower left, for the captured circuit: BAT_CONNECTOR_P -> F1 -> BAT_RAW -> Q2 -> BAT_MID -> Q3 -> BAT_SENSE -> R75 15mR -> BAT_PROTECTED_P -> U11 BAT Controller U18 LTC4368-1. 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
TPS61023 NFC 5V PA BOOST DEFAULT OFF ENABLE FROM TCA9535 U60 P02 OUTPUT FEEDS ST25R3916 VDD_PA ONLY VDD_IO REMAINS +3V3 EXACT PASSIVE MPNs PENDING BOM PASS
CAPACITOR MPNs NOT BOM-LOCKED COUT: 4 x 22uF, 10V, X7R, 1206 REQUIRE COMBINED EFFECTIVE COUT >=40uF AT 3.3V VERIFY DC-BIAS / LIFECYCLE / STOCK BEFORE FAB
01_POWER_TREE - CAPTURED (FBV2-S1 POWER-TREE IMPLEMENTATION) CAPTURED: USB-C 5V SINK / USB 2.0 BQ25185 CHARGER / POWER PATH TPS63020 MAIN +3V3 RAIL TPS61023 NFC 5V PA BOOST MAX17048 FUEL GAUGE PHYSICAL MAIN-RAIL HARD OFF BATTERY REVERSE PROTECTION P2 + LTC4368-1 AUTONOMOUS DEAD-CELL RECOVERY (CANDI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
KEEP FB TRACE SHORT ROUTE AWAY FROM L1/L2 SWITCH NODES SENSE VOUT AFTER OUTPUT CAPACITORS
CIN MPNs NOT BOM-LOCKED REQUIRE COMBINED EFFECTIVE CIN >=10uF AT 4.5V VERIFY DC-BIAS / LIFECYCLE / STOCK BEFORE FAB
KEYED JST-PH BATTERY CONNECTOR PIN 1 = BAT+ PIN 2 = GND VERIFY CABLE POLARITY BEFORE CONNECTION MECHANICAL KEYING IS AN ADDITIONAL SAFEGUARD ONLY
R_PS_DEFAULT 0R DEFAULT: POWER-SAVE MODE NO GPIO
PHYSICAL MAIN-RAIL HARD OFF SWITCH OPEN: TPS63020 OFF, +3V3 OFF SWITCH CLOSED: TPS63020 ON UPSTREAM BQ25185 / MAX17048 REMAIN POWERED NOT A GPIO
L_NFC_BOOST 1uH SHIELDED EXACT MPN / ISAT / DCR PENDING BOM PASS
AO3400A-CLASS NFETs PROVISIONAL AO3401A PMOS ALTERNATIVE BUILDING BLOCK ONLY KEYED CONNECTOR IS NOT THE PRIMARY ELECTRICAL DEFENSE
R_PG_PULLUP 1M PG DIAGNOSTIC ONLY - NO GPIO
BETA: FIXED TS BIAS - NO BATTERY NTC PRODUCTION BATTERY TEMPERATURE SENSING REVIEW
C21/C22 data-side pins intentionally NC for Beta (CTO ruling, USB uncoupled budget). Populate via rework jumper only. Restore connection at next revision if Beta EMI data justifies.
=== FBV2-S1 POWER TREE :: A. BATTERY REVERSE PROTECTION (P2) - D-050 / D-052 / D-064 / D-068 ===
JST J4 -> F1 (5A backstop) -> BAT_RAW -> Q2 (stage 1, 2 FETs) -> BAT_MID -> Q3 (stage 2, 2 FETs) -> BAT_SENSE -> R75 15mR -> BAT_PROTECTED_P -> BQ25185 BAT.
LTC4368-1 ONLY (the -2 trips at -3 mV and blocks charging). RETRY grounded = latch-off; SHDN toggled low-then-high clears it. UV unused: 510k to VIN per datasheet (V_UV/V_OV = 492.5 / 500 / 507.5 mV, hysteresis 20 / 25 / 32 mV). OV TRIP (P-21, D-104): R77 3.65M / R78 442k -> 4.63 V nominal, 4.48-4.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
=== B. AUTONOMOUS DEAD-CELL RECOVERY (Candidate B, D-065) - USB-POWERED, FIRMWARE-INDEPENDENT ===
Ratiometric polarity bridge (trip at V_BAT = 0, supply-independent) + handoff comparator + LTC4368 FAULT = hardware 3-input AND. Matched Schottkys D10/D11 keep the bridge ratiometric AND block battery drain when USB is absent.
Q6/Q7/Q8 in series form the AND. Q9 inverts FAULT (active-low) so FAULT-ASSERTED becomes a positive enable. Recovery current = (VBUS - Vf) / R95; single-fault ceiling into a reversed cell = (VBUS - Vf + 4.2) / R95. R95 = 560R LOCKED (P-20, D-105): 8.4 mA nominal at VBUS 5.0 V into a 0 V pack (7.9-8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
=== C. COMMUNITY ACCESSORY POWER (D-086 / D-087 / D-088) - ONE TPS22950C FAMILY ON BOTH RAILS, FLT WIRE-OR (D-094) ===
ACC_3V3: +3V3 -> TPS22950C -> ACC_3V3_SW. R_ILIM 1.5k ~ 0.76 A typ; PUBLISHED LIMIT 400 mA TOTAL across both connector contacts.
ACC_5V: BQ25185_SYS -> dedicated TPS61023 (5.0 V) -> dedicated TPS22950C -> ACC_5V_SW. R_ILIM 1.65k ~ 0.69 A typ; PUBLISHED LIMIT 300 mA TOTAL. NOT USB VBUS. NOT the NFC fallback boost (O-3 REJECTED).
=== E. TELEMETRY + NFC NO-RESPIN SOURCE SELECT (D-055 / D-056) ===
VBUS_PRESENT: divided to 2.97 V at VBUS 5.0 V - raw VBUS NEVER reaches the expander. NFC: 3.3 V link FIT, 5 V link DNP, mutually exclusive, no trace cut needed to convert.
