aqroot8/aqroot/hardware/demo/kicad/aqroot-demo/aqroot-Beta-v2.kicad_pcb

## KiCad design hardware/demo/kicad/aqroot-demo/aqroot-Beta-v2.kicad_pcb (continued)

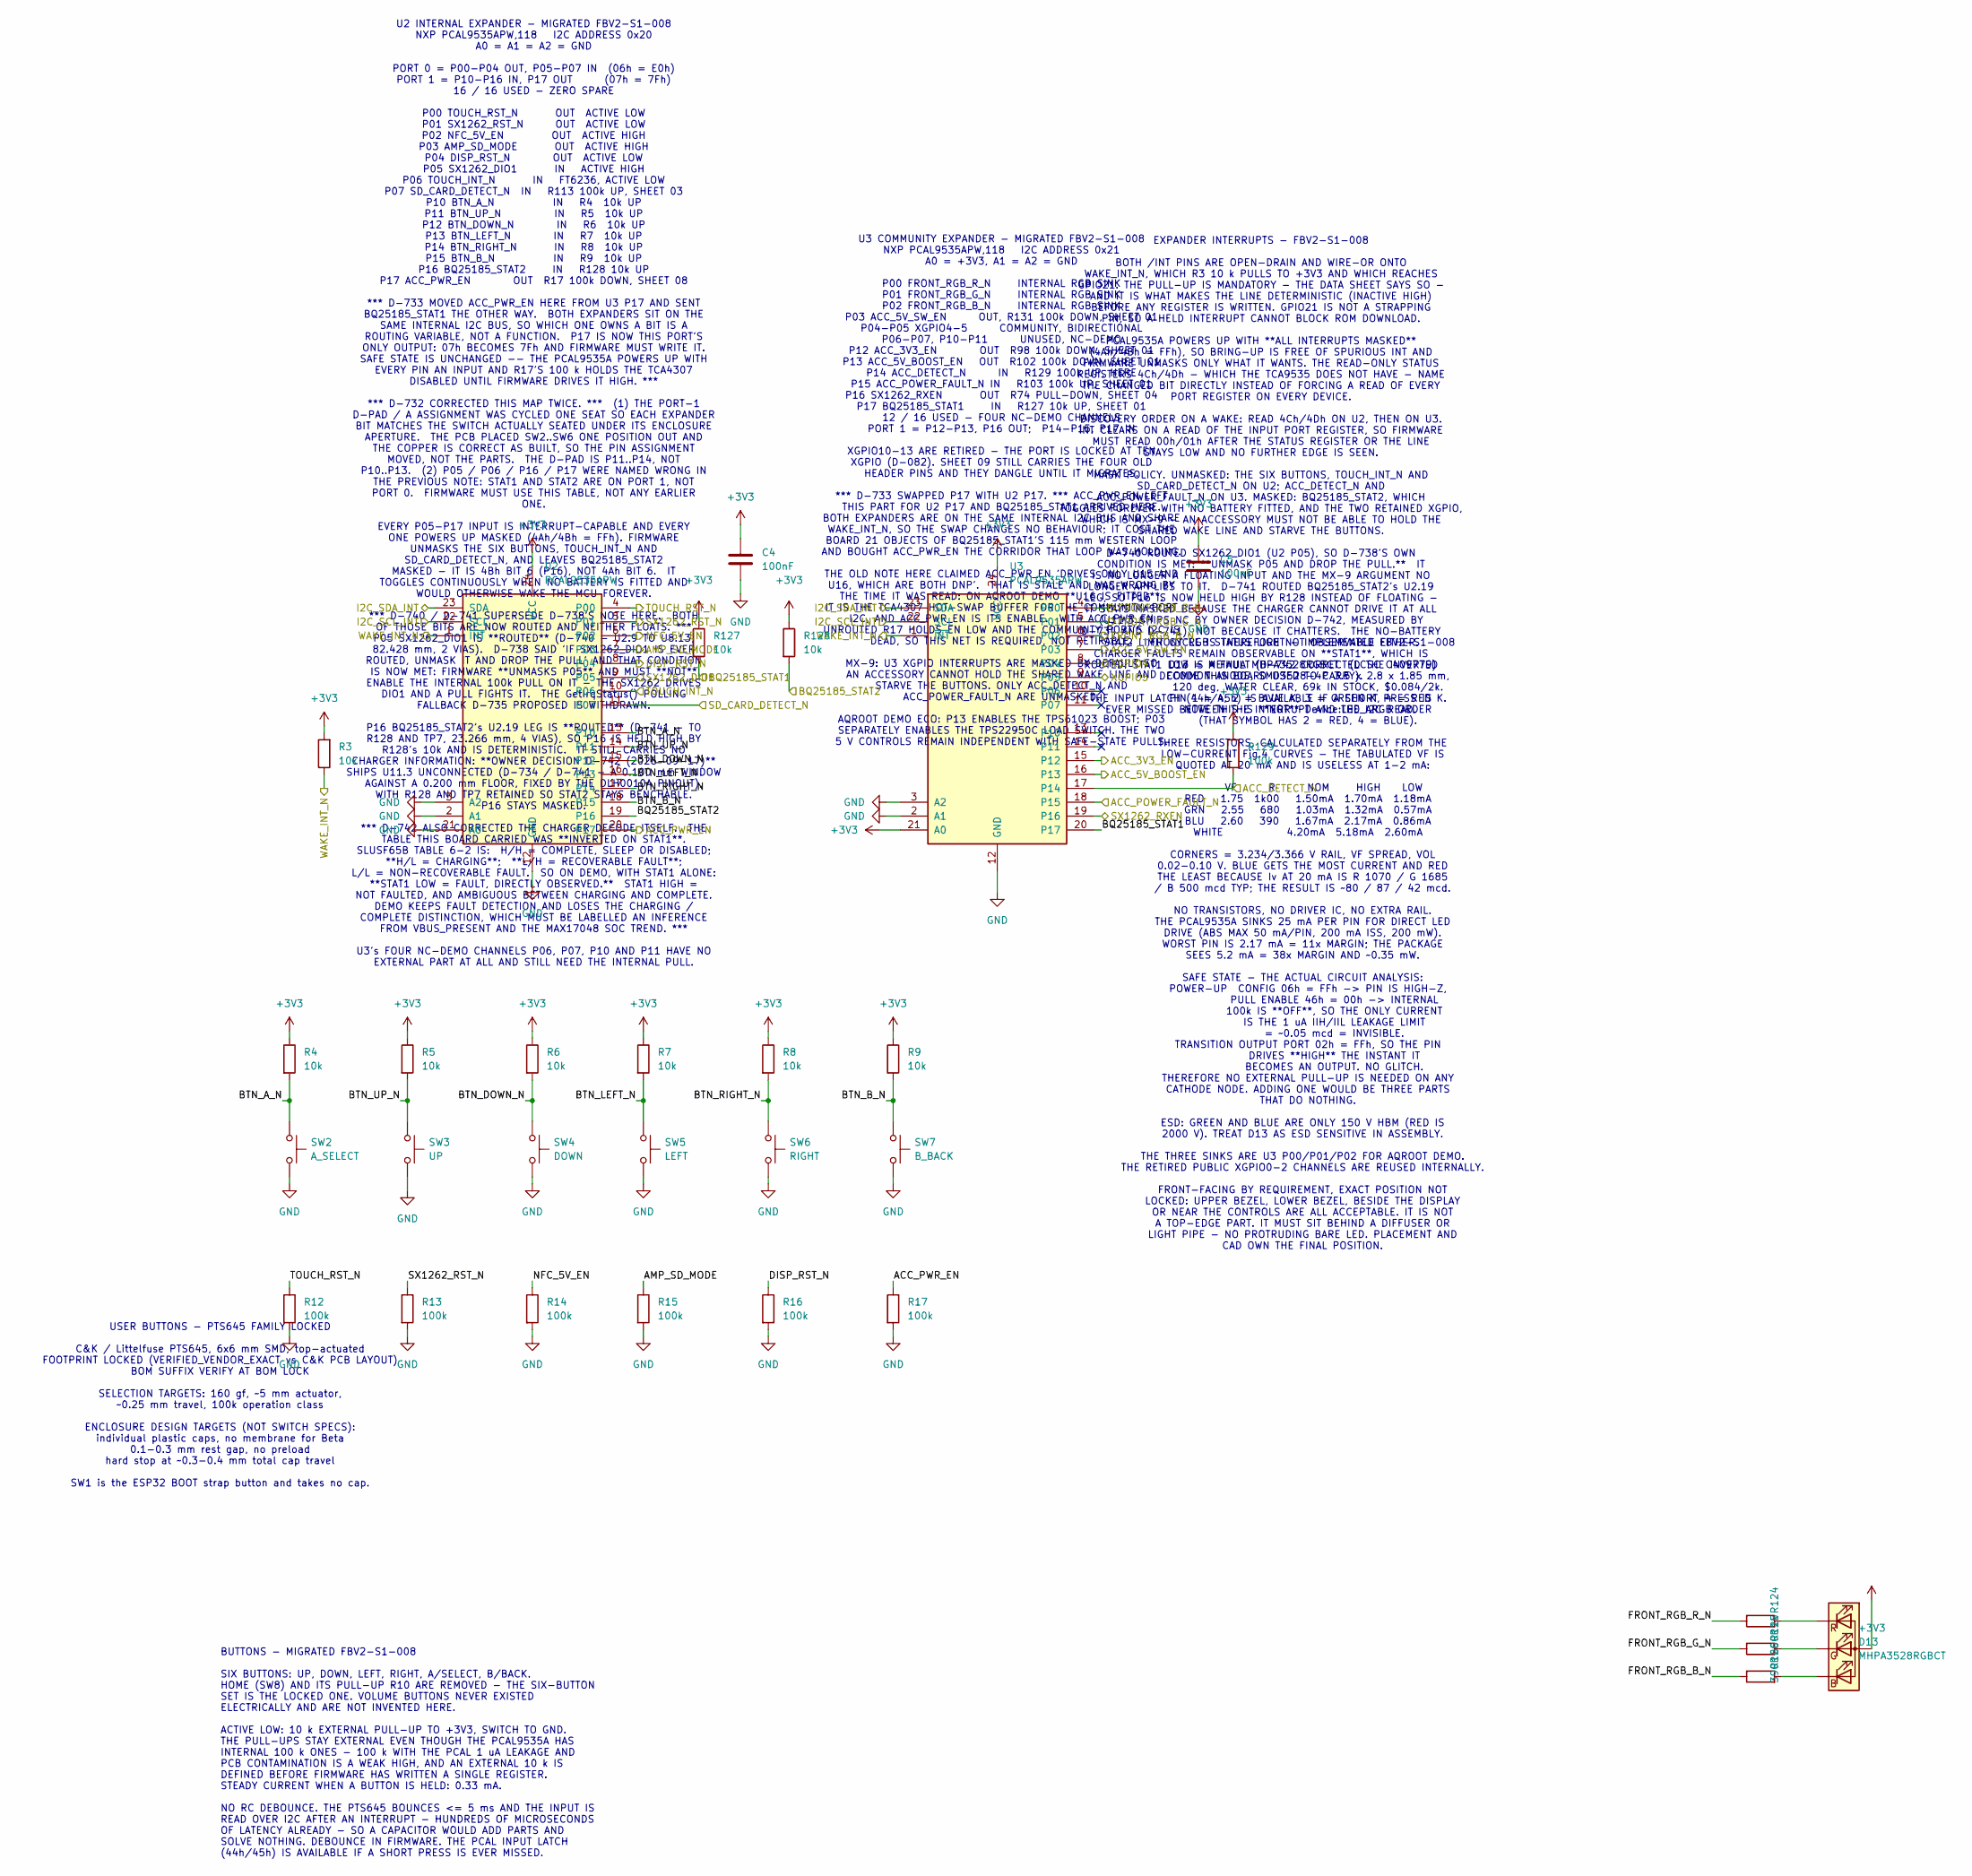
[picture p14: schematic 08_buttons_expanders.kicad_sch]

Parts:
C4, C5: 100nF; C_0603_1608Metric; MPN CC0603KRX7R9BB104; LCSC C14663
D13: MHPA3528RGBCT; MEIHUA_MHPA3528RGBCT_PLCC4_3.5x2.8mm; MPN MHPA3528RGBCT; LCSC C409779
R3, R4, R5, R6, R7, R8, R9: 10k; R_0603_1608Metric; MPN 0603WAF1002T5E; LCSC C25804
R12, R13, R14, R15, R16, R17: 100k; R_0603_1608Metric; MPN 0603WAF1003T5E; LCSC C25803
R124: 1k; R_0603_1608Metric; Tolerance 1%; MPN 0603WAF1001T5E; LCSC C21190
R125: 680R; R_0603_1608Metric; Tolerance 1%; MPN 0603WAF6800T5E; LCSC C23228
R126: 390R; R_0603_1608Metric; Tolerance 1%; MPN 0603WAF3900T5E; LCSC C23151
R127, R128: 10k; R_0603_1608Metric; Tolerance 1%; MPN 0603WAF1002T5E; LCSC C25804
R129: 100k; R_0603_1608Metric; Tolerance 1%; MPN 0603WAF1003T5E; LCSC C25803
SW2: A_SELECT; SW_SPST_PTS645Sx43SMTR92; MPN PTS645SM43SMTR92LFS; LCSC C221880
SW3: UP; SW_SPST_PTS645Sx43SMTR92; MPN PTS645SM43SMTR92LFS; LCSC C221880
SW4: DOWN; SW_SPST_PTS645Sx43SMTR92; MPN PTS645SM43SMTR92LFS; LCSC C221880
SW5: LEFT; SW_SPST_PTS645Sx43SMTR92; MPN PTS645SM43SMTR92LFS; LCSC C221880
SW6: RIGHT; SW_SPST_PTS645Sx43SMTR92; MPN PTS645SM43SMTR92LFS; LCSC C221880
SW7: B_BACK; SW_SPST_PTS645Sx43SMTR92; MPN PTS645SM43SMTR92LFS; LCSC C221880
U2, U3: PCAL9535APW; TSSOP-24_4.4x7.8mm_P0.65mm; MPN PCAL9535APW,118; LCSC C2669683

Connections:
+3V3: C4.1, C5.1, D13.1 (A), R3.2, R4.1, R5.1, R6.1, R7.1, R8.1, R9.1, R127.1, R128.1, R129.1, U2.24 (VCC), U3.21 (A0), U3.24 (VCC); also elsewhere on the board
/08_BUTTONS_EXPANDERS/BTN_A_N: R4.2, SW2.1, U2.13 (P10)
/08_BUTTONS_EXPANDERS/BTN_B_N: R9.2, SW7.1, U2.18 (P15)
/08_BUTTONS_EXPANDERS/BTN_DOWN_N: R6.2, SW4.1, U2.15 (P12)
/08_BUTTONS_EXPANDERS/BTN_LEFT_N: R7.2, SW5.1, U2.16 (P13)
/08_BUTTONS_EXPANDERS/BTN_RIGHT_N: R8.2, SW6.1, U2.17 (P14)
/08_BUTTONS_EXPANDERS/BTN_UP_N: R5.2, SW3.1, U2.14 (P11)
/08_BUTTONS_EXPANDERS/FRONT_RGB_B_N: R126.1, U3.6 (P02)
/08_BUTTONS_EXPANDERS/FRONT_RGB_G_N: R125.1, U3.5 (P01)
/08_BUTTONS_EXPANDERS/FRONT_RGB_R_N: R124.1, U3.4 (P00)
/ACC_3V3_EN: U3.15 (P12); also elsewhere on the board
/ACC_5V_BOOST_EN: U3.16 (P13); also elsewhere on the board
/ACC_5V_SW_EN: U3.7 (P03); also elsewhere on the board
/ACC_DETECT_N: R129.2, U3.17 (P14); also elsewhere on the board
/ACC_POWER_FAULT_N: U3.18 (P15); also elsewhere on the board
/ACC_PWR_EN: R17.1, U2.20 (P17); also elsewhere on the board
/AMP_SD_MODE: R15.1, U2.7 (P03); also elsewhere on the board
/BQ25185_STAT1: R127.2, U3.20 (P17); also elsewhere on the board
/BQ25185_STAT2: R128.2, U2.19 (P16); also elsewhere on the board
/DISP_RST_N: R16.1, U2.8 (P04); also elsewhere on the board
/I2C_SCL_INT: U2.22 (SCL), U3.22 (SCL); also elsewhere on the board
/I2C_SDA_INT: U2.23 (SDA), U3.23 (SDA); also elsewhere on the board
/NFC_5V_EN: R14.1, U2.6 (P02); also elsewhere on the board
/SD_CARD_DETECT_N: U2.11 (P07); also elsewhere on the board
/SX1262_DIO1: U2.9 (P05); also elsewhere on the board
/SX1262_RST_N: R13.1, U2.5 (P01); also elsewhere on the board
/SX1262_RXEN: U3.19 (P16); also elsewhere on the board
/TOUCH_INT_N: U2.10 (P06); also elsewhere on the board
/TOUCH_RST_N: R12.1, U2.4 (P00); also elsewhere on the board
/WAKE_INT_N: R3.1, U2.1 (~INT), U3.1 (~INT); also elsewhere on the board
/XGPIO4: U3.8 (P04); also elsewhere on the board
/XGPIO5: U3.9 (P05); also elsewhere on the board
GND: C4.2, C5.2, R12.2, R13.2, R14.2, R15.2, R16.2, R17.2, SW2.2, SW3.2, SW4.2, SW5.2, SW6.2, SW7.2, U2.2 (A1), U2.3 (A2), U2.12 (GND), U2.21 (A0), U3.2 (A1), U3.3 (A2), U3.12 (GND); also elsewhere on the board
unnamed: D13.2 (BK), R126.2
unnamed: D13.3 (GK), R125.2
unnamed: D13.4 (RK), R124.2

Notes on the sheet:
USER BUTTONS - PTS645 FAMILY LOCKED C&K / Littelfuse PTS645, 6x6 mm SMD, top-actuated FOOTPRINT LOCKED (VERIFIED_VENDOR_EXACT vs C&K PCB LAYOUT) BOM SUFFIX VERIFY AT BOM LOCK SELECTION TARGETS: 160 gf, ~5 mm actuator, ~0.25 mm travel, 100k operation class ENCLOSURE DESIGN TARGETS (NOT SWITCH SPECS)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
BUTTONS - MIGRATED FBV2-S1-008 SIX BUTTONS: UP, DOWN, LEFT, RIGHT, A/SELECT, B/BACK. HOME (SW8) AND ITS PULL-UP R10 ARE REMOVED - THE SIX-BUTTON SET IS THE LOCKED ONE. VOLUME BUTTONS NEVER EXISTED ELECTRICALLY AND ARE NOT INVENTED HERE. ACTIVE LOW: 10 k EXTERNAL PULL-UP TO +3V3, SWITCH TO GND. THE 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
U2 INTERNAL EXPANDER - MIGRATED FBV2-S1-008 NXP PCAL9535APW,118 I2C ADDRESS 0x20 A0 = A1 = A2 = GND PORT 0 = P00-P04 OUT, P05-P07 IN (06h = E0h) PORT 1 = P10-P16 IN, P17 OUT (07h = 7Fh) 16 / 16 USED - ZERO SPARE P00 TOUCH_RST_N OUT ACTIVE LOW P01 SX1262_RST_N OUT ACTIVE LOW P02 NFC_5V_EN OUT ACTIVE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
U3 COMMUNITY EXPANDER - MIGRATED FBV2-S1-008 NXP PCAL9535APW,118 I2C ADDRESS 0x21 A0 = +3V3, A1 = A2 = GND P00 FRONT_RGB_R_N INTERNAL RGB SINK P01 FRONT_RGB_G_N INTERNAL RGB SINK P02 FRONT_RGB_B_N INTERNAL RGB SINK P03 ACC_5V_SW_EN OUT, R131 100k DOWN, SHEET 01 P04-P05 XGPIO4-5 COMMUNITY, BIDIRECTI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
FRONT RGB STATUS LIGHT - IMPLEMENTED FBV2-S1-008 D13 = MEIHUA MHPA3528RGBCT (LCSC C409779) COMMON ANODE, SMD3528-4P 3.5 x 2.8 x 1.85 mm, 120 deg, WATER CLEAR, 69k IN STOCK, $0.084/2k. PIN 1 = A, 2 = BLUE K, 3 = GREEN K, 4 = RED K. NOTE THIS IS **NOT** Device:LED_ARGB ORDER (THAT SYMBOL HAS 2 = RED,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
EXPANDER INTERRUPTS - FBV2-S1-008 BOTH /INT PINS ARE OPEN-DRAIN AND WIRE-OR ONTO WAKE_INT_N, WHICH R3 10 k PULLS TO +3V3 AND WHICH REACHES GPIO21. THE PULL-UP IS MANDATORY - THE DATA SHEET SAYS SO - AND IT IS WHAT MAKES THE LINE DETERMINISTIC (INACTIVE HIGH) BEFORE ANY REGISTER IS WRITTEN. GPIO21 I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

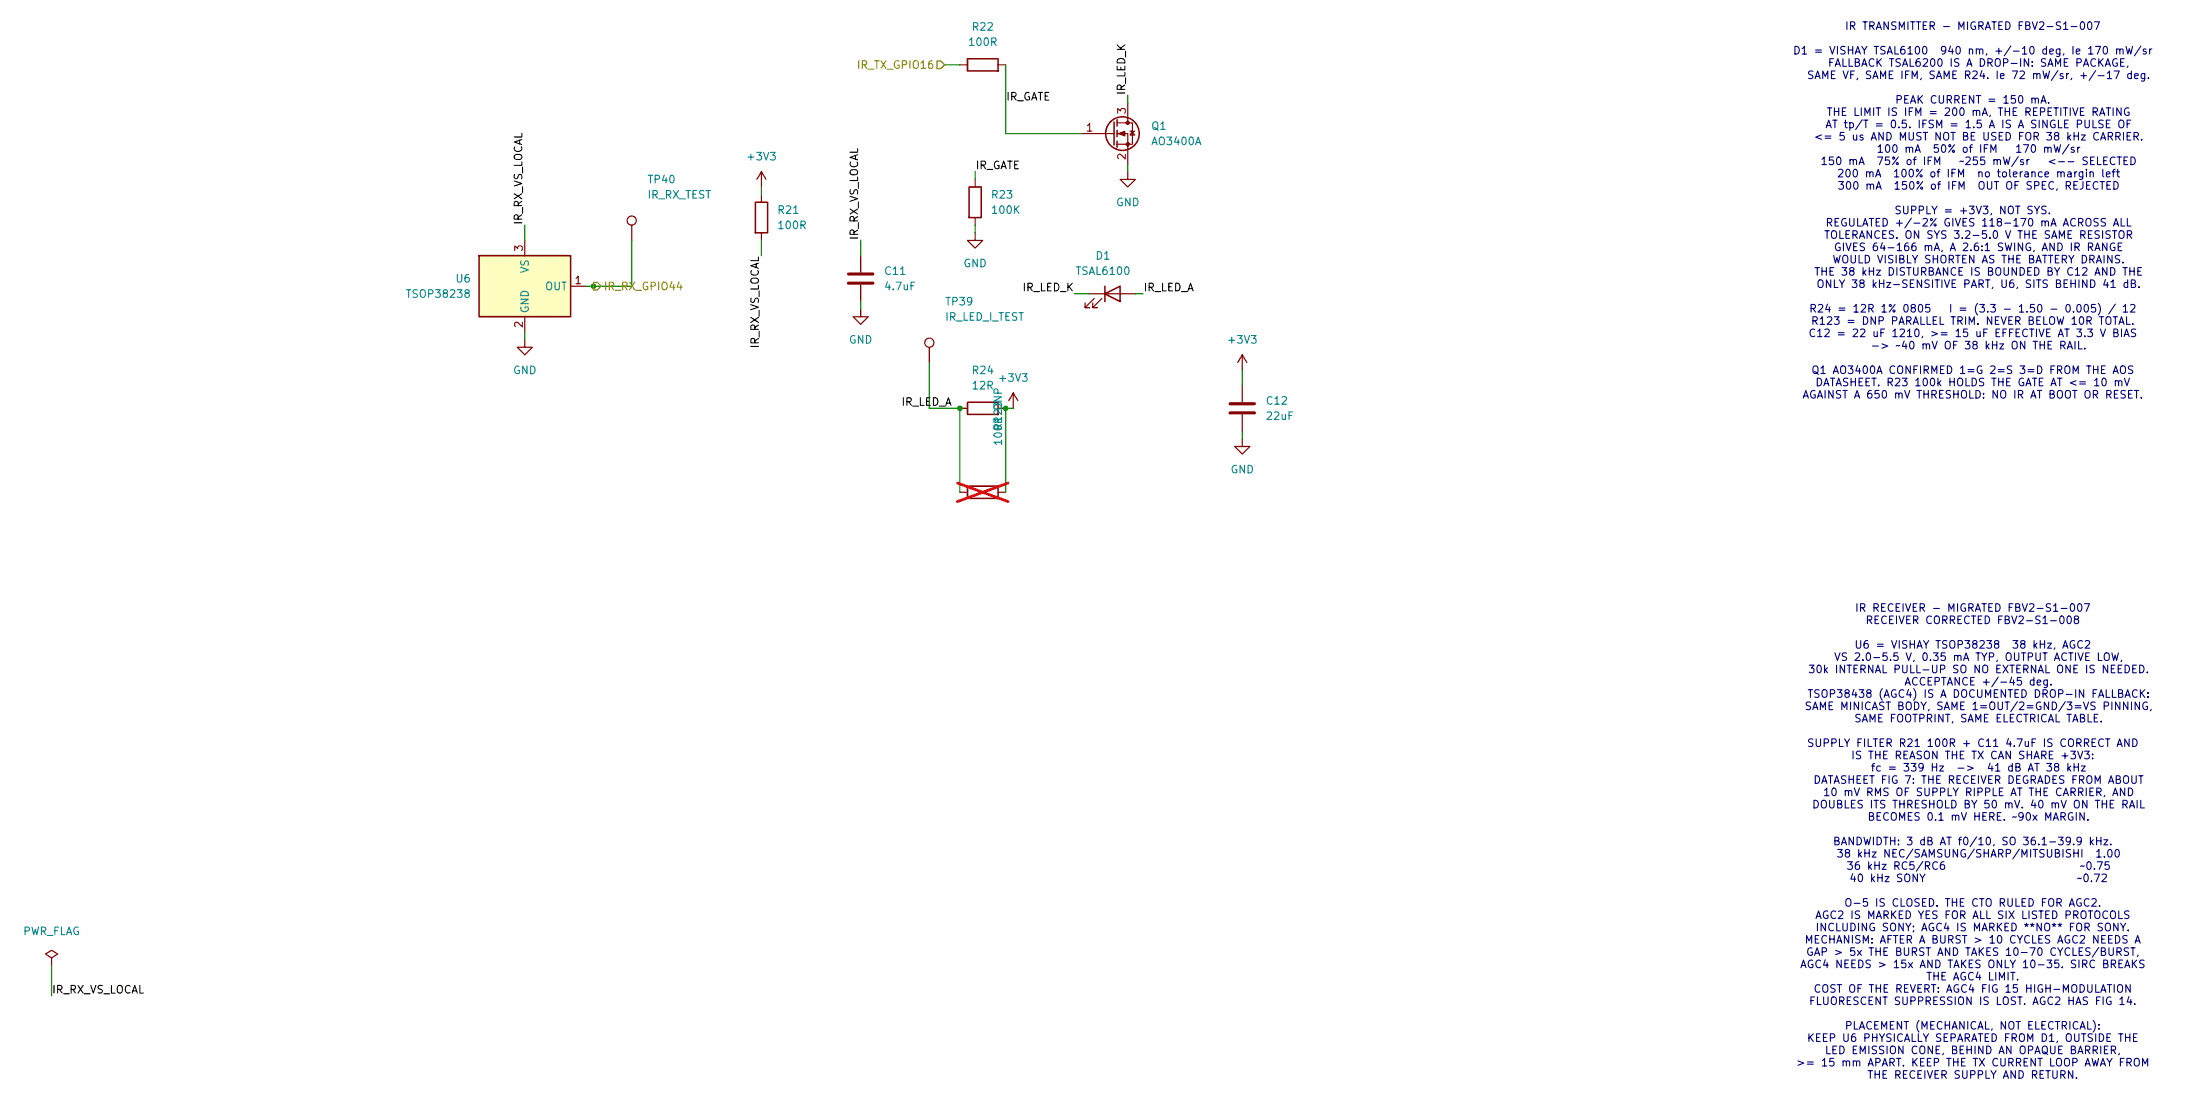
[picture p15: schematic 07_ir.kicad_sch]

Parts:
C11: 4.7uF; C_0805_2012Metric; MPN CL21A475KAQNNNE; LCSC C1779
C12: 22uF; C_1210_3225Metric; Voltage 16V; MPN CL32B226KAJNNNE; LCSC C309062
D1: TSAL6100; LED_D5.0mm; MPN TSAL6100; LCSC C111836
Q1: AO3400A; SOT-23; MPN AO3400A
R21, R22: 100R; R_0603_1608Metric; MPN 0603WAF1000T5E; LCSC C22775
R23: 100K; R_0603_1608Metric; MPN 0603WAF1003T5E; LCSC C25803
R24: 12R; R_0805_2012Metric; Tolerance 1%; MPN SR0805FR-4712RL; LCSC C26080556
R123: 100R DNP; R_0805_2012Metric; not fitted
TP39: IR_LED_I_TEST; TestPoint_Pad_D1.0mm
TP40: IR_RX_TEST; TestPoint_Pad_D1.0mm
U6: TSOP38238; Vishay_TSOP382xx_Minicast_3Pin_P2.54mm; MPN TSOP38238; LCSC C141632

Connections:
+3V3: C12.2, R21.1, R24.2, R123.2; also elsewhere on the board
/07_IR/IR_GATE: Q1.1 (G), R22.2, R23.1
/07_IR/IR_LED_A: D1.2 (A), R24.1, R123.1, TP39.1
/07_IR/IR_LED_K: D1.1 (K), Q1.3 (D)
/07_IR/IR_RX_VS_LOCAL: C11.1, R21.2, U6.3 (VS)
/IR_RX_GPIO44: TP40.1, U6.1 (OUT); also elsewhere on the board
/IR_TX_GPIO16: R22.1; also elsewhere on the board
GND: C11.2, C12.1, Q1.2 (S), R23.2, U6.2 (GND); also elsewhere on the board

Notes on the sheet:
IR TRANSMITTER - MIGRATED FBV2-S1-007 D1 = VISHAY TSAL6100 940 nm, +/-10 deg, Ie 170 mW/sr FALLBACK TSAL6200 IS A DROP-IN: SAME PACKAGE, SAME VF, SAME IFM, SAME R24. Ie 72 mW/sr, +/-17 deg. PEAK CURRENT = 150 mA. THE LIMIT IS IFM = 200 mA, THE REPETITIVE RATING AT tp/T = 0.5. IFSM = 1.5 A IS A SING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
IR RECEIVER - MIGRATED FBV2-S1-007 RECEIVER CORRECTED FBV2-S1-008 U6 = VISHAY TSOP38238 38 kHz, AGC2 VS 2.0-5.5 V, 0.35 mA TYP, OUTPUT ACTIVE LOW, 30k INTERNAL PULL-UP SO NO EXTERNAL ONE IS NEEDED. ACCEPTANCE +/-45 deg. TSOP38438 (AGC4) IS A DOCUMENTED DROP-IN FALLBACK: SAME MINICAST BODY, SAME 1=O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

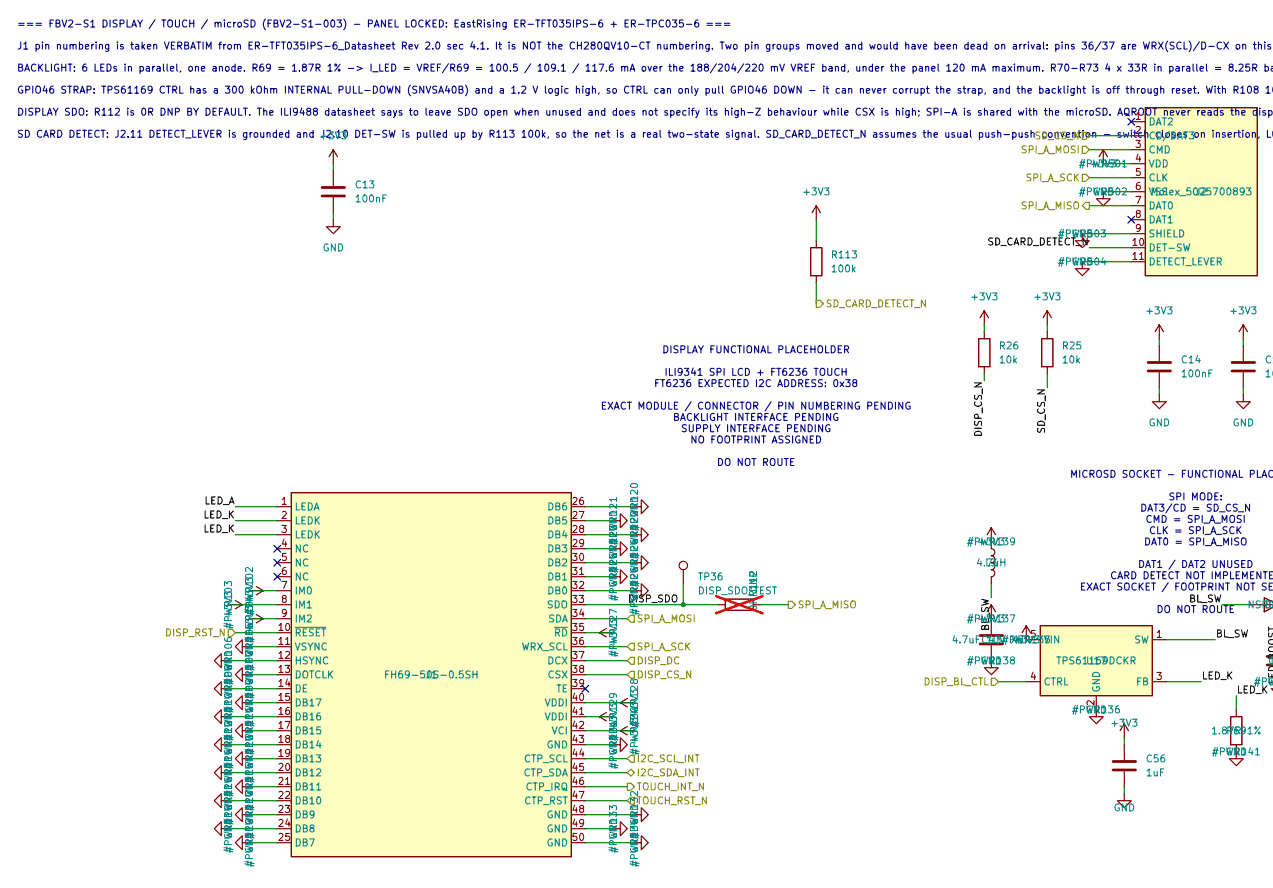
[picture p16: schematic 03_spi_a_display_sd.kicad_sch, part in row 1, column 1]

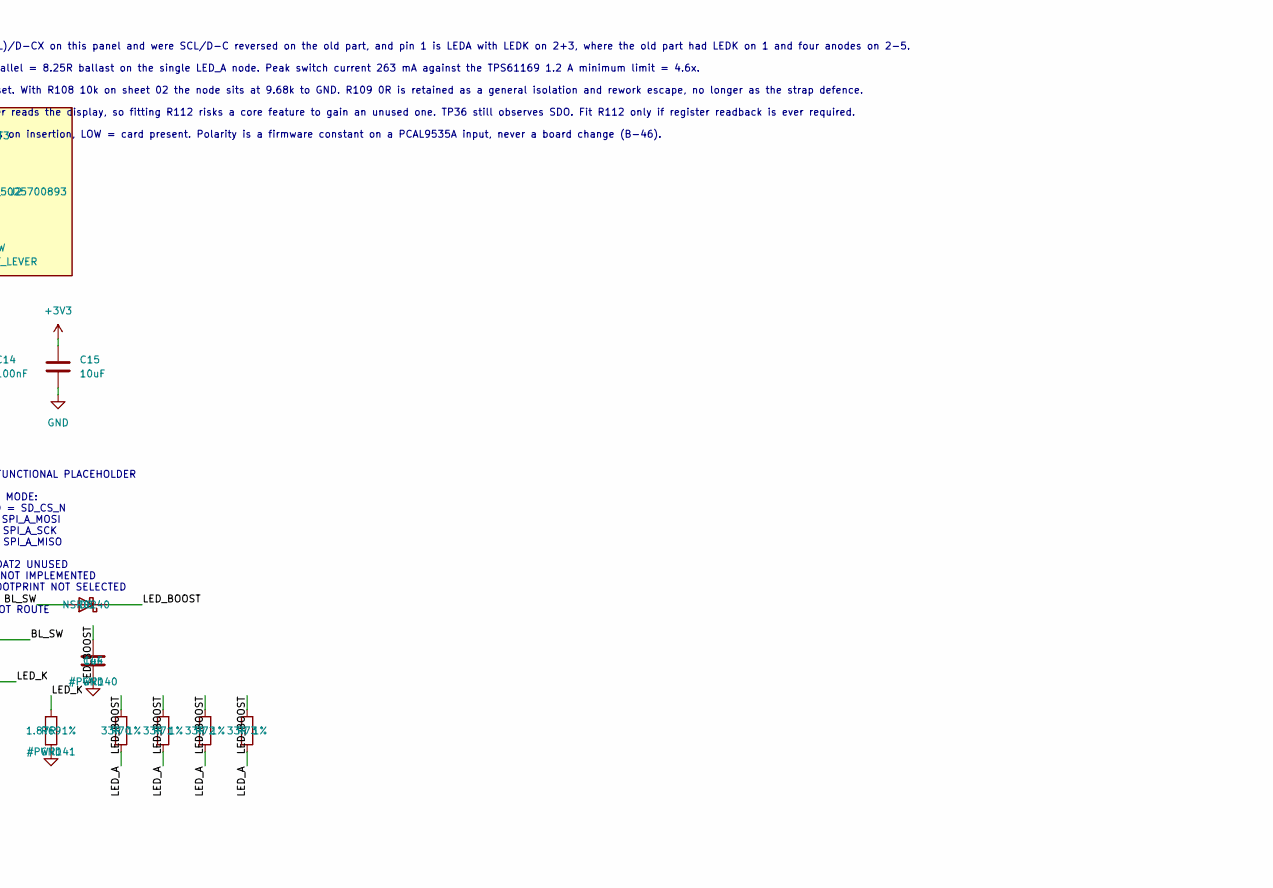
[picture p17: schematic 03_spi_a_display_sd.kicad_sch, part in row 1, column 2]

Parts:
C13, C14: 100nF; C_0603_1608Metric; MPN CC0603KRX7R9BB104; LCSC C14663
C15: 10uF; C_0805_2012Metric; MPN GRM21BR61H106KE43L; LCSC C440198
C43: 4.7uF 10V X5R; C_0805_2012Metric; Voltage 16V; MPN CL21A475KAQNNNE; LCSC C1779
C44: 1uF; C_0805_2012Metric; Voltage 50V; MPN CL21B105KBFNNNE; LCSC C28323
C56: 1uF; C_0603_1608Metric; Voltage 16V; MPN CL10A105KB8NNNC; LCSC C15849
D8: NSR0240; D_SOD-323; MPN NSR0240HT1G; LCSC C152519
J1: FH69-50S-0.5SH; Hirose_FH69-50S-0.5SH; MPN FH69-50S-0.5SH; LCSC C25955556
J2: Molex_5025700893; MPN 5025700893; LCSC C429846
L3: 4.7uH; Coilcraft_XFL4020; MPN XFL4020-472MEC; LCSC C5156236
R25, R26: 10k; R_0603_1608Metric; MPN 0603WAF1002T5E; LCSC C25804
R69: 1.87R 1%; R_0603_1608Metric; Tolerance 1%; MPN 0603WAF187KT5E; LCSC C422967
R70, R71, R72, R73: 33R 1%; R_0603_1608Metric; Tolerance 1%; MPN 0603WAF330JT5E; LCSC C23140
R112: 0R DNP; R_0603_1608Metric; not fitted
R113: 100k; R_0603_1608Metric; MPN 0603WAF1003T5E; LCSC C25803
TP36: DISP_SDO_TEST; TestPoint_Pad_D1.0mm
U17: TPS61169DCKR; SOT-353_SC-70-5; MPN TPS61169DCKR; LCSC C71045

Connections:
+3V3: C13.1, C14.1, C15.1, C43.1, C56.1, J1.7 (IM0), J1.8 (IM1), J1.9 (IM2), J1.35 (~RD), J1.40 (VDDI), J1.41 (VDDI), J1.42 (VCI), J2.4 (VDD), L3.1, R25.1, R26.1, R113.1, U17.5 (VIN); also elsewhere on the board
/03_SPI_A_DISPLAY_SD/BL_SW: D8.2 (A), L3.2, U17.1 (SW)
/03_SPI_A_DISPLAY_SD/DISP_SDO: J1.33 (SDO), R112.1, TP36.1
/03_SPI_A_DISPLAY_SD/LED_A: J1.1 (LEDA), R70.2, R71.2, R72.2, R73.2
/03_SPI_A_DISPLAY_SD/LED_BOOST: C44.1, D8.1 (K), R70.1, R71.1, R72.1, R73.1
/03_SPI_A_DISPLAY_SD/LED_K: J1.2 (LEDK), J1.3 (LEDK), R69.1, U17.3 (FB)
/DISP_BL_CTL: U17.4 (CTRL); also elsewhere on the board
/DISP_CS_N: J1.38 (CSX), R26.2; also elsewhere on the board
/DISP_DC: J1.37 (DCX); also elsewhere on the board
/DISP_RST_N: J1.10 (~RESET); also elsewhere on the board
/I2C_SCL_INT: J1.44 (CTP_SCL); also elsewhere on the board
/I2C_SDA_INT: J1.45 (CTP_SDA); also elsewhere on the board
/SD_CARD_DETECT_N: J2.10 (DET-SW), R113.2; also elsewhere on the board
/SD_CS_N: J2.2 (CD/DAT3), R25.2; also elsewhere on the board
/SPI_A_MISO: J2.7 (DAT0), R112.2; also elsewhere on the board
/SPI_A_MOSI: J1.34 (SDA), J2.3 (CMD); also elsewhere on the board
/SPI_A_SCK: J1.36 (WRX_SCL), J2.5 (CLK); also elsewhere on the board
/TOUCH_INT_N: J1.46 (CTP_IRQ); also elsewhere on the board
/TOUCH_RST_N: J1.47 (CTP_RST); also elsewhere on the board
GND: C13.2, C14.2, C15.2, C43.2, C44.2, C56.2, J1.11 (VSYNC), J1.12 (HSYNC), J1.13 (DOTCLK), J1.14 (DE), J1.15 (DB17), J1.16 (DB16), J1.17 (DB15), J1.18 (DB14), J1.19 (DB13), J1.20 (DB12), J1.21 (DB11), J1.22 (DB10), J1.23 (DB9), J1.24 (DB8), J1.25 (DB7), J1.26 (DB6), J1.27 (DB5), J1.28 (DB4), J1.29 (DB3), J1.30 (DB2), J1.31 (DB1), J1.32 (DB0), J1.43 (GND), J1.48 (GND), J1.49 (GND), J1.50 (GND), J2.6 (VSS), J2.9 (SHIELD), J2.11 (DETECT_LEVER), R69.2, U17.2 (GND); also elsewhere on the board

Notes on the sheet:
DISPLAY FUNCTIONAL PLACEHOLDER ILI9341 SPI LCD + FT6236 TOUCH FT6236 EXPECTED I2C ADDRESS: 0x38 EXACT MODULE / CONNECTOR / PIN NUMBERING PENDING BACKLIGHT INTERFACE PENDING SUPPLY INTERFACE PENDING NO FOOTPRINT ASSIGNED DO NOT ROUTE
MICROSD SOCKET - FUNCTIONAL PLACEHOLDER SPI MODE: DAT3/CD = SD_CS_N CMD = SPI_A_MOSI CLK = SPI_A_SCK DAT0 = SPI_A_MISO DAT1 / DAT2 UNUSED CARD DETECT NOT IMPLEMENTED EXACT SOCKET / FOOTPRINT NOT SELECTED DO NOT ROUTE
=== FBV2-S1 DISPLAY / TOUCH / microSD (FBV2-S1-003) - PANEL LOCKED: EastRising ER-TFT035IPS-6 + ER-TPC035-6 ===
J1 pin numbering is taken VERBATIM from ER-TFT035IPS-6_Datasheet Rev 2.0 sec 4.1. It is NOT the CH280QV10-CT numbering. Two pin groups moved and would have been dead on arrival: pins 36/37 are WRX(SCL)/D-CX on this panel and were SCL/D-C reversed on the old part, and pin 1 is LEDA with LEDK on 2+3,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
BACKLIGHT: 6 LEDs in parallel, one anode. R69 = 1.87R 1% -> I_LED = VREF/R69 = 100.5 / 109.1 / 117.6 mA over the 188/204/220 mV VREF band, under the panel 120 mA maximum. R70-R73 4 x 33R in parallel = 8.25R ballast on the single LED_A node. Peak switch current 263 mA against the TPS61169 1.2 A mini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
GPIO46 STRAP: TPS61169 CTRL has a 300 kOhm INTERNAL PULL-DOWN (SNVSA40B) and a 1.2 V logic high, so CTRL can only pull GPIO46 DOWN - it can never corrupt the strap, and the backlight is off through reset. With R108 10k on sheet 02 the node sits at 9.68k to GND. R109 0R is retained as a general isol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
DISPLAY SDO: R112 is 0R DNP BY DEFAULT. The ILI9488 datasheet says to leave SDO open when unused and does not specify its high-Z behaviour while CSX is high; SPI-A is shared with the microSD. AQROOT never reads the display, so fitting R112 risks a core feature to gain an unused one. TP36 still obse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
SD CARD DETECT: J2.11 DETECT_LEVER is grounded and J2.10 DET-SW is pulled up by R113 100k, so the net is a real two-state signal. SD_CARD_DETECT_N assumes the usual push-push convention - switch closes on insertion, LOW = card present. Polarity is a firmware constant on a PCAL9535A input, never a b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

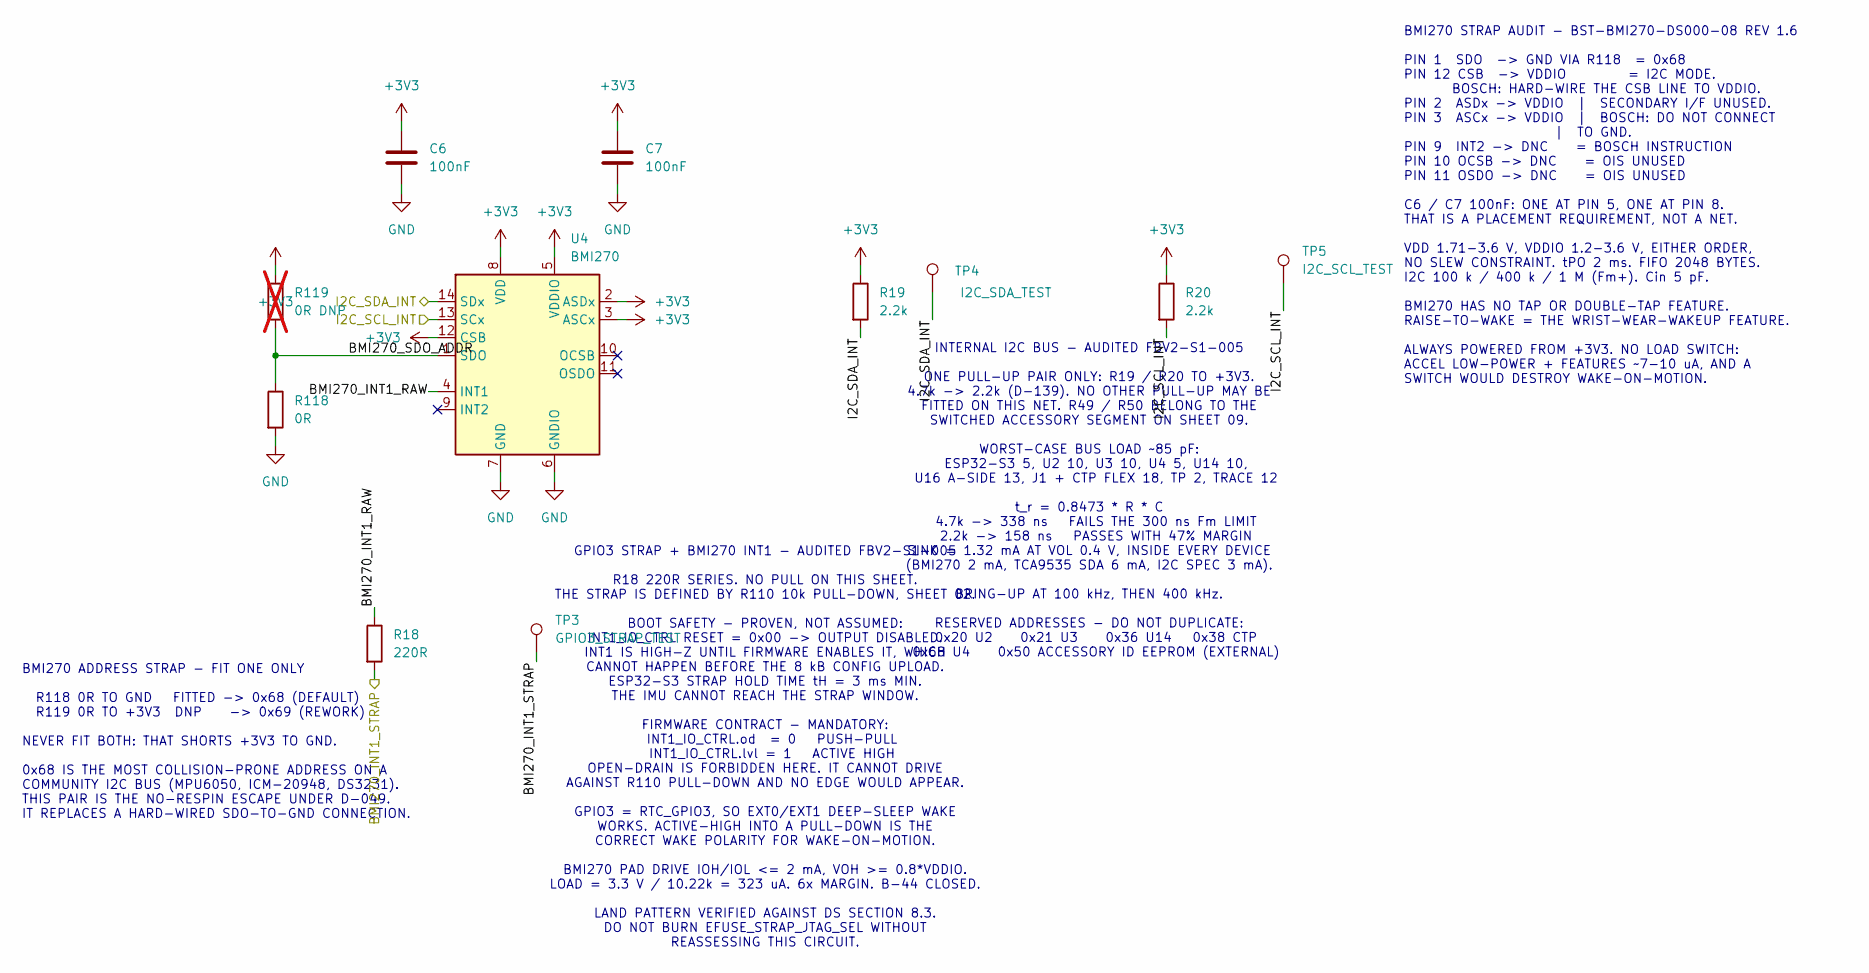
[picture p18: schematic 05_i2c_devices.kicad_sch]

Parts:
C6, C7: 100nF; C_0603_1608Metric; MPN CC0603KRX7R9BB104; LCSC C14663
R18: 220R; R_0603_1608Metric; MPN 0603WAF2200T5E; LCSC C22962
R19, R20: 2.2k; R_0603_1608Metric; MPN 0603WAF2201T5E; LCSC C4190
R118: 0R; R_0603_1608Metric; MPN 0603WAF0000T5E; LCSC C21189
R119: 0R DNP; R_0603_1608Metric; not fitted
TP3: GPIO3_STRAP_TEST; TestPoint_Pad_D1.0mm
TP4: I2C_SDA_TEST; TestPoint_Pad_D1.0mm
TP5: I2C_SCL_TEST; TestPoint_Pad_D1.0mm
U4: BMI270; Bosch_LGA-14_2.5x3.0mm_P0.5mm_BMI270; MPN BMI270; LCSC C2836813

Connections:
+3V3: C6.1, C7.1, R19.1, R20.1, R119.1, U4.2 (ASDx), U4.3 (ASCx), U4.5 (VDDIO), U4.8 (VDD), U4.12 (CSB); also elsewhere on the board
/05_I2C_DEVICES/BMI270_INT1_RAW: R18.1, U4.4 (INT1)
/05_I2C_DEVICES/BMI270_SDO_ADDR: R118.1, R119.2, U4.1 (SDO)
/BMI270_INT1_STRAP: R18.2, TP3.1; also elsewhere on the board
/I2C_SCL_INT: R20.2, TP5.1, U4.13 (SCx); also elsewhere on the board
/I2C_SDA_INT: R19.2, TP4.1, U4.14 (SDx); also elsewhere on the board
GND: C6.2, C7.2, R118.2, U4.6 (GNDIO), U4.7 (GND); also elsewhere on the board

Notes on the sheet:
GPIO3 STRAP + BMI270 INT1 - AUDITED FBV2-S1-005 R18 220R SERIES. NO PULL ON THIS SHEET. THE STRAP IS DEFINED BY R110 10k PULL-DOWN, SHEET 02. BOOT SAFETY - PROVEN, NOT ASSUMED: INT1_IO_CTRL RESET = 0x00 -> OUTPUT DISABLED. INT1 IS HIGH-Z UNTIL FIRMWARE ENABLES IT, WHICH CANNOT HAPPEN BEFORE THE 8 k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
INTERNAL I2C BUS - AUDITED FBV2-S1-005 ONE PULL-UP PAIR ONLY: R19 / R20 TO +3V3. 4.7k -> 2.2k (D-139). NO OTHER PULL-UP MAY BE FITTED ON THIS NET. R49 / R50 BELONG TO THE SWITCHED ACCESSORY SEGMENT ON SHEET 09. WORST-CASE BUS LOAD ~85 pF: ESP32-S3 5, U2 10, U3 10, U4 5, U14 10, U16 A-SIDE 13, J1 + 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
BMI270 ADDRESS STRAP - FIT ONE ONLY R118 0R TO GND FITTED -> 0x68 (DEFAULT) R119 0R TO +3V3 DNP -> 0x69 (REWORK) NEVER FIT BOTH: THAT SHORTS +3V3 TO GND. 0x68 IS THE MOST COLLISION-PRONE ADDRESS ON A COMMUNITY I2C BUS (MPU6050, ICM-20948, DS3231). THIS PAIR IS THE NO-RESPIN ESCAPE UNDER D-049. IT R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
BMI270 STRAP AUDIT - BST-BMI270-DS000-08 REV 1.6 PIN 1 SDO -> GND VIA R118 = 0x68 PIN 12 CSB -> VDDIO = I2C MODE. BOSCH: HARD-WIRE THE CSB LINE TO VDDIO. PIN 2 ASDx -> VDDIO | SECONDARY I/F UNUSED. PIN 3 ASCx -> VDDIO | BOSCH: DO NOT CONNECT | TO GND. PIN 9 INT2 -> DNC = BOSCH INSTRUCTION PIN 10 OC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
