aqroot8/aqroot/hardware/demo/kicad/aqroot-demo/aqroot-Beta-v2.kicad_pcb

## KiCad design hardware/demo/kicad/aqroot-demo/aqroot-Beta-v2.kicad_pcb (continued)

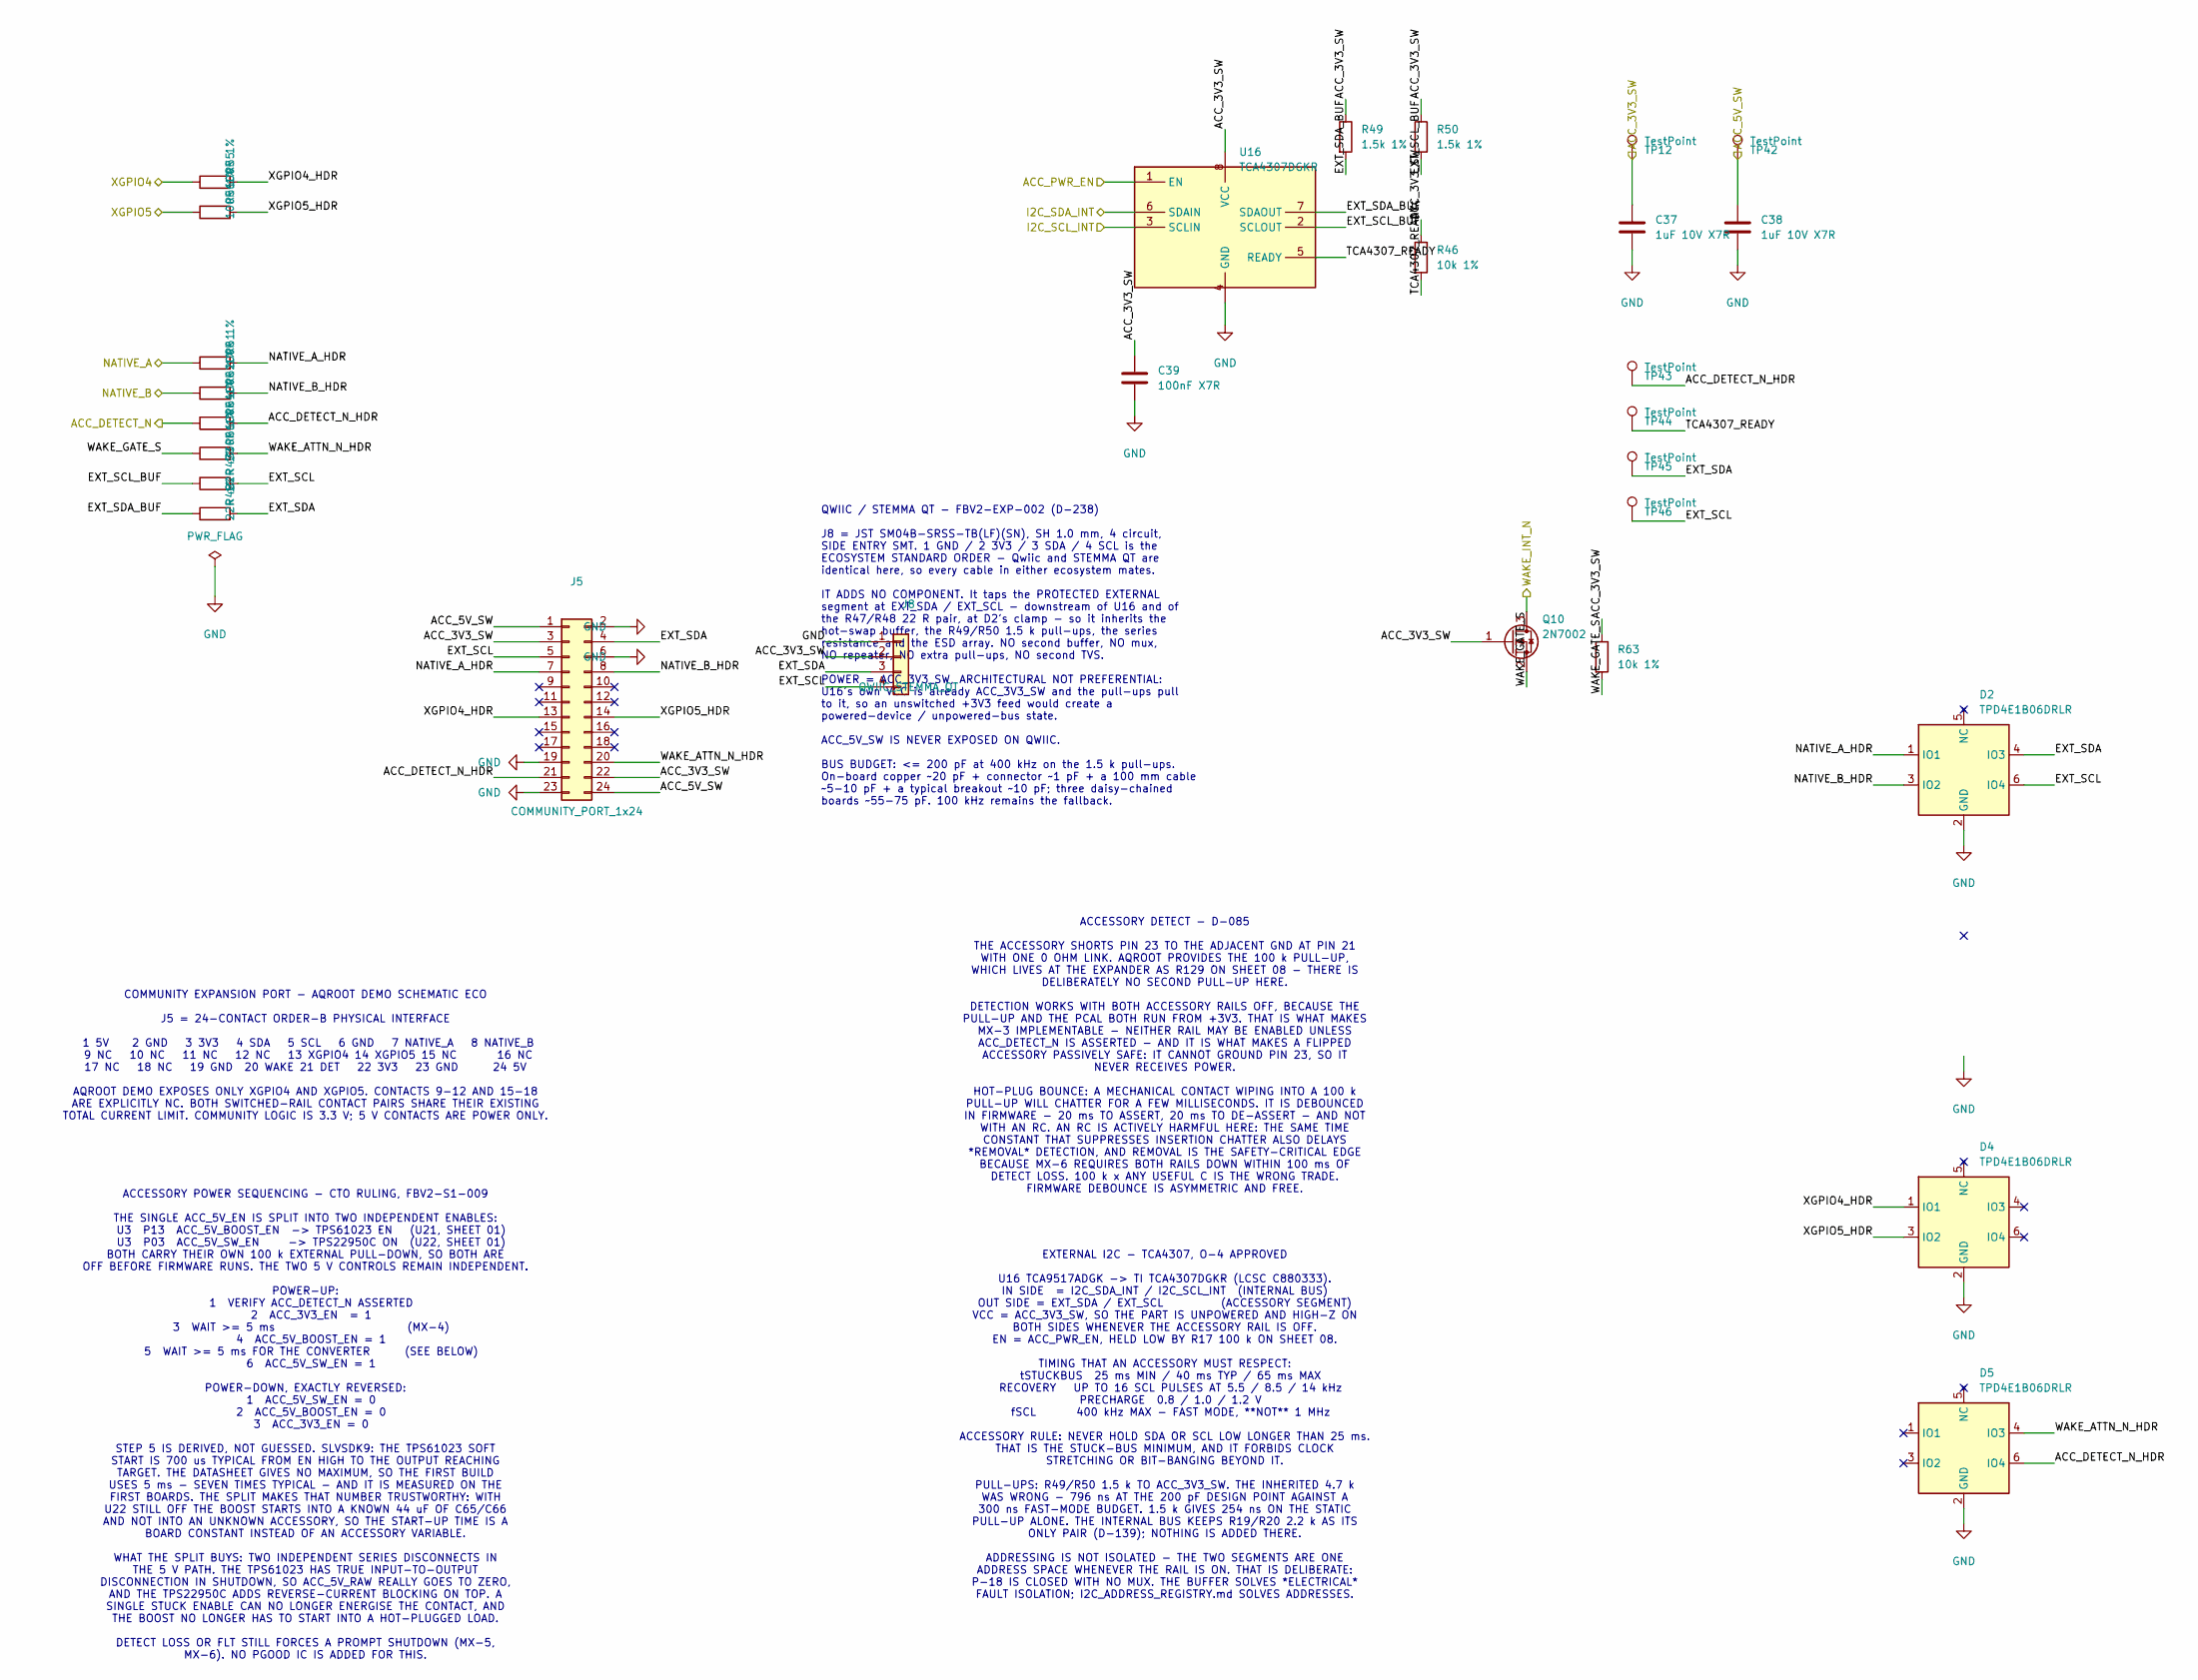
[picture p19: schematic 09_community_header.kicad_sch]

Parts:
C37, C38: 1uF 10V X7R; C_0603_1608Metric; MPN CC0603KRX7R8BB105; LCSC C106858
C39: 100nF X7R; C_0603_1608Metric; MPN CC0603KRX7R9BB104; LCSC C14663
D2, D4, D5: TPD4E1B06DRLR; SOT-563; MPN TPD4E1B06DRLR; LCSC C1972953
J5: COMMUNITY_PORT_1x24; Samtec_SSQ-124-02-G-S-RA; MPN BCS-112-S-D-HE; LCSC C5575816
J8: QWIIC_STEMMA_QT; JST_SH_SM04B-SRSS-TB_1x04-1MP_P1.00mm_Horizontal; MPN SM04B-SRSS-TB(LF)(SN); LCSC C160404
Q10: 2N7002; SOT-23; MPN 2N7002; LCSC C8545
R46, R63: 10k 1%; R_0603_1608Metric; Tolerance 1%; MPN 0603WAF1002T5E; LCSC C25804
R47, R48: 22R 1%; R_0603_1608Metric; Tolerance 1%; MPN 0603WAF220JT5E; LCSC C23345
R49, R50: 1.5k 1%; R_0603_1608Metric; Tolerance 1%; MPN 0603WAF1501T5E; LCSC C22843
R55, R56, R61, R62, R64: 100R 1%; R_0603_1608Metric; Tolerance 1%; MPN 0603WAF1000T5E; LCSC C22775
R66: 330R 1%; R_0603_1608Metric; Tolerance 1%; MPN 0603WAF3300T5E; LCSC C23138
TP12, TP42, TP43, TP44, TP45, TP46: TestPoint; TestPoint_Pad_D1.0mm
U16: TCA4307DGKR; VSSOP-8_3x3mm_P0.65mm; MPN TCA4307DGKR; LCSC C880333

Connections:
/09_COMMUNITY_HEADER/ACC_DETECT_N_HDR: D5.6 (IO4), J5.21, R64.2, TP43.1
/09_COMMUNITY_HEADER/EXT_SCL: D2.6 (IO4), J5.5, J8.4, R47.2, TP46.1
/09_COMMUNITY_HEADER/EXT_SCL_BUF: R47.1, R50.2, U16.2 (SCLOUT)
/09_COMMUNITY_HEADER/EXT_SDA: D2.4 (IO3), J5.4, J8.3, R48.2, TP45.1
/09_COMMUNITY_HEADER/EXT_SDA_BUF: R48.1, R49.2, U16.7 (SDAOUT)
/09_COMMUNITY_HEADER/NATIVE_A_HDR: D2.1 (IO1), J5.7, R61.2
/09_COMMUNITY_HEADER/NATIVE_B_HDR: D2.3 (IO2), J5.8, R62.2
/09_COMMUNITY_HEADER/TCA4307_READY: R46.2, TP44.1, U16.5 (READY)
/09_COMMUNITY_HEADER/WAKE_ATTN_N_HDR: D5.4 (IO3), J5.20, R66.2
/09_COMMUNITY_HEADER/WAKE_GATE_S: Q10.2 (S), R63.2, R66.1
/09_COMMUNITY_HEADER/XGPIO4_HDR: D4.1 (IO1), J5.13, R55.2
/09_COMMUNITY_HEADER/XGPIO5_HDR: D4.3 (IO2), J5.14, R56.2
/ACC_3V3_SW: C37.1, C39.1, J5.3, J5.22, J8.2, Q10.1 (G), R46.1, R49.1, R50.1, R63.1, TP12.1, U16.8 (VCC); also elsewhere on the board
/ACC_5V_SW: C38.1, J5.1, J5.24, TP42.1; also elsewhere on the board
/ACC_DETECT_N: R64.1; also elsewhere on the board
/ACC_PWR_EN: U16.1 (EN); also elsewhere on the board
/I2C_SCL_INT: U16.3 (SCLIN); also elsewhere on the board
/I2C_SDA_INT: U16.6 (SDAIN); also elsewhere on the board
/NATIVE_A: R61.1; also elsewhere on the board
/NATIVE_B: R62.1; also elsewhere on the board
/WAKE_INT_N: Q10.3 (D); also elsewhere on the board
/XGPIO4: R55.1; also elsewhere on the board
/XGPIO5: R56.1; also elsewhere on the board
GND: C37.2, C38.2, C39.2, D2.2 (GND), D4.2 (GND), D5.2 (GND), J5.2, J5.6, J5.19, J5.23, J8.1, U16.4 (GND); also elsewhere on the board

Notes on the sheet:
COMMUNITY EXPANSION PORT - AQROOT DEMO SCHEMATIC ECO J5 = 24-CONTACT ORDER-B PHYSICAL INTERFACE 1 5V 2 GND 3 3V3 4 SDA 5 SCL 6 GND 7 NATIVE_A 8 NATIVE_B 9 NC 10 NC 11 NC 12 NC 13 XGPIO4 14 XGPIO5 15 NC 16 NC 17 NC 18 NC 19 GND 20 WAKE 21 DET 22 3V3 23 GND 24 5V AQROOT DEMO EXPOSES ONLY XGPIO4 AND X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
ACCESSORY DETECT - D-085 THE ACCESSORY SHORTS PIN 23 TO THE ADJACENT GND AT PIN 21 WITH ONE 0 OHM LINK. AQROOT PROVIDES THE 100 k PULL-UP, WHICH LIVES AT THE EXPANDER AS R129 ON SHEET 08 - THERE IS DELIBERATELY NO SECOND PULL-UP HERE. DETECTION WORKS WITH BOTH ACCESSORY RAILS OFF, BECAUSE THE PULL-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
ACCESSORY POWER SEQUENCING - CTO RULING, FBV2-S1-009 THE SINGLE ACC_5V_EN IS SPLIT INTO TWO INDEPENDENT ENABLES: U3 P13 ACC_5V_BOOST_EN -> TPS61023 EN (U21, SHEET 01) U3 P03 ACC_5V_SW_EN -> TPS22950C ON (U22, SHEET 01) BOTH CARRY THEIR OWN 100 k EXTERNAL PULL-DOWN, SO BOTH ARE OFF BEFORE FIRMWARE R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
EXTERNAL I2C - TCA4307, O-4 APPROVED U16 TCA9517ADGK -> TI TCA4307DGKR (LCSC C880333). IN SIDE = I2C_SDA_INT / I2C_SCL_INT (INTERNAL BUS) OUT SIDE = EXT_SDA / EXT_SCL (ACCESSORY SEGMENT) VCC = ACC_3V3_SW, SO THE PART IS UNPOWERED AND HIGH-Z ON BOTH SIDES WHENEVER THE ACCESSORY RAIL IS OFF. EN = ACC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
QWIIC / STEMMA QT - FBV2-EXP-002 (D-238) J8 = JST SM04B-SRSS-TB(LF)(SN), SH 1.0 mm, 4 circuit, SIDE ENTRY SMT. 1 GND / 2 3V3 / 3 SDA / 4 SCL is the ECOSYSTEM STANDARD ORDER - Qwiic and STEMMA QT are identical here, so every cable in either ecosystem mates. IT ADDS NO COMPONENT. It taps the PROTECTE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

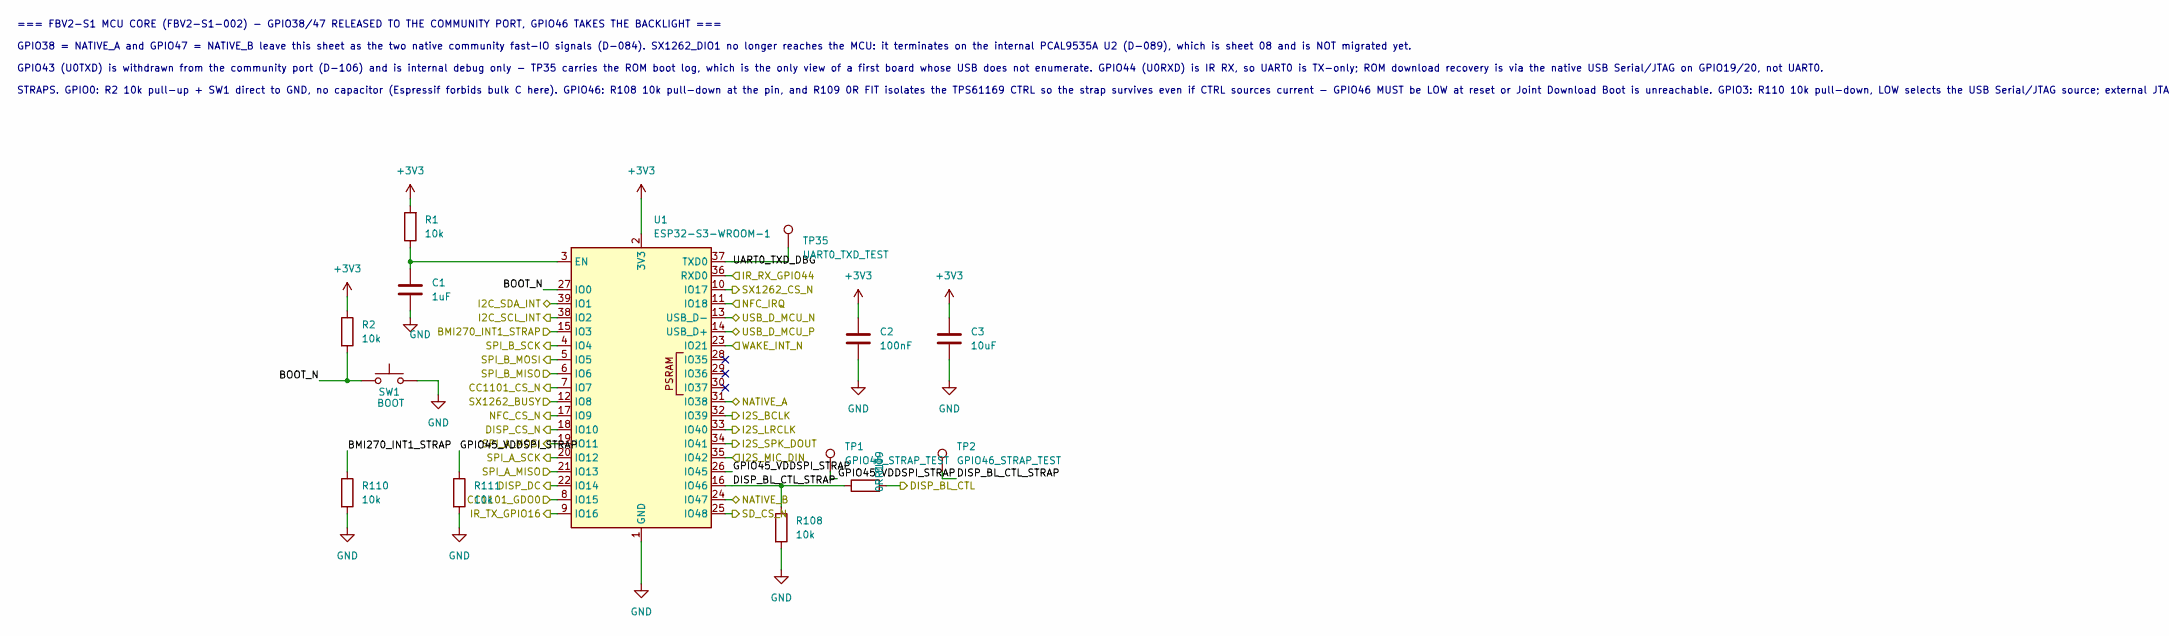
[picture p20: schematic 02_mcu_core.kicad_sch, part in row 1, column 1]

Parts:
C1: 1uF; C_0603_1608Metric; MPN CL10A105KB8NNNC; LCSC C15849
C2: 100nF; C_0603_1608Metric; MPN CC0603KRX7R9BB104; LCSC C14663
C3: 10uF; C_0805_2012Metric; MPN GRM21BR61H106KE43L; LCSC C440198
R1, R2, R108, R110, R111: 10k; R_0603_1608Metric; MPN 0603WAF1002T5E; LCSC C25804
R109: 0R FIT; R_0603_1608Metric; MPN 0603WAF0000T5E; LCSC C21189
SW1: BOOT; SW_SPST_PTS645Sx43SMTR92; MPN PTS645SM43SMTR92LFS; LCSC C221880
TP1: GPIO45_STRAP_TEST; TestPoint_Pad_D1.0mm
TP2: GPIO46_STRAP_TEST; TestPoint_Pad_D1.0mm
TP35: UART0_TXD_TEST; TestPoint_Pad_D1.0mm
U1: ESP32-S3-WROOM-1; MPN ESP32-S3-WROOM-1-N16R8; LCSC C2913202

Connections:
+3V3: C2.1, C3.1, R1.2, R2.1, U1.2 (3V3); also elsewhere on the board
/02_MCU_CORE/BOOT_N: R2.2, SW1.1, U1.27 (IO0)
/02_MCU_CORE/DISP_BL_CTL_STRAP: R108.1, R109.1, TP2.1, U1.16 (IO46)
/02_MCU_CORE/GPIO45_VDDSPI_STRAP: R111.1, TP1.1, U1.26 (IO45)
/02_MCU_CORE/UART0_TXD_DBG: TP35.1, U1.37 (TXD0)
/BMI270_INT1_STRAP: R110.1, U1.15 (IO3); also elsewhere on the board
/CC1101_CS_N: U1.7 (IO7); also elsewhere on the board
/CC1101_GDO0: U1.8 (IO15); also elsewhere on the board
/DISP_BL_CTL: R109.2; also elsewhere on the board
/DISP_CS_N: U1.18 (IO10); also elsewhere on the board
/DISP_DC: U1.22 (IO14); also elsewhere on the board
/I2C_SCL_INT: U1.38 (IO2); also elsewhere on the board
/I2C_SDA_INT: U1.39 (IO1); also elsewhere on the board
/I2S_BCLK: U1.32 (IO39); also elsewhere on the board
/I2S_LRCLK: U1.33 (IO40); also elsewhere on the board
/I2S_MIC_DIN: U1.35 (IO42); also elsewhere on the board
/I2S_SPK_DOUT: U1.34 (IO41); also elsewhere on the board
/IR_RX_GPIO44: U1.36 (RXD0); also elsewhere on the board
/IR_TX_GPIO16: U1.9 (IO16); also elsewhere on the board
/NATIVE_A: U1.31 (IO38); also elsewhere on the board
/NATIVE_B: U1.24 (IO47); also elsewhere on the board
/NFC_CS_N: U1.17 (IO9); also elsewhere on the board
/NFC_IRQ: U1.11 (IO18); also elsewhere on the board
/SD_CS_N: U1.25 (IO48); also elsewhere on the board
/SPI_A_MISO: U1.21 (IO13); also elsewhere on the board
/SPI_A_MOSI: U1.19 (IO11); also elsewhere on the board
/SPI_A_SCK: U1.20 (IO12); also elsewhere on the board
/SPI_B_MISO: U1.6 (IO6); also elsewhere on the board
/SPI_B_MOSI: U1.5 (IO5); also elsewhere on the board
/SPI_B_SCK: U1.4 (IO4); also elsewhere on the board
/SX1262_BUSY: U1.12 (IO8); also elsewhere on the board
/SX1262_CS_N: U1.10 (IO17); also elsewhere on the board
/USB_D_MCU_N: U1.13 (USB_D-); also elsewhere on the board
/USB_D_MCU_P: U1.14 (USB_D+); also elsewhere on the board
/WAKE_INT_N: U1.23 (IO21); also elsewhere on the board
GND: C1.1, C2.2, C3.2, R108.2, R110.2, R111.2, SW1.2, U1.1 (GND), U1.40 (GND), U1.41 (GND); also elsewhere on the board
unnamed: C1.2, R1.1, U1.3 (EN)

Notes on the sheet:
=== FBV2-S1 MCU CORE (FBV2-S1-002) - GPIO38/47 RELEASED TO THE COMMUNITY PORT, GPIO46 TAKES THE BACKLIGHT ===
GPIO38 = NATIVE_A and GPIO47 = NATIVE_B leave this sheet as the two native community fast-IO signals (D-084). SX1262_DIO1 no longer reaches the MCU: it terminates on the internal PCAL9535A U2 (D-089), which is sheet 08 and is NOT migrated yet.
GPIO43 (U0TXD) is withdrawn from the community port (D-106) and is internal debug only - TP35 carries the ROM boot log, which is the only view of a first board whose USB does not enumerate. GPIO44 (U0RXD) is IR RX, so UART0 is TX-only; ROM download recovery is via the native USB Serial/JTAG on GPIO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
STRAPS. GPIO0: R2 10k pull-up + SW1 direct to GND, no capacitor (Espressif forbids bulk C here). GPIO46: R108 10k pull-down at the pin, and R109 0R FIT isolates the TPS61169 CTRL so the strap survives even if CTRL sources current - GPIO46 MUST be LOW at reset or Joint Download Boot is unreachable. 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

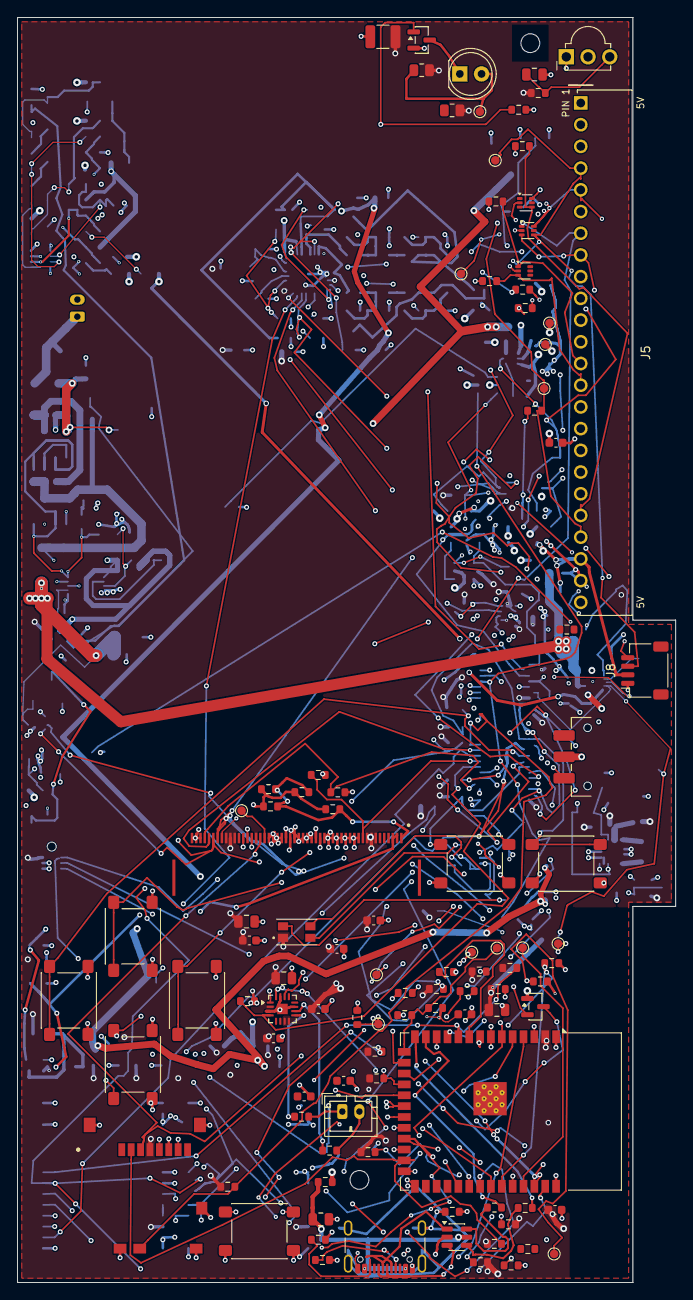
[picture p21: board aqroot-Beta-v2.kicad_pcb from above]

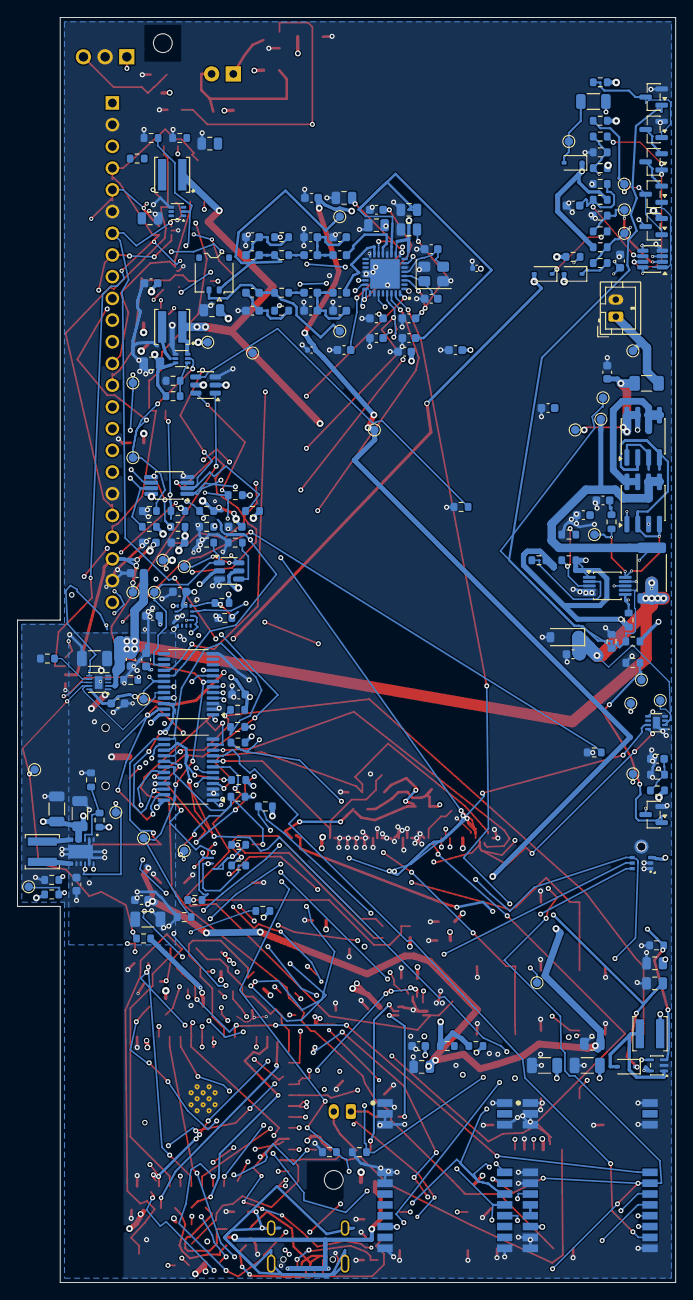
[picture p22: board aqroot-Beta-v2.kicad_pcb from below]

Board: 6 copper layers, 77.0 x 148.0 mm, 309 parts (205 on the bottom side), 175 nets.

Other parts of the board:
BOSS1, BOSS2: M2; MountingBoss_M2_NPTH
