aqroot8/aqroot/hardware/beta-v2/checks/incremental_router.py

# -*- coding: utf-8 -*-
"""FBV2-P2-006 -- REUSABLE INCREMENTAL REST-OF-BOARD ROUTER + PROMOTER.

The battery-block driver (route_battery_block.py) is power-tree scoped and the
in-repo "Phase B" replay machinery (replay_battery_block.py / SECTION-17) assumes
a copper-EMPTY authoritative base, so neither can add the 164 remaining
rest-of-board multi-pad nets onto the D-302 promoted board (see D-303 /
phaseB_bringup_probe_005.py).  This module is the missing piece: it routes a
bounded, named net-GROUP onto the promoted authoritative board **without ever
deleting, moving or re-routing a single strand of accepted Phase-A copper**, and
promotes the result only when a real full-board gate proves a genuine
no-casualty / no-new-DRC connectivity increment.

Design invariants (all enforced, not assumed):

  * PRESERVE PHASE-A EXACTLY.  QBoard loads the authoritative board and treats
    every existing track/via/pad/keep-out as an obstacle; new copper is ADDED
    (never Remove()d), so the accepted 432 tracks / 54 vias are carried through
    byte/geometry-equivalent.  The gate re-proves this as a copper-item multiset
    superset check -- if any Phase-A item is missing or altered, GATE FAIL.

  * ADD-ONLY, IN-SCOPE.  Every new copper item must belong to a net in the
    requested group.  New copper on any other net -> GATE FAIL.

  * REAL FULL-BOARD GATE (D-286).  Connectivity is judged by pcbnew connectivity
    on the whole board; legality by real kicad-cli DRC on the whole board.  No
    proxy / focused / post-hoc measurement promotes copper.

  * MONOTONIC.  Ratsnest and DRC unconnected_items must strictly DROP by exactly
    the requested connection count; no other DRC class may appear or increase;
    every prior Phase-A requested-connected pad pair must remain connected.

Commands (run one foreground experiment at a time):

    python3 incremental_router.py baseline
    python3 incremental_router.py route   FRONT_RGB
    python3 incremental_router.py gate     FRONT_RGB
    python3 incremental_router.py promote  FRONT_RGB     # only if gate PASS

`route` writes a scratch copy under checks/w/INC_<GROUP>/ and NEVER touches the
authoritative project.  `promote` copies that scratch board + a merged journal
back onto the authoritative project, but only after re-running the full gate.
"""
import os, sys, json, math, hashlib, shutil, collections
import numpy as np
SP = os.path.dirname(os.path.abspath(__file__))
sys.path.insert(0, SP)
import path_role_util as RU
import qrouter as QR
import pcbnew

AUTH = os.path.join(RU.AUTH_DIR, RU.PCBNAME)
JOURNAL = os.path.join(SP, 'phaseA_journal.json')
WORK = os.path.join(SP, 'w')
BASELINE_JSON = os.path.join(SP, 'incremental_baseline_006.json')
WALLS_JSON = os.path.join(SP, 'routing_walls.json')

# --------------------------------------------------------------------------- #
# GROUP REGISTRY.  A group is a bounded, isolated set of rest-of-board nets that
# is routed and gated as one increment.  Widths/clearances are the KiCad
# netclass floors the DRC enforces (FRONT_RGB nets are unmatched by any
# netclass pattern -> Default: 0.200 mm width, 0.200 mm clearance, no via).
GROUPS = {
    'FRONT_RGB': dict(
        sheet='08_BUTTONS_EXPANDERS',
        desc='front-panel RGB status-LED control lines (U23 expander -> R124/125/126); '
             'noncritical low-speed indicator nets, all B.Cu SMD, no via',
        layer='B', width=200000, clr_pad=200000, clr_trk=200000,
        nets=['FRONT_RGB_R_N', 'FRONT_RGB_G_N', 'FRONT_RGB_B_N'],
    ),
    # FBV2-P2-007 / D-305 -- accelerometer 3V3 load-switch (U20) local control.
    # Two noncritical low-current control nets: the enable line ACC_3V3_EN
    # (driven from U3.15, pulled by R98, switched into U20.1, probed at TP26) and
    # the current-limit programming strap ACC_3V3_ILIM (set resistor R97 -> U20.4).
    # Both Default netclass (0.200 mm width/clearance, NO via), all B.Cu SMD; a
    # coherent standalone power-gating control subsystem in a low-congestion
    # region (only 4 Phase-A B.Cu strands within bbox+2 mm).  ACC_3V3_EN is a
    # 4-pad multi-terminal net (3-edge MST) -- the first promoted increment to
    # exercise multi-segment MST routing.
    'ACC_3V3_CTL': dict(
        sheet='01_POWER_TREE',
        desc='accelerometer 3V3 load-switch (U20) local control: enable '
             '(U3.15 -> R98/U20.1/TP26) + current-limit set (R97 -> U20.4); '
             'noncritical low-current control, all B.Cu SMD, no via',
        layer='B', width=200000, clr_pad=200000, clr_trk=200000,
        nets=['ACC_3V3_EN', 'ACC_3V3_ILIM'],
    ),
    # FBV2-P2-008 / D-306 -- display reset control DISP_RST_N.  A single 3-pad
    # noncritical low-speed reset line whose pads DO NOT all share one layer:
    # R16.1 and J1.10 are F.Cu SMD, U2.8 is B.Cu SMD.  Its MST therefore has one
    # SAME-LAYER edge (R16.1<->J1.10, a pure F.Cu run -- the FIRST incremental
    # F.Cu route) and one CROSS-LAYER edge (J1.10<->U2.8, which must transition
    # F<->B through ONE board-legal through via -- the FIRST incremental via /
    # mixed-layer route).  The via is the Default netclass geometry the KiCad
    # DRC enforces here: 0.60 mm diameter / 0.30 mm drill (>= the 0.50 mm
    # min_via_diameter and 0.30 mm floor; NOT a microvia, not a POFV).  Widths
    # and clearances are the Default netclass floor (0.200 mm).  Low congestion:
    # only 2 accepted Phase-A copper items lie within the group bbox+2 mm.
    'DISP_RST': dict(
        sheet='03_SPI_A_DISPLAY_SD',
        desc='display reset DISP_RST_N (R16.1/J1.10 F.Cu, U2.8 B.Cu); '
             'noncritical low-speed reset line -- first incremental F.Cu run '
             '(R16.1<->J1.10) + first incremental cross-layer through via '
             '(J1.10<->U2.8, 0.60/0.30 Default netclass), no other via',
        layer='F', width=200000, clr_pad=200000, clr_trk=200000,
        via_dia=600000, via_drill=300000,
        nets=['DISP_RST_N'],
    ),
    # FBV2-P2-009 / D-307 -- BQ25185 charger current-program strap PAIR.  Two
    # coherent same-chip (U11) low-current programming straps: ILIM_VSET (input
    # current-limit set resistor R36 -> U11.7) and ISET (charge-current set
    # resistor R37 -> U11.8).  Both Default netclass (0.200 mm width/clearance,
    # NO via), all B.Cu SMD, adjacent U11 east-edge pins -- a single coherent
    # charger-programming control cluster.  The region is congested (BQ25185 /
    # BPP trunk), so promotion is decided by the real full-board gate, not by
    # geometry alone.  Same-layer B.Cu mechanics (D-304/D-305) reused byte-for-
    # byte: no via, no plane re-pour.
    'U11_PROG': dict(
        sheet='01_POWER_TREE',
        desc='BQ25185 charger current-program straps: input-current-limit set '
             '(R36 -> U11.7 ILIM_VSET) + charge-current set (R37 -> U11.8 ISET); '
             'coherent same-chip low-current control, all B.Cu SMD, no via',
        layer='B', width=200000, clr_pad=200000, clr_trk=200000,
        nets=['ILIM_VSET', 'ISET'],
    ),
    # FBV2-P2-009 fallback A -- west power-status sense pair: USB VBUS-present
    # divider (R104/R105/C68/TP31 VBUS_PRESENT) + MAX17048 fuel-gauge alert
    # (U14.5 -> TP11 MAX17048_ALRT_N).  Both Default netclass, all B.Cu SMD, no
    # via, tight far-west power-input corner.
    'PWR_SENSE': dict(
        sheet='01_POWER_TREE',
        desc='west power-status sense: USB VBUS-present divider (VBUS_PRESENT) + '
             'MAX17048 fuel-gauge alert (MAX17048_ALRT_N); low-current status '
             'sense, all B.Cu SMD, no via',
        layer='B', width=200000, clr_pad=200000, clr_trk=200000,
        nets=['VBUS_PRESENT', 'MAX17048_ALRT_N'],
    ),
    # FBV2-P2-009 fallback B -- BMI270 IMU I2C address-select strap (U4/R118/
    # R119), a 3-pad B.Cu multi-terminal net, measured PRISTINE (0 accepted
    # copper within bbox+2mm).  Default netclass, no via.  The held clean
    # singleton fallback (favored IMU/I2C-local example).
    'IMU_ADDR': dict(
        sheet='05_I2C_DEVICES',
        desc='BMI270 IMU I2C address-select strap (R118/R119 -> U4.1 '
             'BMI270_SDO_ADDR); noncritical low-speed strap, all B.Cu SMD, no via',
        layer='B', width=200000, clr_pad=200000, clr_trk=200000,
        nets=['BMI270_SDO_ADDR'],
    ),
    # FBV2-P2-010 / D-308 -- FRONT-PANEL RGB STATUS-INDICATOR COMPLETION.  D-304
    # (FRONT_RGB) routed the expander->resistor side of the front-panel RGB
    # status LED (U23 PCAL9535A GPIO -> R124/R125/R126 series limit resistors,
    # all B.Cu).  This group closes the SAME indicator on the LED-cathode side:
    # each series resistor's far pad (R124.2/R125.2/R126.2, B.Cu SMD) to the
    # matching cathode of D13 (MHPA3528RGBCT common-anode RGB LED, F.Cu SMD).
    # The three nets are Net-(D13-RK) (R124->D13.4 red), Net-(D13-GK)
    # (R125->D13.3 green), Net-(D13-BK) (R126->D13.2 blue).  Each is a 2-pad
    # CROSS-LAYER net (resistor B.Cu, LED F.Cu) so each closes with exactly ONE
    # board-legal Default through via (0.60/0.30) -- the SAME single-via-per-edge
    # mechanic proven at D-306, now applied THREE times in one increment (the
    # first MULTI-VIA increment; connect_cross is NOT changed, refill_planes
    # re-pours In1/In4 once for all three barrels).  Low current (R-limited
    # 2-6 mA status indicator, non-switching), low congestion (6-11 accepted
    # copper items per net bbox+2mm), a coherent local peripheral cluster that
    # directly extends an already-accepted increment.
    'FRONT_RGB_LED': dict(
        sheet='08_BUTTONS_EXPANDERS',
        desc='front-panel RGB status-LED cathode completion (R124/R125/R126 B.Cu '
             '-> D13 MHPA3528 cathodes F.Cu); closes the D-304 FRONT_RGB '
             'indicator on the LED side; low-current non-switching indicator, '
             'three cross-layer nets each one 0.60/0.30 Default through via',
        layer='F', width=200000, clr_pad=200000, clr_trk=200000,
        via_dia=600000, via_drill=300000,
        nets=['Net-(D13-RK)', 'Net-(D13-GK)', 'Net-(D13-BK)'],
    ),
    # FBV2-P2-011 / D-309 candidate PRIMARY -- IR receiver local supply.
    # IR_RX_VS_LOCAL is the RC-filtered local supply node for the IR demodulator
    # U6 (07_IR): series filter R21.2 (F.Cu SMD) + decoupling C11.1 (F.Cu SMD) ->
    # U6.3 supply pin (THT, on BOTH faces).  All three pads share the F.Cu outer
    # layer (U6.3 is THT so F.Cu is available), so every MST edge is a SAME-LAYER
    # F.Cu run with NO via.  A tight NE-corner cluster (span ~10x4 mm), measured
    # PRISTINE (0 accepted copper within bbox+2 mm).  A coherent standalone
    # peripheral supply-filter group -- noncritical low-current, not a bulk rail.
    'IR_RX_VS': dict(
        sheet='07_IR',
        desc='IR receiver (U6) local filtered supply IR_RX_VS_LOCAL '
             '(R21.2 series + C11.1 decoupling -> U6.3 THT supply); '
             'pristine NE-corner cluster, all F.Cu, no via',
        layer='F', width=200000, clr_pad=200000, clr_trk=200000,
        nets=['IR_RX_VS_LOCAL'],
    ),
    # FBV2-P2-011 candidate -- coherent display/touch-panel control subset.
    # TOUCH_RST_N (J1.47 F, R12.1 F, U2.4 B) + TOUCH_INT_N (J1.46 F, U2.19 B):
    # the capacitive touch panel reset + interrupt lines from the display FPC
    # connector J1 to the touch-controller interface U2.  Both are long
    # cross-board hauls (33-38 mm) that transition F<->B (U2 is B.Cu) so each
    # closes with a Default through via.  MEASURED (screen_010): moderate mid-
    # board congestion (cu 21/24) -- promotion decided by the real full-board
    # gate, not geometry.
    # ==> D-309 MEASURED FAIL under the via-blind default: the router laid
    #     geometric paths (route ALL OK) but the real full-board gate reported +3
    #     new `clearance` violations -- the TOUCH_RST_N via/track collide with the
    #     ACCEPTED D-306 DISP_RST_N through-via in the congested U2 B.Cu escape
    #     region (U2.4/.7/.8/.11 stack on U2's west edge; the DISP_RST_N via sits
    #     1.19 mm west of that column so a westward escape via lands on it).
    # ==> FBV2-P2-012 / D-310 RESOLVED: `via_offset` walks the F<->B transition a
    #     bounded 2.5 mm off the nearest congesting barrel via the existing-via-
    #     aware `_offset_via_site` (screen_012: TOUCH_RST_N via 5.10 mm from DISP,
    #     TOUCH_INT_N is on U2's EAST edge already 5.9-8.4 mm clear).  Both nets
    #     pass the real full-board gate -> PROMOTED as the display/touch pair.
    'TOUCH_CTL': dict(
        sheet='03_SPI_A_DISPLAY_SD',
        desc='display/touch control: touch reset TOUCH_RST_N (J1.47/R12.1 F -> '
             'U2.4 B) + touch interrupt TOUCH_INT_N (J1.46 F -> U2.19 B); '
             'noncritical low-speed control, cross-layer through vias with a '
             'bounded 2.5 mm U2-escape via-site offset',
        layer='F', width=200000, clr_pad=200000, clr_trk=200000,
        via_dia=600000, via_drill=300000, via_offset=2500000,
        nets=['TOUCH_RST_N', 'TOUCH_INT_N'],
    ),
    # FBV2-P2-011 candidate -- audio amplifier SD/mode strap.  AMP_SD_MODE
    # (R15.1 F, U5.4 F -> U2.7 B): the MAX98357 class-D amp SD/mode select strap
    # (a static logic-level strap, NOT the class-D output).  Cross-board haul to
    # U2 (~29 mm), one cross-layer edge -> one through via.  cu 57.
    # ==> D-309 MEASURED FAIL (NOT promoted): gate reported +7 `clearance` (via
    #     lands in the same congested U2 B.Cu escape beside DISP_RST_N; deferred
    #     to FBV2-P2-012 with the touch group).
    # ==> FBV2-P2-013 / D-311 RESOLVED: the U2 escape via-site offset proven at
    #     D-310 (TOUCH_CTL) applies unchanged.  Re-screened on the D-310 board
    #     (w/screen_013.py): the via-blind DEFAULT via is 0.100 mm from the
    #     DISP_RST_N barrel (CLASH, confirms D-309 +7); the bounded 2.5 mm offset
    #     walks the F<->B transition to (51.55,90.20) -> 1.760 mm to the nearest
    #     existing via (now the D-310 TOUCH_RST_N barrel) = CLEAR.  With
    #     via_offset the real full-board gate passes -> PROMOTED.
    'AMP_SD_MODE': dict(
        sheet='06_AUDIO',
        desc='audio amp SD/mode-select strap AMP_SD_MODE (R15.1/U5.4 F -> U2.7 B); '
             'static logic strap (not the class-D output), one cross-layer via '
             'with a bounded 2.5 mm U2-escape via-site offset',
        layer='F', width=200000, clr_pad=200000, clr_trk=200000,
        via_dia=600000, via_drill=300000, via_offset=2500000,
        nets=['AMP_SD_MODE'],
    ),
    # FBV2-P2-011 candidate -- microSD card-detect.  SD_CARD_DETECT_N
    # (J2.10 F, R113.2 F -> U2.11 B): the microSD socket J2 card-detect switch
    # line (noncritical low-speed) to U2.  Cross-board haul (~59 mm), one
    # cross-layer edge -> one through via.  cu 57.
    # ==> D-309 MEASURED FAIL (NOT promoted): gate reported +2 `clearance` (via
    #     lands in the same congested U2 B.Cu escape; deferred to FBV2-P2-012).
    # ==> FBV2-P2-013 / D-311 RESOLVED: the D-309 +2 was TRACK-threading, not the
    #     via (re-screened on the D-310 board, w/screen_013.py: even the DEFAULT
    #     via is 1.301 mm clear of every barrel).  The always-on existing-via
    #     injection (D-310) fixes the track threading; the bounded 2.5 mm offset
    #     walks the transition SOUTH to (53.00,82.55) -> 3.850 mm clear (extra
    #     margin).  With via_offset the real full-board gate passes.
    'SD_DETECT': dict(
        sheet='03_SPI_A_DISPLAY_SD',
        desc='microSD card-detect SD_CARD_DETECT_N (J2.10/R113.2 F -> U2.11 B); '
             'noncritical low-speed detect, one cross-layer via with a bounded '
             '2.5 mm U2-escape via-site offset',
        layer='F', width=200000, clr_pad=200000, clr_trk=200000,
        via_dia=600000, via_drill=300000, via_offset=2500000,
        nets=['SD_CARD_DETECT_N'],
    ),
    # ---------------------------------------------------------------------- #
    # FBV2-P2-015 -- XGPIO0..9 community-header GPIO long-haul bank.  Each
    # /XGPIOx is a 2-pad CROSS-LAYER net: the 100 R series resistor R5x.1 on
    # F.Cu (top resistor pack, y~17-36) -> the PCAL9535A U3 expander pin on
    # B.Cu (mid-board, y~74-80).  One MST edge, one F<->B through via each --
    # structurally identical to the U2 escape family, BUT the U3 escape goes
    # NORTH into open board (away from the U2 via cluster at y82-92), so the
    # READ-ONLY study (w/xgpio_study_015.py) measured every default via site
    # >=3.1 mm clear of every existing barrel and ZERO existing vias inside any
    # XGPIO routing bbox -- NO via_offset needed (unlike the U2 wall).  The one
    # real corridor risk the study found is INTER-XGPIO via crowding in the
    # shared north-of-U3 pocket (independent west-edge offset sites collide),
    # so the bank is routed as small adjacent pilots, member-by-member on
    # scratch + real full-board gate, never blindly as ten vias.  Netclass
    # Default (0.200/0.200, normal 0.60/0.30 via, In1.Cu forbidden -- the F/B
    # framework never touches In1).  These are the individually-screened
    # single-net entries; XGPIO_PILOT below is the combined transaction.
    'XGPIO8': dict(
        sheet='09_COMMUNITY_HEADER',
        desc='community GPIO8 series R59.1 F -> U3.13 B (east edge); '
             'noncritical 3V3 CMOS, one cross-layer through via',
        layer='F', width=200000, clr_pad=300000, clr_trk=300000,
        via_dia=600000, via_drill=300000, nets=['XGPIO8'],
    ),
    'XGPIO9': dict(
        sheet='09_COMMUNITY_HEADER',
        desc='community GPIO9 series R60.1 F -> U3.14 B (east edge); '
             'noncritical 3V3 CMOS, one cross-layer through via',
        layer='F', width=200000, clr_pad=300000, clr_trk=300000,
        via_dia=600000, via_drill=300000, nets=['XGPIO9'],
    ),
    'XGPIO7': dict(
        sheet='09_COMMUNITY_HEADER',
        desc='community GPIO7 series R58.1 F -> U3.11 B (west edge, northmost); '
             'noncritical 3V3 CMOS, one cross-layer through via',
        layer='F', width=200000, clr_pad=300000, clr_trk=300000,
        via_dia=600000, via_drill=300000, nets=['XGPIO7'],
    ),
    'XGPIO6': dict(
        sheet='09_COMMUNITY_HEADER',
        desc='community GPIO6 series R57.1 F -> U3.10 B (west edge); '
             'noncritical 3V3 CMOS, one cross-layer through via',
        layer='F', width=200000, clr_pad=300000, clr_trk=300000,
        via_dia=600000, via_drill=300000, nets=['XGPIO6'],
    ),
    'XGPIO5': dict(
        sheet='09_COMMUNITY_HEADER',
        desc='community GPIO5 series R56.1 F -> U3.9 B (west edge); '
             'noncritical 3V3 CMOS, one cross-layer through via',
        layer='F', width=200000, clr_pad=300000, clr_trk=300000,
        via_dia=600000, via_drill=300000, nets=['XGPIO5'],
    ),
    'XGPIO4': dict(
        sheet='09_COMMUNITY_HEADER',
        desc='community GPIO4 series R55.1 F -> U3.8 B (west edge); '
             'noncritical 3V3 CMOS, one cross-layer through via',
        layer='F', width=200000, clr_pad=300000, clr_trk=300000,
        via_dia=600000, via_drill=300000, nets=['XGPIO4'],
    ),
    # FBV2-P2-015 PILOT -- the credible coherent adjacent XGPIO subset chosen by
    # the corridor study (w/xgpio_study_015.py) and proven member-by-member on
    # the real full-board gate: XGPIO8 (R59.1 F -> U3.13 B) + XGPIO9 (R60.1 F ->
    # U3.14 B), the two EAST-edge community-GPIO nets on consecutive U3 pins.
    # Chosen over the west-edge members because the study measured the west nets'
    # cross-layer vias all crowding into one small pocket north of U3 (XGPIO6/7
    # picked the IDENTICAL site 55.55,76.15; 4/5 within 0.6 mm) -- an ordering-
    # sensitive shared-lane hazard -- whereas the east pair lands at (58.6,72.95)
    # and (58.45,75.65), 2.7 mm apart (2.1 mm copper gap), an independent legal
    # corridor.  All XGPIO nets need the D-269 0.300 mm clearance because the
    # 52.4 mm BAT_PROTECTED_P protected-battery F.Cu trunk sweeps diagonally
    # across the y~73-82 via-landing band (default 0.200 mm routing lands
    # 0.244-0.281 mm from it -> DRC clearance FAIL); routing the group at the
    # 0.300 mm D-269 floor is the correct clearance, NOT a new mechanism.  No
    # via_offset (every via site is >=3 mm clear of every existing barrel; the
    # U2-escape offset is not needed here).  Routed as ONE transaction: XGPIO8
    # first, then XGPIO9 sees XGPIO8's laid via and separates.
    'XGPIO_PILOT': dict(
        sheet='09_COMMUNITY_HEADER',
        desc='community GPIO east-edge pilot: XGPIO8 (R59.1 F -> U3.13 B) + '
             'XGPIO9 (R60.1 F -> U3.14 B); two adjacent 3V3 CMOS nets, each one '
             'cross-layer through via, routed at the D-269 0.300 mm clearance '
             'floor (BAT_PROTECTED_P trunk crosses the corridor), no via_offset',
        layer='F', width=200000, clr_pad=300000, clr_trk=300000,
        via_dia=600000, via_drill=300000, nets=['XGPIO8', 'XGPIO9'],
    ),
    # FBV2-P2-016 -- the two SOUTHERNMOST west members (individually-screened
    # single-net entries, mirroring XGPIO4..9).  R52.1 F -> U3.5 B and
    # R51.1 F -> U3.4 B; U3's southmost GPIO pins, furthest from the crowded
    # north-of-U3 XGPIO6/7 via pocket.
    'XGPIO1': dict(
        sheet='09_COMMUNITY_HEADER',
        desc='community GPIO1 series R52.1 F -> U3.5 B (west edge, south); '
             'noncritical 3V3 CMOS, one cross-layer through via',
        layer='F', width=200000, clr_pad=300000, clr_trk=300000,
        via_dia=600000, via_drill=300000, nets=['XGPIO1'],
    ),
    'XGPIO0': dict(
        sheet='09_COMMUNITY_HEADER',
        desc='community GPIO0 series R51.1 F -> U3.4 B (west edge, southmost); '
             'noncritical 3V3 CMOS, one cross-layer through via',
        layer='F', width=200000, clr_pad=300000, clr_trk=300000,
        via_dia=600000, via_drill=300000, nets=['XGPIO0'],
    ),
    # FBV2-P2-016 WEST PILOT -- the credible coherent adjacent WEST subset chosen
    # by the recovery screen (w/screen_016.py + w/screen_016_one.py, live D-313
    # board, D-269 0.300 mm, no via_offset).  XGPIO0 + XGPIO1, the two SOUTHERNMOST
    # west community-GPIO nets on consecutive PCAL9535A U3 pins (U3.4, U3.5).
    # Unlike the northern west members (XGPIO6/7 collide in one via pocket), the
    # southern pair SELF-SEPARATES when routed XGPIO1-first: the screen measured
    # XGPIO1's via lands in the pocket at (55.40,79.00) and XGPIO0 (routed second,
    # seeing XGPIO1's laid via as a real obstacle) escapes WEST to (52.75,78.35) --
    # via-via copper 2.129 mm, both vias >=2.0 mm from the BAT_PROTECTED_P trunk
    # and >=3.6 mm from every existing barrel, all >> the 0.300 mm D-269 floor
    # (CLEAN).  ORDER MATTERS: the reverse order (XGPIO0-first) boxes XGPIO1 out
    # (no legal 0.200 mm corridor from R52.1) -> route XGPIO1 FIRST.  Same D-269
    # 0.300 mm clearance as the east pilot (BAT_PROTECTED_P crosses the y~73-82
    # via band), no via_offset (every site is >=2 mm clear of every barrel).
    'XGPIO_PILOT_W': dict(
        sheet='09_COMMUNITY_HEADER',
        desc='community GPIO west-edge south pilot: XGPIO1 (R52.1 F -> U3.5 B) + '
             'XGPIO0 (R51.1 F -> U3.4 B); two adjacent 3V3 CMOS nets, each one '
             'cross-layer through via, routed XGPIO1-FIRST at the D-269 0.300 mm '
             'clearance floor (BAT_PROTECTED_P trunk crosses the corridor), no '
             'via_offset; XGPIO0 self-separates west off XGPIO1 laid via',
        layer='F', width=200000, clr_pad=300000, clr_trk=300000,
        via_dia=600000, via_drill=300000, nets=['XGPIO1', 'XGPIO0'],
    ),
    # ---------------------------------------------------------------------- #
    # FBV2-P2-018 / D-316 -- a SINGLE west XGPIO net at the 0.200 mm Default
    # clearance (NOT the 0.300 mm blanket the pilot pairs used).  D-315
    # characterised the XGPIO2+XGPIO3 adjacent PAIR as a corridor-capacity WALL
    # (both orders NO_FAR_RUN -- the now D-313+D-314-congested F.Cu corridor
    # admits ONE 116 mm haul, not two parallel ones) and produced the decisive
    # positive lead: a SINGLE west member routes CLEAN at 0.200 mm and keeps the
    # D-269 0.300 mm floor to the BAT_PROTECTED_P trunk WITH MARGIN, because the
    # west haul's natural path clears BPP by >=0.47 mm (unlike the D-313 EAST
    # pilot whose 0.200 mm haul pinched BPP to 0.244-0.281 mm and therefore
    # needed the 0.300 mm floor).  The 0.300 mm blanket is over-conservative for a
    # single west haul AND is exactly what saturates the corridor, so the correct
    # clearance here is the 0.200 mm Default with the real full-board D-269-aware
    # KiCad DRC arbitrating the BPP clearance (D-286 gate) -- NOT a new mechanism,
    # NOT rule weakening (nothing below any floor is accepted; D-269 is satisfied
    # by measured geometry).  Target = XGPIO3 (R54.1 F.Cu -> U3.7 B.Cu): the
    # D-315 record + the FBV2-P2-018 live re-screen measured its cross-layer via
    # at (55.300,77.700) with the MOST-separated existing-via clearance (exv
    # copper 0.704 mm) and haul->BPP 0.474 mm >= 0.300.  One net, one MST edge,
    # one 0.60/0.30 Default through via; no via_offset (the via site is clear of
    # every barrel); In1/In4 re-poured once for the single anti-pad.  Do NOT
    # bundle XGPIO2 (D-315: the pair is a measured wall -- route one at a time).
    'XGPIO3': dict(
        sheet='09_COMMUNITY_HEADER',
        desc='community GPIO3 series R54.1 F -> U3.7 B (west edge); single-net '
             '3V3 CMOS increment at the 0.200 mm Default clearance (the west haul '
             'clears BPP by >=0.47 mm so the D-269 0.300 mm floor is kept by '
             'geometry, arbitrated by the real full-board D-269-aware gate), one '
             'cross-layer through via, no via_offset',
        layer='F', width=200000, clr_pad=200000, clr_trk=200000,
        via_dia=600000, via_drill=300000, nets=['XGPIO3'],
    ),
    # FBV2-P2-033 / D-331 framework pilot: offload the saturated west XGPIO
    # outer-layer haul onto a routable inner SIGNAL layer. Each endpoint gets
    # one short escape on its native outer face and one ordinary 0.60/0.30
    # through via; the long low-speed CMOS run joins those reserved anchors on
    # In2 (fallback In3). Explicit opt-in only; high-current/wide nets excluded.
    'XGPIO2_INNER_PILOT': dict(
        sheet='09_COMMUNITY_HEADER',
        desc='community GPIO2 inner-layer long-haul framework pilot: R53.1 F.Cu '
             'to U3.6 B.Cu via two reserved outer escapes and an In2/In3 signal '
             'run; low-speed 3V3 CMOS only',
        layer='F', width=200000, clr_pad=200000, clr_trk=200000,
        via_dia=600000, via_drill=300000,
        inner_long_haul_plan=dict(a='R53.1', b='U3.6',
                                  a_near='F', b_near='B',
                                  inner=['I2', 'I3']),
        nets=['XGPIO2'],
    ),
    'XGPIO3_INNER': dict(
        sheet='09_COMMUNITY_HEADER', desc='XGPIO3 D-331 inner-haul reuse screen',
        layer='F', width=200000, clr_pad=200000, clr_trk=200000,
        via_dia=600000, via_drill=300000,
        inner_long_haul_plan=dict(a='R54.1', b='U3.7',
                                  a_near='F', b_near='B',
                                  inner=['I2', 'I3']),
        nets=['XGPIO3'],
    ),
    'XGPIO1_INNER': dict(
        sheet='09_COMMUNITY_HEADER', desc='XGPIO1 D-331 inner-haul reuse screen',
        layer='F', width=200000, clr_pad=200000, clr_trk=200000,
        via_dia=600000, via_drill=300000,
        inner_long_haul_plan=dict(a='R52.1', b='U3.5',
                                  a_near='F', b_near='B',
                                  inner=['I2', 'I3']),
        nets=['XGPIO1'],
    ),
    'XGPIO0_INNER': dict(
        sheet='09_COMMUNITY_HEADER', desc='XGPIO0 D-331 inner-haul reuse screen',
        layer='F', width=200000, clr_pad=200000, clr_trk=200000,
        via_dia=600000, via_drill=300000,
        inner_long_haul_plan=dict(a='R51.1', b='U3.4',
                                  a_near='F', b_near='B',
                                  inner=['I2', 'I3']),
        nets=['XGPIO0'],
    ),
    # D-331 framework-reuse screens and coherent batch.  Each member keeps a
    # native-face escape and selects In2 first / In3 fallback independently;
    # the batch is routed in this deterministic south-to-north order so laid
    # copper is a real obstacle for the following member.
    'XGPIO4_INNER': dict(
        sheet='09_COMMUNITY_HEADER', desc='XGPIO4 D-331 inner-haul reuse screen',
        layer='F', width=200000, clr_pad=200000, clr_trk=200000,
        via_dia=600000, via_drill=300000,
        inner_long_haul_plan=dict(a='R55.1', b='U3.8', a_near='F', b_near='B', inner=['I2', 'I3']),
        nets=['XGPIO4'],
    ),
    'XGPIO5_INNER': dict(
        sheet='09_COMMUNITY_HEADER', desc='XGPIO5 D-331 inner-haul reuse screen',
        layer='F', width=200000, clr_pad=200000, clr_trk=200000,
        via_dia=600000, via_drill=300000,
        inner_long_haul_plan=dict(a='R56.1', b='U3.9', a_near='F', b_near='B', inner=['I2', 'I3']),
        nets=['XGPIO5'],
    ),
    'XGPIO6_INNER': dict(
        sheet='09_COMMUNITY_HEADER', desc='XGPIO6 D-331 inner-haul reuse screen',
        layer='F', width=200000, clr_pad=200000, clr_trk=200000,
        via_dia=600000, via_drill=300000,
        inner_long_haul_plan=dict(a='R57.1', b='U3.10', a_near='F', b_near='B', inner=['I2', 'I3']),
        nets=['XGPIO6'],
    ),
    'XGPIO7_INNER': dict(
        sheet='09_COMMUNITY_HEADER', desc='XGPIO7 D-331 inner-haul reuse screen',
        layer='F', width=200000, clr_pad=200000, clr_trk=200000,
        via_dia=600000, via_drill=300000,
        inner_long_haul_plan=dict(a='R58.1', b='U3.11', a_near='F', b_near='B', inner=['I2', 'I3']),
        nets=['XGPIO7'],
    ),
    'XGPIO45_INNER_BATCH': dict(
        sheet='09_COMMUNITY_HEADER',
        desc='coherent D-331 inner-haul reuse batch for fast-screen survivors XGPIO4/5',
        layer='F', width=200000, clr_pad=200000, clr_trk=200000,
        via_dia=600000, via_drill=300000,
        inner_long_haul_plans={
            'XGPIO4': dict(a='R55.1', b='U3.8', a_near='F', b_near='B', inner=['I2', 'I3']),
            'XGPIO5': dict(a='R56.1', b='U3.9', a_near='F', b_near='B', inner=['I2', 'I3']),
        },
        nets=['XGPIO4', 'XGPIO5'],
    ),
    # ---------------------------------------------------------------------- #
    # FBV2-P2-020 / D-318 -- a single IMU/I2C-local interrupt-strap net, OUTSIDE
    # the saturated west-XGPIO F.Cu corridor (D-317 mandate).  BMI270_INT1_STRAP
    # is the MCU-side leg of the BMI270 IMU INT1 interrupt: series resistor far
    # pad R18.2 -> pull resistor R110.1 -> test point TP3.1 -> MCU GPIO U1.15,
    # ALL on F.Cu (U1 ESP32 pads are F.Cu SMD; R18/R110/TP3 F.Cu SMD).  A 4-pad
    # multi-terminal net whose MST is therefore three SAME-LAYER F.Cu runs with
    # NO via -- the cleanest incremental class (no plane re-pour, no via-clearance
    # risk), the same B.Cu-family mechanic proven at D-305/D-307 now on F.Cu.
    # Noncritical low-speed CMOS interrupt strap (NOT switching / rail / RF/NFC /
    # USB / bus-clock / community-header).  Default netclass (0.200 mm width/
    # clearance); measured span 12.1 mm, MST 17.2 mm, congestion 41 items within
    # bbox+2 mm (evidence: w/screen_020.py).  Promotion decided by the real
    # full-board gate (D-286), not geometry.
    'IMU_INT1_STRAP': dict(
        sheet='02_MCU_CORE',
        desc='BMI270 IMU INT1 interrupt strap MCU-side leg (R18.2/R110.1/TP3.1 '
             '-> U1.15 GPIO); noncritical low-speed CMOS interrupt, 4-pad '
             'multi-terminal, all F.Cu SMD, no via',
        layer='F', width=200000, clr_pad=200000, clr_trk=200000,
        nets=['BMI270_INT1_STRAP'],
    ),
    # ---------------------------------------------------------------------- #
    # FBV2-P2-021 / D-319 -- the debug-console UART TX line, a clean-functional
    # increment in an OPEN region (away from the west-XGPIO F.Cu corridor, the
    # U11/BQ25185 power-tree wall, RF/NFC/USB/crystals/switching/rails/community
    # mass).  UART0_TXD_DBG is the ESP32 (U1) UART0 transmit output brought out
    # to the debug test point: MCU pad U1.37 (F.Cu SMD) -> test point TP35.1
    # (F.Cu SMD).  A dedicated point-to-point 2-pad net (NOT a shared bus); both
    # pads on F.Cu so its single MST edge is a SAME-LAYER F.Cu run with NO via --
    # the cleanest incremental class (no plane re-pour, no via-clearance risk),
    # the same no-via same-layer mechanic proven at D-305/D-307/D-309/D-318.
    # Noncritical low-speed CMOS debug output (not switching / rail / RF/NFC /
    # USB / bus-clock / community-header).  Default netclass (0.200 mm width/
    # clearance).  MEASURED (w/vet_021.py on the live D-318 board): span/MST
    # 27.9 mm single edge, congestion 9 items within bbox+2 mm (lowest of the
    # genuinely-clean functional shortlist), and 31.3 mm clear of the
    # BAT_PROTECTED_P trunk -- ZERO D-269 involvement (unlike the rejected
    # BQ25185_STAT pair whose hauls run 0.024 mm from BPP through the power-tree
    # wall).  Promotion decided by the real full-board gate (D-286), not geometry.
    'UART0_TXD_DBG': dict(
        sheet='02_MCU_CORE',
        desc='debug-console UART0 transmit output UART0_TXD_DBG (U1.37 MCU -> '
             'TP35.1 test point); noncritical low-speed CMOS debug output, '
             'dedicated 2-pad point-to-point net, all F.Cu SMD, no via',
        layer='F', width=200000, clr_pad=200000, clr_trk=200000,
        nets=['UART0_TXD_DBG'],
    ),
    # ---------------------------------------------------------------------- #
    # FBV2-P2-022 / D-320 -- the IR transmit carrier CONTROL leg, a clean-
    # functional increment in an OPEN region (away from the west-XGPIO F.Cu
    # corridor, the U11/BQ25185 power-tree wall, RF/NFC/USB/crystals/switching/
    # rails/community mass).  IR_TX_GPIO16 is the MCU-side low-current control
    # leg of the IR transmit path: ESP32 (U1) GPIO16 pad U1.9 (F.Cu SMD) ->
    # series-drive resistor R22.1 (F.Cu SMD).  It is a DEDICATED 2-pad net that
    # is ISOLATED by the series resistor R22 from the switching output: R22.2
    # belongs to the SEPARATE net IR_GATE (Q1 gate / R23), and the IR-emitter
    # power path is IR_LED_A/IR_LED_K (D1/Q1 drain) -- both EXCLUDED as
    # switching/emitter nets and NOT part of this increment.  So this is exactly
    # the low-current MCU carrier/control GPIO, distinct from the emitter power
    # / switch path (the D-319 mandate's distinction).  Both pads on F.Cu so its
    # single MST edge is a SAME-LAYER F.Cu run with NO via -- the cleanest
    # incremental class (no plane re-pour, no via-clearance risk), the same
    # no-via same-layer mechanic proven at D-305/D-307/D-309/D-318/D-319.
    # Default netclass (0.200 mm width/clearance).  MEASURED (w/vet_021.py on the
    # live D-319 board): span/MST 8.35 mm single edge, congestion 38 (lowest of
    # the genuinely-clean functional shortlist), 35.2 mm clear of the
    # BAT_PROTECTED_P trunk -- ZERO D-269 involvement.  Promotion decided by the
    # real full-board gate (D-286), not geometry.
    'IR_TX_GPIO16': dict(
        sheet='07_IR',
        desc='IR transmit carrier control leg IR_TX_GPIO16 (U1.9 ESP32 GPIO16 '
             '-> R22.1 series-drive resistor); low-current MCU control GPIO, '
             'isolated by R22 from the IR_GATE switch node and IR_LED_A/K '
             'emitter power, dedicated 2-pad point-to-point net, all F.Cu SMD, '
             'no via',
        layer='F', width=200000, clr_pad=200000, clr_trk=200000,
        nets=['IR_TX_GPIO16'],
    ),
    # ---------------------------------------------------------------------- #
    # FBV2-P2-023 / D-321 -- the ESP32 MCU enable / power-on-reset network, a
    # clean-functional increment in an OPEN region (away from the west-XGPIO
    # F.Cu corridor, the U11/BQ25185 power-tree wall, RF/NFC/USB/crystals/
    # switching/rails/community mass).  Net-(U1-EN) is the MCU (U1) EN pin RC
    # reset network: U1.3 (EN, F.Cu SMD) + its pull-up resistor R1.1 (F.Cu SMD)
    # + its filter capacitor C1.2 (F.Cu SMD) to GND -- a genuine, complete,
    # coherent 3-pad functional net (the power-on-reset RC that holds EN low
    # through C1 and pulls it high through R1).  Chosen (FBV2-P2-023) as the
    # cleanest functional net of the remaining shortlist over RESERVED_SPARE (a
    # mere spare of lower merit -- not chosen when a meaningful control net is
    # equally clean) and over BOOT_N (a longer, more congested sensitive strap).
    # EN sensitivity is treated carefully: the net's OWN filter cap C1 sits on
    # this net AT the EN pin (so high-frequency coupling is shunted to GND right
    # at the pad), the placement is frozen, and the realized route is inspected
    # for USB_D_MCU_N spacing after routing -- the vet's 0.335 mm straight-line
    # proximity to USB_D_MCU_N is GUIDANCE only (the router detours; the real
    # D-286 full-board gate arbitrates legality).  All three pads on F.Cu, so
    # both MST edges are SAME-LAYER F.Cu runs with NO via -- the cleanest
    # incremental class (no through via, no In1/In4 plane re-pour, no via-
    # clearance risk; the D-305/D-307/D-309/D-318/D-319/D-320 no-via same-layer
    # mechanic).  Default netclass (0.200 mm width/clearance).  MEASURED
    # (w/vet_021.py on the live D-320 board): 3 pads, MST 7.81 mm (U1.3<->C1.2)
    # + 22.28 mm (U1.3<->R1.1), congestion 66 (lowest of the genuinely-clean
    # functional shortlist), 40.4 mm clear of the BAT_PROTECTED_P trunk -> ZERO
    # D-269 involvement.  Promotion decided by the real full-board gate (D-286),
    # not geometry.
    #
    # FBV2-P2-023 OUTCOME -- CHARACTERIZED LOCAL WALL, NOT PROMOTED.  On the live
    # D-320 board the natural MST short edge C1.2<->U1.3 (7.81 mm) has NO LEGAL
    # CORRIDOR at 0.200 mm (router NO_PATH even at the 0.05/0.025 mm fine grid):
    # the EN pin U1.3 sits in a dense pad pocket (U1 pin row + C1 + neighbouring
    # parts, with the D-320 IR_TX_GPIO16 detour copper 0.101 mm away on the
    # straight line), and the other edge U1.3<->R1.1 only routes with a 58.46 mm
    # detour (2.6x the 22.28 mm straight) -- a poor, long path for a reset line.
    # Combined with EN's reset-line sensitivity and the 0.335 mm straight-line
    # proximity to the USB_D_MCU_N diff pair, EN is NOT the clean pick its bbox
    # congestion (66) suggested; do NOT naively retry the natural MST.  D-321
    # instead promoted the meaningful functional SD_CS_N (which gates clean).
    'MCU_EN_RC': dict(
        sheet='(top)',
        desc='ESP32 MCU enable / power-on-reset RC network Net-(U1-EN) (U1.3 EN '
             '+ R1.1 pull-up + C1.2 filter cap); low-current MCU reset strap, '
             'dedicated 3-pad functional net, all F.Cu SMD, no via',
        layer='F', width=200000, clr_pad=200000, clr_trk=200000,
        nets=['Net-(U1-EN)'],
    ),
    # FBV2-P2-023 / D-321 -- SD_CS_N PROMOTED.  After MCU_EN_RC hit a
    # characterized local wall (above), the held functional alternates were
    # scratch-tested and gated: SD_CS_N = the microSD SPI chip-select control
    # (J2.2 socket + R25.2 + U1.25 MCU), a genuine functional POINT-TO-POINT
    # control (NOT a shared MOSI/MISO/CLK bus line -- the chip-select travels
    # with its own synchronous SPI-A bus, benign coupling), all three pads on
    # F.Cu -> both MST edges SAME-LAYER F.Cu runs with NO via (the cleanest
    # incremental class; no In1/In4 plane re-pour).  MEASURED (w/vet_021.py, live
    # D-320): 3-pad, MST 14.99 mm (U1.25<->R25.2) + 31.98 mm (U1.25<->J2.2),
    # 50.1 mm clear of BAT_PROTECTED_P -> ZERO D-269 involvement.  Routed ALL OK
    # (J2.2<->U1.25 48.42 mm + U1.25<->R25.2 21.08 mm, 20 F.Cu seg, 0 via) and
    # gated PASS on the real full-board D-286 gate (ratsnest 671->669 -2, no
    # new/worse DRC).  Chosen over RESERVED_SPARE per the mandate: prefer a
    # meaningful coherent functional net over an easy spare.  RESERVED_SPARE =
    # the reserved/spare community expander GPIO (R130.2 + TP41.1 test point +
    # U23.7 PCAL expander), all B.Cu -> no via; routed ALL OK on scratch (4.43 +
    # 10.94 mm, short/clean) and HELD as a clean alternate for a future
    # increment (a spare of lower merit, not promoted while a meaningful control
    # net gates clean).
    'SD_CS_N': dict(
        sheet='(top)',
        desc='microSD SPI chip-select SD_CS_N (J2.2 socket / R25.2 / U1.25 MCU); '
             'point-to-point control (not a shared SPI data/clock line), 3-pad '
             'all F.Cu SMD, no via',
        layer='F', width=200000, clr_pad=200000, clr_trk=200000,
        nets=['SD_CS_N'],
    ),
    'RESERVED_SPARE': dict(
        sheet='08_BUTTONS_EXPANDERS',
        desc='reserved/spare community expander GPIO RESERVED_SPARE (R130.2 / '
             'TP41.1 test point / U23.7 expander); 3-pad all B.Cu SMD, no via',
        layer='B', width=200000, clr_pad=200000, clr_trk=200000,
        nets=['RESERVED_SPARE'],
    ),
    # ---------------------------------------------------------------------- #
    # FBV2-P2-024 / D-322 -- the display SPI chip-select control DISP_CS_N, a
    # clean-functional increment in an OPEN region (away from the west-XGPIO
    # F.Cu corridor, the U11/BQ25185 power-tree wall, RF/NFC/USB/crystals/
    # switching/class-D/rails/community mass).  /DISP_CS_N is the display SPI-A
    # chip-select: MCU (U1) GPIO pad U1.18 (F.Cu SMD) -> series resistor R26.2
    # (F.Cu SMD) -> display FPC connector J1.38 (F.Cu SMD).  It is a genuine
    # functional POINT-TO-POINT control (NOT a shared MOSI/MISO/CLK data/clock
    # bus line -- the chip-select travels with its own synchronous SPI-A display
    # bus, benign coupling), the DIRECT display analog of the D-321 microSD
    # chip-select SD_CS_N.  Chosen (FBV2-P2-024) as the cleanest MEANINGFUL net
    # of the remaining shortlist over the RESERVED_SPARE spare (a mere spare of
    # lower merit -- not chosen when a meaningful control net is equally clean),
    # over BOOT_N (a boot-mode strap whose reset-level sensitivity is treated
    # carefully -- set aside), and over DISP_DC (equally meaningful but a single
    # 38.5 mm haul directly off the boxed MCU pin U1.22, no intermediate series
    # resistor).  DISP_CS_N's series resistor R26 sits 2.50 mm from U1.18, so
    # the MCU-side MST edge is a trivial short escape and the long 32.57 mm haul
    # originates from R26.2 in open area, NOT directly off the congested MCU pad
    # pocket (the D-321 MCU_EN_RC wall lesson).  All three pads on F.Cu, so both
    # MST edges are SAME-LAYER F.Cu runs with NO via -- the cleanest incremental
    # class (no through via, no In1/In4 plane re-pour, no via-clearance risk; the
    # D-305/D-307/D-309/D-318/D-319/D-320/D-321 no-via same-layer mechanic).
    # Default netclass (0.200 mm width/clearance).  MEASURED (w/vet_021.py on the
    # live D-321 board): 3 pads, MST 2.50 mm (U1.18<->R26.2) + 32.57 mm
    # (R26.2<->J1.38), 15.9 mm clear of the BAT_PROTECTED_P trunk -> ZERO D-269
    # involvement; the vet's 0.018 mm straight-line proximity to +3V3 on the long
    # edge is GUIDANCE only (the router detours; the real D-286 full-board gate
    # arbitrates legality).  Promotion decided by the real full-board gate
    # (D-286), not geometry.
    'DISP_CS_N': dict(
        sheet='(top)',
        desc='display SPI chip-select DISP_CS_N (U1.18 MCU / R26.2 series / '
             'J1.38 display FPC connector); point-to-point control (not a shared '
             'SPI data/clock line), 3-pad all F.Cu SMD, no via',
        layer='F', width=200000, clr_pad=200000, clr_trk=200000,
        nets=['DISP_CS_N'],
        connector_fanout_plan=dict(a='R26.2', b='J1.38',
                                   a_near='F', b_near='F',
                                   inner=['I2', 'I3'], attach=['U1.18']),
    ),
    # FBV2-P2-024 -- DISP_DC scratch-tested to CHARACTERIZE the J1 display-FPC
    # connector haul as a shared wall (the mandate's headline candidate).  It is
    # the display data/command control (U1.22 MCU -> J1.37, the FPC pin adjacent
    # to DISP_CS_N's J1.38), a single 38.5 mm MST edge hauling directly off the
    # boxed MCU pad U1.22 to the tight display connector.  See the D-322
    # characterization below.
    'DISP_DC': dict(
        sheet='(top)',
        desc='display data/command control DISP_DC (U1.22 MCU / J1.37 display '
             'FPC connector); 2-pad all F.Cu SMD, bounded inner-layer fanout',
        layer='F', width=200000, clr_pad=200000, clr_trk=200000,
        nets=['DISP_DC'],
        connector_fanout_plan=dict(a='U1.22', b='J1.37',
                                   a_near='F', b_near='F',
                                   inner=['I2', 'I3'], attach=[]),
    ),
    # FBV2-P2-024 -- BOOT_N scratch-tested as the meaningful non-J1 alternative
    # (ESP32 boot-mode strap GPIO0: SW1.1 boot button + R2.2 pull-up + U1.27 MCU,
    # all F.Cu, no via).  Avoids the J1 display-connector wall entirely.  Its
    # reset-level sensitivity is treated carefully (a plain same-layer no-via
    # route, no special mechanic); it is only promoted if it routes AND gates
    # clean on the real D-286 gate.  See the D-322 characterization below.
    'BOOT_N': dict(
        sheet='02_MCU_CORE',
        desc='ESP32 boot-mode strap BOOT_N (SW1.1 boot button / R2.2 pull-up / '
             'U1.27 MCU GPIO0); low-current static strap, 3-pad all F.Cu SMD, '
             'no via',
        layer='F', width=200000, clr_pad=200000, clr_trk=200000,
        nets=['BOOT_N'],
    ),
    # ---------------------------------------------------------------------- #
    # FBV2-P2-025 / D-323 -- the display BACKLIGHT-CONTROL strap, a clean-
    # functional increment in an OPEN region (away from the west-XGPIO F.Cu
    # corridor, the U11/BQ25185 power-tree wall, RF/NFC/USB/crystals/switching/
    # class-D/rails/community mass, and every characterized wall: the MCU_EN_RC
    # boxed U1.3 pocket, the J1 display-FPC interior haul DISP_CS_N/DISP_DC, the
    # BOOT_N poor detours, U11_PROG/PWR_SENSE).  DISP_BL_CTL_STRAP is the MCU-side
    # low-current CONTROL strap of the display backlight: ESP32 (U1) GPIO pad
    # U1.16 (F.Cu SMD) -> test point TP2.1 (F.Cu SMD) + series resistors R108.1
    # and R109.1 (F.Cu SMD); R109 bridges to the SEPARATE downstream net
    # DISP_BL_CTL (R109.2 -> U17.4 backlight driver, NOT part of this increment),
    # so this is exactly the low-current MCU control/enable/PWM strap, DISTINCT
    # from the backlight power/driver path (the emitter/switch-vs-control
    # distinction the mandate draws).  It is NOT the higher-current LED_BOOST
    # backlight distribution (LED_A, netclass LED_BOOST 0.300 mm width -- rejected
    # as a converter/high-current trap).  All four pads on F.Cu, so the 4-pad MST
    # is three SAME-LAYER F.Cu runs with NO via -- the cleanest incremental class
    # (no through via, no In1/In4 plane re-pour, no via-clearance risk; the
    # D-305/D-307/D-309/D-318..D-322 no-via same-layer mechanic).  Its role is
    # noncritical low-speed CMOS backlight control -- NOT reset/boot sensitive
    # (unlike BOOT_N / MCU_EN which the mandate set aside for sensitivity), so a
    # legal same-layer detour around accepted copper is fully acceptable for this
    # net.  Default netclass (0.200 mm width/clearance).  MEASURED (w/vet_021.py
    # on the live D-322 board): 4 pads, MST 5.44 mm (TP2.1<->U1.16) + 10.30 mm
    # (TP2.1<->R109.1) + 24.77 mm (U1.16<->R108.1), congestion 185, 37.9 mm clear
    # of the BAT_PROTECTED_P trunk -> ZERO D-269 involvement.  U1.16 is a
    # different MCU pin from the boxed U1.3 (MCU_EN wall): its short escape is the
    # clean 5.44 mm TP2.1 edge (not a long haul directly off a boxed pad), and the
    # long 24.77 mm R108.1 edge hauls SOUTH into open board -- the SD_CS_N/UART0
    # MCU-pad-escape precedent, not the MCU_EN boxed-pocket wall.  Promotion
    # decided by the real full-board gate (D-286), not geometry.
    #
    # FBV2-P2-025 OUTCOME -- CHARACTERIZED LOCAL WALL, NOT PROMOTED.  On the live
    # D-322 board ALL THREE MST edges return NO_PATH at 0.200 mm (none even at the
    # 0.05/0.025 mm fine grid) -- including the SHORT edges U1.16<->TP2.1 (5.44 mm)
    # and TP2.1<->R109.1 (10.30 mm), not just the long R108.1 haul.  The MCU /
    # backlight pad pocket (congestion 185) boxes every terminal: the vet's
    # 0.022 mm straight-line proximity to the accepted D-318 BMI270_INT1_STRAP
    # copper and 0.111 mm to the SD_CARD_DETECT_N region are REAL congestion, so
    # U1.16, TP2.1 and R109.1 have no legal 0.200 mm corridor between them.  This
    # is the MCU_EN_RC lesson repeated (a dense boxed MCU-adjacent pocket, not an
    # open MCU-pad escape like SD_CS_N/UART0); do NOT naively retry.  The next
    # bounded alternative BTN_B_N then FAILED the real full-board gate on
    # connectivity (SW7 duplicate pad-"1" tact-switch topology -- see its block),
    # so D-323 promoted the functional net ACC_DETECT_N (which gates clean).
    'DISP_BL_CTL_STRAP': dict(
        sheet='02_MCU_CORE',
        desc='display backlight-control strap DISP_BL_CTL_STRAP (U1.16 MCU GPIO / '
             'TP2.1 test point / R108.1 + R109.1 series); low-current MCU control '
             'strap isolated by R109 from the DISP_BL_CTL backlight-driver path, '
             '4-pad multi-terminal, all F.Cu SMD, no via',
        layer='F', width=200000, clr_pad=200000, clr_trk=200000,
        nets=['DISP_BL_CTL_STRAP'],
    ),
    # FBV2-P2-025 -- BTN_B_N held as the bounded functional ALTERNATIVE (a genuine
    # user-input button net: boot/nav button SW7.1 F.Cu -> pull-up R9.2 B.Cu ->
    # expander U2.18 B.Cu).  Its single cross-layer through via lands on the
    # SW7.1<->R9.2 edge in the OPEN south button field (NOT the characterized U2
    # west-edge escape wall -- the U2.18 leg is a flat SAME-LAYER B.Cu run), so no
    # via_offset is needed; one 0.60/0.30 Default through via with the In1/In4
    # re-pour mechanic (D-306/D-308).  Default netclass.  MEASURED (w/vet_021.py,
    # live D-322): 3 pads, MST 6.12 mm (SW7.1<->R9.2 cross) + 8.57 mm
    # (R9.2<->U2.18 same B), congestion 141, 11.0 mm clear of BAT_PROTECTED_P.
    #
    # FBV2-P2-025 OUTCOME -- ROUTED ALL OK BUT FAILED THE REAL FULL-BOARD GATE ON
    # CONNECTIVITY, NOT PROMOTED.  SW7 is a 4-pin tactile switch whose TWO
    # mechanically-linked terminals BOTH carry pad number "1" on BTN_B_N at
    # different locations (measured (49.520,96.750) and (57.480,96.750), 7.96 mm
    # apart), and the framework's per-ref MST (pads_by_ref) collapsed the two
    # SW7.1 pads to a single node -> the second terminal was never driven -> one
    # permanent open ratsnest edge (open_edges 2->1, gate FAIL).
    #
    # FBV2-P2-027 / D-325 OUTCOME -- PROMOTED.  The bounded, generic, deterministic
    # DUPLICATE-REF MST framework fix landed: physical_net_pads() keys MST nodes by
    # PHYSICAL (ref, x, y) so both SW7.1 lands are distinct nodes, and cmd_gate's
    # net_open_edges() counts copper clusters over physical pads (matching KiCad's
    # own ratsnest: 4 lands -> 3 edges).  BTN_B_N then routes R9.2 hub -> BOTH
    # SW7.1 lands (two 0.60/0.30 through vias in the OPEN south button field, at
    # (48.300,96.750) and (56.300,95.600), In1/In4 re-poured) + R9.2->U2.18 same-
    # layer B.Cu; 19 trk (3 F.Cu + 16 B.Cu) + 2 vias; all four physical pads in one
    # copper cluster (open_edges 3->0), ratsnest -3, vias >= 2.915 mm from every
    # barrel, gate PASS.  Ordinary unique-pad nets stay byte-identical; router_
    # regression G1-G35 unchanged.  The WHOLE SWx user-button family is now
    # routable (G36 pins the increment, G37 the framework lever).
    'BTN_B_N': dict(
        sheet='08_BUTTONS_EXPANDERS',
        desc='navigation/boot button input BTN_B_N (SW7.1 button F.Cu -> R9.2 '
             'pull-up B.Cu -> U2.18 expander B.Cu); low-current 3V3 CMOS input, '
             '3-pad, one cross-layer through via in the open button field '
             '(not the U2 escape wall), no via_offset',
        layer='B', width=200000, clr_pad=200000, clr_trk=200000,
        via_dia=600000, via_drill=300000,
        nets=['BTN_B_N'],
    ),
    # FBV2-P2-028 / D-326 -- the navigation D-pad UP button BTN_UP_N, the SECOND
    # net of the SWx user-button family unlocked by the D-325 duplicate-ref MST
    # framework fix, and the CLEANEST remaining member.  BTN_UP_N = {SW2.1 button
    # (TWO F.Cu tact-switch lands at (60.220,96.750) and (68.180,96.750), 7.96 mm
    # apart -- the duplicate pad-"1" topology every PTS645 switch shares), R4.2
    # pull-up (B.Cu), U2.13 PCAL9535A expander GPIO (B.Cu)}.  A genuine functional
    # low-current 3V3 CMOS user input (the D-pad UP key), read at expander U2.13,
    # pulled up by R4 -- exactly BTN_B_N's role and class, one pin over on U2.
    #
    # SELECTED as the safest/cleanest of the five remaining nav buttons by TWO
    # independent read-only screens on the live D-325 board (w/screen_020.py bbox
    # congestion + a faithful physical_net_pads MST vet): its single CROSS-LAYER
    # haul (U2.13<->SW2.1, ~12.33 mm) is BY FAR the shortest of the family (BTN_A
    # 42.4, BTN_DOWN 44.0, BTN_LEFT 50.2, BTN_RIGHT 56.9 mm) because SW2 sits in the
    # SAME OPEN south button field where BTN_B_N (SW7) already routed and PASSED the
    # gate; congestion 201 is the lowest nav-button value.  The physical MST is:
    # SW2.1a<->SW2.1b (7.96 mm SAME-LAYER F.Cu land-run, NO via -- the duplicate-land
    # edge the D-325 lever enables) + R4.2<->U2.13 (7.92 mm SAME-LAYER B.Cu run, NO
    # via) + ONE CROSS-LAYER edge U2.13<->SW2.1 closed by exactly ONE 0.60/0.30
    # Default through via (the D-306/D-308/D-325 mechanic, In1/In4 re-poured once for
    # the single anti-pad) -- so ONE via, CLEANER than BTN_B_N's two.  NO via_offset
    # (the via lands in the open south field, not the U2 west-edge escape wall;
    # U2.13 is reached by a flat SAME-LAYER B.Cu run off R4 exactly as U2.18 was for
    # BTN_B_N).  Default netclass (0.200 mm width/clearance).  MEASURED straight-MST
    # 7.453 mm clear of BAT_PROTECTED_P (>> the D-269 0.300 mm floor -> zero D-269
    # involvement; arbitrated by the real full-board D-286 gate).  Promotion decided
    # by the real full-board gate (D-286), not geometry.
    'BTN_UP_N': dict(
        sheet='08_BUTTONS_EXPANDERS',
        desc='navigation D-pad UP button input BTN_UP_N (SW2.1 button two F.Cu '
             'tact-switch lands / R4.2 pull-up B.Cu / U2.13 expander GPIO B.Cu); '
             'low-current 3V3 CMOS user input, 4 physical pads, one same-layer '
             'F.Cu land-run + one same-layer B.Cu run + one cross-layer through '
             'via in the open south button field (not the U2 escape wall), no '
             'via_offset',
        layer='B', width=200000, clr_pad=200000, clr_trk=200000,
        via_dia=600000, via_drill=300000,
        nets=['BTN_UP_N'],
    ),
    # FBV2-P2-029 / D-327 -- the navigation D-pad DOWN button BTN_DOWN_N, the THIRD
    # net of the SWx user-button family (after BTN_B_N D-325, BTN_UP_N D-326), on
    # the SAME D-325 duplicate-ref physical-pad MST framework (registry entry +
    # comment only; physical_net_pads/net_open_edges/qrouter.py byte-unchanged).
    # BTN_DOWN_N = {SW3.1 button (TWO F.Cu tact-switch lands at (11.250,103.520) and
    # (11.250,111.480), 7.96 mm apart -- the PTS645 duplicate pad-"1" topology),
    # R5.2 pull-up (B.Cu), U2.14 PCAL9535A expander GPIO (B.Cu)} -- exactly
    # BTN_B_N/BTN_UP_N's role and class (a low-current 3V3 CMOS nav input read at
    # the U2 expander, pulled up by R5), one pin over on U2.
    #
    # SELECTED as the cleanest legal of the FOUR remaining west nav buttons by a
    # fresh read-only screen + faithful physical-pad/MST vet on the live D-326
    # board (w/vet_026.py): it is the LOWEST-congestion west button by a clear
    # margin (bbox congestion 339 vs BTN_A 435, BTN_LEFT 505, BTN_RIGHT 516) at a
    # cross-haul (44.00 mm) essentially tied with the shortest (BTN_A 42.35 mm) --
    # and bbox congestion, not raw haul length, is the wall predictor (it, not
    # length, walled BMI270_INT1_RAW at 48 mm and DISP_CS_N).  The physical MST is:
    # SW3.1a<->SW3.1b (7.96 mm SAME-LAYER F.Cu land-run, NO via -- the duplicate-
    # land edge the D-325 lever enables) + R5.2<->U2.14 (8.10 mm SAME-LAYER B.Cu
    # run, NO via) + ONE CROSS-LAYER edge R5.2<->SW3.1 (the long west haul) closed
    # by exactly ONE 0.60/0.30 Default through via (the D-306/D-308/D-325 mechanic,
    # In1/In4 re-poured once for the single anti-pad) -- so ONE via, like BTN_UP_N.
    # The bulk of the west haul runs on the group's B.Cu layer (only the SW3.1 pad
    # escape is F.Cu), keeping OFF the saturated west-XGPIO F.Cu corridor.  NO
    # via_offset (the router's obstacle-aware via_site + the defensive clearance
    # re-proof arbitrate barrel proximity).  Default netclass (0.200 mm).  MEASURED
    # straight-MST 8.891 mm clear of BAT_PROTECTED_P (>> the D-269 0.300 mm floor ->
    # zero D-269 involvement). D-327 OUTCOME: NO PROMOTE. The long west haul
    # routed, but the short R5.2<->U2.14 B.Cu edge returned NO_PATH at both fine
    # grids. The authoritative board remained untouched.
    'BTN_DOWN_N': dict(
        sheet='08_BUTTONS_EXPANDERS',
        desc='navigation D-pad DOWN button input BTN_DOWN_N (SW3.1 button two F.Cu '
             'tact-switch lands / R5.2 pull-up B.Cu / U2.14 expander GPIO B.Cu); '
             'low-current 3V3 CMOS user input, 4 physical pads, one same-layer '
             'F.Cu land-run + one same-layer B.Cu run + one cross-layer through '
             'via (the long west haul on B.Cu, not the west-XGPIO F.Cu corridor), '
             'no via_offset',
        layer='B', width=200000, clr_pad=200000, clr_trk=200000,
        via_dia=600000, via_drill=300000,
        nets=['BTN_DOWN_N'],
    ),
    # FBV2-P2-029 / D-327 -- BTN_RIGHT_N, the BOUNDED NEXT-BEST alternative after
    # BTN_DOWN_N walled.  BTN_DOWN_N routed its long west haul fine (44.275 mm on
    # B.Cu) but NO_PATH'd the SHORT same-B.Cu R5.2<->U2.14 cluster escape at
    # 0.200 mm even on the 0.05/0.025 mm fine grid -- reframing the binding wall as
    # the U2 expander / R pull-up cluster escape (not the long haul or bbox
    # congestion).  A fresh read-only escape probe (w/escape_026.py) then showed
    # the U2 column pins (0.65 mm pitch) are all boxed to 3/8 open dirs after the
    # accepted BTN_B_N/BTN_UP_N copper, but the R.2 pull-ups differ sharply on
    # escape room: R7.2 (BTN_RIGHT_N) nearest-other 1.600 mm / 1 fully-open dir /
    # 3.0 mm reach is by far the roomiest, vs R5.2(FAIL) 0.930/2-open, R8.2(BTN_A)
    # 0.933/0-open (fully boxed) and R6.2(BTN_LEFT) 0.748/0-open (worst) -- so
    # BTN_RIGHT_N is the evidence-based next-best, overturning the a-priori BTN_A_N
    # guess (R8.2 is fully boxed).  BTN_RIGHT_N = {SW5.1 button (TWO F.Cu lands at
    # (3.750,111.020)/(3.750,118.980), 7.96 mm apart), R7.2 pull-up (B.Cu), U2.16
    # expander GPIO (B.Cu)}; same class/role as BTN_UP_N.  Physical MST:
    # SW5.1a<->SW5.1b (7.96 mm F.Cu land-run, NO via) + R7.2<->U2.16 (9.46 mm SAME-
    # LAYER B.Cu run, NO via) + ONE CROSS-LAYER edge R7.2<->SW5.1 (the long west
    # haul, 56.89 mm) closed by ONE 0.60/0.30 Default through via (In1/In4 re-poured
    # once).  Default netclass (0.200 mm).  MEASURED straight-MST 5.483 mm clear of
    # BAT_PROTECTED_P -- >> the D-269 0.300 mm floor (18x), zero D-269 involvement.
    # D-327 OUTCOME: NO PROMOTE. The route produced no copper; the local
    # pull-up/expander cluster remains boxed at the governed 0.200 mm rules.
    'BTN_RIGHT_N': dict(
        sheet='08_BUTTONS_EXPANDERS',
        desc='navigation D-pad RIGHT button input BTN_RIGHT_N (SW5.1 button two '
             'F.Cu tact-switch lands / R7.2 pull-up B.Cu / U2.16 expander GPIO '
             'B.Cu); low-current 3V3 CMOS user input, 4 physical pads, one same-'
             'layer F.Cu land-run + one same-layer B.Cu run + one cross-layer '
             'through via (long west haul on B.Cu), no via_offset',
        layer='B', width=200000, clr_pad=200000, clr_trk=200000,
        via_dia=600000, via_drill=300000,
        # D-328: the ordinary B.Cu MST edge R7.2<->U2.16 is a measured
        # severed local region.  Use the existing proven two-via layer-hop to
        # join those two B.Cu pads on F.Cu, then attach BOTH SW5.1 F.Cu lands
        # directly to the hop's R7-side via anchor.  This avoids asking the
        # boxed R7 pad to escape a second time.  Opt-in and registry-driven:
        # every group without hop_anchor_plan follows the old MST byte-for-byte.
        hop_anchor_plan=dict(a='R7.2', b='U2.16', attach='SW5.1', far='F'),
        nets=['BTN_RIGHT_N'],
    ),
    # FBV2-P2-029 / D-327 -- final bounded characterization candidate after
    # BTN_DOWN_N and BTN_RIGHT_N produced no complete legal route. BTN_A_N is
    # the shortest remaining west-button cross-haul. It uses the accepted D-325
    # physical-pad MST unchanged: both SW6.1 F.Cu lands, R8.2 B.Cu pull-up and
    # U2.17 B.Cu expander input, Default 0.200 mm with one through via expected.
    # D-327 OUTCOME: NO PROMOTE. The west cross-haul and duplicate switch-land
    # edge routed, but R8.2<->U2.17 returned NO_PATH; gate stayed open_edges 3->1.
    'BTN_A_N': dict(
        sheet='08_BUTTONS_EXPANDERS',
        desc='navigation A button input BTN_A_N (SW6.1 two F.Cu tact-switch '
             'lands / R8.2 pull-up B.Cu / U2.17 expander GPIO B.Cu); '
             'low-current 3V3 CMOS user input, accepted duplicate-pad MST',
        layer='B', width=200000, clr_pad=200000, clr_trk=200000,
        via_dia=600000, via_drill=300000,
        nets=['BTN_A_N'],
    ),
    # FBV2-P2-025 / D-323 -- the accelerometer PRESENCE-DETECT signal, a clean-
    # functional increment in an OPEN region (away from the west-XGPIO F.Cu
    # corridor, the U11/BQ25185 power-tree wall, RF/NFC/USB/crystals/switching/
    # class-D/rails/community mass, and every characterized wall).  ACC_DETECT_N
    # is the low-current accelerometer / add-on presence-detect signal: divider/
    # pull resistor R64.1 (F.Cu SMD, placed in the north) -> series resistor
    # R129.2 (B.Cu SMD) -> PCAL9535A expander GPIO U3.17 (B.Cu SMD).  It is a
    # genuine functional low-speed CMOS detect input to the expander (NOT the
    # community-header GPIO bank, NOT a converter/rail: U3.17 is an internal
    # peripheral GPIO, R64 is the detect divider that merely sits spatially near
    # the NFC parts in the north).  Three pads on TWO faces (R64.1 F.Cu; R129.2 +
    # U3.17 B.Cu), so the MST is ONE cross-layer edge R64.1<->R129.2 (a single
    # 0.60/0.30 Default through via, the D-306/D-308 mechanic with the In1/In4
    # re-pour) + ONE SAME-LAYER B.Cu edge R129.2<->U3.17 (no via).  The via lands
    # on the NORTH R64.1<->R129.2 edge (y~38-57), away from every existing barrel
    # and away from the U3 west-edge XGPIO via pocket -> NO via_offset needed (the
    # always-on existing-via obstacle injection + the defensive clearance re-proof
    # arbitrate).  Default netclass (0.200 mm width/clearance).  MEASURED
    # (w/vet_021.py on the live D-322 board): 3 pads, MST 19.64 mm
    # (R64.1<->R129.2 cross) + 19.31 mm (R129.2<->U3.17 same B), congestion 103
    # (lowest of the remaining genuinely-clean functional shortlist), straight-MST
    # 2.750 mm from the BAT_PROTECTED_P trunk -- >> the D-269 0.300 mm floor, so
    # D-269 is satisfied by geometry and arbitrated by the real full-board
    # D-269-aware gate (the router detours; the vet's 0.228 mm NFC_5V_EN and
    # 0.007 mm V3V3_FB straight-line proximities are GUIDANCE only).  Promotion
    # decided by the real full-board gate (D-286), not geometry.
    'ACC_DETECT_N': dict(
        sheet='(top)',
        desc='accelerometer/add-on presence-detect ACC_DETECT_N (R64.1 divider '
             'F.Cu / R129.2 series B.Cu / U3.17 expander GPIO B.Cu); low-current '
             'low-speed CMOS detect input, 3-pad, one cross-layer through via '
             '(north R64.1<->R129.2 edge, not the U3 escape) + one same-layer '
             'B.Cu run, no via_offset',
        layer='B', width=200000, clr_pad=200000, clr_trk=200000,
        via_dia=600000, via_drill=300000,
        nets=['ACC_DETECT_N'],
    ),
    # ---------------------------------------------------------------------- #
    # FBV2-P2-026 / D-324 -- the BMI270 IMU INT1 interrupt SENSOR-SIDE leg, a
    # clean-functional increment in an OPEN region (away from the west-XGPIO F.Cu
    # corridor, the U11/BQ25185 power-tree wall, RF/NFC/USB/crystals/switching/
    # class-D/rails/community mass, and every characterized wall: the MCU_EN_RC
    # boxed U1.3 pocket, the J1 display-FPC interior haul DISP_CS_N/DISP_DC, the
    # BOOT_N poor detours, the DISP_BL_CTL_STRAP boxed pocket, U11_PROG/PWR_SENSE,
    # and the SWx duplicate-ref button family).  BMI270_INT1_RAW is the IMU-output
    # side of the BMI270 (U4) INT1 interrupt: the INT1 pin U4.4 (B.Cu SMD) -> the
    # series/damping resistor near pad R18.1 (F.Cu SMD).  R18 series-isolates this
    # RAW sensor-output leg from the already-routed D-318 MCU-side strap
    # BMI270_INT1_STRAP (R18.2/R110.1/TP3.1/U1.15) -- so this increment COMPLETES
    # the IMU INT1 interrupt path on the sensor side, exactly the way D-308
    # FRONT_RGB_LED completed the D-304 FRONT_RGB indicator (the control-leg /
    # completion-leg pattern the mandate welcomes), a genuine coherent functional
    # net, NOT a shared high-speed bus (INT1 is a dedicated point-to-point
    # interrupt line).  The two pads are on DIFFERENT faces (R18.1 F.Cu, U4.4
    # B.Cu) so the single MST edge is CROSS-LAYER -> exactly ONE board-legal
    # 0.60/0.30 Default through via (the D-306/D-308/D-323 mechanic with the
    # In1/In4 GND-plane re-pour for the single anti-pad).  The via lands on the
    # single R18.1<->U4.4 haul in open board and is NOT the U2 west-edge escape
    # (U4 is the mid-board IMU, not the U2 display escape column), so NO via_offset
    # is needed (the always-on existing-via obstacle injection + the defensive
    # clearance re-proof arbitrate any barrel proximity).  Default netclass
    # (0.200 mm width/clearance).  MEASURED (w/vet_021.py on the live D-323
    # board): 2 pads, single MST edge 48.81 mm (R18.1<->U4.4), congestion 365
    # (bbox), straight-MST 5.447 mm from the BAT_PROTECTED_P trunk -- >> the
    # D-269 0.300 mm floor, so D-269 is satisfied by geometry and arbitrated by
    # the real full-board D-269-aware gate; the vet's 0.005 mm straight-line
    # proximity to an XGPIO5 pad is GUIDANCE only (the router detours; the real
    # D-286 full-board gate arbitrates legality, as IR_TX_GPIO16's 0.062 mm
    # straight line detoured clean at D-320).  Promotion decided by the real
    # full-board gate (D-286), not geometry.
    #
    # FBV2-P2-026 OUTCOME -- CHARACTERIZED LOCAL WALL, NOT PROMOTED.  On the live
    # D-323 board the single cross-layer haul R18.1<->U4.4 returns FAIL
    # NO_FAR_RUN at 0.200 mm (no legal corridor even on the 0.05/0.025 mm fine
    # grid): the F.Cu escape from R18.1 (44.474,116.721) is boxed in the dense
    # MCU-south pocket -- R18.1 sits between the accepted D-318 BMI270_INT1_STRAP
    # copper (R18.2 is the OTHER pad of the SAME 0402 resistor, 0.84 mm away, now
    # carrying strap copper), the USB_D_MCU diff pair, and the U1 pad row -- so
    # the 48.81 mm haul to the mid-board IMU has no legal F.Cu exit at 0.200 mm.
    # The vet's 0.005 mm straight-line nearest-copper was REAL congestion at the
    # escape, not merely guidance.  This is the same dense-MCU-adjacent-pocket
    # wall class as MCU_EN_RC (U1.3) and DISP_BL_CTL_STRAP (U1.16); do NOT naively
    # retry.  D-324 instead promoted the all-B.Cu no-via ACC_POWER_FAULT_N (below,
    # which gates clean).
    'BMI270_INT1_RAW': dict(
        sheet='05_I2C_DEVICES',
        desc='BMI270 IMU INT1 interrupt sensor-side leg BMI270_INT1_RAW (U4.4 IMU '
             'INT1 pin B.Cu -> R18.1 series resistor F.Cu); completes the D-318 '
             'MCU-side BMI270_INT1_STRAP through series R18, low-current low-speed '
             'CMOS interrupt, dedicated 2-pad point-to-point net, one cross-layer '
             'through via in open board (not the U2 escape), no via_offset',
        layer='F', width=200000, clr_pad=200000, clr_trk=200000,
        via_dia=600000, via_drill=300000,
        nets=['BMI270_INT1_RAW'],
    ),
    # FBV2-P2-026 / D-324 -- the accelerometer POWER-FAULT status net, the bounded
    # ALTERNATIVE promoted after BMI270_INT1_RAW hit the characterized MCU-south
    # escape wall (above).  ACC_POWER_FAULT_N is the low-current accelerometer/
    # add-on 3V3 power-fault status aggregation: the two ACC load-switch fault
    # outputs U20.6 + U22.6 (the accelerometer 3V3 load switches whose local
    # control ACC_3V3_CTL was routed at D-305), pull resistor R103.2, two test
    # points TP27.1 + TP33.1, read back at the PCAL9535A expander GPIO U3.18 -- a
    # genuine functional low-speed CMOS status/fault line (NOT a switching output,
    # NOT a rail, NOT the community-header GPIO bank: U3.18 is an internal
    # peripheral GPIO; U20/U22 are the ACC load switches whose FAULT open-drain
    # STATUS pins are read here, not their power path).  All SIX pads are on B.Cu
    # SMD, so the 6-pad MST is FIVE SAME-LAYER B.Cu runs with NO via -- the
    # cleanest incremental class (no through via, no In1/In4 plane re-pour, no
    # via-clearance risk; the D-304/D-305/D-307/D-322 all-B.Cu no-via mechanic).
    # A local mid-board cluster around the ACC power switches, span 35.8 mm, MST
    # edges all short (3.16-13.63 mm).  Default netclass (0.200 mm width/
    # clearance).  MEASURED (w/vet_021.py on the live D-323 board): 6 pads, MST
    # edges U22.6<->R103.2 12.52 mm + R103.2<->U20.6 9.37 mm + U20.6<->TP27.1
    # 4.22 mm + TP27.1<->U3.18 13.63 mm + U3.18<->TP33.1 3.16 mm, congestion 292
    # (bbox), straight-MST 3.544 mm from the BAT_PROTECTED_P trunk -- >> the
    # D-269 0.300 mm floor, so D-269 is satisfied by geometry and arbitrated by
    # the real full-board D-269-aware gate; the vet's 0.052 mm (ACC_3V3_EN) /
    # 0.094 mm (XGPIO8) straight-line proximities on the interior edges are
    # GUIDANCE only (the router detours; the real D-286 full-board gate arbitrates
    # legality).  Promotion decided by the real full-board gate (D-286), not
    # geometry.
    #
    # FBV2-P2-026 OUTCOME -- CHARACTERIZED LOCAL WALL, NOT PROMOTED.  On the live
    # D-323 board the ACC load-switch fault pin U20.6 has NO LEGAL ESCAPE at
    # >= 0.200 mm: it is boxed on B.Cu by its own-part neighbour pads (U20.5,
    # U20.1, U20.4) and an existing track, so the two MST edges that hub through
    # U20.6 (R103.2<->U20.6 and U20.6<->TP27.1) both fail; the other three edges
    # (R103.2<->U22.6, TP27.1<->U3.18, U3.18<->TP33.1) route clean, but the net
    # cannot complete.  This is the same pad-local boxed-pin wall class as ISET
    # (U11.8, D-307) and XGPIO2 (U3.6, D-315) -- a middle pin flanked by same-part
    # neighbours with no legal 0.200 mm corridor; no bounded fix without a
    # placement / clearance change (forbidden).  Do NOT naively retry.
    'ACC_POWER_FAULT_N': dict(
        sheet='(top)',
        desc='accelerometer/add-on 3V3 power-fault status ACC_POWER_FAULT_N '
             '(U20.6 + U22.6 ACC load-switch fault outputs / R103.2 pull / '
             'TP27.1 + TP33.1 test points -> U3.18 PCAL expander GPIO readback); '
             'low-current low-speed CMOS status/fault line, 6-pad multi-terminal, '
             'all B.Cu SMD, no via',
        layer='B', width=200000, clr_pad=200000, clr_trk=200000,
        nets=['ACC_POWER_FAULT_N'],
    ),
    # FBV2-P2-026 -- DISP_BL_CTL scratch-tested as a second bounded functional
    # alternative (the display backlight-driver CONTROL leg).  U17 is the
    # TPS61169DCKR white-LED backlight boost driver; DISP_BL_CTL drives its U17.4
    # CTRL pin (the low-current PWM/enable LOGIC control input) through series
    # resistor R109.2 (F.Cu) -- R109 isolates this control leg from the walled
    # MCU-side strap DISP_BL_CTL_STRAP (R109.1 side) and from the driver's
    # switching output BL_SW (U17.1) / LED power path LED_K (U17.3), exactly the
    # IR_TX_GPIO16 control-leg-isolated-by-series-R precedent.  2-pad cross-layer
    # (R109.2 F, U17.4 B) -> one 0.60/0.30 Default through via.
    #
    # FBV2-P2-026 OUTCOME -- CHARACTERIZED LOCAL WALL, NOT PROMOTED.  On the live
    # D-323 board the single cross-layer haul R109.2<->U17.4 returns FAIL
    # NO_FAR_RUN at 0.200 mm (no legal corridor even on the 0.05/0.025 mm fine
    # grid): R109.2 sits in the SAME dense U1.16 / backlight-strap pad cluster
    # (congestion 185) that walled DISP_BL_CTL_STRAP at D-323, so its F.Cu escape
    # has no legal exit.  via_offset cannot help a far-run failure (it relocates
    # the via only AFTER a successful escape).  The role is a defensible control
    # leg (U17.4 is the TPS61169 CTRL logic input, R109-isolated from the BL_SW
    # switch node and LED path), but the geometry walls; do NOT naively retry.
    'DISP_BL_CTL': dict(
        sheet='03_SPI_A_DISPLAY_SD',
        desc='display backlight-driver control leg DISP_BL_CTL (R109.2 series F -> '
             'U17.4 TPS61169 CTRL logic input B); low-current PWM/enable control, '
             'isolated by R109 from the switching output BL_SW and LED path, '
             '2-pad point-to-point, one cross-layer through via',
        layer='F', width=200000, clr_pad=200000, clr_trk=200000,
        via_dia=600000, via_drill=300000,
        # FBV2-P2-045: replace the disproven ordinary cross-layer far run with
        # the qualified D-331 reserved-escape framework.  Each boxed endpoint
        # owns a short native-face escape and an ordinary through via; the two
        # anchors join on a slow-signal inner layer.  This is opt-in, so every
        # other group retains its existing route byte-for-byte.
        inner_long_haul_plan=dict(a='R109.2', b='U17.4',
                                  a_near='F', b_near='B',
                                  inner=['I2', 'I3']),
        nets=['DISP_BL_CTL'],
    ),
}


# --------------------------------------------------------------------------- #
# copper-item fingerprints (geometry-based Phase-A preservation proof)
def _track_sig(t):
    a = (t.GetStart().x, t.GetStart().y)
    z = (t.GetEnd().x, t.GetEnd().y)
    lo, hi = min(a, z), max(a, z)
    return ('T', t.GetNetname(), t.GetLayer(), lo, hi, t.GetWidth())


def _via_sig(t):
    p = t.GetPosition()
    return ('V', t.GetNetname(), (p.x, p.y), t.GetWidth(pcbnew.F_Cu), t.GetDrill())


def copper_sigs(board):
    c = collections.Counter()
    for t in board.GetTracks():
        cls = t.GetClass()
        if cls == 'PCB_TRACK':
            c[_track_sig(t)] += 1
        elif cls == 'PCB_VIA':
            c[_via_sig(t)] += 1
    return c


def sha256(path):
    return hashlib.sha256(open(path, 'rb').read()).hexdigest()


# --------------------------------------------------------------------------- #
def resolve_nets(qb, group):
    """Map each group base-net-name to its full net name on the board."""
    out = {}
    for base in group['nets']:
        hit = [nm for nm in qb.nets
               if nm == base or nm.endswith('/' + base)]
        if len(hit) != 1:
            raise SystemExit('net %r resolves to %r (expected exactly 1)' % (base, hit))
        out[base] = hit[0]
    return out


def net_pads(qb, netfull):
    return [d for (nm, tag), d in qb.pads.items() if nm == netfull]


# --------------------------------------------------------------------------- #
# DUPLICATE-FOOTPRINT-PAD-NUMBER MST NODES  (FBV2-P2-027 / D-325).
#
# qrouter.QBoard._scan keys its pad table `self.pads[(net, "REF.NUM")] = dict`.
# When ONE footprint places TWO physical lands that carry the SAME pad NUMBER on
# the SAME net -- a 4-pin tactile switch, whose two mechanically-linked terminals
# are both pad "1" (BTN_B_N: SW7.1 at (49.520,96.750) and (57.480,96.750), 7.96 mm
# apart) -- the second (net,tag) write overwrites the first, so one physical land
# is INVISIBLE to net_pads()/the MST.  Routing then drives only one terminal and
# the real full-board gate FAILs on connectivity (D-323 BTN_B_N: net open_edges
# 2->1, not 2->0), blocking the whole SWx user-button family.
#
# The bounded, generic, deterministic fix lives HERE (a new caller composing
# board data; qrouter.py is NOT touched, so every G-contract fixture that routes
# through QBoard stays byte-identical): represent MST nodes by stable PHYSICAL
# pad identity (ref, x, y) rather than by footprint pad number, so every distinct
# land is its own node.  Ordinary nets -- every pad number unique -- return
# exactly net_pads() (the same dict objects), so their routing/journal is byte-
# unchanged; only a genuinely duplicated pad number contributes an extra node.
def _rr_pad_dict(f, p):
    """Rebuild ONE physical pad's routing dict IDENTICALLY to qrouter._scan
    (lines that construct self.pads), so a recovered duplicate-number land is
    field-for-field indistinguishable from a scanned pad.  Used ONLY for a land
    that qb.pads dropped; ordinary single-number pads are taken straight from
    qb.pads and never reach here."""
    pos = p.GetPosition()
    sx, sy = p.GetSizeX() / 2.0, p.GetSizeY() / 2.0
    sh = p.GetShape()
    if sh in (pcbnew.PAD_SHAPE_CIRCLE, pcbnew.PAD_SHAPE_OVAL):
        r = min(sx, sy)
    elif sh == pcbnew.PAD_SHAPE_ROUNDRECT:
        r = p.GetRoundRectCornerRadius()
    else:
        r = 0
    ang = p.GetOrientationDegrees()
    tag = f.GetReference() + '.' + p.GetNumber()
    net = p.GetNetname()
    s = QR.RR(pos.x, pos.y, sx, sy, r, ang, net, tag)
    return dict(ref=tag, x=pos.x, y=pos.y,
                F=p.IsOnLayer(pcbnew.F_Cu), B=p.IsOnLayer(pcbnew.B_Cu),
                shape=s, hx=sx, hy=sy, r=r, ang=ang, net=net,
                tht=p.GetAttribute() in (pcbnew.PAD_ATTRIB_PTH,
                                         pcbnew.PAD_ATTRIB_NPTH))


def physical_net_pads(qb, netfull):
    """Every PHYSICAL pad on `netfull` as a routing dict, WITHOUT the same-
    footprint-pad-number collapse of qb.pads.  Deterministic; qrouter untouched.

    Ordinary nets (every land a unique pad number) return exactly the
    net_pads(qb, netfull) dict objects -- byte-identical routing.  A footprint
    that shares one pad number across two physical lands on this net adds the
    missing land(s) as separate node(s) so the MST + gate reach every terminal."""
    have = net_pads(qb, netfull)
    seen = {(d['ref'], d['x'], d['y']) for d in have}
    out = list(have)
    for f in qb.b.GetFootprints():
        for p in f.Pads():
            if p.GetNetname() != netfull or not p.GetNumber():
                continue
            pos = p.GetPosition()
            key = (f.GetReference() + '.' + p.GetNumber(), pos.x, pos.y)
            if key in seen:
                continue
            seen.add(key)
            out.append(_rr_pad_dict(f, p))
    return out


def _pad_layers(p):
    """The set of outer copper layers a pad has copper on ('F' and/or 'B')."""
    return {L for L in ('F', 'B') if p.get(L)}


def edge_plan(pa, pb, group):
    """Decide how ONE MST edge is routed from its two pads' layers.

    * SAME-LAYER (the pads share a routable outer layer) -> a flat run on that
      layer with QR.connect_role.  The layer preferred is the group's declared
      `layer` when it is one of the shared layers (so THT pads, which are on
      BOTH faces, and all-B / all-F groups behave exactly as before), else the
      single shared layer.
    * CROSS-LAYER (the pads have NO shared outer layer, e.g. one F.Cu SMD and
      one B.Cu SMD) -> a single board-legal through via via connect_cross.
    Returns (layer_or_None, 'same'|'cross')."""
    common = _pad_layers(pa) & _pad_layers(pb)
    if common:
        L = group['layer'] if group['layer'] in common else sorted(common)[0]
        return L, 'same'
    return None, 'cross'


# --------------------------------------------------------------------------- #
# EXISTING-VIA AWARENESS + BOUNDED VIA-SITE OFFSET  (FBV2-P2-012 / D-310).
#
# qrouter.QBoard._scan registers footprint pads and PCB_TRACK segments as
# obstacles but NOT existing PCB_VIA barrels/holes (it scans GetTracks() and
# `continue`s on the via class).  For every increment through D-309 this was
# harmless -- no new via landed beside an existing one.  The U2 display/touch
# escape family breaks that: U2.4/.7/.8/.11 stack on U2's west edge and the
# accepted D-306 DISP_RST_N through-via sits 1.19 mm west of that column, so a
# westward cross-layer escape via lands right on the DISP_RST_N barrel.  The
# router's via-blind via_site() happily returns that site (measured: AMP_SD_MODE
# 0.100 mm via-to-via, TOUCH/SD tracks threading the same congested column) and
# only the real full-board DRC catches the `clearance` violation -- exactly the
# D-309 wall.
#
# The correct, bounded, GENERIC fix lives HERE (a new caller composing existing
# QBoard primitives -- qrouter.py is NOT touched, so every G-contract fixture
# that re-routes through QBoard is byte-unchanged): connect_cross gains existing-
# via awareness and, when a group opts in with `via_offset`, DELIBERATELY places
# the F<->B transition a bounded distance off the congesting barrel -- a short
# B.Cu fan-out on the host face to a planned clear via site, rather than
# accepting the router's first via-blind legal one.  Groups WITHOUT `via_offset`
# call qb.via_site exactly as before (byte-identical to D-306/D-308).
def _existing_vias(qb):
    """All existing PCB_VIA barrels on the board (net,x,y,dia,drill) -- the
    obstacles qrouter._scan omits.  Cached on the QBoard instance."""
    cache = getattr(qb, '_inc_existing_vias', None)
    if cache is not None:
        return cache
    out = []
    for t in qb.b.GetTracks():
        if t.GetClass() == 'PCB_VIA':
            p = t.GetPosition()
            out.append(dict(net=t.GetNetname(), x=p.x, y=p.y,
                            dia=t.GetWidth(pcbnew.F_Cu), drill=t.GetDrill()))
    qb._inc_existing_vias = out
    return out


def inject_existing_via_obstacles(qb):
    """Register every existing PCB_VIA as an obstacle ON THE QBoard INSTANCE so
    ALL qrouter primitives (escape / via_site / connect_role track search / grid)
    see the accepted barrels -- WITHOUT editing qrouter.py.

    qrouter._scan builds obstacles from footprint pads and PCB_TRACK segments but
    skips PCB_VIA (it iterates GetTracks() and `continue`s on the via class), so
    an incremental route is otherwise blind to accepted through-vias: it will lay
    a new via or thread a track straight past an existing barrel and only real
    DRC catches it (the D-309 U2 wall: the TOUCH_RST_N F.Cu run passed 0.05 mm
    from the DISP_RST_N via).  This mirrors, item-for-item, exactly what
    QBoard.via() already does for a via it lays itself (RR copper on every Cu
    layer + a hole), so it is faithful, generic, and add-only: it can only make a
    route MORE conservative, never delete/alter accepted copper, and it touches
    only this transient per-route QBoard instance -- the G-contract fixtures build
    their own QBoards and are unaffected.  Same-net vias are naturally not
    obstacles (QBoard.obstacles filters s.net != net)."""
    if getattr(qb, '_inc_vias_injected', False):
        return 0
    n = 0
    for v in _existing_vias(qb):
        x, y, dia, drill, net = v['x'], v['y'], v['dia'], v['drill'], v['net']
        for L in qb.cu:
            qb.shapes[L].append(QR.RR(x, y, dia / 2.0, dia / 2.0, dia / 2.0,
                                      0, net, 'via'))
        qb.holes.append(QR.RR(x, y, drill / 2.0, drill / 2.0, drill / 2.0,
                              0, net, 'via/hole'))
        n += 1
    qb._inc_vias_injected = True
    return n


def _clears_existing_vias(qb, vx, vy, net, vdia, vdrill, cp, hole_clr=250000):
    """True iff a via (vdia/vdrill) centred at (vx,vy) clears every existing via
    NOT on `net` by copper clearance `cp` AND hole-to-hole `hole_clr`."""
    for v in _existing_vias(qb):
        if v['net'] == net:
            continue
        d = math.hypot(v['x'] - vx, v['y'] - vy)
        if d < vdia / 2.0 + v['dia'] / 2.0 + cp:      # copper clearance
            return False
        if d < vdrill / 2.0 + v['drill'] / 2.0 + hole_clr:   # hole-to-hole
            return False
    return True


def _offset_via_site(qb, near, far, net, esc, width, vdia, cp, ct, G, vdrill,
                     off, span=8000000, hole_clr=250000):
    """A bounded, existing-via-aware analogue of qb.via_site.

    Same reachability/both-layer legality qb.via_site enforces (free_region on
    `near` from the escape, via_dia clearance grids on `near` and `far`, the
    net-agnostic hole-to-hole floor), with TWO additions the via-blind primitive
    cannot make:

      * existing PCB_VIA copper (every routed layer) and hole clearance are
        subtracted from the candidate mask, so a returned site is legal against
        the accepted D-306/D-308 barrels the router cannot otherwise see;
      * the site is chosen nearest to a BIAS point = escape + `off` mm along the
        unit vector pointing directly AWAY from the nearest existing via -- i.e.
        the transition is deliberately walked ~`off` mm off the congesting barrel
        (a short host-face fan-out), not left on the router's nearest cell.

    `off` bounds the plan: the picked site must lie within `off` + a one-cell
    guard of the escape's reachable region, so the fan-out can never wander far.
    Returns (x,y) or None (caller then tries the next escape / grid / fails)."""
    x0, y0 = esc['x'] - span, esc['y'] - span
    x1, y1 = esc['x'] + span, esc['y'] + span
    reach = qb.free_region(near, net, width, cp, ct, G, (esc['x'], esc['y']),
                           x0, y0, x1, y1)
    if reach is None:
        return None
    mask, ox, oy, g = reach
    bn = qb.grid(near, net, vdia, cp, ct, ox, oy, x1, y1, g)
    bf = qb.grid(far, net, vdia, cp, ct, ox, oy, x1, y1, g)
    ny = min(mask.shape[0], bn.shape[0], bf.shape[0])
    nx = min(mask.shape[1], bn.shape[1], bf.shape[1])
    good = mask[:ny, :nx] & ~bn[:ny, :nx] & ~bf[:ny, :nx]
    if not good.any():
        return None
    XX = (ox + np.arange(nx) * g).astype(float)
    YY = (oy + np.arange(ny) * g).astype(float)
    X, Y = np.meshgrid(XX, YY)
    # subtract existing-via copper + hole clearance (the qrouter-blind obstacles)
    nearest = None
    for v in _existing_vias(qb):
        if v['net'] == net:
            continue
        need = max(vdia / 2.0 + v['dia'] / 2.0 + cp,
                   vdrill / 2.0 + v['drill'] / 2.0 + hole_clr)
        good &= ~(np.hypot(X - v['x'], Y - v['y']) < need)
        d = math.hypot(v['x'] - esc['x'], v['y'] - esc['y'])
        if nearest is None or d < nearest[0]:
            nearest = (d, v)
    if not good.any():
        return None
    # bias point: `off` mm away from the nearest existing via (deliberate offset)
    if nearest is not None:
        ax, ay = esc['x'] - nearest[1]['x'], esc['y'] - nearest[1]['y']
        n = math.hypot(ax, ay) or 1.0
        bx, by = esc['x'] + ax / n * off, esc['y'] + ay / n * off
    else:
        bx, by = esc['x'], esc['y']
    jj, ii = np.nonzero(good)
    ci = (bx - ox) / float(g)
    cj = (by - oy) / float(g)
    d = (ii - ci) ** 2 + (jj - cj) ** 2
    k = int(np.argmin(d))
    return (int(ox + ii[k] * g), int(oy + jj[k] * g))


def connect_cross(qb, net, pa, pb, group, G=50000, fine=25000):
    """Route ONE cross-layer edge (pads on opposite outer faces) with exactly
    ONE board-legal through via, composing only proven qrouter primitives:

        escape(host, near) -> via_site(near, far) -> via(0.60/0.30) ->
        connect_role(host -> anchor@via, near) + connect_role(run -> anchor@via, far)

    The via geometry, the all-copper-layer clearance and the net-agnostic
    hole-to-hole floor are exactly what QBoard.via_site already enforces (the
    same legality connect_hop relies on); the two runs land on the via centre,
    which is same-net copper and therefore not an obstacle to either.  No
    qrouter.py behaviour is changed -- this is a new caller of existing methods.

    When the group declares `via_offset`, the via site is chosen by the bounded
    existing-via-aware `_offset_via_site` (FBV2-P2-012): the transition is walked
    ~via_offset mm off the nearest congesting barrel and proven clear of every
    existing via the router is blind to.  Without `via_offset` the site is
    qb.via_site's nearest legal cell, exactly as for D-306/D-308.
    """
    w, cp, ct = group['width'], group['clr_pad'], group['clr_trk']
    vd = group.get('via_dia', 600000)
    vk = group.get('via_drill', 300000)
    voff = group.get('via_offset')          # None -> router-blind via_site (D-306/D-308)

    def only(p):
        s = _pad_layers(p)
        return next(iter(s)) if len(s) == 1 else None
    near = only(pb)          # host the via beside pb (its single face)
    far = only(pa)           # run the far layer to pa
    if near is None or far is None or near == far:
        return dict(ok=False, reason='NOT_CROSS',
                    why='connect_cross needs two opposite single-layer pads '
                        '(%s on %s, %s on %s)'
                        % (pa['ref'], sorted(_pad_layers(pa)),
                           pb['ref'], sorted(_pad_layers(pb))))
    ox, oy = qb.ex0 - 2000000, qb.ey0 - 2000000
    fail = dict(ok=False, reason='NO_VIA_SITE',
                why='no reachable %s->%s via site for %s/%s'
                    % (near, far, pb['ref'], pa['ref']))
    for G_try in (G, fine):
        e = qb.escape(pb, near, w, w, cp, ct, G_try, ox, oy,
                      prefer=(pa['x'] - pb['x'], pa['y'] - pb['y']))
        if not e:
            return dict(ok=False, reason='NO_LEGAL_ESCAPE',
                        why=qb.escape_why[0], pad=pb['ref'])
        site = None
        for c in e[:6]:
            if voff:
                st = _offset_via_site(qb, near, far, net, c, w, vd, cp, ct,
                                      G_try, vk, off=voff)
            else:
                st = qb.via_site(near, far, net, c, w, vd, cp, ct, G_try,
                                 via_drill=vk)
            if st is not None:
                site = st
                break
        if site is None:
            continue
        vx, vy = site
        # Defensive: never lay a via that fails existing-via clearance (the
        # router's obstacle model is blind to existing barrels; the offset
        # picker enforces this, but re-prove it for every group unconditionally
        # so a via-blind site can never reach the gate).
        if not _clears_existing_vias(qb, vx, vy, net, vd, vk, cp):
            fail = dict(ok=False, reason='VIA_NEAR_EXISTING_VIA',
                        why='via site (%.3f,%.3f) within clearance of an '
                            'existing via barrel/hole' % (vx / 1e6, vy / 1e6),
                        pad=pb['ref'])
            continue
        m = qb.mark()
        qb.via(net, vx, vy, vd, vk)
        anchor = dict(ref='(via)', x=int(vx), y=int(vy), F=True, B=True,
                      anchor=True, net=net,
                      shape=QR.RR(int(vx), int(vy), 1, 1, 0, 0, net, 'via'),
                      hx=1, hy=1, r=0, ang=0, tht=False)
        rn = QR.connect_role(qb, net, pb, anchor, near, w, cp, ct, G=G_try)
        if not rn.get('ok'):
            qb.revert(m)
            fail = dict(ok=False, reason='NO_NEAR_RUN', why=rn.get('why'),
                        pad=pb['ref'])
            continue
        rf = QR.connect_role(qb, net, pa, anchor, far, w, cp, ct, G=G_try)
        if not rf.get('ok'):
            qb.revert(m)
            fail = dict(ok=False, reason='NO_FAR_RUN', why=rf.get('why'),
                        pad=pa['ref'])
            continue
        return dict(ok=True, mm=rn['mm'] + rf['mm'], vias=1,
                    layer='%s+%s via' % (far, near),
                    via_xy=[(round(vx / 1e6, 3), round(vy / 1e6, 3))],
                    why='cross-layer %s/%s through via 0.%03d/0.%03d mm at '
                        '(%.3f,%.3f)'
                        % (far, near, vd // 1000, vk // 1000,
                           vx / 1e6, vy / 1e6))
    return fail


def mst_edges(pads):
    """Prim MST over pad centres -> list of (i, j) index pairs."""
    n = len(pads)
    if n <= 1:
        return []
    INF = float('inf')
    intree = [False] * n
    best = [(INF, -1)] * n
    best[0] = (0.0, -1)
    edges = []
    for _ in range(n):
        u = min((i for i in range(n) if not intree[i]), key=lambda i: best[i][0])
        intree[u] = True
        if best[u][1] >= 0:
            edges.append((best[u][1], u))
        for v in range(n):
            if intree[v]:
                continue
            d = math.hypot(pads[u]['x'] - pads[v]['x'], pads[u]['y'] - pads[v]['y'])
            if d < best[v][0]:
                best[v] = (d, u)
    return edges


def route_hop_anchor_plan(qb, net, pads, group):
    """Execute an opt-in same-face endpoint hop plus existing-copper anchor.

    Some two-pad B.Cu endpoint pairs each have a legal local escape but live in
    disconnected free-space regions.  ``connect_hop`` is the already-qualified
    two-via answer: escape both pads on B.Cu and join them on a declared signal
    layer.  A later F.Cu terminal can then attach to the hop's first via as an
    owned-copper anchor instead of forcing the boxed endpoint to escape twice.

    The plan is registry-driven and absent by default, so the ordinary MST path
    and every pre-D-328 group remain byte-identical.
    """
    plan = group['hop_anchor_plan']
    by_ref = collections.defaultdict(list)
    for p in pads:
        by_ref[p['ref']].append(p)
    for ref in (plan['a'], plan['b'], plan['attach']):
        if ref not in by_ref:
            raise RuntimeError('hop_anchor_plan missing physical pad %s' % ref)
    pa = by_ref[plan['a']][0]
    pb = by_ref[plan['b']][0]
    attach = sorted(by_ref[plan['attach']], key=lambda p: (p['x'], p['y']))
    if len(attach) < 1:
        raise RuntimeError('hop_anchor_plan has no attach pad')
    w, cp, ct = group['width'], group['clr_pad'], group['clr_trk']
    vd, vk = group.get('via_dia', 600000), group.get('via_drill', 300000)
    out = []

    hop = QR.connect_hop(qb, net, pa, pb, w, cp, ct, near=group['layer'],
                         far=plan['far'], via_dia=vd, via_drill=vk)
    out.append((pa, pb, 'hop', hop))
    if not hop.get('ok'):
        return out

    vx, vy = (int(round(hop['via_xy'][0][0] * 1e6)),
              int(round(hop['via_xy'][0][1] * 1e6)))
    anchor = dict(ref='(hop-via)', x=vx, y=vy, F=True, B=True, anchor=True,
                  net=net, shape=QR.RR(vx, vy, 1, 1, 0, 0, net, 'via'),
                  hx=1, hy=1, r=0, ang=0, tht=False)
    joined = QR.connect_role(qb, net, attach[0], anchor, plan['far'],
                             w, cp, ct)
    # Journal/gate semantics are pad-to-pad: the anchor is copper already
    # connected to pa, so this realizes attach[0] <-> pa.
    out.append((attach[0], pa, 'anchor', joined))
    if not joined.get('ok'):
        return out

    for p in attach[1:]:
        joined = QR.connect_role(qb, net, attach[0], p, plan['far'], w, cp, ct)
        out.append((attach[0], p, 'same', joined))
        if not joined.get('ok'):
            break
    return out


def route_inner_long_haul_plan(qb, net, pads, group):
    """Reserve each outer endpoint, then join the two anchors on In2/In3."""
    if net in qb.wide_nets or group['width'] > 200000:
        raise RuntimeError('inner_long_haul_plan is low-speed signal only; wide/high-current net refused')
    plan = group['inner_long_haul_plan']
    by_ref = {p['ref']: p for p in pads}
    for ref in (plan['a'], plan['b']):
        if ref not in by_ref:
            raise RuntimeError('inner_long_haul_plan missing pad %s' % ref)
    pa, pb = by_ref[plan['a']], by_ref[plan['b']]
    w, cp, ct = group['width'], group['clr_pad'], group['clr_trk']
    vd, vk = group.get('via_dia', 600000), group.get('via_drill', 300000)
    inners = plan.get('inner', ['I2', 'I3'])
    if isinstance(inners, str):
        inners = [inners]
    last = None
    for inner in inners:
        mark = qb.mark()
        ra = QR.reserve_escape(qb, net, pa, w, cp, ct,
                               near=plan['a_near'], far=inner,
                               via_dia=vd, via_drill=vk,
                               target=(pb['x'], pb['y']))
        if not ra.get('ok'):
            qb.revert(mark); last = [(pa, pb, 'reserve-a', ra, inner)]; continue
        rb = QR.reserve_escape(qb, net, pb, w, cp, ct,
                               near=plan['b_near'], far=inner,
                               via_dia=vd, via_drill=vk,
                               target=(pa['x'], pa['y']))
        if not rb.get('ok'):
            qb.revert(mark); last = [(pa, pb, 'reserve-b', rb, inner)]; continue
        joined = QR.join_reserved(qb, net, ra['via'], rb['via'],
                                  w, cp, ct, layer=inner)
        if not joined.get('ok'):
            qb.revert(mark); last = [(pa, pb, 'inner-join', joined, inner)]; continue
        result = dict(joined)
        result['mm'] = ra.get('mm', 0) + rb.get('mm', 0) + joined.get('mm', 0)
        result['vias'] = 2
        result['via_xy'] = ra.get('via_xy', []) + rb.get('via_xy', [])
        result['why'] = ('reserved %s/%s outer escapes; joined on %s' %
                         (plan['a_near'], plan['b_near'], inner))
        return [(pa, pb, 'inner-haul', result, inner)]
    return last or [(pa, pb, 'inner-haul',
                     dict(ok=False, reason='NO_INNER_PLAN', why='no inner layer offered'),
                     'none')]


def route_connector_fanout_plan(qb, net, pads, group):
    """Fan a tight connector land to an inner layer, then attach local lands.

    The long haul is the qualified D-331 reserved-escape framework.  Only after
    both endpoint escapes and the inner join succeed do ordinary same-face
    local pads attach to the open-side anchor.  This keeps failed fanout trials
    transactional and avoids asking the long-haul router to cross the J1
    interior on F.Cu.
    """
    plan = group['connector_fanout_plan']
    member = dict(group)
    member['inner_long_haul_plan'] = {k: plan[k] for k in
                                      ('a', 'b', 'a_near', 'b_near', 'inner')}
    haul = route_inner_long_haul_plan(qb, net, pads, member)
    if not haul or not haul[-1][3].get('ok'):
        return haul
    by_ref = {p['ref']: p for p in pads}
    anchor = by_ref[plan['a']]
    out = list(haul)
    for ref in plan.get('attach', []):
        if ref not in by_ref:
            raise RuntimeError('connector_fanout_plan missing attach pad %s' % ref)
        r = QR.connect_role(qb, net, anchor, by_ref[ref], plan['a_near'],
                            group['width'], group['clr_pad'], group['clr_trk'])
        out.append((anchor, by_ref[ref], 'local-attach', r, plan['a_near']))
        if not r.get('ok'):
            break
    return out


# --------------------------------------------------------------------------- #
def cmd_baseline():
    """Record the authoritative fingerprints, DRC, ratsnest and target open-set."""
    b = pcbnew.LoadBoard(AUTH)
    b.BuildConnectivity()
    trk = [t for t in b.GetTracks() if t.GetClass() == 'PCB_TRACK']
    via = [t for t in b.GetTracks() if t.GetClass() == 'PCB_VIA']
    rats = b.GetConnectivity().GetUnconnectedCount(True)
    dc, _ = RU.drc(AUTH, 'Abase', WORK)
    jr = json.load(open(JOURNAL, encoding='utf-8'))
    res = dict(
        sha256=sha256(AUTH),
        tracks=len(trk), vias=len(via),
        copper_layers=b.GetCopperLayerCount(),
        ratsnest=rats, journal=len(jr),
        drc=dict(dc),
        phaseA_requested_pairs=[(e['net'], e['a'], e['b'])
                                for e in jr if e.get('requested_connected')],
    )
    json.dump(res, open(BASELINE_JSON, 'w'), indent=1)
    print('BASELINE authoritative board:')
    print('  sha256    ', res['sha256'])
    print('  tracks/vias/layers %d / %d / %d' % (res['tracks'], res['vias'], res['copper_layers']))
    print('  ratsnest  ', res['ratsnest'])
    print('  journal   ', res['journal'], '(requested pairs %d)' % len(res['phaseA_requested_pairs']))
    print('  DRC       ', dict(dc))
    return 0


def scratch_pcb(name):
    return os.path.join(WORK, 'INC_' + name, RU.PCBNAME)


def routing_wall_for(group):
    """Return advisory wall records matching a group's declared base nets."""
    if not os.path.exists(WALLS_JSON):
        return []
    data = json.load(open(WALLS_JSON, encoding='utf-8'))
    wanted = set(group.get('nets', []))
    return [w for w in data.get('walls', [])
            if wanted.intersection(w.get('nets', []))]


def enforce_wall_registry(name, group):
    """Block a disproven ordinary retry unless a replacement plan is explicit."""
    for wall in routing_wall_for(group):
        if not wall.get('do_not_retry'):
            continue
        replacement = bool(group.get('hop_anchor_plan') or
                           group.get('inner_long_haul_plan') or
                           group.get('inner_long_haul_plans') or
                           group.get('boxed_endpoint_plan') or
                           group.get('connector_fanout_plan'))
        if not replacement:
            raise RuntimeError(
                '%s is a registered routing wall (%s); select an allowed framework before retrying' %
                (name, wall.get('id', 'unknown')))


# --------------------------------------------------------------------------- #
# In1/In4 GND REFERENCE PLANES.  D-rules and [[fbv2-p2 In1/In4 GND roles]] pin
# In1.Cu and In4.Cu as the two solid GND reference planes.  A through via on a
# SIGNAL net crosses both, and the plane must open a clearance anti-pad around
# the barrel or DRC answers `clearance`/`hole_clearance` (measured: the first
# DISP_RST_N via, before any refill, showed 0.000 mm to both planes).  The B.Cu
# increments never laid a via so this never arose; the first via increment does.
# We therefore re-pour EXACTLY these two plane zones (and nothing else) when a
# via was laid -- every other zone, and every Phase-A track/via, is left byte-
# identical.  The plane fill is not byte-reproducible by the current KiCad
# ZONE_FILLER (a stored-vs-current drift of ~35 poly-points per plane exists
# independent of the via), so the re-pour is proven SAFE by the real full-board
# DRC being unchanged, not by byte-equality of the plane polygons.
def plane_zones(board):
    """The In1/In4 GND reference-plane zones (order-stable index + zone)."""
    out = []
    for i, z in enumerate(board.Zones()):
        lyrs = {pcbnew.BOARD.GetStandardLayerName(L)
                for L in z.GetLayerSet().CuStack()}
        if z.GetNetname() == 'GND' and lyrs and lyrs <= {'In1.Cu', 'In4.Cu'}:
            out.append((i, z))
    return out


def zone_fp(z):
    """Fingerprint a zone's identity + fill (net, layers, priority, points)."""
    lyrs = tuple(sorted(pcbnew.BOARD.GetStandardLayerName(L)
                        for L in z.GetLayerSet().CuStack()))
    pts = sum(z.GetFilledPolysList(L).FullPointCount()
              for L in z.GetLayerSet().CuStack())
    return (z.GetNetname(), lyrs, z.GetAssignedPriority(), pts)


def refill_planes(board):
    """Re-pour only the In1/In4 GND reference planes; return their indices."""
    planes = plane_zones(board)
    if planes:
        pcbnew.ZONE_FILLER(board).Fill([z for _, z in planes])
    return [i for i, _ in planes]


def cmd_route(name):
    group = GROUPS[name]
    enforce_wall_registry(name, group)
    pcb = RU.fresh(WORK, 'INC_' + name)          # copy of the authoritative project
    qb = QR.QBoard(pcb)
    # qrouter._scan omits existing vias; register them as obstacles on this
    # instance so escape/via_site/connect_role all respect accepted barrels
    # (FBV2-P2-012).  Add-only, per-route, generic; qrouter.py untouched.
    nvia_obs = inject_existing_via_obstacles(qb)
    nets = resolve_nets(qb, group)
    layer, w = group['layer'], group['width']
    cp, ct = group['clr_pad'], group['clr_trk']
    jrn = []
    print('ROUTE group %s on %s.Cu at %.3f mm (%s)' % (name, layer, w / 1e6, group['desc']))
    if nvia_obs:
        print('  injected %d existing-via obstacle(s) (qrouter._scan omits vias)' % nvia_obs)
    for base in group['nets']:
        nf = nets[base]
        # MST nodes are stable PHYSICAL pads (ref, x, y), NOT footprint pad
        # numbers, so a duplicate-number tact-switch terminal (D-325) is its own
        # node.  Ordinary nets have one land per number, so this is byte-
        # identical to the old ref-keyed order (ties broken by x,y never fire).
        pads = physical_net_pads(qb, nf)
        pads.sort(key=lambda p: (p['ref'], p['x'], p['y']))   # deterministic
        connector_plan = group.get('connector_fanout_plan')
        if connector_plan:
            for pa, pb, kind, r, used_layer in route_connector_fanout_plan(qb, nf, pads, group):
                rec = dict(net=base, netfull=nf, a=pa['ref'], b=pb['ref'],
                           layer=used_layer + '.Cu', w=w / 1e6,
                           ok=bool(r.get('ok')), mm=round(r.get('mm', 0), 3),
                           vias=r.get('vias', 0), via_xy=r.get('via_xy'),
                           kind=kind, reason=r.get('reason'), why=r.get('why'))
                jrn.append(rec)
                print('  %-12s %-8s -> %-8s [%-12s %s.Cu] %s %s'
                      % (base, pa['ref'], pb['ref'], kind, used_layer,
                         'ok %.3f mm' % r['mm'] if r.get('ok')
                         else 'FAIL ' + str(r.get('reason')),
                         r.get('why', '') or ''))
            continue
        inner_plan = (group.get('inner_long_haul_plan') or
                      group.get('inner_long_haul_plans', {}).get(base))
        if inner_plan:
            member_group = dict(group)
            member_group['inner_long_haul_plan'] = inner_plan
            for pa, pb, kind, r, inner in route_inner_long_haul_plan(qb, nf, pads, member_group):
                rec = dict(net=base, netfull=nf, a=pa['ref'], b=pb['ref'],
                           layer=inner + '.Cu', w=w / 1e6, ok=bool(r.get('ok')),
                           mm=round(r.get('mm', 0), 3), vias=r.get('vias', 0),
                           via_xy=r.get('via_xy'), kind=kind,
                           reason=r.get('reason'), why=r.get('why'))
                jrn.append(rec)
                print('  %-12s %-8s -> %-8s [%-10s %s.Cu] %s %s'
                      % (base, pa['ref'], pb['ref'], kind, inner,
                         'ok %.3f mm' % r['mm'] if r.get('ok')
                         else 'FAIL ' + str(r.get('reason')),
                         r.get('why', '') or ''))
            continue
        if group.get('hop_anchor_plan'):
            if len(group['nets']) != 1:
                raise RuntimeError('hop_anchor_plan requires a single-net group')
            for pa, pb, kind, r in route_hop_anchor_plan(qb, nf, pads, group):
                elabel = (('%s.Cu hop' % group['hop_anchor_plan']['far'])
                           if kind == 'hop' else
                           '%s.Cu' % group['hop_anchor_plan']['far'])
                rec = dict(net=base, netfull=nf, a=pa['ref'], b=pb['ref'],
                           layer=elabel, w=w / 1e6, ok=bool(r.get('ok')),
                           mm=round(r.get('mm', 0), 3),
                           vias=r.get('vias', 0), via_xy=r.get('via_xy'),
                           kind=kind, reason=r.get('reason'), why=r.get('why'))
                jrn.append(rec)
                print('  %-12s %-8s -> %-8s [%-6s %s] %s %s'
                      % (base, pa['ref'], pb['ref'], kind, elabel,
                         'ok %.3f mm' % r['mm'] if r.get('ok')
                         else 'FAIL ' + str(r.get('reason')),
                         r.get('why', '') or ''))
                if not r.get('ok'):
                    break
            continue
        for (i, j) in mst_edges(pads):
            pa, pb = pads[i], pads[j]
            el, kind = edge_plan(pa, pb, group)
            if kind == 'same':
                r = QR.connect_role(qb, nf, pa, pb, el, w, cp, ct)
                elabel, vias = el + '.Cu', 0
            else:
                r = connect_cross(qb, nf, pa, pb, group)
                elabel, vias = r.get('layer', 'cross'), r.get('vias', 0)
            rec = dict(net=base, netfull=nf, a=pa['ref'], b=pb['ref'],
                       layer=elabel, w=w / 1e6, ok=bool(r.get('ok')),
                       mm=round(r.get('mm', 0), 3), vias=vias,
                       via_xy=r.get('via_xy'), kind=kind,
                       reason=r.get('reason'), why=r.get('why'))
            jrn.append(rec)
            print('  %-12s %-8s -> %-8s [%-4s %s] %s %s'
                  % (base, pa['ref'], pb['ref'], kind, elabel,
                     'ok %.3f mm' % r['mm'] if r.get('ok') else 'FAIL ' + str(r.get('reason')),
                     r.get('why', '') or ''))
    # A through via crosses the In1/In4 GND planes; re-pour ONLY those two so
    # the barrel gets its clearance anti-pad.  No via -> no refill -> the B.Cu
    # increments stay byte-identical exactly as before.
    nvia = sum(1 for v in qb.laid if v.GetClass() == 'PCB_VIA')
    if nvia:
        idx = refill_planes(qb.b)
        print('  REFILLED %d In1/In4 GND plane zone(s) %s for %d new via(s) '
              '(anti-pad); all other zones untouched' % (len(idx), idx, nvia))
    qb.save(pcb)
    json.dump(jrn, open(os.path.join(WORK, 'INC_' + name, 'route_journal.json'), 'w'), indent=1)
    allok = all(r['ok'] for r in jrn)
    print('ROUTE %s: %s (%d connections, %d ok)'
          % (name, 'ALL OK' if allok else 'INCOMPLETE',
             len(jrn), sum(r['ok'] for r in jrn)))
    print('  scratch board:', pcb, '(authoritative UNTOUCHED)')
    return 0 if allok else 1
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
