aqroot8/aqroot/hardware/beta-v2/checks/p1_mech_render.py

#!/usr/bin/env python3
"""AQROOT Full Beta v2 - FBV2-P1 mechanical review drawing.

Draws the enclosure cavity, the PCB outline and every FBV2-P1 mechanical
reservation into one legible SVG, in the P1 doc datum (origin lower-left,
Y up).  The KiCad layer plots beside it are the authority for what is IN the
board file; this drawing exists so the relationships can actually be read.

    python hardware/beta-v2/checks/p1_mech_render.py out.svg
"""
import sys, os, math
sys.path.insert(0, os.path.dirname(os.path.abspath(__file__)))
import p1_geometry as G

SCALE = 5.0          # px per mm
PAD = 26.0           # mm of paper around the cavity
LEGEND_W = 84.0      # mm of legend column


def build():
    x0, y0, x1, y1 = G.CAVITY
    W = (x1 - x0 + 2 * PAD + LEGEND_W) * SCALE
    Ht = (y1 - y0 + 2 * PAD) * SCALE
    ox, oy = (PAD - x0) * SCALE, (PAD - y0) * SCALE

    def X(v):
        return ox + v * SCALE

    def Y(v):
        return Ht - (oy + v * SCALE)

    s = []
    a = s.append
    a('<svg xmlns="http://www.w3.org/2000/svg" width="%.0f" height="%.0f" '
      'viewBox="0 0 %.0f %.0f">' % (W, Ht, W, Ht))
    a('<rect width="100%" height="100%" fill="#ffffff"/>')
    a('<g font-family="DejaVu Sans, Verdana, sans-serif">')
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
