aqroot8/aqroot/(commit log)

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2026-07-07 Update vault notes to reflect first firmware implementation pass
    Mark the display/touch, launcher, radio, NFC, and sensors/audio driver work as
    implemented in the OS Architecture and Build TODO Tracker notes, and record the
    decisions made during the build (ESP-IDF -> Arduino framework, espressif32@6.9.0 pin,
    ILI9341-as-AMOLED placeholder, generic-IMU-over-dedicated-lib, Wokwi SIMULATION_MODE)
    in the Design Decisions Log. Add firmware follow-ups (RM69090 swap, IMU part lock, IR
    driver, pin reconciliation, on-device validation).
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2026-07-16 Add Beta Pin Map v0.2 - three-way review corrections + ILI9341 display decision (AMOLED to stretch goal)
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2026-07-20 Session save: BMI270 IMU validated, TPS63020 regulator, RF/antenna plan v0.1, 433 external antenna + side-holder decision, power incident + reverse-polarity requirement
2026-07-20 Add 12 - RF and Antenna Plan v0.1 content (resolves link referenced in session save)
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2026-07-21 Docs: make 05 Decisions Log the trustworthy source of truth
    Add supersede banners matching the existing Display convention to every stale
    entry, and add the two missing decision entries.
    - Radio: strike the "one chip covers both" hedge; replace the "Alpha build only /
    final design still open" note with a LOCKED dual-radio production decision
    (CC1101 + SX1262 both core). Beta pin map v0.2 already commits pins to both.
    - NFC: banner the dead PN532 plan; add the missing ST25R3916 LOCKED entry
    (SPI not I2C, 5V PA rail, firmware driver + BOM swap required).
    - PCB assembly line: PN532 IC -> ST25R3916 + both radio module footprints.
    - Power: banner 1000mAh and ~8hr -> 2000mAh / ~12-15hr per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
2026-07-21 Docs: add 15 - Enclosure Field Slate v3 (resolves missing dependency)
    Docs 12 and 14 both cite "enclosure v3" as authoritative for antenna zoning,
    crown volume, rear NFC placement, expansion-zone location and mechanical red
    lines, but no such doc existed in the repo — the spec lived only in Google Drive.
    Every RF conclusion in doc 12 rests on this envelope.
    Captures: concept + RF crown, ~122x61x23.5mm / 135-165g / "Graphite Root",
    PC+ABS injection path with FDM -> MJF PA12 -> pilot -> IM staging, the zoning
    table docs 12/14 reference, power requirements incl. mandatory reverse-polarity
    protection and a non-reversible battery tray, two-tier expansion, and the 433
    external antenna + side-ho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
2026-07-21 Docs: propagate locked decisions into the stale downstream docs
    Carries the 05 decisions outward. Display -> ILI9341 2.8in IPS + FT6236 @ 0x38;
    radio -> DUAL CC1101 + SX1262; NFC -> ST25R3916 over SPI; battery -> 2000mAh /
    ~12-15hr; dimensions -> Field Slate v3 ~122x61x23.5mm.
    - 00: pitch no longer says "AMOLED UI"; dimensions updated; dual-radio named as
    the wedge.
    - 01: display/NFC/IMU/audio/power rows corrected; CC1101 added as its own core
    row; TPS63020 rail row added; charge mgmt MCP73871 -> bq25185 + reverse-polarity
    requirement; antenna section rewritten per doc 12 zoning; stale "Alpha
    deviations" note replaced with a coexistence note now that the table is right.
    - 03: radio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
2026-07-21 Firmware: correct part identity in comments; no driver rewrites
    Documentation-level pass only. The PN532->ST25R3916 rewrite and the CC1101
    driver are real engineering tasks and are listed in 07 - Build TODO Tracker
    rather than attempted here. Both build environments verified compiling.
    Trivially-correct constants changed:
    - config.h: TOUCH_I2C_ADDR 0x15 -> 0x38. The FT6236 and the CST816 this was
    written against share the same read layout at register 0x02 (count, then
    12-bit X/Y with the high nibble masked), so touch.cpp's transfer logic is
    correct as-is and only the address was wrong.
    - touch.cpp: CST816_REG_TOUCH -> TOUCH_REG_POINT (part-neutral name).
    Comment corrections:
    - config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
    [config.h, display.h, main.cpp, nfc.cpp, nfc.h, nfc_screen.cpp, nfc_screen.h]
2026-07-21 Firmware: fix remaining inverted-placeholder framing in display.cpp/main.cpp
    Missed in the previous pass. display.cpp still described the ILI9341 as a
    "PLACEHOLDER PANEL CONFIG" standing in for an unsourced RM69090 - the exact
    inversion flagged in the audit, since the ILI9341 is the real part and the AMOLED
    is the conditional one. Reframed: ILI9341 is the Beta panel; RM69090 is a
    stretch-goal board revision (QSPI, hence a revision rather than a drop-in), and
    the resolution-independent UI is what keeps that swap driver-only if funded.
    Also main.cpp + platformio.ini: CST816 -> FT6236 / "capacitive-touch model".
    Both build environments re-verified compiling.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
    [display.cpp, main.cpp]
2026-07-21 Resolve 433 antenna stance (base cert vs advanced accessory) + append HARDWARE-NOTES corrections (preserve bench log)
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2026-07-26 Pre-schematic corrections: fix MCP23017 pin count + GPIO43/44 labels; IR TX->GPIO16; reclaim GPIO21 via expander resets; 2nd expander for buttons/header; I2C isolation + hybrid header + button-wake r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
    Source: pre-schematic design review. Applied immediately before KiCad capture.
    Factual fixes:
    - MCP23017 has 16 fully bidirectional GPIO, not "14 + 2 output-only (GPA7/GPB7)".
    Removed all output-only notes; recalculated every downstream pin budget, including
    the "~7 slow GPIO" community-header figure that derived from the error.
    - GPIO43 = U0TXD, GPIO44 = U0RXD (were reversed).
    Design changes:
    - IR TX GPIO43 -> GPIO16 (boot log on U0TXD would fire the LED MOSFET every reset;
    a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
2026-07-26 Resolve pin budget: keep GPIO21-wake/GPIO43-header swap; XGPIO15=ACC_PWR_EN (header XGPIO0-14); A=select (no D-pad center); RootProbe IRQ on expander (Phase 2)
    Closes the three open items from the pre-schematic review. Pin map -> v0.2.2.
    1. GPIO21/GPIO43 swap APPROVED, flag removed from the blocking list.
    GPIO21 = expander button-wake INT, GPIO43 = header fast pin. Rationale recorded:
    wake capability is a hard silicon constraint (RTC domain = GPIO0-21 only, and a
    polled expander cannot wake the ESP32 at all), while the header fast pin is
    pin-number-agnostic. The constrained role takes the constrained pin.
    2. ACC_PWR_EN reserved on 0x21 GPB7; community header publishes XGPIO0-14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
2026-07-26 Close pre-schematic items: multiplex GPIO43 as RootProbe CS (native budget genuinely closed); record header IRQ/GPIO43 protection + I2C sequencing as schematic requirements; deep-sleep figure marked 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
    Second design review close-out. Pin map -> v0.2.3.
    1. RootProbe SPI CS resolved by MULTIPLEXING GPIO43. Net label:
    "FAST_IO / U0TXD / ROOTPROBE_CS". Community-header fast pin OR RootProbe chip
    select - mutually exclusive, same physical interface, never both at once.
    Firmware arbitrates via I2C enumeration; the combination is unsupported.
    This fixes a logical contradiction, not just an open item: the previous revision
    declared the native budget "closed with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
2026-07-30 AQROOT Beta: add ILI9341/FT6236 and CC1101 functional placeholder symbols
    Both are schematic-only functional placeholders in the project symbol
    library. Neither has a footprint, and both are marked on_board=no so
    they cannot reach the PCB, while staying in_bom=yes so they remain
    visible as unresolved required subsystems.
    ILI9341_FT6236_MODULE_PLACEHOLDER (J, 13 logical pins)
    LCD SPI/control left, touch I2C/reset/interrupt right, VCC top,
    GND bottom. CTP_INT_N is a no-connect because AQROOT polls the
    FT6236 (expected address 0x38). No connector, pin numbering,
    flex-cable pinout or module dimensions are claimed.
    CC1101_RADIO_PLACEHOLDER (U, 8 logical pins)
    SPI/control left, RF_ANT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
2026-07-31 AQROOT Beta: add SX1262 module placeholder symbol; ignore .history/
    SX1262_MODULE_PLACEHOLDER (U, 10 logical pins)
    Functional schematic placeholder for the built-in certified SX1262
    LoRa/sub-GHz module -- the second of AQROOT Beta's two radios, on
    shared SPI Bus B alongside the CC1101 and NFC.
    SPI and control pins left (SCK, MOSI, MISO, CS_N, BUSY, DIO1,
    RESET_N), RF_ANT (passive) right, VCC_3V3 top, GND bottom. Pin
    numbers are hidden logical indices, not a module pinout. No footprint,
    no ki_fp_filters, on_board=no so it cannot reach the PCB, in_bom=yes
    so it stays visible as an unresolved required subsystem.
    Modelled as a MODULE, not a bare IC: crystal/TCXO, RF matching,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
2026-07-31 Reverse-polarity: park LTC4368-1 + back-to-back NFET as leading candidate; final lock deferred to professional power review; requirement + rejected options + Beta test card recorded
    The topology is PARKED as a documented leading candidate, not selected. The
    remaining open question -- does normal ~1A charging current flowing VOUT->VIN
    trip the controller's reverse-current sense -- needs an LTspice model of the
    LTC4368 charge-path case plus likely an ADI FAE confirmation. That is
    specialist analog work, best done once by the power review rather than
    iterated at here. It occupies one corner of the power tree and must not stall
    the rest of the board.
    LEADING CANDIDATE (not locked)
    Controller: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
2026-07-31 Power tree: document final Beta capture decisions
    Records the Beta capture decisions for the TPS63020 3.3V block, the USB-C
    5V sink / USB 2.0 front end, the TPS61023 NFC 5V PA boost, the MAX17048
    fuel gauge, and the physical main-rail hard-off switch.
    Supersedes the earlier permanently-populated R_EN_LINK 0R VINA-to-EN
    "always-on default" for the TPS63020. A physical SPST maintained switch
    now drives EN with R_EN_PULLDOWN 100k; the old link survives only as
    R_EN_BYPASS 0R DNP. A populated permanent link in parallel with a switch
    that pulls EN low would defeat the OFF position and short VINA to GND.
    Corrected in six documents.
    Hard-off is described throughout as HARD-OFF FOR MAIN +3V3 SYSTE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
2026-08-05 Schematics: root connectivity pass for XGPIO, I2C_SDA_INT and NFC_5V_PA_PENDING
    Work-in-progress checkpoint of the root-level connectivity pass. Verified with
    kicad-cli netlist and ERC comparison against the previous commit.
    Resolved:
    - NFC_5V_PA_PENDING was split across two isolated sheet-local nets,
    /01_POWER_TREE/NFC_5V_PA_PENDING (C34.2 C35.1 R44.2 TP9.1 U13.6) and
    /04_SPI_B_RADIOS_NFC/NFC_5V_PA_PENDING (C19.1 alone). Promoted the local
    label in 04_spi_b_radios_nfc to a hierarchical input label, added the
    matching sheet pin on the root, and extended the wire to reach it. These
    now form a single root net /NFC_5V_PA_PENDING with all 6 nodes.
    - I2C_SDA_INT: U14.8 was stranded on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
    [04_spi_b_radios_nfc.kicad_sch, aqroot-Beta.kicad_sch]
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2026-08-05 Symbols: name TPD2E009DBZR channel pins IO1 and IO2
    Rename the two channel pins of the project-local TPD2E009DBZR symbol from a
    shared "IO" name to IO1 (pin 1) and IO2 (pin 3), matching TI's I/O1 / I/O2
    labelling and making the two independent ESD channels distinguishable in the
    symbol.
    Also correct the Note property, which still claimed both pins were named IO.
    Names only. Pin numbers, electrical types (passive / power_in / passive),
    positions, lengths, body geometry, footprint and all other properties are
    unchanged. Validated with kicad-cli parse and SVG export.
2026-08-05 AQROOT Beta: restore WAKE_INT_N hierarchy connectivity
    Fixes a connectivity regression introduced before 96ff3e5 (in 756f248), which
    left ESP32-S3 U1 pin 23 isolated on its own sheet-local net
    /02_MCU_CORE/WAKE_INT_N.
    Restores the ESP32 GPIO wake connection by adding the root-level wire segment
    (152.4, 24.13) to (152.4, 25.4), reconnecting the root WAKE_INT_N label to the
    02_MCU_CORE hierarchical sheet pin at (152.4, 25.4).
    Verified with a scratch kicad-cli netlist export:
    - /WAKE_INT_N now has 4 nodes: R3.1, U1.23, U2.1, U3.1
    - U1 = ESP32-S3-WROOM-1 in /02_MCU_CORE/
    - U2, U3 = TCA9535PWR expanders and R3 = 10k in /08_BUTTONS_EXPANDERS/
    - root sheet pins present: 02_MCU_CORE (input), 08_BU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
    [aqroot-Beta.kicad_sch]
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2026-08-05 AQROOT Beta: fix accessory rail naming and I2C grounding
    Three contained fixes in 09_COMMUNITY_HEADER. Verified with scratch kicad-cli
    netlist and ERC comparison against ec0a428.
    - Restores the ACC_3V3_SW net name. The empty label at (273.05, 99.06) that
    KiCad was resolving in preference to ACC_3V3_SW is removed, and the rail
    label is re-placed at (274.32, 99.06). The rail now exports as
    /09_COMMUNITY_HEADER/ACC_3V3_SW with the expected 9 nodes: U15.6, U16.8,
    C38.1, C42.2, R46.2, R49.2, R50.2, TP12.1 and J5.26. No <NO NET> rail and no
    multiple_net_names violation remain.
    - Grounds the TCA9517A directly. U16 pin 4 now joins the board GND net via a
    wire from (218.44, 90.17) to a G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
    [09_community_header.kicad_sch]
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2026-08-05 Symbols: add TI TPD4E1B06 four-channel ESD array
    Add a project-local symbol for the Texas Instruments TPD4E1B06DRLR
    four-channel bidirectional ESD protection diode array to
    - DRL / SOT-563 pin mapping verified from TI SLVSBQ8E Rev. E, Table 4-1,
    DRL package column: 1 IO1, 2 GND, 3 IO2, 4 IO3, 5 NC, 6 IO4.
    - The DCK mapping is intentionally not used. The DCK package uses different
    pin numbering and must not be substituted for this symbol.
    - Pin 5 is NC. TI states it has no internal connection and does not need to be
    routed, so it is exposed as a no_connect pin and correctly left unconnected.
    - Electrical types: IO1, IO2,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
2026-08-05 AQROOT Beta: qualify TP6 and TP7 test-point footprint library
    Prefix the TP6 and TP7 footprint values in 01_power_tree.kicad_sch with their
    library name:
    TestPoint_Pad_D1.0mm -> TestPoint:TestPoint_Pad_D1.0mm
    Both were bare footprint names with no library prefix, which KiCad could not
    resolve. They were the sole source of the two footprint_link_issues ERC
    warnings ("The current configuration does not include the footprint library
    ''"). This brings them in line with TP8-TP12, which already use the qualified
    form.
    ERC total 234 -> 232, footprint_link_issues 2 -> 0, with no other category
    changed. Property values only: 2 changed lines, no connectivity, symbol or
    geometry changes. Verified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
    [01_power_tree.kicad_sch]
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2026-08-06 AQROOT Beta: complete community-header hierarchy integration
    Connects XGPIO0-14 between U3 (TCA9535 port expander, sheet 08) and the
    100R series resistors R51-R65 on sheet 09, replacing the 15 sheet-local
    /08_BUTTONS_EXPANDERS/XGPIOx fragments with root-level /XGPIOx nets.
    Connects ACC_PWR_EN between U3 pin 20 (P17) and the accessory rail
    control: U15 pin 3 (TPS22918 ON) and U16 pin 5 (TCA9517A EN), joining
    the existing R17 100k pull-down on one root-level /ACC_PWR_EN net. The
    accessory load switch and I2C buffer enable are now actually driven by
    U3 rather than floating.
    Adds the missing FAST_IO boot-log warning note to sheet 09: FAST_IO is
    U0TXD and emits the UART boot log at reset, so it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
    [09_community_header.kicad_sch, aqroot-Beta.kicad_sch]
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2026-08-06 AQROOT Beta: wire MCU core root interfaces
    Adds a short root wire and a matching local root label to each of the 27
    02_MCU_CORE sheet pins that had no root connection, joining the MCU side
    of every interface to the peripheral-side root label that already existed
    under the identical name.
    Repaired signals (27):
    SPI_A_SCK SPI_A_MOSI SPI_A_MISO DISP_CS_N SD_CS_N
    SPI_B_SCK SPI_B_MOSI SPI_B_MISO CC1101_CS_N CC1101_GDO0
    SX1262_CS_N SX1262_BUSY SX1262_DIO1 NFC_CS_N NFC_IRQ
    DISP_DC DISP_BL_CTL USB_D_P_MCU USB_D_N_MCU
    I2S_BCLK I2S_LRCLK I2S_SPK_DOUT I2S_MIC_DIN
    IR_TX_GPIO16 IR_RX_GPIO44 BMI270_INT1_STRAP
    FAST_IO_U0TXD_ROOTPROBE_CS
    All 30 02_MCU_CORE sheet pins are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
    [aqroot-Beta.kicad_sch]
2026-08-06 AQROOT Beta: wire expander control root interfaces
    Adds a short root wire and a matching local root label to the
    08_BUTTONS_EXPANDERS sheet pins that had a locked peripheral root
    interface, joining the U2 expander side to the destination that already
    existed at root level under the identical name.
    Repaired (5):
    TOUCH_RST_N U2.4 + R12 -> 03_SPI_A_DISPLAY_SD
    SX1262_RST_N U2.5 + R13 -> 04_SPI_B_RADIOS_NFC
    NFC_5V_EN U2.6 + R14 -> 01_POWER_TREE (U13 TPS61023 EN, TP10)
    AMP_SD_MODE U2.7 + R15 -> 06_AUDIO (U5 ~SD_MODE)
    DISP_RST_N U2.8 + R16 -> 03_SPI_A_DISPLAY_SD
    Not wired (4), reported rather than guessed:
    RGB_R_CTL, RGB_G_CTL, RGB_B_CTL no consumer exists anywhere in the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
    [aqroot-Beta.kicad_sch]
2026-08-06 AQROOT Beta: terminate deferred expander sheet pins at root
    Adds a short root wire and matching local root label to the four
    08_BUTTONS_EXPANDERS sheet pins that have no consumer anywhere in the
    project, promoting each net from sheet-local to root scope:
    RGB_R_CTL U2.9
    RGB_G_CTL U2.10
    RGB_B_CTL U2.11
    ROOTPROBE_IRQ_READY_N R11.2, U2.20
    These labels connect the pins to nothing -- no consumer exists to connect
    them to. They terminate the hierarchical sheet pins so the signals are
    addressable at root level when their Phase 2 circuitry lands. Net
    membership is byte-identical before and after; only the net names change
    from /08_BUTTONS_EXPANDERS/<s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
    [aqroot-Beta.kicad_sch]
2026-08-06 ERC: document intentional deferred exclusions (reverse-pol/RGB/RootProbe/RF-TBD); punch-list real fixes for KiCad
    Classifies 20 of the 48 remaining ERC items as intentional Beta-scope
    deferrals and records them as narrowly scoped, per-violation exclusions in
    aqroot-Beta.kicad_pro. Each exclusion is keyed to a specific item UUID and
    carries a comment explaining why.
    Excluded (20), by group:
    reverse-polarity parked (5)
    2x unconnected_wire_endpoint on the parked BAT stubs
    2x isolated_pin_label BAT_CONNECTOR_P
    1x label_dangling BAT_PROTECTED_P
    "reverse-polarity topology parked -> post-Kickstarter power review;
    BAT_CONNECTOR_P/BAT_PROTECTED_P intentionally distinct.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
    [01_power_tree.kicad_sch]
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2026-08-07 AQROOT Beta: preserve manual P0 fixes (TPS61023 FB divider, BQ25185 TS_MR)
    Manual KiCad-GUI fixes made after 6752726, previously uncommitted.
    U13 (TPS61023) FB: pin 1 now joins the R44/R45 divider midpoint.
    Net-(U13-FB) = {R44.1, R45.1, U13.1}; R44.2 -> NFC_5V_PA_PENDING,
    R45.2 -> GND. R44=732k 1%, R45=100k 1% unchanged. FB no longer floating.
    U11 (BQ25185) TS_MR: pin 6 now hard-wired to R38; R38 and its GND symbol
    relocated to sit beside the pin and the stray 'TS_MR' label removed.
    Net-(U11-TS_MR) = {R38.1, U11.6}; R38.2 -> GND. R38=10k 1% unchanged.
    Verified by netlist export and ERC diff against HEAD: resolves exactly 4
    real ERC items (U13.1 pin_not_connected + pin_not_driven,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
    [01_power_tree.kicad_sch]
2026-08-07 AQROOT Beta: KiCad 10.0.3 re-serialization of project and root sheet (no design change)
    Written by the KiCad GUI when the project was opened for the manual P0
    fixes. Verified semantically inert:
    aqroot-Beta.kicad_pro - erc_exclusions migrated from a flat string array to
    the newer [key, comment] pair form with a trailing '|||' on each key.
    Parsed and compared against HEAD: the 20 exclusion keys are the same set,
    the 46 erc.rule_severities are identical, erc.pin_map is identical, and
    the 20 erc_exclusion_comments keys are identical. No exclusion added,
    removed or broadened; no ERC severity changed.
    aqroot-Beta.kicad_sch - element reordering only. 119 labels and 119 wires
    before a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
    [aqroot-Beta.kicad_sch]
2026-08-07 Symbols: correct TPS63020 VOUT electrical type (pin 5 power_out -> passive)
    TPS63020 declared both VOUT pins (4 and 5) as Power output, so ERC raised
    'Pins of type Power output and Power output are connected' on +3V3.
    Pin 4 stays Power output (the rail driver); pin 5 becomes Passive. This
    mirrors the convention already used by Audio:MAX98357A in this project,
    where VDD pin 7 is power_in and the duplicate pin 8 is passive.
    Applied identically to AQROOT_Beta.kicad_sym and the lib_symbols cache in
    01_power_tree.kicad_sch (the only sheet caching this symbol) so the two do
    not desync. Verified after edit: both report pin 4 power_out / pin 5
    passive, with pin numbers, names, positions, lengths a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
    [01_power_tree.kicad_sch]
2026-08-07 AQROOT Beta: correct sheet-local hierarchical labels
    Eight labels were declared hierarchical but have no matching sheet pin in
    the parent, raising hier_label_mismatch. They are sheet-local signals, so
    they become plain local labels.
    08_buttons_expanders.kicad_sch (7): BTN_UP_N, BTN_DOWN_N, BTN_LEFT_N,
    BTN_RIGHT_N, BTN_A_N, BTN_B_N, BTN_HOME_N
    05_i2c_devices.kicad_sch (1): BMI270_INT1_RAW
    Each edit retags the element and drops its (shape ...) line only. Names,
    coordinates, rotations, text effects and UUIDs are unchanged; no wire,
    junction or symbol was touched.
    Verified with kicad-cli: netlist pin-to-net mapping is byte-identical
    before and after (149 nets either side) - zero electrical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
    [05_i2c_devices.kicad_sch, 08_buttons_expanders.kicad_sch]
2026-08-07 AQROOT Beta: correct I2C SCL test point
    TP5 probed a dead net: its label read I2C_SCL_TEST, a name carried by
    nothing else, so the net contained only TP5 and ERC raised
    isolated_pin_label.
    TP4 is the working reference - its Value property is I2C_SDA_TEST while the
    label on its wire is I2C_SDA_INT, so the test point sits on the real bus.
    TP5 now mirrors that exactly: the label on its wire becomes I2C_SCL_INT and
    the Value property stays I2C_SCL_TEST, matching TP4's convention.
    One label name changed. No symbol, wire, junction or property was touched;
    TP5's own wire (198.12 76.2)-(198.12 80.01) already ran to the label
    position, exactly as TP4's does.
    Verified with kicad-cli:
    /I2C_SCL_INT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
    [05_i2c_devices.kicad_sch]
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2026-08-07 Symbols: correct BQ25185 BAT electrical type
    BQ25185 pin 2 BAT was typed bidirectional - a logic-signal type - so ERC
    warned when the BAT_PROTECTED_P PWR_FLAG (power_out) shared the net with
    it. BAT is a battery power terminal, not a signal, and passive is the
    correct KiCad type for it.
    Changed: pin 2 BAT bidirectional -> passive, in AQROOT_Beta.kicad_sym and
    the lib_symbols cache in 01_power_tree.kicad_sch (the only sheet caching
    BQ25185), edited together so the two cannot desync.
    Unchanged: pin number, pin name, position, length, graphic style, and all
    ten other pins - verified pin-by-pin identical in both files. Footprint,
    circuit wiring and the PWR_FLAG itself untouched. The flag stays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
    [01_power_tree.kicad_sch]
2026-08-07 ERC: document four intentional pin-type semantic warnings
    Adds four narrowly scoped, per-violation ERC exclusions for warnings that
    arise from KiCad pin-type semantics on connections verified correct. Each
    is keyed to a specific violation UUID pair and carries a comment.
    BMI270 U4.1 SDO <-> GND PWR_FLAG
    "BMI270 SDO strapped to GND for I2C address selection; bidirectional
    pin type is datasheet-correct."
    BMI270 U4.2 ASDx <-> +3V3 (U12.4 VOUT)
    BMI270 U4.3 ASCx <-> +3V3 (U12.4 VOUT)
    "BMI270 unused auxiliary interface pin tied to VDDIO per datasheet;
    bidirectional symbol type retained intentionally."
    MAX98357A U5.17 PAD <-> GND
    "MAX98357A exposed thermal pad inten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
2026-08-07 AQROOT Beta: add TPS63020 enable bypass DNP option
    R_EN_BYPASS was specified in the docs but absent from the schematic.
    Endpoints are unambiguous in the repo:
    05 Decisions Log 'The superseded 0R link': R_EN_LINK = 0R (VINA->EN) is
    withdrawn and 'survives only as R_EN_BYPASS = 0R, DNP - VINA -> EN, bench
    bypass only if the physical switch is unavailable.'
    01 Hardware Core repeats it: 'surviving only as R_EN_BYPASS 0R DNP
    (never firmware-driven)'.
    Resolved against the schematic: TPS63020 VINA is U12 pin 1 on
    /BQ25185_SYS; EN is U12 pin 12 on Net-(SW9-B). So the part sits exactly in
    parallel with the SPST hard-off switch SW9, which spans the same two nets.
    Added R68 = 0R, dnp yes,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
    [01_power_tree.kicad_sch]
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2026-08-07 Docs: lock ST25R3916-AQET for Beta
    The repo recorded the NFC package as unselected - libraries/README.md read
    'MPN ST25R3916 - no package suffix, because the package is not selected'.
    The standing Beta decision fixes it, so the docs now say so.
    Part STMicroelectronics ST25R3916-AQET
    Architecture DISCRETE ST25R3916 - not a plug-on NFC module
    Antenna ST reference-derived tuned PCB loop, rear face
    Matching ST reference matching network, not an in-house design
    Recorded in 05 - Design Decisions Log (new dated section plus a forward
    pointer on the existing 'NFC part: ST25R3916 (LOCKED)' entry), in
    01 - Hardware Core (NFC row), and annotated in the KiCad libraries README.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
2026-08-07 Docs: record MAX17048 package metadata; footprint NOT locked
    Footprint verification FAILED, so no footprint was assigned - U14 and the
    MAX17048 symbol stay blank. This records the package metadata and the
    finding, per the documentation step.
    Metadata (markdown previously had none of it - zero hits for T822,
    21-0168, 90-0065):
    MPN MAX17048G+T10
    Package 8-pin TDFN-EP, 2 x 2 mm, 0.5 mm pitch, exposed pad
    Package code T822+3
    Outline 21-0168
    Land pattern 90-0065
    Why no assignment:
    1. The proposed candidate is the WRONG MANUFACTURER.
    Package_DFN_QFN:DFN-8-1EP_2x2mm_P0.5mm_EP0.9x1.5mm declares in its own
    descr that it derives from the M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
2026-08-07 AQROOT Beta: lock resolved power and IR component metadata
    Records exact MPN / manufacturer / package metadata for four parts whose
    selection is now locked. Footprints deliberately left BLANK - locking a part
    and verifying its land pattern are separate gates.
    L1 XFL4020-152MEC Coilcraft 1.5uH (was '1.5uH XFL4020-152MEC')
    L2 74438357010 Wurth Elektronik 1uH (was '1uH SHIELDED')
    Q1 AO3400A Alpha & Omega Semiconductor AO3400A (was 'NMOS_TBD')
    U16 TCA9517ADGKR Texas Instruments TCA9517ADGK (value unchanged)
    Instance-level properties only, on stock symbols (Device:L,
    Transistor_FET:Q_NMOS_GSD, Logic_LevelTransla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
    [01_power_tree.kicad_sch, 07_ir.kicad_sch, 09_community_header.kicad_sch]
2026-08-07 AQROOT Beta: lock mechanical component selections
    Records exact MPN / manufacturer / package metadata for the mechanical
    parts. All four footprints stay BLANK - every one needs a vendor drawing.
    SW9 JS102011SAQN C&K (Littelfuse) right-angle SMD SPDT slide
    J2 5025700893 Molex SMT push-push microSD, 8 contacts
    LS1 CMS-1535-058SP Same Sky (CUI) 15 mm round 8 ohm solder-pad
    J1 Adafruit 2770 Adafruit 2.8in 240x320 + FT6236U cap touch
    SW9 - SYMBOL/PART CONFLICT FOUND, NOT PAPERED OVER:
    JS102011SAQN is a 3-terminal SPDT, but this instance uses Switch:SW_SPST
    which has only two pins (A,B). Any correct land pattern for this part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
    [01_power_tree.kicad_sch, 03_spi_a_display_sd.kicad_sch, 06_audio.kicad_sch]
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2026-08-07 AQROOT Beta: match hard-off switch to JS102011SAQN
    The locked C&K JS102011SAQN is a 3-terminal SPDT; SW9 used the 2-pin
    Switch:SW_SPST, which no correct land pattern could match. C&K JS-series
    documentation confirms terminal 2 = C = common/pole, so the symbol is now
    SPDT with all three physical terminals exposed.
    terminal 2 common -> /01_POWER_TREE/BQ25185_SYS (symbol pin 2)
    terminal 1 used throw -> EN net -> U12.12 (symbol pin 1)
    terminal 3 unused throw-> explicit no-connect (symbol pin 3)
    SW9 stays at (190.5, 63.5) rot 270, so common lands exactly on the existing
    BQ25185_SYS wire endpoint (190.5, 58.42) with no rewiring on that side. Added
    one 2.54 m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
    [01_power_tree.kicad_sch]
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2026-08-07 Footprints: add verified power component land patterns
    Creates and assigns vendor-exact land patterns for both power inductors. The
    land-pattern ambiguity that blocked these last pass is resolved: the pages
    were rasterized with PyMuPDF and the dimension leader lines read visually, so
    which callout attaches to which geometry is now known rather than inferred.
    NEW project-local footprints:
    AQROOT_Beta:Coilcraft_XFL4020
    Coilcraft doc 745-3 rev 03/10/26 'Recommended Land Pattern'
    pad 0.98 x 3.4 mm, 2.37 mm centre-to-centre
    body 4.0 x 4.0 mm, 2.10 mm max height
    silkscreen bar on +X marks terminal direction / start (short) lead -
    connect high dv/dt there for lowest EMI, per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
    [01_power_tree.kicad_sch]
2026-08-07 Footprints: verify AO3400A SOT-23; record third-pass results
    Q1 AO3400A assigned Package_TO_SOT_SMD:SOT-23 as VERIFIED_IPC_ALTERNATE.
    AOS publishes package geometry separately from the device datasheet - at
    res/package/SOT23.pdf, doc PO-00001 rev N - which is why the earlier pass
    found nothing. Retrieved and rasterized:
    AOS recommended land : pads 0.80 x 0.80, row-to-row 2.40, pitch 0.95
    AOS package : e 0.95 BSC, e1 1.90 BSC, D 2.90, E 2.80, E1 1.60,
    b 0.40 (all nominal)
    KiCad SOT-23 : 3 pads, pitch 0.95 EXACT, same 2+1 lead arrangement,
    pads 1.475 x 0.6 at +/-0.9375
    Copper proportions differ - AOS shorter/wider, KiC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
    [07_ir.kicad_sch]
2026-08-07 Docs: identify J1 mating FPC connector; record J1 symbol mismatch and LS1 block
    Two floorplanning-critical findings. No schematic change - both priority
    items are blocked, one on a symbol and one on a missing document.
    J1 - MATING CONNECTOR IDENTIFIED. The datasheet Adafruit links from product
    1773 is FCI (Amphenol) drawing 62684, family 58DF, 0.5 mm FPC/FFC SMT
    connector. The 50-contact part is 62684-50210 (62684-502100 in tape). Its
    recommended PC board layout, sheet 3 rev E, is captured in full: pitch
    0.5 +/-0.05, signal land 0.3 x 1.2, contact span 0.5 x (n-1) = 24.5 mm for
    n=50, hold-down lands 0.9 x 2.4 set 3.3 mm outboard, plus connector outline
    for keep-out. That is enough to build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
2026-08-07 Close metadata drift on SW9, U7, U8, U9, J3; verify netlist and ERC unchanged
    Five symbols carried metadata contradicting decisions already locked elsewhere
    in the Design Decisions Log. No external vendor document was needed for any of
    them - this propagates existing locks rather than selecting anything new.
    SW9 - the Note still declared an unresolved SPST/SPDT symbol conflict and said
    the symbol change "was NOT made here". That is stale: the instance is already
    Switch:SW_SPDT with pins 1/2/3. Pole mapping is now VERIFIED 1:1 - the KiCad
    symbol places pin 2 (name B) alone at (-5.08, 0), opposite throws 1 (A) and
    3 (C), which is what makes it the pole, and C&K terminal 2 is likewise the
    COMM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
    [01_power_tree.kicad_sch, 04_spi_b_radios_nfc.kicad_sch]
2026-08-07 Docs: link new sections into the vault graph with wikilinks
    The J1 and metadata-drift sections referenced other vault notes as plain
    backticked text, so they produced no backlinks and did not appear in Obsidian's
    graph view - out of step with the rest of the Decisions Log, which uses 30
    wikilinks. Converted the two note references to [[10 - Beta Pin Map]] and
    [[12 - RF and Antenna Plan v0.1]]. libraries/README.md is left as code since it
    is a repo file, not a vault note.
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2026-08-07 Docs: validate TPS61169 operating point; capture Hirose FH69 J1 data
    BACKLIGHT UNBLOCKED. TI's Recommended Operating Conditions table specifies
    VOUT minimum as VIN. That single line settles it both ways: the original
    direct-tie scheme needed 3.104 V at Vf min, below the 3.3 V input and out of
    spec, while the approved ballast topology sits at 3.884 to 4.484 V and is
    inside spec across the whole Vf band. No TI restriction invalidates the
    operating point, so the backlight subtask is not blocked.
    Component values fixed from the datasheet rather than memory: four 39R 1%
    ballasts at 15.6 mW each, RSET 2.55R 1% at 16.3 mW, inductor 4.7 to 10 uH,
    CIN 4.7 uF, COUT 1 uF, and the ONSemi NSR0240 Schott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
2026-08-08 Footprints: add verified Hirose FH69 display connector
    Creates AQROOT_Beta:Hirose_FH69-50S-0.5SH, classified VERIFIED_VENDOR_EXACT
    for the land geometry.
    Sources are Hirose's own documents for CL0580-5008-0-00, pulled from their
    document endpoint: the 7-page 2D drawing, the specification sheet carrying
    drawing number ELC-399242-00-00, and the June 2025 series catalogue whose
    Recommended PCB Layout is the dimensioned source.
    E RESOLVED RATHER THAN HAND-DERIVED. The open question was whether E = 28.73
    is outer-to-outer or centre-to-centre. Settled two independent ways from the
    manufacturer drawing. Rendered at 1200 dpi, the E extension line coincides
    exactly with the hold-down land's dash-do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
2026-08-08 Docs: verify J1 inactive-pin states against ILI9341 datasheet
    Closes the Task 1 gate. Every uncertain pin state is now a datasheet quotation
    rather than an inference, which supersedes the "derived, not quoted" caveats
    recorded with the previous disposition table.
    Sourced from the 245-page Ilitek ILI9341 datasheet, pin descriptor table pages
    10 to 12 plus the serial interface section on page 33.
    VSYNC 11, HSYNC 12, DOTCLK 13 and DE 14 are RGB-interface pins carrying the
    table notation (VDDI/VSS), with DOTCLK and DE stating explicitly "Fix to VDDI or
    VSS level when not in use" - so GND is instruction-backed, not merely
    convention. RDX on pin 35 states "Fix to VDDI level when not in use" and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
2026-08-08 AQROOT Beta: capture physical 50-pin display interface and backlight driver
    Replaces the 13-pin ILI9341_FT6236_MODULE_PLACEHOLDER with the real 50-contact
    CH280QV10_CT_50P panel interface on the Hirose FH69 footprint, and adds the
    dedicated TPS61169 backlight stage. Sheet paper A4 to A3 to fit the 66 mm-tall
    Committed as ONE change rather than the two requested. Splitting was not
    possible without a broken intermediate: the backlight's LED_A1..A4 and LED_K
    nets terminate on J1, so committing the driver first leaves those labels
    dangling, while committing J1 first leaves DISP_BL_CTL and the LED nets
    dangling. Either order fails the "ERC 0 before each commit" gate and would have
    meant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
    [03_spi_a_display_sd.kicad_sch]
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2026-08-08 Docs: prove J2 symbol mismatch, advance U12 to one datum, rule out LS1 candidate
    ERC 0 real items, 24 exclusions intact, netlist unchanged.
    J2 - THE SYMBOL MISMATCH IS NOW PROVEN, not suspected. Molex direct URLs fail,
    but the RS-Online mirror of the Molex part sheet confirms the part is Active,
    1.10 mm pitch microSD, normal-mount SMT push-push, 8 circuits loaded, card
    detection switch present and Open, front entry, shielded, PCB retention, 10000
    cycles. The current Connector:Micro_SD_Card symbol has 9 pins - the 8 SD
    contacts plus a shield - and NO terminals for the mechanical card-detect
    switch. Its pin 2 DAT3/CD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
2026-08-08 Footprints: add verified TI TPS63020 DSJ package
    Closes U12. Creates AQROOT_Beta:TI_TPS63020_DSJ and assigns it, classified
    VERIFIED_VENDOR_EXACT for the signal lands and the thermal-pad envelope.
    THE AMBIGUITY IS RESOLVED. The previous pass stalled on TI's 4X 0.20 features
    at 0.46 spacing, unable to tell whether they were separate exposed pads or part
    of the thermal pad, and the standing rule forbade inferring them from stencil
    aperture counts. Rasterising TI's Example Board Layout at 900 dpi settles it:
    they are SLOTS CUT INTO A SINGLE CONTIGUOUS THERMAL LAND, visible as a comb on
    both flanks of one connected copper area, with the 5 by 3 grid of 15 vias
    inside it. They are not separate pa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
    [01_power_tree.kicad_sch]
2026-08-08 Docs: record U12 closure, J2/LS1 transport failures, LS1 size class exhausted
    U12 was closed in fa00a31 without needing Ultra Librarian: rasterising TI's
    Example Board Layout at 900 dpi showed the 4X 0.20 flank features are slots in
    a single contiguous thermal land, not separate pads, so TI's own drawing - the
    brief's designated primary source - was sufficient once read at adequate
    resolution.
    J2 transport failed again on both the alldatasheet mirror and a second Molex
    path. The blocker is unchanged and precisely named: Molex SD-502570-001 and
    SD-502570-002. The symbol gap is already proven, since the stock 9-pin
    Connector:Micro_SD_Card has no terminals for the mechanical card-detect switch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
2026-08-08 Docs: map Ebyte retrieval route; no RF/NFC capture performed
    No schematic, symbol or footprint file modified. Coverage stays 158 of 176,
    ERC 0 real items, 24 exclusions intact, netlist unchanged. U7, U8 and U9
    placeholders are untouched and DO NOT ROUTE stands.
    One useful thing was established. ebyte.com/product/435.html IS reachable, 294
    KB retrieved, unlike st.com, molex.com and soberton.com which fail at
    transport. The obstacle is different in kind: the page exposes no direct file
    links. Scraping yields only /datadown/<id>.html category pages - 915 MHz is
    1077, 433 MHz is 1081 - plus a company profile PDF. The per-product resources
    named in the brief, Pcb_E22-900M22S and the user manual,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
2026-08-08 Docs: verify E22-900M22S pinout from vendor manual; RXEN blocked on GPIO
    Documentation only. No schematic, symbol or footprint modified. Coverage stays
    158 of 176, ERC 0 real, 24 exclusions, netlist unchanged, DO NOT ROUTE stands.
    RETRIEVAL SOLVED. The Ebyte product page exposes resources only as inline
    links. Working URLs recorded: the user manual at ebyte.com/downpdf/435.html,
    which is a 15-page PDF, and Pcb_E22-900M22S at ebyte.com/pdf-down/766.html,
    which returns PK/zip magic but is malformed and will not open, so the footprint
    still needs a re-fetch or another route.
    PINOUT VERIFIED AND A VARIANT TRAP AVOIDED. The manual documents several
    variants with different pinouts and, in two ca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
2026-08-08 Docs: U7 RXEN architecture analysis - no free GPIO exists in the design
    Read-only analysis. No schematic, symbol, footprint or pin-map change.
    CANDIDATE AUDIT DONE FROM THE NETLIST, NOT THE DOC. There is no free
    controllable output anywhere. U1 shows three unconnected pins - 28, 29 and 30,
    which are IO35, IO36 and IO37 - but these are a trap: U1 is an
    ESP32-S3-WROOM-1 N16R8 and the pin map states GPIO 26-37 are consumed by octal
    PSRAM/flash and excluded, so those pins are unconnected because they must be.
    Wiring RXEN there would collide with the PSRAM bus. Every other native pin is
    committed; the pin map says the native budget is closed via the GPIO43
    multiplex, not by having spare pins. Bo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
2026-08-08 Docs: recover Pcb_E22-900M22S vendor drawings; verify XGPIO14 chain
    Archives the two authentic Ebyte drawings for the exact part under
    hardware/beta/kicad/aqroot-beta/vendor/E22-900M22S/ so the footprint no longer
    depends on a flaky download. No schematic, symbol or footprint changed;
    coverage stays 158 of 176, ERC 0 real, 24 exclusions, netlist unchanged.
    THE ARCHIVE WAS TRUNCATED, NOT CORRUPT. The first download was 2035977 bytes; a
    clean re-fetch gave 3702298. Both lack a valid end-of-central-directory, so
    zipfile and unzip both refuse them, but the members are intact and were
    recovered by scanning PK local file headers directly and inflating each with
    raw zlib. Both E22-900M22S members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
2026-08-08 Docs: record that E22 (1).png is a render; gap datum still unresolved
    Nothing modified. Coverage 158 of 176, ERC 0 real, 24 exclusions, netlist
    unchanged, U7 placeholder and XGPIO14 chain untouched.
    DEFINITIVE NEGATIVE. The 1.25 MB E22-900M22S(1).png expected to carry the
    detailed PCB drawing is a 2765 by 1932 product photograph of the module top
    face - label, QR code, SN and the castellations - with no dimensions of any
    kind. Recorded so no future session reopens it hoping for the missing datum. It
    does show the IPEX connector clearly populated, so antenna evidence is now two
    independent vendor files, though the procurement check still stands since
    neither is a purchase guarantee.
    THE GAP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
2026-08-08 Symbols/Footprints: add physical E22-900M22S module assets
    Library assets only. No sheet touched, so connectivity, ERC, exclusions and the
    netlist are unchanged by construction; coverage stays 158 of 176.
    THE GAP DATUM IS RESOLVED: 5.57 mm. Three sessions stalled on the spacing
    between pins 3-4 and 19-20 where the IPEX connector sits, which no Ebyte
    document dimensions. It came from the exact-part LCSC/EasyEDA footprint for
    C411293, retrieved as structured JSON from the EasyEDA component API rather
    than as a screenshot, giving real pad coordinates instead of pixels.
    IT WAS CROSS-VALIDATED BEFORE BEING ACCEPTED, not trusted on sight. Converting
    at 1 unit = 10 mil, the C411293 package reprod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
2026-08-08 Docs: CORRECTION - U7/U8 were transposed in the blocker register
    Integration aborted at the Task 1 baseline gate. No schematic file modified;
    155 nets, ERC 0 real, 24 exclusions, tree clean, no divergence.
    THE SCHEMATIC IS AUTHORITATIVE AND SAYS THE OPPOSITE OF THE RECENT BRIEFS. Read
    straight from 04_spi_b_radios_nfc: U7 is CC1101_RADIO_PLACEHOLDER with MPN
    E07-400M10S, the 433 MHz CC1101 part, and U8 is SX1262_MODULE_PLACEHOLDER with
    MPN E22-900M22S, the 915 MHz SX1262 part. That matches the drift-closure entry
    from commit a9e8952 and is corroborated by the net names, since the design
    carries CC1101_CS_N and CC1101_GDO0 for U7 and the SX1262 control nets for U8.
    THE ERROR IS MINE AND IT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
2026-08-08 AQROOT Beta: integrate E22 module and dedicate XGPIO14 to RX control
    Atomic change across four files - root, sheet 04, sheet 08 and sheet 09 -
    because the hierarchy reallocation and the module capture are electrically
    coupled and neither is valid alone.
    APPLIED TO U8, NOT U7. The schematic is authoritative: U8 is the SX1262 /
    E22-900M22S at 915 MHz and U7 remains the CC1101 / E07-400M10S at 433 MHz. The
    earlier blocker-register transposition is corrected and annotated in the log;
    U7 is untouched and still a placeholder awaiting its own vendor audit.
    U8 CAPTURE. The SX1262_MODULE_PLACEHOLDER is replaced by the physical 22-pin
    E22-900M22S symbol on AQROOT_Beta:Ebyte_E22-900M22S. All 22 pads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
    [04_spi_b_radios_nfc.kicad_sch, 08_buttons_expanders.kicad_sch, 09_community_header.kicad_sch, aqroot-Beta.kicad_sch]
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2026-08-08 AQROOT Beta: integrate physical CC1101 module
    Replaces the CC1101_RADIO_PLACEHOLDER at U7 with the physical 22-pin
    E07-400M10S symbol on AQROOT_Beta:Ebyte_E07-400M10S. Single sheet touched,
    04_spi_b_radios_nfc.
    All 22 pads accounted for. The nine physical grounds - pins 1 to 5, 11, 12, 20
    and 22 - each resolve to GND individually rather than being collapsed, pin 9
    VCC is on +3V3, and pins 15 to 19 carry CC1101_GDO0, SPI_B_MISO, SPI_B_MOSI,
    SPI_B_SCK and CC1101_CS_N respectively. The five existing hierarchical labels
    were relocated onto the new pin stubs rather than duplicated. Note pin 16 is
    MISO multiplexed with GDO1 on this module, so the single pad serves both.
    GDO2 IS INTENTIONALLY UNC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
    [04_spi_b_radios_nfc.kicad_sch]
2026-08-08 Docs: capture ST25R3916 33-pad table; footprint blocked on AQET package code
    Nothing modified in the design. 176 components, 160 footprinted, ERC 0 real,
    24 exclusions, netlist unchanged, U9 placeholder untouched.
    SOURCE. ST DS12484 Rev 3, June 2020, 156 pages, archived under
    vendor/ST25R3916/. st.com failed transport for a fourth consecutive session on
    two URL forms; the document came from MikroElektronika's mirror and was
    verified by its own ST cover page and document number rather than trusted by
    filename.
    COMPLETE 33-PAD TABLE CAPTURED from Table 2, covering all 32 signal pins plus
    the thermal pad. The placeholder had 15 pins against 33 physical pads, so 18
    were absent.
    THREE FINDINGS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
2026-08-08 Docs: verify ST25R3916 pin table and extract ST decoupling; VDD_DR open
    PIN TABLE RE-VERIFIED PROGRAMMATICALLY rather than from memory. All 33 pads
    were re-parsed out of the archived DS12484 Rev 3 Table 2 and matched exactly
    against the locked table - 33 of 33, no discrepancies and no gaps in the parse.
    Types are confirmed too: VDD_D, VDD_A, VDD_RF and VDD_AM are all typed analog
    output, which confirms they are regulator outputs rather than supply inputs and
    that the retired placeholder's VDD_DIG_3V3 model was inverted.
    DECOUPLING QUOTED FROM ST, NOT INFE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
2026-08-08 AQROOT Beta: integrate physical ST25R3916 NFC controller
    Replaces the 15-pin ST25R3916_NFC_PLACEHOLDER at U9 with the physical 33-pad
    ST25R3916-AQET on AQROOT_Beta:ST25R3916_AQET, and adds the ten ST-specified
    decoupling capacitors. Single sheet touched, 04_spi_b_radios_nfc, plus two pin
    electrical types corrected in the library.
    ALL 33 PADS VERIFIED AGAINST AN EXPECTED MAP, not merely counted: the netlist was
    compared pin-by-pin to the locked mapping and returned 33 of 33 with zero
    mismatches. Supplies are VDD_IO on +3V3, VDD and VDD_TX both on
    NFC_5V_PA_PENDING, and I2C_EN grounded to select SPI. SPI is BSS on pin 29 to
    NFC_CS_N, SCLK/MOSI/MISO to SPI bus B, IRQ on pin 27 to NFC_IRQ. Grou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
    [04_spi_b_radios_nfc.kicad_sch]
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2026-08-08 Integrate physical Molex 5025700893 microSD connector at J2
    Replaces the stock Connector:Micro_SD_Card symbol at J2 with the physical
    11-pin Molex_5025700893 on AQROOT_Beta:Molex_5025700893. One sheet touched,
    03_spi_a_display_sd. J2 is the last connector on the missing-footprint list.
    ALL 11 PINS VERIFIED AGAINST AN EXPECTED MAP, not merely counted. An expected
    pin-to-net table was written before validating and every logical pin compared
    against the exported netlist: 11 of 11 match with zero mismatches. DAT2 and DAT1
    carry explicit no-connect flags, CD/DAT3 is SD_CS_N, CMD is SPI_A_MOSI, VDD is
    +3V3, CLK is SPI_A_SCK, VSS is GND, DAT0 is SPI_A_MISO, SHIELD is GND, DET-SW is
    SD_CARD_DETECT_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
    [03_spi_a_display_sd.kicad_sch]
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2026-08-10 AQROOT Beta: assign verified MAX17048 footprint
    U14 (MAX17048G+T10) now carries AQROOT_Beta:MAX17048_T822, verified against
    Maxim land pattern 90-0065 Rev E. Assigned in all three places per repo
    convention: the MAX17048 library symbol, the 01_power_tree sheet cache and the
    U14 instance. Three lines changed, nothing else.
    Symbol-to-pad mapping verified 1:1 across exactly nine electrical pads:
    1 CTG, 2 CELL, 3 VDD, 4 GND, 5 ~ALRT, 6 QSTRT, 7 SCL, 8 SDA, 9 EP. No phantom,
    missing or duplicated pad numbers.
    Netlist unchanged: U14 pin-to-net is byte-identical to the pre-change export
    (1 GND, 2/3 BAT_PROTECTED_P, 4 GND, 5 MAX17048_ALRT_N, 6 unconnected,
    7 I2C_SCL_INT, 8 I2C_SDA_INT, 9 GND). Acr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
    [01_power_tree.kicad_sch]
2026-08-10 AQROOT Beta: finalize Beta IR driver values
    Closes the parked IR supply rail and locks the two remaining IR passives.
    IR_LED_SUPPLY_TBD -> +3V3. Both IR_LED_SUPPLY_TBD labels were replaced with
    power:+3V3 symbols (#PWR0505, #PWR0506) placed on the same wire endpoints, so
    the branch now joins the global +3V3 net rather than a sheet-local parked net.
    The label was never referenced by an ERC exclusion, so no exclusion record was
    touched.
    R24 = 18R, 1 percent, 0805. Rail 3.3 V, TSAL6200 Vf ~1.35 V typ / ~1.6 V high,
    AO3400A drop negligible at this current, so I = (3.3 - Vf) / 18R gives ~108 mA
    at Vf 1.35 V and ~94 mA at Vf 1.6 V against the ~100 mA target. Peak I^2*R in
    R24 is ~0.21 W at 108 m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
    [07_ir.kicad_sch]
2026-08-10 AQROOT Beta: finalize NFC external decoupling
    C18 = 100nF, 16 V, X7R, 0402. Role was already proven in the capture:
    +3V3 -> C18 -> GND, ST25R3916 VDD_IO external supply decoupling. PLACEHOLDER
    wording retired. VDD_D, VDD_A, VDD_RF, VDD_AM and AGDC decoupling are captured
    separately and were not touched.
    C19 = 100nF, 16 V, X7R, 0402. Role already proven: NFC_5V_PA_PENDING -> C19 ->
    GND, external VDD / VDD_TX high-frequency decoupling. PLACEHOLDER wording
    retired. C19 stays the HF decoupler and is explicitly NOT replaced by the bulk
    capacitor.
    C55 = 2.2uF, 16 V, X7R, 0805 - NEW component, authorised in the ratified lock.
    NFC_5V_PA_PENDING -> C55 -> GND, placed electrically at the ST25R3916 e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
    [04_spi_b_radios_nfc.kicad_sch]
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2026-08-10 AQROOT Beta: reconcile PCB floorplan to real footprint geometry
    FLOORPLAN PASS 2. Mechanical only: no routing, vias, pours, NFC loop or
    RF routing. Board grows to 74.0 x 152.0 x 1.6 mm, R3.0, 4 layers.
    Re-placed all 18 anchors against v0.4.3. U8 (E22/915) vertical at
    (64,127) IPEX UP; U7 (E07/433) horizontal at (56,145) IPEX LEFT; J3
    USB-C moved to X28-42 centre (35,147.82); J2 microSD moved to X8-22;
    U1 WROOM rotated so its antenna keepout exits the LEFT board edge;
    SW1 to (6,70); HOME to (48,138.5); bosses to the v0.4.3 targets.
    Antenna zones, NFC, battery, speaker and panel zones updated. Samtec
    mechanical key annotation moved to the right end.
    Resolved from Pass 1:
    - J3/U8 shorting cla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
    [aqroot-Beta.kicad_pcb]
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2026-08-11 AQROOT Beta: correct U12 TPS63020 thermal-pad numbering
    Footprint pad-number correction only. No component moved, no routing, no
    geometry change.
    TI SLVS916I (TPS63020/TPS63021, rev I, Oct 2019) section 5 "Pin
    Configuration and Functions", DSJ Package, 14-Pin VSON with Exposed
    Thermal Pad, was checked rather than assumed. The Pin Functions table
    lists 14 numbered pins (1-14); PGND carries pin number "-" and so does
    the Exposed Thermal Pad, with the note "The exposed thermal pad is
    connected to PGND". There is therefore NO 15th signal/power pin: the
    package has 14 pins plus one thermal terminal which IS PGND.
    The footprint was already correct against TI (14 signal lands plus one
    2.85 x 1.58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
    [aqroot-Beta.kicad_pcb]
2026-08-11 AQROOT Beta: normalize the TPS63020 model to the physical TI package
    Root-cause fix. Supersedes the temporary coincident pad-16 compatibility
    shim added in 788fff0. No component moved, no routing, no geometry change.
    TI SLVS916I (rev I, Oct 2019) section 5, "DSJ Package, 14-Pin VSON with
    Exposed Thermal Pad", was re-verified: the Pin Functions table lists 14
    numbered pins (1-14); PGND and the Exposed Thermal Pad both carry pin
    number "-", and TI states "The exposed thermal pad is connected to PGND".
    The physical device therefore has 14 numbered pins plus ONE unnumbered
    exposed thermal pad which IS PGND. There is no pin 15 signal pin and no
    pin 16 terminal of any kind.
    AQROOT convention, no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
    [01_power_tree.kicad_sch, aqroot-Beta.kicad_pcb]
2026-08-11 AQROOT Beta: place MCU and I2C control block
    General placement pass 2. PCB placement only; no routing, no schematic
    change. Board 74 x 155 x 1.6 mm inside the 80 x 167 x 19.5 mm envelope.
    Places the 45 remaining MCU / I2C-control components: U1 WROOM support,
    U2 and U3 TCA9535 expanders, U16 TCA9517A I2C buffer, U4 BMI270, their
    decoupling, I2C pull-ups, strap/reset/interrupt passives and the five
    digital test points already present in the schematic. 116 of 188 parts
    are now placed; the audio, IR, NFC RF, radio-matching, display/SD and
    community-header connector blocks remain deliberately deferred.
    Placement is driven by pin geography rather than row symmetry:
    - C40/C42 (100 nF) sit close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
    [aqroot-Beta.kicad_pcb]
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2026-08-11 AQROOT Beta: place audio and IR blocks
    General placement pass 4. PCB placement only; no routing, no schematic
    change. Coverage 131 -> 143 of 188.
    Twelve components placed, not the thirteen anticipated: LS1 is the
    off-board 8 ohm speaker, carries on_board=no and is absent from the
    netlist entirely, so it has no footprint and cannot be placed. 07_ir is
    now complete; 06_audio is complete except LS1. The 45 refs still open
    are the SPI-B/radio/NFC and community-header blocks, plus LS1.
    IR (Q1, R24, C12, R22, R23) goes on the BOTTOM directly beneath D1,
    which is a through-hole radial LED, so its leads are reachable from
    underneath. That keeps the pulsed loop short while leaving the entire
    top fa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
    [aqroot-Beta.kicad_pcb]
2026-08-11 AQROOT Beta: verify microphone clearance and place community header support
    Microphone clearance audit plus general placement pass 5. PCB placement
    and mechanical reference geometry only; no routing, no schematic change.
    MICROPHONE CHECK
    The 2.985 mm figure in the brief was neither of the two offered bases.
    It was C8 on the BOTTOM side, expressed as courtyard-edge distance minus
    hole radius. C11 measures, from the acoustic-hole centre at (71.500,
    7.790): body edge 2.650 mm, centre 3.723 mm, silk edge 3.379 mm. Body
    edge >= 2.5 mm, so per the ruling C11 is KEPT EXACTLY WHERE IT IS and
    nothing was moved.
    The R2.5 zone is not clear, but not because of C11. U6 - the
    through-hole IR receiver, 5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
    [aqroot-Beta.kicad_pcb]
2026-08-11 AQROOT Beta: place final SPI-B radio and NFC support
    Final general-placement block. PCB placement and mechanical reference
    geometry only; no routing, no schematic change, no RF matching values.
    Board-placeable coverage reaches 187 / 187. Physical schematic refs
    187 / 188, the remainder being LS1, the off-board speaker with
    on_board=no, which is intentionally never PCB-placed.
    All 20 remaining refs placed, none deferred. Classified before placing:
    four CS pull-ups and a RXEN pull-down (digital control), fifteen
    decoupling parts, and U9 itself. There is no oscillator or RF-matching
    component among them - every deferred NFC net (RFO1/2, RFI1/2, AAT_A/B,
    EXT_LM, CSI/CSO, XIN/XOUT, MCU_CLK) has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
    [aqroot-Beta.kicad_pcb]
2026-08-11 AQROOT Beta: implement pre-routing PCB rules
    Implements the rule architecture the FINAL PRE-ROUTING CTO / RF RULING
    requires before routing. No traces drawn, no component moved.
    Fabrication basis is JLCPCB JLC04161H-7628 (4L, 1.6 mm, 1 oz outer /
    0.5 oz inner, 7628 prepreg 0.2104 mm, 1.065 mm core). USB 2.0 90 ohm
    resolves to W 0.30 / S 0.20 mm on F.Cu over In1 (89.3 ohm computed).
    In1.Cu becomes the continuous board-wide GND reference. The 915/433
    keepout rule areas previously blocked copper on all four layers, which
    would have punched a hole in that reference straight through both
    antenna bands; they are relayered to F.Cu + In2.Cu + B.Cu with pour
    prohibition only, and all net-aware and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
    [aqroot-Beta.kicad_pcb]
2026-08-11 AQROOT Beta: correct NFC TX bulk decoupling
    C55 is the one placement-lock exception the ruling authorised. It moves
    from (10.000, 19.000) rot 0 to (22.225, 29.400) rot 270, with pad 1
    (NFC_5V_PA_PENDING) facing north at U9 pins 8/10 and pad 2 (GND) south,
    so the return loop closes away from U9's RF pins.
    C55 pad1 -> U9 pin 8 (VDD_TX): 14.005 mm -> 4.875 mm
    C55 pad1 -> U9 pin 10 (VDD_TX): 15.148 mm -> 4.469 mm
    The <=3.0 mm electrical target is NOT met, and that is structural, not
    an oversight. An exhaustive search over every 0.05 mm position, four
    rotations and both 0603/0805 classes, rejected against every locked
    F.Cu courtyard, found 680,610 legal positions whose best worst-case
    dist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
    [04_spi_b_radios_nfc.kicad_sch, aqroot-Beta.kicad_pcb]
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2026-08-11 AQROOT Beta: route GND reference and exposed-pad thermal infrastructure
    Routing Pass 1, PARTIAL. Blocks A and B of the pass scope are routed and
    DRC-clean. Blocks C-F (converters, major power rails, USB, E4/E5
    crossings, critical decoupling loops) were routed, produced 41 DRC
    errors, and were REVERTED rather than committed. Nothing broken is in
    this commit. Placement, connectivity and ERC are untouched, and no
    signal trace exists on the board - GND is the only net carrying copper.
    Delivered:
    In1 GND reference zone, one pour inset 0.6 mm from the board edge:
    10025.8 mm2 filled of an 11181.0 mm2 outline. The 1155 mm2 shortfall is
    three pre-existing all-layer rule areas plus pad clearance. Tw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
    [aqroot-Beta.kicad_pcb]
2026-08-11 AQROOT Beta: close routing blockers, add U17 VIN bypass
    Closes the three blockers from the Routing Pass 1 partial. No routing was
    performed; GND remains the only net carrying copper.
    BAT/SYS width lock, per CTO ruling. IBAT_OCP 3.125 A is a fault trip
    threshold, not a routing design current, and the floor derived from it
    made U11's 0.40 mm pitch west flank unroutable. BAT_MAIN min 1.00/opt
    1.50 -> min 0.60/opt 1.00 mm (1.5 A sustained, 1 oz outer, dT=10 K needs
    0.525 mm). SYS_MAIN min 0.60/opt 1.00 -> min 0.50/opt 0.80 mm. Netclass
    defaults follow. The wrong derivation is corrected in the rule comment so
    it stops propagating. Layer policy is now written into the file: both
    rails are outer-l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
    [03_spi_a_display_sd.kicad_sch, aqroot-Beta.kicad_pcb]
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2026-08-11 AQROOT Beta: route converters and BAT/SYS power rails
    Routing Pass 1 resumed against the corrected width lock. All four
    converter blocks and the BAT/SYS/+3V3 rails are routed and DRC-clean.
    USB, E4, the E5 crossings, the +3V3 band crossing and the C55/U9 supply
    are NOT routed, so Pass 1 still does not close.
    83 tracks, 29 vias (16 THERMAL 0.25, 10 POWER 0.40, 3 SIGNAL 0.30).
    15 nets carry copper: 9 fully routed - ILIM_VSET, R_FB_TOP, BL_SW,
    LED_BOOST, BAT_PROTECTED_P, both L1 switch nodes, U11-TS_MR, U13-SW -
    and 6 partial. Unconnected 499 -> 486.
    Removed the pass-1A U12 pin-2 GND escape and its plane via: pin 2 now
    ties directly to PGND_EP, which already carries 6 vias to In1. Shorter
    ret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
    [aqroot-Beta.kicad_pcb]
2026-08-11 AQROOT Beta: route C55 escape, ISET, E5 corridors and RF crossings
    Routing Pass 1B. 0 DRC errors, placement unchanged, no new custom rule
    added. USB is still not started, so Pass 1 does not close.
    The authorised C55 width exception was NOT needed. The C50 pad2 to C52
    pad1 gap is 0.950 mm, which takes the full 0.35 mm NFC_5V_PA width with
    0.300 mm clearance each side - the capacitors were never the obstruction.
    The real blocker was my own U9 pad-12 GND fanout via at (24.000, 25.560)
    from the previous commit; pads 12 and 16 now share the (26.550, 25.560)
    plane tie through a common rail south of U9, so the same three GND pins
    stay tied and the lane opens. The only sub-width segments are the tw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
    [aqroot-Beta.kicad_pcb]
2026-08-11 AQROOT Beta: move C20 0.300 mm north to open the J3 USB escape
    The authorised C20 move was +2 mm east. That is impossible, it was aimed
    at the wrong constraint, and one figure I reported last pass was wrong.
    Correction first: I reported the bypass corridors as west 1.325 mm (fits)
    and east 0.925 mm (does not). The east corridor is also 1.325 mm - C20
    pad2 right edge 36.450 to R31 pad1 left edge 37.775. The 0.900 mm I had
    measured was the gap between C20 own two pads and I conflated the two.
    Both corridors accommodate the 1.20 mm pair envelope, so widening one was
    never the obstruction.
    C20 verified from the netlist, not inferred: 4.7 uF 10 V X7R, 0805, pad1
    USB_VBUS_RAW and pad2 GND - the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
    [aqroot-Beta.kicad_pcb]
2026-08-11 USB: route J3->U10->R33/R34->U1 at approved 0.25/0.20 geometry
    Closes the Routing Pass 1 USB blocker. 0 DRC errors.
    The four earlier passes failed because 0.30 mm put the track width at the exact
    maximum the connector's 0.5 mm pad pitch permits, leaving 0.000 mm of margin on
    every escape. At fixed pitch the adjacent-copper gap is 0.5 - W and depends on
    W alone, while Zdiff depends on W and S, so the two trade independently:
    0.25/0.20 gives 97.6 ohm (+8.4%, inside the USB 2.0 +/-15% window) and 0.250 mm
    of gap. 0.25/0.14 would hit 90.2 ohm but needs a P-to-N clearance exception;
    8 ohm was traded to avoid weakening any clearance rule.
    Rules: USB track_width -> min 0.23 / opt 0.25 / max 0.2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
    [aqroot-Beta.kicad_pcb]
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2026-08-11 AQROOT Beta: close VBUS routing infrastructure
    USB_VBUS_CHG fully routed, 0 ratsnest items. USB_VBUS_RAW blocked; 4 items
    remain and the reason is measured, not asserted.
    Rule binding: both USB_VBUS_RAW and USB_VBUS_CHG match the netclass pattern to
    VBUS_CHG - track_width min 0.35 / opt 0.50, routed clearance 0.25 mm non-pad,
    via class POWER 0.40/0.80. 0.50 mm used throughout; no new class or width.
    VBUS_CHG, 130.78 mm total, 6 vias:
    south approach In2 (28.000,144.800)-(54.850,144.800)-(54.850,119.000)
    south hand-off via (54.850,119.000) + F.Cu to (56.000,116.000) at 0.35 mm
    E4 trunk In2 (56.000,116.000)-(56.000,86.000), unchanged, 30.00 mm
    north hand-off F.Cu (56.000,8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
    [aqroot-Beta.kicad_pcb]
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2026-08-11 AQROOT Beta: close raw USB power path
    USB_VBUS_RAW: 0 ratsnest. All four connections routed. Routing Pass 1 closes.
    DRC 0 electrical errors.
    DEVIATION, flagged: the authorised shift was 0.175 mm. I used 0.325 mm. The
    0.175 mm figure was mine, computed for a 0.35 mm TRACK, and it is correct for
    that: verified from board geometry it gives channel 0.900 mm, margin 0.100 mm,
    R30 clearance 0.375 mm, exactly as predicted. But C20 pad 1 turns out to be
    fully enclosed - USB_D_CONN_N to the west and, via its horizontal into U10
    pin 1, to the north; the USB_D_CONN_P merge to the south-east; U10's pad row
    above; C20 pad 2 to the east. A track fits in that pocket and has nowhere to
    go, so pad 1 m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
    [aqroot-Beta.kicad_pcb]
2026-08-11 AQROOT Beta: free the U1 escape strip and route SPI-A clock and MOSI
    U9 GND escape fix, then SPI_A_SCK and SPI_A_MOSI. Both nets 0 ratsnest.
    U9 GND: the two through-vias at (26.550,25.560) and (27.500,25.560) plugged the
    entire B.Cu U1 escape strip - their 0.80 mm pads left 0.150 / 0.150 / 0.100 mm
    against U1's pads, each other, and NFC RESERVED, where a 0.20 track needs 0.600.
    Removed, along with the 9.06 mm F.Cu rail that fed them. Replaced by direct
    same-net bridges across the 0.175 mm pad-to-EP gap: pad 20 -> EP and pad 21 ->
    EP (0.40 mm each, 0.225 mm clear of pads 19 and 22 at 0.25 mm width), and pad 12
    -> EP (0.80 mm).
    Pad 16 CANNOT bridge: pad 15 (NFC_RFO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
    [aqroot-Beta.kicad_pcb]
2026-08-12 AQROOT Beta: repack the SPI-A U1 escape onto the approved lane schedule
    Local escape only. SCK and MOSI both stay 0 ratsnest, DRC 0 electrical errors,
    and their downstream geometry keeps its committed x.
    MOSI: lane 27.075 -> 27.500. Stub (25.800,24.095)-(27.500,24.095), throat
    27.500 down to y=36.500, jog to (27.075,36.800), then the committed trunk
    (27.075,36.800)-(27.075,76.000). 14.63 mm changed; 39.20 mm downstream
    preserved at the original x.
    SCK: lane 26.675 -> 27.100. Stub (25.800,25.365)-(27.100,25.365), throat 27.100
    down to y=36.000, jog to (26.675,36.300), then the committed trunk
    (26.675,36.300)-(26.675,85.800). 12.46 mm changed; 49.50 mm downstream
    preserved at the origin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
    [aqroot-Beta.kicad_pcb]
2026-08-12 AQROOT Beta: route SPI-A MISO
    MISO 156.24 mm, 5 vias, B.Cu + F.Cu + In2. 0 ratsnest, DRC 0 electrical errors.
    SCK and MOSI untouched at 162.20 mm and 161.24 mm.
    Throat: lane 26.700 from U1.21, south to y=35.000, then west. The suggested
    y~35.5 exit does not fit - the band between U1's south pad row (bottom 35.500)
    and SCK's committed jog (extent from 35.900) is 0.400 mm where a 0.20 track needs
    0.600. Exiting at y=35.000 instead clears SCK's jog entirely and keeps 0.200 mm
    to U1's south row by stopping the westward move at x=24.750.
    Mid-board: B.Cu trunk 47.00 mm south at x=24.750, i.e. WEST of both SCK and MOSI.
    That means the J1 branch has to cross them, so one 4.90 mm F.Cu hop at y=8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
    [aqroot-Beta.kicad_pcb]
2026-08-12 AQROOT Beta: route SD_CS_N and close the SPI-A shared bus
    SD_CS_N 142.44 mm, 5 vias, B.Cu + F.Cu + In2. 0 ratsnest, DRC 0 electrical
    errors. All four SPI-A bus nets are now routed; SCK, MOSI and MISO untouched at
    162.20 / 161.24 / 156.24 mm.
    Throat: lane 26.300 from U1.25, exit west at y=34.300 - 0.765 mm below U1's east
    pad column (ends 33.435) and 0.500 mm above MISO's committed y=35.000 exit.
    Staying east of MISO's trunk does not work, and it took a DRC cycle to see why: a
    trunk at x=25.200 crosses MISO's y=35.000 exit, its J1 hop at y=81.500 AND its
    west run at y=82.000, while the gap between U1's south pad row (right edge
    24.450) and MISO's trunk (24.750) is only 0.200 mm so nothing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
    [aqroot-Beta.kicad_pcb]
2026-08-12 AQROOT Beta: route DISP_CS_N via the northern escape
    DISP_CS_N 70.78 mm, 2 vias, B.Cu + F.Cu + In2. 0 ratsnest, DRC 0 electrical
    errors. The four bus nets are untouched at 162.20 / 161.24 / 156.24 / 142.44 mm.
    The approved (27.000, 18.800) via site needed correcting too: C54's F.Cu pads
    occupy x 26.425-27.375 for y 15.875-18.325, so the usable window is the 1.025 mm
    band between C54 pad 1 (bottom 18.325) and U9 pads 25/26 (top 19.350). The via
    sits at (27.000, 18.835), centring a 0.60 mm pad there with 0.210 mm to C54 pad 1
    and 0.215 mm to U9 pad 25, 0.700 mm to U1 pad 15 and 0.700 mm to NFC RESERVED.
    Escape: B.Cu stub east from U1.18, north at x=26.300 (0.200 mm to U1's pads) to
    y=19.7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
    [aqroot-Beta.kicad_pcb]
2026-08-12 AQROOT Beta: route DISP_BL_CTL through the U1 belly and In2
    DISP_BL_CTL 80.00 mm, 2 vias, B.Cu + In2. 0 ratsnest, DRC 0 electrical errors.
    The five locked SPI-A block nets are untouched.
    Escape confirms the accepted concept: U1's belly is open on B.Cu, so U1.24 leaves
    WEST rather than through the full east throat. B.Cu 6.85 mm west and south to the
    belly via at (20.500, 32.000) - nothing within 1.2 mm of it. x=20.500 rather than
    20.000 keeps the In2 descent clear of the E5 C-W corridor's x=20.000 east edge.
    In2 then carries 72.60 mm: south at x=20.500 to y=79.400, east to x=43.800, then
    1.90 mm south to the surface via at (43.800, 81.300), and 0.55 mm of B.Cu into
    U17 pad 4.
    Two correc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
    [aqroot-Beta.kicad_pcb]
2026-08-12 AQROOT Beta: shift the DISP_BL_CTL In2 run and route DISP_DC
    Both nets 0 ratsnest, DRC 0 electrical errors at each step. The five SPI-A block
    nets and DISP_CS_N are untouched.
    DISP_BL_CTL local shift, authorised: In2 east run y 79.400 -> 80.400. Three
    segments re-laid (the horizontal plus the two reconnecting verticals), 72.60 mm -
    identical to before, since only the y changed. Total still 80.00 mm, still 2 vias.
    Belly escape, belly via (20.500, 32.000), In2 x lane, U17 surface via
    (43.800, 81.300) and the U17 B.Cu connection are all unchanged. Minimum same-layer
    separation to BL_SW is 2.016 mm before AND after - the shift moves the run away
    from the backlight cluster, not toward it. S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
    [aqroot-Beta.kicad_pcb]
2026-08-12 AQROOT Beta: route DISP_RST_N and close the display control block
    DISP_RST_N 103.00 mm, 2 vias, B.Cu + In2 + F.Cu. 0 ratsnest, DRC 0 electrical
    errors. All seven previously routed SPI-A and display nets are untouched.
    U2/R16 local topology: U2.8 sits on U2's west pad column (x 8.400-9.875, 0.65 mm
    pitch leaving 0.250 mm gaps), so WEST is its only legal exit - south and east are
    its own neighbours and cannot be passed between. The route runs out to x=6.400,
    holding 0.275 mm to the R4/R8/R14 column at x=6.775 and clear of the WROOM keepout,
    which ends at y=35.
    Tee at (6.400, 45.000), shared with the In2 transition: B.Cu continues south and
    east to R16 pad 1 (19.98 mm), In2 heads south and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
    [aqroot-Beta.kicad_pcb]
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2026-08-12 AQROOT Beta: route BMI270_INT1_RAW
    BMI270_INT1_RAW 6.49 mm, 0 vias, B.Cu only. 0 ratsnest, DRC 0 electrical errors.
    Geometry verified from the board, not inferred. U4 is a BMI270 LGA-14 on B.Cu:
    its west column pads (1-4) are 0.475 x 0.250 mm on 0.5 mm pitch, leaving 0.250 mm
    between them, so nothing passes between and U4 pad 4 must leave along its own axis.
    West is open but R18 is east, so the route goes NORTH out of the pad into the
    1.350 mm band between U4's north row (top 62.350) and C6/C7 (bottom 61.275), runs
    east above U4, and drops onto R18 pad 1.
    U4 pad 4 [10.700 62.625 11.175 62.875] B.Cu
    R18 pad 1 [14.575 63.025 15.375 63.975] B.Cu, 220R series element
    north out of the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
    [aqroot-Beta.kicad_pcb]
2026-08-12 AQROOT Beta: route BMI270_INT1_STRAP and close the BMI270 interrupt path
    BMI270_INT1_STRAP 52.90 mm, 2 vias, B.Cu + In2. 0 ratsnest, DRC 0 electrical
    errors. R18 pad 1 side untouched; nothing routes through the resistor.
    Local tee: 1.90 mm of B.Cu from R18 pad 2 to TP3 pad 1 across their 1.175 mm gap,
    then 1.70 mm east off TP3 to the transition via. A true tee, not a star.
    U1.15 escapes WEST into U1's belly, not east. DISP_CS_N's via at (27.000, 18.835)
    and its diagonal already occupy the strip at exactly U1.15's y, and the column gap
    to U1.16 is 0.370 mm where a 0.20 track needs 0.600. West at y=18.800 is open -
    0.700 mm below U1's north row, 0.935 mm above U1.16, 1.550 mm from the U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
    [aqroot-Beta.kicad_pcb]
2026-08-12 AQROOT Beta: route MAX17048_ALRT_N
    MAX17048_ALRT_N 3.19 mm, 0 vias, F.Cu only. 0 ratsnest, DRC 0 electrical errors.
    Endpoints re-confirmed from the current netlist: exactly two nodes, both F.Cu -
    U14 pad 5 [65.140 81.100 65.840 81.400] and TP11 pad 1 [68.500 80.000 69.500
    81.000], 3.589 mm apart straight-line. No other loads.
    Route: horizontal east at y=81.250 to x=66.400, then a single rise into TP11 pad 1.
    The straight diagonal grazed U14 pad 6 (the unconnected QSTRT pin, [65.140 80.600
    65.840 80.900]) at 0.296 mm real distance - legal, but only just, and the AABB
    pre-check flagged it. Staying horizontal until x=66.400 clears that pad by
    0.460 mm before the rise begins, at no extra le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
    [aqroot-Beta.kicad_pcb]
2026-08-12 AQROOT Beta: route TOUCH_RST_N via an authorised U2 escape crossing
    TOUCH_RST_N 68.08 mm, 4 vias, B.Cu + F.Cu + In2. 0 ratsnest, DRC 0 electrical
    errors, verified in three stages as required.
    U2 escape - the reusable pattern this pass was meant to establish. U2's pad columns
    have 0.250 mm inter-pad gaps, so a pad can only exit sideways, and DISP_RST_N's B.Cu
    horizontal at y=43.025 (x 6.300-8.500) seals the whole gap between U2's pad edge and
    the board's west edge. So: 1.30 mm of B.Cu west out of U2 pad 4, a via at
    (7.400, 45.625), 4.12 mm of F.Cu straight north crossing DISP_RST_N PERPENDICULAR,
    a second via at (7.400, 41.500), then back to B.Cu. The two vias clear DISP_RST_N by
    2.200 m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
    [aqroot-Beta.kicad_pcb]
2026-08-12 AQROOT Beta: route the WAKE_INT_N local trunk and U1.23 (partial net)
    U2.1, R3.1 and U1.23 are on one connected WAKE_INT_N island. 43.68 mm, 2 vias,
    B.Cu + In2. DRC 0 electrical errors. WAKE_INT_N retains exactly 2 ratsnest items -
    U1.23<->U3.1 and U3.1<->R66.1 - which is pass 2B-6B's scope. The net is NOT complete.
    U2's body interior turned out to be both unnecessary and unusable, contrary to the
    plan I proposed last pass. Leaving the interior eastward is impossible: U2's east
    column spans y 40.225-47.775 with 0.250 mm inter-pad gaps, and pad 15
    [14.125 41.525 15.600 41.925] sits exactly on the intended y=41.750 exit lane.
    Running east at y=49.200 - BELOW the whole pad row - clears ev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
    [aqroot-Beta.kicad_pcb]
2026-08-12 AQROOT Beta: route the WAKE_INT_N north branch, closing the non-I2C control block
    North branch 24.95 mm, 2 vias. WAKE_INT_N now 68.63 mm, 4 vias, B.Cu + F.Cu + In2,
    0 ratsnest - all five nodes (U2.1, R3.1, U1.23, U3.1, R66.1) on one island. DRC 0
    electrical errors. The committed local trunk was not touched.
    R66 checked rather than assumed, as required: it is a 330R 1% SERIES element between
    /WAKE_INT_N (pad 1) and /09_COMMUNITY_HEADER/WAKE_ATTN_N_HDR (pad 2) - not a pull-up
    or pull-down. Only pad 1 was routed; pad 2's net is untouched.
    In2 continues north from the committed via at (23.400, 29.175) but jogs WEST to
    x=22.400: the six U9 EP-area GND through-vias occupy x 22.900-24.350 for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
    [aqroot-Beta.kicad_pcb]
2026-08-12 AQROOT Beta: route the I2C_SDA_INT west cluster (partial net)
    SDA west cluster 46.04 mm, 3 vias, B.Cu + In2. DRC 0 electrical errors. U1.39,
    R19.2, TP4.1, U2.23 and U4.14 are on one connected SDA island. SDA retains exactly
    4 ratsnest items - U3.23, U16.3, J1.45, U14.8 - which are the later passes' scope.
    SDA is NOT complete.
    Origin is a single 2.00 mm B.Cu stitch: U1.39 [8.310 34.000 9.210 35.500] sits
    almost directly above R19 pad 2 [8.425 36.725 9.225 37.675], so the pull-up tee needs
    no lane and no via, holding 0.720 mm to U1.38 (the future SCL pad) and 0.720 mm to
    U1.40 GND. U1's south-row position is why this is trivial - the belly and throat
    problems that dominated the display bl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
    [aqroot-Beta.kicad_pcb]
2026-08-12 AQROOT Beta: route the I2C_SDA_INT north branch to U3.23 and U16.3
    North branch 44.56 mm, 2 vias. SDA now 90.60 mm, 5 vias, B.Cu + In2. DRC 0
    electrical errors. U1.39, R19.2, TP4.1, U2.23, U4.14, U3.23 and U16.3 are all on one
    SDA island; the remaining 2 ratsnest items involve only J1.45 and U14.8. SDA is NOT
    complete.
    Northbound In2 lane at x=17.500, not 16.500: U1's central GND pad 41 carries In2
    sub-pads spanning x 13.510-16.910 for y 22.550-26.450 - I had only recorded that pad's
    B.Cu extent before. x=17.500 clears them by 0.490 mm and sits 2.2 mm west of
    BMI270_STRAP's In2 and 4.9 mm west of WAKE's, avoiding both the WAKE lane and the U9
    GND via cluster (x 22.900-24.350) entirely.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
    [aqroot-Beta.kicad_pcb]
2026-08-12 AQROOT Beta: close I2C_SDA_INT with the J1 and U14 branches
    I2C_SDA_INT ratsnest 0. All 9 loads verified on ONE copper island by an
    independent union-find over track/via/pad geometry, not by DRC alone:
    U1.39, R19.2, TP4.1, U2.23, U4.14, U3.23, U16.3, J1.45, U14.8.
    The In2 layer cannot reach J1 from the SDA island. Four display-control In2
    verticals (DISP_BL_CTL 20.500, DISP_DC 21.200, TOUCH_RST_N 22.000, DISP_CS_N
    27.000) wall off eastward travel for y 40-80, and DISP_RST_N's In2 L (y=82.800
    across x 6.4-45.25, then north at x=45.250) walls off the south. The pocket
    north of J1 is entered only through a 0.500 mm In2 window at y 78.600-79.100,
    and no via fits ther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
    [aqroot-Beta.kicad_pcb]
2026-08-12 AQROOT Beta: route the I2C_SCL_INT west cluster
    U1.38, R20.2, TP5.1, U2.22 and U4.13 on ONE copper island, verified by an
    independent union-find over track/via/pad geometry. DRC 0 electrical errors.
    SCL ratsnest 4, exactly the four deferred nodes: U3.22, U16.2, J1.44, U14.7.
    SDA untouched at 168.94 mm / 7 vias / 0 ratsnest.
    SCL cannot stay on B.Cu the way one might hope: five east-west B.Cu walls sit
    between the U1/R20/TP5 row and U2/U4 - TOUCH_RST_N y=39.500 (x 7.400-22.000,
    unbroken), WAKE_INT_N y=41.750 (x 17.375-22.700) and y=49.200 (x 9.100-22.700),
    ROOTPROBE_IRQ_READY_N y=44.000 (x 16.300-19.025), and SDA's own y=38.700. So
    SCL needs its own In2 spine, as SDA did, and the pass is bu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
    [aqroot-Beta.kicad_pcb]
2026-08-12 AQROOT Beta: route the I2C_SCL_INT north branch to U3.22 and U16.2
    Seven SCL nodes on ONE copper island, verified by union-find over track/via/pad
    geometry: U1.38, R20.2, TP5.1, U2.22, U4.13, U3.22, U16.2. DRC 0 electrical
    errors. SCL ratsnest 2, involving only J1.44 and U14.7. SDA untouched at
    168.94 mm / 7 vias / 0 ratsnest.
    Northbound trunk: In2 straight up the x=18.200 lane from V1 (18.200,38.200) to
    y=11.350 - 26.85 mm, no jog needed. It clears U1 pad-41's In2 copper (max
    x=16.910) by 1.190 mm, SDA's x=17.500 lane by 0.500 mm, BMI270_INT1_STRAP by
    1.500 mm, WAKE_INT_N's In2 by 4.100 mm and the U9 GND via cluster by >5 mm.
    U3.22 could NOT take a via near the pad. U3 is a dual-row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
    [aqroot-Beta.kicad_pcb]
2026-08-12 AQROOT Beta: close I2C_SCL_INT with the J1 and U14 branches
    I2C_SCL_INT ratsnest 0. All 9 loads on ONE copper island, verified by union-find
    over track/via/pad geometry: U1.38, R20.2, TP5.1, U2.22, U4.13, U3.22, U16.2,
    J1.44, U14.7. DRC 0 electrical errors. SDA untouched at 168.94 mm / 7 vias /
    0 ratsnest. The I2C block is complete.
    Both branches tee from the existing SCL through-via at (18.200,64.700) - no new
    via was needed for the layer change, exactly as SDA's tee worked.
    The one non-obvious constraint: SDA's F.Cu trunk at y=65.400 spans x 16.500-30.000
    and its J1 spur runs south at x=27.750, forming a T that walls off F.Cu travel
    southward. SCL therefore runs its own F.Cu trunk 0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
    [aqroot-Beta.kicad_pcb]
2026-08-12 AQROOT Beta: remove the dead SYS stub and close the U13-FB gap
    Both cleanup items closed. DRC 0 electrical errors. BQ25185_SYS ratsnest still
    0 with all 13 pads on ONE island; Net-(U13-FB) ratsnest 0 with all 3 pads on one
    island - both verified by union-find over track/via/pad geometry, not by DRC.
    Dangling endpoints 25 -> 23, and all 23 are intentional staged hand-offs: 0 real
    incomplete, 0 orphans.
    TWO CORRECTIONS TO MY OWN AUDIT, both flagged before editing.
    1. The dead SYS copper is 2.500 mm, not a whole segment, and it needed a TRIM.
    The dangling endpoint at (61.200,30.000) belongs to the 45.000 mm spine
    itself, so deleting "the stub" as an object would have destroyed the ent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
    [aqroot-Beta.kicad_pcb]
2026-08-12 AQROOT Beta: slide the BMI270_INT1_STRAP leg south to open the USB corridor
    Local reroute only. DRC 0 electrical errors. BMI270_INT1_STRAP ratsnest still 0
    with R18.2, TP3.1 and U1.15 on ONE island, verified by union-find over
    track/via/pad geometry. Topology unchanged - the leg still terminates directly
    into the U1.15 pad, which is a slide within the pad, not a re-termination.
    before VIA (19.800, 18.800) drill 0.30 / pad 0.60
    In2 (19.800, 62.900)-(19.800, 18.800) 44.100 mm
    B.Cu (19.800, 18.800)-(25.000, 18.800) w=0.20 5.200 mm
    after VIA (19.800, 19.300) drill 0.30 / pad 0.60 (same via technology)
    In2 (19.800, 62.900)-(19.800, 19.300) 43.600 mm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
    [aqroot-Beta.kicad_pcb]
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2026-08-12 set C21 C22 data pins NC for Beta
    CTO ruling, Option B locked. C21/C22 stay physically placed at 100 pF DNP
    as an optional USB Full-Speed edge-rate / EMI tuning footprint, but their
    data-side pins are intentionally NC for Beta. GND pins retained.
    Schematic (01_power_tree): deleted the C21 pin-1 stub wire (54.61,57.15)
    -> (54.61,58.42) and the C22 pin-1 stub (76.2,57.15) -> (76.2,58.42),
    then placed no-connect flags on both data pins. The two local labels
    USB_D_MCU_N/P that those stubs terminated into were orphaned by the wire
    deletion and removed with them, otherwise ERC gains two new live
    label_dangling errors. Hierarchical labels untouched. Added one schematic
    note beside the pair.
    PCB: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
    [01_power_tree.kicad_sch, aqroot-Beta.kicad_pcb]
2026-08-12 route the USB MCU-side pair end to end
    USB_D_MCU_N and USB_D_MCU_P are complete. Both E4 handoff vias at
    (53.400,86.000) and (54.150,86.000) are consumed and each net is now a
    single copper island: J3 -> U10 -> R33/R34 -> E4 -> MCU route -> U1.13 /
    U1.14. No copper was added to C21/C22; their data pads stay on
    unconnected-(Cxx-Pad1) with zero copper on those nets.
    The prior attempt was never committed, so the route was rebuilt from the
    directive's fixed points. Three measurements confirm it landed on the same
    geometry: SYS clearances 0.265 mm and 0.285 mm at the crossover via rows,
    and the 1.200 mm U1/BMI-strap corridor.
    The chirality crossover is structural, not stylistic. The transition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
    [aqroot-Beta.kicad_pcb]
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2026-08-12 move U9 to open SPI-B escape
    U9 (24.500, 22.000) -> (24.500, 22.050). dX 0.000, dY +0.050, magnitude
    0.050 mm, direction S. Rotation and side unchanged. That is the FIRST
    candidate the ordered magnitude-major sweep tested, so the sweep stopped
    there - no larger move evaluated, no optimisation attempted.
    All three SPI-B escapes are now legal for a 0.20 mm F.Cu track, each
    verified analytically at its pinch point rather than read off the grid:
    U9.30 0.2300 mm clearance (margin 0.0300)
    U9.31 0.2126 mm clearance (margin 0.0126) - pinch (23.605, 18.935)
    U9.32 0.6500 mm clearance (margin 0.4500)
    Each also has an ordinary 0.60/0.30 via landing reachable from its escape.
    Correction to t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
    [aqroot-Beta.kicad_pcb]
2026-08-12 move U9 for simultaneous SPI-B escape
    U9 -> (24.500, 22.250). Total from the original (24.500, 22.000):
    dX 0.000, dY +0.250, magnitude 0.250 mm, direction S. Incremental from
    the committed (24.500, 22.050): +0.200 mm S. Rotation and side unchanged.
    First candidate in the binding sweep order to survive an actual
    simultaneous three-track test, so the sweep stopped there.
    The winning mechanism is a west bypass, not a wider gateway. The NE
    gateway is 0.8438 mm and still carries one 0.20 mm track; the extra
    travel opens the gap between the USB_D_MCU_N via and U9.32's pad far
    enough for MOSI to leave westward, freeing the NE gateway for SCK alone.
    Three routes laid simultaneously, each an obstac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
    [aqroot-Beta.kicad_pcb]
2026-08-12 complete SPI-B shared bus
    All three shared SPI-B nets close. Each is a single copper island holding
    all four endpoints; board ratsnest 430 -> 424; DRC 0 electrical errors.
    SPI_B_SCK U1.4, U9.30, U8.18, U7.18 210.599 mm, 27 tracks, 5 vias
    SPI_B_MOSI U1.5, U9.31, U8.17, U7.17 197.238 mm, 25 tracks, 6 vias
    SPI_B_MISO U1.6, U9.32, U8.16, U7.16 195.522 mm, 23 tracks, 8 vias
    The three U9 escapes were laid on the proven coordinates verbatim,
    extended only into the pad so each starts on copper. Measured as an
    ensemble rather than trusting DRC alone:
    SCK <-> MOSI 0.3350 SCK <-> MISO 0.8000 MOSI <-> MISO 0.2250
    SCK <-> USB 0.3761 MOSI <-> USB 0.2142 MISO <-> USB 0.5500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
    [aqroot-Beta.kicad_pcb]
2026-08-13 route SX1262 CS_N and BUSY
    Closes the two U1-origin SX1262 control nets. Each is a single copper
    island: SX1262_CS_N over U1.10, U8.19 and R27.2 (R27 is a pull-up tee,
    confirmed from the netlist, not a series element); SX1262_BUSY over
    U1.12 and U8.14. Board ratsnest 424 -> 419, DRC 0 electrical errors.
    The U1 belly corridor between the north pad row and the
    BMI270_INT1_STRAP track is 1.200 mm and holds exactly two 0.20 mm
    tracks, at y 18.300 and y 18.700, at exactly 0.2000 mm throughout.
    Escape depth must increase eastward, and BUSY is capped by the strap,
    so only two of the three controls can leave U1. SX1262_DIO1 is left
    unrouted deliberately; its solution space is intact and it needs a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
    [aqroot-Beta.kicad_pcb]
2026-08-13 move SX1262_DIO1 to IO38, NFC_IRQ to IO18
    SX1262_DIO1 could not escape U1.11 under any placement-preserving
    routing: the U1 belly corridor holds exactly two 0.20 mm tracks and
    both are consumed by SX1262_CS_N and SX1262_BUSY, while the USB F.Cu
    pair forbids any through-via north of them. Deleting the entire
    BMI270_INT1_STRAP net still left zero reachable via sites, and the
    four-depth stack destroyed the last transition pocket. The trap is a
    property of the pad, not the net, so swapping DIO1 with CS_N or BUSY
    would only strand a more critical signal.
    U1.31 / IO38 was chosen from a flood test of candidate host pads:
    31,369 legal via sites at 1.100 mm best margin, on the south row and
    on the c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
    [02_mcu_core.kicad_sch, aqroot-Beta.kicad_pcb]
2026-08-13 route SX1262_DIO1 from IO38
    Closes the last U1-origin SX1262 control. One copper island over U1.31
    and U8.13, 148.407 mm, 14 tracks and 5 vias across B.Cu 7 / In2 5 /
    F.Cu 2, minimum clearance 0.30000 mm copper across the whole net.
    Board ratsnest 419 -> 417, DRC 0 electrical errors.
    From U1.11 this net had zero reachable via sites under any
    placement-preserving change. From U1.31 it routed on the first attempt
    with half again the clearance the CS_N and BUSY escapes had to accept,
    and with no zero-margin geometry anywhere.
    Three walls, three answers. The SD_CS_N / SPI_A palisade plus
    DISP_CS_N's In2 vertical block both B.Cu and In2 across x 23.7-27.4,
    so a 4.6 mm F.Cu hop between two vias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
    [aqroot-Beta.kicad_pcb]
2026-08-13 route SX1262_RXEN from U3.19
    Closes SX1262_RXEN: one island over U3.19, R74.1 and U8.6, 197.227 mm,
    18 tracks and 4 vias across B.Cu 12 / In2 5 / F.Cu 1. Board ratsnest
    417 -> 414, DRC 0 electrical errors. E5 x66 consumed.
    Topology was verified from the netlist rather than assumed: R74.2 and
    R13.2 are both GND, so both resistors are pull-down tees, not series
    elements. Neither net originates at U1.
    RXEN was routed first because it is by far the more constrained: its
    source U3.19 sits at y 9.4 behind the I2C fan-out barrier whose only
    0.200 mm opening SX1262_BUSY consumed in pass 3A-1, and it must cross
    the whole board. U3 is a TSSOP-24 with 0.25 mm inter-pad gaps and
    HEADER RESERVED 0.2 mm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
    [aqroot-Beta.kicad_pcb]
2026-08-13 route SX1262_RST_N from U2.5
    Closes SX1262_RST_N: one island over U2.5, R13.1 and U8.15, 159.325 mm of
    new copper in 17 tracks and 7 vias across In2 9 / B.Cu 8 / F.Cu 1. Board
    ratsnest 414 -> 411, DRC 0 electrical errors. E5 x65 consumed in place.
    The north-window architecture from the previous analysis pass held. The
    source leaves U2.5 west on B.Cu, dives to In2 at x 13.700 to clear the
    WAKE_INT_N B.Cu wall, returns to B.Cu at y 52.000 for the R13 pull-down
    tee at x 17.375, hops F.Cu across x 23..30, then runs In2 east to x 57
    and north to y 38.000. The band crossing is a B.Cu run at y 38.000 from
    x 57 to x 71, well clear of both antenna bands, and the return descends
    In2 down the east edg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
    [aqroot-Beta.kicad_pcb]
2026-08-13 route DIO2_TXEN, closing SX1262 digital control
    Closes DIO2_TXEN with a single B.Cu segment from U8.7 (72.000, 130.920)
    to U8.8 (72.000, 132.190): 1.270 mm, 1 track, 0 vias, one layer. Board
    ratsnest 411 -> 410, DRC 0 electrical errors.
    Topology was taken from the current netlist rather than assumed. The net
    is sheet-local, /04_SPI_B_RADIOS_NFC/DIO2_TXEN, and carries exactly two
    pads: U8.7 and U8.8, adjacent on the east pad column at 1.27 mm pitch.
    The schematic ties them with two DIO2_TXEN labels on separate stubs and
    adds no pull-up, pull-down, series element or test branch, so the
    minimum local connection is the direct pad-to-pad link and nothing more.
    The track runs down the pad-column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
    [aqroot-Beta.kicad_pcb]
2026-08-13 route CC1101_CS_N and CC1101_GDO0, closing radio digital control
    Closes both CC1101 control nets. CS_N: one island over U1.7, R28.2 and
    U7.19, 168.078 mm of new copper in 16 tracks and 5 vias. GDO0: one island
    over U1.8 and U7.15, 166.487 mm in 24 tracks and 7 vias. Board ratsnest
    410 -> 405, DRC 0 electrical errors. E5 x67 and x68 consumed in place.
    Topology was re-read from the current netlist. R28.1 is +3V3 and R28.2 is
    CC1101_CS_N, so R28 is a pull-up tee and the trunk does NOT pass through
    it; R28.2 is the only F.Cu terminal on either net. GDO0 carries exactly
    two pads, U1.8 and U7.15, with no pull resistor and no test point.
    CS_N was routed first because it is the more constrained ne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
    [aqroot-Beta.kicad_pcb]
2026-08-13 route +3V3 north backbone (Pass A: clusters F/C/B/A)
    Builds the north +3V3 tree from the TPS63020 output island: 205.135 mm of
    new copper in 57 tracks and 9 vias across B.Cu 38 / F.Cu 14 / In2 5. Board
    ratsnest 405 -> 384, +3V3 ratsnest 69 -> 48, +3V3 islands 70 -> 49. DRC 0
    electrical errors.
    All 27 Pass-A pads now sit on ONE island with the U12 source: the six that
    were already tied (U12.4, U12.5, C29.1, C30.1, C31.1, C32.1) plus the 21
    routed here. Cluster F adds R39.1 and R41.1; cluster C adds U5.7, U5.8,
    C9.1, C12.2, R24.2, C10.1, R21.1, C8.1, MK1.5, U15.1; cluster B adds
    U16.1, C37.1, C40.1, C5.1, U3.24; cluster A adds C2.1, C3.1, R1.2, U1.2.
    Topology is a single tree, not a star. Th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
    [aqroot-Beta.kicad_pcb]
2026-08-13 add E6_3V3_PAD_ESCAPE and U3_21_ESCAPE rule areas (rules only)
    Adds the CTO-approved routing-rule infrastructure for the +3V3 pads that are
    trapped by neighbouring escapes. Nine named rule areas in the board, three
    custom rules at the end of aqroot-Beta.kicad_dru. No copper routed, no
    placement moved, no existing zone touched.
    Board Setup floors were already sufficient and are UNCHANGED: minimum track
    width 0.15 mm, minimum clearance 0.0 mm. Both are DRC floors only - they
    grant no permission for copper outside the named areas, and netclass and
    custom rules continue to govern ordinary routing. aqroot-Beta.kicad_pro is
    not modified.
    Standard E6 pockets, +3V3 only, width >= 0.15 mm with clea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
    [aqroot-Beta.kicad_pcb]
2026-08-13 lock JLCPCB fab, measure per-pad E6 clearances, open U3.21 escape
    Rules-only finalisation of the +3V3 Pass-B gates. No copper routed, no
    placement moved, no existing copper touched. The board diff is six lines:
    the two intended zone edits.
    FAB LOCK. JLCPCB is the locked Beta fab - 4-layer, 1.6 mm finished, 1 oz
    outer / 0.5 oz inner, stackup JLC04161H-7628. Published capability checked
    2026-08-13 against "PCB Manufacturing & Assembly Capabilities - JLCPCB",
    https://jlcpcb.com/capabilities/pcb-capabilities, row "Min. track width and
    spacing (1 oz)": multilayer 0.09 / 0.09 mm (3.5 / 3.5 mil). So minimum outer
    track width 0.09 mm and minimum outer spacing 0.09 mm. JLCPCB's own
    recommended produ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
    [aqroot-Beta.kicad_pcb]
2026-08-13 add four width-only +3V3 escape pockets (rules only)
    Implements the CTO-approved E6_R3_2, E6_U4_5, E6_U4_12 and E6_J1_35 areas.
    Four rule areas in the board, four custom rules at the end of
    aqroot-Beta.kicad_dru. No copper routed, no placement moved, no existing
    copper or rule touched; the board diff is pure insertion.
    WIDTH-ONLY MEANS WIDTH-ONLY. These four pads are limited by width alone -
    each escapes at the ordinary 0.20 mm clearance once the trace narrows - so
    every rule constrains track_width and NONE carries a clearance term. Clearance
    is left entirely to the P3V3 netclass, which is what stops these pockets from
    silently diverging from the global 0.20 mm figure later. That makes them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
    [aqroot-Beta.kicad_pcb]
2026-08-13 route +3V3 Pass B1 (cluster E normal-width)
    Routes 16 of the 17 listed cluster-E pads at ordinary P3V3 geometry:
    72.351 mm in 41 tracks and 6 vias across B.Cu 33 / F.Cu 6 / In2 2. Board
    ratsnest 384 -> 368, +3V3 ratsnest 48 -> 32, +3V3 islands 49 -> 33, source
    island 27 -> 43 pads. DRC 0 electrical errors.
    NO E6 RELIEF WAS USED. Every B1 track is 0.60 mm (27) or 0.40 mm (14) - all at
    or above the P3V3 outer-layer minimum - and every via is POWER-class 0.80/0.40.
    The whole pass stays legal with all E6 rules conceptually ignored: no width
    below 0.40 and no clearance relief anywhere. Minimum clearance is 0.2000 mm,
    the ordinary global figure.
    Routed in three geographic batches, DRC 0 after ea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
    [aqroot-Beta.kicad_pcb]
2026-08-13 route +3V3 Pass B2 (cluster G, cluster H absorption, C13.1)
    Absorbs both orphan cluster-H islands, routes the normal-width cluster-G pads
    and closes C13.1: 53.140 mm in 17 tracks and 3 vias across B.Cu 13 / F.Cu 4.
    Board ratsnest 368 -> 361, +3V3 ratsnest 32 -> 25, +3V3 islands 33 -> 26,
    source island 43 -> 52 pads. DRC 0 electrical errors.
    All nine B2 pads - J1.7, J1.8, J1.9, R26.1, C43.1, L3.1, C56.1, U17.5 and
    C13.1 - are on the one island containing U12.4/U12.5.
    NO E6 RELIEF WAS USED. Widths are 0.60 mm (12) and 0.50 mm (5), all at or above
    the P3V3 outer minimum, and no B2 segment enters any of the 13 relief pockets at
    all. The pass stays legal with every E6 rule conceptually ignored.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
    [aqroot-Beta.kicad_pcb]
2026-08-14 B3 rule correction: move E6 areas onto the measured constrained regions
    The E6 pockets were sized as "pad + first ~2 mm of escape", assuming the
    sub-0.20 mm clearance region sits next to the pad. It does not, and since
    the clearance rules are enclosedByArea a track leaving its pocket loses
    relief along its whole length - which is why Pass B3 wrote zero copper.
    Measured against HEAD 7b16f0f and relocated with tight containment:
    E6_R2_1 -> x 22.800-23.800 y 35.500-36.500, F/In1/In2/B
    VIA-SITE relief for a through via at (23.300, 36.000);
    reduced-clearance TRACK length is 0.000 mm.
    Hole-referenced: 0.100 copper-edge + 0.200 ring = 0.300 mm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
    [aqroot-Beta.kicad_pcb]
2026-08-14 Final B3 rule update: paired CLR/WIDTH areas, C18.1 reclassified width-only
    The previous pass moved the E6 clearance pockets onto the measured
    reduced-clearance regions but left width relief dangling: the narrow runs are
    2.4-4.5 mm while the clearance pockets are under 1.6 mm, and the shared width
    rule used intersectsArea, which is per-object and would let a track clip the
    area and stay narrow outside it. Each case now carries two areas, both using
    enclosedByArea.
    E6_R2_1_CLR x 22.800-23.800 y 35.500-36.500 F/In1/In2/B clr 0.100
    E6_R2_1_WIDTH x 20.625-23.450 y 35.800-38.125 B.Cu 2.916 mm
    E6_J1_40_CLR x 30.950-31.800 y 78.150-78.550 F.Cu clr 0.120 0.641 mm
    E6_J1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
    [aqroot-Beta.kicad_pcb]
2026-08-14 R29.1 final rule pass: paired CLR/WIDTH areas on the measured geometry
    The old combined E6_R29_1 wrapped the pad at x 17.575-20.725 y 16.275-17.925,
    but R29.1's escape runs west along y ~17.5 and pinches about 6 mm away. The
    area granted relief where the route never goes and none where it needs it.
    The earlier 9.757 mm narrow figure was an upper bound from a clearance-
    minimising search. Re-measured minimising sub-0.40 mm width length:
    reduced-clearance run 0.350 mm (11.850,18.900)->(11.850,19.250) F.Cu
    clearance required 0.1753 mm, limited by via /SPI_B_SCK
    narrow-width run 1.991 mm (11.850,17.700)->(11.750,19.650) F.Cu
    handoff (11.700,19.700), no v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
    [aqroot-Beta.kicad_pcb]
2026-08-14 extend E6_J1_42_WIDTH north by 0.140 mm (rules only, no copper)
    The J1.42 +3V3 escape leaves the J1 pad row northward. Its 0.15 mm neck
    must reach the first point where a normal-width P3V3 track is legal
    before it can widen, and that point is fixed by the GND pad J1.43 corner
    at (28.900, 79.535): a 0.40 mm track on the pad centreline x = 29.250
    holds 0.200 mm from it only at
    Yh <= 79.535 - sqrt(0.40^2 - 0.35^2) = 79.341351
    KiCad agrees - 79.342 passes, 79.345 raises clearance. The approved
    handoff 79.320 lies inside that limit and its end cap reaches
    79.320 - 0.075 = 79.245, so E6_J1_42_WIDTH moves its north edge
    79.385 -> 79.245. The strictest legal handoff would need only 79.267,
    so the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
    [aqroot-Beta.kicad_pcb]
2026-08-14 route +3V3 Pass B3: all seven remaining escape pads
    First B3 copper. R2.1, J1.40, J1.41, J1.42, R11.1, R29.1 and C18.1 all reach
    the one verified source island containing U12.4/U12.5. 112 track segments and
    5 vias added; nothing removed.
    Every route was solved against that island alone. Other orphan +3V3 pads and
    other candidates' narrow necks were carried as obstacles, so no pad borrows
    another pad's neck; candidate copper was only allowed to merge once it was at
    or above 0.40 mm.
    R2.1 narrow B.Cu dogleg -> POWER via (23.300, 36.000) -> normal F.Cu
    J1.40 own neck -> east through E6_J1_40_CLR -> via (32.350, 78.495) -> B.Cu
    J1.41 own north neck -> handoff y = 79.330 -> shared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
    [aqroot-Beta.kicad_pcb]
2026-08-14 extend E6_J1_41_WIDTH north by 0.140 mm (B3 pad-scope correction, no copper)
    Post-route review of the B3 pass found J1.41's 0.15 mm north neck authorised by
    E6_J1_42_WIDTH rather than by its own area. Ruled unacceptable: legal under the
    DRU, but it makes one pad's escape depend on a neighbour's rule area, which the
    E6 registry is supposed to prevent.
    E6_J1_41_WIDTH stopped at y = 79.385, so it can only enclose a neck whose
    handoff is at y >= 79.460, while the legal handoff band set by the 0.20 mm
    clearance to the GND pad J1.43 corner is 79.320..79.342. The two do not overlap,
    so J1.41 could not be authorised by its own area at all. Its north edge now
    moves 79.385 -> 79.245, the identical 0.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
    [aqroot-Beta.kicad_pcb]
2026-08-14 route +3V3 Pass B4: U3.21 and U9.1
    Two pads, seven track segments, no vias. B3 was pushed and hard-locked first;
    nothing in it was touched - all 112 B3 track objects are byte-identical and no
    B3 rule area changed.
    U3.21 (TCA9535 A0 strap), B.Cu only: 0.40 mm north stub out of the pad, 0.60 mm
    east run through the 1.270 mm corridor between the J5 header pads and the U3 pin
    row at y = 8.150, 0.40 mm south onto U3.24 and the +3V3 trunk. 4.300 mm total,
    zero narrow copper, zero reduced clearance, 0.2500 mm minimum clearance
    throughout. All three segments intersect HEADER RESERVED and all three are
    wholly enclosed by U3_21_ESCAPE, so the scoped exception carries them; no other
    net, no via, no ge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
    [aqroot-Beta.kicad_pcb]
2026-08-14 relocate E6_R3_2 to the valid R3.2 topology (rules only, no copper)
    R3.2's width pocket was sized for a topology whose only landing was R11.1's
    0.15 mm B3 neck - a narrow-to-narrow merge, forbidden. Under the corrected rule
    that every sub-0.40 mm +3V3 object is an obstacle rather than a source, the valid
    route runs elsewhere, and so does the relief it needs.
    old E6_R3_2 x 18.300-20.025 y 42.200-45.475 B.Cu
    new E6_R3_2 x 17.705-19.445 y 48.605-48.845 B.Cu
    The two rectangles do not overlap: this is a relocation, not an extension, and no
    dormant width relief is left behind. Rule terms are untouched - track_width min
    0.15 opt 0.60, enclosedByArea('E6_R3_2'), +3V3 only, no clearance t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
    [aqroot-Beta.kicad_pcb]
2026-08-14 route +3V3 Pass B5: R3.2, U4.5, U4.12, J1.35
    Four pads, 31 track segments, one via. This closes the +3V3 escape programme -
    every pad that needed an E6 width or clearance concession is now routed.
    R3.2 B.Cu, no via. 0.40 mm out of the pad, 6.45 mm south at full width,
    1.602 mm squeeze at y ~ 48.7 inside the relocated E6_R3_2, back to
    0.40 mm, landing on C4.1's +3V3 pad.
    U4.5 B.Cu, no via. 0.862 mm at 0.30 straight onto U4.3's +3V3 pad.
    U4.12 B.Cu, no via. 1.671 mm at 0.20, handoff (11.302, 63.736), 0.40 mm onto
    U4.2's +3V3 pad.
    J1.35 Option V. 0.830 mm neck, handoff (32.750, 80.980), 0.40 mm F.Cu south,
    via (32.580, 85.490) 0.65/0.40, 0.40 m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
    [aqroot-Beta.kicad_pcb]
2026-08-14 route +3V3 Pass C: south-east radio tree and J2 west tree
    Ten ordinary pads - U8.9, C17.1, R27.1, U7.9, C16.1, R28.1, J2.4, C14.1, C15.1,
    R25.1 - in 37 segments and 6 vias, every segment 0.60 mm. No sub-0.40 copper, no
    E6 area, no clearance relief. Only J5.1 remains, deferred to Pass D.
    The staged x69.100 crossing is consumed in place, not rewritten: both tracks
    (a9a1f1c1 In2, 84b0b5ea B.Cu) and both vias (a4127ae1 at y=86, 07a407a2 at y=116)
    are identical including UUIDs. Pass C connected to its endpoints - a 25.938 mm
    F.Cu feed from the source island down to the north via, and branches off the B.Cu
    leg below y=141 - moving the crossing from a dangling 2-track/2-via island onto
    the U12.4/U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
    [aqroot-Beta.kicad_pcb]
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2026-08-15 Implement J5 GND thermal relief and U3-wall budgets
    Resolves both Batch-1 stop conditions without routing any signal copper.
    J5's five GND barrels were solid-connected to the In1 plane: the zone carries
    (connect_pads yes), which in KiCad means solid, and the pads had no override.
    Solid is thermally hostile for a 26-pin through-hole connector. Ruling applied
    locally, not board-wide: (zone_connect 1) on J5.2/.7/.13/.20/.25 only, inserted
    between (net "GND") and (uuid ...) to match the file's canonical ordering. No
    thermal parameters invented - spoke width and gap inherit the zone's own
    (thermal_gap 0.5) (thermal_bridge_width 0.5).
    Measured back from the refilled polygon, identical on all fiv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
    [aqroot-Beta.kicad_pcb]
2026-08-17 Implement F4 J5 pin map and the 19/19 header escape
    Land the CTO-approved F4 pin map and the first complete J5 escape. Eight J5
    pads move, in exactly three logical swaps -- WAKE <-> GND, the external I2C
    pair <-> XGPIO10/11, and ACC <-> RESERVED_NC. No header function is added or
    removed: all 14 XGPIO, FAST_IO, external I2C, switched accessory power,
    WAKE/ATTN, +3V3 and five grounds are preserved.
    Schematic: J5.15/16 take the external I2C names by label. J5.21/22 were
    WIRE-bound to the I2C front end (D2, R47/R48 series, R49/R50 pull-ups), so
    renaming their remote labels would have aliased the whole front end onto
    XGPIO10/11. Instead the two dead-end spurs are cut below the pull-up taps at
    (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
    [09_community_header.kicad_sch, aqroot-Beta.kicad_pcb]
2026-08-17 Route the DRU-sanctioned part of the E2 button block
    Land the button escapes that the committed DRU already authorises, and leave
    the rest for an RF ruling rather than forcing them through.
    Routed: BTN_UP_N, BTN_LEFT_N and BTN_RIGHT_N (netclass E2_BUTTON_ESCAPE, so
    F.Cu is permitted in-band) escape north out of the 915 band to their series
    resistors; BTN_B_N and the R.2<->U2 links for A/B/HOME/LEFT/RIGHT/UP cross on
    In2 inside their E5 corridors; SW7 and SW8 GND pads, which sit outside both
    bands, get pad-pair links and vias down to the In1 plane.
    194 segments, 26 vias, zones refilled. DRC 0 errors with warning parity
    against baseline (241). Button ratsnest 40 -> 19 edges; UP, LEFT and RIG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
    [aqroot-Beta.kicad_pcb]
2026-08-17 hardware(beta): complete approved E2 RF escape rules
    Encode the standing post-I2C section 5 ruling in the DRU, which until now only
    covered BTN_UP/LEFT/RIGHT via the E2_BUTTON_ESCAPE netclass. Adds ten tight,
    named F.Cu rule areas -- E2_ESC_DOWN/A/HOME and E2_GND_SW2/SW3/SW4A/SW4B/
    SW5A/SW5B/SW6 -- each a union of the rectangles around exactly one approved
    escape, and extends the condition of "RF bands: F.Cu carries no ordinary
    copper" to exempt those named nets when enclosedByArea their own area.
    No base RF rule is weakened. The B.Cu prohibition, the in-band via
    prohibition and the In2/E5-corridor rule are byte-identical, so the new
    exception buys F.Cu only. No generic GND permission is cr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
    [aqroot-Beta.kicad_pcb]
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2026-08-17 hardware(beta): land the approved BTN_B_N E4 crossing
    Land the exact authorised crossing: BTN_B_N on In2.Cu, 0.15 mm, x = 54.860,
    y 86.000 -> 116.000, plus the minimal out-of-band continuations needed to join
    it to the existing BTN_B network. 48 segments, 6 vias, 102.62 mm.
    No DRU change was required and none was made. The probe matrix on the current
    board shows the crossing is already legal under the existing E5_CROSSING
    rules, while shifted variants (x 52.0, x 57.5), F.Cu and B.Cu in E4, a
    wandering E4 route and an in-band via are all correctly denied. Unauthorised
    nets (XGPIO0_HDR, BTN_UP_N) are refused by "E5: only authorised netclasses".
    Adding a rule would have broadened nothing, so E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
    [aqroot-Beta.kicad_pcb]
2026-08-17 hardware(beta): E2 R5.2/+3V3 joint solution, Candidate A
    Release exactly three +3V3 B.Cu 0.60 segments and land the validated
    Candidate A pair: +3V3 18.904 mm at 0.60 with 2x 0.80/0.40 vias, and
    BTN_DOWN_N R5.2 -> U2.14 21.067 mm at 0.20 with 2x 0.60/0.30 netclass
    vias. Stock geometry throughout; no rule relaxed and no DRU change.
    R5.2 has exactly one legal escape site on the whole board, and taking it
    necessarily severs the local +3V3 bar, so the two nets were routed as
    negotiated participants rather than in sequence. Both sequential
    orderings fail 162/162.
    DRC 0 errors. Warnings 244 -> 246 like-for-like; the +2 track_dangling
    are two pre-existing +3V3 tails left single-ended by the autho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
    [aqroot-Beta.kicad_pcb]
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2026-08-17 hardware(beta): E2 closeout, Option D. Button ratsnest 0, E2 hard-locked
    Complete BTN_DOWN, BTN_A and BTN_HOME, and remove the two dead +3V3
    stubs. No DRU change, no new crossing rule, sanctioned C-W In2 crossing
    retained and now terminated at both ends.
    The blocker was geometric: the inter-band gap gives a 0.20 track only
    0.800 mm of legal centreline, while a 0.60/0.30 via needs 1.200 mm, so
    any via in it seals the gap. BTN_A's escape sat in the compartment
    bounded by a GND escape via at x=41.820 and BTN_HOME's escape via at
    x=52.580, with no E5 corridor in reach. Option D removes that one via.
    HOME reworked: 83.450 mm, 24 segments, 1 via at (41.350,139.500), whose
    clearance envelope clea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
    [aqroot-Beta.kicad_pcb]
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2026-08-18 hardware(beta-dm): land the 3-net microphone I2S bus
    I2S_BCLK U1.32 -> MK1.4 84.281 mm 5 vias B.Cu 0.69 F.Cu 42.01 In2 41.58
    I2S_LRCLK U1.33 -> MK1.1 87.909 mm 8 vias B.Cu 41.33 F.Cu 19.30 In2 27.28
    I2S_MIC_DIN U1.35 -> MK1.6 91.635 mm 8 vias B.Cu 15.21 F.Cu 56.67 In2 19.75
    total 263.824 mm 21 vias
    Escape vias at (17.550,34.100), (16.700,35.550) and (13.650,35.000). There is no
    I2S_SPK_DOUT demand on the Demo Model, so this is a 3-net problem and the paused
    4-net Full-Beta conclusion was not reused.
    The route is the artifact the previous pass solved by negotiated congestion and
    validat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
    [aqroot-Beta-DM.kicad_pcb]
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2026-08-19 hardware(beta-dm): GND stitching for both radios and the microphone
    Copper. Only hardware/beta-dm/ is touched. Pours are NOT in this commit - they
    wait on BOOT_N, which is blocked and returned for ruling.
    25 stitches: pad -> short stub -> via -> the In1 GND REFERENCE plane. This is
    stitching, not GND routing: the plane is the return path, so each pad needs a
    via into it rather than a trace across the board.
    U8 SX1262 10 pads (1,2,3,4,5,10,11,12,20,22)
    U7 CC1101 9 pads (1,2,3,4,5,11,12,20,22)
    MK1 mic 2 pads (2,3)
    local decoupling returns: R74.2, C17.2, C16.2, C8.2
    Stub lengths 0.536-1.074 mm, so every module ground pad has a short, local
    return rather than a long de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
    [aqroot-Beta-DM.kicad_pcb]
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2026-08-19 hardware(beta-dm): GND stitching for the USB-C connector, the MCU and the switches
    Copper. Only hardware/beta-dm/ is touched. Still no pours.
    9 further stitches on grounds that gate a demo function rather than waiting for
    the pour to find them:
    J3.A12 USB-C connector ground
    U1.1, U1.40 ESP32-S3 module grounds
    SW1.2 BOOT switch return
    R30.2, R31.2 the two 5.1k CC pull-downs - without these the Rd termination
    has no return and USB-C sink detection does not work
    R32.2 the 0R shield tie
    C1.1 the EN reset capacitor return
    R42.1 the PS_SYNC 0R tie to GND
    Stub lengths 0.525-0.810 mm.
    J3.B12 could not be stitched: no legal via site within 3.6 mm of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
    [aqroot-Beta-DM.kicad_pcb]
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2026-08-19 hardware(beta-dm): pin the LED_BOOST netclass to its six display nets
    The LED_BOOST patterns were written with a leading wildcard. `*LED_K` matched
    the display backlight cathode as intended AND `/07_IR/IR_LED_K`, the infrared
    transmitter's LED cathode - an unrelated net on a DNP block, silently carrying
    the elevated 0.30 mm backlight routing clearance.
    All six patterns are now pinned to their exact sheet paths, which is an
    established style in this file (18 of 61 patterns already use one). Before: 7
    nets resolved to LED_BOOST. After: exactly the intended 6.
    No routing change and no DRC change is possible from this: IR_LED_K and
    IR_LED_A have 0 tracks and 0 vias - the IR block is DNP and un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
    [netclass_probe.py]
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2026-08-19 hardware(beta-dm): Option W landed, BOOT_N complete, no new rule exception
    Implements the CTO ruling on BOOT_N. Released 38 objects - /WAKE_INT_N
    (15 seg, 4 via, 68.633 mm) and the R2-local +3V3 escape (18 seg, 1 via,
    5.528 mm) - then routed BOOT_N, re-landed WAKE_INT_N and re-joined R2.1.
    BOOT_N 52.445 mm, 67 seg, 5 via, one island: U1.27, R2.2, both SW1.1
    WAKE_INT_N 97.588 mm, 178 seg, 4 via, one island, all five fitted pads kept
    (R3.1, R66.1, U1.23, U2.1, U3.1)
    +3V3 R2.1 3.531 mm, 13 seg, 1 via, rail one island
    The ruling authorised a local 0.175 mm power-via clearance exception. It is
    NOT needed and was NOT created. With the P3V3 outer-layer width floor
    (0.40 m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
    [aqroot-Beta-DM.kicad_pcb]
2026-08-19 hardware(beta-dm): active-J5 residual sweep, four must-work lines closed
    With J5 kept active, every fitted J5 signal path is must-work. Re-audited the
    whole fitted must-work non-GND set on the post-Option-W board and routed what
    fits under the current locks:
    XGPIO6_HDR R57.1 -> the J5.10 island 1.613 mm, 5 seg, F.Cu, one island
    Net-(SW9-A) SW9.1 <-> U12.12 <-> R43.1 89.399 mm, 76 seg, 6 via
    ACC_3V3_SW one join 2.504 mm, 2 seg, B.Cu
    ACC_3V3_SW resolves to the P3V3 netclass, so it is routed at the 0.40 mm
    outer-layer width floor. Routing it at the 0.20 mm default produced four
    track_width errors and was discarded rather than kept.
    Unconnected 220 -> 216. Ki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
    [aqroot-Beta-DM.kicad_pcb]
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2026-08-20 hardware(beta-dm): LAND XGPIO5 + XGPIO6 - Lean must-work non-GND reaches ZERO
    Real-board landing. Ledger re-derived on the landed board:
    215 = A63 + B130 + C0 + D22 C = 0
    THE AUTHORISED 0.45/0.20 VIA COULD NOT BE USED. Section 2's reasoning is
    correct - /XGPIO5 is Default class and the DRU's 0.40 mm drill floor is
    POWER-class only - but the binding constraint is in BOARD SETUP, not the DRU:
    rules.min_via_diameter 0.5 <- 0.45 violates this
    rules.min_through_hole_diameter 0.2 <- the 0.40/0.15 fallback violates this too
    Tested rather than assumed; KiCad returned
    ERR via_diameter | min diameter 0.5000 mm; actual 0.4500 mm
    Changing either would be modifying the glob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
    [aqroot-Beta-DM.kicad_pcb]
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2026-08-20 Beta-DM: retire the obsolete E6_R2_1 clearance and width exceptions
    E6_R2_1 granted a 0.100 mm local clearance and a 0.15 mm neck width to
    P3V3 copper inside two small rule areas at the R2 escape. The current R2
    candidate-B escape does not need either: removing both rules and both rule
    areas leaves DRC at 0 errors, 137 unconnected, and zero new warning types.
    Verified before removal:
    - E6_R2_1_CLR 0 objects relied on the reduced clearance
    - E6_R2_1_WIDTH all enclosed P3V3 copper already meets the ordinary
    P3V3 0.60 mm width
    - BOOT_N and WAKE_INT_N are Default netclass, so the P3V3-scoped
    conditions never applied to them
    - R2 +3V3, BOOT_N, WAKE_INT_N, XGPIO5, XGPIO6 each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
    [aqroot-Beta-DM.kicad_pcb]
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2026-08-21 Beta-DM: procurement release — resolve 5 MPNs, ground the POFV gate, stop on C24 and J5
    POFV capability gate is no longer "assumed mainstream": checked against
    JLCPCB's published material on 2026-08-21. Filled-and-capped vias are
    compatible with 0.15-0.55 mm and the recommendation is <=0.5 mm finished
    diameter; our drills are 0.25-0.40 mm, so PASS with margin, and the described
    process - non-conductive epoxy fill, levelling, copper over-plating - is
    exactly what was specified. Two items must be confirmed in writing: 4-layer
    POFV is a chargeable option rather than the free 6-layer-and-above default,
    and the 0.15-0.55 mm range must be read as HOLE diameter. That second point is
    material - ou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
    [BETA-DM-MPN-LEDGER.csv, aqroot-Beta-DM-BOM-fitted.csv, aqroot-Beta-DM-DO-NOT-POPULATE.csv]
2026-08-21 Beta-DM: clear both procurement blockers — C24 and J5
    Both former STOPs are resolved, neither needed a PCB change.
    C24. Correcting my own earlier statement: the SYS bulk requirement IS
    specified. TI BQ25185 SLUSF65A (rev January 2026) section 8.2.2.3 gives
    CSYS = 1 / 10 / 100 uF min/nom/max, requires greater than 1 uF AFTER derating,
    recommends 25 V ceramics on IN and SYS specifically because of DC-bias
    derating, and asks for placement as close as possible to the pins. VSYS_REG is
    4.5 V. So the schematic's 25 V was not arbitrary - it follows TI. Only the
    22 uF value and the 0603 package were wrong.
    A second earlier error is corrected too. The previous pass counted C26+C27+C33
    as 30 uF of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
    [09_community_header.kicad_sch, BETA-DM-MPN-LEDGER.csv]
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2026-08-21 Beta-DM: finalize JLC component matching and manual-source plan
    Both CTO rulings applied, the two remaining engineering gates closed with real
    manufacturer data, and the E list is empty.
    D8. The old lock NSR0240V2T5G is a SOD-523 part and the land is SOD-323, so it
    never fitted - a defect in our own ledger that only surfaced because JLC's
    matcher suggested the package-correct sibling. Now locked to onsemi
    NSR0240HT1G, SOD-323, 40 V, 250 mA Schottky. It is NOT pinned to a JLC code:
    C152519 shows 13 in stock against a 116-piece minimum purchase and a negative
    presale balance, so it cannot be bought today. Pinning an unbuyable code only
    fails at checkout. Manual source; two pieces of a 2-pin S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
    [02_mcu_core.kicad_sch, 03_spi_a_display_sd.kicad_sch, 08_buttons_expanders.kicad_sch, AQROOT-Beta-DM-JLC-BOM-v2.csv, AQROOT-Beta-DM-JLC-BOM-v3.csv, AQROOT-Beta-DM-JLC-BOM.csv, BETA-DM-MPN-LEDGER.csv, JLC-MANUAL-SOURCE.csv]
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2026-08-23 hardware: migrate Full Beta v2 display and microSD (FBV2-S1-003)
    Fits R111 per CTO ruling and migrates 03_SPI_A_DISPLAY_SD. Task gate
    FBV2-S1-DISPLAY-SD = PASS. FBV2-S1 itself is 3 of 9 sheets.
    THE INHERITED J1 WOULD HAVE PRODUCED A DEAD DISPLAY, TWICE OVER.
    J1 still used the 2.8-inch CH280QV10_CT_50P pin table while its Value and
    Footprint fields already read FH69-50S-0.5SH. Pin count matched, connector
    matched, ERC was silent. The pin FUNCTIONS did not match ER-TFT035IPS-6:
    panel pin 1/2/3 old: LEDK / LED-A1 / LED-A2 new: LEDA / LEDK / LEDK
    -> backlight reverse-biased, no light
    panel pin 36/37 old: WR_RS->DISP_DC / RS_SCL->SPI_A_SCK
    new: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
    [02_mcu_core.kicad_sch, 03_spi_a_display_sd.kicad_sch, aqroot-Beta-v2.kicad_sch]
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2026-08-23 hardware: migrate Full Beta v2 radios and NFC (FBV2-S1-004)
    Sheet 04. Task gate FBV2-S1-RADIOS-NFC = PASS. FBV2-S1 itself is 4 of 9 sheets.
    ERC: 4 errors -> 2. Total 86 -> 68. Zero added, eighteen removed. This is the
    first migration task to REDUCE the project's error count, and it did so by
    deleting placeholder architecture rather than by suppressing anything.
    ZERO *_TBD NETS REMAIN ANYWHERE IN THE PROJECT. Sheet 04 alone retired fourteen.
    RF ARCHITECTURE LOCKED (D-118).
    433 MHz: INTERNAL flex. U7 IPEX -> 100 mm coax -> Taoglas FXP450.07.0100C against
    a plastic wall. 915 MHz: EXTERNAL. U8 IPEX -> short pigtail -> top-panel SMA
    female bulkhead, user-changeable. Neither band has a motherbo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
    [01_power_tree.kicad_sch, 04_spi_b_radios_nfc.kicad_sch, aqroot-Beta-v2.kicad_sch]
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2026-08-23 hardware: correct Full Beta v2 NFC antenna and matching (FBV2-S1-004C)
    Sheet 04. Task gate FBV2-S1-NFC-MATCHING = PASS.
    ERC 68 -> 68: zero added, zero removed. Errors remain 2, both inherited.
    TWO DEFECTS TURNED UP THAT WERE NOT ON THE BRIEF.
    1. The RX divider would have over-driven the receiver. At full field the antenna
    sits at 49.5 V pk-pk differential, 24.8 V pk-pk per side. The placeholder
    47pF / 220pF divider has a ratio of 0.176 and would therefore have put about
    4.4 V pk-pk on RFI1/RFI2 - against a 3.0 V regulated analog rail. That is a
    part-stress condition, not a tuning imperfection, and it had been carried since
    the topology was first drawn without ever being checked against a r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
    [04_spi_b_radios_nfc.kicad_sch]
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2026-08-23 hardware: migrate Full Beta v2 I2C devices and IMU (FBV2-S1-005)
    Sheet 05. Task gate FBV2-S1-I2C-IMU = PASS.
    ERC 46 -> 45: zero added, one removed. Errors remain 2, both inherited.
    A REPORTED NUMBER HAD TO BE CORRECTED FIRST.
    FBV2-S1-004, 004B and 004C all quote "ERC 68". The stored reports say 46 -
    2 errors, 44 warnings, three times over. The deltas those tasks reported
    ("zero added, zero removed") are correct and reproducible from the files; only
    the absolute figure was wrong, and it was carried for three tasks. Sheet 04's
    migration genuinely took the count from 64 to 46.
    There is also a flag trap worth writing down: kicad-cli sch erc --severity-all
    counts Exclusions as well and reports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
    [05_i2c_devices.kicad_sch]
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2026-08-23 hardware: migrate Full Beta v2 audio (FBV2-S1-006)
    Sheet 06. Task gate FBV2-S1-AUDIO = PASS.
    ERC 45 -> 45: zero added, zero removed. Errors remain 2, both inherited.
    THE BIGGEST FINDING WAS NOT ON THE BRIEF.
    U5 (the MAX98357A) and J6 (the speaker connector) arrived from Beta-DM marked
    DNP. Nobody wrote that down - it is in the inherited file. It means the entire
    speaker output path has never been populated on any AQROOT board, while C9 and
    C10 WERE fitted, decoupling an amplifier that was not there.
    The brief says voice output remains required and Full Beta v2 is the
    feature-complete design, so both are now fitted. Everything below - the power
    budget, the speaker choice, the EMI provision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
    [06_audio.kicad_sch]
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2026-08-23 hardware: migrate Full Beta v2 infrared (FBV2-S1-007)
    Sheet 07. Task gate FBV2-S1-IR = PASS.
    THE WHOLE IR SUBSYSTEM ARRIVED DNP - FOR THE FOURTH SHEET RUNNING.
    U6, D1, Q1, R21, R22, R23, R24 and C11 all came from Beta-DM marked DNP. Only
    C12 was fitted - decoupling for a transmitter that was not there, exactly the
    pattern found on sheet 06 with C9/C10 and the MAX98357A. The brief opens with
    "Full Beta v2 IR is a mandatory internal feature", so all eight are now fitted.
    Sheet 09's U16/R49/R50/U15/D2/D3, sheet 06's U5/J6, now all of sheet 07. This is
    no longer a coincidence: a DNP on a Beta-DM sheet describes what was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
    [07_ir.kicad_sch]
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2026-08-23 hardware: migrate Full Beta v2 buttons expanders and RGB status
    Sheet 08 migrated (FBV2-S1-008), resumed after a session-limit interruption.
    All prior work was uncommitted working-tree change; it was inspected, kept and
    finished rather than restarted.
    Both expanders are NXP PCAL9535APW,118, verified against PCAL9535A Rev. 2
    (23-Jan-2015) and NOT treated as a behavioural drop-in: it powers up with every
    interrupt masked, the opposite of the TCA9535. U2 = 0x20, U3 = 0x21 preserved.
    The two-expander allocation genuinely fails: 35 committed signals against 32
    pins, with zero free native GPIO (so the WS2812 escape is impossible),
    RESERVED_SPARE mandated by D-094 and ten XGPIO locked by D-082. C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
    [01_power_tree.kicad_sch, 03_spi_a_display_sd.kicad_sch, 07_ir.kicad_sch, 08_buttons_expanders.kicad_sch, aqroot-Beta-v2.kicad_sch]
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2026-08-23 hardware: close Full Beta v2 pre-placement schematic issues
    FBV2-S2-001 pre-placement release audit. The audit found a fabrication-blocking
    defect on the first thing it looked at.
    U9 ST25R3916-AQET and its twelve mandatory supply-decoupling capacitors (C19,
    C45-C55) were still marked DNP, inherited from Beta-DM, against D-035 ("NFC is
    mandatory in the FIRST Full Beta v2 fabrication. No DNP showcase shortcut") and
    D-055 ("NFC must be FITTED and functional on the first fabrication"). Everything
    around the chip was already fitted - the 27.12 MHz crystal, the complete
    differential matching network, the antenna connector, the SPI wiring. The first
    five boards would have carried a finished 13.56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
    [01_power_tree.kicad_sch, 04_spi_b_radios_nfc.kicad_sch]
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2026-08-24 hardware: close Full Beta v2 S2 release blockers
    Closes B-03, B-63, B-70 and B-71's schematic-side work. Property-only
    changes to the nine sheets plus the microphone footprint; ERC unchanged
    at 27 / 0 errors / 27 with an identical violation histogram, and the PCB
    is untouched and still bit-identical to Beta-DM.
    B-03 - all eight remaining Tier-2 footprints compared dimension by
    dimension against retrieved manufacturer drawings. Y1 moves from
    candidate to lock (Yajingxin TXM27.12M0004322DBBDO00T, C362365, 3421 in
    stock) with a land that matches the vendor's Suggested Layout exactly.
    The MAX98357A looked like a genuine defect - outline 21-0136 gives
    T1633-5 an EP of 1.50/1.60/1.70 while the la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
    [01_power_tree.kicad_sch, 02_mcu_core.kicad_sch, 03_spi_a_display_sd.kicad_sch, 04_spi_b_radios_nfc.kicad_sch, 05_i2c_devices.kicad_sch, 06_audio.kicad_sch, 07_ir.kicad_sch, 08_buttons_expanders.kicad_sch]
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2026-08-24 hardware: establish Full Beta v2 enclosure-driven floorplan
    FBV2-P1: the v2 PCB is no longer the inherited Beta-DM board.
    A floorplan built around a different component set is not a baseline, so the
    file was stripped to its header, layer stack, general and setup - design rules
    preserved byte for byte - and rebuilt from the current nine-sheet schematic:
    - outline 70.000 x 148.000 x 1.6 mm, the TARGET, not the 72 x 152 maximum;
    2.5 mm to the cavity wall in X, 3.5 mm in Y
    - datum: origin at the LOWER-LEFT board corner, X right, Y up;
    Y_kicad = 148.000 - Y_doc
    - F.Cu = FRONT (display, buttons, IR, USB-C, microSD, community connector),
    B.Cu = REAR (battery side, microphone, both radio mod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
    [aqroot-Beta-v2.kicad_pcb]
2026-08-24 docs: record Full Beta v2 P1 floorplan; gate not passed
    FBV2-P1 DOES NOT PASS. Overall stays 68% - no progress awarded. The floorplan
    is complete and collision-free; one gate criterion fails.
    New: pcb/FBV2_P1_FLOORPLAN.md, pcb/FBV2_P1_KEEPOUTS.md,
    pcb/FBV2_P1_COORDINATES.csv, pcb/FBV2_P1_METRICS.txt, pcb/review/ front, back
    and mechanical plots, and audits/2026-08-24-p1-floorplan-implementation.md.
    Six rulings recorded, D-214..D-219. Five land cleanly:
    - P1-A: F.Cu = FRONT, B.Cu = REAR. MK1 on B.Cu at (3.000, 50.000), bottom-port,
    listening FORWARD through the board; 1.21 mm clear of the LiPo, 67.42 mm from
    the speaker on the opposite face. O-1 closed - the apparent front-face /
    bot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
    [FBV2_P1_COORDINATES.csv]
2026-08-24 hardware: close Full Beta v2 P1 floorplan
    FBV2-P1-002. FBV2-P1 = PASS. Overall Full Beta v2 68% -> 74%.
    The 915 MHz feed closes on measured geometry, and the fix is width rather
    than length. FBV2-P1-001 read the failure as a short cable; it was not. The
    SMA is locked to the top-panel left half and the NFC region owned the whole
    upper-left, so no cable length could ever have reached. The cavity is 75 mm,
    the Oe58 exclusion is 58 mm and J5 owns 12.1 mm, which leaves 4.9 mm of coax
    lane and only if the exclusion is pushed as far right as J5 allows.
    NFC becomes circular: clear Oe48, metal exclusion Oe58, both centred on doc
    (30.800, 124.500), with the 48 x 48 square retained only as the placem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
    [FBV2_P1_COORDINATES.csv, aqroot-Beta-v2.kicad_pcb]
2026-08-24 hardware: prepare Full Beta v2 routing rules
    Rebuild the pre-routing rule set for FBV2-P2 and repair the netclass table.
    No routing: zero tracks, zero signal vias, zero electrical pours, 499 unrouted.
    .kicad_dru: 71 -> 64 rules. The inherited Beta-DM file referenced 39 rule
    areas and the board contained NONE of them, so 22 of 71 rules could never
    fire -- not only the E6 pockets P2-O5 named, but every RF-band rule, every
    E5/E4 corridor rule, the header reservation, the E2 button escapes and the
    ESP32 antenna rule. KiCad's intersectsArea() returns false for an unknown
    name with no warning and no error, so a rule that can never fire is
    indistinguishable from one being satisfied. Retirements R1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
    [aqroot-Beta-v2.kicad_pcb]
2026-08-24 docs: freeze Full Beta v2 P2 routing strategy
    FBV2-P2 ENTRY GATE = FAIL on one criterion of thirteen. No progress earned;
    overall Full Beta v2 stays 74 %. Zero routing performed.
    New: pcb/FBV2_P2_ROUTING_PLAN.md (normative for P2 -- layer usage, ground
    strategy, converter/USB/NFC/bus/escape plans, via and thermal policy, routing
    order, first-route checklist), pcb/FBV2_P2_NETCLASS_LEDGER.csv (19 routing
    classes with derived currents and IPC-2221B minimums), and
    audits/2026-08-24-p2-entry-audit.md.
    D-232 locks retention at two M2 and closes D-226's escalation: no component
    moves for a third screw, and retention is a four-element architecture --
    moulded edge-capture rails, four rear non-metal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
    [FBV2_P2_NETCLASS_LEDGER.csv]
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2026-08-24 hardware: adopt standard AQROOT expansion interface
    Replace the community port's presentation, not its electronics.
    J5 becomes a Samtec SSQ-124-02-G-S-RA: 1 x 24, 2.54 mm, female, right-angle,
    one pin per line -- the same manufacturer as the BCS-112-S-D-HE it supersedes,
    so the account and the small-quantity behaviour are already known. Body
    61.47 mm, pin span 58.42 mm, mates a .025 in (0.635 mm) square post, which is
    the ordinary male-header and Dupont standard. New project footprint, drawn from
    the Samtec SSW/SSQ datasheet and the Sullins 1-row right-angle recommended
    layout (drawing 10493), which is also where the 6.53 mm tail-row-to-mating-face
    depth comes from -- the dimension the whol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
    [09_community_header.kicad_sch]
2026-08-24 hardware: electrically correct Full Beta v2 power and NFC floorplan
    The combined re-floorplan: board outline, battery envelope, and PM-1, PM-2,
    PM-3 and PT-1 all solved once instead of in separate placement churn.
    Outline 70 -> 72 mm, grown SYMMETRICALLY. Every part shifted +1.0 mm in X, so
    every part-to-part relationship on the board is preserved exactly and only the
    two edge margins moved -- to 1.5 mm on both sides, which is the >= 1.5 mm rule
    met exactly with nothing to spare. The 80 x 160 x 23 enclosure and the
    75 x 155 cavity are untouched; X_cavity = X_doc + 1.5.
    That "nothing to spare" exposed a fiction. ANT433_REGION was 2.2 mm wide, and
    2.2 mm does not fit a 1.5 mm gap. It never d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
    [aqroot-Beta-v2.kicad_pcb]
2026-08-24 docs: re-pass Full Beta v2 P1 and P2 entry gates
    FBV2-P1 RE-ISSUED = PASS. FBV2-P2 ENTRY = PASS. PM-1, PM-2, PM-3 and PT-1 all
    CLOSED. No progress earned; overall Full Beta v2 stays 74 %.
    The percentage is deliberate. The outline, the battery and J5 all changed, so
    the FBV2-P1-002 pass was superseded and the gate had to be re-run in full --
    but P1 was RE-earned, not newly earned, and the gate-backed method does not pay
    twice for one gate. P2 entry earns none by its own terms.
    The battery procurement gate ran FIRST, before any authoritative file was
    touched, and it made the headline claim wrong in the good direction. Two
    manufacturer-datasheet cells fit with room on every axis: PKCELL LP785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
    [FBV2_P1_COORDINATES.csv]
2026-08-24 hardware: create Full Beta v2 In1 GND plane and fix PM-2 support placement
    FBV2-P2-001 = FAIL: the power tree is NOT routed. This commit carries what the
    attempt did deliver, and nothing it did not.
    In1.Cu GND reference plane created and validated: one zone, ONE island, net
    GND, 9938.9 mm2 of a 10656 mm2 board (93.3 %), solid pad connection with no
    thermal relief, no split and no analog island. Its single authorised void --
    the ESP32-S3-WROOM-1 antenna keep-out -- is cut by the four-layer rule area
    that already existed, not by a hand-carved polygon. F.Cu and B.Cu pours are
    deliberately NOT created: they are the last step of FBV2-P2 and making them now
    would hide return paths rather than pro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
    [aqroot-Beta-v2.kicad_pcb]
2026-08-24 docs: rule BAT_PROTECTED_P width and record the battery routing attempt
    FBV2-P2-002A = FAIL. The battery / protection block is NOT routed and nothing
    was committed as copper: the board still carries zero tracks and zero signal
    vias. PM-2 stays PLACEMENT CORRECTED, FINAL CLOSURE PENDING DRC-CLEAN ROUTING.
    PCB routing stays 0 %; overall stays 74 %.
    D-245 rules a scoped per-net width override for BAT_PROTECTED_P: 1.50 mm
    target, 1.20 mm minimum, implemented as a .kicad_dru rule conditioned on the
    net name alone and as row A2 of the netclass ledger. The BAT_MAIN class is NOT
    changed -- BAT_CONNECTOR_P, BAT_RAW, BAT_MID and BAT_SENSE keep 1.00 mm /
    0.60 mm, because none of them carries the pack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
    [FBV2_P2_NETCLASS_LEDGER.csv]
2026-08-24 tools: qualify the Full Beta v2 obstacle-aware router
    FBV2-P2-002B. Router harness qualification = PASS. No copper committed;
    aqroot-Beta-v2.kicad_pcb is byte-identical to 8b9efba (0 tracks, 0 signal
    vias). PCB routing stays 0%, overall stays 74%.
    All three named PR-5 defects fixed and proved fixed on real geometry:
    - track_dangling: emitter is integer nanometres end to end, and the router
    now checks that a pad is actually on the routing layer. The old one would
    start a B.Cu track at the centre of an F.Cu-only pad.
    - track_width: the routing rule minimum wins. The escape ladder stops at the
    applicable floor and never derives a width from a pad's short dimension;
    where nothing legal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
    [qrouter.py]
2026-08-25 docs: rule battery width as a path role and record the routing attempt
    FBV2-P2-002C = FAIL. Phase A did not complete, so Phase B never ran and
    aqroot-Beta-v2.kicad_pcb is byte-identical to a52977e: zero tracks, zero
    signal vias. PCB routing stays 0%, overall stays 74%.
    First unresolved connection: LTC_GATE Q2.2 -> TP17.1.
    D-249 supersedes the whole-net form of D-245. Its intent stands - the long
    BAT_PROTECTED_P trunk is 1.50/1.20 mm - but saying that about the NET NAME
    also imposed it on the MAX17048 fuel-gauge tap, the LTC4368 VOUT sense
    input and a test point, and made the net unroutable. The floor now holds on
    the whole net and is relaxed only inside a named rule area bounding one
    appro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
    [FBV2_P2_NETCLASS_LEDGER.csv]
2026-08-25 tools: preserve validated P2 routing harness improvements
    FBV2-P2-002D checkpoint. Phase A did not complete and Phase B was never
    started, so NO COPPER IS COMMITTED: aqroot-Beta-v2.kicad_pcb still has 0
    tracks and 0 signal vias, In1 is one GND zone of one island, ratsnest 781.
    PCB routing stays 0%, overall stays 74%.
    Fifty-five connections had routed and coexisted DRC-clean on the scratch
    copy before the session was stopped, each gated against the project-context
    baseline with the In1 plane refilled every time.
    The multi-hour stalls were NOT the searches. A watchdog stack dump put the
    process inside PCB_VIA::GetWidth() called WITHOUT a layer argument, which
    asserts in KiCad 10; the assert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
    [battery_route_plan.py, dru_probe.py, p1_regression.py, place_p2_002d.py, qrouter.py]
2026-08-25 hardware: refine Full Beta v2 battery support placement
    Three test/support parts moved, and nothing else. No copper: the board
    still has 0 tracks and 0 signal vias, In1 is one GND zone of one island,
    DRC is the MK1 D-227 artefact plus 499 unconnected, ERC 0 errors /
    27 warnings, P1 regression PASS.
    TP17 14.500,48.250 -> 12.500,76.000 (B.Cu). The LTC_GATE test point sat
    east of the 0603 divider wall with no corridor to reach it on either
    layer at any legal width - it was the connection FBV2-P2-002C failed on.
    Beside R76, the LTC4368 GATE resistor, it is 4.57 mm from an accessible
    gate node.
    C59 2.125,84.885 -> 8.000,41.500 rot 90 (B.Cu). 1 uF 25 V on BAT_RAW,
    drawn on the protection row of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
    [aqroot-Beta-v2.kicad_pcb]
2026-08-25 tools: fix five FBV2-P2 routing-harness defects and order by path scarcity
    None of these is in qrouter.py. All five are in the driver and the plan, which
    had never been stressed this far because no previous run got past 27
    connections.
    PR-15 split_at() replaces ONE track in qb.laid with TWO, and the mark taken
    before it is an index into that same list. Nothing shifted the mark, so
    revert() removed a track belonging to the TRUNK and left one of the
    branch's own behind - and a second revert on the same trunk called
    BOARD::Remove on an item no longer in the list, which SEGFAULTS rather
    than raising. Exit 139 at BAT_CONNECTOR_P TP34.1, 55 connections in,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
    [battery_route_plan.py, replay_battery_block.py]
2026-08-25 docs: record the FBV2-P2-002E battery routing attempt
    FBV2-P2-002E = FAIL. Phase A did not complete, so Phase B was not run and
    aqroot-Beta-v2.kicad_pcb is byte-identical to e09eb35: zero tracks, zero signal
    vias. PCB routing stays 0 %, overall stays 74 %. No progress is claimed.
    First unresolved FUNCTIONAL connection, by section 8's own numbering:
    BAT_RAW R80.1 -> Q2.7. Most consequential: LTC_GATE U18.10 -> Q3.4, which
    leaves the gate net in two pieces so the LTC4368 GATE output is not connected
    to the FETs it drives.
    What did land is the most this block has reached: 60 connections coexisting on
    one scratch board with zero new DRC violations of any class at every step,
    ratsnest 781 -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
    [FBV2_P2_NETCLASS_LEDGER.csv]
2026-08-25 docs: prove the battery-block placement, and record why Phase A still fails
    FBV2-P2-002F = FAIL on section 14's no-partial-pass rule. Phase B was not run.
    The authoritative PCB is byte-identical to 24f6611 -- zero tracks, zero signal
    vias -- and THE PLACEMENT ECO IS NOT APPLIED TO IT. Section 23 forbids
    committing an unproven placement, and a placement that does not pass section 13
    is not proven; place_p2_002f.py is committed as the searched, gated,
    reproducible result, applied to nothing.
    PR-25 CLOSED, and closed by measurement. U18 rotates 90 -> 180 and moves
    (3.000, 72.400) -> (8.000, 65.250), chosen from 13 284 poses: 2 490 cleared
    collision and the section 4 Kelvin envelope, 1 331 kept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
    [gate_p2_002f.py, phaseB_compare.py, place_deadcell_002f.py, place_p2_002f.py, place_search_002f.py, ring_probe_002f.py]
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2026-08-25 harness: make router success mean connectivity (PR-39), and qualify on the full prefix (PR-40)
    No authoritative copper. The PCB remains byte-identical to 984423c: zero signal
    tracks, zero signal vias, In1 plane intact.
    PR-39 CLOSED. A route is now SUCCESS only if, after the copper is on the board,
    the REQUESTED start pad and the REQUESTED end pad are in the same connectivity
    component. run()'s three fallbacks -- node retarget, hop-to-node, and a
    '(node)' request -- may all REPLACE the endpoint, and every one of them used to
    keep the requested pad name in the log line and the journal while building
    somewhere else. That is how `BAT_RAW R79.1 -> R80.1` was reported at 5.276 mm
    across a 12.030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
    [battery_manifest.py, net_ledger.py, place_u19_002g.py]
2026-08-25 harness: BAT_RAW is contention, not geometry (PR-41, PR-42, PR-43)
    FBV2-P2-002G / 002H remain FAIL. No authoritative copper is written and the
    placement ECO is still not applied; the board is byte-identical to 984423c.
    PR-41 -- the closure stage gave every BAT_RAW pad the BAT_MAIN trunk ladder
    [1.00, 0.80, 0.60] because BAT_RAW is a WIDE net, so the LTC4368 divider chain,
    ruled 0.20 mm by D-249 and routed as TAPs everywhere else, was asked for 0.60 mm
    minimum. PR-37's defect one net over. With it applied a full Phase A produced
    zero NO_LEGAL_ESCAPE board-wide and R80.1 -> (node) became NO_PATH -- a
    different and truer failure. Validated, and not sufficient.
    PR-42 -- the joint U19+R80/R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
    [battery_route_plan.py, place_u19_002g.py]
2026-08-26 PR-43 answered: BAT_RAW closes, U18 loses two pins, the margin is full
    FBV2-P2-002I. FAIL on section 5 Case D -- a protected path regressed. No
    authoritative copper; the board is byte-identical to 984423c. Preflight all
    PASS: p1_regression, router_regression (34 checks incl. G8-A..F), dru_probe,
    netclass_probe, fork_equivalence; DRC 1 baseline violation, ERC 0.
    PR-43 works, and it needs no placement change. One Phase A with PR-39 + PR-41
    + PR-43 puts 11 of BAT_RAW's 12 pads in ONE island -- R80.1 CONNECTED, D12.1
    CONNECTED, only the TP16.1 test point outside -- and closes LTC_SHDN, which the
    full prefix had returned NO_PATH.
    It also costs U18 two pins, 8 of 8 -> 6 of 8: U18.7 NO_LEGAL_E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
    [battery_route_plan.py]
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2026-08-26 harness: make Full Beta v2 routing tools cross-platform
    FBV2-CLOUD-001. Infrastructure/tooling only -- NO PCB PROGRESS EARNED.
    Authoritative PCB byte-identical to a1cc687; 0 signal tracks, 0 signal vias.
    No schematic, placement, architecture or mechanical change. Routing stays
    0 %, overall stays 74 %.
    Every FBV2-P2 verdict from 002A to 002J was measured on one Windows
    workstation. That is a single point of failure for the whole evidence
    chain: a measurement only one machine can reproduce is a step back toward
    being recorded rather than measured. Four active scripts carried that
    machine's disk as string literals, so the harness would not start on the
    Ubuntu 24.04 worker.
    The dangerous one: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
    [fork_equivalence.py, gate_p2_002f.py, harness_paths.py, net_ledger.py, p1_mech_render.py, p1_regression.py, phaseB_compare.py]
2026-08-26 D-256 answered: the layer exists, the via does not fit U18
    FBV2-P2-002K. FAIL at section 9, the D-256 local capacity screen.
    NO AUTHORITATIVE COPPER. The PCB is byte-identical to a5771a7 (md5
    a908cedfa9f9410aab327d8bd55b9f45) -- zero signal tracks, zero signal
    vias, In1.Cu one filled island -- and the placement ECO is still not
    applied. PCB routing stays 0 %, overall stays 74 %.
    THE ANSWER, AND IT CLOSES D-256 IN BOTH DIRECTIONS.
    The west margin IS short of LAYER CAPACITY exactly as D-256 ruled. But a
    layer change needs a via, a via needs somewhere to land, and U18 is an
    MSOP-10 on 0.50 mm pitch against this board's own floor of
    min_via_diameter = 0.50 mm. Measured at the FBV2-P2-002F pla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
    [battery_route_plan.py, qrouter.py]
2026-08-26 PR-48 and D-257 proven; PR-47 is a via-in-pad decision
    FBV2-P2-002L. DECISION STOP -- section 17: "If Q3 requires via-in-pad:
    002L = DECISION STOP, not PASS." It does.
    NO AUTHORITATIVE COPPER. The PCB is byte-identical to cb17269 (md5
    vias, In1.Cu one filled island. All five suites PASS. PCB routing stays
    PR-48 PROVEN. A local `clearance (min 0.20mm)` conditioned on A.NetName
    AND A.enclosedByArea() resolves all three measured cases:
    U18.1 VIN was clearance 0.3000 / actual 0.2500 -> 10.107 mm @0.20
    U14.2 was 0.3000 / 0.2347 -> 7.401 mm @0.15
    U14.3 was 0.3000 /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
    [battery_route_plan.py, path_role_dru.py, place_u18_002l.py, placement_fingerprint.py, qrouter.py]
2026-08-26 Six layers proven on scratch; PR-47 closed; gate fails on LTC_OV and BAT_SENSE
    FBV2-P2-002M. FAIL at section 14.
    THE AUTHORITATIVE STACKUP WAS NOT CHANGED. Section 16 conditions the
    lock on section 14's local gate, and that gate did not pass. The PCB is
    byte-identical to bc1d436 (md5 a908cedfa9f9410aab327d8bd55b9f45) --
    FOUR copper layers, zero signal tracks, zero signal vias, In1.Cu one
    filled island. All five suites PASS. Routing 0 %, overall 74 %.
    SIX-LAYER MIGRATION PROVEN ON SCRATCH (checks/sixlayer.py):
    copper layers 6
    order F.Cu In1.Cu In2.Cu In3.Cu In4.Cu B.Cu
    stackup explicit JLC06161H-7628, 1.6028 mm
    In1.Cu / In4.Cu 1 zone, 1 islan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
    [battery_route_plan.py, path_role_dru.py, qrouter.py, sixlayer.py]
2026-08-26 D-259(c) closed on the published stackup; R75 Kelvin solved, gate still fails
    FBV2-P2-002N. FAIL at section 11.
    THE AUTHORITATIVE STACKUP WAS NOT CHANGED. Section 16 conditions the lock
    on section 11's combined gate, and that gate did not pass. The PCB is
    byte-identical to 7ff0337 (md5 a908cedfa9f9410aab327d8bd55b9f45) -- FOUR
    copper layers, zero signal tracks, zero signal vias. All five suites PASS.
    Routing 0 %, overall 74 %.
    D-259(c) CLOSED. The derived inner split of 002M is replaced by the
    published JLC06161H-7628 construction, and the six-layer regression now
    asserts those exact dielectrics:
    F.Cu 0.0350 / PP 7628 0.2104 / In1 0.0152 / core 0.4000 / In2 0.0152
    / PP 7628 0.2028 / I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
    [place_r75_002n.py, qrouter.py, sixlayer.py]
2026-08-26 D-260 confirmed: rigid cluster works, corridor is 0.95 mm too narrow
    FBV2-P2-002O. DECISION STOP.
    THE AUTHORITATIVE STACKUP WAS NOT CHANGED. Section 17 conditions the lock
    on section 14's combined gate, and that gate was not reached. The PCB is
    byte-identical to fcacf0e (md5 a908cedfa9f9410aab327d8bd55b9f45) -- four
    D-260'S HYPOTHESIS IS RIGHT ABOUT THE CAUSE. 002N moved R80/R81/R82
    WITHOUT U18 and three control connections failed against BAT_MAIN routed
    clearance 0.3000 mm at 0.2750, 0.2778 and 0.2371 mm, taking U18 from 8/8
    to 6/8. With U18 and R76..R83 moved together as one rigid body t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
    [place_cluster_002o.py, placement_fingerprint.py]
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2026-08-27 PR-49: a width ladder is not a ladder until the gate has spoken
    FBV2-P2-002Q. FAIL at section 14.
    THE AUTHORITATIVE STACKUP WAS NOT CHANGED. Section 18 conditions the lock
    on section 14, and section 14 did not pass. The PCB is byte-identical to
    adabe98 (md5 a908cedfa9f9410aab327d8bd55b9f45) -- four copper layers,
    PR-49 IS DELIVERED, REGRESSION-PROVEN AND DEMONSTRATED TWICE ON REAL
    COPPER.
    BAT_PROTECTED_P R75.2 -> D9.1
    1.50 mm routed, rejected: copper_edge_clearance 0.5000; actual 0.4125
    LADDER_RETRY 1.50 mm rejected, falling to 1.20 mm
    1.20 mm 19.219 mm, B.Cu, zero vias -- ACCEPTED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
    [battery_route_plan.py]
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2026-08-27 FBV2-P2-002S: D-264 delivered and pinned; LTC_SHDN closes; gate fails at §21
    D-264: outer-layer-only is scoped by CURRENT PATH ROLE, not by net name.
    path_role_dru.outer_only_rules() exempts only the two bounded D-249 sense
    corridors (BAT_SENSE_KELVIN, BAT_PROT_TAP_U18) on In2/In3; current-carrying
    BAT_MAIN copper stays barred from the inner layers everywhere.
    KiCad's `disallow` fires on EVERY matching rule, not last-match-wins, so the
    static unscoped block is excised from generated boards. The authoritative
    .kicad_dru keeps it so dru_probe still reads the shipped intent.
    New standing regression d264_probe.py, clauses A-F, all PASS.
    LTC_SHDN was never a trapped pad: alone it has 5 escape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
    [d264_probe.py, path_role_dru.py, u18_schedule_002s.py]
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2026-08-27 FBV2-P2-002U: D-267 D9 exit reservation and TAP path role; Kelvin B fixed
    D-267: an early high-current escape reservation is permitted only for D9.1, at
    the existing BPP trunk target/floor, outer-layer-only and zero-via. It preserves
    the pad exit without completing the current path early.
    The reservation works on its own terms. On a clean board D9.1 escapes at 1.50 mm
    in SIX directions; due west is blocked by R77.2, so the trunk leaves at 135 deg,
    which is what the clean-board trunk does (19.878 mm at 1.50 mm end to end). The
    staging families are prefixes of that measured path, not invented points. F1
    reserved 2.701 mm and F2 5.149 mm, both at the 1.50 mm target on B.Cu with zero
    vias, and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
    [battery_route_plan.py, d267_probe.py, qrouter.py]
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2026-08-27 FBV2-P2-002W: D-269 path-role clearance closes BAT_RAW; no control-offload cut set exists
    D-269(a): BAT_MAIN 0.300 mm routed clearance is a CURRENT-PATH-ROLE requirement,
    not an entire-net-name requirement. Clearance is the fourth and last property to
    get what D-249 gave width, D-264 gave layer and D-267 gave via geometry - each
    the same defect one property over, a rule sized for 1.5 A applied to a branch
    carrying nanoamps because it shares a net name.
    0.300 mm is untouched on every current-carrying role. The exclusion reaches four
    bounded corridors grown from the divider chain's own copper, and inside them the
    EXISTING board rules govern - the board default of 0.200 mm. No new clearance
    nu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
    [battery_route_plan.py, d269_probe.py, path_role_dru.py]
2026-08-27 FBV2-P2-002X: D-270 path-role offload delivered and proven; western-margin trunk blocker is current-carrying, not low-current
    D-270(a): western-margin offload candidate selection shall be by individual
    CURRENT PATH ROLE / ROUTED BRANCH, not whole net or net class. A bounded
    low-current TAP branch on BAT_RAW or BAT_MAIN may take In2/In3 despite its power
    net name; every current-carrying role stays outer 1 oz. Offload is the fifth
    property to follow path role, after D-249 width, D-264 layer, D-267 via geometry
    and D-269 clearance - closing the candidate-list gap D-269's own audit named.
    Mechanism: path_role_dru.INNER_OFFLOAD_AREAS adds the authorised bounded
    corridors to the exact D-264 In2/I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
    [battery_route_plan.py, d270_probe.py, offload_probe_002x.py, path_role_dru.py]
2026-08-27 FBV2-P2-002Y: D-271 the 002W prefix is pinned and deterministic; the "proven 8/8" board is not reconstructible from committed code
    The 002W-prefix reproduction gap FBV2-P2-002X flagged is resolved as a
    reproducibility defect, not a router defect. Delivered a one-command pinned
    regression (prefix_002w.py) + blessed manifest (prefix_002w_manifest.json,
    SHA256 3c7128580053cf5ab3c69774da5405ab4074b309e89da93b58c161b20fd3ecd1).
    Closeout validation (re-run at this commit):
    * prefix_002w.py: DETERMINISM PASS (board matches the pinned manifest
    exactly); GOVERNED GOAL FAIL, exit 1 by design (U18 6/8, open U18.7/U18.8,
    U18.8 at the blocking site (3.000, 71.600)).
    * Standing suites all PAS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
    [prefix_002w.py]
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2026-08-28 FBV2-P2-003A: D-273 the long outer-B.Cu zero-via route is disproved; next is a bounded F.Cu high-current via bridge
    D-272 sent the BAT_PROTECTED_P trunk question into a bounded routing proof: test
    the reservation-dependent LONG outer-B.Cu route BEFORE any F.Cu via bridge,
    because it keeps the trunk on outer 1 oz with zero current-carrying vias. 003A
    runs that proof on the proven c3 board (U18 8/8, trunk open) and it FAILS. No
    long outer-B.Cu zero-via corridor carries BAT_PROTECTED_P from R75.2 to the
    eastern node copper at the 1.50 mm target or the 1.20 mm floor. Measured FAIL,
    not analytic; corroborated by the router's own search primitive.
    Board under test, reproduced: w/c3repro003a_par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
    [long_corridor_003a.py, long_corridor_003a_bounded.py, long_corridor_003a_corrob.py]
2026-08-28 FBV2-P2-003B: D-274 the bounded F.Cu high-current via bridge is disproved; the western margin is saturated on F.Cu exactly as on B.Cu
    Measured FAIL on the reproduced c3 board (U18 8/8, trunk open, byte-consistent
    with D-273). The two via-array transitions are individually feasible -- a 4-via
    B.Cu->F.Cu array lands on R75.2's pad, a 4-via F.Cu->B.Cu array lands on the
    node -- but the F.Cu traversing segment does not exist at the mandatory >=1.20 mm
    floor: an F.Cu full-width flood from R75.2 dies at x=4.80 mm (only <=0.80 mm
    threads to x=11.6, below the 1.20 mm trunk floor which may not be waived), and a
    full-budget A* R75.2->node returns NO_PATH at 1.20 AND 1.50 mm by exhaustion.
    Blocker: the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
    [bridge_feasibility_003b.py, bridge_geom_003b.py, via_array_003b.py, via_array_probe.py]
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2026-08-28 FBV2-P2-003D: D-276 the driver-integrated vacate + F.Cu bridge is a measured reproducible FAIL; the full production driver fails upstream at U19.3 N_POL NO_LEGAL_ESCAPE and 003C/D-275 stands as the f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
    003D integrated the proven 003C vacate + F.Cu via-array bridge into the
    production Phase-A driver (route_battery_block.py, guarded by AQROOT_BRIDGE_ECO
    -> bridge_eco_003d.apply_eco) and drove it through a full 2-pass route. The
    full-driver route reproducibly FAILS: Phase A fails upstream at N_POL
    U19.3->(node) NO_LEGAL_ESCAPE (>=0.150 mm; board_edge x23/U19.4 x16/U19.2
    x12/U19.6 x8), and the integrated bridge ECO aborts with no >=1.20 mm F.Cu
    traverse corridor. ecoC/ecoD agre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
    [bridge_eco_003d.py, bridge_gates_003d.py, bridge_probe_003d.py]
2026-08-28 FBV2-P2-003E: D-277 the U19.3 N_POL NO_LEGAL_ESCAPE is a route-order contention (cause B), not pad/board geometry; a cardinality-0 planar tie-break in the driver clears it on a full production run an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
    D-276 named N_POL U19.3->(node) NO_LEGAL_ESCAPE at >=0.150 mm (blockers
    board_edge x23, U19.4 x16, U19.2 x12, U19.6 x8) as the full-driver Phase-A
    blocker. 003E measured the three candidate causes and repaired the one that
    is real:
    - (A) intrinsic pad/footprint/board-edge geometry REFUTED: on the empty
    authoritative board (U19 is not moved by c3) U19.3 has a legal >=0.150 mm
    escape east into the i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
    [u19_escape_probe_003e.py]
2026-08-28 FBV2-P2-003F: D-278 the VREC_VCC U19.8 NO_LEGAL_ESCAPE is a route-order crossing detour (the D-277 crossing pin REF_POL U19.2's antisocial B.Cu horseshoe), fixed by a layer hop; U19.8 clears on a ful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
    D-277 (003E) cleared N_POL U19.3 and Phase A advanced to VREC_VCC U19.8 ->
    (node) NO_LEGAL_ESCAPE (blockers track x33, U19.7 x13, board_edge x5, U19.5 x5),
    co-terminal VBRIDGE_TOP R85.1. 003F discriminated A->B->C and repaired U19.8.
    - (A) intrinsic east-row geometry REFUTED: empty-board escapes U19.8=5, R85.1=8,
    D10.1=7 ways at >=0.150 mm.
    - (B) route-order CONFIRME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
    [u19_escape_probe_003f.py]
2026-08-28 FBV2-P2-003G: D-279 the dead-cell resistor-field congestion (VBRIDGE_TOP R85.1->D10.1, REF_HO R92.1<->R93.2) is an antisocial B.Cu detour in the packed 0402 field, not intrinsic geometry and not the 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
    D-278 (003F) cleared VREC_VCC U19.8 and named these two blockers, both
    NO_LEGAL_ESCAPE >=0.150 mm in the packed 0402 dead-cell field (R84-R96/Q5-Q9,
    0.65 mm pitch). 003G discriminated A->B->C (u19_escape_probe_003g.py, PASS):
    - (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
    [u19_escape_probe_003g.py]
2026-08-28 FBV2-P2-003H: D-280 the 003G functional casualty N_BATDIV C61.1->U19.6 is a co-located through-via landing (not pad geometry, not a corridor) — connect_hop's fast direct-escape via placement checked 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
    [qrouter.py, u19_escape_probe_003h.py]
2026-08-28 FBV2-P2-003I: D-281 the route-order EARLY landing of the proven D-275 western-corridor bridge is a MEASURED, REPRODUCIBLE FAIL — the bridge and the current-carrying corridor users (LTC_GATE/BAT_RAW t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
    003H closed the last named dead-cell blocker and left the D-275 BAT_PROTECTED_P bridge
    integration as the sole Phase-A promotion blocker. 003D (D-276) integrated the exact
    mechanism as an END-OF-RUN stage and measured it to ABORT; 003I's preflight isolat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
    [bridge_early_003i.py, bridge_probe_003i.py]
2026-08-28 FBV2-P2-003J: D-282 the shared western-corridor BAT_PROTECTED_P bridge is a TOPOLOGY/CAPACITY wall, and 003J LOCALISES it — the 003I-proposed route-only fix (relocate the LTC_GATE/BAT_RAW corridor TA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
    [bridge_probe_003j.py]
2026-08-28 FBV2-P2-003K: D-283 the disjoint-sub-box southern BAT_PROTECTED_P bridge (candidate c) LAYS its lane but has NO LEGAL LANDING - MEASURED FAIL, candidate (c) exhausted
    003J (D-282) localised the one spare >=1.20 mm F.Cu lane to a SOUTHERN band
    disjoint from the tap cluster (taps y<74.7, lane y>75) and deferred candidate (c)
    to a supervised full run. 003K implements the minimal env-gated candidate and
    measures it: the disjoint LANE is viable, but the only forced-south LANDING is not.
    Implementation (minimal, default-inert):
    - AQROOT_BRIDGE_SOUTH (route_battery_block.py) implies the AQROOT_BRIDGE_EARLY
    003I stage so the bridge is laid exactly once, at the stage-8 boundary.
    - bridge_early_003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
    [bridge_early_003i.py, bridge_probe_003k.py]
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2026-08-29 FBV2-P2-003O: D-288 the D-275 south-bridge ENTRY-array two-layer tie is FIXED (rotation-aware in-pad POFV scan + a symmetric B.Cu tie-stub make the entry vias via_dangling-clean), proven by a non-vac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
    A successful bridge-implementation fix is distinct from an overall Phase-A pass. 003O
    closed the exact D-287 lever - the entry array that dangled o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
    [bridge_early_003i.py, bridge_route_003c.py, screen_003n.py]
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2026-08-30 FBV2-P2-003W: D-297 the SECONDARY U18.8 I2-join lever (the D-295/D-296 handoff) completes BAT_PROTECTED_P U18.8->R75.2 on In3 for a GENUINE +1 connected-set gain - a PURE JOIN with NO casualty, NO ne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
    A GOVERNED ACCEPT of a SECONDARY lever + a governed FAIL of the overall Phase-A run (a normal Phase-A FAIL is not a stop reason; no owner decision raised). Starting HEAD 27f9790 (pushed; phaseA_jou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
    [u18_i3_join_probe_003w.py]
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2026-08-30 FBV2-P2-004B2: D-302 FIRST AUTHORITATIVE PHASE-A COPPER PROMOTION (committed) + router-regression fixture-compatibility fix
    The verified AQROOT_U11_RETARGET->C36.1 full-run board becomes the authoritative
    PCB: byte-identical to the checks/w/FULL003T_004b2_u11retarget scratch
    (sha256 63a9bc54..f87d6ba9), 432 tracks / 54 vias / 6 copper layers /
    direction-2 placement (fingerprint 397dffe1f77e4d10) / ratsnest 704 (-77) /
    41 zones / 77-entry phaseA_journal.json (incl. the U11.2->C36.1
    reinforcement:True tap that closes the D-301 wall as a SHORT >=1.20mm on-net
    reinforcement). It carries the regenerated DRU it requires (67->119 rules; the
    accepted D-249/D-257/D-258/D-263/D-264/D-266/D-269 per-net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
    [aqroot-Beta-v2.kicad_pcb]
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2026-08-30 FBV2-P2-006: D-304 FIRST REST-OF-BOARD INCREMENTAL INCREMENT ROUTED + PROMOTED (the FRONT_RGB indicator group) via a reusable scoped incremental router/promoter — no Phase-A casualty, no new DRC, aut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
    Reusable incremental_router.py (baseline/route/gate/promote) loads the D-302
    promoted board (all existing copper = obstacle; new copper ADDED, never removed),
    routes a bounded net-group into a scratch copy (authoritative untouched during
    the experiment), and promotes only on a real full-board gate PASS. Baseline is
    computed live from the current authoritative board so each successive group
    self-corrects; double-promotion is refused.
    Group selection (measured,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
    [aqroot-Beta-v2.kicad_pcb]
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2026-08-30 FBV2-P2-008: D-306 THIRD REST-OF-BOARD INCREMENTAL INCREMENT ROUTED + PROMOTED — AND THE FIRST TO EXERCISE A VIA / MIXED-LAYER PRIMITIVE (the DISP_RST_N display-reset control net)
    A governed CTO ACCEPT + PROMOTE via the same incremental_router.py, minimally
    extended for the first via — no Phase-A/FRONT_RGB/ACC casualty, no new DRC,
    autonomy continues, no owner decision.
    DISP_RST_N (1 net / 3 pads, R16.1/J1.10 F.Cu + U2.8 B.Cu): MST = one SAME-LAYER
    F.Cu run (R16.1<->J1.10, first incremental F.Cu route) + one CROSS-LAYER edge
    (J1.10<->U2.8) closed by ONE board-legal 0.60/0.30 Default through via (>= 0.50 mm
    min_via). The via pierces the In1/In4 GND reference planes, so route now re-pours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
    [aqroot-Beta-v2.kicad_pcb]
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2026-08-30 FBV2-P2-012: D-310 SEVENTH REST-OF-BOARD INCREMENTAL INCREMENT ROUTED + PROMOTED (display/touch control pair TOUCH_RST_N + TOUCH_INT_N) — the D-309 U2 B.Cu ESCAPE WALL BROKEN by a bounded via-site of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
    Governed CTO ACCEPT + PROMOTE (routine rest-of-board routing; no owner decision).
    Starting HEAD f2bcac1 (D-309). The group D-309 characterised AS A WALL is now routed.
    Root cause of the D-309 wall: qrouter.QBoard._scan builds obstacles from footprint
    pads + PCB_TRACK but skips PCB_VIA, so accepted through-vias are invisible to
    escape/via_site/connect_role. U2.4/.7/.8/.11 stack on U2's west edge; the accepted
    D-306 DISP_RST_N via sits 1.19 mm west of that column, s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
    [aqroot-Beta-v2.kicad_pcb]
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2026-08-30 FBV2-P2-015: D-313 TENTH REST-OF-BOARD INCREMENTAL INCREMENT ROUTED + PROMOTED (XGPIO east-edge pilot XGPIO8+XGPIO9) — the FIRST XGPIO0..9 bank members, promoted after a full evidence-first READ-ONLY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
    Evidence-first XGPIO0..9 corridor study (w/xgpio_study_015.py, read-only): all ten
    /XGPIOx are 2-pad cross-layer nets (100R series R5x.1 F.Cu -> PCAL9535A U3 pin B.Cu),
    each escaping U3 cleanly NORTH into open board (every default via site >=3.1mm clear,
    zero existing vias in any XGPIO bbox -> no via_offset needed). The 8 west-edge nets
    crowd one via pocket north of U3 (XGPIO6/7 pick the identical site); the eas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
    [aqroot-Beta-v2.kicad_pcb]
2026-08-30 FBV2-P2-016: D-314 ELEVENTH REST-OF-BOARD INCREMENTAL INCREMENT ROUTED + PROMOTED (XGPIO west-edge SOUTH pilot XGPIO1+XGPIO0) — the FIRST WEST XGPIO0..9 members, promoted after a governed recovery of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
    The two SOUTHERNMOST west community-header GPIO nets — XGPIO1 (R52.1 F.Cu -> U3.5
    B.Cu) + XGPIO0 (R51.1 F.Cu -> U3.4 B.Cu), on consecutive PCAL9535A U3 pins — are
    routed and promoted onto the D-313 board (east pilot XGPIO8/9). They are the first
    members of the eight-net WEST XGPIO group the D-313 study had deferred as an
    ordering-sensitive shared-via-pocket hazard. Starting HEAD 0faf85b (D-313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
    [aqroot-Beta-v2.kicad_pcb]
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2026-08-31 FBV2-P2-018: D-316 TWELFTH REST-OF-BOARD INCREMENTAL INCREMENT ROUTED + PROMOTED (a SINGLE west XGPIO net XGPIO3 at the 0.200 mm Default clearance) — the D-315 positive lead realised: one west haul k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
    XGPIO3 (R54.1 F.Cu -> U3.7 B.Cu), the fifth XGPIO0..9 bank member, routed at the
    0.200 mm Default clearance (NOT the 0.300 mm blanket the D-313/D-314 pilot PAIRS
    used) and promoted. D-315 characterised the XGPIO2+XGPIO3 PAIR as a corridor-
    capacity wall (both orders NO_FAR_RUN) and produced this positive lead: a single
    west net routes clean at 0.200 mm and keeps D-269 by geometry (the we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
    [aqroot-Beta-v2.kicad_pcb]
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2026-08-31 FBV2-P2-023: D-321 SIXTEENTH REST-OF-BOARD INCREMENTAL INCREMENT ROUTED + PROMOTED — the microSD SPI chip-select SD_CS_N (J2.2 socket / R25.2 / U1.25 MCU), a genuine functional POINT-TO-POINT control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
    [aqroot-Beta-v2.kicad_pcb]
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2026-08-31 FBV2-P2-027: D-325 DUPLICATE-REF MST FRAMEWORK FIX + BTN_B_N PROMOTED (nineteenth rest-of-board increment, the FIRST framework-dependent one) — a bounded, generic, deterministic change lets the MST a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
    [aqroot-Beta-v2.kicad_pcb]
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2026-09-01 FBV2-P2-055: promote U20 replacement transaction (D-353)
    [aqroot-Beta-v2.kicad_pcb]
2026-09-01 FBV2-P2-060: promote U4 replacement transaction (D-358)
    [aqroot-Beta-v2.kicad_pcb]
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2026-09-01 FBV2-P2-090: withdraw U3 collision branches (D-388)
    [u3_collision_branch_withdrawal_090.py]
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2026-09-02 demo: complete RGB replacement routing
    [aqroot-Beta-v2.kicad_pcb]
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2026-09-02 demo: park BQ25185 SYS clearance wall
    [enumerate_bq25185_sys_dogleg_landings.py, route_bq25185_sys_scratch.py]
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2026-09-02 demo: route ESP32 enable reset tree
    [aqroot-Beta-v2.kicad_pcb]
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2026-09-02 demo: correct MK1 acoustic keepout
    [aqroot-Beta-v2.kicad_pcb]
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2026-09-02 demo: bound SX1262 reset package escape
    [route_local_two_pad.py]
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2026-09-03 demo: promote 21 nets via whole-board all-layer maze router
    Replace the hand-authored single-layer corridor families that produced every
    NO_PATH from D-4xx to D-577 with maze3d.py: one reusable multi-source /
    multi-target breadth-first wavefront over the whole (layer, x, y) lattice with
    an explicit costed through-via move, plus route_maze_batch.py as the gating
    authority. qrouter.py and incremental_router.py are unmodified.
    Promotes 21 retained nets in one gated transaction. Whole-board retained open
    edges 446 -> 402, open retained nets 54 -> 33, each routed net closed to zero,
    none regressed. Re-verified independently from the board files: 0 copper
    objects removed, 439 added and all on rou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
    [aqroot-Beta-v2.kicad_pcb]
2026-09-03 demo: promote 204-island whole-board GND plane stitch
    GND owned the only filled pours on the board (In1/In4) and carried 225 of the
    402 retained open edges left by D-578. stitch_net could reach them; what
    blocked it were two soundness defects the first whole-board run exposed.
    verify_laid re-proves every object a transaction lays ANALYTICALLY, against
    the same obstacle set and clearance the search honoured, with no lattice and
    no guard band -- because QBoard.smooth replaces a proved staircase with one
    straight run accepted on clear_line, which rounds its samples back onto free
    cells while the line grazes one that is not.
    Nothing is exempt. A segment inside the pad it leaves is still a TR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
    [aqroot-Beta-v2.kicad_pcb]
2026-09-03 demo: promote +3V3 In3 plane and 56-pad stitch
    +3V3 owned 79 of the 203 retained open edges left by D-579 -- 80 pads, 80
    islands, no copper at all. Pad-to-pad that is ~80 long P3V3 runs on the two
    inner signal layers; as a POUR it is one zone plus one short via per pad, the
    primitive that already planted 204 GND islands.
    The layer was chosen on evidence. screen_inner_plane.py is read-only against
    the authority: it appends ONE unfilled zone reusing the In1/In4 GND pours'
    outline and fill parameters verbatim, lets the real KiCad engine fill it, and
    measures what filled. In3.Cu fills 9111.0 mm2 in 39 islands, worst pad reach
    0.355 mm; In2.Cu 8235.4 mm2 in 70 islands, 0.396 mm. Driven throu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
    [aqroot-Beta-v2.kicad_pcb]
2026-09-03 demo: promote LED_BOOST via 25-net maze batch (D-581)
    Recovered an already-gated but uncommitted promotion. A 25-net whole-board
    maze batch over the 33 open retained nets left by D-580 closed exactly one:
    /03_SPI_A_DISPLAY_SD/LED_BOOST, the display backlight boost supply, whose 6
    copper islands were joined by 5 maze legs (60.585 mm of 0.300 mm track, 4
    through vias) across B.Cu / F.Cu / In2.Cu.
    Whole-board retained open edges 155 -> 150; open retained nets 33 -> 32; no
    net regressed; the 24 that failed are reported in the evidence.
    Re-proved independently by verify_promotion.py from the two board files alone,
    all 12 checks PASS: 0 objects removed, 26 added and all on LED_BOOST, every
    track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
    [aqroot-Beta-v2.kicad_pcb]
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2026-09-04 demo: recover the D-584 router framework -- neck / partial / residual-join / plane-repair
    Recovers, fixes and pins the in-flight routing framework that was left dirty in
    the worktree at c5f983f. This commit promotes NO copper: the authoritative
    board is byte-identical at
    5b929a007c4d5d2b3fc0b5830c9906a4f908bbd5748148fd037573700175f3b4.
    Four levers, all OFF by default, so every accepted result reproduces:
    --neck a pad with NO legal launch at its net's contract width may
    launch at the .kicad_dru pad-escape necking minimum, but
    ONLY inside the courtyards that rule names, only when the
    full-width set is empty, and only f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
    [maze3d.py, route_maze_batch.py]
2026-09-04 demo: promote 16 nets by pour-damage screening -- 126 -> 101 open edges (D-584)
    The largest promotion since D-579 and the first selected by MEASURING what the
    gate would refuse rather than guessing what would route.
    Whole-board retained open edges 126 -> 101. Sixteen nets improved, ZERO
    regressed, 307 objects added (245 tracks + 62 vias), zero removed, zero zones
    touched, zero attributable DRC. Authority
    5b929a007c4d5d2b3fc0b5830c9906a4f908bbd5748148fd037573700175f3b4 ->
    d831b4f410cb92d8280549d1a772ab5d7ac9a2e57ca250fcc88b8099707ba755.
    WHY THE GUESS HAD STOPPED WORKING. D-582 and D-583 poured both outer layers,
    and their whole value was connectivity a pour delivers with no track and no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
    [aqroot-Beta-v2.kicad_pcb]
2026-09-04 demo: pour-bond protection -- 5 nets promoted, pour-damage class retired (D-585)
    D-584 left six nets that routed cleanly and were refused for exactly four
    pads (+3V3 J1.35/R19.1/R26.1, GND U3.12), each bonded only by an outer pour
    and none able to take a barrel or an escape at any permitted geometry. This
    prevents the slot instead of repairing it.
    New read-only pour_bond_guard.py reads island membership from KiCad's filled
    polygon set, guards an island that is <= 64 mm2 and bonds >= 2 pads
    (SMALL_ISLAND) or that carries a pad with no pad_escapes result at all
    (NO_ESCAPE) -- between them naming all four fatal pads -- and protects a TUBE:
    the geodesic path between anchors through the island's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
    [aqroot-Beta-v2.kicad_pcb]
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2026-09-04 demo: rip-up-and-reroute -- 4 edges promoted, eviction made whole (D-596)
    D-595 mined out the pour-bridge seam and left two floorplan walls behind it.
    This attacks the other half of the tail instead -- the 32 edges on 17
    functional nets that fail NO_PATH -- and it is the first promotion on this
    board that REMOVES accepted copper in order to add better copper.
    whole-board retained open edges 85 -> 81
    raw ratsnest 101 -> 97
    improved /I2C_SCL_INT 7->6 /NFC_CS_N 2->1 /SPI_B_SCK 2->1 BTN_DOWN_N 2->1
    regressed none authority 2140f6a9... -> db5f997f...
    The cheap lever was tried first and was VACUOUS: D-585's screen re-run with
    D-594's --neck ON changed no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
    [aqroot-Beta-v2.kicad_pcb]
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2026-09-04 demo: bond redundancy -- 32 guarded pads get a barrel of their own (D-600)
    D-599 put three independent nets through the full gate with the pour-bond
    guard OFF and all three returned the identical shape: the net closes one
    edge, GND opens one, --repair-planes cannot re-bond it, REFUSED. It named
    the root -- a GND pad whose ONLY bond to its net is pour copper is a
    SINGLE-POINT bond -- and this fixes the root.
    whole-board retained open edges 74 -> 73
    raw ratsnest 90 -> 89
    /I2C_SCL_INT 6 -> 5 regressed none
    32 pads bonded (28 GND, 4 +3V3) pour-bond guard 48 -> 34 tubes
    134 objects added, ZERO removed, zero zones/rule areas touched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
    [aqroot-Beta-v2.kicad_pcb]
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2026-09-04 demo: a corridor the router honours, and the USB opener named, priced and refused (D-602)
    D-599 and D-601 both named "a corridor RESERVATION the router honours" as the
    capability that pays twice. Both halves are built here, a third instrument the
    work exposed as missing is built with them, and together they turn the USB
    connector wall from "no opener known" into a transaction that is named, costed
    and REFUSED ON EVIDENCE.
    The authoritative PCB is UNCHANGED at bfef0aa2, 73 retained open edges. No
    copper was proposed or promoted.
    reserve_corridor.py emits a guard spec in pour_bond_guard.py's own shape, in
    two modes -- PROSPECTIVE (MST over the family's pad-cluster centroids: the lane
    the l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
    [reserve_corridor.py, route_maze_batch.py]
2026-09-04 demo: a clearance the board owes a PAD is not the one it owes a TRACK -- backlight anode PROMOTED, the free bond rung spent (D-603)
    D-601 left a READY PAYLOAD and a rule that would not bend for it: seven pads
    bond at the board's own min_via_diameter and need no licence, bond redundancy
    closes no edge by construction, and clause 4 requires the board to IMPROVE.
    Four partner routes were offered and all four declined. The fifth was found by
    fixing a framework defect, not by searching harder -- and the defect is one the
    .kicad_dru had already written down in words.
    whole-board retained open edges 73 -> 72
    raw ratsnest 89 -> 88 open retained nets 30 -> 29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
    [aqroot-Beta-v2.kicad_pcb]
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2026-09-04 demo: the escape-relief doctrine spent for the first time -- seven pour lands opened, and the dead-copper clause that had to exist first (D-606)
    The three pour-owning nets owned 30 of 68 retained open edges and every
    primitive refused them. D-604 swept `stitch_pad` over every rung the netclass
    and the .kicad_dru FLOORS allow -- 0 of 15 on +3V3, 0 of 9 on GND. D-605 swept
    `join_islands` on the promoted board -- 0 of 32, because 23 of those clusters
    own no filled pour copper at all. Both refusals were real and neither named
    the lever, because both were measuring the wrong thing.
    New read-only `screen_pad_escape_relief.py` moves ONE lever per rung, with rung
    0 reproducing D-604's verdict be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
    [aqroot-Beta-v2.kicad_pcb]
2026-09-04 demo: segment eviction built and spent -- a crossing track is not evicted, it is DETOURED between its own two ends (D-607)
    D-602, D-603, D-605 and D-606 each ended by naming the same missing unit, and
    D-606 made it the critical path. Four independent walls ask for it -- the USB
    connector corridor, the U9 west channel, the GND and BQ25185_SYS pour residuals
    -- and every one is a foreign track lying across a pocket that would otherwise
    hold a barrel. `--evict` removes copper wholly inside a window, `--evict-whole`
    removes a whole net board-wide, and a crossing track is reachable by neither.
    retained open edges 61 -> 59 unconnected items 77 -> 75
    improved GND (6 -> 4)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
    [aqroot-Beta-v2.kicad_pcb]
2026-09-04 demo: record the .kicad_pro netclass trap -- a scratch board copied without its project file reads back Default for every net (D-607 addendum)
    net_contract reads the netclass off NETINFO_ITEM and KiCad resolves that through
    the PROJECT's netclass patterns, so a .kicad_pcb copied on its own reports
    Default everywhere and a hand-driven --propose will route +3V3 at 0.200 mm with
    a 0.50/0.25 mm barrel without complaint. gate() already copies all three files;
    this records why, in the proposer itself and in the preflight README.
    [route_maze_batch.py]
2026-09-04 demo: the +3V3 rail's own regulator output was OPEN, and the move that closed it did not exist -- two orphans of one net may reach EACH OTHER (D-608)
    U12 is the TPS63020 buck-boost, the part that MAKES +3V3, and pins 4 and 5 are
    both VOUT. KiCad's own connectivity reported each of them connected to exactly
    one item: itself. The rail had no connection of any kind to its own
    regulator's output. They are 0.240 x 0.600 mm lands on 0.500 mm pitch, so no
    track of any width passes BETWEEN two of them at this net's 0.200 mm clearance,
    and the nearest OTHER +3V3 pad is R127.1 9.3 mm away -- so every previous run's
    NO_LEGAL_ESCAPE / NO_DRU_LICENCE / NO_VIA_SITE was true. Nobody had asked
    whether t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
    [aqroot-Beta-v2.kicad_pcb]
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2026-09-04 demo: the relief doctrine is SPENT -- every orphan of every pour net offered every move the board owns, and the answer is NO; plus a PHANTOM edge, sixteen missing DNP flags, and one rule sentence cor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
    D-610's addendum ruled the next task was a MEASUREMENT, not a route. This is
    it. NO COPPER CHANGED -- the board is byte-identical at `12a69da7...`; one
    `.kicad_dru` COMMENT is corrected and the whole D-610 promotion re-gates from
    933a91e against the corrected rule file, 14/14 PASS including real KiCad DRC
    with refill and schematic parity.
    THE INSTRUMENT is the new tracked read-only `screen_orphan_moves.py`. It names
    no land, no net and no lever: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
    [apply_schematic_population.py]
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2026-09-05 demo: the BOM is 100% ORDERABLE and the safety part was ordered in the WRONG PACKAGE -- 61 identities ruled against a live distributor record, and a screen that asks the C26 question of every line at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
    D-614 named this task and named what stopped it: D-096 binds -- a part number
    configured from an ordering scheme is a hypothesis until a distributor record
    confirms lifecycle and stock, and that session had none to read. This one read
    the JLCPCB catalogue 225 times and KEPT every answer, each stamped with the UTC
    minute it was read.
    c8e421aa50144fe396aedb5e226aaabeb815bd69ffaf6e04f549ded43831d103.
    FAB7 IS CLOSED. C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
    [01_power_tree.kicad_sch, 03_spi_a_display_sd.kicad_sch, 04_spi_b_radios_nfc.kicad_sch, 05_i2c_devices.kicad_sch, 07_ir.kicad_sch, 08_buttons_expanders.kicad_sch, 09_community_header.kicad_sch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]
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2026-09-05 demo: USB-C data is HALF REAL COPPER, and the other half is a 0.395 mm band the connector's own GROUND PIN already owns -- the corridor detour built, spent, and the J3 wall reduced to ONE irreducible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
    D-583, D-599 and D-602 each refused the J3 -> U10 USB connector corridor and each
    ended by naming the same missing unit: the SEGMENT. --evict takes copper wholly
    inside a window and --evict-whole takes a whole net board-wide; a track that merely
    CROSSES is reachable by neither, and D-602 proved no whole-net eviction of ANY size
    opens this corridor because /I2C_SDA_INT is load-bearing and cannot rebuild itself.
    D-607 built the detour and D-607/D-617 spent it on POUR LANDS, where the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
    [aqroot-Beta-v2-B_Cu.gbr, aqroot-Beta-v2-B_Mask.gbr, aqroot-Beta-v2-B_Paste.gbr, aqroot-Beta-v2-B_Silkscreen.gbr, aqroot-Beta-v2-Edge_Cuts.gbr, aqroot-Beta-v2-F_Cu.gbr, aqroot-Beta-v2-F_Mask.gbr, aqroot-Beta-v2-F_Paste.gbr]
2026-09-05 demo: the U9 wall was never FIVE walls and it was never a CORRIDOR -- one mechanism behind all five NFC edges, an escape band short by FIFTY MICRONS, and the first PLACEMENT change this project has p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
    screen_corridor_detour.py on every open U9 NFC edge returns DETOURABLE +
    UNRELAYABLE, five times out of five: every corridor OPENS when its crossing
    tracks are cut and not one blocker can walk around, because the irreducible
    net is always a .kicad_dru SINGLE-LAYER net -- NFC_XIN, NFC_XOUT, NFC_RFO2,
    all layers_allowed = ['B']. A net with one layer and no barrel has nothing to
    detour onto. D-603's "strict 1-for-1 trade" is that contract coming due.
    NFC_RFO2 alone owns three of th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
    [aqroot-Beta-v2-B_Cu.gbr, aqroot-Beta-v2-B_Mask.gbr, aqroot-Beta-v2-B_Paste.gbr, aqroot-Beta-v2-B_Silkscreen.gbr, aqroot-Beta-v2-Edge_Cuts.gbr, aqroot-Beta-v2-F_Cu.gbr, aqroot-Beta-v2-F_Mask.gbr, aqroot-Beta-v2-F_Paste.gbr]
2026-09-05 demo: the ZERO-MARGIN LAND -- eight decisions of NO_LEGAL_ESCAPE were one number nobody had measured, the U9 north row is FULL TO THE MICRON, and the USB MCU pair is a SEGMENT WALL (D-620)
    D-619 asked whether NFC_RFO2 could be RE-LAID from scratch. The answer turned
    out to be the same answer for U9, for +3V3, for U21 and for U11, and it is
    arithmetic rather than a search.
    New read-only screen_land_escape_margin.py computes, at ONE MICRON and with no
    search at all, how much room a LAND has to launch: given a pad, a direction, a
    track width and the clearance that net owes a PAD, what is left over.
    margin < 0 UNLAUNCHABLE -- the netclass width is wider than the land can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
    [route_maze_batch.py]
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2026-09-05 demo: NFC_IRQ is CLOSED at a lattice NOTHING WOULD HAVE CHOSEN -- four pitches ranked and the coarsest admissible one is 15 mm worse, finer is NOT monotone, and the pour judge the INDEPENDENT auditor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
    D-622 named a framework task and did not take it: a `--grid` LADDER bounded by
    a cell-count budget rather than the single coarsest-admissible pitch `auto`
    computes. This is that ladder, the ranking it makes possible, and the two
    places the pour-partition judge was still missing.
    THE BUDGET IS COUNTED IN CELLS. A maze3d.Field rasterises the whole board once
    per routable layer, so halving the pitch QUADRUPLES it: 4.6 M cells at 0.100 mm
    to 115.6 M at 0.020 mm on this 72 x 148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
    [aqroot-Beta-v2-B_Cu.gbr, aqroot-Beta-v2-B_Mask.gbr, aqroot-Beta-v2-B_Paste.gbr, aqroot-Beta-v2-B_Silkscreen.gbr, aqroot-Beta-v2-Edge_Cuts.gbr, aqroot-Beta-v2-F_Cu.gbr, aqroot-Beta-v2-F_Mask.gbr, aqroot-Beta-v2-F_Paste.gbr]
2026-09-05 demo: the ladder pointed at EVERY open edge -- one net ROUTES and the POUR refuses it (U3.12 alone on 4.664 mm2 with ZERO barrels), refinement MOVES the wall instead of lowering it, and a report that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
    D-623 built `--grid ladder` and named the screen it makes cheap. This is that
    screen, over every standing single-edge candidate on 2b1260eb..., one net per
    run, no --promote. NO COPPER CHANGED; the authoritative board is
    byte-identical throughout.
    ACC_5V_LX NO_LATTICE_AT_ANY_PITCH
    NFC_VDD_RF ESCAPE_WALL_INVARIANT
    BTN_DOWN_N POUR_WALL <- routes at ALL FIVE pitches
    BTN_LEFT_N CORRIDOR_WALL
    ACC_5V_BOOST_EN CORRID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
    [route_maze_batch.py]
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2026-09-05 demo: EXT_SDA is CLOSED by a pair the MST never ASKED -- the all-or-nothing transaction hid 22 unmeasured pairs, the guard changed WHICH pair is cheapest (10.258 mm vs 85.843 mm), and the ladder's bu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
    D-625 named the lever -- re-run the ladder screen with the 47-tube guard ON.
    Running it exposed that the screen had been asking the wrong UNIT.
    THE ALL-OR-NOTHING MST NEVER ASKED. A plane-less net is ONE transaction over
    its MST: the first pair that will not close fails the whole net and every
    REMAINING pair goes unattempted, so "open" in the ledger and "refused" in a
    router report have been the same word for two different things. New tracke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
    [aqroot-Beta-v2-B_Cu.gbr, aqroot-Beta-v2-B_Mask.gbr, aqroot-Beta-v2-B_Paste.gbr, aqroot-Beta-v2-B_Silkscreen.gbr, aqroot-Beta-v2-Edge_Cuts.gbr, aqroot-Beta-v2-F_Cu.gbr, aqroot-Beta-v2-F_Mask.gbr, aqroot-Beta-v2-F_Paste.gbr]
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2026-09-05 demo: LED_K is PROMOTED under the standing PP2 ampacity clause -- the FIRST pour severance this board has ever accepted, admitted because it was PRICED at 1.441 A against a published 1.0 A rail (D-62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
    D-627 named the one task and called it the highest-leverage single change on the
    board. This is the second half of it. The clause was committed ALONE (2f95630)
    promoting nothing, and LED_K was then judged by a contract already standing --
    D-625's reasoning binds: a doctrine resolved in the same breath as the copper it
    admits is the move the clause exists to prevent.
    /03_SPI_A_DISPLAY_SD/LED_K -- the display backlight cathode return, PARKED at
    D-467 as a "current-width wall" and D-468 as a "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
    [aqroot-Beta-v2-B_Cu.gbr, aqroot-Beta-v2-B_Mask.gbr, aqroot-Beta-v2-B_Paste.gbr, aqroot-Beta-v2-B_Silkscreen.gbr, aqroot-Beta-v2-Edge_Cuts.gbr, aqroot-Beta-v2-F_Cu.gbr, aqroot-Beta-v2-F_Mask.gbr, aqroot-Beta-v2-F_Paste.gbr]
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2026-09-05 demo: EXT_SDA's SECOND edge is CLOSED, and "UNLAUNCHABLE" is THREE walls wearing one name -- the escape width ladder had exactly ONE rung (D-630)
    D-629 named the census-then-ladder recipe on /BQ25185_STAT1, /NFC_SUPPLY and
    EXT_SDA's remaining edges. This is that recipe: one edge closed, three walls
    measured, one report that had been naming the wrong land, and the
    classification that tells this board's twenty-six blocked lands apart.
    PROMOTED. /09_COMMUNITY_HEADER/EXT_SDA J5.4 -> R48.2, 23.9933 mm on F.Cu +
    In2.Cu with 2 through barrels 0.600/0.300 at (65.575, 18.875) and
    (60.200, 33.525), every track 0.200 mm I2C. The guarded ladder REFUSED at
    0.100 / 0.0667 / 0.050 / 0.0333 mm and CLOS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
    [aqroot-Beta-v2-B_Cu.gbr, aqroot-Beta-v2-B_Mask.gbr, aqroot-Beta-v2-B_Paste.gbr, aqroot-Beta-v2-B_Silkscreen.gbr, aqroot-Beta-v2-Edge_Cuts.gbr, aqroot-Beta-v2-F_Cu.gbr, aqroot-Beta-v2-F_Mask.gbr, aqroot-Beta-v2-F_Paste.gbr]
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2026-09-05 demo: the PLANE-ORPHAN family is CLOSED BY MEASUREMENT -- D-634's barrel correction, built into a stitch and aimed at all TEN islands over 438 trials, opens ZERO -- and SIX OF THE TEN already sit at 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
    D-634 closed with "PUT THE BARREL CORRECTIONS INTO THE INSTRUMENTS THAT
    PROMOTE"; D-635 and D-636 each carried it forward unchanged. It is done, and
    the barrel search was never the wall.
    retained nets 21, connected retained 152, raw ratsnest 60. ADD-ONLY: git diff
    --numstat over the whole worktree is insertions only -- 230 0 maze3d.py, not one
    existing line cha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
    [maze3d.py]
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2026-09-06 demo: FIVE open edges strand THIRTY-SEVEN nets -- the work list was sorted by the wrong key, and the BMI270's SDA IS BONDED (38 -> 37, D-652, COPPER PROMOTED)
    Authority abf8b920 -> dc6d162a. Retained open edges 38 -> 37, /I2C_SDA_INT
    open edges 2 -> 1 and islands 3 -> 2, raw ratsnest 54 -> 53, open retained
    THE WORK LIST WAS SORTED BY THE WRONG KEY. routing_ledger.py says HOW MANY
    edges are open and nothing has ever said WHICH ONE MATTERS; eighteen decisions
    took the cheapest next. New tracked read-only screen_open_edge_cost.py names,
    per open edge, the PART its orphan land sits on and counts the OTHER nets that
    part carries: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
    [aqroot-Beta-v2.kicad_pcb]
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2026-09-07 demo: THE SCREEN'S OWN "MINIMAL" ARM IS THE ONE THAT FAILS -- BTN_LEFT_N falls to the 20-object opener the screen ranked FIRST, the WHOLE D-PAD + A/B + RGB SHEET is now closed, and a finer lattice is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
    Authority 12f8e584 -> 704ce0eb. Retained open edges 32 -> 31, open retained
    nets 18 -> 17, connected retained 155 -> 156, raw ratsnest 48 -> 47, KiCad's
    own unconnected items 48 -> 47. hardware/beta-v2 UNTOUCHED.
    inherited profile exactly (hole_clearance 5, solder_mask_bridge 1, parity 247
    warnings / 0 errors). verify_promot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
    [aqroot-Beta-v2.kicad_pcb]
2026-09-07 demo: THE NFC FRONT-END'S VDD PIN HAD NO SUPPLY AND IT CLOSES AT THE WIDTH THE BOARD'S OWN RULE ALREADY ENFORCES -- --escape-floor fixed the LAND and left the TRUNK carrying the class opt as a floor;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
    /NFC_SUPPLY U9.8 is the ST25R3916's VDD (leaf_land_contract: RAIL /
    SUPPLY_PORT) and had NO connection of any kind, so the NFC front-end had no
    supply -- a MUST-remain-functional feature. R107.2 -> U9.8 is NO_PATH at
    0.600 and 0.500 mm at every pitch and ROUTES in 13.806 mm at 0.400 mm on a
    0.050 mm lattice, and 0.400 mm is the minimum (rule "P3V3 minimum width")
    itse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
    [aqroot-Beta-v2.kicad_pcb]
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2026-09-08 demo: THE TAP IS BUILT -- an orphan land may now aim at its OWN NET'S CONDUCTOR and not only at a PAD (the writer D-652/D-655/D-661/D-663 all named as missing); U16.3's LAND wall falls to 7 objects a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
    D-664. NO COPPER PROMOTED. Authority UNCHANGED at 2900f21a; hardware/beta-v2
    and hardware/demo/kicad untouched. Standing suite 13 contracts, 13/13 RAN,
    13/13 PASS -- and for the first time 13/13 COMPARED, 13/13 IDENTICAL.
    1. THE TAP. maze3d.tap_sites / maze3d.join_taps and route_maze_batch.py --tap
    / --tap-max-mm / --tap-p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
    [maze3d.py, route_maze_batch.py]
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2026-09-08 demo: THE FAB PACKAGE WOULD HAVE SHIPPED FORTY MISSING HOLES AND NOTHING ASKED -- fab_provenance becomes the FOURTEENTH standing contract at 0.3 s, and /WAKE_INT_N's last edge falls to EIGHT objects 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
    Authority UNCHANGED at 7b2ca325; retained open edges 28 -> 28; hardware/beta-v2
    and hardware/demo/kicad UNTOUCHED. Standing suite 14 contracts, 14/14 RAN,
    14/14 PASS, 13/13 COMPARED and 13/13 IDENTICAL to d665.
    THE SHIPPABLE. fab_package_contract.py had never been in the standing suite.
    Run against the package this repository actually carried: FAB1_provenance FAIL
    (manifest 5715bf5c, aut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
    [aqroot-Beta-v2-B_Cu.gbr, aqroot-Beta-v2-B_Mask.gbr, aqroot-Beta-v2-B_Paste.gbr, aqroot-Beta-v2-B_Silkscreen.gbr, aqroot-Beta-v2-Edge_Cuts.gbr, aqroot-Beta-v2-F_Cu.gbr, aqroot-Beta-v2-F_Mask.gbr, aqroot-Beta-v2-F_Paste.gbr]
2026-09-08 demo: A RESERVATION IS 0.050 mm STRONGER THAN THE RULE IT STANDS FOR AND IT SPENDS THAT ON THE RELAY'S OWN GOAL CELL -- the lane, the lift and the per-layer lane become primitives, and /WAKE_INT_N's 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
    and hardware/demo/kicad UNTOUCHED. maze3d.py, route_maze_batch.py and
    reserve_corridor.py all changed and the standing suite reads 14/14 RAN, 14/14
    PASS, 14/14 COMPARED, 14/14 IDENTICAL to d666, vacuous false.
    THE WALL D-666 COULD NOT NAME. D-666 read both relays' NO_PATH as "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
    [maze3d.py, reserve_corridor.py, route_maze_batch.py]
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2026-09-09 demo: A LADDER THAT MEASURED THE WRONG END OF EVERY TWO-PAD NET, AND A RESERVATION WORTH 0.072 mm OF THE 2.200 mm IT ASKED FOR -- the whole 15-net frontier is partitioned, --all-lands finds /SX1262_D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
    D-669 §7 item (1) asked for the pocket blame over the remaining fifteen open
    nets. Doing it found the screen could not ask the question properly, that its
    answer means less than it reads, and that the lane primitive built to spend such
    an answer cancels itself on exactly the geometry that produces one.
    - screen_escape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
    [fold_pocket_partition.py, route_maze_batch.py]
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2026-09-10 demo: THE DRILL-TO-COPPER RULE THIS BOARD HAS BEEN REFUSING ITSELF WITH IS 25% STRICTER THAN THE SHOP THAT WILL BUILD IT, AND ALL FIVE "INHERITED" hole_clearance ERRORS WERE ONE CLASS -- GND J3.A12/B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
    [aqroot-Beta-v2-B_Cu.gbr, aqroot-Beta-v2-B_Mask.gbr, aqroot-Beta-v2-B_Paste.gbr, aqroot-Beta-v2-B_Silkscreen.gbr, aqroot-Beta-v2-Edge_Cuts.gbr, aqroot-Beta-v2-F_Cu.gbr, aqroot-Beta-v2-F_Mask.gbr, aqroot-Beta-v2-F_Paste.gbr]
2026-09-10 demo: THE ONE-EDGE TRANSACTION THIS BOARD WOULD HAVE ACCEPTED PUTS THE CHARGER'S OWN GROUND ON AN 8.5 mm2 ISLAND, AND PP2 SAID SO AFTER THE GATE DID NOT -- a transaction was DRAWN, GATED at 15 of 15 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
    [apply_part_shift.py]
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2026-09-10 demo: D-680 addendum -- THE RELAY REFUSAL IS REAL AND NOT THE GUARD'S FAULT: BOTH CHAINS EXTENDED CLEAR OF THE LANE, 40 mm BUDGET, STILL NO_PATH ON F.Cu AS WELL AS B.Cu (25 -> 25, authority UNCHANGED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
    D-680 sections 5 and 5b rested on three relay arms that all reported
    every_detour_relaid FALSE -- and all three carried a defect of their own worth
    naming: terminal_lift residual 0.3228 mm. /01_POWER_TREE/ACC_5V_FB's own chain
    terminal (55.600,32.900) sits 0.4272 mm from the reserved SYS lane's centre, so
    the guard swallowed the very terminal the relay had to re-attach to -- which is
    exactly the failure D-668 rec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
    [d680-collect-arms.py]
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2026-09-11 demo: D-684 -- THE MICROPHONE HAD NO GROUND: MK1'S OWN ACOUSTIC KEEP-OUT COVERED ITS GND RING, AND CORRECTING THE POLYGON TO THE MANUFACTURER'S OWN O1.65 mm FIGURE CLOSES GND WITH ZERO COPPER (22 -> 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
    [aqroot-Beta-v2-B_Cu.gbr, aqroot-Beta-v2-B_Mask.gbr, aqroot-Beta-v2-B_Paste.gbr, aqroot-Beta-v2-B_Silkscreen.gbr, aqroot-Beta-v2-Edge_Cuts.gbr, aqroot-Beta-v2-F_Cu.gbr, aqroot-Beta-v2-F_Mask.gbr, aqroot-Beta-v2-F_Paste.gbr]
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2026-09-11 demo: D-686 -- THE BACKLIGHT STRAP'S PULL-DOWN WAS 30 mm FROM ITS OWN PIN AND ITS HAUL WAS THE ONLY LANE UNDER THE WROOM: R108 moved 32.8 mm to (39.750,117.000) rot +90, the strap reconnected in 2.47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
    [aqroot-Beta-v2-B_Cu.gbr, aqroot-Beta-v2-B_Mask.gbr, aqroot-Beta-v2-B_Paste.gbr, aqroot-Beta-v2-B_Silkscreen.gbr, aqroot-Beta-v2-Edge_Cuts.gbr, aqroot-Beta-v2-F_Cu.gbr, aqroot-Beta-v2-F_Mask.gbr, aqroot-Beta-v2-F_Paste.gbr]
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2026-09-12 demo: D-700 -- THE FABRICATION PACKAGE IS REGENERATED AGAINST THE PROMOTED BOARD AND THE WHOLE STANDING SUITE IS GREEN FOR THE FIRST TIME IN THIS SESSION. hardware/demo/fab had been stale since D-697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
    [aqroot-Beta-v2-B_Cu.gbr, aqroot-Beta-v2-B_Mask.gbr, aqroot-Beta-v2-B_Paste.gbr, aqroot-Beta-v2-B_Silkscreen.gbr, aqroot-Beta-v2-Edge_Cuts.gbr, aqroot-Beta-v2-F_Cu.gbr, aqroot-Beta-v2-F_Mask.gbr, aqroot-Beta-v2-F_Paste.gbr]
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2026-09-12 demo: D-703 section 6 -- verify_promotion.py --zone-reshaped, and the control that re-proves the actual BQ25185_SYS POUR 2 narrowing. verify_promotion asserted "no surviving zone's net, layer, OUTLIN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
    [verify_promotion.py]
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2026-09-13 demo: D-706 -- THE WALL D-703 COULD NOT NAME WAS /01_POWER_TREE/ISET'S MISSING WIDTH FLOOR, AND WITH IT PUBLISHED /BQ25185_STAT1 CLOSES IN EVERY CONFIGURATION. THE REST OF U11 IS ARITHMETIC: FIVE CON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
    [route_maze_batch.py]
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2026-09-14 demo: D-709 -- THE OWNER-APPROVED EAST EXPANSION, THE J8 MOVE AND THE R36 MOVE ARE PROMOTED. THE CLAUSE THAT HELD THEM FOR A WHOLE DECISION WAS CHARGING ONE PAD'S CURRENT TO ANOTHER PAD'S COPPER.
    COPPER PROMOTED. Authority eca81247 -> 4414da31, 16 -> 15 retained open edges, /BQ25185_STAT1 2 -> 1, hardware/beta-v2 UNTOUCHED.
    D-708 built a finalist that returned failed_nets [], nets_regressed [], all fifteen gate clauses true, DRC equal to the inherited baseline and promotion_candidate TRUE -- and then refused it on ONE clause measured HEAD -> candidate. This decision finds the clause was wrong, repairs it in both directions, and promotes the board.
    THE DEFECT. pour_partition PP2's D-643 ret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
    [aqroot-Beta-v2-B_Cu.gbr, aqroot-Beta-v2-B_Mask.gbr, aqroot-Beta-v2-B_Paste.gbr, aqroot-Beta-v2-B_Silkscreen.gbr, aqroot-Beta-v2-Edge_Cuts.gbr, aqroot-Beta-v2-F_Cu.gbr, aqroot-Beta-v2-F_Mask.gbr, aqroot-Beta-v2-F_Paste.gbr]
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2026-09-15 demo: D-712 -- THE U2 CHANNEL SWAP IS PROMOTED AND /BQ25185_STAT1 IS CLOSED, AND THE TPS63020's PS/SYNC STRAP COMES HOME FROM FIFTY MILLIMETRES AWAY: 15 -> 13 RETAINED OPEN EDGES.
    COPPER PROMOTED. Authority 4414da31 -> 2e8ef9ed; 15 -> 13 retained open
    edges over 9 nets. hardware/beta-v2 UNTOUCHED.
    1. D-711's U2 CHANNEL SWAP, SPENT. P05 <-> P17 and P06 <-> P16 on the
    PCAL9535A, schematic and PCB together. /BQ25185_STAT1 and /BQ25185_STAT2
    were landed on U2's WEST column with their partners at x 59..70, and
    /SX1262_DIO1 and /TOUCH_INT_N on its EAST column with their partners at
    x 3 and x 22; all four crossed the package. The netlist diff is exactly
    four nets plus GND, ERC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
    [01_power_tree.kicad_sch, 08_buttons_expanders.kicad_sch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]
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2026-09-15 demo: D-714 -- the U21 accessory-boost cell routes its switch node for the FIRST TIME (L4.2 -> U21.5, 3.065 mm, ZERO vias, DRC-clean) and U21.4's ground is the whole residual; /NFC_SUPPLY U9.10 is a 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
    NO COPPER PROMOTED. Authority UNCHANGED at 2e8ef9ed; 13 -> 13.
    evidence/d714-build-u21-cell.py replays the cell in one command: U21.6's own
    0.250 mm RAW neck out (it is the fourth wall -- SWITCH_NODE's 0.300 mm ROUTED
    clearance against 0.275 mm of gap), C65 to (60.700, 42.200), U21.4's INE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
    [route_maze_batch.py]
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2026-09-17 demo: D-732 -- the D-pad defect is closed for ZERO COPPER. D-731 measured it right and priced the wrong repair: the wiring was never wrong, only the declaration of which expander bit carries which fu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
    [08_buttons_expanders.kicad_sch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]
2026-09-17 demo: D-733 -- /ACC_PWR_EN is ROUTED and the community port's I2C buffer has its enable. 4 -> 3 retained open edges. What was holding it was /BQ25185_STAT1's 115.638 mm, 45-object western loop, which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
    [08_buttons_expanders.kicad_sch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]
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2026-09-17 demo: D-737 -- the fab package never told the fabricator the profile is stepped, and the mechanical block still published the retired 72 mm outline. Edge.Cuts has been 72 mm wide with an east bump to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
    [aqroot-Beta-v2-B_Cu.gbr, aqroot-Beta-v2-B_Mask.gbr, aqroot-Beta-v2-B_Paste.gbr, aqroot-Beta-v2-B_Silkscreen.gbr, aqroot-Beta-v2-Edge_Cuts.gbr, aqroot-Beta-v2-F_Cu.gbr, aqroot-Beta-v2-F_Mask.gbr, aqroot-Beta-v2-F_Paste.gbr]
2026-09-17 demo: D-738 (part 1) -- the package never told the fabricator the board uses via-in-pad, and the expander pin map that firmware would have read was two ECOs out of date.
    NO COPPER. Authority 71c4326e UNCHANGED.
    (a) VIA-IN-PAD. pad_to_mask_clearance on this board is 0, so a pad's solder-mask
    aperture IS its copper. 128 via barrels open directly into 134 solderable lands
    across 75 components, on 0.20 / 0.25 / 0.30 / 0.40 mm holes. Every one of them
    carries the SAME net as the land -- they are the router's own pad escapes and the
    decoupling fan-outs -- so no clearance rule is violated and KiCad, which has no
    via-in-pad rule at all, is silent. The worst are C18.1 (0.40 mm hole, 38.2 % of
    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
    [08_buttons_expanders.kicad_sch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]
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2026-09-17 demo: D-738 (part 5) -- KiCad has never checked a solder-mask web on this board, and four of them are 0.0621 mm between different nets.
    solder_mask_min_width in this board's setup is 0.000 mm. That switches KiCad's
    solder_mask_bridge test OFF by construction, so every "DRC is clean" this
    programme has recorded carries ZERO information about mask dams -- and nothing
    else in the repository looked either. Measured for this decision instead, and
    measured POLYGON TO POLYGON rather than by bounding box, because the tight ones
    turn out to be DIAGONAL corner pairs of a QFN and a bounding box reads those as
    0.0000 mm when they are not.
    TWENTY-ONE dams sit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
    [aqroot-Beta-v2-B_Cu.gbr, aqroot-Beta-v2-B_Mask.gbr, aqroot-Beta-v2-B_Paste.gbr, aqroot-Beta-v2-B_Silkscreen.gbr, aqroot-Beta-v2-Edge_Cuts.gbr, aqroot-Beta-v2-F_Cu.gbr, aqroot-Beta-v2-F_Mask.gbr, aqroot-Beta-v2-F_Paste.gbr]
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2026-09-17 demo: D-739 -- /SX1262_DIO1 IS ROUTABLE. D-735's floorplan conclusion is overturned by measurement and the D-pad does not have to move; one of the two open owner decisions is withdrawn.
    NO COPPER PROMOTED. Authority 71c4326e UNCHANGED -- the finalist is refused by
    clause 4 and the clause is NOT relaxed.
    D-735 spent eight attempts on this net, reported "every single-net lever is
    spent", and asked the owner to move the D-pad aperture 11.5 mm east on a locked,
    marketing-safe outline, with polling GetIrqStatus() as the fallback. Its own
    screen had the price right and the reading of it wrong. The screen named a
    FOUR-net minimal free set on B.Cu; TWO of those four are enough -- and the
    evictio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
    [d739-dio1-finalist.kicad_pcb]
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2026-09-18 demo: D-740 -- /SX1262_DIO1 PROMOTED. R5 leaves the U2 west column and BTN_UP_N's pull-up taps its own net in open copper; retained open edges 3 -> 2.
    D-739 proved DIO1 routable and refused its own finalist because BTN_UP_N's R5.2 pull-up leg opened in exchange, and it named a six-part R4-R9 westward move as the fix. The six-part move was not needed: R5 is a 10k pull-up on a button line, its position is electrically free, and screen_net_tap --census showed both of R5.2's targets pointing back into the contested pocket. apply_part_shift moved R5 from (51.123,86.792) to (48.000,92.300) with the +3V3 chain released by --release-point/--release-via (the exact refusal D-739's addendum recorded)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
    [aqroot-Beta-v2.kicad_pcb]
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2026-09-18 demo: D-741 addendum -- fab package regenerated at 23ee647e, the whole standing suite is green, and D-734's REASON for U11.3 is corrected for Rev-B.
    contract_regression runs 14 contracts, ALL RAN, ALL PASS (--emit-baseline d741); protected_copper, placement and rf_symmetry are byte-identical to the d738 artifacts. fab_package_contract PASS, FAB1..FAB11, on a package re-exported at 23ee647e (29 files). FAB9 goes 134 -> 135 solderable lands with an open barrel and the delta is three rows: SW4.1's barrel moved 0.15 mm by D-740's BTN_DOWN_N re-lay, and TP7.1 gains D-741's STAT2 tap barrel, whose HOLE clips a 1.0 mm round test-point land by 0.000639 mm2 -- 0.082 % of the pad, on its own net, on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
    [aqroot-Beta-v2-B_Cu.gbr, aqroot-Beta-v2-B_Mask.gbr, aqroot-Beta-v2-B_Paste.gbr, aqroot-Beta-v2-B_Silkscreen.gbr, aqroot-Beta-v2-Edge_Cuts.gbr, aqroot-Beta-v2-F_Cu.gbr, aqroot-Beta-v2-F_Mask.gbr, aqroot-Beta-v2-F_Paste.gbr]
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2026-09-18 demo: D-741 -- fab package re-exported after the sheet-08 firmware-note correction, and the whole standing suite is re-run green on the final state.
    Editing the schematic text note moved FAB1's provenance (the package records the schematic hierarchy, not just the board), so the package is regenerated. The board sha256 is UNCHANGED at 23ee647e and every copper gerber is byte-identical apart from its TF.CreationDate line.
    contract_regression --baseline d738 --emit-baseline d741: 14 contracts, ALL RAN, ALL PASS, FAILING []. fab_package_contract: PASS, FAB1..FAB11 all ok. The d741-*-contract.json baseline artifacts are re-emitted so they match the committed state exactly.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
    [aqroot-Beta-v2-B_Cu.gbr, aqroot-Beta-v2-B_Mask.gbr, aqroot-Beta-v2-B_Paste.gbr, aqroot-Beta-v2-B_Silkscreen.gbr, aqroot-Beta-v2-Edge_Cuts.gbr, aqroot-Beta-v2-F_Cu.gbr, aqroot-Beta-v2-F_Mask.gbr, aqroot-Beta-v2-F_Paste.gbr]
2026-09-18 demo: D-742 -- the owner decision on U11.3 is SPENT, and reading the datasheet to spend it found that this board's charger status decode was INVERTED on STAT1.
    The owner approved (2026-09-17) leaving /BQ25185_STAT2's U11.3 unconnected. routing_ledger.py now carries APPROVED_UNROUTED, deliberately NOT folded into APPROVED_NC: a J5 NC contact carries no net and is simply not counted, whereas U11.3 carries a real net on a fitted part and is genuinely unrouted. Folding it in would have deleted the board's record of why the pin is bare AND made neck_contract N2 vacuous, because U11.3 is the only pad N2 compares on this board. So nets[] keeps telling the copper truth -- retained_open_edges stay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
    [01_power_tree.kicad_sch, 08_buttons_expanders.kicad_sch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]
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2026-09-18 demo: D-747 -- the firmware pin map is GENERATED from the board now, and the seventeenth contract is the first one the software has to pass.
    D-746 released the fab package; the independent CTO re-review held
    DEMO_READY_FOR_FAB on one item -- no firmware in this repository matched the
    board well enough to catch a hardware/firmware mapping error before the order.
    Checked against the repository, all of it is true, and the placeholder pins do
    not merely go stale, they COLLIDE: config.h puts I2C on GPIO17/18 where this
    board has SPI-A MOSI and the NFC IRQ, and the display on GPIO10/11/12/13 where
    it has DISP_CS_N, SPI-A MOSI, SPI-A SCK and SPI-A MISO.
    So Firmware/src/hw/aqroot_demo_board.h is no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
    [aqroot_demo_expanders.h, aqroot_demo_peripherals.h, aqroot_demo_pins.h, aqroot_demo_radios.h, aqroot_i2c.h, aqroot_i2c_arduino.h, config.h]
2026-09-18 demo: D-748 -- the shared SPI-B rules stop being comments, the display and microphone are exercised, and the arbiter's own test found a re-entrancy bug in it.
    D-747 closed the pin map and left three things as prose: the one-TX-at-a-time
    discipline the retained dual-radio scope requires, the display the independent
    review names explicitly, and the microphone.
    SpiBusB makes the first a mechanism -- one chip select at a time on the bus U7,
    U8 and U9 share, one transmitter keyed at a time, with an RAII Hold so a probe
    that returns early still releases. Its own host test then found the bug in it:
    select() treated a repeat select of the SAME device as idempotent, so a nested
    Hold would succeed an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
    [aqroot_demo_display.h, aqroot_demo_peripherals.h, aqroot_demo_radios.h, aqroot_spi_bus_b.h, firmware_hw_map_contract.py, gen_firmware_hw_map.py, main.cpp]
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2026-09-18 demo: correct PCAL9535A reset model in firmware tests
    [config.h, pcal9535a.h, test_expander_order.cpp]
