aqroot8/aqroot/(notices)

Notices in the files:
docs/full-beta-v2/CHANGELOG.md:
cite them. The principles that survive are carried forward explicitly rather than
